fernandomierhicks/omni-robot/simulation/v11 sil/studies/results/motor_char/REPORT.md

# Motor study results (generated by drive_char_report.py; see the study README for the method)

## C. Speed, cruise, straights

### Top speed (m/s, cause) per body direction

| robot | 4 drives | 0 deg | 22.5 deg | 45 deg | 67.5 deg | 90 deg | 112.5 deg | 135 deg | 157.5 deg | 180 deg |
| --- | --- | --- | --- | --- | --- | --- | --- | --- | --- | --- |
| AK40-10 10 kg carpet | $544 | 4.24 rpm | 3.45 rpm | 3.23 rpm | 3.37 rpm | 4.09 rpm | 3.34 rpm | 3.23 rpm | 3.44 rpm | 4.25 rpm |
| AK40-10 10 kg carpet 20% | $544 | 3.69 rpm | 3.06 rpm | 2.84 rpm | 2.97 rpm | 3.56 rpm | 2.93 rpm | 2.82 rpm | 2.99 rpm | 3.65 rpm |
| AK40-10 10 kg floor | $544 | 4.27 rpm | 3.43 rpm | 3.20 rpm | 3.33 rpm | 3.96 rpm | 3.31 rpm | 3.21 rpm | 3.44 rpm | 4.28 rpm |
| AK40-10 10 kg floor 20% | $544 | 3.73 rpm | 3.03 rpm | 2.83 rpm | 2.95 rpm | 3.50 rpm | 2.96 rpm | 2.87 rpm | 3.07 rpm | 3.70 rpm |
| AK40-10 10 kg floor loop=0.25 | $544 | 4.26 rpm | 3.44 rpm | 3.24 rpm | 3.37 rpm | 4.02 rpm | 3.37 rpm | 3.25 rpm | 3.43 rpm | 4.32 rpm |
| AK40-10 15 kg carpet | $544 | 4.00 rpm | 3.44 rpm | 3.14 rpm | 3.32 rpm | 4.00 rpm | 3.30 rpm | 3.15 rpm | 3.42 rpm | 4.03 rpm |
| AK40-10 15 kg carpet 20% | $544 | 3.55 rpm | 3.00 rpm | 2.78 rpm | 2.91 rpm | 3.58 rpm | 2.90 rpm | 2.80 rpm | 3.01 rpm | 3.56 rpm |
| AK40-10 15 kg floor | $544 | 4.13 rpm | 3.41 rpm | 3.20 rpm | 3.32 rpm | 3.84 rpm | 3.33 rpm | 3.20 rpm | 3.48 rpm | 4.27 rpm |
| AK40-10 15 kg floor 20% | $544 | 3.65 rpm | 3.00 rpm | 2.77 rpm | 2.92 rpm | 3.54 rpm | 2.94 rpm | 2.86 rpm | 3.08 rpm | 3.75 rpm |
| AK40-10 20 kg carpet | $544 | 3.86 rpm | 3.36 rpm | 3.05 rpm | 3.23 rpm | 3.89 rpm | 3.20 rpm | 3.05 rpm | 3.33 rpm | 4.02 rpm |
| AK40-10 20 kg carpet 20% | $544 | 3.39 rpm | 2.91 rpm | 2.69 rpm | 2.81 rpm | 3.38 rpm | 2.79 rpm | 2.71 rpm | 2.92 rpm | 3.50 rpm |
| AK40-10 20 kg floor | $544 | 4.13 rpm | 3.38 rpm | 3.11 rpm | 3.26 rpm | 4.01 rpm | 3.26 rpm | 3.19 rpm | 3.45 rpm | 4.19 rpm |
| AK40-10 20 kg floor 20% | $544 | 3.62 rpm | 2.97 rpm | 2.74 rpm | 2.90 rpm | 3.59 rpm | 2.93 rpm | 2.81 rpm | 3.05 rpm | 3.80 rpm |
| AK40-10 20 kg floor loop=0.25 | $544 | 4.15 rpm | 3.38 rpm | 3.13 rpm | 3.28 rpm | 3.93 rpm | 3.32 rpm | 3.18 rpm | 3.47 rpm | 4.22 rpm |
| AK40-10 20hi kg carpet | $544 | 3.99 rpm | 3.34 rpm | 3.06 rpm | 3.21 rpm | 3.90 rpm | 3.21 rpm | 3.07 rpm | 3.37 rpm | 4.02 rpm |
| AK40-10 20hi kg carpet 20% | $544 | 3.41 rpm | 2.91 rpm | 2.70 rpm | 2.82 rpm | 3.44 rpm | 2.81 rpm | 2.71 rpm | 2.89 rpm | 3.49 rpm |
| AK40-10 20hi kg floor | $544 | 4.09 rpm | 3.37 rpm | 3.13 rpm | 3.26 rpm | 3.84 rpm | 3.30 rpm | 3.19 rpm | 3.45 rpm | 4.22 rpm |
| AK40-10 20hi kg floor 20% | $544 | 3.61 rpm | 3.00 rpm | 2.72 rpm | 2.87 rpm | 3.51 rpm | 2.92 rpm | 2.83 rpm | 3.03 rpm | 3.82 rpm |
| AK40-10-ds 10 kg carpet | $544 | 4.02 rpm | - | 3.05 rpm | - | 3.77 rpm | - | 3.06 rpm | - | 3.98 rpm |
| AK40-10-ds 10 kg carpet 20% | $544 | 3.47 rpm | - | 2.70 rpm | - | 3.46 rpm | - | 2.74 rpm | - | 3.50 rpm |
| AK40-10-ds 10 kg floor | $544 | 4.01 rpm | - | 3.07 rpm | - | 3.88 rpm | - | 3.11 rpm | - | 4.07 rpm |
| AK40-10-ds 10 kg floor 20% | $544 | 3.53 rpm | - | 2.73 rpm | - | 3.35 rpm | - | 2.74 rpm | - | 3.56 rpm |
| AK40-10-ds 20 kg carpet | $544 | 3.81 rpm | - | 2.97 rpm | - | 3.69 rpm | - | 2.97 rpm | - | 3.86 rpm |
| AK40-10-ds 20 kg carpet 20% | $544 | 3.31 rpm | - | 2.49 rpm | - | 3.30 rpm | - | 2.61 rpm | - | 3.40 rpm |
| AK40-10-ds 20 kg floor | $544 | 3.94 rpm | - | 2.99 rpm | - | 3.63 rpm | - | 3.04 rpm | - | 4.10 rpm |
| AK40-10-ds 20 kg floor 20% | $544 | 3.47 rpm | - | 2.66 rpm | - | 3.31 rpm | - | 2.70 rpm | - | 3.67 rpm |
| DM-2325-ds 10 kg carpet | $344 | 5.14 rpm | - | 3.87 rpm | - | 4.45 rpm | - | 3.86 rpm | - | 5.14 rpm |
| DM-2325-ds 10 kg carpet 20% | $344 | 4.47 rpm | - | 3.39 rpm | - | 4.10 rpm | - | 3.38 rpm | - | 4.44 rpm |
| DM-2325-ds 10 kg floor | $344 | 5.15 rpm | - | 3.85 rpm | - | 4.63 rpm | - | 3.84 rpm | - | 5.15 rpm |
| DM-2325-ds 10 kg floor 20% | $344 | 4.51 rpm | - | 3.41 rpm | - | 4.26 rpm | - | 3.40 rpm | - | 4.55 rpm |
| DM-2325-ds 20 kg carpet | $344 | 4.51 rpm | - | 3.59 rpm | - | 4.65 rpm | - | 3.58 rpm | - | 4.60 rpm |
| DM-2325-ds 20 kg carpet 20% | $344 | 3.92 rpm | - | 3.07 rpm | - | 3.99 rpm | - | 3.11 rpm | - | 4.01 rpm |
| DM-2325-ds 20 kg floor | $344 | 4.76 rpm | - | 3.68 rpm | - | 4.42 rpm | - | 3.73 rpm | - | 4.85 rpm |
| DM-2325-ds 20 kg floor 20% | $344 | 4.19 rpm | - | 3.24 rpm | - | 4.01 rpm | - | 3.31 rpm | - | 4.30 rpm |
| DM-2325-low-ds 10 kg carpet | $344 | 4.76 rpm | - | 3.63 rpm | - | 4.80 rpm | - | 3.61 rpm | - | 4.78 rpm |
| DM-2325-low-ds 10 kg carpet 20% | $344 | 4.12 rpm | - | 3.13 rpm | - | 4.08 rpm | - | 3.14 rpm | - | 4.11 rpm |
| DM-2325-low-ds 10 kg floor | $344 | 4.87 rpm | - | 3.65 rpm | - | 4.74 rpm | - | 3.66 rpm | - | 4.89 rpm |
| DM-2325-low-ds 10 kg floor 20% | $344 | 4.24 rpm | - | 3.24 rpm | - | 3.98 rpm | - | 3.27 rpm | - | 4.28 rpm |
| DM-2325-low-ds 20 kg carpet | $344 | 4.00 rpm | - | 3.21 rpm | - | 4.06 rpm | - | 3.21 rpm | - | 4.13 rpm |
| DM-2325-low-ds 20 kg carpet 20% | $344 | 3.36 rpm | - | 2.75 rpm | - | 3.37 rpm | - | 2.74 rpm | - | 3.52 rpm |
| DM-2325-low-ds 20 kg floor | $344 | 4.35 rpm | - | 3.40 rpm | - | 4.10 rpm | - | 3.49 rpm | - | 4.46 rpm |
| DM-2325-low-ds 20 kg floor 20% | $344 | 3.78 rpm | - | 2.92 rpm | - | 3.63 rpm | - | 3.07 rpm | - | 3.96 rpm |
| DM-J3507-ds 10 kg carpet | $368 | 3.84 rpm | - | 3.01 rpm | - | 3.89 rpm | - | 3.00 rpm | - | 3.85 rpm |
| DM-J3507-ds 10 kg carpet 20% | $368 | 3.25 rpm | - | 2.67 rpm | - | 3.33 rpm | - | 2.70 rpm | - | 3.35 rpm |
| DM-J3507-ds 10 kg floor | $368 | 3.90 rpm | - | 3.11 rpm | - | 3.94 rpm | - | 3.11 rpm | - | 3.96 rpm |
| DM-J3507-ds 10 kg floor 20% | $368 | 3.51 rpm | - | 2.71 rpm | - | 3.43 rpm | - | 2.74 rpm | - | 3.57 rpm |
| DM-J3507-ds 20 kg carpet | $368 | 3.36 rpm | - | 2.64 rpm | - | 3.34 rpm | - | 2.66 rpm | - | 3.48 rpm |
| DM-J3507-ds 20 kg carpet 20% | $368 | 2.90 rpm | - | 2.26 rpm | - | 2.88 rpm | - | 2.38 rpm | - | 3.10 rpm |
| DM-J3507-ds 20 kg floor | $368 | 3.72 rpm | - | 2.82 rpm | - | 3.60 rpm | - | 2.92 rpm | - | 3.93 rpm |
| DM-J3507-ds 20 kg floor 20% | $368 | 3.33 rpm | - | 2.54 rpm | - | 3.23 rpm | - | 2.59 rpm | - | 3.48 rpm |
| EduLite05-ds 10 kg carpet | $320 | 2.01 rpm | - | 1.52 rpm | - | 1.97 rpm | - | 1.53 rpm | - | 2.10 rpm |
| EduLite05-ds 10 kg carpet 20% | $320 | 1.79 rpm | - | 1.34 rpm | - | 1.77 rpm | - | 1.36 rpm | - | 1.88 rpm |
| EduLite05-ds 10 kg floor | $320 | 2.11 rpm | - | 1.54 rpm | - | 2.07 rpm | - | 1.57 rpm | - | 2.15 rpm |
| EduLite05-ds 10 kg floor 20% | $320 | 1.89 rpm | - | 1.38 rpm | - | 1.86 rpm | - | 1.38 rpm | - | 1.92 rpm |
| EduLite05-ds 20 kg carpet | $320 | 1.99 rpm | - | 1.46 rpm | - | 1.97 rpm | - | 1.48 rpm | - | 2.08 rpm |
| EduLite05-ds 20 kg carpet 20% | $320 | 1.76 rpm | - | 1.24 rpm | - | 1.75 rpm | - | 1.26 rpm | - | 1.82 rpm |
| EduLite05-ds 20 kg floor | $320 | 2.11 rpm | - | 1.52 rpm | - | 2.11 rpm | - | 1.54 rpm | - | 2.15 rpm |
| EduLite05-ds 20 kg floor 20% | $320 | 1.87 rpm | - | 1.35 rpm | - | 1.88 rpm | - | 1.36 rpm | - | 1.90 rpm |
| GIM3510-8-ds 10 kg carpet | $583 | 4.86 rpm | - | 3.75 rpm | - | 4.64 rpm | - | 3.75 rpm | - | 4.93 rpm |
| GIM3510-8-ds 10 kg carpet 20% | $583 | 4.29 rpm | - | 3.29 rpm | - | 4.04 rpm | - | 3.29 rpm | - | 4.31 rpm |
| GIM3510-8-ds 10 kg floor | $583 | 4.96 rpm | - | 3.69 rpm | - | 4.63 rpm | - | 3.67 rpm | - | 4.95 rpm |
| GIM3510-8-ds 10 kg floor 20% | $583 | 4.32 rpm | - | 3.27 rpm | - | 4.38 rpm | - | 3.25 rpm | - | 4.27 rpm |
| GIM3510-8-ds 20 kg carpet | $583 | 4.47 rpm | - | 3.57 rpm | - | 4.57 rpm | - | 3.56 rpm | - | 4.49 rpm |
| GIM3510-8-ds 20 kg carpet 20% | $583 | 3.90 rpm | - | 3.12 rpm | - | 3.98 rpm | - | 3.12 rpm | - | 4.04 rpm |
| GIM3510-8-ds 20 kg floor | $583 | 4.63 rpm | - | 3.63 rpm | - | 4.64 rpm | - | 3.63 rpm | - | 4.81 rpm |
| GIM3510-8-ds 20 kg floor 20% | $583 | 4.16 rpm | - | 3.18 rpm | - | 4.03 rpm | - | 3.22 rpm | - | 4.28 rpm |
| GIM4305-10-ds 10 kg carpet | $511 | 3.19 rpm | - | 2.54 rpm | - | 3.23 rpm | - | 2.55 rpm | - | 3.26 rpm |
| GIM4305-10-ds 10 kg carpet 20% | $511 | 2.80 rpm | - | 2.20 rpm | - | 2.85 rpm | - | 2.24 rpm | - | 2.87 rpm |
| GIM4305-10-ds 10 kg floor | $511 | 3.30 rpm | - | 2.54 rpm | - | 3.28 rpm | - | 2.57 rpm | - | 3.41 rpm |
| GIM4305-10-ds 10 kg floor 20% | $511 | 2.94 rpm | - | 2.19 rpm | - | 2.97 rpm | - | 2.30 rpm | - | 3.01 rpm |
| GIM4305-10-ds 20 kg carpet | $511 | 3.00 rpm | - | 2.26 rpm | - | 2.99 rpm | - | 2.38 rpm | - | 3.13 rpm |
| GIM4305-10-ds 20 kg carpet 20% | $511 | 2.63 rpm | - | 2.01 rpm | - | 2.61 rpm | - | 2.06 rpm | - | 2.79 rpm |
| GIM4305-10-ds 20 kg floor | $511 | 3.30 rpm | - | 2.49 rpm | - | 3.25 rpm | - | 2.51 rpm | - | 3.40 rpm |
| GIM4305-10-ds 20 kg floor 20% | $511 | 2.96 rpm | - | 2.13 rpm | - | 2.90 rpm | - | 2.23 rpm | - | 3.01 rpm |
| M2006-ds 10 kg carpet | $376 | 4.42 rpm | - | 3.38 rpm | - | 4.00 rpm | - | 3.37 rpm | - | 4.41 rpm |
| M2006-ds 10 kg carpet 20% | $376 | 3.80 rpm | - | 2.97 rpm | - | 3.73 rpm | - | 2.96 rpm | - | 3.79 rpm |
| M2006-ds 10 kg floor | $376 | 4.50 rpm | - | 3.41 rpm | - | 4.41 rpm | - | 3.43 rpm | - | 4.49 rpm |
| M2006-ds 10 kg floor 20% | $376 | 3.93 rpm | - | 3.00 rpm | - | 3.91 rpm | - | 3.01 rpm | - | 3.88 rpm |
| M2006-ds 20 kg carpet | $376 | 3.98 rpm | - | 3.04 rpm | - | 4.03 rpm | - | 3.09 rpm | - | 4.01 rpm |
| M2006-ds 20 kg carpet 20% | $376 | 3.41 rpm | - | 2.62 rpm | - | 3.38 rpm | - | 2.70 rpm | - | 3.47 rpm |
| M2006-ds 20 kg floor | $376 | 4.19 rpm | - | 3.22 rpm | - | 4.15 rpm | - | 3.30 rpm | - | 4.30 rpm |
| M2006-ds 20 kg floor 20% | $376 | 3.71 rpm | - | 2.81 rpm | - | 3.58 rpm | - | 2.89 rpm | - | 3.88 rpm |

### Steady cruise: drive power (4 drives, W)

| robot | dir | 0.5 m/s | 1.0 m/s | 1.5 m/s | 2.0 m/s | 2.5 m/s | 3.0 m/s |
| --- | --- | --- | --- | --- | --- | --- | --- |
| AK40-10 10 kg carpet | 0 | 15 W | 30 W | 52 W | 78 W | 89 W | no (rpm) |
| AK40-10 10 kg carpet | 45 | 12 W | 25 W | 35 W | 45 W | 56 W | 55 W |
| AK40-10 10 kg carpet 20% | 0 | 15 W | 30 W | 53 W | 72 W | 82 W | no (rpm) |
| AK40-10 10 kg carpet 20% | 45 | 12 W | 25 W | 35 W | 45 W | 51 W | 52 W |
| AK40-10 10 kg floor | 0 | 12 W | 21 W | 36 W | 55 W | 71 W | 79 W |
| AK40-10 10 kg floor | 45 | 7 W | 15 W | 25 W | 33 W | 42 W | 48 W |
| AK40-10 10 kg floor 20% | 0 | 12 W | 21 W | 36 W | 55 W | 63 W | 72 W |
| AK40-10 10 kg floor 20% | 45 | 7 W | 15 W | 25 W | 31 W | 42 W | 43 W |
| AK40-10 10 kg floor loop=0.25 | 0 | 9 W | 17 W | 27 W | 40 W | 58 W | 73 W |
| AK40-10 10 kg floor loop=0.25 | 45 | 5 W | 12 W | 19 W | 28 W | 35 W | 46 W |
| AK40-10 15 kg carpet | 0 | 22 W | 46 W | 76 W | 114 W | 128 W | no (grip) |
| AK40-10 15 kg carpet | 45 | 17 W | 36 W | 51 W | 62 W | 78 W | 76 W |
| AK40-10 15 kg carpet 20% | 0 | 22 W | 46 W | 78 W | 106 W | 116 W | no (grip) |
| AK40-10 15 kg carpet 20% | 45 | 17 W | 36 W | 50 W | 60 W | 64 W | no (rpm) |
| AK40-10 15 kg floor | 0 | 20 W | 33 W | 54 W | 79 W | 102 W | 115 W |
| AK40-10 15 kg floor | 45 | 9 W | 24 W | 36 W | 52 W | 57 W | 62 W |
| AK40-10 15 kg floor 20% | 0 | 20 W | 33 W | 54 W | 77 W | 93 W | 104 W |
| AK40-10 15 kg floor 20% | 45 | 9 W | 24 W | 36 W | 47 W | 54 W | no (rpm) |
| AK40-10 20 kg carpet | 0 | 30 W | 67 W | 114 W | 162 W | 172 W | 178 W |
| AK40-10 20 kg carpet | 45 | 24 W | 51 W | 73 W | 87 W | 93 W | 92 W |
| AK40-10 20 kg carpet 20% | 0 | 30 W | 67 W | 110 W | 147 W | 150 W | 157 W |
| AK40-10 20 kg carpet 20% | 45 | 24 W | 51 W | 71 W | 78 W | 81 W | no (rpm) |
| AK40-10 20 kg floor | 0 | 28 W | 44 W | 71 W | 102 W | 122 W | 139 W |
| AK40-10 20 kg floor | 45 | 12 W | 31 W | 49 W | 67 W | 73 W | 77 W |
| AK40-10 20 kg floor 20% | 0 | 28 W | 44 W | 71 W | 97 W | 113 W | 122 W |
| AK40-10 20 kg floor 20% | 45 | 12 W | 31 W | 50 W | 56 W | 58 W | no (rpm) |
| AK40-10 20 kg floor loop=0.25 | 0 | 17 W | 31 W | 49 W | 67 W | 86 W | 112 W |
| AK40-10 20 kg floor loop=0.25 | 45 | 9 W | 19 W | 31 W | 45 W | 63 W | 72 W |
| AK40-10 20hi kg carpet | 0 | 32 W | 70 W | 119 W | 161 W | 175 W | no (grip) |
| AK40-10 20hi kg carpet | 45 | 23 W | 53 W | 74 W | 92 W | 92 W | 92 W |
| AK40-10 20hi kg carpet 20% | 0 | 32 W | 70 W | 116 W | 147 W | 150 W | 162 W |
| AK40-10 20hi kg carpet 20% | 45 | 23 W | 53 W | 72 W | 82 W | 79 W | no (rpm) |
| AK40-10 20hi kg floor | 0 | 29 W | 47 W | 75 W | 104 W | 123 W | 140 W |
| AK40-10 20hi kg floor | 45 | 11 W | 32 W | 51 W | 66 W | 78 W | 78 W |
| AK40-10 20hi kg floor 20% | 0 | 29 W | 47 W | 74 W | 98 W | 115 W | 125 W |
| AK40-10 20hi kg floor 20% | 45 | 11 W | 32 W | 50 W | 57 W | 57 W | no (rpm) |
| AK40-10-ds 10 kg carpet | 0 | 14 W | 28 W | 50 W | 69 W | 83 W | 93 W |
| AK40-10-ds 10 kg carpet | 45 | 11 W | 24 W | 34 W | 43 W | 52 W | 47 W |
| AK40-10-ds 10 kg carpet 20% | 0 | 14 W | 28 W | 50 W | 68 W | 80 W | no (grip) |
| AK40-10-ds 10 kg carpet 20% | 45 | 11 W | 24 W | 34 W | 43 W | 44 W | no (rpm) |
| AK40-10-ds 10 kg floor | 0 | 11 W | 20 W | 32 W | 46 W | 61 W | 76 W |
| AK40-10-ds 10 kg floor | 45 | 6 W | 14 W | 24 W | 33 W | 40 W | 41 W |
| AK40-10-ds 10 kg floor 20% | 0 | 11 W | 20 W | 32 W | 46 W | 63 W | 68 W |
| AK40-10-ds 10 kg floor 20% | 45 | 6 W | 14 W | 24 W | 31 W | 38 W | no (rpm) |
| AK40-10-ds 20 kg carpet | 0 | 31 W | 67 W | 110 W | 155 W | 168 W | 178 W |
| AK40-10-ds 20 kg carpet | 45 | 25 W | 52 W | 72 W | 87 W | 90 W | 87 W |
| AK40-10-ds 20 kg carpet 20% | 0 | 31 W | 67 W | 110 W | 152 W | 146 W | 158 W |
| AK40-10-ds 20 kg carpet 20% | 45 | 25 W | 52 W | 72 W | 81 W | 76 W | no (rpm) |
| AK40-10-ds 20 kg floor | 0 | 29 W | 45 W | 70 W | 94 W | 120 W | 138 W |
| AK40-10-ds 20 kg floor | 45 | 13 W | 32 W | 50 W | 69 W | 70 W | 71 W |
| AK40-10-ds 20 kg floor 20% | 0 | 29 W | 45 W | 69 W | 90 W | 109 W | 117 W |
| AK40-10-ds 20 kg floor 20% | 45 | 13 W | 32 W | 50 W | 60 W | 57 W | no (rpm) |
| DM-2325-ds 10 kg carpet | 0 | 19 W | 37 W | 63 W | 89 W | 109 W | no (grip) |
| DM-2325-ds 10 kg carpet | 45 | 15 W | 32 W | 43 W | 54 W | 65 W | 72 W |
| DM-2325-ds 10 kg carpet 20% | 0 | 19 W | 37 W | 63 W | 98 W | 103 W | 113 W |
| DM-2325-ds 10 kg carpet 20% | 45 | 15 W | 33 W | 43 W | 54 W | 63 W | 67 W |
| DM-2325-ds 10 kg floor | 0 | 18 W | 27 W | 43 W | 63 W | 86 W | 97 W |
| DM-2325-ds 10 kg floor | 45 | 9 W | 20 W | 30 W | 43 W | 58 W | 62 W |
| DM-2325-ds 10 kg floor 20% | 0 | 18 W | 27 W | 43 W | 66 W | 80 W | 90 W |
| DM-2325-ds 10 kg floor 20% | 45 | 9 W | 20 W | 30 W | 43 W | 56 W | 53 W |
| DM-2325-ds 20 kg carpet | 0 | 45 W | 98 W | 151 W | 220 W | 222 W | 221 W |
| DM-2325-ds 20 kg carpet | 45 | 35 W | 76 W | 101 W | 120 W | 125 W | 116 W |
| DM-2325-ds 20 kg carpet 20% | 0 | 45 W | 98 W | 150 W | 201 W | 200 W | no (supply) |
| DM-2325-ds 20 kg carpet 20% | 45 | 35 W | 76 W | 100 W | 112 W | 103 W | 100 W |
| DM-2325-ds 20 kg floor | 0 | 51 W | 75 W | 109 W | 147 W | 173 W | 198 W |
| DM-2325-ds 20 kg floor | 45 | 20 W | 53 W | 77 W | 100 W | 112 W | 108 W |
| DM-2325-ds 20 kg floor 20% | 0 | 51 W | 75 W | 108 W | 141 W | 164 W | 160 W |
| DM-2325-ds 20 kg floor 20% | 45 | 20 W | 52 W | 76 W | 88 W | 95 W | 94 W |
| DM-2325-low-ds 10 kg carpet | 0 | 25 W | 50 W | 76 W | no (torque) | 112 W | no (grip) |
| DM-2325-low-ds 10 kg carpet | 45 | 19 W | 40 W | 56 W | 66 W | 73 W | 77 W |
| DM-2325-low-ds 10 kg carpet 20% | 0 | 25 W | 50 W | 76 W | no (torque) | 110 W | 119 W |
| DM-2325-low-ds 10 kg carpet 20% | 45 | 19 W | 40 W | 56 W | 63 W | 68 W | 59 W |
| DM-2325-low-ds 10 kg floor | 0 | 26 W | 37 W | 55 W | 77 W | 95 W | 105 W |
| DM-2325-low-ds 10 kg floor | 45 | 12 W | 28 W | 39 W | 50 W | 60 W | 64 W |
| DM-2325-low-ds 10 kg floor 20% | 0 | 26 W | 37 W | 55 W | 77 W | 94 W | 99 W |
| DM-2325-low-ds 10 kg floor 20% | 45 | 12 W | 28 W | 39 W | 49 W | 65 W | 57 W |
| DM-2325-low-ds 20 kg carpet | 0 | 45 W | 122 W | 148 W | 178 W | 204 W | 227 W |
| DM-2325-low-ds 20 kg carpet | 45 | 30 W | 84 W | 98 W | 117 W | 121 W | 112 W |
| DM-2325-low-ds 20 kg carpet 20% | 0 | 45 W | 122 W | 148 W | 178 W | 206 W | no (grip) |
| DM-2325-low-ds 20 kg carpet 20% | 45 | 30 W | 84 W | 98 W | 103 W | 99 W | no (rpm) |
| DM-2325-low-ds 20 kg floor | 0 | 68 W | 99 W | 122 W | 134 W | 156 W | 179 W |
| DM-2325-low-ds 20 kg floor | 45 | 12 W | 66 W | 96 W | 111 W | 108 W | 111 W |
| DM-2325-low-ds 20 kg floor 20% | 0 | 68 W | 99 W | 122 W | 134 W | 150 W | 156 W |
| DM-2325-low-ds 20 kg floor 20% | 45 | 12 W | 66 W | 96 W | 96 W | 91 W | 89 W |
| DM-J3507-ds 10 kg carpet | 0 | 21 W | 42 W | 71 W | 91 W | no (rpm) | no (grip) |
| DM-J3507-ds 10 kg carpet | 45 | 18 W | 33 W | 50 W | 57 W | 55 W | 50 W |
| DM-J3507-ds 10 kg carpet 20% | 0 | 21 W | 42 W | 70 W | 88 W | no (grip) | no (grip) |
| DM-J3507-ds 10 kg carpet 20% | 45 | 18 W | 33 W | 46 W | 50 W | 43 W | no (rpm) |
| DM-J3507-ds 10 kg floor | 0 | 20 W | 32 W | 55 W | 67 W | 79 W | 86 W |
| DM-J3507-ds 10 kg floor | 45 | 9 W | 24 W | 34 W | 44 W | 49 W | 44 W |
| DM-J3507-ds 10 kg floor 20% | 0 | 20 W | 32 W | 54 W | 67 W | 75 W | no (rpm) |
| DM-J3507-ds 10 kg floor 20% | 45 | 9 W | 24 W | 33 W | 42 W | 41 W | no (rpm) |
| DM-J3507-ds 20 kg carpet | 0 | 52 W | 121 W | 172 W | 171 W | 184 W | 196 W |
| DM-J3507-ds 20 kg carpet | 45 | 42 W | 81 W | 97 W | 90 W | 92 W | no (rpm) |
| DM-J3507-ds 20 kg carpet 20% | 0 | 52 W | 119 W | 154 W | 163 W | 169 W | no (grip) |
| DM-J3507-ds 20 kg carpet 20% | 45 | 42 W | 76 W | 81 W | 78 W | no (rpm) | no (rpm) |
| DM-J3507-ds 20 kg floor | 0 | 54 W | 74 W | 109 W | 126 W | 124 W | 127 W |
| DM-J3507-ds 20 kg floor | 45 | 19 W | 51 W | 75 W | 81 W | 71 W | 73 W |
| DM-J3507-ds 20 kg floor 20% | 0 | 54 W | 73 W | 103 W | 113 W | 115 W | 114 W |
| DM-J3507-ds 20 kg floor 20% | 45 | 19 W | 48 W | 65 W | 66 W | 62 W | no (rpm) |
| EduLite05-ds 10 kg carpet | 0 | 11 W | 23 W | 41 W | 48 W | no (rpm) | no (rpm) |
| EduLite05-ds 10 kg carpet | 45 | 9 W | 19 W | 24 W | no (rpm) | no (rpm) | no (rpm) |
| EduLite05-ds 10 kg carpet 20% | 0 | 11 W | 23 W | 39 W | no (rpm) | no (rpm) | no (rpm) |
| EduLite05-ds 10 kg carpet 20% | 45 | 9 W | 19 W | no (rpm) | no (rpm) | no (rpm) | no (rpm) |
| EduLite05-ds 10 kg floor | 0 | 8 W | 16 W | 27 W | 35 W | no (rpm) | no (rpm) |
| EduLite05-ds 10 kg floor | 45 | 5 W | 12 W | 17 W | no (rpm) | no (rpm) | no (rpm) |
| EduLite05-ds 10 kg floor 20% | 0 | 8 W | 16 W | 26 W | 31 W | no (rpm) | no (rpm) |
| EduLite05-ds 10 kg floor 20% | 45 | 5 W | 12 W | no (rpm) | no (rpm) | no (rpm) | no (rpm) |
| EduLite05-ds 20 kg carpet | 0 | 22 W | 49 W | 80 W | 87 W | no (grip) | no (grip) |
| EduLite05-ds 20 kg carpet | 45 | 19 W | 39 W | 44 W | no (rpm) | no (rpm) | no (rpm) |
| EduLite05-ds 20 kg carpet 20% | 0 | 22 W | 49 W | 70 W | no (rpm) | no (rpm) | no (rpm) |
| EduLite05-ds 20 kg carpet 20% | 45 | 19 W | 37 W | no (rpm) | no (rpm) | no (rpm) | no (rpm) |
| EduLite05-ds 20 kg floor | 0 | 19 W | 31 W | 49 W | 53 W | no (rpm) | no (rpm) |
| EduLite05-ds 20 kg floor | 45 | 9 W | 22 W | 26 W | no (rpm) | no (rpm) | no (rpm) |
| EduLite05-ds 20 kg floor 20% | 0 | 19 W | 31 W | 45 W | 44 W | no (rpm) | no (rpm) |
| EduLite05-ds 20 kg floor 20% | 45 | 9 W | 22 W | no (rpm) | no (rpm) | no (rpm) | no (rpm) |
| GIM3510-8-ds 10 kg carpet | 0 | 15 W | 29 W | 56 W | 71 W | 86 W | no (torque) |
| GIM3510-8-ds 10 kg carpet | 45 | 12 W | 26 W | 35 W | 45 W | 50 W | 65 W |
| GIM3510-8-ds 10 kg carpet 20% | 0 | 15 W | 29 W | 56 W | 71 W | 86 W | 97 W |
| GIM3510-8-ds 10 kg carpet 20% | 45 | 12 W | 26 W | 35 W | 45 W | 49 W | 57 W |
| GIM3510-8-ds 10 kg floor | 0 | 12 W | 21 W | 37 W | 50 W | 65 W | 79 W |
| GIM3510-8-ds 10 kg floor | 45 | 6 W | 15 W | 24 W | 36 W | 44 W | 52 W |
| GIM3510-8-ds 10 kg floor 20% | 0 | 12 W | 21 W | 37 W | 50 W | 65 W | 77 W |
| GIM3510-8-ds 10 kg floor 20% | 45 | 6 W | 15 W | 24 W | 36 W | 42 W | 44 W |
| GIM3510-8-ds 20 kg carpet | 0 | 33 W | 73 W | 117 W | 145 W | 170 W | 182 W |
| GIM3510-8-ds 20 kg carpet | 45 | 27 W | 55 W | 76 W | 92 W | 115 W | 113 W |
| GIM3510-8-ds 20 kg carpet 20% | 0 | 33 W | 73 W | 117 W | 145 W | 170 W | no (supply) |
| GIM3510-8-ds 20 kg carpet 20% | 45 | 27 W | 55 W | 76 W | 92 W | 99 W | 90 W |
| GIM3510-8-ds 20 kg floor | 0 | 31 W | 45 W | 71 W | 93 W | 114 W | 141 W |
| GIM3510-8-ds 20 kg floor | 45 | 14 W | 32 W | 53 W | 72 W | 90 W | 100 W |
| GIM3510-8-ds 20 kg floor 20% | 0 | 31 W | 45 W | 71 W | 93 W | 114 W | 139 W |
| GIM3510-8-ds 20 kg floor 20% | 45 | 14 W | 32 W | 53 W | 72 W | 76 W | 75 W |
| GIM4305-10-ds 10 kg carpet | 0 | 16 W | 32 W | 54 W | 73 W | 81 W | no (grip) |
| GIM4305-10-ds 10 kg carpet | 45 | 13 W | 25 W | 38 W | 45 W | 40 W | no (rpm) |
| GIM4305-10-ds 10 kg carpet 20% | 0 | 16 W | 32 W | 57 W | 70 W | 72 W | no (grip) |
| GIM4305-10-ds 10 kg carpet 20% | 45 | 13 W | 25 W | 38 W | 36 W | no (rpm) | no (rpm) |
| GIM4305-10-ds 10 kg floor | 0 | 14 W | 23 W | 36 W | 57 W | 63 W | 71 W |
| GIM4305-10-ds 10 kg floor | 45 | 7 W | 17 W | 26 W | 32 W | 34 W | no (rpm) |
| GIM4305-10-ds 10 kg floor 20% | 0 | 14 W | 23 W | 37 W | 49 W | 59 W | no (rpm) |
| GIM4305-10-ds 10 kg floor 20% | 45 | 7 W | 17 W | 25 W | 31 W | no (rpm) | no (rpm) |
| GIM4305-10-ds 20 kg carpet | 0 | 36 W | 82 W | 124 W | 141 W | 147 W | 150 W |
| GIM4305-10-ds 20 kg carpet | 45 | 29 W | 60 W | 79 W | 73 W | no (rpm) | no (rpm) |
| GIM4305-10-ds 20 kg carpet 20% | 0 | 36 W | 82 W | 122 W | 128 W | 135 W | no (grip) |
| GIM4305-10-ds 20 kg carpet 20% | 45 | 29 W | 59 W | 64 W | 64 W | no (rpm) | no (rpm) |
| GIM4305-10-ds 20 kg floor | 0 | 36 W | 54 W | 82 W | 100 W | 106 W | 102 W |
| GIM4305-10-ds 20 kg floor | 45 | 15 W | 37 W | 58 W | 60 W | 53 W | no (rpm) |
| GIM4305-10-ds 20 kg floor 20% | 0 | 36 W | 54 W | 79 W | 91 W | 91 W | 92 W |
| GIM4305-10-ds 20 kg floor 20% | 45 | 15 W | 37 W | 51 W | 48 W | no (rpm) | no (rpm) |
| M2006-ds 10 kg carpet | 0 | 22 W | 43 W | 62 W | 80 W | 96 W | no (grip) |
| M2006-ds 10 kg carpet | 45 | 17 W | 32 W | 42 W | 57 W | 67 W | 70 W |
| M2006-ds 10 kg carpet 20% | 0 | 22 W | 43 W | 62 W | 80 W | 96 W | no (grip) |
| M2006-ds 10 kg carpet 20% | 45 | 17 W | 32 W | 42 W | 57 W | 66 W | 62 W |
| M2006-ds 10 kg floor | 0 | 21 W | 33 W | 47 W | 64 W | 76 W | 92 W |
| M2006-ds 10 kg floor | 45 | 10 W | 24 W | 34 W | 42 W | 56 W | 61 W |
| M2006-ds 10 kg floor 20% | 0 | 21 W | 33 W | 47 W | 64 W | 76 W | 92 W |
| M2006-ds 10 kg floor 20% | 45 | 10 W | 24 W | 34 W | 42 W | 59 W | 55 W |
| M2006-ds 20 kg carpet | 0 | 37 W | 83 W | 113 W | 143 W | 171 W | 187 W |
| M2006-ds 20 kg carpet | 45 | 27 W | 58 W | 70 W | 92 W | 110 W | 109 W |
| M2006-ds 20 kg carpet 20% | 0 | 37 W | 83 W | 113 W | 143 W | 171 W | 198 W |
| M2006-ds 20 kg carpet 20% | 45 | 27 W | 58 W | 70 W | 92 W | 95 W | no (torque) |
| M2006-ds 20 kg floor | 0 | 40 W | 68 W | 84 W | 101 W | 119 W | 138 W |
| M2006-ds 20 kg floor | 45 | 12 W | 52 W | 67 W | 76 W | 88 W | 98 W |
| M2006-ds 20 kg floor 20% | 0 | 40 W | 68 W | 84 W | 101 W | 119 W | 138 W |
| M2006-ds 20 kg floor 20% | 45 | 12 W | 52 W | 67 W | 76 W | 79 W | 79 W |

### Rest-to-rest straights: fastest settle time (s) per speed cap (best acceleration)

| robot | L m | 1 | 1.5 | 2 | 2.5 | 3 | 3.5 | none |
| --- | --- | --- | --- | --- | --- | --- | --- | --- |
| AK40-10 10 kg carpet | 2 | 2.82 (a 3) | 2.27 (a 5) | 2.12 (a 4) | 2.03 (a 4) | 2.03 (a 4) | 2.07 (a 5) | - |
| AK40-10 10 kg carpet | 5 | 5.92 (a 4) | 4.38 (a 5) | 3.72 (a 5) | 3.42 (a 4) | 3.18 (a 4) | 2.98 (a 5) | - |
| AK40-10 10 kg carpet | 10 | 11.11 (a 3) | 7.86 (a 5) | 6.38 (a 5) | 5.58 (a 5) | 4.98 (a 5) | 4.60 (a 5) | - |
| AK40-10 10 kg carpet | 15.2 | 16.49 (a 3) | 11.51 (a 5) | 9.18 (a 3) | 7.81 (a 5) | 6.87 (a 4) | 6.22 (a 5) | - |
| AK40-10 10 kg floor | 2 | 2.72 (a 3) | 2.25 (a 5) | 2.05 (a 5) | 2.00 (a 5) | 2.05 (a 4) | 2.08 (a 5) | - |
| AK40-10 10 kg floor | 5 | 5.94 (a 4) | 4.31 (a 5) | 3.61 (a 5) | 3.35 (a 5) | 3.13 (a 4) | 3.02 (a 5) | - |
| AK40-10 10 kg floor | 10 | 11.10 (a 3) | 7.80 (a 5) | 6.28 (a 5) | 5.41 (a 5) | 4.96 (a 5) | 4.56 (a 5) | - |
| AK40-10 10 kg floor | 15.2 | 16.45 (a 3) | 11.43 (a 5) | 9.04 (a 5) | 7.76 (a 4) | 6.85 (a 5) | 6.20 (a 4) | - |
| AK40-10 10 kg floor loop=0.25 | 2 | 2.71 (a 3) | 2.26 (a 5) | 2.07 (a 3) | 2.01 (a 5) | 2.03 (a 5) | 2.06 (a 5) | - |
| AK40-10 10 kg floor loop=0.25 | 5 | 5.84 (a 3) | 4.32 (a 5) | 3.65 (a 5) | 3.33 (a 5) | 3.10 (a 5) | 3.02 (a 5) | - |
| AK40-10 10 kg floor loop=0.25 | 10 | 11.02 (a 3) | 7.85 (a 5) | 6.27 (a 3) | 5.47 (a 5) | 4.97 (a 3) | 4.58 (a 5) | - |
| AK40-10 10 kg floor loop=0.25 | 15.2 | 16.40 (a 3) | 11.40 (a 4) | 9.04 (a 3) | 7.70 (a 5) | 6.81 (a 5) | 6.25 (a 5) | - |
| AK40-10 15 kg carpet | 2 | 2.80 (a 3) | 2.25 (a 5) | 2.10 (a 5) | 2.03 (a 5) | 2.08 (a 4) | 2.05 (a 4) | - |
| AK40-10 15 kg carpet | 5 | 5.95 (a 2) | 4.37 (a 5) | 3.73 (a 4) | 3.37 (a 4) | 3.21 (a 5) | 3.08 (a 5) | - |
| AK40-10 15 kg carpet | 10 | 11.09 (a 3) | 7.85 (a 5) | 6.40 (a 5) | 5.51 (a 5) | 5.04 (a 5) | 4.60 (a 5) | - |
| AK40-10 15 kg carpet | 15.2 | 16.55 (a 3) | 11.48 (a 5) | 9.13 (a 4) | 7.77 (a 5) | 6.92 (a 5) | 6.30 (a 5) | - |
| AK40-10 15 kg floor | 2 | 2.73 (a 4) | 2.24 (a 5) | 2.04 (a 5) | 1.94 (a 5) | 2.03 (a 5) | 2.03 (a 5) | - |
| AK40-10 15 kg floor | 5 | 5.93 (a 3) | 4.34 (a 5) | 3.62 (a 5) | 3.25 (a 5) | 3.12 (a 4) | 3.03 (a 5) | - |
| AK40-10 15 kg floor | 10 | 11.06 (a 4) | 7.80 (a 5) | 6.24 (a 5) | 5.39 (a 5) | 4.87 (a 5) | 4.57 (a 5) | - |
| AK40-10 15 kg floor | 15.2 | 16.43 (a 3) | 11.41 (a 5) | 8.99 (a 5) | 7.62 (a 5) | 6.72 (a 4) | 6.20 (a 5) | - |
| AK40-10 20 kg carpet | 2 | 2.66 (a 3) | 2.26 (a 4) | 2.12 (a 5) | 2.07 (a 5) | 2.08 (a 4) | 2.04 (a 5) | - |
| AK40-10 20 kg carpet | 5 | 5.80 (a 3) | 4.34 (a 5) | 3.66 (a 5) | 3.35 (a 5) | 3.17 (a 4) | 3.06 (a 5) | - |
| AK40-10 20 kg carpet | 10 | 11.12 (a 3) | 7.84 (a 5) | 6.36 (a 5) | 5.45 (a 5) | 4.98 (a 4) | 4.70 (a 5) | - |
| AK40-10 20 kg carpet | 15.2 | 16.39 (a 3) | 11.48 (a 5) | 9.15 (a 4) | 7.73 (a 5) | 6.90 (a 5) | 6.36 (a 5) | - |
| AK40-10 20 kg floor | 2 | 2.73 (a 3) | 2.20 (a 5) | 2.04 (a 5) | 2.02 (a 5) | 2.03 (a 4) | 1.99 (a 4) | - |
| AK40-10 20 kg floor | 5 | 5.85 (a 4) | 4.33 (a 5) | 3.63 (a 5) | 3.22 (a 5) | 3.05 (a 5) | 2.97 (a 5) | - |
| AK40-10 20 kg floor | 10 | 11.09 (a 2) | 7.81 (a 5) | 6.23 (a 5) | 5.37 (a 5) | 4.81 (a 5) | 4.49 (a 5) | - |
| AK40-10 20 kg floor | 15.2 | 16.43 (a 3) | 11.36 (a 5) | 8.91 (a 5) | 7.53 (a 5) | 6.64 (a 5) | 6.11 (a 4) | - |
| AK40-10 20 kg floor loop=0.25 | 2 | 2.71 (a 5) | 2.21 (a 5) | 1.95 (a 4) | 1.85 (a 4) | 1.81 (a 5) | 2.09 (a 3) | - |
| AK40-10 20 kg floor loop=0.25 | 5 | 5.84 (a 5) | 4.31 (a 5) | 3.52 (a 4) | 3.14 (a 5) | 2.90 (a 5) | 2.75 (a 5) | - |
| AK40-10 20 kg floor loop=0.25 | 10 | 11.01 (a 5) | 7.75 (a 4) | 6.14 (a 4) | 5.23 (a 5) | 4.65 (a 5) | 4.31 (a 5) | - |
| AK40-10 20 kg floor loop=0.25 | 15.2 | 16.38 (a 5) | 11.37 (a 5) | 8.87 (a 4) | 7.41 (a 4) | 6.48 (a 5) | 5.89 (a 5) | - |
| AK40-10 20hi kg carpet | 2 | 2.77 (a 4) | 2.27 (a 4) | 2.09 (a 5) | 2.10 (a 5) | 2.08 (a 4) | 2.01 (a 5) | - |
| AK40-10 20hi kg carpet | 5 | 5.82 (a 3) | 4.36 (a 5) | 3.67 (a 5) | 3.34 (a 5) | 3.15 (a 4) | 3.11 (a 5) | - |
| AK40-10 20hi kg carpet | 10 | 11.08 (a 3) | 7.86 (a 5) | 6.34 (a 5) | 5.50 (a 5) | 4.96 (a 4) | 4.73 (a 4) | - |
| AK40-10 20hi kg carpet | 15.2 | 16.49 (a 3) | 11.47 (a 5) | 9.08 (a 5) | 7.78 (a 4) | 6.90 (a 4) | 6.32 (a 4) | - |
| AK40-10 20hi kg floor | 2 | 2.71 (a 3) | 2.18 (a 5) | 2.01 (a 5) | 1.97 (a 5) | 1.98 (a 4) | 2.01 (a 4) | - |
| AK40-10 20hi kg floor | 5 | 5.89 (a 4) | 4.27 (a 5) | 3.59 (a 5) | 3.22 (a 5) | 3.04 (a 5) | 3.00 (a 5) | - |
| AK40-10 20hi kg floor | 10 | 11.09 (a 3) | 7.76 (a 5) | 6.21 (a 5) | 5.33 (a 5) | 4.78 (a 5) | 4.53 (a 5) | - |
| AK40-10 20hi kg floor | 15.2 | 16.44 (a 3) | 11.35 (a 5) | 8.91 (a 5) | 7.52 (a 5) | 6.60 (a 5) | 6.13 (a 5) | - |
| AK40-10-ds 10 kg carpet | 2 | - | - | - | - | - | - | - |
| AK40-10-ds 10 kg carpet | 5 | - | - | 3.72 (a 5) | - | 3.17 (a 5) | - | - |
| AK40-10-ds 10 kg carpet | 10 | - | - | - | - | - | - | - |
| AK40-10-ds 10 kg carpet | 15.2 | - | - | 9.17 (a 5) | - | 6.92 (a 5) | - | - |
| AK40-10-ds 10 kg floor | 2 | - | - | - | - | - | - | - |
| AK40-10-ds 10 kg floor | 5 | - | - | 3.65 (a 5) | - | 3.17 (a 5) | - | - |
| AK40-10-ds 10 kg floor | 10 | - | - | - | - | - | - | - |
| AK40-10-ds 10 kg floor | 15.2 | - | - | 8.99 (a 5) | - | 6.90 (a 5) | - | - |
| AK40-10-ds 20 kg carpet | 2 | - | - | - | - | - | - | - |
| AK40-10-ds 20 kg carpet | 5 | - | - | 3.69 (a 5) | - | 3.20 (a 5) | - | - |
| AK40-10-ds 20 kg carpet | 10 | - | - | - | - | - | - | - |
| AK40-10-ds 20 kg carpet | 15.2 | - | - | 9.13 (a 5) | - | 6.88 (a 5) | - | - |
| AK40-10-ds 20 kg floor | 2 | - | - | - | - | - | - | - |
| AK40-10-ds 20 kg floor | 5 | - | - | 3.58 (a 5) | - | 3.08 (a 5) | - | - |
| AK40-10-ds 20 kg floor | 10 | - | - | - | - | - | - | - |
| AK40-10-ds 20 kg floor | 15.2 | - | - | 8.89 (a 5) | - | 6.68 (a 5) | - | - |
| DM-2325-ds 10 kg carpet | 2 | - | - | - | - | - | - | - |
| DM-2325-ds 10 kg carpet | 5 | - | - | 3.72 (a 5) | - | 3.17 (a 5) | - | - |
| DM-2325-ds 10 kg carpet | 10 | - | - | - | - | - | - | - |
| DM-2325-ds 10 kg carpet | 15.2 | - | - | 9.13 (a 5) | - | 6.88 (a 5) | - | - |
| DM-2325-ds 10 kg floor | 2 | - | - | - | - | - | - | - |
| DM-2325-ds 10 kg floor | 5 | - | - | 3.65 (a 5) | - | 3.16 (a 5) | - | - |
| DM-2325-ds 10 kg floor | 10 | - | - | - | - | - | - | - |
| DM-2325-ds 10 kg floor | 15.2 | - | - | 9.02 (a 5) | - | 6.87 (a 5) | - | - |
| DM-2325-ds 20 kg carpet | 2 | - | - | - | - | - | - | - |
| DM-2325-ds 20 kg carpet | 5 | - | - | 3.66 (a 5) | - | 3.17 (a 5) | - | - |
| DM-2325-ds 20 kg carpet | 10 | - | - | - | - | - | - | - |
| DM-2325-ds 20 kg carpet | 15.2 | - | - | 9.06 (a 5) | - | 6.88 (a 5) | - | - |
| DM-2325-ds 20 kg floor | 2 | - | - | - | - | - | - | - |
| DM-2325-ds 20 kg floor | 5 | - | - | 3.60 (a 5) | - | 3.09 (a 5) | - | - |
| DM-2325-ds 20 kg floor | 10 | - | - | - | - | - | - | - |
| DM-2325-ds 20 kg floor | 15.2 | - | - | 8.97 (a 5) | - | 6.71 (a 5) | - | - |
| DM-2325-low-ds 10 kg carpet | 2 | - | - | - | - | - | - | - |
| DM-2325-low-ds 10 kg carpet | 5 | - | - | 3.72 (a 5) | - | 3.21 (a 5) | - | - |
| DM-2325-low-ds 10 kg carpet | 10 | - | - | - | - | - | - | - |
| DM-2325-low-ds 10 kg carpet | 15.2 | - | - | 9.20 (a 5) | - | 6.84 (a 5) | - | - |
| DM-2325-low-ds 10 kg floor | 2 | - | - | - | - | - | - | - |
| DM-2325-low-ds 10 kg floor | 5 | - | - | 3.67 (a 5) | - | 3.16 (a 5) | - | - |
| DM-2325-low-ds 10 kg floor | 10 | - | - | - | - | - | - | - |
| DM-2325-low-ds 10 kg floor | 15.2 | - | - | 8.99 (a 5) | - | 6.80 (a 5) | - | - |
| DM-2325-low-ds 20 kg carpet | 2 | - | - | - | - | - | - | - |
| DM-2325-low-ds 20 kg carpet | 5 | - | - | 3.60 (a 5) | - | 3.40 (a 3) | - | - |
| DM-2325-low-ds 20 kg carpet | 10 | - | - | - | - | - | - | - |
| DM-2325-low-ds 20 kg carpet | 15.2 | - | - | 8.91 (a 5) | - | 6.90 (a 5) | - | - |
| DM-2325-low-ds 20 kg floor | 2 | - | - | - | - | - | - | - |
| DM-2325-low-ds 20 kg floor | 5 | - | - | 3.78 (a 5) | - | 3.32 (a 3) | - | - |
| DM-2325-low-ds 20 kg floor | 10 | - | - | - | - | - | - | - |
| DM-2325-low-ds 20 kg floor | 15.2 | - | - | 9.03 (a 3) | - | 6.90 (a 3) | - | - |
| DM-J3507-ds 10 kg carpet | 2 | - | - | - | - | - | - | - |
| DM-J3507-ds 10 kg carpet | 5 | - | - | 3.71 (a 5) | - | 3.25 (a 5) | - | - |
| DM-J3507-ds 10 kg carpet | 10 | - | - | - | - | - | - | - |
| DM-J3507-ds 10 kg carpet | 15.2 | - | - | 9.20 (a 5) | - | 7.03 (a 5) | - | - |
| DM-J3507-ds 10 kg floor | 2 | - | - | - | - | - | - | - |
| DM-J3507-ds 10 kg floor | 5 | - | - | 3.64 (a 5) | - | 3.10 (a 5) | - | - |
| DM-J3507-ds 10 kg floor | 10 | - | - | - | - | - | - | - |
| DM-J3507-ds 10 kg floor | 15.2 | - | - | 9.01 (a 5) | - | 6.89 (a 5) | - | - |
| DM-J3507-ds 20 kg carpet | 2 | - | - | - | - | - | - | - |
| DM-J3507-ds 20 kg carpet | 5 | - | - | 3.74 (a 5) | - | 3.25 (a 5) | - | - |
| DM-J3507-ds 20 kg carpet | 10 | - | - | - | - | - | - | - |
| DM-J3507-ds 20 kg carpet | 15.2 | - | - | 9.12 (a 5) | - | 7.05 (a 5) | - | - |
| DM-J3507-ds 20 kg floor | 2 | - | - | - | - | - | - | - |
| DM-J3507-ds 20 kg floor | 5 | - | - | 3.44 (a 5) | - | 2.84 (a 5) | - | - |
| DM-J3507-ds 20 kg floor | 10 | - | - | - | - | - | - | - |
| DM-J3507-ds 20 kg floor | 15.2 | - | - | 8.75 (a 5) | - | 6.41 (a 5) | - | - |
| EduLite05-ds 10 kg carpet | 2 | - | - | - | - | - | - | - |
| EduLite05-ds 10 kg carpet | 5 | - | - | 3.75 (a 5) | - | 3.66 (a 5) | - | - |
| EduLite05-ds 10 kg carpet | 10 | - | - | - | - | - | - | - |
| EduLite05-ds 10 kg carpet | 15.2 | - | - | 9.23 (a 5) | - | 8.82 (a 5) | - | - |
| EduLite05-ds 10 kg floor | 2 | - | - | - | - | - | - | - |
| EduLite05-ds 10 kg floor | 5 | - | - | 3.66 (a 5) | - | 3.51 (a 5) | - | - |
| EduLite05-ds 10 kg floor | 10 | - | - | - | - | - | - | - |
| EduLite05-ds 10 kg floor | 15.2 | - | - | 9.06 (a 5) | - | 8.42 (a 5) | - | - |
| EduLite05-ds 20 kg carpet | 2 | - | - | - | - | - | - | - |
| EduLite05-ds 20 kg carpet | 5 | - | - | 3.73 (a 5) | - | 3.64 (a 5) | - | - |
| EduLite05-ds 20 kg carpet | 10 | - | - | - | - | - | - | - |
| EduLite05-ds 20 kg carpet | 15.2 | - | - | 9.23 (a 5) | - | 8.78 (a 5) | - | - |
| EduLite05-ds 20 kg floor | 2 | - | - | - | - | - | - | - |
| EduLite05-ds 20 kg floor | 5 | - | - | 3.62 (a 5) | - | 3.48 (a 5) | - | - |
| EduLite05-ds 20 kg floor | 10 | - | - | - | - | - | - | - |
| EduLite05-ds 20 kg floor | 15.2 | - | - | 8.99 (a 5) | - | 8.35 (a 5) | - | - |
| GIM3510-8-ds 10 kg carpet | 2 | - | - | - | - | - | - | - |
| GIM3510-8-ds 10 kg carpet | 5 | - | - | 3.75 (a 3) | - | 3.19 (a 5) | - | - |
| GIM3510-8-ds 10 kg carpet | 10 | - | - | - | - | - | - | - |
| GIM3510-8-ds 10 kg carpet | 15.2 | - | - | 9.20 (a 5) | - | 6.96 (a 5) | - | - |
| GIM3510-8-ds 10 kg floor | 2 | - | - | - | - | - | - | - |
| GIM3510-8-ds 10 kg floor | 5 | - | - | 3.63 (a 5) | - | 3.09 (a 5) | - | - |
| GIM3510-8-ds 10 kg floor | 10 | - | - | - | - | - | - | - |
| GIM3510-8-ds 10 kg floor | 15.2 | - | - | 8.96 (a 5) | - | 6.76 (a 5) | - | - |
| GIM3510-8-ds 20 kg carpet | 2 | - | - | - | - | - | - | - |
| GIM3510-8-ds 20 kg carpet | 5 | - | - | 3.81 (a 3) | - | 3.15 (a 5) | - | - |
| GIM3510-8-ds 20 kg carpet | 10 | - | - | - | - | - | - | - |
| GIM3510-8-ds 20 kg carpet | 15.2 | - | - | 9.16 (a 5) | - | 6.89 (a 5) | - | - |
| GIM3510-8-ds 20 kg floor | 2 | - | - | - | - | - | - | - |
| GIM3510-8-ds 20 kg floor | 5 | - | - | 3.44 (a 5) | - | 2.95 (a 5) | - | - |
| GIM3510-8-ds 20 kg floor | 10 | - | - | - | - | - | - | - |
| GIM3510-8-ds 20 kg floor | 15.2 | - | - | 8.96 (a 5) | - | 6.43 (a 5) | - | - |
| GIM4305-10-ds 10 kg carpet | 2 | - | - | - | - | - | - | - |
| GIM4305-10-ds 10 kg carpet | 5 | - | - | 3.76 (a 5) | - | 3.18 (a 5) | - | - |
| GIM4305-10-ds 10 kg carpet | 10 | - | - | - | - | - | - | - |
| GIM4305-10-ds 10 kg carpet | 15.2 | - | - | 9.13 (a 5) | - | 7.09 (a 5) | - | - |
| GIM4305-10-ds 10 kg floor | 2 | - | - | - | - | - | - | - |
| GIM4305-10-ds 10 kg floor | 5 | - | - | 3.65 (a 5) | - | 3.16 (a 5) | - | - |
| GIM4305-10-ds 10 kg floor | 10 | - | - | - | - | - | - | - |
| GIM4305-10-ds 10 kg floor | 15.2 | - | - | 8.99 (a 5) | - | 6.86 (a 5) | - | - |
| GIM4305-10-ds 20 kg carpet | 2 | - | - | - | - | - | - | - |
| GIM4305-10-ds 20 kg carpet | 5 | - | - | 3.74 (a 5) | - | 3.26 (a 5) | - | - |
| GIM4305-10-ds 20 kg carpet | 10 | - | - | - | - | - | - | - |
| GIM4305-10-ds 20 kg carpet | 15.2 | - | - | 9.09 (a 5) | - | 7.02 (a 5) | - | - |
| GIM4305-10-ds 20 kg floor | 2 | - | - | - | - | - | - | - |
| GIM4305-10-ds 20 kg floor | 5 | - | - | 3.61 (a 5) | - | 2.97 (a 5) | - | - |
| GIM4305-10-ds 20 kg floor | 10 | - | - | - | - | - | - | - |
| GIM4305-10-ds 20 kg floor | 15.2 | - | - | 8.83 (a 5) | - | 6.58 (a 5) | - | - |
| M2006-ds 10 kg carpet | 2 | - | - | - | - | - | - | - |
| M2006-ds 10 kg carpet | 5 | - | - | 3.68 (a 5) | - | 3.27 (a 5) | - | - |
| M2006-ds 10 kg carpet | 10 | - | - | - | - | - | - | - |
| M2006-ds 10 kg carpet | 15.2 | - | - | 9.13 (a 5) | - | 7.02 (a 5) | - | - |
| M2006-ds 10 kg floor | 2 | - | - | - | - | - | - | - |
| M2006-ds 10 kg floor | 5 | - | - | 3.71 (a 5) | - | 3.18 (a 5) | - | - |
| M2006-ds 10 kg floor | 10 | - | - | - | - | - | - | - |
| M2006-ds 10 kg floor | 15.2 | - | - | 9.10 (a 3) | - | 6.74 (a 5) | - | - |
| M2006-ds 20 kg carpet | 2 | - | - | - | - | - | - | - |
| M2006-ds 20 kg carpet | 5 | - | - | 3.58 (a 5) | - | 3.17 (a 5) | - | - |
| M2006-ds 20 kg carpet | 10 | - | - | - | - | - | - | - |
| M2006-ds 20 kg carpet | 15.2 | - | - | 9.01 (a 5) | - | 7.06 (a 5) | - | - |
| M2006-ds 20 kg floor | 2 | - | - | - | - | - | - | - |
| M2006-ds 20 kg floor | 5 | - | - | 3.80 (a 3) | - | 3.29 (a 3) | - | - |
| M2006-ds 20 kg floor | 10 | - | - | - | - | - | - | - |
| M2006-ds 20 kg floor | 15.2 | - | - | 9.10 (a 3) | - | 6.91 (a 3) | - | - |

## A. Acceleration and braking

### start (0.0, 1.5) m/s: clean acceleration (m/s^2, cause at the first failure)

| robot | 0 | 22.5 | 45 | 67.5 | 90 | 112.5 | 135 | 157.5 | 180 |
| --- | --- | --- | --- | --- | --- | --- | --- | --- | --- |
| AK40-10 10 kg carpet | 4.5 wheel-hop | 2.8 wheel-hop | 3.6 grip | 4.2 grip | 3.6 grip | 3.7 grip | 3.5 grip | 2.5 wheel-hop | 5.0 torque |
| AK40-10 10 kg carpet 20% | 4.5 wheel-hop | 2.8 wheel-hop | 3.6 grip | 4.2 grip | 3.6 grip | 3.7 grip | 3.5 grip | 2.5 wheel-hop | 5.0 wheel-hop |
| AK40-10 10 kg floor | 2.6 wheel-hop | 2.1 wheel-hop | 2.8 grip | 4.4 grip | 4.1 grip | 4.2 grip | 2.8 grip | 1.9 wheel-hop | 5.5 torque |
| AK40-10 10 kg floor 20% | 2.6 wheel-hop | 2.1 wheel-hop | 2.9 grip | 4.2 grip | 3.6 grip | 4.2 grip | 3.2 grip | 2.5 wheel-hop | 5.5 wheel-hop |
| AK40-10 10 kg floor loop=0.25 | 5.9 wheel-hop | 3.1 wheel-hop | 3.0 grip | 3.3 grip | 2.9 grip | 3.0 grip | 2.9 grip | 3.3 wheel-hop | 5.6 wheel-hop |
| AK40-10 15 kg carpet | 4.3 torque | 2.9 torque | 3.5 grip | 3.7 grip | 4.1 grip | 4.1 grip | 3.6 grip | 2.6 torque | 4.4 torque |
| AK40-10 15 kg carpet 20% | 4.3 torque | 2.9 wheel-hop | 3.5 grip | 3.6 grip | 4.4 supply | 3.7 grip | 3.6 grip | 2.6 wheel-hop | 4.4 torque |
| AK40-10 15 kg floor | 4.1 torque | 2.8 torque | 3.0 grip | 4.2 grip | 3.5 grip | 4.0 grip | 3.0 grip | 3.3 torque | 4.7 torque |
| AK40-10 15 kg floor 20% | 4.1 torque | 2.8 wheel-hop | 3.0 grip | 4.1 grip | 3.6 supply | 4.1 grip | 3.0 grip | 2.8 wheel-hop | 4.7 torque |
| AK40-10 20 kg carpet | 4.2 torque | 2.7 torque | 3.6 grip | 3.5 grip | 4.5 grip | 3.5 grip | 3.4 grip | 2.7 torque | 4.2 torque |
| AK40-10 20 kg carpet 20% | 4.2 torque | 2.6 torque | 3.5 grip | 3.5 grip | 4.5 supply | 3.7 grip | 3.4 grip | 2.7 torque | 4.3 torque |
| AK40-10 20 kg floor | 4.5 grip | 3.3 torque | 3.2 grip | 3.7 grip | 3.4 grip | 3.5 grip | 3.2 grip | 3.2 torque | 4.5 grip |
| AK40-10 20 kg floor 20% | 4.5 grip | 3.2 torque | 3.2 grip | 3.7 grip | 3.4 supply | 3.6 grip | 3.2 grip | 2.8 torque | 4.5 grip |
| AK40-10 20 kg floor loop=0.25 | 4.9 grip | 3.8 torque | 2.9 grip | 2.2 grip | 2.1 grip | 2.6 grip | 3.0 grip | 4.1 grip | 4.8 grip |
| AK40-10 20hi kg carpet | 4.1 torque | 2.5 torque | 3.3 grip | 3.4 grip | 3.2 grip | 2.9 grip | 3.2 grip | 2.6 torque | 4.0 torque |
| AK40-10 20hi kg carpet 20% | 4.1 torque | 2.5 torque | 3.2 grip | 3.3 grip | 2.8 supply | 2.8 grip | 2.9 grip | 2.5 torque | 4.0 torque |
| AK40-10 20hi kg floor | 4.2 torque | 2.5 torque | 2.7 grip | 2.8 grip | 2.7 grip | 2.9 grip | 2.9 grip | 2.5 torque | 4.3 torque |
| AK40-10 20hi kg floor 20% | 4.2 torque | 2.5 wheel-hop | 2.7 grip | 2.6 grip | 2.7 supply | 2.9 supply | 2.9 grip | 2.5 torque | 4.3 torque |
| AK40-10-ds 10 kg carpet | 4.3 wheel-hop | - | 3.6 grip | - | 4.7 grip | - | 3.6 grip | - | 4.9 torque |
| AK40-10-ds 10 kg carpet 20% | 4.3 wheel-hop | - | 3.6 grip | - | 4.7 grip | - | 3.6 grip | - | 4.9 torque |
| AK40-10-ds 10 kg floor | 2.6 wheel-hop | - | 3.7 grip | - | 4.1 grip | - | 2.7 grip | - | 5.8 grip |
| AK40-10-ds 10 kg floor 20% | 2.6 wheel-hop | - | 3.7 grip | - | 4.1 grip | - | 2.7 grip | - | 5.8 grip |
| AK40-10-ds 20 kg carpet | 4.2 torque | - | 3.6 grip | - | 4.4 grip | - | 3.4 grip | - | 4.2 torque |
| AK40-10-ds 20 kg carpet 20% | 4.2 torque | - | 3.6 grip | - | 4.4 supply | - | 3.4 grip | - | 4.2 torque |
| AK40-10-ds 20 kg floor | 4.5 grip | - | 3.1 grip | - | 3.4 grip | - | 3.2 grip | - | 4.5 torque |
| AK40-10-ds 20 kg floor 20% | 4.5 grip | - | 3.2 grip | - | 3.4 supply | - | 3.2 grip | - | 4.5 torque |
| DM-2325-ds 10 kg carpet | 4.9 wheel-hop | - | 3.7 grip | - | 4.1 grip | - | 3.5 grip | - | 5.5 wheel-hop |
| DM-2325-ds 10 kg carpet 20% | 4.8 supply | - | 3.6 grip | - | 4.1 supply | - | 3.4 grip | - | 5.5 supply |
| DM-2325-ds 10 kg floor | 4.0 wheel-hop | - | 2.7 grip | - | 4.1 grip | - | 2.7 grip | - | 5.8 wheel-hop |
| DM-2325-ds 10 kg floor 20% | 4.0 wheel-hop | - | 3.6 grip | - | 3.8 supply | - | 2.8 grip | - | 5.8 supply |
| DM-2325-ds 20 kg carpet | 4.4 torque | - | 3.7 grip | - | 4.7 grip | - | 3.4 grip | - | 4.3 torque |
| DM-2325-ds 20 kg carpet 20% | 4.3 supply | - | 3.6 grip | - | 4.0 supply | - | 3.4 grip | - | 4.3 supply |
| DM-2325-ds 20 kg floor | 4.8 torque | - | 3.4 grip | - | 3.6 grip | - | 3.3 grip | - | 4.9 torque |
| DM-2325-ds 20 kg floor 20% | 4.7 supply | - | 3.3 grip | - | 3.5 supply | - | 3.3 grip | - | 4.7 supply |
| DM-2325-low-ds 10 kg carpet | 4.0 torque | - | 3.3 grip | - | 4.0 grip | - | 3.3 grip | - | 3.9 torque |
| DM-2325-low-ds 10 kg carpet 20% | 4.0 torque | - | 3.3 grip | - | 4.0 grip | - | 3.3 grip | - | 3.9 torque |
| DM-2325-low-ds 10 kg floor | 4.3 torque | - | 3.4 grip | - | 4.3 grip | - | 3.1 grip | - | 4.3 torque |
| DM-2325-low-ds 10 kg floor 20% | 4.3 torque | - | 3.4 grip | - | 4.3 grip | - | 3.1 grip | - | 4.3 torque |
| DM-2325-low-ds 20 kg carpet | 2.8 grip | - | 1.6 torque | - | 2.2 grip | - | 1.6 torque | - | 2.7 grip |
| DM-2325-low-ds 20 kg carpet 20% | 2.8 grip | - | 1.6 torque | - | 2.2 grip | - | 1.6 torque | - | 2.7 grip |
| DM-2325-low-ds 20 kg floor | 3.3 grip | - | 2.1 torque | - | 2.5 grip | - | 2.1 torque | - | 3.0 grip |
| DM-2325-low-ds 20 kg floor 20% | 3.3 grip | - | 2.1 torque | - | 2.5 grip | - | 2.1 torque | - | 3.0 grip |
| DM-J3507-ds 10 kg carpet | 3.9 torque | - | 3.4 grip | - | 4.1 grip | - | 3.6 grip | - | 4.7 torque |
| DM-J3507-ds 10 kg carpet 20% | 3.8 rpm | - | 3.4 grip | - | 4.1 grip | - | 3.6 grip | - | 4.2 rpm |
| DM-J3507-ds 10 kg floor | 3.7 torque | - | 3.5 grip | - | 4.1 grip | - | 2.7 grip | - | 4.3 torque |
| DM-J3507-ds 10 kg floor 20% | 3.7 rpm | - | 3.3 grip | - | 4.1 grip | - | 2.6 grip | - | 4.4 rpm |
| DM-J3507-ds 20 kg carpet | 3.7 grip | - | 2.9 grip | - | 3.3 grip | - | 2.8 grip | - | 3.5 grip |
| DM-J3507-ds 20 kg carpet 20% | 1.9 rpm | - | 2.4 rpm | - | 3.0 grip | - | 2.3 rpm | - | 3.3 rpm |
| DM-J3507-ds 20 kg floor | 4.1 grip | - | 2.8 grip | - | 2.9 grip | - | 2.9 grip | - | 3.8 grip |
| DM-J3507-ds 20 kg floor 20% | 3.8 rpm | - | 2.6 grip | - | 3.3 grip | - | 2.7 grip | - | 3.7 rpm |
| EduLite05-ds 10 kg carpet | 4.2 wheel-hop | - | 3.4 grip | - | 5.2 grip | - | 3.4 grip | - | 5.0 wheel-hop |
| EduLite05-ds 10 kg carpet 20% | 3.9 rpm | - | 0.2 rpm | - | 3.8 grip | - | 0.2 rpm | - | 4.4 rpm |
| EduLite05-ds 10 kg floor | 2.6 wheel-hop | - | 3.0 grip | - | 3.6 grip | - | 2.9 grip | - | 4.3 wheel-hop |
| EduLite05-ds 10 kg floor 20% | 2.6 wheel-hop | - | 0.2 rpm | - | 3.5 grip | - | 0.2 rpm | - | 4.3 wheel-hop |
| EduLite05-ds 20 kg carpet | 4.2 rpm | - | 3.2 grip | - | 4.2 grip | - | 3.0 grip | - | 4.2 rpm |
| EduLite05-ds 20 kg carpet 20% | 4.1 rpm | - | 0.2 rpm | - | 4.0 grip | - | 0.2 rpm | - | 4.1 rpm |
| EduLite05-ds 20 kg floor | 4.4 rpm | - | 2.9 grip | - | 3.5 grip | - | 3.0 grip | - | 4.5 rpm |
| EduLite05-ds 20 kg floor 20% | 4.3 rpm | - | 0.2 rpm | - | 3.8 grip | - | 0.2 rpm | - | 4.4 rpm |
| GIM3510-8-ds 10 kg carpet | 4.1 torque | - | 3.5 grip | - | 4.0 grip | - | 3.8 grip | - | 4.7 torque |
| GIM3510-8-ds 10 kg carpet 20% | 4.1 torque | - | 3.5 grip | - | 4.0 grip | - | 3.8 grip | - | 4.7 torque |
| GIM3510-8-ds 10 kg floor | 3.7 wheel-hop | - | 3.4 grip | - | 4.2 grip | - | 2.8 grip | - | 4.3 wheel-hop |
| GIM3510-8-ds 10 kg floor 20% | 3.7 wheel-hop | - | 3.4 grip | - | 4.2 grip | - | 2.8 grip | - | 4.3 wheel-hop |
| GIM3510-8-ds 20 kg carpet | 4.0 grip | - | 3.3 grip | - | 3.3 grip | - | 3.2 grip | - | 3.9 grip |
| GIM3510-8-ds 20 kg carpet 20% | 4.0 grip | - | 3.3 grip | - | 3.3 grip | - | 3.2 grip | - | 3.9 grip |
| GIM3510-8-ds 20 kg floor | 4.1 torque | - | 3.0 grip | - | 3.3 grip | - | 3.1 grip | - | 4.1 grip |
| GIM3510-8-ds 20 kg floor 20% | 4.1 torque | - | 3.0 grip | - | 3.3 grip | - | 3.1 grip | - | 4.1 grip |
| GIM4305-10-ds 10 kg carpet | 4.1 torque | - | 3.5 grip | - | 4.2 grip | - | 3.6 grip | - | 4.7 torque |
| GIM4305-10-ds 10 kg carpet 20% | 4.0 rpm | - | 3.5 grip | - | 4.2 grip | - | 3.6 grip | - | 4.7 torque |
| GIM4305-10-ds 10 kg floor | 3.7 wheel-hop | - | 3.5 grip | - | 3.7 grip | - | 2.6 wheel-hop | - | 5.7 torque |
| GIM4305-10-ds 10 kg floor 20% | 2.6 wheel-hop | - | 3.5 grip | - | 3.6 grip | - | 2.9 grip | - | 5.4 torque |
| GIM4305-10-ds 20 kg carpet | 4.0 grip | - | 3.3 grip | - | 4.0 grip | - | 3.2 grip | - | 3.9 grip |
| GIM4305-10-ds 20 kg carpet 20% | 3.8 torque | - | 3.0 grip | - | 3.7 grip | - | 2.9 grip | - | 3.8 grip |
| GIM4305-10-ds 20 kg floor | 4.1 grip | - | 3.0 grip | - | 3.3 grip | - | 3.1 grip | - | 4.1 grip |
| GIM4305-10-ds 20 kg floor 20% | 4.1 grip | - | 2.9 grip | - | 3.3 grip | - | 2.9 grip | - | 4.2 grip |
| M2006-ds 10 kg carpet | 3.8 torque | - | 3.2 grip | - | 3.2 grip | - | 3.0 grip | - | 3.7 torque |
| M2006-ds 10 kg carpet 20% | 3.8 torque | - | 3.2 grip | - | 3.2 grip | - | 3.0 grip | - | 3.7 torque |
| M2006-ds 10 kg floor | 4.1 torque | - | 2.8 grip | - | 3.6 grip | - | 3.3 grip | - | 4.0 torque |
| M2006-ds 10 kg floor 20% | 4.1 torque | - | 2.8 grip | - | 3.6 grip | - | 3.3 grip | - | 4.0 torque |
| M2006-ds 20 kg carpet | 2.1 torque | - | 1.3 torque | - | 2.0 grip | - | 1.2 torque | - | 2.3 torque |
| M2006-ds 20 kg carpet 20% | 2.1 torque | - | 1.3 torque | - | 2.0 grip | - | 1.2 torque | - | 2.3 torque |
| M2006-ds 20 kg floor | 2.7 torque | - | 1.8 torque | - | 2.3 grip | - | 1.8 torque | - | 2.8 torque |
| M2006-ds 20 kg floor 20% | 2.7 torque | - | 1.8 torque | - | 2.3 grip | - | 1.8 torque | - | 2.8 torque |

### brake (1.5, 0.0) m/s: clean acceleration (m/s^2, cause at the first failure)

| robot | 0 | 22.5 | 45 | 67.5 | 90 | 112.5 | 135 | 157.5 | 180 |
| --- | --- | --- | --- | --- | --- | --- | --- | --- | --- |
| AK40-10 10 kg carpet | 7.4 wheel-hop | 5.4 wheel-hop | 4.3 grip | 4.6 grip | 4.5 grip | 4.4 grip | 4.1 grip | 5.4 wheel-hop | 7.1 wheel-hop |
| AK40-10 10 kg carpet 20% | 7.4 wheel-hop | 5.1 wheel-hop | 4.3 grip | 4.4 grip | 4.5 grip | 4.4 grip | 4.3 grip | 5.4 wheel-hop | 7.1 wheel-hop |
| AK40-10 10 kg floor | 7.4 wheel-hop | 4.5 wheel-hop | 4.3 grip | 4.5 grip | 4.7 grip | 4.5 grip | 4.5 grip | 5.1 wheel-hop | 7.2 wheel-hop |
| AK40-10 10 kg floor 20% | 7.4 wheel-hop | 4.8 wheel-hop | 4.3 grip | 4.7 grip | 4.7 grip | 4.5 grip | 4.7 grip | 5.0 wheel-hop | 7.2 wheel-hop |
| AK40-10 10 kg floor loop=0.25 | 7.3 wheel-hop | 4.9 wheel-hop | 3.3 grip | 3.6 grip | 4.0 grip | 3.6 grip | 3.8 grip | 5.0 wheel-hop | 7.1 wheel-hop |
| AK40-10 15 kg carpet | 6.9 torque | 5.1 wheel-hop | 4.3 grip | 4.8 grip | 4.8 grip | 4.4 grip | 4.1 wheel-hop | 5.2 wheel-hop | 7.2 torque |
| AK40-10 15 kg carpet 20% | 6.7 torque | 5.2 wheel-hop | 4.2 grip | 4.8 grip | 4.8 grip | 4.4 grip | 4.1 wheel-hop | 5.2 wheel-hop | 7.2 torque |
| AK40-10 15 kg floor | 6.7 torque | 4.8 wheel-hop | 4.2 grip | 4.7 grip | 4.5 grip | 4.5 grip | 4.1 grip | 4.8 wheel-hop | 7.4 torque |
| AK40-10 15 kg floor 20% | 6.6 torque | 4.9 wheel-hop | 4.3 grip | 4.9 grip | 4.6 grip | 4.5 grip | 4.2 grip | 4.9 wheel-hop | 7.4 torque |
| AK40-10 20 kg carpet | 6.1 torque | 5.3 torque | 4.5 grip | 4.6 grip | 4.5 grip | 4.4 grip | 4.4 grip | 5.4 torque | 6.5 torque |
| AK40-10 20 kg carpet 20% | 6.2 torque | 5.2 torque | 4.5 grip | 4.4 grip | 4.5 grip | 4.4 grip | 4.4 grip | 5.5 torque | 6.5 torque |
| AK40-10 20 kg floor | 5.9 torque | 5.1 torque | 4.4 grip | 4.4 grip | 4.3 grip | 4.2 grip | 4.1 grip | 4.8 torque | 6.3 torque |
| AK40-10 20 kg floor 20% | 6.0 torque | 5.0 torque | 4.3 grip | 4.4 grip | 4.2 grip | 4.2 grip | 4.1 grip | 4.8 torque | 6.3 torque |
| AK40-10 20 kg floor loop=0.25 | 6.2 torque | 4.0 wheel-hop | 3.3 wheel-hop | 2.9 grip | 2.9 grip | 2.9 grip | 2.7 wheel-hop | 4.5 wheel-hop | 5.7 torque |
| AK40-10 20hi kg carpet | 4.8 torque | 4.7 torque | 4.1 grip | 3.7 grip | 3.8 grip | 3.5 grip | 3.8 grip | 4.8 torque | 5.7 torque |
| AK40-10 20hi kg carpet 20% | 4.8 torque | 4.8 grip | 4.1 grip | 3.7 grip | 3.8 grip | 3.3 grip | 3.8 grip | 4.8 torque | 5.7 torque |
| AK40-10 20hi kg floor | 5.5 torque | 4.9 grip | 3.7 grip | 3.6 grip | 3.7 grip | 3.5 grip | 3.8 grip | 4.7 torque | 5.6 torque |
| AK40-10 20hi kg floor 20% | 5.5 torque | 4.8 grip | 3.7 grip | 3.5 grip | 3.7 grip | 3.5 grip | 3.8 grip | 4.7 torque | 5.5 torque |
| AK40-10-ds 10 kg carpet | 7.3 wheel-hop | - | 4.4 grip | - | 4.5 grip | - | 4.1 grip | - | 6.9 wheel-hop |
| AK40-10-ds 10 kg carpet 20% | 7.3 wheel-hop | - | 4.4 grip | - | 4.5 grip | - | 4.1 grip | - | 6.9 wheel-hop |
| AK40-10-ds 10 kg floor | 7.4 torque | - | 4.3 grip | - | 4.8 grip | - | 4.8 grip | - | 7.1 torque |
| AK40-10-ds 10 kg floor 20% | 7.4 torque | - | 4.3 grip | - | 4.8 grip | - | 4.6 grip | - | 7.1 torque |
| AK40-10-ds 20 kg carpet | 6.1 torque | - | 4.8 grip | - | 4.4 grip | - | 4.5 grip | - | 6.3 torque |
| AK40-10-ds 20 kg carpet 20% | 6.1 torque | - | 4.5 grip | - | 4.4 grip | - | 4.5 grip | - | 6.3 torque |
| AK40-10-ds 20 kg floor | 5.8 torque | - | 4.3 grip | - | 4.2 grip | - | 4.1 grip | - | 6.2 torque |
| AK40-10-ds 20 kg floor 20% | 5.8 torque | - | 4.3 grip | - | 4.2 grip | - | 4.1 grip | - | 6.2 torque |
| DM-2325-ds 10 kg carpet | 7.4 wheel-hop | - | 4.7 grip | - | 4.6 grip | - | 4.1 grip | - | 7.0 wheel-hop |
| DM-2325-ds 10 kg carpet 20% | 7.4 wheel-hop | - | 4.7 grip | - | 4.6 supply | - | 4.1 grip | - | 7.0 wheel-hop |
| DM-2325-ds 10 kg floor | 7.5 wheel-hop | - | 4.3 grip | - | 5.0 grip | - | 4.6 grip | - | 7.2 wheel-hop |
| DM-2325-ds 10 kg floor 20% | 7.5 wheel-hop | - | 4.3 grip | - | 4.7 grip | - | 4.7 grip | - | 7.2 wheel-hop |
| DM-2325-ds 20 kg carpet | 6.6 torque | - | 4.7 grip | - | 4.5 grip | - | 4.3 grip | - | 7.0 torque |
| DM-2325-ds 20 kg carpet 20% | 6.6 torque | - | 4.9 grip | - | 4.5 supply | - | 4.3 grip | - | 6.9 torque |
| DM-2325-ds 20 kg floor | 6.3 torque | - | 4.2 grip | - | 4.5 grip | - | 4.2 grip | - | 7.0 torque |
| DM-2325-ds 20 kg floor 20% | 6.4 torque | - | 4.2 grip | - | 4.5 supply | - | 4.2 grip | - | 7.0 torque |
| DM-2325-low-ds 10 kg carpet | 6.3 torque | - | 4.3 grip | - | 4.5 grip | - | 4.3 grip | - | 6.4 torque |
| DM-2325-low-ds 10 kg carpet 20% | 6.3 torque | - | 4.3 grip | - | 4.5 grip | - | 4.3 grip | - | 6.4 torque |
| DM-2325-low-ds 10 kg floor | 5.8 torque | - | 4.3 grip | - | 4.4 grip | - | 4.4 grip | - | 6.1 torque |
| DM-2325-low-ds 10 kg floor 20% | 5.8 torque | - | 4.3 grip | - | 4.4 grip | - | 4.4 grip | - | 6.1 torque |
| DM-2325-low-ds 20 kg carpet | 4.7 torque | - | 3.7 torque | - | 3.7 grip | - | 3.7 grip | - | 4.9 grip |
| DM-2325-low-ds 20 kg carpet 20% | 4.7 torque | - | 3.7 torque | - | 3.7 grip | - | 3.7 grip | - | 4.9 grip |
| DM-2325-low-ds 20 kg floor | 4.3 torque | - | 3.4 grip | - | 3.4 grip | - | 3.4 torque | - | 4.6 grip |
| DM-2325-low-ds 20 kg floor 20% | 4.3 torque | - | 3.4 grip | - | 3.4 grip | - | 3.4 torque | - | 4.6 grip |
| DM-J3507-ds 10 kg carpet | 7.0 torque | - | 4.2 grip | - | 4.5 grip | - | 4.3 grip | - | 6.9 torque |
| DM-J3507-ds 10 kg carpet 20% | 7.2 torque | - | 4.3 grip | - | 4.8 grip | - | 4.3 grip | - | 7.1 torque |
| DM-J3507-ds 10 kg floor | 7.0 torque | - | 4.7 grip | - | 4.9 grip | - | 4.5 grip | - | 7.3 torque |
| DM-J3507-ds 10 kg floor 20% | 5.2 torque | - | 4.8 grip | - | 4.7 grip | - | 4.5 grip | - | 7.3 torque |
| DM-J3507-ds 20 kg carpet | 5.2 torque | - | 4.4 grip | - | 4.1 grip | - | 4.1 grip | - | 5.5 torque |
| DM-J3507-ds 20 kg carpet 20% | 5.1 torque | - | 4.3 grip | - | 4.3 grip | - | 4.2 grip | - | 5.6 torque |
| DM-J3507-ds 20 kg floor | 5.1 torque | - | 4.3 grip | - | 4.1 grip | - | 4.2 grip | - | 5.1 grip |
| DM-J3507-ds 20 kg floor 20% | 5.1 torque | - | 4.0 grip | - | 4.2 grip | - | 4.3 grip | - | 5.1 torque |
| EduLite05-ds 10 kg carpet | 7.2 wheel-hop | - | 4.1 grip | - | 4.5 grip | - | 4.1 grip | - | 7.1 wheel-hop |
| EduLite05-ds 10 kg carpet 20% | 7.7 wheel-hop | - | 4.8 grip | - | 4.5 grip | - | 4.4 grip | - | 7.0 wheel-hop |
| EduLite05-ds 10 kg floor | 7.0 wheel-hop | - | 4.2 grip | - | 5.0 grip | - | 4.1 grip | - | 7.1 wheel-hop |
| EduLite05-ds 10 kg floor 20% | 7.3 wheel-hop | - | 4.3 grip | - | 4.8 grip | - | 4.5 grip | - | 7.0 wheel-hop |
| EduLite05-ds 20 kg carpet | 6.6 torque | - | 4.6 grip | - | 4.6 grip | - | 4.5 grip | - | 6.7 grip |
| EduLite05-ds 20 kg carpet 20% | 6.4 torque | - | 4.6 grip | - | 4.5 grip | - | 4.4 grip | - | 6.7 grip |
| EduLite05-ds 20 kg floor | 7.0 torque | - | 4.5 grip | - | 4.5 grip | - | 4.3 grip | - | 7.3 torque |
| EduLite05-ds 20 kg floor 20% | 6.8 torque | - | 4.4 grip | - | 4.5 grip | - | 4.4 grip | - | 6.9 grip |
| GIM3510-8-ds 10 kg carpet | 6.9 torque | - | 4.1 grip | - | 4.4 grip | - | 4.4 grip | - | 6.9 torque |
| GIM3510-8-ds 10 kg carpet 20% | 6.9 torque | - | 4.1 grip | - | 4.4 grip | - | 4.4 grip | - | 6.9 torque |
| GIM3510-8-ds 10 kg floor | 7.1 torque | - | 4.5 grip | - | 4.8 grip | - | 4.1 grip | - | 7.2 torque |
| GIM3510-8-ds 10 kg floor 20% | 7.1 torque | - | 4.5 grip | - | 4.8 grip | - | 4.1 grip | - | 7.2 torque |
| GIM3510-8-ds 20 kg carpet | 5.6 torque | - | 4.4 grip | - | 4.4 grip | - | 4.5 grip | - | 5.9 torque |
| GIM3510-8-ds 20 kg carpet 20% | 5.6 torque | - | 4.4 grip | - | 4.4 grip | - | 4.5 grip | - | 5.9 torque |
| GIM3510-8-ds 20 kg floor | 5.1 torque | - | 4.2 grip | - | 4.2 grip | - | 4.1 grip | - | 5.4 torque |
| GIM3510-8-ds 20 kg floor 20% | 5.1 torque | - | 4.2 grip | - | 4.2 grip | - | 4.1 grip | - | 5.4 torque |
| GIM4305-10-ds 10 kg carpet | 7.0 torque | - | 4.3 grip | - | 4.6 grip | - | 4.4 grip | - | 6.9 torque |
| GIM4305-10-ds 10 kg carpet 20% | 7.0 torque | - | 4.4 grip | - | 4.9 grip | - | 4.3 grip | - | 7.0 torque |
| GIM4305-10-ds 10 kg floor | 7.0 torque | - | 4.5 grip | - | 4.8 grip | - | 4.3 grip | - | 7.2 torque |
| GIM4305-10-ds 10 kg floor 20% | 5.4 torque | - | 4.7 grip | - | 4.8 grip | - | 4.8 grip | - | 7.3 torque |
| GIM4305-10-ds 20 kg carpet | 5.6 torque | - | 4.7 grip | - | 4.3 grip | - | 4.4 grip | - | 5.9 torque |
| GIM4305-10-ds 20 kg carpet 20% | 5.7 torque | - | 4.3 grip | - | 4.4 grip | - | 4.2 grip | - | 5.9 torque |
| GIM4305-10-ds 20 kg floor | 5.1 torque | - | 4.4 grip | - | 4.3 grip | - | 4.1 grip | - | 5.6 torque |
| GIM4305-10-ds 20 kg floor 20% | 5.2 torque | - | 4.4 grip | - | 4.2 grip | - | 3.8 grip | - | 5.6 torque |
| M2006-ds 10 kg carpet | 6.1 torque | - | 4.5 grip | - | 4.7 grip | - | 4.4 grip | - | 6.2 torque |
| M2006-ds 10 kg carpet 20% | 6.1 torque | - | 4.5 grip | - | 4.7 grip | - | 4.4 grip | - | 6.2 torque |
| M2006-ds 10 kg floor | 5.5 torque | - | 4.3 grip | - | 4.4 grip | - | 4.4 grip | - | 5.9 torque |
| M2006-ds 10 kg floor 20% | 5.5 torque | - | 4.3 grip | - | 4.4 grip | - | 4.4 grip | - | 5.9 torque |
| M2006-ds 20 kg carpet | 4.6 torque | - | 3.5 torque | - | 4.0 grip | - | 3.6 grip | - | 4.9 grip |
| M2006-ds 20 kg carpet 20% | 4.6 torque | - | 3.5 torque | - | 4.0 grip | - | 3.6 grip | - | 4.9 grip |
| M2006-ds 20 kg floor | 4.3 grip | - | 3.3 grip | - | 3.4 grip | - | 3.3 grip | - | 4.5 grip |
| M2006-ds 20 kg floor 20% | 4.3 grip | - | 3.3 grip | - | 3.4 grip | - | 3.3 grip | - | 4.5 grip |

### at speed (1.5, 2.5) m/s: clean acceleration (m/s^2, cause at the first failure)

| robot | 0 | 22.5 | 45 | 67.5 | 90 | 112.5 | 135 | 157.5 | 180 |
| --- | --- | --- | --- | --- | --- | --- | --- | --- | --- |
| AK40-10 10 kg carpet | 0.2 rpm | 1.6 rpm | 3.2 rpm | 2.7 rpm | 0.2 rpm | 2.3 rpm | 2.3 rpm | 2.0 rpm | 0.7 rpm |
| AK40-10 10 kg carpet 20% | 0.2 rpm | 1.8 rpm | 3.0 rpm | 2.6 rpm | 0.2 rpm | 2.6 rpm | 2.8 rpm | 1.5 rpm | 0.5 rpm |
| AK40-10 10 kg floor | 0.2 rpm | 1.7 rpm | 2.3 rpm | 1.5 rpm | 0.9 wheel-hop | 2.0 wheel-hop | 2.2 rpm | 1.1 rpm | 0.8 wheel-hop |
| AK40-10 10 kg floor 20% | 0.4 rpm | 1.2 rpm | 2.5 rpm | 2.0 rpm | 0.2 rpm | 1.1 rpm | 2.3 rpm | 1.2 rpm | 0.9 rpm |
| AK40-10 10 kg floor loop=0.25 | 0.2 wheel-hop | 1.2 wheel-hop | 2.0 wheel-hop | 1.3 wheel-hop | 0.8 wheel-hop | 2.3 wheel-hop | 1.8 wheel-hop | 1.0 wheel-hop | 0.9 wheel-hop |
| AK40-10 15 kg carpet | 0.2 rpm | 1.6 rpm | 2.8 rpm | 2.7 rpm | 0.2 grip | 2.7 rpm | 3.2 rpm | 1.5 rpm | 0.7 rpm |
| AK40-10 15 kg carpet 20% | 0.2 rpm | 0.9 rpm | 2.2 rpm | 2.7 rpm | 1.9 grip | 2.4 rpm | 2.4 rpm | 1.2 rpm | 0.7 rpm |
| AK40-10 15 kg floor | 0.7 rpm | 1.3 rpm | 1.9 rpm | 2.2 rpm | 1.4 rpm | 1.2 rpm | 1.4 rpm | 1.3 rpm | 1.3 rpm |
| AK40-10 15 kg floor 20% | 0.7 rpm | 0.7 rpm | 1.9 rpm | 2.1 rpm | 1.1 rpm | 0.5 rpm | 1.1 rpm | 0.9 rpm | 1.5 rpm |
| AK40-10 20 kg carpet | 0.2 rpm | 1.1 rpm | 2.3 rpm | 2.8 rpm | 0.8 rpm | 2.5 rpm | 2.2 rpm | 1.1 rpm | 0.7 rpm |
| AK40-10 20 kg carpet 20% | 0.2 rpm | 1.6 rpm | 1.6 rpm | 2.2 rpm | 2.0 grip | 2.0 rpm | 1.5 rpm | 0.8 rpm | 0.5 rpm |
| AK40-10 20 kg floor | 1.6 rpm | 0.9 rpm | 2.0 rpm | 2.3 rpm | 2.0 rpm | 1.6 rpm | 0.8 rpm | 1.1 rpm | 2.6 rpm |
| AK40-10 20 kg floor 20% | 1.2 rpm | 0.7 rpm | 0.5 rpm | 1.3 rpm | 0.6 rpm | 1.3 rpm | 0.5 rpm | 1.1 rpm | 1.4 rpm |
| AK40-10 20 kg floor loop=0.25 | 2.7 grip | 1.9 rpm | 2.0 rpm | 2.1 rpm | 2.1 grip | 2.3 rpm | 1.8 rpm | 1.9 rpm | 3.2 grip |
| AK40-10 20hi kg carpet | 0.2 rpm | 1.3 rpm | 2.1 rpm | 2.8 rpm | 0.7 rpm | 2.0 rpm | 2.4 rpm | 1.1 rpm | 1.3 rpm |
| AK40-10 20hi kg carpet 20% | 0.2 rpm | 1.1 rpm | 1.5 rpm | 2.1 rpm | 0.2 grip | 1.1 rpm | 1.6 rpm | 0.8 rpm | 0.5 rpm |
| AK40-10 20hi kg floor | 2.4 rpm | 1.2 rpm | 1.9 rpm | 2.0 rpm | 1.6 rpm | 1.7 rpm | 1.0 rpm | 1.1 rpm | 2.3 rpm |
| AK40-10 20hi kg floor 20% | 1.8 rpm | 0.6 rpm | 0.5 rpm | 1.4 rpm | 1.2 rpm | 1.4 rpm | 0.6 rpm | 1.1 rpm | 2.4 rpm |
| AK40-10-ds 10 kg carpet | 0.2 torque | - | 2.6 wheel-hop | - | 0.2 torque | - | 1.9 rpm | - | 0.2 torque |
| AK40-10-ds 10 kg carpet 20% | 0.2 rpm | - | 2.4 rpm | - | 0.5 rpm | - | 2.4 rpm | - | 0.4 rpm |
| AK40-10-ds 10 kg floor | 0.2 torque | - | 2.6 wheel-hop | - | 1.5 grip | - | 2.0 wheel-hop | - | 0.9 wheel-hop |
| AK40-10-ds 10 kg floor 20% | 0.4 rpm | - | 2.6 rpm | - | 0.3 rpm | - | 2.1 rpm | - | 0.9 wheel-hop |
| AK40-10-ds 20 kg carpet | 0.2 torque | - | 2.5 rpm | - | 1.3 grip | - | 2.5 rpm | - | 0.7 torque |
| AK40-10-ds 20 kg carpet 20% | 0.2 grip | - | 1.5 rpm | - | 1.2 grip | - | 1.4 rpm | - | 0.7 rpm |
| AK40-10-ds 20 kg floor | 1.3 torque | - | 2.0 rpm | - | 0.6 torque | - | 1.3 rpm | - | 2.6 torque |
| AK40-10-ds 20 kg floor 20% | 1.5 rpm | - | 0.5 rpm | - | 0.6 rpm | - | 0.7 rpm | - | 1.4 rpm |
| DM-2325-ds 10 kg carpet | 0.2 rpm | - | 2.9 wheel-hop | - | 0.3 rpm | - | 3.0 wheel-hop | - | 0.9 rpm |
| DM-2325-ds 10 kg carpet 20% | 0.7 rpm | - | 2.8 rpm | - | 0.2 rpm | - | 2.9 rpm | - | 0.3 rpm |
| DM-2325-ds 10 kg floor | 1.2 wheel-hop | - | 2.0 wheel-hop | - | 0.4 wheel-hop | - | 1.5 wheel-hop | - | 1.0 wheel-hop |
| DM-2325-ds 10 kg floor 20% | 1.1 rpm | - | 2.3 rpm | - | 0.5 rpm | - | 1.1 rpm | - | 1.1 wheel-hop |
| DM-2325-ds 20 kg carpet | 0.2 rpm | - | 2.8 rpm | - | 0.8 rpm | - | 2.7 rpm | - | 1.1 rpm |
| DM-2325-ds 20 kg carpet 20% | 0.2 supply | - | 2.1 rpm | - | 0.5 rpm | - | 2.0 rpm | - | 0.5 rpm |
| DM-2325-ds 20 kg floor | 2.1 rpm | - | 2.1 rpm | - | 1.1 rpm | - | 1.6 rpm | - | 2.7 rpm |
| DM-2325-ds 20 kg floor 20% | 1.8 rpm | - | 2.0 rpm | - | 1.5 supply | - | 0.8 rpm | - | 1.4 rpm |
| DM-2325-low-ds 10 kg carpet | 0.2 torque | - | 3.4 torque | - | 0.2 torque | - | 3.4 rpm | - | 0.2 torque |
| DM-2325-low-ds 10 kg carpet 20% | 0.2 torque | - | 2.8 rpm | - | 0.2 torque | - | 2.9 rpm | - | 0.7 torque |
| DM-2325-low-ds 10 kg floor | 1.6 torque | - | 2.4 torque | - | 0.6 torque | - | 2.0 torque | - | 0.9 torque |
| DM-2325-low-ds 10 kg floor 20% | 1.6 torque | - | 2.2 rpm | - | 1.8 torque | - | 2.0 rpm | - | 0.9 torque |
| DM-2325-low-ds 20 kg carpet | 0.2 torque | - | 1.5 torque | - | 0.9 torque | - | 1.6 torque | - | 1.5 torque |
| DM-2325-low-ds 20 kg carpet 20% | 0.2 torque | - | 0.8 rpm | - | 0.7 torque | - | 0.8 rpm | - | 1.5 torque |
| DM-2325-low-ds 20 kg floor | 1.9 torque | - | 1.6 torque | - | 1.4 torque | - | 1.1 torque | - | 2.1 torque |
| DM-2325-low-ds 20 kg floor 20% | 1.9 grip | - | 0.2 rpm | - | 1.2 torque | - | 0.6 rpm | - | 2.1 torque |
| DM-J3507-ds 10 kg carpet | 0.2 rpm | - | 2.6 rpm | - | 0.2 rpm | - | 2.8 rpm | - | 0.5 rpm |
| DM-J3507-ds 10 kg carpet 20% | 0.2 rpm | - | 2.0 rpm | - | 0.2 rpm | - | 1.9 rpm | - | 0.2 rpm |
| DM-J3507-ds 10 kg floor | 0.7 rpm | - | 1.9 rpm | - | 1.1 rpm | - | 1.9 rpm | - | 1.0 rpm |
| DM-J3507-ds 10 kg floor 20% | 0.2 rpm | - | 0.2 rpm | - | 1.8 grip | - | 0.2 rpm | - | 0.7 rpm |
| DM-J3507-ds 20 kg carpet | 0.2 rpm | - | 0.6 rpm | - | 0.2 rpm | - | 0.9 rpm | - | 1.0 rpm |
| DM-J3507-ds 20 kg carpet 20% | 0.2 rpm | - | 0.2 rpm | - | 0.2 rpm | - | 0.2 rpm | - | 1.1 rpm |
| DM-J3507-ds 20 kg floor | 1.1 rpm | - | 0.3 rpm | - | 1.1 rpm | - | 0.6 rpm | - | 1.3 rpm |
| DM-J3507-ds 20 kg floor 20% | 0.8 rpm | - | 0.2 rpm | - | 1.0 rpm | - | 0.4 rpm | - | 0.8 rpm |
| EduLite05-ds 10 kg carpet | 0.2 rpm | - | 0.2 rpm | - | 0.2 grip | - | 0.2 rpm | - | 0.2 rpm |
| EduLite05-ds 10 kg carpet 20% | 0.2 rpm | - | 0.2 rpm | - | 0.2 rpm | - | 0.2 rpm | - | 0.2 rpm |
| EduLite05-ds 10 kg floor | 0.2 rpm | - | 0.2 rpm | - | 0.2 rpm | - | 0.2 rpm | - | 0.2 rpm |
| EduLite05-ds 10 kg floor 20% | 0.2 rpm | - | 0.2 rpm | - | 0.2 rpm | - | 0.2 rpm | - | 0.2 rpm |
| EduLite05-ds 20 kg carpet | 0.2 grip | - | 0.2 rpm | - | 0.2 rpm | - | 0.2 rpm | - | 0.2 rpm |
| EduLite05-ds 20 kg carpet 20% | 0.2 grip | - | 0.2 rpm | - | 0.2 rpm | - | 0.2 rpm | - | 0.2 rpm |
| EduLite05-ds 20 kg floor | 0.2 rpm | - | 0.2 rpm | - | 0.2 rpm | - | 0.2 rpm | - | 0.2 rpm |
| EduLite05-ds 20 kg floor 20% | 0.2 rpm | - | 0.2 rpm | - | 0.2 rpm | - | 0.2 rpm | - | 0.2 rpm |
| GIM3510-8-ds 10 kg carpet | 0.2 torque | - | 3.3 wheel-hop | - | 0.2 torque | - | 2.4 wheel-hop | - | 0.3 torque |
| GIM3510-8-ds 10 kg carpet 20% | 0.2 torque | - | 3.3 wheel-hop | - | 0.2 torque | - | 2.4 wheel-hop | - | 0.3 torque |
| GIM3510-8-ds 10 kg floor | 0.2 torque | - | 2.6 wheel-hop | - | 2.0 grip | - | 1.9 wheel-hop | - | 1.2 torque |
| GIM3510-8-ds 10 kg floor 20% | 0.2 torque | - | 2.3 wheel-hop | - | 2.0 grip | - | 1.9 wheel-hop | - | 1.2 torque |
| GIM3510-8-ds 20 kg carpet | 0.2 torque | - | 2.7 torque | - | 2.1 grip | - | 2.7 torque | - | 1.1 torque |
| GIM3510-8-ds 20 kg carpet 20% | 0.2 torque | - | 2.4 rpm | - | 2.1 supply | - | 2.6 rpm | - | 1.1 torque |
| GIM3510-8-ds 20 kg floor | 1.6 torque | - | 2.2 torque | - | 2.0 grip | - | 1.5 torque | - | 2.1 torque |
| GIM3510-8-ds 20 kg floor 20% | 1.6 torque | - | 2.0 rpm | - | 2.0 supply | - | 1.4 rpm | - | 2.1 torque |
| GIM4305-10-ds 10 kg carpet | 0.2 rpm | - | 1.9 rpm | - | 0.2 rpm | - | 2.2 rpm | - | 0.7 rpm |
| GIM4305-10-ds 10 kg carpet 20% | 0.2 rpm | - | 0.2 rpm | - | 0.2 rpm | - | 0.2 rpm | - | 0.2 rpm |
| GIM4305-10-ds 10 kg floor | 0.5 rpm | - | 1.0 rpm | - | 0.2 rpm | - | 1.5 rpm | - | 0.7 rpm |
| GIM4305-10-ds 10 kg floor 20% | 0.7 rpm | - | 0.2 rpm | - | 0.2 rpm | - | 0.2 rpm | - | 0.9 rpm |
| GIM4305-10-ds 20 kg carpet | 0.2 rpm | - | 0.2 rpm | - | 2.0 grip | - | 0.2 rpm | - | 0.4 rpm |
| GIM4305-10-ds 20 kg carpet 20% | 0.2 rpm | - | 0.2 rpm | - | 0.2 grip | - | 0.2 rpm | - | 1.1 rpm |
| GIM4305-10-ds 20 kg floor | 0.7 rpm | - | 0.2 rpm | - | 1.3 rpm | - | 0.4 rpm | - | 1.3 rpm |
| GIM4305-10-ds 20 kg floor 20% | 0.7 rpm | - | 0.2 rpm | - | 1.2 grip | - | 0.2 rpm | - | 1.1 rpm |
| M2006-ds 10 kg carpet | 0.2 torque | - | 3.2 torque | - | 0.2 torque | - | 2.8 torque | - | 0.2 torque |
| M2006-ds 10 kg carpet 20% | 0.2 torque | - | 3.0 rpm | - | 0.2 torque | - | 2.8 rpm | - | 0.2 torque |
| M2006-ds 10 kg floor | 0.2 torque | - | 2.4 torque | - | 2.1 grip | - | 2.2 torque | - | 0.7 torque |
| M2006-ds 10 kg floor 20% | 0.2 torque | - | 2.3 rpm | - | 2.1 grip | - | 2.2 rpm | - | 0.7 torque |
| M2006-ds 20 kg carpet | 0.2 torque | - | 1.0 torque | - | 0.2 torque | - | 1.1 torque | - | 1.5 torque |
| M2006-ds 20 kg carpet 20% | 0.2 torque | - | 0.9 torque | - | 0.2 torque | - | 1.1 torque | - | 1.5 torque |
| M2006-ds 20 kg floor | 1.8 torque | - | 1.1 torque | - | 1.6 grip | - | 1.1 torque | - | 2.1 torque |
| M2006-ds 20 kg floor 20% | 1.8 torque | - | 0.6 torque | - | 1.6 grip | - | 1.1 torque | - | 2.1 torque |

### brake fast (2.5, 0.5) m/s: clean acceleration (m/s^2, cause at the first failure)

| robot | 0 | 22.5 | 45 | 67.5 | 90 | 112.5 | 135 | 157.5 | 180 |
| --- | --- | --- | --- | --- | --- | --- | --- | --- | --- |
| AK40-10 10 kg carpet | 7.2 torque | 4.5 wheel-hop | 4.8 grip | 4.4 grip | 4.8 grip | 4.9 grip | 4.5 grip | 4.1 wheel-hop | 7.2 torque |
| AK40-10 10 kg carpet 20% | 7.6 torque | 4.7 wheel-hop | 4.5 grip | 4.1 grip | 4.5 grip | 4.5 grip | 4.5 grip | 5.1 wheel-hop | 7.2 torque |
| AK40-10 10 kg floor | 6.9 torque | 5.0 wheel-hop | 4.0 grip | 4.2 grip | 4.5 grip | 4.4 grip | 4.2 grip | 5.2 wheel-hop | 6.4 torque |
| AK40-10 10 kg floor 20% | 6.7 torque | 4.8 wheel-hop | 4.2 grip | 4.3 grip | 4.5 grip | 4.7 grip | 4.1 grip | 4.1 wheel-hop | 6.3 torque |
| AK40-10 10 kg floor loop=0.25 | 6.7 wheel-hop | 4.8 wheel-hop | 3.8 grip | 3.7 grip | 3.9 grip | 3.9 grip | 3.7 grip | 4.8 wheel-hop | 6.3 wheel-hop |
| AK40-10 15 kg carpet | 6.7 torque | 4.8 torque | 4.7 grip | 4.8 grip | 4.6 grip | 4.4 grip | 4.8 grip | 4.8 torque | 6.7 torque |
| AK40-10 15 kg carpet 20% | 6.6 torque | 4.9 torque | 4.7 grip | 4.7 grip | 4.2 grip | 4.8 grip | 4.4 grip | 4.5 wheel-hop | 6.3 torque |
| AK40-10 15 kg floor | 6.5 torque | 4.7 torque | 4.0 grip | 4.6 grip | 4.6 grip | 4.5 grip | 4.0 grip | 4.8 torque | 6.3 torque |
| AK40-10 15 kg floor 20% | 6.5 torque | 5.0 torque | 4.3 grip | 4.3 grip | 5.0 grip | 4.4 grip | 4.3 grip | 5.2 torque | 6.3 torque |
| AK40-10 20 kg carpet | 6.3 torque | 5.0 torque | 4.6 grip | 4.2 grip | 4.5 grip | 4.1 grip | 4.6 grip | 5.0 torque | 6.0 torque |
| AK40-10 20 kg carpet 20% | 6.2 torque | 5.1 torque | 4.8 grip | 4.4 grip | 4.7 grip | 4.5 grip | 4.6 grip | 4.5 torque | 6.0 torque |
| AK40-10 20 kg floor | 6.1 torque | 4.9 torque | 4.2 grip | 4.4 grip | 4.5 grip | 4.4 grip | 4.5 grip | 4.8 torque | 6.1 torque |
| AK40-10 20 kg floor 20% | 6.0 torque | 4.9 torque | 4.1 grip | 4.2 grip | 4.3 grip | 4.6 grip | 4.4 grip | 5.0 torque | 6.2 torque |
| AK40-10 20 kg floor loop=0.25 | 5.9 torque | 4.2 torque | 3.4 grip | 3.2 grip | 3.3 grip | 3.2 grip | 3.4 grip | 4.3 torque | 5.6 torque |
| AK40-10 20hi kg carpet | 6.3 torque | 4.7 torque | 3.8 grip | 3.8 grip | 3.6 grip | 3.6 grip | 4.0 grip | 4.2 torque | 6.3 torque |
| AK40-10 20hi kg carpet 20% | 6.2 torque | 4.4 grip | 4.3 grip | 3.7 grip | 3.6 grip | 3.8 grip | 4.2 grip | 4.2 torque | 6.2 torque |
| AK40-10 20hi kg floor | 5.4 torque | 4.0 grip | 3.5 grip | 3.5 grip | 3.9 grip | 3.6 grip | 3.6 grip | 4.0 torque | 5.8 torque |
| AK40-10 20hi kg floor 20% | 5.3 torque | 4.1 torque | 3.8 grip | 3.7 grip | 3.8 grip | 3.7 grip | 3.9 grip | 4.7 grip | 5.7 torque |
| AK40-10-ds 10 kg carpet | 7.2 torque | - | 4.5 grip | - | 4.5 grip | - | 4.6 grip | - | 7.2 torque |
| AK40-10-ds 10 kg carpet 20% | 7.2 torque | - | 4.6 grip | - | 4.3 grip | - | 4.5 grip | - | 7.1 torque |
| AK40-10-ds 10 kg floor | 6.7 torque | - | 3.9 grip | - | 4.6 grip | - | 4.2 grip | - | 6.6 torque |
| AK40-10-ds 10 kg floor 20% | 6.9 torque | - | 3.8 grip | - | 4.5 grip | - | 4.1 grip | - | 6.4 torque |
| AK40-10-ds 20 kg carpet | 6.3 torque | - | 4.5 grip | - | 4.4 grip | - | 4.5 grip | - | 6.3 torque |
| AK40-10-ds 20 kg carpet 20% | 6.1 torque | - | 4.8 grip | - | 4.3 grip | - | 4.5 grip | - | 5.9 torque |
| AK40-10-ds 20 kg floor | 5.7 torque | - | 4.2 grip | - | 4.3 grip | - | 4.3 grip | - | 5.9 torque |
| AK40-10-ds 20 kg floor 20% | 5.9 torque | - | 4.0 grip | - | 4.5 grip | - | 4.5 grip | - | 6.0 torque |
| DM-2325-ds 10 kg carpet | 7.2 wheel-hop | - | 4.8 grip | - | 4.5 grip | - | 4.2 grip | - | 7.3 wheel-hop |
| DM-2325-ds 10 kg carpet 20% | 7.0 wheel-hop | - | 4.8 grip | - | 4.8 grip | - | 4.5 grip | - | 7.2 wheel-hop |
| DM-2325-ds 10 kg floor | 7.1 wheel-hop | - | 4.1 grip | - | 4.8 grip | - | 4.4 grip | - | 6.9 wheel-hop |
| DM-2325-ds 10 kg floor 20% | 7.0 wheel-hop | - | 4.3 grip | - | 4.4 grip | - | 4.3 grip | - | 6.7 wheel-hop |
| DM-2325-ds 20 kg carpet | 6.5 torque | - | 4.8 grip | - | 4.7 grip | - | 4.7 grip | - | 6.3 torque |
| DM-2325-ds 20 kg carpet 20% | 6.8 torque | - | 4.5 grip | - | 4.4 supply | - | 4.7 grip | - | 6.6 torque |
| DM-2325-ds 20 kg floor | 6.4 torque | - | 4.2 grip | - | 4.6 grip | - | 4.4 grip | - | 6.4 torque |
| DM-2325-ds 20 kg floor 20% | 6.4 torque | - | 4.4 grip | - | 4.8 supply | - | 4.4 grip | - | 6.4 torque |
| DM-2325-low-ds 10 kg carpet | 6.3 torque | - | 4.7 grip | - | 4.1 grip | - | 4.6 grip | - | 6.0 torque |
| DM-2325-low-ds 10 kg carpet 20% | 6.3 torque | - | 4.5 grip | - | 4.5 grip | - | 4.5 torque | - | 6.2 torque |
| DM-2325-low-ds 10 kg floor | 5.9 torque | - | 4.1 grip | - | 4.5 grip | - | 4.1 grip | - | 6.2 torque |
| DM-2325-low-ds 10 kg floor 20% | 5.9 torque | - | 4.1 grip | - | 4.6 grip | - | 4.0 grip | - | 6.2 torque |
| DM-2325-low-ds 20 kg carpet | 4.9 torque | - | 3.9 grip | - | 3.6 grip | - | 3.8 torque | - | 5.0 torque |
| DM-2325-low-ds 20 kg carpet 20% | 4.8 torque | - | 3.9 grip | - | 3.6 grip | - | 3.8 grip | - | 4.9 torque |
| DM-2325-low-ds 20 kg floor | 4.4 grip | - | 3.5 grip | - | 3.5 grip | - | 3.6 grip | - | 4.7 torque |
| DM-2325-low-ds 20 kg floor 20% | 4.4 torque | - | 3.6 torque | - | 3.5 grip | - | 3.7 torque | - | 4.7 torque |
| DM-J3507-ds 10 kg carpet | 6.7 torque | - | 4.3 grip | - | 4.8 grip | - | 4.5 grip | - | 6.4 torque |
| DM-J3507-ds 10 kg carpet 20% | 6.9 torque | - | 4.7 grip | - | 4.6 grip | - | 4.5 grip | - | 6.5 torque |
| DM-J3507-ds 10 kg floor | 6.6 torque | - | 4.4 grip | - | 4.6 grip | - | 4.0 grip | - | 6.5 torque |
| DM-J3507-ds 10 kg floor 20% | 6.4 torque | - | 3.8 grip | - | 4.8 grip | - | 4.1 grip | - | 6.1 torque |
| DM-J3507-ds 20 kg carpet | 5.4 torque | - | 4.3 grip | - | 4.5 grip | - | 4.5 grip | - | 5.6 grip |
| DM-J3507-ds 20 kg carpet 20% | 5.6 torque | - | 4.5 grip | - | 4.2 grip | - | 4.3 grip | - | 5.4 torque |
| DM-J3507-ds 20 kg floor | 5.0 torque | - | 4.1 grip | - | 4.0 grip | - | 4.2 grip | - | 5.2 grip |
| DM-J3507-ds 20 kg floor 20% | 5.0 torque | - | 4.1 grip | - | 4.2 grip | - | 4.1 grip | - | 5.3 grip |
| EduLite05-ds 10 kg carpet | 0.2 rpm | - | 0.2 rpm | - | 0.2 rpm | - | 0.2 rpm | - | 0.2 rpm |
| EduLite05-ds 10 kg carpet 20% | 0.2 grip | - | 0.2 rpm | - | 0.2 rpm | - | 0.2 rpm | - | 0.2 rpm |
| EduLite05-ds 10 kg floor | 0.2 rpm | - | 0.2 rpm | - | 0.2 rpm | - | 0.2 rpm | - | 6.4 rpm |
| EduLite05-ds 10 kg floor 20% | 0.2 rpm | - | 0.2 rpm | - | 0.2 rpm | - | 0.2 rpm | - | 0.2 rpm |
| EduLite05-ds 20 kg carpet | 0.2 rpm | - | 0.2 rpm | - | 0.2 rpm | - | 0.2 rpm | - | 0.2 rpm |
| EduLite05-ds 20 kg carpet 20% | 0.2 rpm | - | 0.2 rpm | - | 0.2 rpm | - | 0.2 rpm | - | 0.2 rpm |
| EduLite05-ds 20 kg floor | 0.2 rpm | - | 0.2 rpm | - | 0.2 rpm | - | 0.2 rpm | - | 5.8 rpm |
| EduLite05-ds 20 kg floor 20% | 0.2 rpm | - | 0.2 rpm | - | 0.2 rpm | - | 0.2 rpm | - | 0.2 rpm |
| GIM3510-8-ds 10 kg carpet | 6.9 torque | - | 4.7 grip | - | 4.6 grip | - | 4.3 grip | - | 6.5 torque |
| GIM3510-8-ds 10 kg carpet 20% | 6.9 torque | - | 4.7 grip | - | 4.6 grip | - | 4.3 grip | - | 6.5 torque |
| GIM3510-8-ds 10 kg floor | 6.5 torque | - | 4.0 grip | - | 4.3 grip | - | 4.0 grip | - | 6.2 torque |
| GIM3510-8-ds 10 kg floor 20% | 6.5 torque | - | 4.1 grip | - | 4.3 grip | - | 4.0 grip | - | 6.2 torque |
| GIM3510-8-ds 20 kg carpet | 5.7 torque | - | 4.5 grip | - | 4.3 grip | - | 4.4 grip | - | 5.9 torque |
| GIM3510-8-ds 20 kg carpet 20% | 5.7 torque | - | 4.8 grip | - | 4.3 grip | - | 4.5 grip | - | 5.9 torque |
| GIM3510-8-ds 20 kg floor | 5.1 torque | - | 4.1 grip | - | 4.3 grip | - | 4.0 grip | - | 5.1 torque |
| GIM3510-8-ds 20 kg floor 20% | 5.1 torque | - | 4.0 grip | - | 4.3 grip | - | 4.0 grip | - | 5.1 torque |
| GIM4305-10-ds 10 kg carpet | 7.0 torque | - | 4.8 grip | - | 4.3 grip | - | 4.7 grip | - | 6.7 torque |
| GIM4305-10-ds 10 kg carpet 20% | 7.3 torque | - | 4.6 grip | - | 4.1 grip | - | 4.4 grip | - | 6.4 torque |
| GIM4305-10-ds 10 kg floor | 7.0 torque | - | 4.0 grip | - | 5.0 grip | - | 4.1 grip | - | 6.4 torque |
| GIM4305-10-ds 10 kg floor 20% | 6.5 torque | - | 3.6 grip | - | 4.5 grip | - | 3.9 grip | - | 6.1 torque |
| GIM4305-10-ds 20 kg carpet | 5.7 torque | - | 4.6 grip | - | 4.4 grip | - | 4.6 grip | - | 5.6 torque |
| GIM4305-10-ds 20 kg carpet 20% | 5.9 torque | - | 0.2 rpm | - | 4.4 grip | - | 0.2 rpm | - | 5.6 torque |
| GIM4305-10-ds 20 kg floor | 5.2 torque | - | 4.2 grip | - | 4.3 grip | - | 4.8 grip | - | 5.7 torque |
| GIM4305-10-ds 20 kg floor 20% | 5.2 torque | - | 3.6 grip | - | 4.7 grip | - | 3.8 grip | - | 5.4 torque |
| M2006-ds 10 kg carpet | 6.2 torque | - | 4.7 grip | - | 4.2 grip | - | 4.5 grip | - | 6.0 torque |
| M2006-ds 10 kg carpet 20% | 6.2 torque | - | 4.5 grip | - | 4.2 grip | - | 4.6 grip | - | 6.0 torque |
| M2006-ds 10 kg floor | 5.7 torque | - | 4.2 grip | - | 4.4 grip | - | 4.3 grip | - | 5.9 torque |
| M2006-ds 10 kg floor 20% | 5.7 torque | - | 4.1 grip | - | 4.4 grip | - | 4.1 grip | - | 5.9 torque |
| M2006-ds 20 kg carpet | 4.6 torque | - | 3.7 torque | - | 3.7 grip | - | 3.7 grip | - | 4.7 grip |
| M2006-ds 20 kg carpet 20% | 4.6 torque | - | 3.7 torque | - | 3.7 grip | - | 3.8 grip | - | 4.7 grip |
| M2006-ds 20 kg floor | 4.2 torque | - | 3.4 grip | - | 3.7 grip | - | 3.5 torque | - | 4.5 grip |
| M2006-ds 20 kg floor 20% | 4.2 torque | - | 3.5 torque | - | 3.7 grip | - | 3.5 torque | - | 4.5 grip |

### reverse

| robot | args | t_rev | t_ideal | ok | cause | tilt_max | lift_ms |
| --- | --- | --- | --- | --- | --- | --- | --- |
| AK40-10 10 kg carpet | 0.0 1.0 3.0 | 0.68 | 0.67 | True | ok | 0.96 | 1.00 |
| AK40-10 10 kg carpet | 0.0 1.0 5.0 | 0.42 | 0.40 | True | ok | 0.87 | 2.50 |
| AK40-10 10 kg carpet | 0.0 2.0 3.0 | 1.41 | 1.33 | True | ok | 1.07 | 7.50 |
| AK40-10 10 kg carpet | 0.0 2.0 5.0 | 0.88 | 0.80 | True | torque | 1.15 | 12.00 |
| AK40-10 10 kg carpet | 0.0 3.0 3.0 | 2.19 | 2.00 | False | rpm | 1.37 | 5.00 |
| AK40-10 10 kg carpet | 0.0 3.0 5.0 | 1.79 | 1.20 | False | rpm | 1.95 | 8.50 |
| AK40-10 10 kg carpet | 45.0 1.0 3.0 | 0.68 | 0.67 | True | ok | 3.26 | 11.50 |
| AK40-10 10 kg carpet | 45.0 1.0 5.0 | 0.57 | 0.40 | False | grip | 5.31 | 5.50 |
| AK40-10 10 kg carpet | 45.0 2.0 3.0 | 1.37 | 1.33 | True | ok | 3.15 | 15.00 |
| AK40-10 10 kg carpet | 45.0 2.0 5.0 | 1.10 | 0.80 | False | grip | 5.67 | 16.50 |
| AK40-10 10 kg carpet | 45.0 3.0 3.0 | 2.06 | 2.00 | True | rpm | 4.01 | 14.50 |
| AK40-10 10 kg carpet | 45.0 3.0 5.0 | 1.60 | 1.20 | False | grip | 5.26 | 12.00 |
| AK40-10 10 kg carpet | 90.0 1.0 3.0 | 0.68 | 0.67 | True | grip | 5.44 | 15.50 |
| AK40-10 10 kg carpet | 90.0 1.0 5.0 | 0.51 | 0.40 | False | grip | 5.61 | 11.50 |
| AK40-10 10 kg carpet | 90.0 2.0 3.0 | 1.39 | 1.33 | False | wheel-hop | 5.36 | 13.50 |
| AK40-10 10 kg carpet | 90.0 2.0 5.0 | 0.94 | 0.80 | False | grip | 5.64 | 13.50 |
| AK40-10 10 kg carpet | 90.0 3.0 3.0 | 2.12 | 2.00 | False | grip | 5.50 | 13.50 |
| AK40-10 10 kg carpet | 90.0 3.0 5.0 | 1.47 | 1.20 | False | grip | 6.36 | 20.00 |
| AK40-10 10 kg carpet 20% | 0.0 1.0 3.0 | 0.68 | 0.67 | True | ok | 0.96 | 1.00 |
| AK40-10 10 kg carpet 20% | 0.0 1.0 5.0 | 0.42 | 0.40 | True | ok | 0.87 | 2.50 |
| AK40-10 10 kg carpet 20% | 0.0 2.0 3.0 | 1.39 | 1.33 | True | ok | 1.21 | 4.50 |
| AK40-10 10 kg carpet 20% | 0.0 2.0 5.0 | 0.90 | 0.80 | True | rpm | 1.27 | 6.50 |
| AK40-10 10 kg carpet 20% | 0.0 3.0 3.0 | 2.32 | 2.00 | False | rpm | 1.49 | 6.50 |
| AK40-10 10 kg carpet 20% | 0.0 3.0 5.0 | 1.64 | 1.20 | False | rpm | 1.81 | 7.50 |
| AK40-10 10 kg carpet 20% | 45.0 1.0 3.0 | 0.69 | 0.67 | True | ok | 3.23 | 7.50 |
| AK40-10 10 kg carpet 20% | 45.0 1.0 5.0 | 0.57 | 0.40 | False | grip | 5.24 | 6.50 |
| AK40-10 10 kg carpet 20% | 45.0 2.0 3.0 | 1.38 | 1.33 | True | rpm | 3.33 | 13.50 |
| AK40-10 10 kg carpet 20% | 45.0 2.0 5.0 | 1.12 | 0.80 | False | grip | 5.62 | 12.50 |
| AK40-10 10 kg carpet 20% | 45.0 3.0 3.0 | 2.69 | 2.00 | False | rpm | 3.26 | 13.50 |
| AK40-10 10 kg carpet 20% | 45.0 3.0 5.0 | 2.39 | 1.20 | False | rpm | 5.35 | 8.50 |
| AK40-10 10 kg carpet 20% | 90.0 1.0 3.0 | 0.68 | 0.67 | True | grip | 5.44 | 15.50 |
| AK40-10 10 kg carpet 20% | 90.0 1.0 5.0 | 0.51 | 0.40 | False | grip | 5.61 | 11.50 |
| AK40-10 10 kg carpet 20% | 90.0 2.0 3.0 | 1.46 | 1.33 | False | grip | 5.29 | 17.00 |
| AK40-10 10 kg carpet 20% | 90.0 2.0 5.0 | 1.07 | 0.80 | False | grip | 6.03 | 11.50 |
| AK40-10 10 kg carpet 20% | 90.0 3.0 3.0 | 2.14 | 2.00 | False | grip | 5.92 | 15.50 |
| AK40-10 10 kg carpet 20% | 90.0 3.0 5.0 | 1.53 | 1.20 | False | supply | 5.58 | 15.00 |
| AK40-10 10 kg floor | 0.0 1.0 3.0 | 0.68 | 0.67 | True | ok | 0.70 | 1.50 |
| AK40-10 10 kg floor | 0.0 1.0 5.0 | 0.43 | 0.40 | True | ok | 0.64 | 3.50 |
| AK40-10 10 kg floor | 0.0 2.0 3.0 | 1.40 | 1.33 | True | ok | 1.02 | 3.50 |
| AK40-10 10 kg floor | 0.0 2.0 5.0 | 0.88 | 0.80 | True | ok | 0.84 | 6.00 |
| AK40-10 10 kg floor | 0.0 3.0 3.0 | 2.22 | 2.00 | False | rpm | 1.17 | 8.00 |
| AK40-10 10 kg floor | 0.0 3.0 5.0 | 1.45 | 1.20 | False | rpm | 1.24 | 8.00 |
| AK40-10 10 kg floor | 45.0 1.0 3.0 | 0.70 | 0.67 | True | ok | 3.35 | 7.50 |
| AK40-10 10 kg floor | 45.0 1.0 5.0 | 0.57 | 0.40 | False | grip | 5.23 | 4.50 |
| AK40-10 10 kg floor | 45.0 2.0 3.0 | 1.44 | 1.33 | False | wheel-hop | 3.35 | 11.50 |
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
| AK40-10 20 kg floor loop=0.25 | 0.0 2.0 3.0 | 1.36 | 1.33 | True | ok | 1.41 | 1.00 |
| AK40-10 20 kg floor loop=0.25 | 0.0 2.0 5.0 | 0.91 | 0.80 | False | grip | 1.17 | 3.50 |
| AK40-10 20 kg floor loop=0.25 | 0.0 3.0 3.0 | 2.13 | 2.00 | True | rpm | 1.34 | 3.00 |
| AK40-10 20 kg floor loop=0.25 | 0.0 3.0 5.0 | 1.45 | 1.20 | False | grip | 1.37 | 4.00 |
| AK40-10 20 kg floor loop=0.25 | 45.0 1.0 3.0 | 0.68 | 0.67 | True | ok | 3.86 | 0.50 |
| AK40-10 20 kg floor loop=0.25 | 45.0 1.0 5.0 | 0.58 | 0.40 | False | grip | 4.53 | 2.00 |
| AK40-10 20 kg floor loop=0.25 | 45.0 2.0 3.0 | 1.41 | 1.33 | True | ok | 3.62 | 2.00 |
| AK40-10 20 kg floor loop=0.25 | 45.0 2.0 5.0 | 1.12 | 0.80 | False | grip | 4.51 | 3.00 |
| AK40-10 20 kg floor loop=0.25 | 45.0 3.0 3.0 | 2.32 | 2.00 | False | rpm | 3.41 | 1.50 |
| AK40-10 20 kg floor loop=0.25 | 45.0 3.0 5.0 | 1.90 | 1.20 | False | grip | 4.44 | 5.00 |
| AK40-10 20 kg floor loop=0.25 | 90.0 1.0 3.0 | 0.68 | 0.67 | True | ok | 5.20 | 3.00 |
| AK40-10 20 kg floor loop=0.25 | 90.0 1.0 5.0 | 0.53 | 0.40 | False | grip | 5.49 | 15.00 |
| AK40-10 20 kg floor loop=0.25 | 90.0 2.0 3.0 | 1.37 | 1.33 | False | wheel-hop | 5.21 | 6.50 |
| AK40-10 20 kg floor loop=0.25 | 90.0 2.0 5.0 | 0.96 | 0.80 | False | grip | 5.57 | 7.00 |
| AK40-10 20 kg floor loop=0.25 | 90.0 3.0 3.0 | 2.12 | 2.00 | False | grip | 5.20 | 6.00 |
| AK40-10 20 kg floor loop=0.25 | 90.0 3.0 5.0 | 1.50 | 1.20 | False | grip | 5.55 | 15.00 |
| AK40-10 20hi kg carpet | 0.0 1.0 3.0 | 0.65 | 0.67 | True | ok | 0.96 | 0.50 |
| AK40-10 20hi kg carpet | 0.0 1.0 5.0 | 0.48 | 0.40 | False | torque | 1.00 | 12.50 |
| AK40-10 20hi kg carpet | 0.0 2.0 3.0 | 1.37 | 1.33 | True | torque | 1.24 | 2.00 |
| AK40-10 20hi kg carpet | 0.0 2.0 5.0 | 0.97 | 0.80 | False | grip | 1.11 | 38.00 |
| AK40-10 20hi kg carpet | 0.0 3.0 3.0 | 2.23 | 2.00 | False | grip | 1.38 | 4.50 |
| AK40-10 20hi kg carpet | 0.0 3.0 5.0 | 1.64 | 1.20 | False | grip | 1.28 | 24.00 |
| AK40-10 20hi kg carpet | 45.0 1.0 3.0 | 0.68 | 0.67 | True | ok | 4.12 | 26.00 |
| AK40-10 20hi kg carpet | 45.0 1.0 5.0 | 0.58 | 0.40 | False | grip | 5.31 | 9.50 |
| AK40-10 20hi kg carpet | 45.0 2.0 3.0 | 1.38 | 1.33 | True | rpm | 3.83 | 15.00 |
| AK40-10 20hi kg carpet | 45.0 2.0 5.0 | 1.16 | 0.80 | False | grip | 5.69 | 16.50 |
| AK40-10 20hi kg carpet | 45.0 3.0 3.0 | 2.43 | 2.00 | False | rpm | 3.71 | 16.00 |
| AK40-10 20hi kg carpet | 45.0 3.0 5.0 | 1.92 | 1.20 | False | grip | 5.47 | 16.50 |
| AK40-10 20hi kg carpet | 90.0 1.0 3.0 | 0.66 | 0.67 | True | torque | 5.60 | 16.00 |
| AK40-10 20hi kg carpet | 90.0 1.0 5.0 | 0.53 | 0.40 | False | grip | 5.65 | 13.00 |
| AK40-10 20hi kg carpet | 90.0 2.0 3.0 | 1.41 | 1.33 | False | grip | 5.59 | 14.00 |
| AK40-10 20hi kg carpet | 90.0 2.0 5.0 | 1.02 | 0.80 | False | grip | 6.34 | 17.00 |
| AK40-10 20hi kg carpet | 90.0 3.0 3.0 | 2.16 | 2.00 | False | grip | 5.32 | 14.00 |
| AK40-10 20hi kg carpet | 90.0 3.0 5.0 | 1.64 | 1.20 | False | grip | 6.82 | 15.00 |
| AK40-10 20hi kg carpet 20% | 0.0 1.0 3.0 | 0.65 | 0.67 | True | ok | 0.96 | 0.50 |
| AK40-10 20hi kg carpet 20% | 0.0 1.0 5.0 | 0.48 | 0.40 | False | torque | 1.00 | 12.50 |
| AK40-10 20hi kg carpet 20% | 0.0 2.0 3.0 | 1.40 | 1.33 | True | rpm | 1.28 | 3.50 |
| AK40-10 20hi kg carpet 20% | 0.0 2.0 5.0 | 0.99 | 0.80 | False | grip | 1.19 | 53.50 |
| AK40-10 20hi kg carpet 20% | 0.0 3.0 3.0 | 2.27 | 2.00 | False | grip | 1.34 | 2.00 |
| AK40-10 20hi kg carpet 20% | 0.0 3.0 5.0 | 1.65 | 1.20 | False | supply | 1.37 | 64.50 |
| AK40-10 20hi kg carpet 20% | 45.0 1.0 3.0 | 0.68 | 0.67 | True | ok | 4.16 | 29.00 |
| AK40-10 20hi kg carpet 20% | 45.0 1.0 5.0 | 0.58 | 0.40 | False | grip | 5.29 | 11.00 |
| AK40-10 20hi kg carpet 20% | 45.0 2.0 3.0 | 1.42 | 1.33 | True | rpm | 4.26 | 19.00 |
| AK40-10 20hi kg carpet 20% | 45.0 2.0 5.0 | 1.16 | 0.80 | False | grip | 5.47 | 16.50 |
| AK40-10 20hi kg carpet 20% | 45.0 3.0 3.0 | - | 2.00 | False | rpm | 3.92 | 17.50 |
| AK40-10 20hi kg carpet 20% | 45.0 3.0 5.0 | - | 1.20 | False | supply | 5.78 | 19.50 |
| AK40-10 20hi kg carpet 20% | 90.0 1.0 3.0 | 0.66 | 0.67 | True | torque | 5.60 | 16.00 |
| AK40-10 20hi kg carpet 20% | 90.0 1.0 5.0 | 0.53 | 0.40 | False | grip | 5.65 | 13.00 |
| AK40-10 20hi kg carpet 20% | 90.0 2.0 3.0 | 1.37 | 1.33 | False | grip | 5.93 | 18.50 |
| AK40-10 20hi kg carpet 20% | 90.0 2.0 5.0 | 1.07 | 0.80 | False | supply | 5.71 | 12.00 |
| AK40-10 20hi kg carpet 20% | 90.0 3.0 3.0 | 2.29 | 2.00 | False | supply | 5.65 | 17.50 |
| AK40-10 20hi kg carpet 20% | 90.0 3.0 5.0 | 1.72 | 1.20 | False | supply | 6.48 | 16.50 |
| AK40-10 20hi kg floor | 0.0 1.0 3.0 | 0.68 | 0.67 | True | ok | 0.74 | 0.00 |
| AK40-10 20hi kg floor | 0.0 1.0 5.0 | 0.47 | 0.40 | False | torque | 0.80 | 4.50 |
| AK40-10 20hi kg floor | 0.0 2.0 3.0 | 1.34 | 1.33 | True | torque | 0.84 | 2.00 |
| AK40-10 20hi kg floor | 0.0 2.0 5.0 | 0.91 | 0.80 | False | grip | 0.95 | 24.00 |
| AK40-10 20hi kg floor | 0.0 3.0 3.0 | 2.12 | 2.00 | True | rpm | 1.02 | 3.50 |
| AK40-10 20hi kg floor | 0.0 3.0 5.0 | 1.47 | 1.20 | False | grip | 1.03 | 58.50 |
| AK40-10 20hi kg floor | 45.0 1.0 3.0 | 0.68 | 0.67 | True | ok | 4.34 | 12.50 |
| AK40-10 20hi kg floor | 45.0 1.0 5.0 | 0.61 | 0.40 | False | grip | 5.28 | 15.50 |
| AK40-10 20hi kg floor | 45.0 2.0 3.0 | 1.43 | 1.33 | True | torque | 4.45 | 16.50 |
| AK40-10 20hi kg floor | 45.0 2.0 5.0 | 1.12 | 0.80 | False | grip | 5.48 | 10.00 |
| AK40-10 20hi kg floor | 45.0 3.0 3.0 | 2.30 | 2.00 | False | rpm | 3.96 | 16.50 |
| AK40-10 20hi kg floor | 45.0 3.0 5.0 | 1.87 | 1.20 | False | grip | 5.44 | 7.00 |
| AK40-10 20hi kg floor | 90.0 1.0 3.0 | 0.66 | 0.67 | True | torque | 5.56 | 13.50 |
| AK40-10 20hi kg floor | 90.0 1.0 5.0 | 0.54 | 0.40 | False | grip | 5.68 | 17.00 |
| AK40-10 20hi kg floor | 90.0 2.0 3.0 | 1.36 | 1.33 | False | torque | 5.51 | 9.00 |
| AK40-10 20hi kg floor | 90.0 2.0 5.0 | 1.04 | 0.80 | False | grip | 5.64 | 9.50 |
| AK40-10 20hi kg floor | 90.0 3.0 3.0 | 2.14 | 2.00 | False | grip | 5.87 | 10.00 |
| AK40-10 20hi kg floor | 90.0 3.0 5.0 | 1.61 | 1.20 | False | grip | 5.78 | 7.00 |
| AK40-10 20hi kg floor 20% | 0.0 1.0 3.0 | 0.68 | 0.67 | True | ok | 0.74 | 0.00 |
| AK40-10 20hi kg floor 20% | 0.0 1.0 5.0 | 0.47 | 0.40 | False | torque | 0.80 | 4.50 |
| AK40-10 20hi kg floor 20% | 0.0 2.0 3.0 | 1.35 | 1.33 | True | rpm | 0.88 | 2.00 |
| AK40-10 20hi kg floor 20% | 0.0 2.0 5.0 | 0.93 | 0.80 | False | torque | 0.97 | 18.00 |
| AK40-10 20hi kg floor 20% | 0.0 3.0 3.0 | 2.15 | 2.00 | False | rpm | 0.98 | 2.00 |
| AK40-10 20hi kg floor 20% | 0.0 3.0 5.0 | 1.52 | 1.20 | False | grip | 1.13 | 11.50 |
| AK40-10 20hi kg floor 20% | 45.0 1.0 3.0 | 0.67 | 0.67 | True | ok | 4.33 | 19.00 |
| AK40-10 20hi kg floor 20% | 45.0 1.0 5.0 | 0.61 | 0.40 | False | grip | 5.25 | 10.00 |
| AK40-10 20hi kg floor 20% | 45.0 2.0 3.0 | 1.44 | 1.33 | True | rpm | 4.39 | 14.50 |
| AK40-10 20hi kg floor 20% | 45.0 2.0 5.0 | 1.15 | 0.80 | False | grip | 5.27 | 12.00 |
| AK40-10 20hi kg floor 20% | 45.0 3.0 3.0 | - | 2.00 | False | rpm | 3.70 | 9.00 |
| AK40-10 20hi kg floor 20% | 45.0 3.0 5.0 | - | 1.20 | False | grip | 5.25 | 7.50 |
| AK40-10 20hi kg floor 20% | 90.0 1.0 3.0 | 0.66 | 0.67 | True | torque | 5.56 | 13.50 |
| AK40-10 20hi kg floor 20% | 90.0 1.0 5.0 | 0.54 | 0.40 | False | supply | 5.68 | 17.00 |
| AK40-10 20hi kg floor 20% | 90.0 2.0 3.0 | 1.37 | 1.33 | False | torque | 5.51 | 9.50 |
| AK40-10 20hi kg floor 20% | 90.0 2.0 5.0 | 1.05 | 0.80 | False | supply | 5.79 | 11.50 |
| AK40-10 20hi kg floor 20% | 90.0 3.0 3.0 | 2.26 | 2.00 | False | grip | 5.41 | 10.00 |
| AK40-10 20hi kg floor 20% | 90.0 3.0 5.0 | 1.73 | 1.20 | False | supply | 5.77 | 11.00 |
| AK40-10-ds 10 kg carpet | 0.0 1.0 3.0 | 0.68 | 0.67 | True | ok | 1.01 | 1.00 |
| AK40-10-ds 10 kg carpet | 0.0 1.0 5.0 | 0.43 | 0.40 | True | ok | 0.92 | 2.00 |
| AK40-10-ds 10 kg carpet | 0.0 2.0 3.0 | 1.38 | 1.33 | True | ok | 1.01 | 5.50 |
| AK40-10-ds 10 kg carpet | 0.0 2.0 5.0 | 0.89 | 0.80 | True | torque | 1.16 | 6.50 |
| AK40-10-ds 10 kg carpet | 0.0 3.0 3.0 | 2.20 | 2.00 | True | rpm | 1.34 | 9.00 |
| AK40-10-ds 10 kg carpet | 0.0 3.0 5.0 | 1.48 | 1.20 | False | torque | 1.51 | 13.50 |
| AK40-10-ds 10 kg carpet | 45.0 1.0 3.0 | 0.68 | 0.67 | True | ok | 3.26 | 13.50 |
| AK40-10-ds 10 kg carpet | 45.0 1.0 5.0 | 0.56 | 0.40 | False | grip | 5.23 | 5.50 |
| AK40-10-ds 10 kg carpet | 45.0 2.0 3.0 | 1.37 | 1.33 | True | ok | 3.24 | 14.50 |
| AK40-10-ds 10 kg carpet | 45.0 2.0 5.0 | 1.09 | 0.80 | False | grip | 5.43 | 15.00 |
| AK40-10-ds 10 kg carpet | 45.0 3.0 3.0 | 2.07 | 2.00 | True | rpm | 3.71 | 13.50 |
| AK40-10-ds 10 kg carpet | 45.0 3.0 5.0 | 1.64 | 1.20 | False | rpm | 5.34 | 12.50 |
| AK40-10-ds 10 kg carpet | 90.0 1.0 3.0 | 0.67 | 0.67 | True | grip | 5.44 | 10.00 |
| AK40-10-ds 10 kg carpet | 90.0 1.0 5.0 | 0.47 | 0.40 | False | grip | 5.54 | 14.00 |
| AK40-10-ds 10 kg carpet | 90.0 2.0 3.0 | 1.45 | 1.33 | False | wheel-hop | 5.45 | 16.50 |
| AK40-10-ds 10 kg carpet | 90.0 2.0 5.0 | 0.95 | 0.80 | False | grip | 5.80 | 15.50 |
| AK40-10-ds 10 kg carpet | 90.0 3.0 3.0 | 2.15 | 2.00 | False | grip | 5.40 | 13.50 |
| AK40-10-ds 10 kg carpet | 90.0 3.0 5.0 | 1.46 | 1.20 | False | grip | 7.01 | 15.50 |
| AK40-10-ds 10 kg carpet 20% | 0.0 1.0 3.0 | 0.68 | 0.67 | True | ok | 1.01 | 1.00 |
| AK40-10-ds 10 kg carpet 20% | 0.0 1.0 5.0 | 0.43 | 0.40 | True | ok | 0.92 | 2.00 |
| AK40-10-ds 10 kg carpet 20% | 0.0 2.0 3.0 | 1.43 | 1.33 | True | ok | 1.39 | 4.50 |
| AK40-10-ds 10 kg carpet 20% | 0.0 2.0 5.0 | 0.90 | 0.80 | True | torque | 1.45 | 5.50 |
| AK40-10-ds 10 kg carpet 20% | 0.0 3.0 3.0 | 2.85 | 2.00 | False | rpm | 1.25 | 7.00 |
| AK40-10-ds 10 kg carpet 20% | 0.0 3.0 5.0 | 1.60 | 1.20 | False | rpm | 1.49 | 6.00 |
| AK40-10-ds 10 kg carpet 20% | 45.0 1.0 3.0 | 0.68 | 0.67 | True | ok | 3.26 | 13.50 |
| AK40-10-ds 10 kg carpet 20% | 45.0 1.0 5.0 | 0.56 | 0.40 | False | grip | 5.23 | 5.50 |
| AK40-10-ds 10 kg carpet 20% | 45.0 2.0 3.0 | 1.38 | 1.33 | True | ok | 3.15 | 13.00 |
| AK40-10-ds 10 kg carpet 20% | 45.0 2.0 5.0 | 1.10 | 0.80 | False | rpm | 5.43 | 16.00 |
| AK40-10-ds 10 kg carpet 20% | 45.0 3.0 3.0 | - | 2.00 | False | rpm | 3.46 | 13.50 |
| AK40-10-ds 10 kg carpet 20% | 45.0 3.0 5.0 | - | 1.20 | False | rpm | 5.35 | 9.50 |
| AK40-10-ds 10 kg carpet 20% | 90.0 1.0 3.0 | 0.67 | 0.67 | True | grip | 5.44 | 10.00 |
| AK40-10-ds 10 kg carpet 20% | 90.0 1.0 5.0 | 0.47 | 0.40 | False | grip | 5.54 | 14.00 |
| AK40-10-ds 10 kg carpet 20% | 90.0 2.0 3.0 | 1.40 | 1.33 | False | wheel-hop | 5.25 | 16.00 |
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
| DM-2325-low-ds 20 kg floor 20% | 0.0 1.0 3.0 | 0.71 | 0.67 | True | torque | 1.65 | 0.50 |
| DM-2325-low-ds 20 kg floor 20% | 0.0 1.0 5.0 | 0.61 | 0.40 | False | grip | 1.60 | 1.50 |
| DM-2325-low-ds 20 kg floor 20% | 0.0 2.0 3.0 | 1.44 | 1.33 | True | torque | 1.43 | 1.00 |
| DM-2325-low-ds 20 kg floor 20% | 0.0 2.0 5.0 | 1.24 | 0.80 | False | grip | 1.41 | 2.00 |
| DM-2325-low-ds 20 kg floor 20% | 0.0 3.0 3.0 | 2.24 | 2.00 | False | grip | 1.30 | 2.00 |
| DM-2325-low-ds 20 kg floor 20% | 0.0 3.0 5.0 | 2.02 | 1.20 | False | grip | 1.58 | 2.00 |
| DM-2325-low-ds 20 kg floor 20% | 45.0 1.0 3.0 | 0.83 | 0.67 | False | torque | 4.18 | 1.00 |
| DM-2325-low-ds 20 kg floor 20% | 45.0 1.0 5.0 | 0.82 | 0.40 | False | grip | 4.13 | 2.00 |
| DM-2325-low-ds 20 kg floor 20% | 45.0 2.0 3.0 | 1.71 | 1.33 | False | torque | 3.23 | 2.50 |
| DM-2325-low-ds 20 kg floor 20% | 45.0 2.0 5.0 | 1.64 | 0.80 | False | torque | 3.70 | 2.00 |
| DM-2325-low-ds 20 kg floor 20% | 45.0 3.0 3.0 | 3.49 | 2.00 | False | rpm | 3.07 | 2.50 |
| DM-2325-low-ds 20 kg floor 20% | 45.0 3.0 5.0 | - | 1.20 | False | rpm | 3.60 | 2.50 |
| DM-2325-low-ds 20 kg floor 20% | 90.0 1.0 3.0 | 0.73 | 0.67 | True | torque | 4.76 | 2.50 |
| DM-2325-low-ds 20 kg floor 20% | 90.0 1.0 5.0 | 0.70 | 0.40 | False | grip | 4.98 | 4.00 |
| DM-2325-low-ds 20 kg floor 20% | 90.0 2.0 3.0 | 1.51 | 1.33 | False | torque | 4.77 | 4.00 |
| DM-2325-low-ds 20 kg floor 20% | 90.0 2.0 5.0 | 1.38 | 0.80 | False | grip | 5.08 | 5.50 |
| DM-2325-low-ds 20 kg floor 20% | 90.0 3.0 3.0 | 2.42 | 2.00 | False | grip | 4.65 | 5.00 |
| DM-2325-low-ds 20 kg floor 20% | 90.0 3.0 5.0 | 2.09 | 1.20 | False | grip | 5.15 | 4.50 |
| DM-J3507-ds 10 kg carpet | 0.0 1.0 3.0 | 0.68 | 0.67 | True | ok | 1.04 | 0.50 |
| DM-J3507-ds 10 kg carpet | 0.0 1.0 5.0 | 0.42 | 0.40 | True | torque | 0.88 | 3.00 |
| DM-J3507-ds 10 kg carpet | 0.0 2.0 3.0 | 1.40 | 1.33 | True | rpm | 1.27 | 5.50 |
| DM-J3507-ds 10 kg carpet | 0.0 2.0 5.0 | 1.01 | 0.80 | False | torque | 1.52 | 25.00 |
| DM-J3507-ds 10 kg carpet | 0.0 3.0 3.0 | 2.42 | 2.00 | False | rpm | 1.69 | 4.00 |
| DM-J3507-ds 10 kg carpet | 0.0 3.0 5.0 | - | 1.20 | False | grip | 1.68 | 12.00 |
| DM-J3507-ds 10 kg carpet | 45.0 1.0 3.0 | 0.71 | 0.67 | True | ok | 2.95 | 3.00 |
| DM-J3507-ds 10 kg carpet | 45.0 1.0 5.0 | 0.57 | 0.40 | False | grip | 5.14 | 4.50 |
| DM-J3507-ds 10 kg carpet | 45.0 2.0 3.0 | 1.39 | 1.33 | True | rpm | 3.33 | 9.50 |
| DM-J3507-ds 10 kg carpet | 45.0 2.0 5.0 | 1.11 | 0.80 | False | grip | 5.49 | 13.50 |
| DM-J3507-ds 10 kg carpet | 45.0 3.0 3.0 | 2.37 | 2.00 | False | rpm | 3.51 | 14.00 |
| DM-J3507-ds 10 kg carpet | 45.0 3.0 5.0 | 1.92 | 1.20 | False | grip | 5.19 | 5.00 |
| DM-J3507-ds 10 kg carpet | 90.0 1.0 3.0 | 0.68 | 0.67 | True | grip | 5.34 | 16.00 |
| DM-J3507-ds 10 kg carpet | 90.0 1.0 5.0 | 0.48 | 0.40 | False | grip | 5.58 | 19.00 |
| DM-J3507-ds 10 kg carpet | 90.0 2.0 3.0 | 1.38 | 1.33 | False | rpm | 5.26 | 24.00 |
| DM-J3507-ds 10 kg carpet | 90.0 2.0 5.0 | 1.01 | 0.80 | False | grip | 5.81 | 17.50 |
| DM-J3507-ds 10 kg carpet | 90.0 3.0 3.0 | 2.32 | 2.00 | False | grip | 5.23 | 15.50 |
| DM-J3507-ds 10 kg carpet | 90.0 3.0 5.0 | 1.57 | 1.20 | False | grip | 6.30 | 17.50 |
| DM-J3507-ds 10 kg carpet 20% | 0.0 1.0 3.0 | 0.68 | 0.67 | True | ok | 0.98 | 1.50 |
| DM-J3507-ds 10 kg carpet 20% | 0.0 1.0 5.0 | 0.43 | 0.40 | True | torque | 0.89 | 2.00 |
| DM-J3507-ds 10 kg carpet 20% | 0.0 2.0 3.0 | 1.45 | 1.33 | True | rpm | 1.48 | 4.00 |
| DM-J3507-ds 10 kg carpet 20% | 0.0 2.0 5.0 | 1.02 | 0.80 | False | rpm | 1.49 | 16.00 |
| DM-J3507-ds 10 kg carpet 20% | 0.0 3.0 3.0 | - | 2.00 | False | grip | 1.75 | 4.00 |
| DM-J3507-ds 10 kg carpet 20% | 0.0 3.0 5.0 | - | 1.20 | False | grip | 1.58 | 6.00 |
| DM-J3507-ds 10 kg carpet 20% | 45.0 1.0 3.0 | 0.71 | 0.67 | True | ok | 3.10 | 13.50 |
| DM-J3507-ds 10 kg carpet 20% | 45.0 1.0 5.0 | 0.57 | 0.40 | False | grip | 5.12 | 4.00 |
| DM-J3507-ds 10 kg carpet 20% | 45.0 2.0 3.0 | 1.41 | 1.33 | True | rpm | 3.24 | 14.50 |
| DM-J3507-ds 10 kg carpet 20% | 45.0 2.0 5.0 | 1.16 | 0.80 | False | grip | 5.18 | 13.00 |
| DM-J3507-ds 10 kg carpet 20% | 45.0 3.0 3.0 | - | 2.00 | False | rpm | 4.10 | 15.50 |
| DM-J3507-ds 10 kg carpet 20% | 45.0 3.0 5.0 | - | 1.20 | False | rpm | 5.27 | 15.00 |
| DM-J3507-ds 10 kg carpet 20% | 90.0 1.0 3.0 | 0.68 | 0.67 | True | ok | 5.30 | 14.50 |
| DM-J3507-ds 10 kg carpet 20% | 90.0 1.0 5.0 | 0.51 | 0.40 | False | grip | 5.70 | 16.00 |
| DM-J3507-ds 10 kg carpet 20% | 90.0 2.0 3.0 | 1.50 | 1.33 | False | grip | 5.39 | 20.00 |
| DM-J3507-ds 10 kg carpet 20% | 90.0 2.0 5.0 | 0.96 | 0.80 | False | grip | 5.95 | 17.50 |
| DM-J3507-ds 10 kg carpet 20% | 90.0 3.0 3.0 | - | 2.00 | False | grip | 5.27 | 17.00 |
| DM-J3507-ds 10 kg carpet 20% | 90.0 3.0 5.0 | 1.73 | 1.20 | False | grip | 6.11 | 13.00 |
| DM-J3507-ds 10 kg floor | 0.0 1.0 3.0 | 0.68 | 0.67 | True | ok | 0.78 | 1.50 |
| DM-J3507-ds 10 kg floor | 0.0 1.0 5.0 | 0.44 | 0.40 | True | torque | 0.68 | 2.00 |
| DM-J3507-ds 10 kg floor | 0.0 2.0 3.0 | 1.40 | 1.33 | True | rpm | 1.04 | 5.50 |
| DM-J3507-ds 10 kg floor | 0.0 2.0 5.0 | 0.91 | 0.80 | False | torque | 1.08 | 23.00 |
| DM-J3507-ds 10 kg floor | 0.0 3.0 3.0 | 2.35 | 2.00 | False | rpm | 1.26 | 4.50 |
| DM-J3507-ds 10 kg floor | 0.0 3.0 5.0 | 1.57 | 1.20 | False | grip | 1.31 | 14.50 |
| DM-J3507-ds 10 kg floor | 45.0 1.0 3.0 | 0.70 | 0.67 | True | ok | 3.30 | 5.00 |
| DM-J3507-ds 10 kg floor | 45.0 1.0 5.0 | 0.56 | 0.40 | False | grip | 5.06 | 3.00 |
| DM-J3507-ds 10 kg floor | 45.0 2.0 3.0 | 1.46 | 1.33 | True | rpm | 3.21 | 9.00 |
| DM-J3507-ds 10 kg floor | 45.0 2.0 5.0 | 1.09 | 0.80 | False | grip | 5.22 | 10.00 |
| DM-J3507-ds 10 kg floor | 45.0 3.0 3.0 | 2.29 | 2.00 | False | rpm | 2.77 | 10.00 |
| DM-J3507-ds 10 kg floor | 45.0 3.0 5.0 | 1.83 | 1.20 | False | grip | 4.99 | 7.50 |
| DM-J3507-ds 10 kg floor | 90.0 1.0 3.0 | 0.67 | 0.67 | True | ok | 5.27 | 8.50 |
| DM-J3507-ds 10 kg floor | 90.0 1.0 5.0 | 0.49 | 0.40 | False | grip | 5.54 | 15.50 |
| DM-J3507-ds 10 kg floor | 90.0 2.0 3.0 | 1.37 | 1.33 | True | ok | 5.40 | 8.50 |
| DM-J3507-ds 10 kg floor | 90.0 2.0 5.0 | 0.93 | 0.80 | False | grip | 5.56 | 9.50 |
| DM-J3507-ds 10 kg floor | 90.0 3.0 3.0 | 2.26 | 2.00 | False | grip | 5.28 | 10.50 |
| DM-J3507-ds 10 kg floor | 90.0 3.0 5.0 | 1.56 | 1.20 | False | grip | 5.88 | 13.00 |
| DM-J3507-ds 10 kg floor 20% | 0.0 1.0 3.0 | 0.68 | 0.67 | True | ok | 0.81 | 1.00 |
| DM-J3507-ds 10 kg floor 20% | 0.0 1.0 5.0 | 0.43 | 0.40 | True | torque | 0.69 | 2.50 |
| DM-J3507-ds 10 kg floor 20% | 0.0 2.0 3.0 | 1.40 | 1.33 | True | rpm | 1.11 | 3.50 |
| DM-J3507-ds 10 kg floor 20% | 0.0 2.0 5.0 | 0.92 | 0.80 | False | rpm | 1.21 | 37.50 |
| DM-J3507-ds 10 kg floor 20% | 0.0 3.0 3.0 | 2.46 | 2.00 | False | rpm | 1.20 | 3.50 |
| DM-J3507-ds 10 kg floor 20% | 0.0 3.0 5.0 | 1.90 | 1.20 | False | grip | 1.41 | 5.00 |
| DM-J3507-ds 10 kg floor 20% | 45.0 1.0 3.0 | 0.70 | 0.67 | True | ok | 3.34 | 10.00 |
| DM-J3507-ds 10 kg floor 20% | 45.0 1.0 5.0 | 0.56 | 0.40 | False | grip | 4.96 | 3.00 |
| DM-J3507-ds 10 kg floor 20% | 45.0 2.0 3.0 | 1.47 | 1.33 | True | rpm | 3.30 | 11.00 |
| DM-J3507-ds 10 kg floor 20% | 45.0 2.0 5.0 | 1.14 | 0.80 | False | grip | 5.25 | 10.50 |
| DM-J3507-ds 10 kg floor 20% | 45.0 3.0 3.0 | - | 2.00 | False | rpm | 3.12 | 9.00 |
| DM-J3507-ds 10 kg floor 20% | 45.0 3.0 5.0 | - | 1.20 | False | rpm | 5.02 | 8.00 |
| DM-J3507-ds 10 kg floor 20% | 90.0 1.0 3.0 | 0.67 | 0.67 | True | ok | 5.35 | 8.00 |
| DM-J3507-ds 10 kg floor 20% | 90.0 1.0 5.0 | 0.45 | 0.40 | False | supply | 5.56 | 12.00 |
| DM-J3507-ds 10 kg floor 20% | 90.0 2.0 3.0 | 1.39 | 1.33 | True | rpm | 5.23 | 9.00 |
| DM-J3507-ds 10 kg floor 20% | 90.0 2.0 5.0 | 0.96 | 0.80 | False | grip | 5.67 | 12.00 |
| DM-J3507-ds 10 kg floor 20% | 90.0 3.0 3.0 | 2.27 | 2.00 | False | grip | 5.17 | 9.00 |
| DM-J3507-ds 10 kg floor 20% | 90.0 3.0 5.0 | 1.56 | 1.20 | False | supply | 5.83 | 17.00 |
| DM-J3507-ds 20 kg carpet | 0.0 1.0 3.0 | 0.66 | 0.67 | True | torque | 1.77 | 0.00 |
| DM-J3507-ds 20 kg carpet | 0.0 1.0 5.0 | 0.54 | 0.40 | False | grip | 1.70 | 1.00 |
| DM-J3507-ds 20 kg carpet | 0.0 2.0 3.0 | 1.47 | 1.33 | True | rpm | 1.65 | 1.50 |
| DM-J3507-ds 20 kg carpet | 0.0 2.0 5.0 | 1.12 | 0.80 | False | grip | 1.68 | 2.00 |
| DM-J3507-ds 20 kg carpet | 0.0 3.0 3.0 | 2.49 | 2.00 | False | grip | 1.66 | 1.50 |
| DM-J3507-ds 20 kg carpet | 0.0 3.0 5.0 | 2.02 | 1.20 | False | grip | 1.76 | 2.50 |
| DM-J3507-ds 20 kg carpet | 45.0 1.0 3.0 | 0.68 | 0.67 | True | torque | 3.85 | 1.00 |
| DM-J3507-ds 20 kg carpet | 45.0 1.0 5.0 | 0.59 | 0.40 | False | grip | 5.36 | 4.00 |
| DM-J3507-ds 20 kg carpet | 45.0 2.0 3.0 | 1.57 | 1.33 | False | rpm | 3.80 | 3.50 |
| DM-J3507-ds 20 kg carpet | 45.0 2.0 5.0 | 1.38 | 0.80 | False | grip | 5.28 | 2.00 |
| DM-J3507-ds 20 kg carpet | 45.0 3.0 3.0 | - | 2.00 | False | rpm | 3.31 | 2.00 |
| DM-J3507-ds 20 kg carpet | 45.0 3.0 5.0 | - | 1.20 | False | rpm | 5.10 | 3.00 |
| DM-J3507-ds 20 kg carpet | 90.0 1.0 3.0 | 0.68 | 0.67 | True | torque | 5.03 | 11.00 |
| DM-J3507-ds 20 kg carpet | 90.0 1.0 5.0 | 0.57 | 0.40 | False | grip | 5.43 | 10.50 |
| DM-J3507-ds 20 kg carpet | 90.0 2.0 3.0 | 1.48 | 1.33 | False | rpm | 5.15 | 9.50 |
| DM-J3507-ds 20 kg carpet | 90.0 2.0 5.0 | 1.14 | 0.80 | False | grip | 5.63 | 17.50 |
| DM-J3507-ds 20 kg carpet | 90.0 3.0 3.0 | 2.55 | 2.00 | False | grip | 4.92 | 9.00 |
| DM-J3507-ds 20 kg carpet | 90.0 3.0 5.0 | 2.12 | 1.20 | False | grip | 5.72 | 13.00 |
| DM-J3507-ds 20 kg carpet 20% | 0.0 1.0 3.0 | 0.70 | 0.67 | True | torque | 1.76 | 0.50 |
| DM-J3507-ds 20 kg carpet 20% | 0.0 1.0 5.0 | 0.56 | 0.40 | False | grip | 1.76 | 1.00 |
| DM-J3507-ds 20 kg carpet 20% | 0.0 2.0 3.0 | 1.45 | 1.33 | True | rpm | 1.73 | 1.50 |
| DM-J3507-ds 20 kg carpet 20% | 0.0 2.0 5.0 | 1.16 | 0.80 | False | grip | 1.66 | 2.00 |
| DM-J3507-ds 20 kg carpet 20% | 0.0 3.0 3.0 | 2.91 | 2.00 | False | grip | 1.49 | 1.50 |
| DM-J3507-ds 20 kg carpet 20% | 0.0 3.0 5.0 | 2.61 | 1.20 | False | grip | 1.63 | 2.50 |
| DM-J3507-ds 20 kg carpet 20% | 45.0 1.0 3.0 | 0.73 | 0.67 | True | rpm | 3.88 | 2.00 |
| DM-J3507-ds 20 kg carpet 20% | 45.0 1.0 5.0 | 0.63 | 0.40 | False | grip | 5.23 | 10.50 |
| DM-J3507-ds 20 kg carpet 20% | 45.0 2.0 3.0 | 1.85 | 1.33 | False | rpm | 3.26 | 1.00 |
| DM-J3507-ds 20 kg carpet 20% | 45.0 2.0 5.0 | 1.65 | 0.80 | False | grip | 4.82 | 1.50 |
| DM-J3507-ds 20 kg carpet 20% | 45.0 3.0 3.0 | - | 2.00 | False | rpm | 3.48 | 1.00 |
| DM-J3507-ds 20 kg carpet 20% | 45.0 3.0 5.0 | - | 1.20 | False | rpm | 4.80 | 2.50 |
| DM-J3507-ds 20 kg carpet 20% | 90.0 1.0 3.0 | 0.69 | 0.67 | True | torque | 5.02 | 6.00 |
| DM-J3507-ds 20 kg carpet 20% | 90.0 1.0 5.0 | 0.59 | 0.40 | False | grip | 5.55 | 14.50 |
| DM-J3507-ds 20 kg carpet 20% | 90.0 2.0 3.0 | 1.58 | 1.33 | False | rpm | 5.03 | 9.00 |
| DM-J3507-ds 20 kg carpet 20% | 90.0 2.0 5.0 | 1.25 | 0.80 | False | grip | 5.81 | 20.50 |
| DM-J3507-ds 20 kg carpet 20% | 90.0 3.0 3.0 | - | 2.00 | False | grip | 4.79 | 9.50 |
| DM-J3507-ds 20 kg carpet 20% | 90.0 3.0 5.0 | - | 1.20 | False | supply | 5.62 | 10.50 |
| DM-J3507-ds 20 kg floor | 0.0 1.0 3.0 | 0.69 | 0.67 | True | torque | 1.33 | 0.00 |
| DM-J3507-ds 20 kg floor | 0.0 1.0 5.0 | 0.52 | 0.40 | False | grip | 1.82 | 1.00 |
| DM-J3507-ds 20 kg floor | 0.0 2.0 3.0 | 1.40 | 1.33 | True | torque | 1.34 | 2.00 |
| DM-J3507-ds 20 kg floor | 0.0 2.0 5.0 | 1.07 | 0.80 | False | grip | 1.61 | 2.50 |
| DM-J3507-ds 20 kg floor | 0.0 3.0 3.0 | 2.21 | 2.00 | False | grip | 1.37 | 2.00 |
| DM-J3507-ds 20 kg floor | 0.0 3.0 5.0 | 1.77 | 1.20 | False | grip | 1.60 | 2.00 |
| DM-J3507-ds 20 kg floor | 45.0 1.0 3.0 | 0.69 | 0.67 | True | torque | 3.88 | 1.00 |
| DM-J3507-ds 20 kg floor | 45.0 1.0 5.0 | 0.58 | 0.40 | False | grip | 5.08 | 1.00 |
| DM-J3507-ds 20 kg floor | 45.0 2.0 3.0 | 1.54 | 1.33 | False | rpm | 3.70 | 2.00 |
| DM-J3507-ds 20 kg floor | 45.0 2.0 5.0 | 1.30 | 0.80 | False | grip | 4.50 | 2.50 |
| DM-J3507-ds 20 kg floor | 45.0 3.0 3.0 | 3.54 | 2.00 | False | rpm | 3.38 | 5.50 |
| DM-J3507-ds 20 kg floor | 45.0 3.0 5.0 | - | 1.20 | False | grip | 4.49 | 6.00 |
| DM-J3507-ds 20 kg floor | 90.0 1.0 3.0 | 0.65 | 0.67 | True | torque | 5.17 | 8.00 |
| DM-J3507-ds 20 kg floor | 90.0 1.0 5.0 | 0.56 | 0.40 | False | grip | 5.42 | 21.00 |
| DM-J3507-ds 20 kg floor | 90.0 2.0 3.0 | 1.41 | 1.33 | False | rpm | 5.20 | 6.00 |
| DM-J3507-ds 20 kg floor | 90.0 2.0 5.0 | 1.11 | 0.80 | False | grip | 5.55 | 11.50 |
| DM-J3507-ds 20 kg floor | 90.0 3.0 3.0 | 2.35 | 2.00 | False | grip | 4.95 | 6.00 |
| DM-J3507-ds 20 kg floor | 90.0 3.0 5.0 | 1.97 | 1.20 | False | grip | 5.44 | 12.50 |
| DM-J3507-ds 20 kg floor 20% | 0.0 1.0 3.0 | 0.69 | 0.67 | True | torque | 1.32 | 0.00 |
| DM-J3507-ds 20 kg floor 20% | 0.0 1.0 5.0 | 0.52 | 0.40 | False | grip | 1.81 | 1.50 |
| DM-J3507-ds 20 kg floor 20% | 0.0 2.0 3.0 | 1.41 | 1.33 | True | rpm | 1.35 | 1.00 |
| DM-J3507-ds 20 kg floor 20% | 0.0 2.0 5.0 | 1.10 | 0.80 | False | grip | 1.56 | 1.50 |
| DM-J3507-ds 20 kg floor 20% | 0.0 3.0 3.0 | 2.37 | 2.00 | False | grip | 1.42 | 1.00 |
| DM-J3507-ds 20 kg floor 20% | 0.0 3.0 5.0 | 1.97 | 1.20 | False | grip | 1.77 | 2.00 |
| DM-J3507-ds 20 kg floor 20% | 45.0 1.0 3.0 | 0.69 | 0.67 | True | torque | 4.05 | 1.50 |
| DM-J3507-ds 20 kg floor 20% | 45.0 1.0 5.0 | 0.60 | 0.40 | False | grip | 5.12 | 1.50 |
| DM-J3507-ds 20 kg floor 20% | 45.0 2.0 3.0 | 1.67 | 1.33 | False | rpm | 3.52 | 2.00 |
| DM-J3507-ds 20 kg floor 20% | 45.0 2.0 5.0 | 1.50 | 0.80 | False | grip | 4.65 | 2.50 |
| DM-J3507-ds 20 kg floor 20% | 45.0 3.0 3.0 | - | 2.00 | False | rpm | 3.50 | 3.00 |
| DM-J3507-ds 20 kg floor 20% | 45.0 3.0 5.0 | - | 1.20 | False | grip | 4.56 | 2.50 |
| DM-J3507-ds 20 kg floor 20% | 90.0 1.0 3.0 | 0.68 | 0.67 | True | torque | 5.17 | 7.50 |
| DM-J3507-ds 20 kg floor 20% | 90.0 1.0 5.0 | 0.58 | 0.40 | False | supply | 5.26 | 7.00 |
| DM-J3507-ds 20 kg floor 20% | 90.0 2.0 3.0 | 1.45 | 1.33 | False | grip | 5.18 | 7.50 |
| DM-J3507-ds 20 kg floor 20% | 90.0 2.0 5.0 | 1.22 | 0.80 | False | grip | 5.53 | 14.50 |
| DM-J3507-ds 20 kg floor 20% | 90.0 3.0 3.0 | 2.64 | 2.00 | False | grip | 4.93 | 5.50 |
| DM-J3507-ds 20 kg floor 20% | 90.0 3.0 5.0 | 2.21 | 1.20 | False | grip | 5.54 | 15.00 |
| EduLite05-ds 10 kg carpet | 0.0 1.0 3.0 | 0.68 | 0.67 | True | ok | 1.01 | 1.00 |
| EduLite05-ds 10 kg carpet | 0.0 1.0 5.0 | 0.43 | 0.40 | True | ok | 0.92 | 3.00 |
| EduLite05-ds 10 kg carpet | 0.0 2.0 3.0 | 1.51 | 1.33 | True | rpm | 1.54 | 4.00 |
| EduLite05-ds 10 kg carpet | 0.0 2.0 5.0 | 1.03 | 0.80 | True | rpm | 1.44 | 10.00 |
| EduLite05-ds 10 kg carpet | 0.0 3.0 3.0 | - | 2.00 | False | rpm | 1.49 | 4.00 |
| EduLite05-ds 10 kg carpet | 0.0 3.0 5.0 | - | 1.20 | False | rpm | 1.59 | 17.50 |
| EduLite05-ds 10 kg carpet | 45.0 1.0 3.0 | 0.70 | 0.67 | True | ok | 3.28 | 21.00 |
| EduLite05-ds 10 kg carpet | 45.0 1.0 5.0 | 0.56 | 0.40 | False | grip | 5.38 | 7.00 |
| EduLite05-ds 10 kg carpet | 45.0 2.0 3.0 | - | 1.33 | False | rpm | 3.74 | 18.00 |
| EduLite05-ds 10 kg carpet | 45.0 2.0 5.0 | - | 0.80 | False | grip | 5.11 | 11.00 |
| EduLite05-ds 10 kg carpet | 45.0 3.0 3.0 | - | 2.00 | False | rpm | 3.46 | 10.50 |
| EduLite05-ds 10 kg carpet | 45.0 3.0 5.0 | - | 1.20 | False | grip | 6.03 | 13.00 |
| EduLite05-ds 10 kg carpet | 90.0 1.0 3.0 | 0.67 | 0.67 | True | grip | 5.23 | 13.50 |
| EduLite05-ds 10 kg carpet | 90.0 1.0 5.0 | 0.47 | 0.40 | False | grip | 5.63 | 8.50 |
| EduLite05-ds 10 kg carpet | 90.0 2.0 3.0 | 1.47 | 1.33 | False | rpm | 5.26 | 14.00 |
| EduLite05-ds 10 kg carpet | 90.0 2.0 5.0 | 1.07 | 0.80 | False | grip | 6.53 | 22.00 |
| EduLite05-ds 10 kg carpet | 90.0 3.0 3.0 | - | 2.00 | False | rpm | 5.32 | 13.50 |
| EduLite05-ds 10 kg carpet | 90.0 3.0 5.0 | - | 1.20 | False | grip | 6.08 | 14.00 |
| EduLite05-ds 10 kg carpet 20% | 0.0 1.0 3.0 | 0.68 | 0.67 | True | ok | 1.01 | 1.00 |
| EduLite05-ds 10 kg carpet 20% | 0.0 1.0 5.0 | 0.43 | 0.40 | True | ok | 1.00 | 3.50 |
| EduLite05-ds 10 kg carpet 20% | 0.0 2.0 3.0 | 1.97 | 1.33 | True | rpm | 1.62 | 3.00 |
| EduLite05-ds 10 kg carpet 20% | 0.0 2.0 5.0 | 1.67 | 0.80 | False | rpm | 1.61 | 21.00 |
| EduLite05-ds 10 kg carpet 20% | 0.0 3.0 3.0 | - | 2.00 | False | rpm | 1.44 | 1.50 |
| EduLite05-ds 10 kg carpet 20% | 0.0 3.0 5.0 | - | 1.20 | False | rpm | 1.57 | 15.50 |
| EduLite05-ds 10 kg carpet 20% | 45.0 1.0 3.0 | 0.71 | 0.67 | True | ok | 3.30 | 13.00 |
| EduLite05-ds 10 kg carpet 20% | 45.0 1.0 5.0 | 0.56 | 0.40 | False | grip | 5.23 | 8.00 |
| EduLite05-ds 10 kg carpet 20% | 45.0 2.0 3.0 | - | 1.33 | False | rpm | 3.57 | 13.50 |
| EduLite05-ds 10 kg carpet 20% | 45.0 2.0 5.0 | - | 0.80 | False | grip | 5.38 | 12.50 |
| EduLite05-ds 10 kg carpet 20% | 45.0 3.0 3.0 | - | 2.00 | False | rpm | 3.45 | 11.50 |
| EduLite05-ds 10 kg carpet 20% | 45.0 3.0 5.0 | - | 1.20 | False | grip | 5.13 | 7.50 |
| EduLite05-ds 10 kg carpet 20% | 90.0 1.0 3.0 | 0.67 | 0.67 | True | grip | 5.47 | 15.00 |
| EduLite05-ds 10 kg carpet 20% | 90.0 1.0 5.0 | 0.46 | 0.40 | False | grip | 5.69 | 12.50 |
| EduLite05-ds 10 kg carpet 20% | 90.0 2.0 3.0 | - | 1.33 | False | rpm | 5.14 | 15.00 |
| EduLite05-ds 10 kg carpet 20% | 90.0 2.0 5.0 | 2.75 | 0.80 | False | grip | 6.04 | 15.50 |
| EduLite05-ds 10 kg carpet 20% | 90.0 3.0 3.0 | - | 2.00 | False | rpm | 5.37 | 11.00 |
| EduLite05-ds 10 kg carpet 20% | 90.0 3.0 5.0 | - | 1.20 | False | grip | 5.83 | 14.00 |
| EduLite05-ds 10 kg floor | 0.0 1.0 3.0 | 0.68 | 0.67 | True | ok | 0.73 | 0.50 |
| EduLite05-ds 10 kg floor | 0.0 1.0 5.0 | 0.43 | 0.40 | True | ok | 0.64 | 3.00 |
| EduLite05-ds 10 kg floor | 0.0 2.0 3.0 | 1.42 | 1.33 | True | rpm | 1.26 | 4.00 |
| EduLite05-ds 10 kg floor | 0.0 2.0 5.0 | 0.95 | 0.80 | False | rpm | 1.37 | 14.50 |
| EduLite05-ds 10 kg floor | 0.0 3.0 3.0 | - | 2.00 | False | rpm | 1.23 | 3.50 |
| EduLite05-ds 10 kg floor | 0.0 3.0 5.0 | - | 1.20 | False | rpm | 1.26 | 10.00 |
| EduLite05-ds 10 kg floor | 45.0 1.0 3.0 | 0.70 | 0.67 | True | ok | 3.48 | 7.50 |
| EduLite05-ds 10 kg floor | 45.0 1.0 5.0 | 0.57 | 0.40 | False | grip | 5.24 | 5.50 |
| EduLite05-ds 10 kg floor | 45.0 2.0 3.0 | - | 1.33 | False | rpm | 3.54 | 7.00 |
| EduLite05-ds 10 kg floor | 45.0 2.0 5.0 | - | 0.80 | False | grip | 5.49 | 11.50 |
| EduLite05-ds 10 kg floor | 45.0 3.0 3.0 | - | 2.00 | False | rpm | 3.47 | 7.50 |
| EduLite05-ds 10 kg floor | 45.0 3.0 5.0 | - | 1.20 | False | grip | 5.44 | 7.00 |
| EduLite05-ds 10 kg floor | 90.0 1.0 3.0 | 0.67 | 0.67 | True | grip | 5.26 | 9.00 |
| EduLite05-ds 10 kg floor | 90.0 1.0 5.0 | 0.48 | 0.40 | False | grip | 5.67 | 8.50 |
| EduLite05-ds 10 kg floor | 90.0 2.0 3.0 | 1.45 | 1.33 | True | rpm | 5.27 | 9.50 |
| EduLite05-ds 10 kg floor | 90.0 2.0 5.0 | 1.00 | 0.80 | False | grip | 5.76 | 11.50 |
| EduLite05-ds 10 kg floor | 90.0 3.0 3.0 | - | 2.00 | False | rpm | 5.26 | 9.50 |
| EduLite05-ds 10 kg floor | 90.0 3.0 5.0 | - | 1.20 | False | grip | 5.56 | 13.00 |
| EduLite05-ds 10 kg floor 20% | 0.0 1.0 3.0 | 0.68 | 0.67 | True | ok | 0.73 | 0.50 |
| EduLite05-ds 10 kg floor 20% | 0.0 1.0 5.0 | 0.42 | 0.40 | True | ok | 0.63 | 2.50 |
| EduLite05-ds 10 kg floor 20% | 0.0 2.0 3.0 | 1.56 | 1.33 | True | rpm | 1.20 | 3.00 |
| EduLite05-ds 10 kg floor 20% | 0.0 2.0 5.0 | 1.10 | 0.80 | False | rpm | 1.41 | 9.00 |
| EduLite05-ds 10 kg floor 20% | 0.0 3.0 3.0 | - | 2.00 | False | rpm | 1.26 | 3.00 |
| EduLite05-ds 10 kg floor 20% | 0.0 3.0 5.0 | - | 1.20 | False | rpm | 1.35 | 12.00 |
| EduLite05-ds 10 kg floor 20% | 45.0 1.0 3.0 | 0.70 | 0.67 | True | ok | 3.43 | 6.50 |
| EduLite05-ds 10 kg floor 20% | 45.0 1.0 5.0 | 0.55 | 0.40 | False | grip | 5.24 | 5.00 |
| EduLite05-ds 10 kg floor 20% | 45.0 2.0 3.0 | - | 1.33 | False | rpm | 3.64 | 7.00 |
| EduLite05-ds 10 kg floor 20% | 45.0 2.0 5.0 | - | 0.80 | False | grip | 5.06 | 9.00 |
| EduLite05-ds 10 kg floor 20% | 45.0 3.0 3.0 | - | 2.00 | False | rpm | 3.68 | 10.00 |
| EduLite05-ds 10 kg floor 20% | 45.0 3.0 5.0 | - | 1.20 | False | grip | 5.46 | 8.50 |
| EduLite05-ds 10 kg floor 20% | 90.0 1.0 3.0 | 0.67 | 0.67 | True | grip | 5.19 | 10.00 |
| EduLite05-ds 10 kg floor 20% | 90.0 1.0 5.0 | 0.46 | 0.40 | False | grip | 5.50 | 11.50 |
| EduLite05-ds 10 kg floor 20% | 90.0 2.0 3.0 | 1.58 | 1.33 | False | rpm | 5.69 | 10.50 |
| EduLite05-ds 10 kg floor 20% | 90.0 2.0 5.0 | 1.09 | 0.80 | False | grip | 6.47 | 11.50 |
| EduLite05-ds 10 kg floor 20% | 90.0 3.0 3.0 | - | 2.00 | False | rpm | 5.24 | 9.50 |
| EduLite05-ds 10 kg floor 20% | 90.0 3.0 5.0 | - | 1.20 | False | grip | 5.87 | 10.00 |
| EduLite05-ds 20 kg carpet | 0.0 1.0 3.0 | 0.68 | 0.67 | True | ok | 1.31 | 0.00 |
| EduLite05-ds 20 kg carpet | 0.0 1.0 5.0 | 0.43 | 0.40 | True | ok | 0.88 | 1.50 |
| EduLite05-ds 20 kg carpet | 0.0 2.0 3.0 | 1.53 | 1.33 | False | rpm | 1.57 | 1.50 |
| EduLite05-ds 20 kg carpet | 0.0 2.0 5.0 | 1.03 | 0.80 | False | grip | 1.65 | 2.50 |
| EduLite05-ds 20 kg carpet | 0.0 3.0 3.0 | - | 2.00 | False | rpm | 1.62 | 1.50 |
| EduLite05-ds 20 kg carpet | 0.0 3.0 5.0 | - | 1.20 | False | grip | 1.76 | 2.50 |
| EduLite05-ds 20 kg carpet | 45.0 1.0 3.0 | 0.69 | 0.67 | True | ok | 3.46 | 0.50 |
| EduLite05-ds 20 kg carpet | 45.0 1.0 5.0 | 0.55 | 0.40 | False | grip | 5.23 | 4.50 |
| EduLite05-ds 20 kg carpet | 45.0 2.0 3.0 | - | 1.33 | False | rpm | 3.42 | 4.50 |
| EduLite05-ds 20 kg carpet | 45.0 2.0 5.0 | - | 0.80 | False | grip | 4.80 | 3.00 |
| EduLite05-ds 20 kg carpet | 45.0 3.0 3.0 | - | 2.00 | False | rpm | 3.39 | 2.50 |
| EduLite05-ds 20 kg carpet | 45.0 3.0 5.0 | - | 1.20 | False | grip | 4.93 | 6.50 |
| EduLite05-ds 20 kg carpet | 90.0 1.0 3.0 | 0.67 | 0.67 | True | ok | 5.10 | 7.00 |
| EduLite05-ds 20 kg carpet | 90.0 1.0 5.0 | 0.47 | 0.40 | False | grip | 5.44 | 8.00 |
| EduLite05-ds 20 kg carpet | 90.0 2.0 3.0 | 1.48 | 1.33 | False | rpm | 5.21 | 10.00 |
| EduLite05-ds 20 kg carpet | 90.0 2.0 5.0 | 1.10 | 0.80 | False | grip | 5.67 | 11.50 |
| EduLite05-ds 20 kg carpet | 90.0 3.0 3.0 | - | 2.00 | False | grip | 5.20 | 11.50 |
| EduLite05-ds 20 kg carpet | 90.0 3.0 5.0 | - | 1.20 | False | grip | 5.74 | 14.00 |
| EduLite05-ds 20 kg carpet 20% | 0.0 1.0 3.0 | 0.69 | 0.67 | True | ok | 1.29 | 0.00 |
| EduLite05-ds 20 kg carpet 20% | 0.0 1.0 5.0 | 0.44 | 0.40 | True | rpm | 1.29 | 1.50 |
| EduLite05-ds 20 kg carpet 20% | 0.0 2.0 3.0 | - | 1.33 | False | rpm | 1.62 | 1.00 |
| EduLite05-ds 20 kg carpet 20% | 0.0 2.0 5.0 | - | 0.80 | False | rpm | 1.74 | 16.00 |
| EduLite05-ds 20 kg carpet 20% | 0.0 3.0 3.0 | - | 2.00 | False | rpm | 1.67 | 1.00 |
| EduLite05-ds 20 kg carpet 20% | 0.0 3.0 5.0 | - | 1.20 | False | rpm | 1.61 | 2.00 |
| EduLite05-ds 20 kg carpet 20% | 45.0 1.0 3.0 | 0.70 | 0.67 | True | rpm | 3.72 | 3.00 |
| EduLite05-ds 20 kg carpet 20% | 45.0 1.0 5.0 | 0.56 | 0.40 | False | grip | 5.56 | 8.00 |
| EduLite05-ds 20 kg carpet 20% | 45.0 2.0 3.0 | - | 1.33 | False | rpm | 3.72 | 3.00 |
| EduLite05-ds 20 kg carpet 20% | 45.0 2.0 5.0 | - | 0.80 | False | grip | 5.37 | 5.50 |
| EduLite05-ds 20 kg carpet 20% | 45.0 3.0 3.0 | - | 2.00 | False | rpm | 3.83 | 3.50 |
| EduLite05-ds 20 kg carpet 20% | 45.0 3.0 5.0 | - | 1.20 | False | grip | 5.00 | 6.50 |
| EduLite05-ds 20 kg carpet 20% | 90.0 1.0 3.0 | 0.67 | 0.67 | True | ok | 5.16 | 7.00 |
| EduLite05-ds 20 kg carpet 20% | 90.0 1.0 5.0 | 0.49 | 0.40 | False | grip | 5.54 | 13.00 |
| EduLite05-ds 20 kg carpet 20% | 90.0 2.0 3.0 | - | 1.33 | False | rpm | 5.05 | 13.00 |
| EduLite05-ds 20 kg carpet 20% | 90.0 2.0 5.0 | - | 0.80 | False | grip | 5.57 | 10.50 |
| EduLite05-ds 20 kg carpet 20% | 90.0 3.0 3.0 | - | 2.00 | False | grip | 5.15 | 8.50 |
| EduLite05-ds 20 kg carpet 20% | 90.0 3.0 5.0 | - | 1.20 | False | grip | 6.67 | 11.50 |
| EduLite05-ds 20 kg floor | 0.0 1.0 3.0 | 0.67 | 0.67 | True | ok | 1.09 | 0.50 |
| EduLite05-ds 20 kg floor | 0.0 1.0 5.0 | 0.42 | 0.40 | True | torque | 0.79 | 2.00 |
| EduLite05-ds 20 kg floor | 0.0 2.0 3.0 | 1.41 | 1.33 | True | rpm | 1.30 | 1.50 |
| EduLite05-ds 20 kg floor | 0.0 2.0 5.0 | 0.97 | 0.80 | False | rpm | 1.57 | 12.00 |
| EduLite05-ds 20 kg floor | 0.0 3.0 3.0 | - | 2.00 | False | rpm | 1.43 | 2.00 |
| EduLite05-ds 20 kg floor | 0.0 3.0 5.0 | - | 1.20 | False | grip | 1.45 | 13.00 |
| EduLite05-ds 20 kg floor | 45.0 1.0 3.0 | 0.68 | 0.67 | True | ok | 3.46 | 1.50 |
| EduLite05-ds 20 kg floor | 45.0 1.0 5.0 | 0.55 | 0.40 | False | grip | 4.88 | 2.00 |
| EduLite05-ds 20 kg floor | 45.0 2.0 3.0 | - | 1.33 | False | rpm | 3.42 | 4.00 |
| EduLite05-ds 20 kg floor | 45.0 2.0 5.0 | - | 0.80 | False | grip | 4.61 | 2.50 |
| EduLite05-ds 20 kg floor | 45.0 3.0 3.0 | - | 2.00 | False | rpm | 3.48 | 4.00 |
| EduLite05-ds 20 kg floor | 45.0 3.0 5.0 | - | 1.20 | False | grip | 4.63 | 2.50 |
| EduLite05-ds 20 kg floor | 90.0 1.0 3.0 | 0.67 | 0.67 | True | ok | 5.22 | 7.00 |
| EduLite05-ds 20 kg floor | 90.0 1.0 5.0 | 0.48 | 0.40 | False | grip | 5.39 | 11.50 |
| EduLite05-ds 20 kg floor | 90.0 2.0 3.0 | 1.45 | 1.33 | False | rpm | 5.20 | 6.50 |
| EduLite05-ds 20 kg floor | 90.0 2.0 5.0 | 1.01 | 0.80 | False | grip | 5.61 | 10.00 |
| EduLite05-ds 20 kg floor | 90.0 3.0 3.0 | - | 2.00 | False | rpm | 5.26 | 5.50 |
| EduLite05-ds 20 kg floor | 90.0 3.0 5.0 | - | 1.20 | False | grip | 5.50 | 10.00 |
| EduLite05-ds 20 kg floor 20% | 0.0 1.0 3.0 | 0.67 | 0.67 | True | ok | 1.03 | 0.00 |
| EduLite05-ds 20 kg floor 20% | 0.0 1.0 5.0 | 0.43 | 0.40 | True | rpm | 1.02 | 4.00 |
| EduLite05-ds 20 kg floor 20% | 0.0 2.0 3.0 | 1.75 | 1.33 | True | rpm | 1.44 | 1.00 |
| EduLite05-ds 20 kg floor 20% | 0.0 2.0 5.0 | 1.32 | 0.80 | False | grip | 1.55 | 19.50 |
| EduLite05-ds 20 kg floor 20% | 0.0 3.0 3.0 | - | 2.00 | False | rpm | 1.44 | 1.00 |
| EduLite05-ds 20 kg floor 20% | 0.0 3.0 5.0 | - | 1.20 | False | grip | 1.40 | 5.50 |
| EduLite05-ds 20 kg floor 20% | 45.0 1.0 3.0 | 0.69 | 0.67 | True | ok | 3.36 | 2.00 |
| EduLite05-ds 20 kg floor 20% | 45.0 1.0 5.0 | 0.56 | 0.40 | False | grip | 5.01 | 5.50 |
| EduLite05-ds 20 kg floor 20% | 45.0 2.0 3.0 | - | 1.33 | False | rpm | 3.59 | 4.00 |
| EduLite05-ds 20 kg floor 20% | 45.0 2.0 5.0 | - | 0.80 | False | grip | 5.05 | 3.00 |
| EduLite05-ds 20 kg floor 20% | 45.0 3.0 3.0 | - | 2.00 | False | rpm | 3.63 | 3.00 |
| EduLite05-ds 20 kg floor 20% | 45.0 3.0 5.0 | - | 1.20 | False | grip | 4.89 | 2.50 |
| EduLite05-ds 20 kg floor 20% | 90.0 1.0 3.0 | 0.67 | 0.67 | True | ok | 5.21 | 5.50 |
| EduLite05-ds 20 kg floor 20% | 90.0 1.0 5.0 | 0.47 | 0.40 | False | grip | 5.48 | 7.50 |
| EduLite05-ds 20 kg floor 20% | 90.0 2.0 3.0 | 2.19 | 1.33 | False | rpm | 5.29 | 5.00 |
| EduLite05-ds 20 kg floor 20% | 90.0 2.0 5.0 | 1.56 | 0.80 | False | grip | 5.71 | 14.00 |
| EduLite05-ds 20 kg floor 20% | 90.0 3.0 3.0 | - | 2.00 | False | rpm | 5.34 | 5.50 |
| EduLite05-ds 20 kg floor 20% | 90.0 3.0 5.0 | - | 1.20 | False | grip | 5.54 | 9.00 |
| GIM3510-8-ds 10 kg carpet | 0.0 1.0 3.0 | 0.68 | 0.67 | True | ok | 1.02 | 1.00 |
| GIM3510-8-ds 10 kg carpet | 0.0 1.0 5.0 | 0.44 | 0.40 | True | ok | 0.80 | 4.00 |
| GIM3510-8-ds 10 kg carpet | 0.0 2.0 3.0 | 1.46 | 1.33 | True | torque | 1.58 | 10.50 |
| GIM3510-8-ds 10 kg carpet | 0.0 2.0 5.0 | 0.90 | 0.80 | True | torque | 1.41 | 10.00 |
| GIM3510-8-ds 10 kg carpet | 0.0 3.0 3.0 | 2.24 | 2.00 | False | torque | 1.27 | 6.00 |
| GIM3510-8-ds 10 kg carpet | 0.0 3.0 5.0 | 1.54 | 1.20 | False | grip | 2.09 | 16.00 |
| GIM3510-8-ds 10 kg carpet | 45.0 1.0 3.0 | 0.70 | 0.67 | True | ok | 3.33 | 14.00 |
| GIM3510-8-ds 10 kg carpet | 45.0 1.0 5.0 | 0.56 | 0.40 | False | grip | 5.26 | 4.00 |
| GIM3510-8-ds 10 kg carpet | 45.0 2.0 3.0 | 1.38 | 1.33 | True | torque | 3.40 | 13.50 |
| GIM3510-8-ds 10 kg carpet | 45.0 2.0 5.0 | 1.09 | 0.80 | False | grip | 5.61 | 11.50 |
| GIM3510-8-ds 10 kg carpet | 45.0 3.0 3.0 | 2.02 | 2.00 | True | torque | 3.57 | 11.00 |
| GIM3510-8-ds 10 kg carpet | 45.0 3.0 5.0 | 1.63 | 1.20 | False | grip | 5.29 | 10.50 |
| GIM3510-8-ds 10 kg carpet | 90.0 1.0 3.0 | 0.68 | 0.67 | True | grip | 5.48 | 15.50 |
| GIM3510-8-ds 10 kg carpet | 90.0 1.0 5.0 | 0.48 | 0.40 | False | grip | 5.56 | 18.00 |
| GIM3510-8-ds 10 kg carpet | 90.0 2.0 3.0 | 1.39 | 1.33 | False | torque | 5.39 | 14.00 |
| GIM3510-8-ds 10 kg carpet | 90.0 2.0 5.0 | 0.99 | 0.80 | False | grip | 5.76 | 19.50 |
| GIM3510-8-ds 10 kg carpet | 90.0 3.0 3.0 | 2.23 | 2.00 | False | grip | 5.89 | 18.50 |
| GIM3510-8-ds 10 kg carpet | 90.0 3.0 5.0 | 1.51 | 1.20 | False | grip | 5.99 | 16.00 |
| GIM3510-8-ds 10 kg carpet 20% | 0.0 1.0 3.0 | 0.68 | 0.67 | True | ok | 1.02 | 1.00 |
| GIM3510-8-ds 10 kg carpet 20% | 0.0 1.0 5.0 | 0.44 | 0.40 | True | ok | 0.80 | 4.00 |
| GIM3510-8-ds 10 kg carpet 20% | 0.0 2.0 3.0 | 1.46 | 1.33 | True | torque | 1.58 | 10.50 |
| GIM3510-8-ds 10 kg carpet 20% | 0.0 2.0 5.0 | 0.90 | 0.80 | True | torque | 1.41 | 10.00 |
| GIM3510-8-ds 10 kg carpet 20% | 0.0 3.0 3.0 | 2.45 | 2.00 | False | torque | 1.66 | 7.50 |
| GIM3510-8-ds 10 kg carpet 20% | 0.0 3.0 5.0 | 1.48 | 1.20 | False | torque | 1.51 | 16.50 |
| GIM3510-8-ds 10 kg carpet 20% | 45.0 1.0 3.0 | 0.70 | 0.67 | True | ok | 3.33 | 14.00 |
| GIM3510-8-ds 10 kg carpet 20% | 45.0 1.0 5.0 | 0.56 | 0.40 | False | grip | 5.26 | 4.00 |
| GIM3510-8-ds 10 kg carpet 20% | 45.0 2.0 3.0 | 1.38 | 1.33 | True | torque | 3.38 | 13.50 |
| GIM3510-8-ds 10 kg carpet 20% | 45.0 2.0 5.0 | 1.09 | 0.80 | False | grip | 5.57 | 11.00 |
| GIM3510-8-ds 10 kg carpet 20% | 45.0 3.0 3.0 | 2.05 | 2.00 | True | rpm | 3.97 | 13.50 |
| GIM3510-8-ds 10 kg carpet 20% | 45.0 3.0 5.0 | 1.64 | 1.20 | False | grip | 5.45 | 16.00 |
| GIM3510-8-ds 10 kg carpet 20% | 90.0 1.0 3.0 | 0.68 | 0.67 | True | grip | 5.48 | 15.50 |
| GIM3510-8-ds 10 kg carpet 20% | 90.0 1.0 5.0 | 0.48 | 0.40 | False | grip | 5.56 | 18.00 |
| GIM3510-8-ds 10 kg carpet 20% | 90.0 2.0 3.0 | 1.39 | 1.33 | False | torque | 5.39 | 14.00 |
| GIM3510-8-ds 10 kg carpet 20% | 90.0 2.0 5.0 | 0.99 | 0.80 | False | supply | 5.76 | 19.50 |
| GIM3510-8-ds 10 kg carpet 20% | 90.0 3.0 3.0 | 2.15 | 2.00 | False | grip | 5.53 | 16.00 |
| GIM3510-8-ds 10 kg carpet 20% | 90.0 3.0 5.0 | 1.50 | 1.20 | False | supply | 6.82 | 15.00 |
| GIM3510-8-ds 10 kg floor | 0.0 1.0 3.0 | 0.68 | 0.67 | True | ok | 0.69 | 1.50 |
| GIM3510-8-ds 10 kg floor | 0.0 1.0 5.0 | 0.44 | 0.40 | True | ok | 0.66 | 3.50 |
| GIM3510-8-ds 10 kg floor | 0.0 2.0 3.0 | 1.40 | 1.33 | True | ok | 1.10 | 3.50 |
| GIM3510-8-ds 10 kg floor | 0.0 2.0 5.0 | 0.89 | 0.80 | True | torque | 1.00 | 7.00 |
| GIM3510-8-ds 10 kg floor | 0.0 3.0 3.0 | 2.12 | 2.00 | True | torque | 1.08 | 4.50 |
| GIM3510-8-ds 10 kg floor | 0.0 3.0 5.0 | 1.41 | 1.20 | False | grip | 1.40 | 26.00 |
| GIM3510-8-ds 10 kg floor | 45.0 1.0 3.0 | 0.70 | 0.67 | True | ok | 3.48 | 8.00 |
| GIM3510-8-ds 10 kg floor | 45.0 1.0 5.0 | 0.58 | 0.40 | False | grip | 5.21 | 4.00 |
| GIM3510-8-ds 10 kg floor | 45.0 2.0 3.0 | 1.46 | 1.33 | False | torque | 3.54 | 9.50 |
| GIM3510-8-ds 10 kg floor | 45.0 2.0 5.0 | 1.11 | 0.80 | False | grip | 5.41 | 8.50 |
| GIM3510-8-ds 10 kg floor | 45.0 3.0 3.0 | 2.12 | 2.00 | False | torque | 3.39 | 9.00 |
| GIM3510-8-ds 10 kg floor | 45.0 3.0 5.0 | 1.61 | 1.20 | False | grip | 5.52 | 10.00 |
| GIM3510-8-ds 10 kg floor | 90.0 1.0 3.0 | 0.67 | 0.67 | True | ok | 5.19 | 11.00 |
| GIM3510-8-ds 10 kg floor | 90.0 1.0 5.0 | 0.48 | 0.40 | False | grip | 5.44 | 11.00 |
| GIM3510-8-ds 10 kg floor | 90.0 2.0 3.0 | 1.41 | 1.33 | True | torque | 5.25 | 9.50 |
| GIM3510-8-ds 10 kg floor | 90.0 2.0 5.0 | 0.92 | 0.80 | False | grip | 5.79 | 9.00 |
| GIM3510-8-ds 10 kg floor | 90.0 3.0 3.0 | 2.19 | 2.00 | False | grip | 5.41 | 9.00 |
| GIM3510-8-ds 10 kg floor | 90.0 3.0 5.0 | 1.48 | 1.20 | False | grip | 5.90 | 15.00 |
| GIM3510-8-ds 10 kg floor 20% | 0.0 1.0 3.0 | 0.68 | 0.67 | True | ok | 0.69 | 1.50 |
| GIM3510-8-ds 10 kg floor 20% | 0.0 1.0 5.0 | 0.44 | 0.40 | True | ok | 0.66 | 3.50 |
| GIM3510-8-ds 10 kg floor 20% | 0.0 2.0 3.0 | 1.40 | 1.33 | True | ok | 1.10 | 3.50 |
| GIM3510-8-ds 10 kg floor 20% | 0.0 2.0 5.0 | 0.89 | 0.80 | True | torque | 1.00 | 7.00 |
| GIM3510-8-ds 10 kg floor 20% | 0.0 3.0 3.0 | 2.13 | 2.00 | False | torque | 1.29 | 7.00 |
| GIM3510-8-ds 10 kg floor 20% | 0.0 3.0 5.0 | 1.62 | 1.20 | False | supply | 1.31 | 19.00 |
| GIM3510-8-ds 10 kg floor 20% | 45.0 1.0 3.0 | 0.70 | 0.67 | True | ok | 3.48 | 8.00 |
| GIM3510-8-ds 10 kg floor 20% | 45.0 1.0 5.0 | 0.58 | 0.40 | False | grip | 5.21 | 4.00 |
| GIM3510-8-ds 10 kg floor 20% | 45.0 2.0 3.0 | 1.46 | 1.33 | False | torque | 3.51 | 11.50 |
| GIM3510-8-ds 10 kg floor 20% | 45.0 2.0 5.0 | 1.12 | 0.80 | False | grip | 5.47 | 9.00 |
| GIM3510-8-ds 10 kg floor 20% | 45.0 3.0 3.0 | 2.12 | 2.00 | False | rpm | 3.28 | 11.50 |
| GIM3510-8-ds 10 kg floor 20% | 45.0 3.0 5.0 | 1.62 | 1.20 | False | rpm | 5.35 | 8.50 |
| GIM3510-8-ds 10 kg floor 20% | 90.0 1.0 3.0 | 0.67 | 0.67 | True | ok | 5.19 | 11.00 |
| GIM3510-8-ds 10 kg floor 20% | 90.0 1.0 5.0 | 0.48 | 0.40 | False | grip | 5.44 | 11.00 |
| GIM3510-8-ds 10 kg floor 20% | 90.0 2.0 3.0 | 1.41 | 1.33 | True | torque | 5.25 | 9.50 |
| GIM3510-8-ds 10 kg floor 20% | 90.0 2.0 5.0 | 0.92 | 0.80 | False | supply | 5.79 | 9.00 |
| GIM3510-8-ds 10 kg floor 20% | 90.0 3.0 3.0 | 2.20 | 2.00 | False | grip | 5.21 | 12.50 |
| GIM3510-8-ds 10 kg floor 20% | 90.0 3.0 5.0 | 1.50 | 1.20 | False | supply | 5.97 | 10.50 |
| GIM3510-8-ds 20 kg carpet | 0.0 1.0 3.0 | 0.66 | 0.67 | True | torque | 1.44 | 0.00 |
| GIM3510-8-ds 20 kg carpet | 0.0 1.0 5.0 | 0.50 | 0.40 | False | grip | 1.59 | 2.50 |
| GIM3510-8-ds 20 kg carpet | 0.0 2.0 3.0 | 1.43 | 1.33 | True | torque | 1.57 | 2.00 |
| GIM3510-8-ds 20 kg carpet | 0.0 2.0 5.0 | 1.04 | 0.80 | False | grip | 1.61 | 2.50 |
| GIM3510-8-ds 20 kg carpet | 0.0 3.0 3.0 | 2.38 | 2.00 | False | grip | 1.66 | 2.50 |
| GIM3510-8-ds 20 kg carpet | 0.0 3.0 5.0 | 1.62 | 1.20 | False | grip | 1.72 | 2.50 |
| GIM3510-8-ds 20 kg carpet | 45.0 1.0 3.0 | 0.69 | 0.67 | True | torque | 3.84 | 0.50 |
| GIM3510-8-ds 20 kg carpet | 45.0 1.0 5.0 | 0.59 | 0.40 | False | grip | 5.31 | 2.50 |
| GIM3510-8-ds 20 kg carpet | 45.0 2.0 3.0 | 1.39 | 1.33 | True | torque | 3.52 | 3.00 |
| GIM3510-8-ds 20 kg carpet | 45.0 2.0 5.0 | 1.12 | 0.80 | False | grip | 5.04 | 2.00 |
| GIM3510-8-ds 20 kg carpet | 45.0 3.0 3.0 | 2.11 | 2.00 | True | torque | 3.69 | 3.00 |
| GIM3510-8-ds 20 kg carpet | 45.0 3.0 5.0 | 1.75 | 1.20 | False | torque | 5.04 | 3.50 |
| GIM3510-8-ds 20 kg carpet | 90.0 1.0 3.0 | 0.65 | 0.67 | True | torque | 5.26 | 6.50 |
| GIM3510-8-ds 20 kg carpet | 90.0 1.0 5.0 | 0.55 | 0.40 | False | grip | 5.41 | 18.50 |
| GIM3510-8-ds 20 kg carpet | 90.0 2.0 3.0 | 1.43 | 1.33 | True | torque | 5.18 | 14.00 |
| GIM3510-8-ds 20 kg carpet | 90.0 2.0 5.0 | 1.04 | 0.80 | False | grip | 5.70 | 20.50 |
| GIM3510-8-ds 20 kg carpet | 90.0 3.0 3.0 | 2.14 | 2.00 | False | grip | 5.23 | 8.50 |
| GIM3510-8-ds 20 kg carpet | 90.0 3.0 5.0 | 1.62 | 1.20 | False | grip | 5.61 | 17.50 |
| GIM3510-8-ds 20 kg carpet 20% | 0.0 1.0 3.0 | 0.66 | 0.67 | True | torque | 1.44 | 0.00 |
| GIM3510-8-ds 20 kg carpet 20% | 0.0 1.0 5.0 | 0.50 | 0.40 | False | grip | 1.59 | 2.50 |
| GIM3510-8-ds 20 kg carpet 20% | 0.0 2.0 3.0 | 1.43 | 1.33 | True | torque | 1.57 | 2.00 |
| GIM3510-8-ds 20 kg carpet 20% | 0.0 2.0 5.0 | 1.04 | 0.80 | False | grip | 1.61 | 2.50 |
| GIM3510-8-ds 20 kg carpet 20% | 0.0 3.0 3.0 | 2.26 | 2.00 | False | supply | 1.73 | 3.00 |
| GIM3510-8-ds 20 kg carpet 20% | 0.0 3.0 5.0 | 1.66 | 1.20 | False | supply | 1.67 | 5.00 |
| GIM3510-8-ds 20 kg carpet 20% | 45.0 1.0 3.0 | 0.69 | 0.67 | True | torque | 3.84 | 0.50 |
| GIM3510-8-ds 20 kg carpet 20% | 45.0 1.0 5.0 | 0.59 | 0.40 | False | grip | 5.31 | 2.50 |
| GIM3510-8-ds 20 kg carpet 20% | 45.0 2.0 3.0 | 1.39 | 1.33 | True | torque | 3.52 | 4.50 |
| GIM3510-8-ds 20 kg carpet 20% | 45.0 2.0 5.0 | 1.13 | 0.80 | False | grip | 5.05 | 2.00 |
| GIM3510-8-ds 20 kg carpet 20% | 45.0 3.0 3.0 | 2.27 | 2.00 | False | rpm | 3.57 | 3.00 |
| GIM3510-8-ds 20 kg carpet 20% | 45.0 3.0 5.0 | 1.86 | 1.20 | False | grip | 5.20 | 3.00 |
| GIM3510-8-ds 20 kg carpet 20% | 90.0 1.0 3.0 | 0.65 | 0.67 | True | torque | 5.26 | 6.50 |
| GIM3510-8-ds 20 kg carpet 20% | 90.0 1.0 5.0 | 0.55 | 0.40 | False | grip | 5.41 | 18.50 |
| GIM3510-8-ds 20 kg carpet 20% | 90.0 2.0 3.0 | 1.43 | 1.33 | True | supply | 5.18 | 14.00 |
| GIM3510-8-ds 20 kg carpet 20% | 90.0 2.0 5.0 | 1.04 | 0.80 | False | supply | 5.70 | 20.50 |
| GIM3510-8-ds 20 kg carpet 20% | 90.0 3.0 3.0 | 2.16 | 2.00 | False | supply | 5.24 | 13.00 |
| GIM3510-8-ds 20 kg carpet 20% | 90.0 3.0 5.0 | 1.58 | 1.20 | False | supply | 5.82 | 17.50 |
| GIM3510-8-ds 20 kg floor | 0.0 1.0 3.0 | 0.68 | 0.67 | True | torque | 1.15 | 0.00 |
| GIM3510-8-ds 20 kg floor | 0.0 1.0 5.0 | 0.49 | 0.40 | False | grip | 1.54 | 2.00 |
| GIM3510-8-ds 20 kg floor | 0.0 2.0 3.0 | 1.37 | 1.33 | True | torque | 1.31 | 1.50 |
| GIM3510-8-ds 20 kg floor | 0.0 2.0 5.0 | 1.01 | 0.80 | False | grip | 1.42 | 2.50 |
| GIM3510-8-ds 20 kg floor | 0.0 3.0 3.0 | 2.17 | 2.00 | False | torque | 1.33 | 3.50 |
| GIM3510-8-ds 20 kg floor | 0.0 3.0 5.0 | 1.58 | 1.20 | False | grip | 1.50 | 2.50 |
| GIM3510-8-ds 20 kg floor | 45.0 1.0 3.0 | 0.69 | 0.67 | True | torque | 3.56 | 0.00 |
| GIM3510-8-ds 20 kg floor | 45.0 1.0 5.0 | 0.56 | 0.40 | False | grip | 4.91 | 1.00 |
| GIM3510-8-ds 20 kg floor | 45.0 2.0 3.0 | 1.45 | 1.33 | True | torque | 3.53 | 2.00 |
| GIM3510-8-ds 20 kg floor | 45.0 2.0 5.0 | 1.13 | 0.80 | False | grip | 4.94 | 2.50 |
| GIM3510-8-ds 20 kg floor | 45.0 3.0 3.0 | 2.17 | 2.00 | False | grip | 3.70 | 3.00 |
| GIM3510-8-ds 20 kg floor | 45.0 3.0 5.0 | 1.64 | 1.20 | False | grip | 4.27 | 3.00 |
| GIM3510-8-ds 20 kg floor | 90.0 1.0 3.0 | 0.67 | 0.67 | True | ok | 5.17 | 9.50 |
| GIM3510-8-ds 20 kg floor | 90.0 1.0 5.0 | 0.54 | 0.40 | False | grip | 5.22 | 10.50 |
| GIM3510-8-ds 20 kg floor | 90.0 2.0 3.0 | 1.36 | 1.33 | True | torque | 5.17 | 7.00 |
| GIM3510-8-ds 20 kg floor | 90.0 2.0 5.0 | 1.02 | 0.80 | False | grip | 5.55 | 14.50 |
| GIM3510-8-ds 20 kg floor | 90.0 3.0 3.0 | 2.16 | 2.00 | False | grip | 5.14 | 9.50 |
| GIM3510-8-ds 20 kg floor | 90.0 3.0 5.0 | 1.59 | 1.20 | False | grip | 5.49 | 7.50 |
| GIM3510-8-ds 20 kg floor 20% | 0.0 1.0 3.0 | 0.68 | 0.67 | True | torque | 1.15 | 0.00 |
| GIM3510-8-ds 20 kg floor 20% | 0.0 1.0 5.0 | 0.49 | 0.40 | False | grip | 1.54 | 2.00 |
| GIM3510-8-ds 20 kg floor 20% | 0.0 2.0 3.0 | 1.37 | 1.33 | True | torque | 1.31 | 1.50 |
| GIM3510-8-ds 20 kg floor 20% | 0.0 2.0 5.0 | 1.01 | 0.80 | False | grip | 1.42 | 2.50 |
| GIM3510-8-ds 20 kg floor 20% | 0.0 3.0 3.0 | 2.19 | 2.00 | False | supply | 1.32 | 3.50 |
| GIM3510-8-ds 20 kg floor 20% | 0.0 3.0 5.0 | 1.56 | 1.20 | False | supply | 1.50 | 2.00 |
| GIM3510-8-ds 20 kg floor 20% | 45.0 1.0 3.0 | 0.69 | 0.67 | True | torque | 3.56 | 0.00 |
| GIM3510-8-ds 20 kg floor 20% | 45.0 1.0 5.0 | 0.56 | 0.40 | False | grip | 4.91 | 1.00 |
| GIM3510-8-ds 20 kg floor 20% | 45.0 2.0 3.0 | 1.44 | 1.33 | True | torque | 3.54 | 2.00 |
| GIM3510-8-ds 20 kg floor 20% | 45.0 2.0 5.0 | 1.13 | 0.80 | False | grip | 4.83 | 2.50 |
| GIM3510-8-ds 20 kg floor 20% | 45.0 3.0 3.0 | 2.26 | 2.00 | False | rpm | 3.51 | 3.50 |
| GIM3510-8-ds 20 kg floor 20% | 45.0 3.0 5.0 | 1.79 | 1.20 | False | rpm | 4.31 | 3.50 |
| GIM3510-8-ds 20 kg floor 20% | 90.0 1.0 3.0 | 0.67 | 0.67 | True | ok | 5.17 | 9.50 |
| GIM3510-8-ds 20 kg floor 20% | 90.0 1.0 5.0 | 0.54 | 0.40 | False | grip | 5.22 | 10.50 |
| GIM3510-8-ds 20 kg floor 20% | 90.0 2.0 3.0 | 1.36 | 1.33 | True | torque | 5.17 | 7.00 |
| GIM3510-8-ds 20 kg floor 20% | 90.0 2.0 5.0 | 1.02 | 0.80 | False | supply | 5.55 | 14.50 |
| GIM3510-8-ds 20 kg floor 20% | 90.0 3.0 3.0 | 2.16 | 2.00 | False | supply | 5.17 | 7.50 |
| GIM3510-8-ds 20 kg floor 20% | 90.0 3.0 5.0 | 1.58 | 1.20 | False | supply | 5.69 | 14.00 |
| GIM4305-10-ds 10 kg carpet | 0.0 1.0 3.0 | 0.68 | 0.67 | True | ok | 1.05 | 0.50 |
| GIM4305-10-ds 10 kg carpet | 0.0 1.0 5.0 | 0.42 | 0.40 | True | ok | 0.93 | 2.00 |
| GIM4305-10-ds 10 kg carpet | 0.0 2.0 3.0 | 1.41 | 1.33 | True | rpm | 1.14 | 3.50 |
| GIM4305-10-ds 10 kg carpet | 0.0 2.0 5.0 | 0.91 | 0.80 | False | torque | 1.43 | 18.00 |
| GIM4305-10-ds 10 kg carpet | 0.0 3.0 3.0 | - | 2.00 | False | rpm | 1.68 | 3.50 |
| GIM4305-10-ds 10 kg carpet | 0.0 3.0 5.0 | 2.87 | 1.20 | False | grip | 1.66 | 5.50 |
| GIM4305-10-ds 10 kg carpet | 45.0 1.0 3.0 | 0.71 | 0.67 | True | ok | 2.98 | 3.50 |
| GIM4305-10-ds 10 kg carpet | 45.0 1.0 5.0 | 0.57 | 0.40 | False | grip | 5.13 | 3.50 |
| GIM4305-10-ds 10 kg carpet | 45.0 2.0 3.0 | 1.38 | 1.33 | True | rpm | 3.16 | 10.50 |
| GIM4305-10-ds 10 kg carpet | 45.0 2.0 5.0 | 1.13 | 0.80 | False | grip | 5.44 | 10.50 |
| GIM4305-10-ds 10 kg carpet | 45.0 3.0 3.0 | - | 2.00 | False | rpm | 3.49 | 13.50 |
| GIM4305-10-ds 10 kg carpet | 45.0 3.0 5.0 | - | 1.20 | False | rpm | 5.22 | 11.50 |
| GIM4305-10-ds 10 kg carpet | 90.0 1.0 3.0 | 0.67 | 0.67 | True | grip | 5.26 | 15.50 |
| GIM4305-10-ds 10 kg carpet | 90.0 1.0 5.0 | 0.47 | 0.40 | False | grip | 5.51 | 9.50 |
| GIM4305-10-ds 10 kg carpet | 90.0 2.0 3.0 | 1.46 | 1.33 | True | rpm | 5.20 | 18.50 |
| GIM4305-10-ds 10 kg carpet | 90.0 2.0 5.0 | 0.98 | 0.80 | False | grip | 6.01 | 12.50 |
| GIM4305-10-ds 10 kg carpet | 90.0 3.0 3.0 | 2.24 | 2.00 | False | grip | 5.29 | 15.50 |
| GIM4305-10-ds 10 kg carpet | 90.0 3.0 5.0 | 1.58 | 1.20 | False | grip | 6.48 | 20.00 |
| GIM4305-10-ds 10 kg carpet 20% | 0.0 1.0 3.0 | 0.68 | 0.67 | True | ok | 1.05 | 0.50 |
| GIM4305-10-ds 10 kg carpet 20% | 0.0 1.0 5.0 | 0.42 | 0.40 | True | ok | 0.93 | 2.00 |
| GIM4305-10-ds 10 kg carpet 20% | 0.0 2.0 3.0 | 1.41 | 1.33 | True | rpm | 1.59 | 3.00 |
| GIM4305-10-ds 10 kg carpet 20% | 0.0 2.0 5.0 | 0.91 | 0.80 | False | rpm | 1.33 | 18.00 |
| GIM4305-10-ds 10 kg carpet 20% | 0.0 3.0 3.0 | - | 2.00 | False | grip | 1.78 | 4.00 |
| GIM4305-10-ds 10 kg carpet 20% | 0.0 3.0 5.0 | - | 1.20 | False | grip | 1.73 | 7.00 |
| GIM4305-10-ds 10 kg carpet 20% | 45.0 1.0 3.0 | 0.71 | 0.67 | True | ok | 2.98 | 7.50 |
| GIM4305-10-ds 10 kg carpet 20% | 45.0 1.0 5.0 | 0.56 | 0.40 | False | grip | 5.21 | 4.50 |
| GIM4305-10-ds 10 kg carpet 20% | 45.0 2.0 3.0 | 1.42 | 1.33 | True | rpm | 3.06 | 13.00 |
| GIM4305-10-ds 10 kg carpet 20% | 45.0 2.0 5.0 | 1.17 | 0.80 | False | grip | 5.47 | 9.50 |
| GIM4305-10-ds 10 kg carpet 20% | 45.0 3.0 3.0 | - | 2.00 | False | rpm | 3.25 | 11.50 |
| GIM4305-10-ds 10 kg carpet 20% | 45.0 3.0 5.0 | - | 1.20 | False | rpm | 4.82 | 11.00 |
| GIM4305-10-ds 10 kg carpet 20% | 90.0 1.0 3.0 | 0.67 | 0.67 | True | grip | 5.26 | 15.50 |
| GIM4305-10-ds 10 kg carpet 20% | 90.0 1.0 5.0 | 0.48 | 0.40 | False | grip | 5.51 | 9.50 |
| GIM4305-10-ds 10 kg carpet 20% | 90.0 2.0 3.0 | 1.41 | 1.33 | False | rpm | 5.16 | 13.00 |
| GIM4305-10-ds 10 kg carpet 20% | 90.0 2.0 5.0 | 1.03 | 0.80 | False | grip | 6.10 | 14.00 |
| GIM4305-10-ds 10 kg carpet 20% | 90.0 3.0 3.0 | - | 2.00 | False | grip | 5.32 | 19.00 |
| GIM4305-10-ds 10 kg carpet 20% | 90.0 3.0 5.0 | - | 1.20 | False | grip | 5.96 | 19.00 |
| GIM4305-10-ds 10 kg floor | 0.0 1.0 3.0 | 0.68 | 0.67 | True | ok | 0.76 | 1.00 |
| GIM4305-10-ds 10 kg floor | 0.0 1.0 5.0 | 0.42 | 0.40 | True | ok | 0.67 | 3.50 |
| GIM4305-10-ds 10 kg floor | 0.0 2.0 3.0 | 1.40 | 1.33 | True | ok | 1.03 | 3.00 |
| GIM4305-10-ds 10 kg floor | 0.0 2.0 5.0 | 0.89 | 0.80 | True | torque | 1.05 | 11.50 |
| GIM4305-10-ds 10 kg floor | 0.0 3.0 3.0 | 2.53 | 2.00 | True | rpm | 1.20 | 3.50 |
| GIM4305-10-ds 10 kg floor | 0.0 3.0 5.0 | 1.77 | 1.20 | False | rpm | 1.37 | 8.00 |
| GIM4305-10-ds 10 kg floor | 45.0 1.0 3.0 | 0.70 | 0.67 | True | ok | 3.26 | 8.00 |
| GIM4305-10-ds 10 kg floor | 45.0 1.0 5.0 | 0.58 | 0.40 | False | grip | 5.20 | 6.00 |
| GIM4305-10-ds 10 kg floor | 45.0 2.0 3.0 | 1.45 | 1.33 | True | rpm | 3.31 | 9.00 |
| GIM4305-10-ds 10 kg floor | 45.0 2.0 5.0 | 1.11 | 0.80 | False | grip | 5.01 | 7.50 |
| GIM4305-10-ds 10 kg floor | 45.0 3.0 3.0 | - | 2.00 | False | rpm | 2.93 | 12.00 |
| GIM4305-10-ds 10 kg floor | 45.0 3.0 5.0 | - | 1.20 | False | grip | 5.28 | 9.00 |
| GIM4305-10-ds 10 kg floor | 90.0 1.0 3.0 | 0.67 | 0.67 | True | ok | 5.29 | 10.00 |
| GIM4305-10-ds 10 kg floor | 90.0 1.0 5.0 | 0.46 | 0.40 | False | grip | 5.41 | 13.50 |
| GIM4305-10-ds 10 kg floor | 90.0 2.0 3.0 | 1.41 | 1.33 | True | ok | 5.46 | 8.50 |
| GIM4305-10-ds 10 kg floor | 90.0 2.0 5.0 | 0.95 | 0.80 | False | grip | 5.66 | 12.50 |
| GIM4305-10-ds 10 kg floor | 90.0 3.0 3.0 | 2.22 | 2.00 | False | grip | 5.27 | 7.00 |
| GIM4305-10-ds 10 kg floor | 90.0 3.0 5.0 | 1.54 | 1.20 | False | grip | 5.96 | 14.50 |
| GIM4305-10-ds 10 kg floor 20% | 0.0 1.0 3.0 | 0.68 | 0.67 | True | ok | 0.76 | 1.00 |
| GIM4305-10-ds 10 kg floor 20% | 0.0 1.0 5.0 | 0.42 | 0.40 | True | ok | 0.67 | 3.50 |
| GIM4305-10-ds 10 kg floor 20% | 0.0 2.0 3.0 | 1.39 | 1.33 | True | rpm | 1.03 | 4.50 |
| GIM4305-10-ds 10 kg floor 20% | 0.0 2.0 5.0 | 0.90 | 0.80 | True | rpm | 0.88 | 11.50 |
| GIM4305-10-ds 10 kg floor 20% | 0.0 3.0 3.0 | 3.04 | 2.00 | False | rpm | 1.34 | 3.50 |
| GIM4305-10-ds 10 kg floor 20% | 0.0 3.0 5.0 | 2.15 | 1.20 | False | grip | 1.43 | 7.00 |
| GIM4305-10-ds 10 kg floor 20% | 45.0 1.0 3.0 | 0.70 | 0.67 | True | ok | 3.28 | 8.00 |
| GIM4305-10-ds 10 kg floor 20% | 45.0 1.0 5.0 | 0.56 | 0.40 | False | grip | 5.20 | 4.00 |
| GIM4305-10-ds 10 kg floor 20% | 45.0 2.0 3.0 | 1.48 | 1.33 | False | rpm | 3.52 | 9.50 |
| GIM4305-10-ds 10 kg floor 20% | 45.0 2.0 5.0 | 1.14 | 0.80 | False | grip | 5.04 | 6.00 |
| GIM4305-10-ds 10 kg floor 20% | 45.0 3.0 3.0 | - | 2.00 | False | rpm | 2.80 | 8.00 |
| GIM4305-10-ds 10 kg floor 20% | 45.0 3.0 5.0 | - | 1.20 | False | grip | 5.28 | 10.00 |
| GIM4305-10-ds 10 kg floor 20% | 90.0 1.0 3.0 | 0.67 | 0.67 | True | ok | 5.29 | 10.00 |
| GIM4305-10-ds 10 kg floor 20% | 90.0 1.0 5.0 | 0.46 | 0.40 | False | grip | 5.41 | 13.50 |
| GIM4305-10-ds 10 kg floor 20% | 90.0 2.0 3.0 | 1.41 | 1.33 | True | rpm | 5.36 | 10.50 |
| GIM4305-10-ds 10 kg floor 20% | 90.0 2.0 5.0 | 0.96 | 0.80 | False | grip | 5.70 | 12.00 |
| GIM4305-10-ds 10 kg floor 20% | 90.0 3.0 3.0 | 2.34 | 2.00 | False | rpm | 5.29 | 12.00 |
| GIM4305-10-ds 10 kg floor 20% | 90.0 3.0 5.0 | 2.21 | 1.20 | False | grip | 5.60 | 9.50 |
| GIM4305-10-ds 20 kg carpet | 0.0 1.0 3.0 | 0.66 | 0.67 | True | torque | 1.40 | 0.50 |
| GIM4305-10-ds 20 kg carpet | 0.0 1.0 5.0 | 0.50 | 0.40 | False | grip | 1.61 | 1.00 |
| GIM4305-10-ds 20 kg carpet | 0.0 2.0 3.0 | 1.38 | 1.33 | True | torque | 1.61 | 1.00 |
| GIM4305-10-ds 20 kg carpet | 0.0 2.0 5.0 | 1.08 | 0.80 | False | grip | 1.72 | 2.00 |
| GIM4305-10-ds 20 kg carpet | 0.0 3.0 3.0 | 2.49 | 2.00 | False | grip | 1.57 | 2.00 |
| GIM4305-10-ds 20 kg carpet | 0.0 3.0 5.0 | 1.89 | 1.20 | False | grip | 1.68 | 2.00 |
| GIM4305-10-ds 20 kg carpet | 45.0 1.0 3.0 | 0.69 | 0.67 | True | torque | 3.60 | 1.00 |
| GIM4305-10-ds 20 kg carpet | 45.0 1.0 5.0 | 0.58 | 0.40 | False | grip | 5.19 | 2.00 |
| GIM4305-10-ds 20 kg carpet | 45.0 2.0 3.0 | 1.51 | 1.33 | True | rpm | 3.24 | 3.50 |
| GIM4305-10-ds 20 kg carpet | 45.0 2.0 5.0 | 1.27 | 0.80 | False | grip | 4.85 | 2.00 |
| GIM4305-10-ds 20 kg carpet | 45.0 3.0 3.0 | - | 2.00 | False | rpm | 3.34 | 3.00 |
| GIM4305-10-ds 20 kg carpet | 45.0 3.0 5.0 | - | 1.20 | False | rpm | 4.89 | 3.00 |
| GIM4305-10-ds 20 kg carpet | 90.0 1.0 3.0 | 0.65 | 0.67 | True | torque | 5.25 | 7.00 |
| GIM4305-10-ds 20 kg carpet | 90.0 1.0 5.0 | 0.53 | 0.40 | False | grip | 5.37 | 15.00 |
| GIM4305-10-ds 20 kg carpet | 90.0 2.0 3.0 | 1.36 | 1.33 | False | rpm | 5.32 | 8.00 |
| GIM4305-10-ds 20 kg carpet | 90.0 2.0 5.0 | 1.10 | 0.80 | False | grip | 5.63 | 13.50 |
| GIM4305-10-ds 20 kg carpet | 90.0 3.0 3.0 | 2.74 | 2.00 | False | grip | 5.17 | 12.50 |
| GIM4305-10-ds 20 kg carpet | 90.0 3.0 5.0 | 2.18 | 1.20 | False | grip | 5.64 | 16.00 |
| GIM4305-10-ds 20 kg carpet 20% | 0.0 1.0 3.0 | 0.66 | 0.67 | True | torque | 1.49 | 0.00 |
| GIM4305-10-ds 20 kg carpet 20% | 0.0 1.0 5.0 | 0.50 | 0.40 | False | grip | 1.60 | 1.50 |
| GIM4305-10-ds 20 kg carpet 20% | 0.0 2.0 3.0 | 1.50 | 1.33 | False | rpm | 1.60 | 1.00 |
| GIM4305-10-ds 20 kg carpet 20% | 0.0 2.0 5.0 | 1.08 | 0.80 | False | grip | 1.68 | 2.00 |
| GIM4305-10-ds 20 kg carpet 20% | 0.0 3.0 3.0 | - | 2.00 | False | grip | 1.51 | 1.00 |
| GIM4305-10-ds 20 kg carpet 20% | 0.0 3.0 5.0 | - | 1.20 | False | grip | 1.65 | 1.50 |
| GIM4305-10-ds 20 kg carpet 20% | 45.0 1.0 3.0 | 0.70 | 0.67 | True | torque | 3.71 | 1.50 |
| GIM4305-10-ds 20 kg carpet 20% | 45.0 1.0 5.0 | 0.59 | 0.40 | False | grip | 5.27 | 1.50 |
| GIM4305-10-ds 20 kg carpet 20% | 45.0 2.0 3.0 | 1.82 | 1.33 | False | rpm | 3.43 | 3.50 |
| GIM4305-10-ds 20 kg carpet 20% | 45.0 2.0 5.0 | 1.57 | 0.80 | False | grip | 4.93 | 2.50 |
| GIM4305-10-ds 20 kg carpet 20% | 45.0 3.0 3.0 | - | 2.00 | False | rpm | 3.40 | 3.00 |
| GIM4305-10-ds 20 kg carpet 20% | 45.0 3.0 5.0 | - | 1.20 | False | grip | 4.98 | 2.50 |
| GIM4305-10-ds 20 kg carpet 20% | 90.0 1.0 3.0 | 0.67 | 0.67 | True | torque | 5.21 | 6.00 |
| GIM4305-10-ds 20 kg carpet 20% | 90.0 1.0 5.0 | 0.52 | 0.40 | False | grip | 5.40 | 15.50 |
| GIM4305-10-ds 20 kg carpet 20% | 90.0 2.0 3.0 | 1.45 | 1.33 | False | rpm | 5.46 | 15.50 |
| GIM4305-10-ds 20 kg carpet 20% | 90.0 2.0 5.0 | 1.13 | 0.80 | False | grip | 5.61 | 9.50 |
| GIM4305-10-ds 20 kg carpet 20% | 90.0 3.0 3.0 | - | 2.00 | False | grip | 5.21 | 9.50 |
| GIM4305-10-ds 20 kg carpet 20% | 90.0 3.0 5.0 | - | 1.20 | False | grip | 5.65 | 17.00 |
| GIM4305-10-ds 20 kg floor | 0.0 1.0 3.0 | 0.68 | 0.67 | True | torque | 1.09 | 0.50 |
| GIM4305-10-ds 20 kg floor | 0.0 1.0 5.0 | 0.48 | 0.40 | False | grip | 1.41 | 1.50 |
| GIM4305-10-ds 20 kg floor | 0.0 2.0 3.0 | 1.39 | 1.33 | True | torque | 1.29 | 2.00 |
| GIM4305-10-ds 20 kg floor | 0.0 2.0 5.0 | 1.00 | 0.80 | False | grip | 1.53 | 2.50 |
| GIM4305-10-ds 20 kg floor | 0.0 3.0 3.0 | 2.26 | 2.00 | False | grip | 1.33 | 2.00 |
| GIM4305-10-ds 20 kg floor | 0.0 3.0 5.0 | 1.68 | 1.20 | False | grip | 1.58 | 4.50 |
| GIM4305-10-ds 20 kg floor | 45.0 1.0 3.0 | 0.69 | 0.67 | True | torque | 3.53 | 2.00 |
| GIM4305-10-ds 20 kg floor | 45.0 1.0 5.0 | 0.56 | 0.40 | False | grip | 4.83 | 1.00 |
| GIM4305-10-ds 20 kg floor | 45.0 2.0 3.0 | 1.52 | 1.33 | False | rpm | 3.49 | 1.50 |
| GIM4305-10-ds 20 kg floor | 45.0 2.0 5.0 | 1.21 | 0.80 | False | grip | 4.63 | 2.50 |
| GIM4305-10-ds 20 kg floor | 45.0 3.0 3.0 | - | 2.00 | False | rpm | 3.28 | 5.50 |
| GIM4305-10-ds 20 kg floor | 45.0 3.0 5.0 | - | 1.20 | False | grip | 4.50 | 4.00 |
| GIM4305-10-ds 20 kg floor | 90.0 1.0 3.0 | 0.66 | 0.67 | True | ok | 5.16 | 9.00 |
| GIM4305-10-ds 20 kg floor | 90.0 1.0 5.0 | 0.52 | 0.40 | False | grip | 5.42 | 10.50 |
| GIM4305-10-ds 20 kg floor | 90.0 2.0 3.0 | 1.39 | 1.33 | True | torque | 5.20 | 7.50 |
| GIM4305-10-ds 20 kg floor | 90.0 2.0 5.0 | 1.03 | 0.80 | False | grip | 5.56 | 10.00 |
| GIM4305-10-ds 20 kg floor | 90.0 3.0 3.0 | 2.34 | 2.00 | False | grip | 5.27 | 6.00 |
| GIM4305-10-ds 20 kg floor | 90.0 3.0 5.0 | 1.90 | 1.20 | False | grip | 5.78 | 11.00 |
| GIM4305-10-ds 20 kg floor 20% | 0.0 1.0 3.0 | 0.68 | 0.67 | True | torque | 1.09 | 0.50 |
| GIM4305-10-ds 20 kg floor 20% | 0.0 1.0 5.0 | 0.49 | 0.40 | False | grip | 1.46 | 1.50 |
| GIM4305-10-ds 20 kg floor 20% | 0.0 2.0 3.0 | 1.38 | 1.33 | True | rpm | 1.28 | 1.50 |
| GIM4305-10-ds 20 kg floor 20% | 0.0 2.0 5.0 | 1.02 | 0.80 | False | grip | 1.73 | 2.00 |
| GIM4305-10-ds 20 kg floor 20% | 0.0 3.0 3.0 | 2.56 | 2.00 | False | rpm | 1.34 | 1.50 |
| GIM4305-10-ds 20 kg floor 20% | 0.0 3.0 5.0 | 1.99 | 1.20 | False | grip | 1.60 | 3.00 |
| GIM4305-10-ds 20 kg floor 20% | 45.0 1.0 3.0 | 0.69 | 0.67 | True | torque | 3.49 | 0.50 |
| GIM4305-10-ds 20 kg floor 20% | 45.0 1.0 5.0 | 0.56 | 0.40 | False | grip | 4.84 | 1.50 |
| GIM4305-10-ds 20 kg floor 20% | 45.0 2.0 3.0 | 1.66 | 1.33 | False | rpm | 3.58 | 1.50 |
| GIM4305-10-ds 20 kg floor 20% | 45.0 2.0 5.0 | 1.40 | 0.80 | False | grip | 4.71 | 2.50 |
| GIM4305-10-ds 20 kg floor 20% | 45.0 3.0 3.0 | - | 2.00 | False | rpm | 3.23 | 1.50 |
| GIM4305-10-ds 20 kg floor 20% | 45.0 3.0 5.0 | - | 1.20 | False | grip | 4.70 | 2.50 |
| GIM4305-10-ds 20 kg floor 20% | 90.0 1.0 3.0 | 0.66 | 0.67 | True | ok | 5.17 | 11.00 |
| GIM4305-10-ds 20 kg floor 20% | 90.0 1.0 5.0 | 0.53 | 0.40 | False | grip | 5.48 | 10.00 |
| GIM4305-10-ds 20 kg floor 20% | 90.0 2.0 3.0 | 1.40 | 1.33 | True | rpm | 5.29 | 9.50 |
| GIM4305-10-ds 20 kg floor 20% | 90.0 2.0 5.0 | 1.07 | 0.80 | False | grip | 5.51 | 5.50 |
| GIM4305-10-ds 20 kg floor 20% | 90.0 3.0 3.0 | 2.83 | 2.00 | False | grip | 5.16 | 11.00 |
| GIM4305-10-ds 20 kg floor 20% | 90.0 3.0 5.0 | 2.80 | 1.20 | False | grip | 5.92 | 9.00 |
| M2006-ds 10 kg carpet | 0.0 1.0 3.0 | 0.71 | 0.67 | True | torque | 1.59 | 1.00 |
| M2006-ds 10 kg carpet | 0.0 1.0 5.0 | 0.52 | 0.40 | False | torque | 1.74 | 2.00 |
| M2006-ds 10 kg carpet | 0.0 2.0 3.0 | 1.46 | 1.33 | True | torque | 1.48 | 3.00 |
| M2006-ds 10 kg carpet | 0.0 2.0 5.0 | 1.06 | 0.80 | False | torque | 1.75 | 4.00 |
| M2006-ds 10 kg carpet | 0.0 3.0 3.0 | 2.38 | 2.00 | False | grip | 1.64 | 4.00 |
| M2006-ds 10 kg carpet | 0.0 3.0 5.0 | 1.72 | 1.20 | False | grip | 1.65 | 4.50 |
| M2006-ds 10 kg carpet | 45.0 1.0 3.0 | 0.70 | 0.67 | True | torque | 3.11 | 6.50 |
| M2006-ds 10 kg carpet | 45.0 1.0 5.0 | 0.61 | 0.40 | False | grip | 5.23 | 3.50 |
| M2006-ds 10 kg carpet | 45.0 2.0 3.0 | 1.40 | 1.33 | True | torque | 3.39 | 4.50 |
| M2006-ds 10 kg carpet | 45.0 2.0 5.0 | 1.15 | 0.80 | False | grip | 5.13 | 5.50 |
| M2006-ds 10 kg carpet | 45.0 3.0 3.0 | 2.10 | 2.00 | True | torque | 4.16 | 7.00 |
| M2006-ds 10 kg carpet | 45.0 3.0 5.0 | 1.70 | 1.20 | False | torque | 5.10 | 4.50 |
| M2006-ds 10 kg carpet | 90.0 1.0 3.0 | 0.69 | 0.67 | True | torque | 5.22 | 16.50 |
| M2006-ds 10 kg carpet | 90.0 1.0 5.0 | 0.55 | 0.40 | False | grip | 5.46 | 22.50 |
| M2006-ds 10 kg carpet | 90.0 2.0 3.0 | 1.46 | 1.33 | False | torque | 5.42 | 21.00 |
| M2006-ds 10 kg carpet | 90.0 2.0 5.0 | 1.07 | 0.80 | False | grip | 5.55 | 13.00 |
| M2006-ds 10 kg carpet | 90.0 3.0 3.0 | 2.20 | 2.00 | False | grip | 5.32 | 14.00 |
| M2006-ds 10 kg carpet | 90.0 3.0 5.0 | 1.65 | 1.20 | False | grip | 5.58 | 20.00 |
| M2006-ds 10 kg carpet 20% | 0.0 1.0 3.0 | 0.71 | 0.67 | True | torque | 1.59 | 1.00 |
| M2006-ds 10 kg carpet 20% | 0.0 1.0 5.0 | 0.52 | 0.40 | False | torque | 1.74 | 2.00 |
| M2006-ds 10 kg carpet 20% | 0.0 2.0 3.0 | 1.46 | 1.33 | True | torque | 1.48 | 3.00 |
| M2006-ds 10 kg carpet 20% | 0.0 2.0 5.0 | 1.06 | 0.80 | False | torque | 1.75 | 4.00 |
| M2006-ds 10 kg carpet 20% | 0.0 3.0 3.0 | 2.74 | 2.00 | False | grip | 1.67 | 4.00 |
| M2006-ds 10 kg carpet 20% | 0.0 3.0 5.0 | 1.68 | 1.20 | False | grip | 1.65 | 7.50 |
| M2006-ds 10 kg carpet 20% | 45.0 1.0 3.0 | 0.70 | 0.67 | True | torque | 3.11 | 6.50 |
| M2006-ds 10 kg carpet 20% | 45.0 1.0 5.0 | 0.61 | 0.40 | False | grip | 5.23 | 3.50 |
| M2006-ds 10 kg carpet 20% | 45.0 2.0 3.0 | 1.40 | 1.33 | True | torque | 3.39 | 4.50 |
| M2006-ds 10 kg carpet 20% | 45.0 2.0 5.0 | 1.15 | 0.80 | False | grip | 5.13 | 5.50 |
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
| M2006-ds 20 kg floor | 0.0 2.0 5.0 | 1.40 | 0.80 | False | grip | 1.82 | 2.00 |
| M2006-ds 20 kg floor | 0.0 3.0 3.0 | 2.29 | 2.00 | False | grip | 1.32 | 2.00 |
| M2006-ds 20 kg floor | 0.0 3.0 5.0 | 2.09 | 1.20 | False | grip | 1.38 | 2.00 |
| M2006-ds 20 kg floor | 45.0 1.0 3.0 | 0.94 | 0.67 | False | torque | 3.83 | 0.50 |
| M2006-ds 20 kg floor | 45.0 1.0 5.0 | 0.92 | 0.40 | False | torque | 3.91 | 0.50 |
| M2006-ds 20 kg floor | 45.0 2.0 3.0 | 1.88 | 1.33 | False | torque | 3.11 | 2.00 |
| M2006-ds 20 kg floor | 45.0 2.0 5.0 | 1.86 | 0.80 | False | torque | 3.54 | 3.50 |
| M2006-ds 20 kg floor | 45.0 3.0 3.0 | 2.96 | 2.00 | False | torque | 2.97 | 3.00 |
| M2006-ds 20 kg floor | 45.0 3.0 5.0 | 2.80 | 1.20 | False | torque | 3.88 | 3.50 |
| M2006-ds 20 kg floor | 90.0 1.0 3.0 | 0.77 | 0.67 | True | torque | 4.56 | 4.50 |
| M2006-ds 20 kg floor | 90.0 1.0 5.0 | 0.75 | 0.40 | False | grip | 4.84 | 4.00 |
| M2006-ds 20 kg floor | 90.0 2.0 3.0 | 1.57 | 1.33 | False | torque | 4.57 | 4.00 |
| M2006-ds 20 kg floor | 90.0 2.0 5.0 | 1.48 | 0.80 | False | grip | 4.90 | 4.50 |
| M2006-ds 20 kg floor | 90.0 3.0 3.0 | 2.52 | 2.00 | False | grip | 4.44 | 5.00 |
| M2006-ds 20 kg floor | 90.0 3.0 5.0 | 2.25 | 1.20 | False | grip | 5.08 | 4.00 |
| M2006-ds 20 kg floor 20% | 0.0 1.0 3.0 | 0.73 | 0.67 | True | torque | 1.31 | 0.50 |
| M2006-ds 20 kg floor 20% | 0.0 1.0 5.0 | 0.66 | 0.40 | False | torque | 1.35 | 1.50 |
| M2006-ds 20 kg floor 20% | 0.0 2.0 3.0 | 1.47 | 1.33 | False | torque | 1.19 | 1.00 |
| M2006-ds 20 kg floor 20% | 0.0 2.0 5.0 | 1.40 | 0.80 | False | grip | 1.82 | 2.00 |
| M2006-ds 20 kg floor 20% | 0.0 3.0 3.0 | 2.27 | 2.00 | False | grip | 1.32 | 1.50 |
| M2006-ds 20 kg floor 20% | 0.0 3.0 5.0 | 2.05 | 1.20 | False | grip | 1.23 | 2.00 |
| M2006-ds 20 kg floor 20% | 45.0 1.0 3.0 | 0.94 | 0.67 | False | torque | 3.83 | 0.50 |
| M2006-ds 20 kg floor 20% | 45.0 1.0 5.0 | 0.92 | 0.40 | False | torque | 3.91 | 0.50 |
| M2006-ds 20 kg floor 20% | 45.0 2.0 3.0 | 1.88 | 1.33 | False | torque | 3.11 | 2.00 |
| M2006-ds 20 kg floor 20% | 45.0 2.0 5.0 | 1.86 | 0.80 | False | torque | 3.54 | 3.50 |
| M2006-ds 20 kg floor 20% | 45.0 3.0 3.0 | 3.88 | 2.00 | False | torque | 2.93 | 2.00 |
| M2006-ds 20 kg floor 20% | 45.0 3.0 5.0 | - | 1.20 | False | torque | 3.98 | 4.50 |
| M2006-ds 20 kg floor 20% | 90.0 1.0 3.0 | 0.77 | 0.67 | True | torque | 4.56 | 4.50 |
| M2006-ds 20 kg floor 20% | 90.0 1.0 5.0 | 0.75 | 0.40 | False | grip | 4.84 | 4.00 |
| M2006-ds 20 kg floor 20% | 90.0 2.0 3.0 | 1.57 | 1.33 | False | torque | 4.57 | 4.00 |
| M2006-ds 20 kg floor 20% | 90.0 2.0 5.0 | 1.48 | 0.80 | False | grip | 4.90 | 4.50 |
| M2006-ds 20 kg floor 20% | 90.0 3.0 3.0 | 2.41 | 2.00 | False | grip | 4.38 | 5.00 |
| M2006-ds 20 kg floor 20% | 90.0 3.0 5.0 | 2.22 | 1.20 | False | grip | 4.89 | 6.00 |

### turn

| robot | args | t_turn | t_ideal | ok | cause | track_max | lift_ms |
| --- | --- | --- | --- | --- | --- | --- | --- |
| AK40-10 10 kg carpet | 1.0 45.0 3.0 | 0.32 | 0.26 | True | grip | 0.24 | 8.00 |
| AK40-10 10 kg carpet | 1.0 45.0 5.0 | 0.25 | 0.15 | False | grip | 0.40 | 13.50 |
| AK40-10 10 kg carpet | 1.0 90.0 3.0 | 0.48 | 0.47 | True | ok | 0.17 | 11.50 |
| AK40-10 10 kg carpet | 1.0 90.0 5.0 | 0.39 | 0.28 | False | grip | 0.46 | 14.50 |
| AK40-10 10 kg carpet | 1.0 135.0 3.0 | 0.66 | 0.62 | True | ok | 0.14 | 2.00 |
| AK40-10 10 kg carpet | 1.0 135.0 5.0 | 0.51 | 0.37 | False | wheel-hop | 0.52 | 3.50 |
| AK40-10 10 kg carpet | 2.0 45.0 3.0 | 0.52 | 0.51 | False | wheel-hop | 0.44 | 13.50 |
| AK40-10 10 kg carpet | 2.0 45.0 5.0 | 0.40 | 0.31 | False | grip | 0.68 | 10.00 |
| AK40-10 10 kg carpet | 2.0 90.0 3.0 | 1.07 | 0.94 | False | wheel-hop | 0.42 | 14.00 |
| AK40-10 10 kg carpet | 2.0 90.0 5.0 | 0.82 | 0.57 | False | grip | 0.81 | 11.50 |
| AK40-10 10 kg carpet | 2.0 135.0 3.0 | 1.27 | 1.23 | True | ok | 0.29 | 9.00 |
| AK40-10 10 kg carpet | 2.0 135.0 5.0 | 1.02 | 0.74 | False | torque | 0.95 | 6.50 |
| AK40-10 10 kg carpet | 3.0 45.0 3.0 | 0.82 | 0.77 | False | grip | 0.66 | 11.50 |
| AK40-10 10 kg carpet | 3.0 45.0 5.0 | 0.64 | 0.46 | False | grip | 0.88 | 12.00 |
| AK40-10 10 kg carpet | 3.0 90.0 3.0 | 1.62 | 1.41 | False | grip | 0.66 | 13.50 |
| AK40-10 10 kg carpet | 3.0 90.0 5.0 | 1.29 | 0.85 | False | grip | 1.30 | 10.00 |
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
| AK40-10 20hi kg carpet 20% | 1.0 45.0 3.0 | 0.37 | 0.26 | False | grip | 0.30 | 18.50 |
| AK40-10 20hi kg carpet 20% | 1.0 45.0 5.0 | 0.28 | 0.15 | False | grip | 0.37 | 18.00 |
| AK40-10 20hi kg carpet 20% | 1.0 90.0 3.0 | 0.47 | 0.47 | True | ok | 0.21 | 20.00 |
| AK40-10 20hi kg carpet 20% | 1.0 90.0 5.0 | 0.49 | 0.28 | False | grip | 0.55 | 7.00 |
| AK40-10 20hi kg carpet 20% | 1.0 135.0 3.0 | 0.65 | 0.62 | True | torque | 0.14 | 9.50 |
| AK40-10 20hi kg carpet 20% | 1.0 135.0 5.0 | 0.52 | 0.37 | False | torque | 0.51 | 3.50 |
| AK40-10 20hi kg carpet 20% | 2.0 45.0 3.0 | 0.66 | 0.51 | False | rpm | 0.52 | 13.00 |
| AK40-10 20hi kg carpet 20% | 2.0 45.0 5.0 | 0.60 | 0.31 | False | grip | 0.84 | 14.00 |
| AK40-10 20hi kg carpet 20% | 2.0 90.0 3.0 | 1.03 | 0.94 | False | rpm | 0.40 | 19.50 |
| AK40-10 20hi kg carpet 20% | 2.0 90.0 5.0 | 0.79 | 0.57 | False | grip | 0.88 | 14.50 |
| AK40-10 20hi kg carpet 20% | 2.0 135.0 3.0 | 1.30 | 1.23 | True | rpm | 0.30 | 18.00 |
| AK40-10 20hi kg carpet 20% | 2.0 135.0 5.0 | 1.12 | 0.74 | False | grip | 0.94 | 7.50 |
| AK40-10 20hi kg carpet 20% | 3.0 45.0 3.0 | - | 0.77 | False | rpm | 0.81 | 12.00 |
| AK40-10 20hi kg carpet 20% | 3.0 45.0 5.0 | - | 0.46 | False | grip | 1.01 | 11.50 |
| AK40-10 20hi kg carpet 20% | 3.0 90.0 3.0 | 1.71 | 1.41 | False | grip | 0.67 | 12.00 |
| AK40-10 20hi kg carpet 20% | 3.0 90.0 5.0 | 1.43 | 0.85 | False | grip | 1.33 | 13.50 |
| AK40-10 20hi kg carpet 20% | 3.0 135.0 3.0 | - | 1.85 | False | rpm | 0.71 | 14.00 |
| AK40-10 20hi kg carpet 20% | 3.0 135.0 5.0 | - | 1.11 | False | grip | 1.19 | 14.00 |
| AK40-10 20hi kg floor | 1.0 45.0 3.0 | 0.33 | 0.26 | True | grip | 0.27 | 7.50 |
| AK40-10 20hi kg floor | 1.0 45.0 5.0 | 0.26 | 0.15 | False | grip | 0.36 | 8.00 |
| AK40-10 20hi kg floor | 1.0 90.0 3.0 | 0.47 | 0.47 | True | ok | 0.18 | 8.00 |
| AK40-10 20hi kg floor | 1.0 90.0 5.0 | 0.50 | 0.28 | False | grip | 0.53 | 10.00 |
| AK40-10 20hi kg floor | 1.0 135.0 3.0 | 0.65 | 0.62 | True | torque | 0.14 | 7.50 |
| AK40-10 20hi kg floor | 1.0 135.0 5.0 | 0.51 | 0.37 | False | torque | 0.48 | 4.00 |
| AK40-10 20hi kg floor | 2.0 45.0 3.0 | 0.63 | 0.51 | False | rpm | 0.46 | 8.00 |
| AK40-10 20hi kg floor | 2.0 45.0 5.0 | 0.45 | 0.31 | False | grip | 0.88 | 7.50 |
| AK40-10 20hi kg floor | 2.0 90.0 3.0 | 1.01 | 0.94 | False | torque | 0.37 | 10.00 |
| AK40-10 20hi kg floor | 2.0 90.0 5.0 | 0.85 | 0.57 | False | grip | 0.97 | 8.50 |
| AK40-10 20hi kg floor | 2.0 135.0 3.0 | 1.31 | 1.23 | True | torque | 0.30 | 6.50 |
| AK40-10 20hi kg floor | 2.0 135.0 5.0 | 1.05 | 0.74 | False | grip | 0.91 | 4.00 |
| AK40-10 20hi kg floor | 3.0 45.0 3.0 | 1.07 | 0.77 | False | rpm | 0.64 | 5.50 |
| AK40-10 20hi kg floor | 3.0 45.0 5.0 | 0.84 | 0.46 | False | grip | 1.03 | 6.00 |
| AK40-10 20hi kg floor | 3.0 90.0 3.0 | 1.60 | 1.41 | False | grip | 0.63 | 6.50 |
| AK40-10 20hi kg floor | 3.0 90.0 5.0 | 1.33 | 0.85 | False | grip | 1.29 | 7.00 |
| AK40-10 20hi kg floor | 3.0 135.0 3.0 | 2.14 | 1.85 | False | rpm | 0.54 | 7.50 |
| AK40-10 20hi kg floor | 3.0 135.0 5.0 | 1.55 | 1.11 | False | grip | 1.09 | 6.50 |
| AK40-10 20hi kg floor 20% | 1.0 45.0 3.0 | 0.33 | 0.26 | True | grip | 0.27 | 7.50 |
| AK40-10 20hi kg floor 20% | 1.0 45.0 5.0 | 0.26 | 0.15 | False | grip | 0.36 | 8.00 |
| AK40-10 20hi kg floor 20% | 1.0 90.0 3.0 | 0.47 | 0.47 | True | ok | 0.18 | 8.00 |
| AK40-10 20hi kg floor 20% | 1.0 90.0 5.0 | 0.50 | 0.28 | False | grip | 0.53 | 10.00 |
| AK40-10 20hi kg floor 20% | 1.0 135.0 3.0 | 0.65 | 0.62 | True | torque | 0.14 | 7.50 |
| AK40-10 20hi kg floor 20% | 1.0 135.0 5.0 | 0.51 | 0.37 | False | torque | 0.48 | 4.00 |
| AK40-10 20hi kg floor 20% | 2.0 45.0 3.0 | 0.66 | 0.51 | False | rpm | 0.45 | 6.00 |
| AK40-10 20hi kg floor 20% | 2.0 45.0 5.0 | 0.51 | 0.31 | False | grip | 0.79 | 8.50 |
| AK40-10 20hi kg floor 20% | 2.0 90.0 3.0 | 1.01 | 0.94 | True | rpm | 0.33 | 6.00 |
| AK40-10 20hi kg floor 20% | 2.0 90.0 5.0 | 0.85 | 0.57 | False | grip | 0.94 | 8.00 |
| AK40-10 20hi kg floor 20% | 2.0 135.0 3.0 | 1.33 | 1.23 | True | rpm | 0.34 | 6.00 |
| AK40-10 20hi kg floor 20% | 2.0 135.0 5.0 | 0.99 | 0.74 | False | grip | 0.80 | 5.50 |
| AK40-10 20hi kg floor 20% | 3.0 45.0 3.0 | - | 0.77 | False | rpm | 0.78 | 5.50 |
| AK40-10 20hi kg floor 20% | 3.0 45.0 5.0 | - | 0.46 | False | grip | 1.05 | 9.00 |
| AK40-10 20hi kg floor 20% | 3.0 90.0 3.0 | 1.62 | 1.41 | False | grip | 0.65 | 6.00 |
| AK40-10 20hi kg floor 20% | 3.0 90.0 5.0 | 1.44 | 0.85 | False | grip | 1.25 | 6.00 |
| AK40-10 20hi kg floor 20% | 3.0 135.0 3.0 | 3.31 | 1.85 | False | rpm | 0.69 | 5.50 |
| AK40-10 20hi kg floor 20% | 3.0 135.0 5.0 | 2.57 | 1.11 | False | grip | 1.20 | 5.50 |
| AK40-10-ds 10 kg carpet | 1.0 45.0 3.0 | 0.31 | 0.26 | True | grip | 0.27 | 14.50 |
| AK40-10-ds 10 kg carpet | 1.0 45.0 5.0 | 0.23 | 0.15 | False | grip | 0.42 | 14.50 |
| AK40-10-ds 10 kg carpet | 1.0 90.0 3.0 | 0.48 | 0.47 | True | ok | 0.18 | 11.00 |
| AK40-10-ds 10 kg carpet | 1.0 90.0 5.0 | 0.41 | 0.28 | False | grip | 0.45 | 14.00 |
| AK40-10-ds 10 kg carpet | 1.0 135.0 3.0 | 0.65 | 0.62 | True | ok | 0.15 | 2.00 |
| AK40-10-ds 10 kg carpet | 1.0 135.0 5.0 | 0.52 | 0.37 | False | wheel-hop | 0.53 | 3.00 |
| AK40-10-ds 10 kg carpet | 2.0 45.0 3.0 | 0.54 | 0.51 | False | wheel-hop | 0.55 | 10.50 |
| AK40-10-ds 10 kg carpet | 2.0 45.0 5.0 | 0.42 | 0.31 | False | grip | 0.63 | 11.00 |
| AK40-10-ds 10 kg carpet | 2.0 90.0 3.0 | 1.17 | 0.94 | False | torque | 0.43 | 16.00 |
| AK40-10-ds 10 kg carpet | 2.0 90.0 5.0 | 0.79 | 0.57 | False | grip | 0.75 | 12.00 |
| AK40-10-ds 10 kg carpet | 2.0 135.0 3.0 | 1.27 | 1.23 | True | torque | 0.30 | 9.50 |
| AK40-10-ds 10 kg carpet | 2.0 135.0 5.0 | 1.02 | 0.74 | False | grip | 0.96 | 6.50 |
| AK40-10-ds 10 kg carpet | 3.0 45.0 3.0 | 0.84 | 0.77 | False | rpm | 0.57 | 11.00 |
| AK40-10-ds 10 kg carpet | 3.0 45.0 5.0 | 0.73 | 0.46 | False | grip | 0.99 | 10.50 |
| AK40-10-ds 10 kg carpet | 3.0 90.0 3.0 | 1.63 | 1.41 | False | grip | 0.71 | 10.50 |
| AK40-10-ds 10 kg carpet | 3.0 90.0 5.0 | 1.27 | 0.85 | False | grip | 1.30 | 11.50 |
| AK40-10-ds 10 kg carpet | 3.0 135.0 3.0 | 1.91 | 1.85 | False | grip | 0.42 | 10.00 |
| AK40-10-ds 10 kg carpet | 3.0 135.0 5.0 | 1.54 | 1.11 | False | rpm | 1.32 | 10.50 |
| AK40-10-ds 10 kg carpet 20% | 1.0 45.0 3.0 | 0.31 | 0.26 | True | grip | 0.27 | 14.50 |
| AK40-10-ds 10 kg carpet 20% | 1.0 45.0 5.0 | 0.23 | 0.15 | False | grip | 0.42 | 14.50 |
| AK40-10-ds 10 kg carpet 20% | 1.0 90.0 3.0 | 0.48 | 0.47 | True | ok | 0.18 | 11.00 |
| AK40-10-ds 10 kg carpet 20% | 1.0 90.0 5.0 | 0.41 | 0.28 | False | grip | 0.45 | 14.00 |
| AK40-10-ds 10 kg carpet 20% | 1.0 135.0 3.0 | 0.65 | 0.62 | True | ok | 0.15 | 2.00 |
| AK40-10-ds 10 kg carpet 20% | 1.0 135.0 5.0 | 0.52 | 0.37 | False | wheel-hop | 0.53 | 3.00 |
| AK40-10-ds 10 kg carpet 20% | 2.0 45.0 3.0 | 0.52 | 0.51 | False | wheel-hop | 0.46 | 7.50 |
| AK40-10-ds 10 kg carpet 20% | 2.0 45.0 5.0 | 0.43 | 0.31 | False | grip | 0.69 | 15.50 |
| AK40-10-ds 10 kg carpet 20% | 2.0 90.0 3.0 | 1.12 | 0.94 | False | wheel-hop | 0.43 | 14.00 |
| AK40-10-ds 10 kg carpet 20% | 2.0 90.0 5.0 | 0.89 | 0.57 | False | grip | 0.85 | 13.00 |
| AK40-10-ds 10 kg carpet 20% | 2.0 135.0 3.0 | 1.28 | 1.23 | True | ok | 0.32 | 11.00 |
| AK40-10-ds 10 kg carpet 20% | 2.0 135.0 5.0 | 1.06 | 0.74 | False | torque | 1.00 | 10.00 |
| AK40-10-ds 10 kg carpet 20% | 3.0 45.0 3.0 | - | 0.77 | False | grip | 0.60 | 12.50 |
| AK40-10-ds 10 kg carpet 20% | 3.0 45.0 5.0 | - | 0.46 | False | grip | 0.91 | 14.50 |
| AK40-10-ds 10 kg carpet 20% | 3.0 90.0 3.0 | 1.63 | 1.41 | False | grip | 0.67 | 13.00 |
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
| DM-2325-low-ds 20 kg floor | 3.0 90.0 5.0 | 1.83 | 0.85 | False | grip | 1.84 | 6.00 |
| DM-2325-low-ds 20 kg floor | 3.0 135.0 3.0 | 2.47 | 1.85 | False | torque | 0.91 | 2.00 |
| DM-2325-low-ds 20 kg floor | 3.0 135.0 5.0 | 2.29 | 1.11 | False | grip | 1.92 | 2.50 |
| DM-2325-low-ds 20 kg floor 20% | 1.0 45.0 3.0 | 0.36 | 0.26 | True | torque | 0.25 | 3.00 |
| DM-2325-low-ds 20 kg floor 20% | 1.0 45.0 5.0 | 0.32 | 0.15 | False | grip | 0.39 | 2.50 |
| DM-2325-low-ds 20 kg floor 20% | 1.0 90.0 3.0 | 0.60 | 0.47 | False | torque | 0.33 | 2.00 |
| DM-2325-low-ds 20 kg floor 20% | 1.0 90.0 5.0 | 0.61 | 0.28 | False | grip | 0.74 | 3.00 |
| DM-2325-low-ds 20 kg floor 20% | 1.0 135.0 3.0 | 0.73 | 0.62 | True | torque | 0.29 | 1.00 |
| DM-2325-low-ds 20 kg floor 20% | 1.0 135.0 5.0 | 0.70 | 0.37 | False | torque | 0.71 | 1.00 |
| DM-2325-low-ds 20 kg floor 20% | 2.0 45.0 3.0 | 0.68 | 0.51 | False | torque | 0.39 | 4.50 |
| DM-2325-low-ds 20 kg floor 20% | 2.0 45.0 5.0 | 0.63 | 0.31 | False | torque | 0.76 | 4.00 |
| DM-2325-low-ds 20 kg floor 20% | 2.0 90.0 3.0 | 1.19 | 0.94 | False | torque | 0.61 | 4.00 |
| DM-2325-low-ds 20 kg floor 20% | 2.0 90.0 5.0 | 1.16 | 0.57 | False | torque | 1.24 | 3.50 |
| DM-2325-low-ds 20 kg floor 20% | 2.0 135.0 3.0 | 1.47 | 1.23 | False | torque | 0.54 | 1.50 |
| DM-2325-low-ds 20 kg floor 20% | 2.0 135.0 5.0 | 1.43 | 0.74 | False | torque | 1.37 | 3.00 |
| DM-2325-low-ds 20 kg floor 20% | 3.0 45.0 3.0 | 1.36 | 0.77 | False | rpm | 0.62 | 3.50 |
| DM-2325-low-ds 20 kg floor 20% | 3.0 45.0 5.0 | 1.30 | 0.46 | False | rpm | 1.09 | 4.00 |
| DM-2325-low-ds 20 kg floor 20% | 3.0 90.0 3.0 | 2.05 | 1.41 | False | grip | 0.99 | 3.50 |
| DM-2325-low-ds 20 kg floor 20% | 3.0 90.0 5.0 | 1.90 | 0.85 | False | grip | 1.86 | 5.00 |
| DM-2325-low-ds 20 kg floor 20% | 3.0 135.0 3.0 | 3.20 | 1.85 | False | rpm | 0.99 | 1.50 |
| DM-2325-low-ds 20 kg floor 20% | 3.0 135.0 5.0 | 3.04 | 1.11 | False | grip | 2.01 | 2.50 |
| DM-J3507-ds 10 kg carpet | 1.0 45.0 3.0 | 0.34 | 0.26 | True | grip | 0.26 | 11.00 |
| DM-J3507-ds 10 kg carpet | 1.0 45.0 5.0 | 0.26 | 0.15 | False | grip | 0.40 | 19.00 |
| DM-J3507-ds 10 kg carpet | 1.0 90.0 3.0 | 0.48 | 0.47 | True | ok | 0.19 | 19.00 |
| DM-J3507-ds 10 kg carpet | 1.0 90.0 5.0 | 0.42 | 0.28 | False | grip | 0.45 | 21.00 |
| DM-J3507-ds 10 kg carpet | 1.0 135.0 3.0 | 0.65 | 0.62 | True | ok | 0.14 | 2.00 |
| DM-J3507-ds 10 kg carpet | 1.0 135.0 5.0 | 0.53 | 0.37 | False | torque | 0.52 | 2.50 |
| DM-J3507-ds 10 kg carpet | 2.0 45.0 3.0 | 0.56 | 0.51 | False | rpm | 0.46 | 12.00 |
| DM-J3507-ds 10 kg carpet | 2.0 45.0 5.0 | 0.44 | 0.31 | False | grip | 0.75 | 10.50 |
| DM-J3507-ds 10 kg carpet | 2.0 90.0 3.0 | 1.18 | 0.94 | False | rpm | 0.45 | 15.50 |
| DM-J3507-ds 10 kg carpet | 2.0 90.0 5.0 | 0.89 | 0.57 | False | grip | 0.90 | 12.50 |
| DM-J3507-ds 10 kg carpet | 2.0 135.0 3.0 | 1.29 | 1.23 | True | rpm | 0.30 | 12.00 |
| DM-J3507-ds 10 kg carpet | 2.0 135.0 5.0 | 1.04 | 0.74 | False | rpm | 0.99 | 5.50 |
| DM-J3507-ds 10 kg carpet | 3.0 45.0 3.0 | 1.11 | 0.77 | False | grip | 0.67 | 11.00 |
| DM-J3507-ds 10 kg carpet | 3.0 45.0 5.0 | 0.92 | 0.46 | False | grip | 0.99 | 9.00 |
| DM-J3507-ds 10 kg carpet | 3.0 90.0 3.0 | 1.68 | 1.41 | False | grip | 0.74 | 10.00 |
| DM-J3507-ds 10 kg carpet | 3.0 90.0 5.0 | 1.37 | 0.85 | False | grip | 1.33 | 9.50 |
| DM-J3507-ds 10 kg carpet | 3.0 135.0 3.0 | 2.12 | 1.85 | False | rpm | 0.45 | 8.00 |
| DM-J3507-ds 10 kg carpet | 3.0 135.0 5.0 | 1.80 | 1.11 | False | rpm | 1.40 | 7.00 |
| DM-J3507-ds 10 kg carpet 20% | 1.0 45.0 3.0 | 0.33 | 0.26 | True | grip | 0.26 | 10.00 |
| DM-J3507-ds 10 kg carpet 20% | 1.0 45.0 5.0 | 0.26 | 0.15 | False | grip | 0.41 | 18.00 |
| DM-J3507-ds 10 kg carpet 20% | 1.0 90.0 3.0 | 0.48 | 0.47 | True | ok | 0.18 | 13.50 |
| DM-J3507-ds 10 kg carpet 20% | 1.0 90.0 5.0 | 0.42 | 0.28 | False | grip | 0.45 | 16.00 |
| DM-J3507-ds 10 kg carpet 20% | 1.0 135.0 3.0 | 0.66 | 0.62 | True | ok | 0.14 | 2.00 |
| DM-J3507-ds 10 kg carpet 20% | 1.0 135.0 5.0 | 0.53 | 0.37 | False | wheel-hop | 0.53 | 2.50 |
| DM-J3507-ds 10 kg carpet 20% | 2.0 45.0 3.0 | 0.61 | 0.51 | False | grip | 0.52 | 9.00 |
| DM-J3507-ds 10 kg carpet 20% | 2.0 45.0 5.0 | 0.46 | 0.31 | False | grip | 0.68 | 11.00 |
| DM-J3507-ds 10 kg carpet 20% | 2.0 90.0 3.0 | 1.11 | 0.94 | False | rpm | 0.46 | 14.00 |
| DM-J3507-ds 10 kg carpet 20% | 2.0 90.0 5.0 | 0.93 | 0.57 | False | grip | 0.87 | 9.50 |
| DM-J3507-ds 10 kg carpet 20% | 2.0 135.0 3.0 | 1.29 | 1.23 | True | rpm | 0.27 | 12.50 |
| DM-J3507-ds 10 kg carpet 20% | 2.0 135.0 5.0 | 1.09 | 0.74 | False | rpm | 0.93 | 5.50 |
| DM-J3507-ds 10 kg carpet 20% | 3.0 45.0 3.0 | - | 0.77 | False | rpm | 0.75 | 9.50 |
| DM-J3507-ds 10 kg carpet 20% | 3.0 45.0 5.0 | - | 0.46 | False | grip | 1.06 | 8.00 |
| DM-J3507-ds 10 kg carpet 20% | 3.0 90.0 3.0 | 1.96 | 1.41 | False | grip | 0.75 | 10.00 |
| DM-J3507-ds 10 kg carpet 20% | 3.0 90.0 5.0 | 2.62 | 0.85 | False | grip | 1.26 | 11.50 |
| DM-J3507-ds 10 kg carpet 20% | 3.0 135.0 3.0 | - | 1.85 | False | rpm | 0.68 | 13.00 |
| DM-J3507-ds 10 kg carpet 20% | 3.0 135.0 5.0 | - | 1.11 | False | rpm | 1.28 | 10.50 |
| DM-J3507-ds 10 kg floor | 1.0 45.0 3.0 | 0.31 | 0.26 | True | grip | 0.23 | 7.00 |
| DM-J3507-ds 10 kg floor | 1.0 45.0 5.0 | 0.26 | 0.15 | False | grip | 0.43 | 8.50 |
| DM-J3507-ds 10 kg floor | 1.0 90.0 3.0 | 0.51 | 0.47 | True | ok | 0.19 | 8.00 |
| DM-J3507-ds 10 kg floor | 1.0 90.0 5.0 | 0.48 | 0.28 | False | grip | 0.45 | 11.00 |
| DM-J3507-ds 10 kg floor | 1.0 135.0 3.0 | 0.64 | 0.62 | True | ok | 0.15 | 4.50 |
| DM-J3507-ds 10 kg floor | 1.0 135.0 5.0 | 0.52 | 0.37 | False | torque | 0.53 | 3.00 |
| DM-J3507-ds 10 kg floor | 2.0 45.0 3.0 | 0.63 | 0.51 | False | rpm | 0.42 | 7.50 |
| DM-J3507-ds 10 kg floor | 2.0 45.0 5.0 | 0.45 | 0.31 | False | grip | 0.60 | 7.00 |
| DM-J3507-ds 10 kg floor | 2.0 90.0 3.0 | 1.10 | 0.94 | False | rpm | 0.39 | 6.50 |
| DM-J3507-ds 10 kg floor | 2.0 90.0 5.0 | 0.84 | 0.57 | False | grip | 0.86 | 6.50 |
| DM-J3507-ds 10 kg floor | 2.0 135.0 3.0 | 1.34 | 1.23 | True | rpm | 0.34 | 5.00 |
| DM-J3507-ds 10 kg floor | 2.0 135.0 5.0 | 1.04 | 0.74 | False | rpm | 0.88 | 5.00 |
| DM-J3507-ds 10 kg floor | 3.0 45.0 3.0 | 1.04 | 0.77 | False | rpm | 0.64 | 6.00 |
| DM-J3507-ds 10 kg floor | 3.0 45.0 5.0 | 0.88 | 0.46 | False | grip | 0.88 | 6.00 |
| DM-J3507-ds 10 kg floor | 3.0 90.0 3.0 | 1.66 | 1.41 | False | grip | 0.66 | 6.50 |
| DM-J3507-ds 10 kg floor | 3.0 90.0 5.0 | 1.26 | 0.85 | False | grip | 1.16 | 8.50 |
| DM-J3507-ds 10 kg floor | 3.0 135.0 3.0 | 2.13 | 1.85 | False | rpm | 0.54 | 5.00 |
| DM-J3507-ds 10 kg floor | 3.0 135.0 5.0 | 1.65 | 1.11 | False | rpm | 1.20 | 5.00 |
| DM-J3507-ds 10 kg floor 20% | 1.0 45.0 3.0 | 0.31 | 0.26 | True | grip | 0.23 | 6.50 |
| DM-J3507-ds 10 kg floor 20% | 1.0 45.0 5.0 | 0.26 | 0.15 | False | grip | 0.41 | 7.00 |
| DM-J3507-ds 10 kg floor 20% | 1.0 90.0 3.0 | 0.52 | 0.47 | True | ok | 0.20 | 7.00 |
| DM-J3507-ds 10 kg floor 20% | 1.0 90.0 5.0 | 0.41 | 0.28 | False | grip | 0.46 | 11.00 |
| DM-J3507-ds 10 kg floor 20% | 1.0 135.0 3.0 | 0.65 | 0.62 | True | ok | 0.14 | 4.00 |
| DM-J3507-ds 10 kg floor 20% | 1.0 135.0 5.0 | 0.52 | 0.37 | False | wheel-hop | 0.52 | 2.50 |
| DM-J3507-ds 10 kg floor 20% | 2.0 45.0 3.0 | 0.63 | 0.51 | False | rpm | 0.42 | 7.50 |
| DM-J3507-ds 10 kg floor 20% | 2.0 45.0 5.0 | 0.46 | 0.31 | False | grip | 0.64 | 6.50 |
| DM-J3507-ds 10 kg floor 20% | 2.0 90.0 3.0 | 1.11 | 0.94 | False | rpm | 0.44 | 8.00 |
| DM-J3507-ds 10 kg floor 20% | 2.0 90.0 5.0 | 0.85 | 0.57 | False | grip | 0.86 | 8.00 |
| DM-J3507-ds 10 kg floor 20% | 2.0 135.0 3.0 | 1.34 | 1.23 | True | rpm | 0.32 | 6.00 |
| DM-J3507-ds 10 kg floor 20% | 2.0 135.0 5.0 | 1.05 | 0.74 | False | rpm | 0.89 | 3.50 |
| DM-J3507-ds 10 kg floor 20% | 3.0 45.0 3.0 | - | 0.77 | False | rpm | 0.68 | 6.00 |
| DM-J3507-ds 10 kg floor 20% | 3.0 45.0 5.0 | - | 0.46 | False | rpm | 0.93 | 6.00 |
| DM-J3507-ds 10 kg floor 20% | 3.0 90.0 3.0 | 1.72 | 1.41 | False | grip | 0.70 | 7.00 |
| DM-J3507-ds 10 kg floor 20% | 3.0 90.0 5.0 | 1.45 | 0.85 | False | grip | 1.19 | 6.50 |
| DM-J3507-ds 10 kg floor 20% | 3.0 135.0 3.0 | - | 1.85 | False | rpm | 0.68 | 9.50 |
| DM-J3507-ds 10 kg floor 20% | 3.0 135.0 5.0 | - | 1.11 | False | grip | 1.29 | 7.50 |
| DM-J3507-ds 20 kg carpet | 1.0 45.0 3.0 | 0.37 | 0.26 | True | torque | 0.29 | 5.50 |
| DM-J3507-ds 20 kg carpet | 1.0 45.0 5.0 | 0.33 | 0.15 | False | grip | 0.40 | 10.00 |
| DM-J3507-ds 20 kg carpet | 1.0 90.0 3.0 | 0.49 | 0.47 | True | torque | 0.19 | 5.50 |
| DM-J3507-ds 20 kg carpet | 1.0 90.0 5.0 | 0.47 | 0.28 | False | grip | 0.58 | 8.50 |
| DM-J3507-ds 20 kg carpet | 1.0 135.0 3.0 | 0.65 | 0.62 | True | torque | 0.15 | 1.50 |
| DM-J3507-ds 20 kg carpet | 1.0 135.0 5.0 | 0.55 | 0.37 | False | torque | 0.55 | 1.00 |
| DM-J3507-ds 20 kg carpet | 2.0 45.0 3.0 | 0.73 | 0.51 | False | rpm | 0.44 | 9.50 |
| DM-J3507-ds 20 kg carpet | 2.0 45.0 5.0 | 0.65 | 0.31 | False | grip | 0.75 | 10.00 |
| DM-J3507-ds 20 kg carpet | 2.0 90.0 3.0 | 1.14 | 0.94 | False | rpm | 0.44 | 12.00 |
| DM-J3507-ds 20 kg carpet | 2.0 90.0 5.0 | 0.91 | 0.57 | False | grip | 0.88 | 9.50 |
| DM-J3507-ds 20 kg carpet | 2.0 135.0 3.0 | 1.46 | 1.23 | False | rpm | 0.45 | 5.00 |
| DM-J3507-ds 20 kg carpet | 2.0 135.0 5.0 | 1.28 | 0.74 | False | grip | 1.07 | 3.00 |
| DM-J3507-ds 20 kg carpet | 3.0 45.0 3.0 | - | 0.77 | False | rpm | 0.82 | 8.00 |
| DM-J3507-ds 20 kg carpet | 3.0 45.0 5.0 | - | 0.46 | False | grip | 1.08 | 10.50 |
| DM-J3507-ds 20 kg carpet | 3.0 90.0 3.0 | 2.26 | 1.41 | False | grip | 0.85 | 10.00 |
| DM-J3507-ds 20 kg carpet | 3.0 90.0 5.0 | 1.95 | 0.85 | False | grip | 1.38 | 6.50 |
| DM-J3507-ds 20 kg carpet | 3.0 135.0 3.0 | - | 1.85 | False | rpm | 0.98 | 5.50 |
| DM-J3507-ds 20 kg carpet | 3.0 135.0 5.0 | - | 1.11 | False | grip | 1.70 | 6.50 |
| DM-J3507-ds 20 kg carpet 20% | 1.0 45.0 3.0 | 0.44 | 0.26 | True | rpm | 0.28 | 8.50 |
| DM-J3507-ds 20 kg carpet 20% | 1.0 45.0 5.0 | 0.36 | 0.15 | False | grip | 0.41 | 19.50 |
| DM-J3507-ds 20 kg carpet 20% | 1.0 90.0 3.0 | 0.49 | 0.47 | True | torque | 0.19 | 5.50 |
| DM-J3507-ds 20 kg carpet 20% | 1.0 90.0 5.0 | 0.47 | 0.28 | False | grip | 0.58 | 10.50 |
| DM-J3507-ds 20 kg carpet 20% | 1.0 135.0 3.0 | 0.66 | 0.62 | True | torque | 0.16 | 0.50 |
| DM-J3507-ds 20 kg carpet 20% | 1.0 135.0 5.0 | 0.57 | 0.37 | False | rpm | 0.55 | 1.00 |
| DM-J3507-ds 20 kg carpet 20% | 2.0 45.0 3.0 | 0.91 | 0.51 | False | rpm | 0.51 | 12.00 |
| DM-J3507-ds 20 kg carpet 20% | 2.0 45.0 5.0 | 0.72 | 0.31 | False | grip | 0.68 | 8.50 |
| DM-J3507-ds 20 kg carpet 20% | 2.0 90.0 3.0 | 1.13 | 0.94 | False | rpm | 0.47 | 14.00 |
| DM-J3507-ds 20 kg carpet 20% | 2.0 90.0 5.0 | 1.01 | 0.57 | False | grip | 0.86 | 9.00 |
| DM-J3507-ds 20 kg carpet 20% | 2.0 135.0 3.0 | 1.69 | 1.23 | False | rpm | 0.57 | 4.50 |
| DM-J3507-ds 20 kg carpet 20% | 2.0 135.0 5.0 | 1.58 | 0.74 | False | grip | 1.19 | 3.00 |
| DM-J3507-ds 20 kg carpet 20% | 3.0 45.0 3.0 | - | 0.77 | False | rpm | 0.92 | 9.00 |
| DM-J3507-ds 20 kg carpet 20% | 3.0 45.0 5.0 | - | 0.46 | False | grip | 1.01 | 5.00 |
| DM-J3507-ds 20 kg carpet 20% | 3.0 90.0 3.0 | 3.03 | 1.41 | False | grip | 0.99 | 7.00 |
| DM-J3507-ds 20 kg carpet 20% | 3.0 90.0 5.0 | - | 0.85 | False | grip | 1.47 | 7.50 |
| DM-J3507-ds 20 kg carpet 20% | 3.0 135.0 3.0 | - | 1.85 | False | rpm | 1.17 | 9.00 |
| DM-J3507-ds 20 kg carpet 20% | 3.0 135.0 5.0 | - | 1.11 | False | grip | 1.78 | 7.00 |
| DM-J3507-ds 20 kg floor | 1.0 45.0 3.0 | 0.33 | 0.26 | True | torque | 0.25 | 7.00 |
| DM-J3507-ds 20 kg floor | 1.0 45.0 5.0 | 0.27 | 0.15 | False | grip | 0.46 | 6.50 |
| DM-J3507-ds 20 kg floor | 1.0 90.0 3.0 | 0.48 | 0.47 | True | torque | 0.21 | 3.00 |
| DM-J3507-ds 20 kg floor | 1.0 90.0 5.0 | 0.45 | 0.28 | False | grip | 0.55 | 6.50 |
| DM-J3507-ds 20 kg floor | 1.0 135.0 3.0 | 0.65 | 0.62 | True | torque | 0.14 | 0.00 |
| DM-J3507-ds 20 kg floor | 1.0 135.0 5.0 | 0.52 | 0.37 | False | grip | 0.53 | 1.00 |
| DM-J3507-ds 20 kg floor | 2.0 45.0 3.0 | 0.65 | 0.51 | False | rpm | 0.37 | 4.00 |
| DM-J3507-ds 20 kg floor | 2.0 45.0 5.0 | 0.57 | 0.31 | False | grip | 0.66 | 5.50 |
| DM-J3507-ds 20 kg floor | 2.0 90.0 3.0 | 1.04 | 0.94 | False | rpm | 0.40 | 8.00 |
| DM-J3507-ds 20 kg floor | 2.0 90.0 5.0 | 0.88 | 0.57 | False | grip | 0.93 | 4.00 |
| DM-J3507-ds 20 kg floor | 2.0 135.0 3.0 | 1.40 | 1.23 | False | rpm | 0.37 | 1.50 |
| DM-J3507-ds 20 kg floor | 2.0 135.0 5.0 | 1.12 | 0.74 | False | grip | 0.93 | 2.50 |
| DM-J3507-ds 20 kg floor | 3.0 45.0 3.0 | 1.84 | 0.77 | False | rpm | 0.61 | 4.50 |
| DM-J3507-ds 20 kg floor | 3.0 45.0 5.0 | 1.19 | 0.46 | False | grip | 0.97 | 5.00 |
| DM-J3507-ds 20 kg floor | 3.0 90.0 3.0 | 1.86 | 1.41 | False | grip | 0.80 | 5.00 |
| DM-J3507-ds 20 kg floor | 3.0 90.0 5.0 | 1.64 | 0.85 | False | grip | 1.36 | 5.50 |
| DM-J3507-ds 20 kg floor | 3.0 135.0 3.0 | 3.16 | 1.85 | False | rpm | 0.86 | 2.00 |
| DM-J3507-ds 20 kg floor | 3.0 135.0 5.0 | 2.83 | 1.11 | False | grip | 1.41 | 2.50 |
| DM-J3507-ds 20 kg floor 20% | 1.0 45.0 3.0 | 0.36 | 0.26 | True | rpm | 0.25 | 4.50 |
| DM-J3507-ds 20 kg floor 20% | 1.0 45.0 5.0 | 0.27 | 0.15 | False | grip | 0.44 | 6.00 |
| DM-J3507-ds 20 kg floor 20% | 1.0 90.0 3.0 | 0.52 | 0.47 | True | torque | 0.20 | 5.50 |
| DM-J3507-ds 20 kg floor 20% | 1.0 90.0 5.0 | 0.44 | 0.28 | False | grip | 0.53 | 6.00 |
| DM-J3507-ds 20 kg floor 20% | 1.0 135.0 3.0 | 0.65 | 0.62 | True | torque | 0.14 | 2.00 |
| DM-J3507-ds 20 kg floor 20% | 1.0 135.0 5.0 | 0.53 | 0.37 | False | grip | 0.53 | 1.00 |
| DM-J3507-ds 20 kg floor 20% | 2.0 45.0 3.0 | 0.74 | 0.51 | False | rpm | 0.40 | 4.00 |
| DM-J3507-ds 20 kg floor 20% | 2.0 45.0 5.0 | 0.64 | 0.31 | False | grip | 0.63 | 4.50 |
| DM-J3507-ds 20 kg floor 20% | 2.0 90.0 3.0 | 1.09 | 0.94 | False | rpm | 0.43 | 4.50 |
| DM-J3507-ds 20 kg floor 20% | 2.0 90.0 5.0 | 0.93 | 0.57 | False | grip | 0.90 | 6.50 |
| DM-J3507-ds 20 kg floor 20% | 2.0 135.0 3.0 | 1.52 | 1.23 | False | rpm | 0.44 | 1.50 |
| DM-J3507-ds 20 kg floor 20% | 2.0 135.0 5.0 | 1.25 | 0.74 | False | grip | 0.97 | 2.00 |
| DM-J3507-ds 20 kg floor 20% | 3.0 45.0 3.0 | - | 0.77 | False | rpm | 0.71 | 5.00 |
| DM-J3507-ds 20 kg floor 20% | 3.0 45.0 5.0 | - | 0.46 | False | grip | 0.93 | 4.50 |
| DM-J3507-ds 20 kg floor 20% | 3.0 90.0 3.0 | 2.25 | 1.41 | False | grip | 0.89 | 7.00 |
| DM-J3507-ds 20 kg floor 20% | 3.0 90.0 5.0 | 2.02 | 0.85 | False | grip | 1.50 | 5.50 |
| DM-J3507-ds 20 kg floor 20% | 3.0 135.0 3.0 | - | 1.85 | False | rpm | 0.99 | 4.50 |
| DM-J3507-ds 20 kg floor 20% | 3.0 135.0 5.0 | - | 1.11 | False | grip | 1.43 | 3.50 |
| EduLite05-ds 10 kg carpet | 1.0 45.0 3.0 | 0.32 | 0.26 | True | grip | 0.25 | 10.50 |
| EduLite05-ds 10 kg carpet | 1.0 45.0 5.0 | 0.26 | 0.15 | False | grip | 0.40 | 15.50 |
| EduLite05-ds 10 kg carpet | 1.0 90.0 3.0 | 0.48 | 0.47 | True | ok | 0.17 | 17.00 |
| EduLite05-ds 10 kg carpet | 1.0 90.0 5.0 | 0.39 | 0.28 | False | grip | 0.46 | 9.00 |
| EduLite05-ds 10 kg carpet | 1.0 135.0 3.0 | 0.65 | 0.62 | True | ok | 0.14 | 2.00 |
| EduLite05-ds 10 kg carpet | 1.0 135.0 5.0 | 0.51 | 0.37 | False | wheel-hop | 0.52 | 3.50 |
| EduLite05-ds 10 kg carpet | 2.0 45.0 3.0 | - | 0.51 | False | rpm | 0.43 | 13.50 |
| EduLite05-ds 10 kg carpet | 2.0 45.0 5.0 | - | 0.31 | False | grip | 0.56 | 10.50 |
| EduLite05-ds 10 kg carpet | 2.0 90.0 3.0 | 1.07 | 0.94 | False | rpm | 0.41 | 15.00 |
| EduLite05-ds 10 kg carpet | 2.0 90.0 5.0 | 0.86 | 0.57 | False | grip | 0.81 | 13.00 |
| EduLite05-ds 10 kg carpet | 2.0 135.0 3.0 | - | 1.23 | False | rpm | 0.24 | 8.50 |
| EduLite05-ds 10 kg carpet | 2.0 135.0 5.0 | - | 0.74 | False | rpm | 0.81 | 7.50 |
| EduLite05-ds 10 kg carpet | 3.0 45.0 3.0 | - | 0.77 | False | rpm | 0.47 | 12.50 |
| EduLite05-ds 10 kg carpet | 3.0 45.0 5.0 | - | 0.46 | False | rpm | 0.47 | 15.00 |
| EduLite05-ds 10 kg carpet | 3.0 90.0 3.0 | - | 1.41 | False | grip | 0.40 | 11.00 |
| EduLite05-ds 10 kg carpet | 3.0 90.0 5.0 | - | 0.85 | False | grip | 0.57 | 12.50 |
| EduLite05-ds 10 kg carpet | 3.0 135.0 3.0 | - | 1.85 | False | rpm | 0.32 | 13.00 |
| EduLite05-ds 10 kg carpet | 3.0 135.0 5.0 | - | 1.11 | False | rpm | 0.78 | 10.50 |
| EduLite05-ds 10 kg carpet 20% | 1.0 45.0 3.0 | 0.43 | 0.26 | True | grip | 0.27 | 16.00 |
| EduLite05-ds 10 kg carpet 20% | 1.0 45.0 5.0 | 0.26 | 0.15 | False | grip | 0.40 | 16.50 |
| EduLite05-ds 10 kg carpet 20% | 1.0 90.0 3.0 | 0.48 | 0.47 | True | ok | 0.17 | 17.00 |
| EduLite05-ds 10 kg carpet 20% | 1.0 90.0 5.0 | 0.41 | 0.28 | False | grip | 0.49 | 10.50 |
| EduLite05-ds 10 kg carpet 20% | 1.0 135.0 3.0 | 0.66 | 0.62 | True | ok | 0.14 | 2.50 |
| EduLite05-ds 10 kg carpet 20% | 1.0 135.0 5.0 | 0.53 | 0.37 | False | wheel-hop | 0.52 | 4.00 |
| EduLite05-ds 10 kg carpet 20% | 2.0 45.0 3.0 | - | 0.51 | False | rpm | 0.38 | 13.00 |
| EduLite05-ds 10 kg carpet 20% | 2.0 45.0 5.0 | - | 0.31 | False | grip | 0.45 | 9.00 |
| EduLite05-ds 10 kg carpet 20% | 2.0 90.0 3.0 | 2.74 | 0.94 | False | rpm | 0.37 | 11.50 |
| EduLite05-ds 10 kg carpet 20% | 2.0 90.0 5.0 | - | 0.57 | False | grip | 0.71 | 15.50 |
| EduLite05-ds 10 kg carpet 20% | 2.0 135.0 3.0 | - | 1.23 | False | rpm | 0.26 | 8.50 |
| EduLite05-ds 10 kg carpet 20% | 2.0 135.0 5.0 | - | 0.74 | False | grip | 0.62 | 10.00 |
| EduLite05-ds 10 kg carpet 20% | 3.0 45.0 3.0 | - | 0.77 | False | rpm | 0.41 | 11.50 |
| EduLite05-ds 10 kg carpet 20% | 3.0 45.0 5.0 | - | 0.46 | False | rpm | 0.47 | 13.50 |
| EduLite05-ds 10 kg carpet 20% | 3.0 90.0 3.0 | - | 1.41 | False | rpm | 0.43 | 13.00 |
| EduLite05-ds 10 kg carpet 20% | 3.0 90.0 5.0 | - | 0.85 | False | grip | 0.56 | 13.50 |
| EduLite05-ds 10 kg carpet 20% | 3.0 135.0 3.0 | - | 1.85 | False | rpm | 0.34 | 10.50 |
| EduLite05-ds 10 kg carpet 20% | 3.0 135.0 5.0 | - | 1.11 | False | rpm | 0.69 | 13.50 |
| EduLite05-ds 10 kg floor | 1.0 45.0 3.0 | 0.31 | 0.26 | True | grip | 0.23 | 5.50 |
| EduLite05-ds 10 kg floor | 1.0 45.0 5.0 | 0.25 | 0.15 | False | grip | 0.39 | 6.00 |
| EduLite05-ds 10 kg floor | 1.0 90.0 3.0 | 0.52 | 0.47 | True | ok | 0.19 | 7.50 |
| EduLite05-ds 10 kg floor | 1.0 90.0 5.0 | 0.48 | 0.28 | False | grip | 0.42 | 8.50 |
| EduLite05-ds 10 kg floor | 1.0 135.0 3.0 | 0.65 | 0.62 | True | ok | 0.15 | 5.00 |
| EduLite05-ds 10 kg floor | 1.0 135.0 5.0 | 0.54 | 0.37 | False | wheel-hop | 0.52 | 2.50 |
| EduLite05-ds 10 kg floor | 2.0 45.0 3.0 | - | 0.51 | False | rpm | 0.41 | 6.50 |
| EduLite05-ds 10 kg floor | 2.0 45.0 5.0 | - | 0.31 | False | rpm | 0.61 | 7.00 |
| EduLite05-ds 10 kg floor | 2.0 90.0 3.0 | 1.10 | 0.94 | False | rpm | 0.41 | 7.50 |
| EduLite05-ds 10 kg floor | 2.0 90.0 5.0 | 0.94 | 0.57 | False | grip | 0.72 | 7.00 |
| EduLite05-ds 10 kg floor | 2.0 135.0 3.0 | - | 1.23 | False | rpm | 0.28 | 5.00 |
| EduLite05-ds 10 kg floor | 2.0 135.0 5.0 | - | 0.74 | False | rpm | 0.76 | 5.00 |
| EduLite05-ds 10 kg floor | 3.0 45.0 3.0 | - | 0.77 | False | rpm | 0.36 | 8.50 |
| EduLite05-ds 10 kg floor | 3.0 45.0 5.0 | - | 0.46 | False | rpm | 0.56 | 7.00 |
| EduLite05-ds 10 kg floor | 3.0 90.0 3.0 | - | 1.41 | False | rpm | 0.38 | 10.00 |
| EduLite05-ds 10 kg floor | 3.0 90.0 5.0 | - | 0.85 | False | grip | 0.71 | 10.50 |
| EduLite05-ds 10 kg floor | 3.0 135.0 3.0 | - | 1.85 | False | rpm | 0.26 | 6.50 |
| EduLite05-ds 10 kg floor | 3.0 135.0 5.0 | - | 1.11 | False | grip | 0.66 | 9.50 |
| EduLite05-ds 10 kg floor 20% | 1.0 45.0 3.0 | 0.30 | 0.26 | True | grip | 0.23 | 8.50 |
| EduLite05-ds 10 kg floor 20% | 1.0 45.0 5.0 | 0.26 | 0.15 | False | grip | 0.42 | 7.00 |
| EduLite05-ds 10 kg floor 20% | 1.0 90.0 3.0 | 0.52 | 0.47 | True | ok | 0.19 | 7.50 |
| EduLite05-ds 10 kg floor 20% | 1.0 90.0 5.0 | 0.48 | 0.28 | False | grip | 0.43 | 8.00 |
| EduLite05-ds 10 kg floor 20% | 1.0 135.0 3.0 | 0.65 | 0.62 | True | ok | 0.15 | 5.00 |
| EduLite05-ds 10 kg floor 20% | 1.0 135.0 5.0 | 0.54 | 0.37 | False | wheel-hop | 0.51 | 2.50 |
| EduLite05-ds 10 kg floor 20% | 2.0 45.0 3.0 | - | 0.51 | False | rpm | 0.33 | 8.50 |
| EduLite05-ds 10 kg floor 20% | 2.0 45.0 5.0 | - | 0.31 | False | rpm | 0.53 | 9.00 |
| EduLite05-ds 10 kg floor 20% | 2.0 90.0 3.0 | 1.37 | 0.94 | False | rpm | 0.35 | 7.00 |
| EduLite05-ds 10 kg floor 20% | 2.0 90.0 5.0 | 1.25 | 0.57 | False | grip | 0.68 | 8.00 |
| EduLite05-ds 10 kg floor 20% | 2.0 135.0 3.0 | - | 1.23 | False | rpm | 0.21 | 6.50 |
| EduLite05-ds 10 kg floor 20% | 2.0 135.0 5.0 | - | 0.74 | False | rpm | 0.71 | 5.50 |
| EduLite05-ds 10 kg floor 20% | 3.0 45.0 3.0 | - | 0.77 | False | rpm | 0.31 | 6.00 |
| EduLite05-ds 10 kg floor 20% | 3.0 45.0 5.0 | - | 0.46 | False | rpm | 0.46 | 8.50 |
| EduLite05-ds 10 kg floor 20% | 3.0 90.0 3.0 | - | 1.41 | False | rpm | 0.35 | 6.00 |
| EduLite05-ds 10 kg floor 20% | 3.0 90.0 5.0 | - | 0.85 | False | grip | 0.66 | 8.50 |
| EduLite05-ds 10 kg floor 20% | 3.0 135.0 3.0 | - | 1.85 | False | rpm | 0.26 | 7.00 |
| EduLite05-ds 10 kg floor 20% | 3.0 135.0 5.0 | - | 1.11 | False | rpm | 0.68 | 5.50 |
| EduLite05-ds 20 kg carpet | 1.0 45.0 3.0 | 0.33 | 0.26 | True | grip | 0.29 | 11.00 |
| EduLite05-ds 20 kg carpet | 1.0 45.0 5.0 | 0.28 | 0.15 | False | grip | 0.45 | 6.50 |
| EduLite05-ds 20 kg carpet | 1.0 90.0 3.0 | 0.51 | 0.47 | True | ok | 0.20 | 7.00 |
| EduLite05-ds 20 kg carpet | 1.0 90.0 5.0 | 0.41 | 0.28 | False | grip | 0.44 | 4.50 |
| EduLite05-ds 20 kg carpet | 1.0 135.0 3.0 | 0.64 | 0.62 | True | ok | 0.14 | 0.50 |
| EduLite05-ds 20 kg carpet | 1.0 135.0 5.0 | 0.52 | 0.37 | False | grip | 0.49 | 1.50 |
| EduLite05-ds 20 kg carpet | 2.0 45.0 3.0 | - | 0.51 | False | rpm | 0.41 | 8.50 |
| EduLite05-ds 20 kg carpet | 2.0 45.0 5.0 | - | 0.31 | False | grip | 0.58 | 8.00 |
| EduLite05-ds 20 kg carpet | 2.0 90.0 3.0 | 1.16 | 0.94 | False | rpm | 0.46 | 9.00 |
| EduLite05-ds 20 kg carpet | 2.0 90.0 5.0 | 1.05 | 0.57 | False | grip | 0.80 | 13.50 |
| EduLite05-ds 20 kg carpet | 2.0 135.0 3.0 | - | 1.23 | False | rpm | 0.32 | 7.00 |
| EduLite05-ds 20 kg carpet | 2.0 135.0 5.0 | - | 0.74 | False | grip | 0.75 | 4.00 |
| EduLite05-ds 20 kg carpet | 3.0 45.0 3.0 | - | 0.77 | False | rpm | 0.47 | 11.00 |
| EduLite05-ds 20 kg carpet | 3.0 45.0 5.0 | - | 0.46 | False | rpm | 0.55 | 13.00 |
| EduLite05-ds 20 kg carpet | 3.0 90.0 3.0 | - | 1.41 | False | rpm | 0.41 | 7.00 |
| EduLite05-ds 20 kg carpet | 3.0 90.0 5.0 | - | 0.85 | False | grip | 0.73 | 5.00 |
| EduLite05-ds 20 kg carpet | 3.0 135.0 3.0 | - | 1.85 | False | rpm | 0.37 | 8.00 |
| EduLite05-ds 20 kg carpet | 3.0 135.0 5.0 | - | 1.11 | False | grip | 0.77 | 8.00 |
| EduLite05-ds 20 kg carpet 20% | 1.0 45.0 3.0 | 0.42 | 0.26 | True | rpm | 0.29 | 7.50 |
| EduLite05-ds 20 kg carpet 20% | 1.0 45.0 5.0 | 0.33 | 0.15 | False | grip | 0.44 | 10.50 |
| EduLite05-ds 20 kg carpet 20% | 1.0 90.0 3.0 | 0.51 | 0.47 | True | ok | 0.20 | 7.00 |
| EduLite05-ds 20 kg carpet 20% | 1.0 90.0 5.0 | 0.41 | 0.28 | False | grip | 0.43 | 6.00 |
| EduLite05-ds 20 kg carpet 20% | 1.0 135.0 3.0 | 0.65 | 0.62 | True | rpm | 0.14 | 0.50 |
| EduLite05-ds 20 kg carpet 20% | 1.0 135.0 5.0 | 0.53 | 0.37 | False | rpm | 0.51 | 1.50 |
| EduLite05-ds 20 kg carpet 20% | 2.0 45.0 3.0 | - | 0.51 | False | rpm | 0.36 | 7.50 |
| EduLite05-ds 20 kg carpet 20% | 2.0 45.0 5.0 | - | 0.31 | False | grip | 0.55 | 12.50 |
| EduLite05-ds 20 kg carpet 20% | 2.0 90.0 3.0 | - | 0.94 | False | rpm | 0.40 | 10.00 |
| EduLite05-ds 20 kg carpet 20% | 2.0 90.0 5.0 | - | 0.57 | False | grip | 0.76 | 12.50 |
| EduLite05-ds 20 kg carpet 20% | 2.0 135.0 3.0 | - | 1.23 | False | rpm | 0.29 | 5.50 |
| EduLite05-ds 20 kg carpet 20% | 2.0 135.0 5.0 | - | 0.74 | False | grip | 0.68 | 7.50 |
| EduLite05-ds 20 kg carpet 20% | 3.0 45.0 3.0 | - | 0.77 | False | rpm | 0.35 | 7.00 |
| EduLite05-ds 20 kg carpet 20% | 3.0 45.0 5.0 | - | 0.46 | False | rpm | 0.42 | 9.50 |
| EduLite05-ds 20 kg carpet 20% | 3.0 90.0 3.0 | - | 1.41 | False | rpm | 0.36 | 9.50 |
| EduLite05-ds 20 kg carpet 20% | 3.0 90.0 5.0 | - | 0.85 | False | grip | 0.59 | 12.00 |
| EduLite05-ds 20 kg carpet 20% | 3.0 135.0 3.0 | - | 1.85 | False | rpm | 0.35 | 10.00 |
| EduLite05-ds 20 kg carpet 20% | 3.0 135.0 5.0 | - | 1.11 | False | rpm | 0.73 | 6.00 |
| EduLite05-ds 20 kg floor | 1.0 45.0 3.0 | 0.33 | 0.26 | True | ok | 0.23 | 6.00 |
| EduLite05-ds 20 kg floor | 1.0 45.0 5.0 | 0.26 | 0.15 | False | grip | 0.38 | 6.00 |
| EduLite05-ds 20 kg floor | 1.0 90.0 3.0 | 0.50 | 0.47 | True | ok | 0.18 | 7.00 |
| EduLite05-ds 20 kg floor | 1.0 90.0 5.0 | 0.40 | 0.28 | False | grip | 0.44 | 7.00 |
| EduLite05-ds 20 kg floor | 1.0 135.0 3.0 | 0.63 | 0.62 | True | ok | 0.13 | 1.00 |
| EduLite05-ds 20 kg floor | 1.0 135.0 5.0 | 0.50 | 0.37 | False | grip | 0.46 | 1.50 |
| EduLite05-ds 20 kg floor | 2.0 45.0 3.0 | - | 0.51 | False | rpm | 0.36 | 5.00 |
| EduLite05-ds 20 kg floor | 2.0 45.0 5.0 | - | 0.31 | False | rpm | 0.52 | 6.00 |
| EduLite05-ds 20 kg floor | 2.0 90.0 3.0 | 1.15 | 0.94 | False | rpm | 0.41 | 5.50 |
| EduLite05-ds 20 kg floor | 2.0 90.0 5.0 | 0.97 | 0.57 | False | grip | 0.74 | 7.00 |
| EduLite05-ds 20 kg floor | 2.0 135.0 3.0 | - | 1.23 | False | rpm | 0.27 | 1.50 |
| EduLite05-ds 20 kg floor | 2.0 135.0 5.0 | - | 0.74 | False | rpm | 0.73 | 2.00 |
| EduLite05-ds 20 kg floor | 3.0 45.0 3.0 | - | 0.77 | False | rpm | 0.42 | 4.50 |
| EduLite05-ds 20 kg floor | 3.0 45.0 5.0 | - | 0.46 | False | rpm | 0.49 | 6.50 |
| EduLite05-ds 20 kg floor | 3.0 90.0 3.0 | - | 1.41 | False | rpm | 0.33 | 5.50 |
| EduLite05-ds 20 kg floor | 3.0 90.0 5.0 | - | 0.85 | False | grip | 0.68 | 8.00 |
| EduLite05-ds 20 kg floor | 3.0 135.0 3.0 | - | 1.85 | False | rpm | 0.31 | 5.00 |
| EduLite05-ds 20 kg floor | 3.0 135.0 5.0 | - | 1.11 | False | grip | 0.78 | 6.00 |
| EduLite05-ds 20 kg floor 20% | 1.0 45.0 3.0 | 0.35 | 0.26 | True | rpm | 0.23 | 6.00 |
| EduLite05-ds 20 kg floor 20% | 1.0 45.0 5.0 | 0.26 | 0.15 | False | grip | 0.42 | 6.00 |
| EduLite05-ds 20 kg floor 20% | 1.0 90.0 3.0 | 0.49 | 0.47 | True | ok | 0.18 | 6.00 |
| EduLite05-ds 20 kg floor 20% | 1.0 90.0 5.0 | 0.38 | 0.28 | False | grip | 0.43 | 3.00 |
| EduLite05-ds 20 kg floor 20% | 1.0 135.0 3.0 | 0.65 | 0.62 | True | ok | 0.14 | 1.50 |
| EduLite05-ds 20 kg floor 20% | 1.0 135.0 5.0 | 0.51 | 0.37 | False | rpm | 0.50 | 1.50 |
| EduLite05-ds 20 kg floor 20% | 2.0 45.0 3.0 | - | 0.51 | False | rpm | 0.34 | 8.00 |
| EduLite05-ds 20 kg floor 20% | 2.0 45.0 5.0 | - | 0.31 | False | rpm | 0.49 | 6.50 |
| EduLite05-ds 20 kg floor 20% | 2.0 90.0 3.0 | 1.75 | 0.94 | False | rpm | 0.38 | 5.50 |
| EduLite05-ds 20 kg floor 20% | 2.0 90.0 5.0 | 1.51 | 0.57 | False | grip | 0.69 | 4.00 |
| EduLite05-ds 20 kg floor 20% | 2.0 135.0 3.0 | - | 1.23 | False | rpm | 0.26 | 5.50 |
| EduLite05-ds 20 kg floor 20% | 2.0 135.0 5.0 | - | 0.74 | False | rpm | 0.65 | 3.00 |
| EduLite05-ds 20 kg floor 20% | 3.0 45.0 3.0 | - | 0.77 | False | rpm | 0.28 | 4.50 |
| EduLite05-ds 20 kg floor 20% | 3.0 45.0 5.0 | - | 0.46 | False | rpm | 0.42 | 5.50 |
| EduLite05-ds 20 kg floor 20% | 3.0 90.0 3.0 | - | 1.41 | False | rpm | 0.31 | 5.50 |
| EduLite05-ds 20 kg floor 20% | 3.0 90.0 5.0 | - | 0.85 | False | grip | 0.55 | 4.00 |
| EduLite05-ds 20 kg floor 20% | 3.0 135.0 3.0 | - | 1.85 | False | rpm | 0.28 | 3.50 |
| EduLite05-ds 20 kg floor 20% | 3.0 135.0 5.0 | - | 1.11 | False | grip | 0.68 | 6.00 |
| GIM3510-8-ds 10 kg carpet | 1.0 45.0 3.0 | 0.30 | 0.26 | True | grip | 0.27 | 10.50 |
| GIM3510-8-ds 10 kg carpet | 1.0 45.0 5.0 | 0.25 | 0.15 | False | grip | 0.39 | 10.50 |
| GIM3510-8-ds 10 kg carpet | 1.0 90.0 3.0 | 0.48 | 0.47 | True | ok | 0.18 | 17.50 |
| GIM3510-8-ds 10 kg carpet | 1.0 90.0 5.0 | 0.42 | 0.28 | False | grip | 0.52 | 11.50 |
| GIM3510-8-ds 10 kg carpet | 1.0 135.0 3.0 | 0.65 | 0.62 | True | ok | 0.14 | 2.50 |
| GIM3510-8-ds 10 kg carpet | 1.0 135.0 5.0 | 0.52 | 0.37 | False | torque | 0.51 | 3.00 |
| GIM3510-8-ds 10 kg carpet | 2.0 45.0 3.0 | 0.52 | 0.51 | False | grip | 0.50 | 11.00 |
| GIM3510-8-ds 10 kg carpet | 2.0 45.0 5.0 | 0.43 | 0.31 | False | grip | 0.72 | 11.50 |
| GIM3510-8-ds 10 kg carpet | 2.0 90.0 3.0 | 1.20 | 0.94 | False | torque | 0.42 | 15.00 |
| GIM3510-8-ds 10 kg carpet | 2.0 90.0 5.0 | 0.83 | 0.57 | False | grip | 0.79 | 9.00 |
| GIM3510-8-ds 10 kg carpet | 2.0 135.0 3.0 | 1.27 | 1.23 | True | torque | 0.32 | 13.00 |
| GIM3510-8-ds 10 kg carpet | 2.0 135.0 5.0 | 1.03 | 0.74 | False | torque | 0.98 | 11.00 |
| GIM3510-8-ds 10 kg carpet | 3.0 45.0 3.0 | 0.75 | 0.77 | False | grip | 0.59 | 10.00 |
| GIM3510-8-ds 10 kg carpet | 3.0 45.0 5.0 | 0.62 | 0.46 | False | grip | 0.88 | 9.50 |
| GIM3510-8-ds 10 kg carpet | 3.0 90.0 3.0 | 1.63 | 1.41 | False | grip | 0.72 | 10.50 |
| GIM3510-8-ds 10 kg carpet | 3.0 90.0 5.0 | 1.30 | 0.85 | False | grip | 1.47 | 10.50 |
| GIM3510-8-ds 10 kg carpet | 3.0 135.0 3.0 | 1.89 | 1.85 | True | torque | 0.35 | 8.50 |
| GIM3510-8-ds 10 kg carpet | 3.0 135.0 5.0 | 1.51 | 1.11 | False | torque | 1.36 | 11.50 |
| GIM3510-8-ds 10 kg carpet 20% | 1.0 45.0 3.0 | 0.30 | 0.26 | True | grip | 0.27 | 10.50 |
| GIM3510-8-ds 10 kg carpet 20% | 1.0 45.0 5.0 | 0.25 | 0.15 | False | grip | 0.39 | 10.50 |
| GIM3510-8-ds 10 kg carpet 20% | 1.0 90.0 3.0 | 0.48 | 0.47 | True | ok | 0.18 | 17.50 |
| GIM3510-8-ds 10 kg carpet 20% | 1.0 90.0 5.0 | 0.42 | 0.28 | False | grip | 0.52 | 11.50 |
| GIM3510-8-ds 10 kg carpet 20% | 1.0 135.0 3.0 | 0.65 | 0.62 | True | ok | 0.14 | 2.50 |
| GIM3510-8-ds 10 kg carpet 20% | 1.0 135.0 5.0 | 0.52 | 0.37 | False | torque | 0.51 | 3.00 |
| GIM3510-8-ds 10 kg carpet 20% | 2.0 45.0 3.0 | 0.52 | 0.51 | False | grip | 0.50 | 11.00 |
| GIM3510-8-ds 10 kg carpet 20% | 2.0 45.0 5.0 | 0.43 | 0.31 | False | grip | 0.72 | 11.50 |
| GIM3510-8-ds 10 kg carpet 20% | 2.0 90.0 3.0 | 1.20 | 0.94 | False | torque | 0.42 | 15.00 |
| GIM3510-8-ds 10 kg carpet 20% | 2.0 90.0 5.0 | 0.83 | 0.57 | False | grip | 0.79 | 9.00 |
| GIM3510-8-ds 10 kg carpet 20% | 2.0 135.0 3.0 | 1.27 | 1.23 | True | torque | 0.32 | 13.00 |
| GIM3510-8-ds 10 kg carpet 20% | 2.0 135.0 5.0 | 1.03 | 0.74 | False | torque | 0.98 | 7.50 |
| GIM3510-8-ds 10 kg carpet 20% | 3.0 45.0 3.0 | 0.78 | 0.77 | False | rpm | 0.62 | 16.50 |
| GIM3510-8-ds 10 kg carpet 20% | 3.0 45.0 5.0 | 0.67 | 0.46 | False | grip | 0.94 | 10.50 |
| GIM3510-8-ds 10 kg carpet 20% | 3.0 90.0 3.0 | 1.64 | 1.41 | False | torque | 0.70 | 15.00 |
| GIM3510-8-ds 10 kg carpet 20% | 3.0 90.0 5.0 | 1.30 | 0.85 | False | grip | 1.33 | 12.50 |
| GIM3510-8-ds 10 kg carpet 20% | 3.0 135.0 3.0 | 1.90 | 1.85 | True | rpm | 0.36 | 8.50 |
| GIM3510-8-ds 10 kg carpet 20% | 3.0 135.0 5.0 | 1.58 | 1.11 | False | rpm | 1.52 | 7.00 |
| GIM3510-8-ds 10 kg floor | 1.0 45.0 3.0 | 0.31 | 0.26 | True | grip | 0.24 | 6.00 |
| GIM3510-8-ds 10 kg floor | 1.0 45.0 5.0 | 0.26 | 0.15 | False | grip | 0.45 | 7.50 |
| GIM3510-8-ds 10 kg floor | 1.0 90.0 3.0 | 0.52 | 0.47 | True | ok | 0.20 | 7.50 |
| GIM3510-8-ds 10 kg floor | 1.0 90.0 5.0 | 0.48 | 0.28 | False | grip | 0.48 | 14.00 |
| GIM3510-8-ds 10 kg floor | 1.0 135.0 3.0 | 0.65 | 0.62 | True | ok | 0.15 | 3.00 |
| GIM3510-8-ds 10 kg floor | 1.0 135.0 5.0 | 0.55 | 0.37 | False | torque | 0.52 | 2.50 |
| GIM3510-8-ds 10 kg floor | 2.0 45.0 3.0 | 0.54 | 0.51 | False | wheel-hop | 0.45 | 7.50 |
| GIM3510-8-ds 10 kg floor | 2.0 45.0 5.0 | 0.42 | 0.31 | False | grip | 0.66 | 6.50 |
| GIM3510-8-ds 10 kg floor | 2.0 90.0 3.0 | 1.06 | 0.94 | False | torque | 0.39 | 9.50 |
| GIM3510-8-ds 10 kg floor | 2.0 90.0 5.0 | 0.82 | 0.57 | False | grip | 0.81 | 6.50 |
| GIM3510-8-ds 10 kg floor | 2.0 135.0 3.0 | 1.29 | 1.23 | True | torque | 0.29 | 5.50 |
| GIM3510-8-ds 10 kg floor | 2.0 135.0 5.0 | 1.05 | 0.74 | False | torque | 0.90 | 5.50 |
| GIM3510-8-ds 10 kg floor | 3.0 45.0 3.0 | 0.80 | 0.77 | False | wheel-hop | 0.63 | 6.00 |
| GIM3510-8-ds 10 kg floor | 3.0 45.0 5.0 | 0.66 | 0.46 | False | grip | 0.95 | 7.50 |
| GIM3510-8-ds 10 kg floor | 3.0 90.0 3.0 | 1.65 | 1.41 | False | torque | 0.61 | 8.00 |
| GIM3510-8-ds 10 kg floor | 3.0 90.0 5.0 | 1.24 | 0.85 | False | grip | 1.17 | 6.00 |
| GIM3510-8-ds 10 kg floor | 3.0 135.0 3.0 | 1.93 | 1.85 | True | torque | 0.39 | 5.50 |
| GIM3510-8-ds 10 kg floor | 3.0 135.0 5.0 | 1.49 | 1.11 | False | grip | 1.25 | 7.00 |
| GIM3510-8-ds 10 kg floor 20% | 1.0 45.0 3.0 | 0.31 | 0.26 | True | grip | 0.24 | 6.00 |
| GIM3510-8-ds 10 kg floor 20% | 1.0 45.0 5.0 | 0.26 | 0.15 | False | grip | 0.45 | 7.50 |
| GIM3510-8-ds 10 kg floor 20% | 1.0 90.0 3.0 | 0.52 | 0.47 | True | ok | 0.20 | 7.50 |
| GIM3510-8-ds 10 kg floor 20% | 1.0 90.0 5.0 | 0.48 | 0.28 | False | grip | 0.48 | 14.00 |
| GIM3510-8-ds 10 kg floor 20% | 1.0 135.0 3.0 | 0.65 | 0.62 | True | ok | 0.15 | 3.00 |
| GIM3510-8-ds 10 kg floor 20% | 1.0 135.0 5.0 | 0.55 | 0.37 | False | torque | 0.52 | 2.50 |
| GIM3510-8-ds 10 kg floor 20% | 2.0 45.0 3.0 | 0.54 | 0.51 | False | wheel-hop | 0.45 | 7.50 |
| GIM3510-8-ds 10 kg floor 20% | 2.0 45.0 5.0 | 0.42 | 0.31 | False | grip | 0.66 | 6.50 |
| GIM3510-8-ds 10 kg floor 20% | 2.0 90.0 3.0 | 1.06 | 0.94 | False | torque | 0.39 | 9.50 |
| GIM3510-8-ds 10 kg floor 20% | 2.0 90.0 5.0 | 0.82 | 0.57 | False | grip | 0.81 | 6.50 |
| GIM3510-8-ds 10 kg floor 20% | 2.0 135.0 3.0 | 1.29 | 1.23 | True | torque | 0.29 | 5.50 |
| GIM3510-8-ds 10 kg floor 20% | 2.0 135.0 5.0 | 1.06 | 0.74 | False | torque | 0.90 | 5.50 |
| GIM3510-8-ds 10 kg floor 20% | 3.0 45.0 3.0 | 0.85 | 0.77 | False | rpm | 0.63 | 6.00 |
| GIM3510-8-ds 10 kg floor 20% | 3.0 45.0 5.0 | 0.67 | 0.46 | False | grip | 0.98 | 5.00 |
| GIM3510-8-ds 10 kg floor 20% | 3.0 90.0 3.0 | 1.64 | 1.41 | False | grip | 0.69 | 8.50 |
| GIM3510-8-ds 10 kg floor 20% | 3.0 90.0 5.0 | 1.23 | 0.85 | False | grip | 1.32 | 6.00 |
| GIM3510-8-ds 10 kg floor 20% | 3.0 135.0 3.0 | 1.93 | 1.85 | True | rpm | 0.37 | 6.50 |
| GIM3510-8-ds 10 kg floor 20% | 3.0 135.0 5.0 | 1.53 | 1.11 | False | rpm | 1.30 | 7.50 |
| GIM3510-8-ds 20 kg carpet | 1.0 45.0 3.0 | 0.36 | 0.26 | True | torque | 0.28 | 6.00 |
| GIM3510-8-ds 20 kg carpet | 1.0 45.0 5.0 | 0.34 | 0.15 | False | grip | 0.40 | 8.00 |
| GIM3510-8-ds 20 kg carpet | 1.0 90.0 3.0 | 0.51 | 0.47 | True | torque | 0.18 | 3.50 |
| GIM3510-8-ds 20 kg carpet | 1.0 90.0 5.0 | 0.45 | 0.28 | False | grip | 0.52 | 3.00 |
| GIM3510-8-ds 20 kg carpet | 1.0 135.0 3.0 | 0.65 | 0.62 | True | torque | 0.15 | 0.50 |
| GIM3510-8-ds 20 kg carpet | 1.0 135.0 5.0 | 0.55 | 0.37 | False | torque | 0.53 | 1.00 |
| GIM3510-8-ds 20 kg carpet | 2.0 45.0 3.0 | 0.62 | 0.51 | False | grip | 0.44 | 13.00 |
| GIM3510-8-ds 20 kg carpet | 2.0 45.0 5.0 | 0.47 | 0.31 | False | grip | 0.69 | 8.50 |
| GIM3510-8-ds 20 kg carpet | 2.0 90.0 3.0 | 1.06 | 0.94 | False | torque | 0.40 | 13.50 |
| GIM3510-8-ds 20 kg carpet | 2.0 90.0 5.0 | 0.87 | 0.57 | False | grip | 0.85 | 7.50 |
| GIM3510-8-ds 20 kg carpet | 2.0 135.0 3.0 | 1.28 | 1.23 | True | torque | 0.26 | 7.00 |
| GIM3510-8-ds 20 kg carpet | 2.0 135.0 5.0 | 1.07 | 0.74 | False | torque | 1.03 | 3.00 |
| GIM3510-8-ds 20 kg carpet | 3.0 45.0 3.0 | 0.89 | 0.77 | False | grip | 0.58 | 8.00 |
| GIM3510-8-ds 20 kg carpet | 3.0 45.0 5.0 | 0.65 | 0.46 | False | grip | 0.89 | 6.00 |
| GIM3510-8-ds 20 kg carpet | 3.0 90.0 3.0 | 1.64 | 1.41 | False | grip | 0.73 | 10.00 |
| GIM3510-8-ds 20 kg carpet | 3.0 90.0 5.0 | 1.33 | 0.85 | False | grip | 1.28 | 6.50 |
| GIM3510-8-ds 20 kg carpet | 3.0 135.0 3.0 | 1.92 | 1.85 | True | torque | 0.36 | 10.00 |
| GIM3510-8-ds 20 kg carpet | 3.0 135.0 5.0 | 1.59 | 1.11 | False | grip | 1.50 | 5.50 |
| GIM3510-8-ds 20 kg carpet 20% | 1.0 45.0 3.0 | 0.36 | 0.26 | True | torque | 0.28 | 6.00 |
| GIM3510-8-ds 20 kg carpet 20% | 1.0 45.0 5.0 | 0.34 | 0.15 | False | grip | 0.40 | 8.00 |
| GIM3510-8-ds 20 kg carpet 20% | 1.0 90.0 3.0 | 0.51 | 0.47 | True | torque | 0.18 | 3.50 |
| GIM3510-8-ds 20 kg carpet 20% | 1.0 90.0 5.0 | 0.45 | 0.28 | False | grip | 0.52 | 3.00 |
| GIM3510-8-ds 20 kg carpet 20% | 1.0 135.0 3.0 | 0.65 | 0.62 | True | torque | 0.15 | 0.50 |
| GIM3510-8-ds 20 kg carpet 20% | 1.0 135.0 5.0 | 0.55 | 0.37 | False | torque | 0.53 | 1.00 |
| GIM3510-8-ds 20 kg carpet 20% | 2.0 45.0 3.0 | 0.62 | 0.51 | False | grip | 0.44 | 13.00 |
| GIM3510-8-ds 20 kg carpet 20% | 2.0 45.0 5.0 | 0.47 | 0.31 | False | grip | 0.69 | 8.50 |
| GIM3510-8-ds 20 kg carpet 20% | 2.0 90.0 3.0 | 1.06 | 0.94 | False | torque | 0.40 | 13.50 |
| GIM3510-8-ds 20 kg carpet 20% | 2.0 90.0 5.0 | 0.87 | 0.57 | False | grip | 0.85 | 7.50 |
| GIM3510-8-ds 20 kg carpet 20% | 2.0 135.0 3.0 | 1.28 | 1.23 | True | torque | 0.26 | 7.00 |
| GIM3510-8-ds 20 kg carpet 20% | 2.0 135.0 5.0 | 1.10 | 0.74 | False | torque | 1.03 | 2.50 |
| GIM3510-8-ds 20 kg carpet 20% | 3.0 45.0 3.0 | 1.02 | 0.77 | False | grip | 0.64 | 9.50 |
| GIM3510-8-ds 20 kg carpet 20% | 3.0 45.0 5.0 | 0.83 | 0.46 | False | grip | 0.93 | 8.50 |
| GIM3510-8-ds 20 kg carpet 20% | 3.0 90.0 3.0 | 1.76 | 1.41 | False | supply | 0.72 | 9.00 |
| GIM3510-8-ds 20 kg carpet 20% | 3.0 90.0 5.0 | 1.35 | 0.85 | False | supply | 1.29 | 7.50 |
| GIM3510-8-ds 20 kg carpet 20% | 3.0 135.0 3.0 | 2.10 | 1.85 | False | rpm | 0.47 | 8.00 |
| GIM3510-8-ds 20 kg carpet 20% | 3.0 135.0 5.0 | 1.71 | 1.11 | False | supply | 1.38 | 5.50 |
| GIM3510-8-ds 20 kg floor | 1.0 45.0 3.0 | 0.33 | 0.26 | True | grip | 0.23 | 7.50 |
| GIM3510-8-ds 20 kg floor | 1.0 45.0 5.0 | 0.26 | 0.15 | False | grip | 0.39 | 9.50 |
| GIM3510-8-ds 20 kg floor | 1.0 90.0 3.0 | 0.50 | 0.47 | True | torque | 0.19 | 7.50 |
| GIM3510-8-ds 20 kg floor | 1.0 90.0 5.0 | 0.44 | 0.28 | False | grip | 0.51 | 2.50 |
| GIM3510-8-ds 20 kg floor | 1.0 135.0 3.0 | 0.65 | 0.62 | True | torque | 0.13 | 0.50 |
| GIM3510-8-ds 20 kg floor | 1.0 135.0 5.0 | 0.51 | 0.37 | False | torque | 0.49 | 2.00 |
| GIM3510-8-ds 20 kg floor | 2.0 45.0 3.0 | 0.54 | 0.51 | False | torque | 0.37 | 8.00 |
| GIM3510-8-ds 20 kg floor | 2.0 45.0 5.0 | 0.43 | 0.31 | False | grip | 0.70 | 6.00 |
| GIM3510-8-ds 20 kg floor | 2.0 90.0 3.0 | 1.04 | 0.94 | False | torque | 0.41 | 4.50 |
| GIM3510-8-ds 20 kg floor | 2.0 90.0 5.0 | 0.83 | 0.57 | False | grip | 0.86 | 6.50 |
| GIM3510-8-ds 20 kg floor | 2.0 135.0 3.0 | 1.31 | 1.23 | True | torque | 0.32 | 2.00 |
| GIM3510-8-ds 20 kg floor | 2.0 135.0 5.0 | 1.02 | 0.74 | False | grip | 0.92 | 2.50 |
| GIM3510-8-ds 20 kg floor | 3.0 45.0 3.0 | 0.88 | 0.77 | False | rpm | 0.54 | 7.50 |
| GIM3510-8-ds 20 kg floor | 3.0 45.0 5.0 | 0.63 | 0.46 | False | grip | 0.88 | 6.50 |
| GIM3510-8-ds 20 kg floor | 3.0 90.0 3.0 | 1.64 | 1.41 | False | grip | 0.69 | 7.50 |
| GIM3510-8-ds 20 kg floor | 3.0 90.0 5.0 | 1.29 | 0.85 | False | grip | 1.27 | 5.00 |
| GIM3510-8-ds 20 kg floor | 3.0 135.0 3.0 | 1.95 | 1.85 | False | torque | 0.43 | 3.00 |
| GIM3510-8-ds 20 kg floor | 3.0 135.0 5.0 | 1.55 | 1.11 | False | grip | 1.38 | 2.50 |
| GIM3510-8-ds 20 kg floor 20% | 1.0 45.0 3.0 | 0.33 | 0.26 | True | grip | 0.23 | 7.50 |
| GIM3510-8-ds 20 kg floor 20% | 1.0 45.0 5.0 | 0.26 | 0.15 | False | grip | 0.39 | 9.50 |
| GIM3510-8-ds 20 kg floor 20% | 1.0 90.0 3.0 | 0.50 | 0.47 | True | torque | 0.19 | 7.50 |
| GIM3510-8-ds 20 kg floor 20% | 1.0 90.0 5.0 | 0.44 | 0.28 | False | grip | 0.51 | 2.50 |
| GIM3510-8-ds 20 kg floor 20% | 1.0 135.0 3.0 | 0.65 | 0.62 | True | torque | 0.13 | 0.50 |
| GIM3510-8-ds 20 kg floor 20% | 1.0 135.0 5.0 | 0.51 | 0.37 | False | torque | 0.49 | 2.00 |
| GIM3510-8-ds 20 kg floor 20% | 2.0 45.0 3.0 | 0.54 | 0.51 | False | torque | 0.37 | 8.00 |
| GIM3510-8-ds 20 kg floor 20% | 2.0 45.0 5.0 | 0.43 | 0.31 | False | grip | 0.70 | 6.00 |
| GIM3510-8-ds 20 kg floor 20% | 2.0 90.0 3.0 | 1.04 | 0.94 | False | torque | 0.41 | 4.50 |
| GIM3510-8-ds 20 kg floor 20% | 2.0 90.0 5.0 | 0.83 | 0.57 | False | grip | 0.86 | 6.50 |
| GIM3510-8-ds 20 kg floor 20% | 2.0 135.0 3.0 | 1.32 | 1.23 | True | torque | 0.32 | 2.00 |
| GIM3510-8-ds 20 kg floor 20% | 2.0 135.0 5.0 | 1.05 | 0.74 | False | grip | 0.92 | 2.00 |
| GIM3510-8-ds 20 kg floor 20% | 3.0 45.0 3.0 | 0.97 | 0.77 | False | rpm | 0.52 | 5.00 |
| GIM3510-8-ds 20 kg floor 20% | 3.0 45.0 5.0 | 0.71 | 0.46 | False | grip | 0.95 | 6.00 |
| GIM3510-8-ds 20 kg floor 20% | 3.0 90.0 3.0 | 1.67 | 1.41 | False | supply | 0.66 | 5.00 |
| GIM3510-8-ds 20 kg floor 20% | 3.0 90.0 5.0 | 1.30 | 0.85 | False | supply | 1.21 | 4.50 |
| GIM3510-8-ds 20 kg floor 20% | 3.0 135.0 3.0 | 2.09 | 1.85 | False | rpm | 0.51 | 4.50 |
| GIM3510-8-ds 20 kg floor 20% | 3.0 135.0 5.0 | 1.69 | 1.11 | False | grip | 1.39 | 3.50 |
| GIM4305-10-ds 10 kg carpet | 1.0 45.0 3.0 | 0.30 | 0.26 | True | grip | 0.27 | 16.00 |
| GIM4305-10-ds 10 kg carpet | 1.0 45.0 5.0 | 0.25 | 0.15 | False | grip | 0.41 | 16.50 |
| GIM4305-10-ds 10 kg carpet | 1.0 90.0 3.0 | 0.49 | 0.47 | True | ok | 0.18 | 9.50 |
| GIM4305-10-ds 10 kg carpet | 1.0 90.0 5.0 | 0.41 | 0.28 | False | grip | 0.44 | 14.50 |
| GIM4305-10-ds 10 kg carpet | 1.0 135.0 3.0 | 0.65 | 0.62 | True | ok | 0.14 | 3.50 |
| GIM4305-10-ds 10 kg carpet | 1.0 135.0 5.0 | 0.52 | 0.37 | False | torque | 0.52 | 3.50 |
| GIM4305-10-ds 10 kg carpet | 2.0 45.0 3.0 | 0.58 | 0.51 | False | rpm | 0.48 | 14.50 |
| GIM4305-10-ds 10 kg carpet | 2.0 45.0 5.0 | 0.44 | 0.31 | False | grip | 0.75 | 12.50 |
| GIM4305-10-ds 10 kg carpet | 2.0 90.0 3.0 | 1.12 | 0.94 | False | rpm | 0.40 | 12.50 |
| GIM4305-10-ds 10 kg carpet | 2.0 90.0 5.0 | 0.89 | 0.57 | False | grip | 0.85 | 13.50 |
| GIM4305-10-ds 10 kg carpet | 2.0 135.0 3.0 | 1.30 | 1.23 | True | rpm | 0.34 | 8.50 |
| GIM4305-10-ds 10 kg carpet | 2.0 135.0 5.0 | 1.02 | 0.74 | False | grip | 0.93 | 8.00 |
| GIM4305-10-ds 10 kg carpet | 3.0 45.0 3.0 | - | 0.77 | False | rpm | 0.69 | 7.50 |
| GIM4305-10-ds 10 kg carpet | 3.0 45.0 5.0 | - | 0.46 | False | rpm | 0.83 | 6.50 |
| GIM4305-10-ds 10 kg carpet | 3.0 90.0 3.0 | 1.91 | 1.41 | False | rpm | 0.75 | 7.50 |
| GIM4305-10-ds 10 kg carpet | 3.0 90.0 5.0 | 1.52 | 0.85 | False | grip | 1.25 | 8.50 |
| GIM4305-10-ds 10 kg carpet | 3.0 135.0 3.0 | - | 1.85 | False | rpm | 0.45 | 12.00 |
| GIM4305-10-ds 10 kg carpet | 3.0 135.0 5.0 | - | 1.11 | False | rpm | 1.28 | 11.50 |
| GIM4305-10-ds 10 kg carpet 20% | 1.0 45.0 3.0 | 0.30 | 0.26 | True | grip | 0.26 | 16.00 |
| GIM4305-10-ds 10 kg carpet 20% | 1.0 45.0 5.0 | 0.26 | 0.15 | False | grip | 0.41 | 16.50 |
| GIM4305-10-ds 10 kg carpet 20% | 1.0 90.0 3.0 | 0.49 | 0.47 | True | ok | 0.18 | 9.50 |
| GIM4305-10-ds 10 kg carpet 20% | 1.0 90.0 5.0 | 0.41 | 0.28 | False | grip | 0.44 | 15.00 |
| GIM4305-10-ds 10 kg carpet 20% | 1.0 135.0 3.0 | 0.65 | 0.62 | True | ok | 0.14 | 3.50 |
| GIM4305-10-ds 10 kg carpet 20% | 1.0 135.0 5.0 | 0.52 | 0.37 | False | wheel-hop | 0.51 | 3.50 |
| GIM4305-10-ds 10 kg carpet 20% | 2.0 45.0 3.0 | 0.64 | 0.51 | False | rpm | 0.46 | 14.50 |
| GIM4305-10-ds 10 kg carpet 20% | 2.0 45.0 5.0 | 0.56 | 0.31 | False | grip | 0.73 | 10.00 |
| GIM4305-10-ds 10 kg carpet 20% | 2.0 90.0 3.0 | 1.18 | 0.94 | False | rpm | 0.45 | 12.50 |
| GIM4305-10-ds 10 kg carpet 20% | 2.0 90.0 5.0 | 0.92 | 0.57 | False | grip | 0.90 | 14.50 |
| GIM4305-10-ds 10 kg carpet 20% | 2.0 135.0 3.0 | 1.31 | 1.23 | True | rpm | 0.29 | 9.50 |
| GIM4305-10-ds 10 kg carpet 20% | 2.0 135.0 5.0 | 1.08 | 0.74 | False | rpm | 0.93 | 6.00 |
| GIM4305-10-ds 10 kg carpet 20% | 3.0 45.0 3.0 | - | 0.77 | False | rpm | 0.69 | 12.00 |
| GIM4305-10-ds 10 kg carpet 20% | 3.0 45.0 5.0 | - | 0.46 | False | rpm | 0.79 | 11.00 |
| GIM4305-10-ds 10 kg carpet 20% | 3.0 90.0 3.0 | - | 1.41 | False | grip | 0.73 | 13.00 |
| GIM4305-10-ds 10 kg carpet 20% | 3.0 90.0 5.0 | 2.86 | 0.85 | False | grip | 1.24 | 12.50 |
| GIM4305-10-ds 10 kg carpet 20% | 3.0 135.0 3.0 | - | 1.85 | False | rpm | 0.46 | 12.50 |
| GIM4305-10-ds 10 kg carpet 20% | 3.0 135.0 5.0 | - | 1.11 | False | rpm | 1.20 | 8.00 |
| GIM4305-10-ds 10 kg floor | 1.0 45.0 3.0 | 0.30 | 0.26 | True | grip | 0.23 | 7.00 |
| GIM4305-10-ds 10 kg floor | 1.0 45.0 5.0 | 0.25 | 0.15 | False | grip | 0.41 | 7.00 |
| GIM4305-10-ds 10 kg floor | 1.0 90.0 3.0 | 0.52 | 0.47 | True | ok | 0.20 | 7.50 |
| GIM4305-10-ds 10 kg floor | 1.0 90.0 5.0 | 0.48 | 0.28 | False | grip | 0.45 | 10.50 |
| GIM4305-10-ds 10 kg floor | 1.0 135.0 3.0 | 0.64 | 0.62 | True | ok | 0.14 | 4.50 |
| GIM4305-10-ds 10 kg floor | 1.0 135.0 5.0 | 0.51 | 0.37 | False | torque | 0.51 | 2.50 |
| GIM4305-10-ds 10 kg floor | 2.0 45.0 3.0 | 0.64 | 0.51 | False | rpm | 0.42 | 8.50 |
| GIM4305-10-ds 10 kg floor | 2.0 45.0 5.0 | 0.43 | 0.31 | False | grip | 0.63 | 6.00 |
| GIM4305-10-ds 10 kg floor | 2.0 90.0 3.0 | 1.08 | 0.94 | False | wheel-hop | 0.38 | 6.50 |
| GIM4305-10-ds 10 kg floor | 2.0 90.0 5.0 | 0.82 | 0.57 | False | grip | 0.85 | 8.50 |
| GIM4305-10-ds 10 kg floor | 2.0 135.0 3.0 | 1.32 | 1.23 | True | rpm | 0.28 | 9.50 |
| GIM4305-10-ds 10 kg floor | 2.0 135.0 5.0 | 1.03 | 0.74 | False | rpm | 0.88 | 5.00 |
| GIM4305-10-ds 10 kg floor | 3.0 45.0 3.0 | - | 0.77 | False | rpm | 0.63 | 6.50 |
| GIM4305-10-ds 10 kg floor | 3.0 45.0 5.0 | - | 0.46 | False | rpm | 0.86 | 6.00 |
| GIM4305-10-ds 10 kg floor | 3.0 90.0 3.0 | 1.80 | 1.41 | False | rpm | 0.70 | 5.50 |
| GIM4305-10-ds 10 kg floor | 3.0 90.0 5.0 | 1.36 | 0.85 | False | grip | 1.17 | 5.50 |
| GIM4305-10-ds 10 kg floor | 3.0 135.0 3.0 | - | 1.85 | False | rpm | 0.48 | 9.50 |
| GIM4305-10-ds 10 kg floor | 3.0 135.0 5.0 | - | 1.11 | False | rpm | 1.17 | 5.50 |
| GIM4305-10-ds 10 kg floor 20% | 1.0 45.0 3.0 | 0.32 | 0.26 | True | grip | 0.23 | 6.50 |
| GIM4305-10-ds 10 kg floor 20% | 1.0 45.0 5.0 | 0.26 | 0.15 | False | grip | 0.41 | 7.00 |
| GIM4305-10-ds 10 kg floor 20% | 1.0 90.0 3.0 | 0.52 | 0.47 | True | ok | 0.20 | 7.50 |
| GIM4305-10-ds 10 kg floor 20% | 1.0 90.0 5.0 | 0.48 | 0.28 | False | grip | 0.45 | 10.50 |
| GIM4305-10-ds 10 kg floor 20% | 1.0 135.0 3.0 | 0.64 | 0.62 | True | ok | 0.14 | 4.50 |
| GIM4305-10-ds 10 kg floor 20% | 1.0 135.0 5.0 | 0.54 | 0.37 | False | wheel-hop | 0.51 | 4.00 |
| GIM4305-10-ds 10 kg floor 20% | 2.0 45.0 3.0 | 0.65 | 0.51 | False | rpm | 0.47 | 8.00 |
| GIM4305-10-ds 10 kg floor 20% | 2.0 45.0 5.0 | 0.52 | 0.31 | False | grip | 0.65 | 4.50 |
| GIM4305-10-ds 10 kg floor 20% | 2.0 90.0 3.0 | 1.11 | 0.94 | False | rpm | 0.39 | 6.00 |
| GIM4305-10-ds 10 kg floor 20% | 2.0 90.0 5.0 | 0.79 | 0.57 | False | grip | 0.80 | 7.00 |
| GIM4305-10-ds 10 kg floor 20% | 2.0 135.0 3.0 | 1.34 | 1.23 | True | rpm | 0.33 | 5.00 |
| GIM4305-10-ds 10 kg floor 20% | 2.0 135.0 5.0 | 1.06 | 0.74 | False | rpm | 0.88 | 7.00 |
| GIM4305-10-ds 10 kg floor 20% | 3.0 45.0 3.0 | - | 0.77 | False | rpm | 0.56 | 5.00 |
| GIM4305-10-ds 10 kg floor 20% | 3.0 45.0 5.0 | - | 0.46 | False | rpm | 0.75 | 5.50 |
| GIM4305-10-ds 10 kg floor 20% | 3.0 90.0 3.0 | 2.14 | 1.41 | False | grip | 0.66 | 5.50 |
| GIM4305-10-ds 10 kg floor 20% | 3.0 90.0 5.0 | 1.56 | 0.85 | False | grip | 0.98 | 7.50 |
| GIM4305-10-ds 10 kg floor 20% | 3.0 135.0 3.0 | - | 1.85 | False | rpm | 0.48 | 6.50 |
| GIM4305-10-ds 10 kg floor 20% | 3.0 135.0 5.0 | - | 1.11 | False | rpm | 1.01 | 5.00 |
| GIM4305-10-ds 20 kg carpet | 1.0 45.0 3.0 | 0.36 | 0.26 | True | torque | 0.27 | 6.00 |
| GIM4305-10-ds 20 kg carpet | 1.0 45.0 5.0 | 0.26 | 0.15 | False | grip | 0.41 | 7.00 |
| GIM4305-10-ds 20 kg carpet | 1.0 90.0 3.0 | 0.51 | 0.47 | True | torque | 0.18 | 4.50 |
| GIM4305-10-ds 20 kg carpet | 1.0 90.0 5.0 | 0.43 | 0.28 | False | grip | 0.51 | 4.50 |
| GIM4305-10-ds 20 kg carpet | 1.0 135.0 3.0 | 0.65 | 0.62 | True | torque | 0.15 | 0.50 |
| GIM4305-10-ds 20 kg carpet | 1.0 135.0 5.0 | 0.55 | 0.37 | False | torque | 0.52 | 1.00 |
| GIM4305-10-ds 20 kg carpet | 2.0 45.0 3.0 | 0.70 | 0.51 | False | rpm | 0.43 | 9.50 |
| GIM4305-10-ds 20 kg carpet | 2.0 45.0 5.0 | 0.62 | 0.31 | False | grip | 0.71 | 10.00 |
| GIM4305-10-ds 20 kg carpet | 2.0 90.0 3.0 | 1.04 | 0.94 | False | rpm | 0.44 | 8.50 |
| GIM4305-10-ds 20 kg carpet | 2.0 90.0 5.0 | 0.86 | 0.57 | False | grip | 0.81 | 14.00 |
| GIM4305-10-ds 20 kg carpet | 2.0 135.0 3.0 | 1.41 | 1.23 | False | rpm | 0.36 | 7.50 |
| GIM4305-10-ds 20 kg carpet | 2.0 135.0 5.0 | 1.21 | 0.74 | False | rpm | 1.01 | 2.50 |
| GIM4305-10-ds 20 kg carpet | 3.0 45.0 3.0 | - | 0.77 | False | rpm | 0.74 | 10.00 |
| GIM4305-10-ds 20 kg carpet | 3.0 45.0 5.0 | - | 0.46 | False | grip | 0.93 | 9.50 |
| GIM4305-10-ds 20 kg carpet | 3.0 90.0 3.0 | 2.20 | 1.41 | False | grip | 0.76 | 6.50 |
| GIM4305-10-ds 20 kg carpet | 3.0 90.0 5.0 | 2.03 | 0.85 | False | grip | 1.24 | 9.50 |
| GIM4305-10-ds 20 kg carpet | 3.0 135.0 3.0 | - | 1.85 | False | rpm | 0.75 | 9.50 |
| GIM4305-10-ds 20 kg carpet | 3.0 135.0 5.0 | - | 1.11 | False | grip | 1.36 | 5.50 |
| GIM4305-10-ds 20 kg carpet 20% | 1.0 45.0 3.0 | 0.43 | 0.26 | True | rpm | 0.28 | 9.50 |
| GIM4305-10-ds 20 kg carpet 20% | 1.0 45.0 5.0 | 0.34 | 0.15 | False | grip | 0.41 | 7.50 |
| GIM4305-10-ds 20 kg carpet 20% | 1.0 90.0 3.0 | 0.50 | 0.47 | True | torque | 0.19 | 5.50 |
| GIM4305-10-ds 20 kg carpet 20% | 1.0 90.0 5.0 | 0.44 | 0.28 | False | grip | 0.51 | 4.00 |
| GIM4305-10-ds 20 kg carpet 20% | 1.0 135.0 3.0 | 0.65 | 0.62 | True | torque | 0.15 | 1.50 |
| GIM4305-10-ds 20 kg carpet 20% | 1.0 135.0 5.0 | 0.55 | 0.37 | False | torque | 0.52 | 1.00 |
| GIM4305-10-ds 20 kg carpet 20% | 2.0 45.0 3.0 | 0.91 | 0.51 | False | rpm | 0.49 | 10.00 |
| GIM4305-10-ds 20 kg carpet 20% | 2.0 45.0 5.0 | 0.80 | 0.31 | False | grip | 0.68 | 6.00 |
| GIM4305-10-ds 20 kg carpet 20% | 2.0 90.0 3.0 | 1.12 | 0.94 | False | rpm | 0.44 | 10.00 |
| GIM4305-10-ds 20 kg carpet 20% | 2.0 90.0 5.0 | 0.91 | 0.57 | False | grip | 0.83 | 8.00 |
| GIM4305-10-ds 20 kg carpet 20% | 2.0 135.0 3.0 | 1.69 | 1.23 | False | rpm | 0.48 | 4.00 |
| GIM4305-10-ds 20 kg carpet 20% | 2.0 135.0 5.0 | 1.46 | 0.74 | False | rpm | 1.04 | 3.50 |
| GIM4305-10-ds 20 kg carpet 20% | 3.0 45.0 3.0 | - | 0.77 | False | rpm | 0.72 | 8.50 |
| GIM4305-10-ds 20 kg carpet 20% | 3.0 45.0 5.0 | - | 0.46 | False | grip | 0.87 | 7.50 |
| GIM4305-10-ds 20 kg carpet 20% | 3.0 90.0 3.0 | - | 1.41 | False | grip | 0.89 | 10.50 |
| GIM4305-10-ds 20 kg carpet 20% | 3.0 90.0 5.0 | - | 0.85 | False | grip | 1.25 | 8.50 |
| GIM4305-10-ds 20 kg carpet 20% | 3.0 135.0 3.0 | - | 1.85 | False | rpm | 0.75 | 5.00 |
| GIM4305-10-ds 20 kg carpet 20% | 3.0 135.0 5.0 | - | 1.11 | False | grip | 1.23 | 9.00 |
| GIM4305-10-ds 20 kg floor | 1.0 45.0 3.0 | 0.35 | 0.26 | True | grip | 0.23 | 6.50 |
| GIM4305-10-ds 20 kg floor | 1.0 45.0 5.0 | 0.25 | 0.15 | False | grip | 0.37 | 4.50 |
| GIM4305-10-ds 20 kg floor | 1.0 90.0 3.0 | 0.50 | 0.47 | True | torque | 0.19 | 4.00 |
| GIM4305-10-ds 20 kg floor | 1.0 90.0 5.0 | 0.42 | 0.28 | False | grip | 0.52 | 2.00 |
| GIM4305-10-ds 20 kg floor | 1.0 135.0 3.0 | 0.64 | 0.62 | True | torque | 0.14 | 0.50 |
| GIM4305-10-ds 20 kg floor | 1.0 135.0 5.0 | 0.50 | 0.37 | False | torque | 0.48 | 2.00 |
| GIM4305-10-ds 20 kg floor | 2.0 45.0 3.0 | 0.67 | 0.51 | False | rpm | 0.36 | 5.50 |
| GIM4305-10-ds 20 kg floor | 2.0 45.0 5.0 | 0.54 | 0.31 | False | grip | 0.66 | 4.50 |
| GIM4305-10-ds 20 kg floor | 2.0 90.0 3.0 | 1.07 | 0.94 | False | torque | 0.38 | 6.50 |
| GIM4305-10-ds 20 kg floor | 2.0 90.0 5.0 | 0.83 | 0.57 | False | grip | 0.84 | 5.50 |
| GIM4305-10-ds 20 kg floor | 2.0 135.0 3.0 | 1.38 | 1.23 | True | rpm | 0.35 | 1.50 |
| GIM4305-10-ds 20 kg floor | 2.0 135.0 5.0 | 1.13 | 0.74 | False | grip | 0.92 | 1.50 |
| GIM4305-10-ds 20 kg floor | 3.0 45.0 3.0 | - | 0.77 | False | rpm | 0.61 | 4.50 |
| GIM4305-10-ds 20 kg floor | 3.0 45.0 5.0 | - | 0.46 | False | grip | 0.84 | 6.50 |
| GIM4305-10-ds 20 kg floor | 3.0 90.0 3.0 | 1.93 | 1.41 | False | grip | 0.74 | 6.00 |
| GIM4305-10-ds 20 kg floor | 3.0 90.0 5.0 | 1.59 | 0.85 | False | grip | 1.26 | 4.50 |
| GIM4305-10-ds 20 kg floor | 3.0 135.0 3.0 | - | 1.85 | False | rpm | 0.67 | 4.00 |
| GIM4305-10-ds 20 kg floor | 3.0 135.0 5.0 | - | 1.11 | False | grip | 1.28 | 3.00 |
| GIM4305-10-ds 20 kg floor 20% | 1.0 45.0 3.0 | 0.35 | 0.26 | True | grip | 0.23 | 6.00 |
| GIM4305-10-ds 20 kg floor 20% | 1.0 45.0 5.0 | 0.26 | 0.15 | False | grip | 0.39 | 7.50 |
| GIM4305-10-ds 20 kg floor 20% | 1.0 90.0 3.0 | 0.50 | 0.47 | True | torque | 0.19 | 4.00 |
| GIM4305-10-ds 20 kg floor 20% | 1.0 90.0 5.0 | 0.42 | 0.28 | False | grip | 0.52 | 4.50 |
| GIM4305-10-ds 20 kg floor 20% | 1.0 135.0 3.0 | 0.65 | 0.62 | True | torque | 0.14 | 0.50 |
| GIM4305-10-ds 20 kg floor 20% | 1.0 135.0 5.0 | 0.51 | 0.37 | False | torque | 0.47 | 1.50 |
| GIM4305-10-ds 20 kg floor 20% | 2.0 45.0 3.0 | 0.74 | 0.51 | False | rpm | 0.40 | 5.50 |
| GIM4305-10-ds 20 kg floor 20% | 2.0 45.0 5.0 | 0.65 | 0.31 | False | grip | 0.68 | 5.50 |
| GIM4305-10-ds 20 kg floor 20% | 2.0 90.0 3.0 | 1.05 | 0.94 | False | rpm | 0.41 | 6.00 |
| GIM4305-10-ds 20 kg floor 20% | 2.0 90.0 5.0 | 0.83 | 0.57 | False | grip | 0.86 | 5.00 |
| GIM4305-10-ds 20 kg floor 20% | 2.0 135.0 3.0 | 1.51 | 1.23 | False | rpm | 0.39 | 4.00 |
| GIM4305-10-ds 20 kg floor 20% | 2.0 135.0 5.0 | 1.32 | 0.74 | False | grip | 0.97 | 1.50 |
| GIM4305-10-ds 20 kg floor 20% | 3.0 45.0 3.0 | - | 0.77 | False | rpm | 0.56 | 7.00 |
| GIM4305-10-ds 20 kg floor 20% | 3.0 45.0 5.0 | - | 0.46 | False | grip | 0.74 | 4.50 |
| GIM4305-10-ds 20 kg floor 20% | 3.0 90.0 3.0 | 2.84 | 1.41 | False | grip | 0.77 | 4.50 |
| GIM4305-10-ds 20 kg floor 20% | 3.0 90.0 5.0 | 2.61 | 0.85 | False | grip | 1.12 | 5.00 |
| GIM4305-10-ds 20 kg floor 20% | 3.0 135.0 3.0 | - | 1.85 | False | rpm | 0.63 | 3.50 |
| GIM4305-10-ds 20 kg floor 20% | 3.0 135.0 5.0 | - | 1.11 | False | grip | 1.16 | 2.50 |
| M2006-ds 10 kg carpet | 1.0 45.0 3.0 | 0.43 | 0.26 | True | torque | 0.27 | 9.00 |
| M2006-ds 10 kg carpet | 1.0 45.0 5.0 | 0.33 | 0.15 | False | grip | 0.42 | 10.50 |
| M2006-ds 10 kg carpet | 1.0 90.0 3.0 | 0.52 | 0.47 | True | torque | 0.19 | 10.00 |
| M2006-ds 10 kg carpet | 1.0 90.0 5.0 | 0.46 | 0.28 | False | grip | 0.54 | 5.50 |
| M2006-ds 10 kg carpet | 1.0 135.0 3.0 | 0.66 | 0.62 | True | torque | 0.19 | 3.00 |
| M2006-ds 10 kg carpet | 1.0 135.0 5.0 | 0.55 | 0.37 | False | torque | 0.55 | 1.50 |
| M2006-ds 10 kg carpet | 2.0 45.0 3.0 | 0.61 | 0.51 | False | torque | 0.43 | 12.50 |
| M2006-ds 10 kg carpet | 2.0 45.0 5.0 | 0.45 | 0.31 | False | grip | 0.67 | 9.50 |
| M2006-ds 10 kg carpet | 2.0 90.0 3.0 | 1.10 | 0.94 | False | torque | 0.49 | 7.50 |
| M2006-ds 10 kg carpet | 2.0 90.0 5.0 | 0.92 | 0.57 | False | grip | 0.83 | 9.50 |
| M2006-ds 10 kg carpet | 2.0 135.0 3.0 | 1.31 | 1.23 | True | torque | 0.29 | 8.00 |
| M2006-ds 10 kg carpet | 2.0 135.0 5.0 | 1.08 | 0.74 | False | torque | 1.05 | 4.00 |
| M2006-ds 10 kg carpet | 3.0 45.0 3.0 | 0.87 | 0.77 | False | torque | 0.56 | 11.00 |
| M2006-ds 10 kg carpet | 3.0 45.0 5.0 | 0.66 | 0.46 | False | grip | 0.89 | 8.00 |
| M2006-ds 10 kg carpet | 3.0 90.0 3.0 | 1.62 | 1.41 | False | torque | 0.69 | 10.50 |
| M2006-ds 10 kg carpet | 3.0 90.0 5.0 | 1.34 | 0.85 | False | grip | 1.22 | 10.50 |
| M2006-ds 10 kg carpet | 3.0 135.0 3.0 | 1.92 | 1.85 | True | torque | 0.39 | 8.50 |
| M2006-ds 10 kg carpet | 3.0 135.0 5.0 | 1.61 | 1.11 | False | torque | 1.62 | 6.50 |
| M2006-ds 10 kg carpet 20% | 1.0 45.0 3.0 | 0.43 | 0.26 | True | torque | 0.27 | 9.00 |
| M2006-ds 10 kg carpet 20% | 1.0 45.0 5.0 | 0.33 | 0.15 | False | grip | 0.42 | 10.50 |
| M2006-ds 10 kg carpet 20% | 1.0 90.0 3.0 | 0.52 | 0.47 | True | torque | 0.19 | 10.00 |
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
| M2006-ds 20 kg floor 20% | 2.0 135.0 5.0 | 1.59 | 0.74 | False | grip | 1.47 | 1.50 |
| M2006-ds 20 kg floor 20% | 3.0 45.0 3.0 | 1.44 | 0.77 | False | rpm | 0.62 | 4.00 |
| M2006-ds 20 kg floor 20% | 3.0 45.0 5.0 | 1.36 | 0.46 | False | rpm | 1.12 | 5.00 |
| M2006-ds 20 kg floor 20% | 3.0 90.0 3.0 | 2.18 | 1.41 | False | grip | 1.22 | 5.50 |
| M2006-ds 20 kg floor 20% | 3.0 90.0 5.0 | 2.12 | 0.85 | False | grip | 1.91 | 5.00 |
| M2006-ds 20 kg floor 20% | 3.0 135.0 3.0 | 3.40 | 1.85 | False | torque | 1.18 | 2.00 |
| M2006-ds 20 kg floor 20% | 3.0 135.0 5.0 | - | 1.11 | False | torque | 2.07 | 1.50 |
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
