fernandomierhicks/omni-robot/rpi.md

# The Raspberry Pi camera head ("omni-cam"): network, access, software

Everything a session needs to reach the Pi and work on it. The board is a **Raspberry Pi 4 Model B (4 GB, Rev 1.5) with an Arducam 12MP Camera Module 3 (IMX708)**. It rehearses design.md 4.9's proposed camera head, a Pi 5 with two Pi Global Shutter cameras that doesn't exist yet. A Pi 5 would be set up the same way (same OS, user, key, `pi.sh`); only the hostname would change. It runs on Wi-Fi by default; for bulk copies and honest network numbers it goes on a wired switch with the PC (section "Wired Ethernet"). Results and setup history: [characterization/pi_camera/README.md](characterization/pi_camera/README.md).

## Network

```
                    AT&T router 192.168.1.254 (DHCP, DNS suffix attlocal.net)
                    Wi-Fi "Minnexico_5ghz", 192.168.1.0/24
                         |                                   |
   FernandoDesktop (Windows 11) 192.168.1.131      omni-cam (Pi 4) 192.168.1.90, wlan0
   + WSL2 Ubuntu-24.04, mirrored networking:       Ethernet unplugged (eth0 DHCP if plugged)
     the same 192.168.1.131
```

| | PC | Pi |
| --- | --- | --- |
| Name | `FernandoDesktop` (`FernandoDesktop.local` resolves on the Pi) | `omni-cam` (`omni-cam.local`, mDNS via avahi; resolves from Windows and WSL) |
| Address | 192.168.1.131, DHCP | 192.168.1.90, DHCP (no reservation: use the name, not the number) |
| MAC | | wlan0 `d8:3a:dd:e1:19:ea`, eth0 `d8:3a:dd:e1:19:e7` (for a router DHCP reservation, if wanted) |

**WSL networking is mirrored** (since Oct 30, `C:\Users\ferna\.wslconfig`: `[wsl2] networkingMode=mirrored`). WSL shares Windows' addresses, so the Pi reaches WSL at 192.168.1.131, and Windows ↔ WSL over `localhost` still works (Launcher, console, 3D view, face: checked for servers on 127.0.0.1 and 0.0.0.0). Undo: delete `.wslconfig`, then run `wsl --shutdown`.

**WSL's firewall** (Hyper-V firewall: inbound blocked by default) has one rule, `WSL-ROS2-DDS-LAN`: UDP 7400–32999 (ROS domains 0–101) from 192.168.1.0/24 allowed in. Check it with `Get-NetFirewallHyperVRule -Name WSL-ROS2-DDS-LAN`; remove it with `Remove-NetFirewallHyperVRule -Name WSL-ROS2-DDS-LAN` (admin). TCP from the LAN into WSL stays blocked, so the console on :8080 is not reachable from other devices.

## Wired Ethernet (Oct 31: PC and Pi on one switch)

Why: the throw recordings are 0.4-2.2 GB per location (`characterization/throw_track`, four streams ~440 MB a throw), and this room's Wi-Fi couldn't move them. On Oct 31 `scp` of location 3 (2.1 GB) stalled at 1.7 GB for 25 minutes and a 145 MB file timed out at 240 s (under 1 MB/s). Over the cable the same 145 MB `frames.npy` took 13 s (~11 MB/s) and a 2 GB location minutes.

**Setup used (Oct 31):** the PC and the Pi each plugged by an RJ45 cable into the **same Ethernet switch**. The Pi's `eth0` takes its address by DHCP (netplan from cloud-init), so a switch or router on the PC's network is all it needs: **192.168.0.101/24**, gateway 192.168.0.1 (a different network from the Wi-Fi's 192.168.1.0/24). `eth0` came up on boot with the cable attached; **hot-plugging a cable into a running Pi was not tested** (it was shut down, moved, and powered on with the cable in).

- **Both interfaces stay up.** `wlan0` (192.168.1.90) and `eth0` are both addressed; the default route prefers `eth0` (metric 100 against 600), so the Pi's own traffic goes over the wire, and the Wi-Fi address still answers SSH, handy for changing settings if the cable side misbehaves.
- **Link speed measured: 100 Mb/s**, not the gigabit a Pi 4 can do (`cat /sys/class/net/eth0/speed` = 100). Probably the cable or the switch port; not investigated. 100 Mb/s is ~11 MB/s, still far faster than the Wi-Fi was.
- **SSH to the wired address:** plain `ssh fernando@192.168.0.101` fails (`Host key verification failed`: the number isn't in `known_hosts`, and scripts use `BatchMode`). Reuse the Pi's known key with an alias: `ssh -o HostKeyAlias=omni-cam.local fernando@192.168.0.101` (same for `scp`). To make it a name, add to `C:\Users\ferna\.ssh\config`:

  ```
  Host omni-cam-eth
      HostName 192.168.0.101
      HostKeyAlias omni-cam.local
      User fernando
      IdentityFile ~/.ssh/id_ed25519
      ServerAliveInterval 30
  ```

  then `ssh omni-cam-eth`, or `OMNI_PI=omni-cam-eth bash characterization/throw_track/tt.sh rsfetch SESSION` (`tt.sh` takes the host from `OMNI_PI`). This entry is **not created yet**. The address is a DHCP lease (no reservation): check it with `ssh omni-cam 'ip -br a show eth0'` if it stops answering.
- **Not checked:** which of the two addresses `omni-cam.local` resolves to when both are up (mDNS may return either): use the wired address or the alias when speed matters. ROS between the PC and the Pi (section "ROS 2 between the PC (WSL) and the Pi") was **not** tried over the wire; the firewall rules and `ROS_STATIC_PEERS` below are written for the 192.168.1.x network, and WSL's mirrored networking would have to see the wired adapter's 192.168.0.x address.
- **Direct cable PC to Pi, no switch: not tried.** No DHCP server on that link, so `eth0` would have no address (link-local or a fixed address on both ends would have to be set up; `netplan` on the Pi, the adapter's IPv4 on the PC).
- **Copy a session and check it:** `scp -r -o BatchMode=yes -o HostKeyAlias=omni-cam.local fernando@192.168.0.101:omni_ws/throw_track/data/SESSION /c/Users/ferna/throw_data/`, then compare `find . -type f -printf '%s %p\n'` on both sides (names and sizes). Add `-o ServerAliveInterval=10 -o ServerAliveCountMax=3` and `timeout N` per file so a stalled link fails instead of hanging; a hung `scp -r` left two `/usr/bin/scp` processes running on the PC and had to be killed.
- **Shut down before moving it:** `ssh omni-cam 'sync; sudo shutdown -h now'` (check first that nothing is writing: `ps -eo pid,args | grep -E "[r]ecord_rs|[s]cp|[r]sync"`).

## SSH

- From Windows: `ssh omni-cam` (in Git Bash, or call `C:\Windows\System32\OpenSSH\ssh.exe` by full path; the PowerShell tool's PATH lacks it). Key login only: SSH password login is off.
- `C:\Users\ferna\.ssh\config`: `Host omni-cam`, `HostName omni-cam.local`, `User fernando`, `IdentityFile ~/.ssh/id_ed25519`, `ServerAliveInterval 30`. The key `id_ed25519` (ed25519, no passphrase, comment `fernando@pc-omni`) was made for this. Windows OpenSSH refuses a config or key that other local accounts can read: keep `icacls ... /inheritance:r /grant:r ferna:F SYSTEM:F Administrators:F` on them.
- User `fernando`: passwordless sudo (`NOPASSWD:ALL`, from cloud-init). Password (local console with a keyboard and monitor, and sudo if NOPASSWD is ever removed): `5VpNnhLC30cG`. SSH doesn't accept it (key login only). `sudo passwd fernando` over SSH sets a new one; update it here.
- Scripts use `ssh -o BatchMode=yes` (fail instead of prompting). VS Code: the Remote - SSH extension, host `omni-cam`.
- WSL has no key for the Pi: SSH from Windows. ROS between them needs none.
- If `ssh` times out while `ping omni-cam.local` answers, the Pi is hung (it was once, out of memory); only a power cycle by Fernando fixes it. A hard power-off is fine.
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
