fernandomierhicks/omni-robot/cad/other/Realsense to bucket/Screenshot 2026-10-30 152526.png

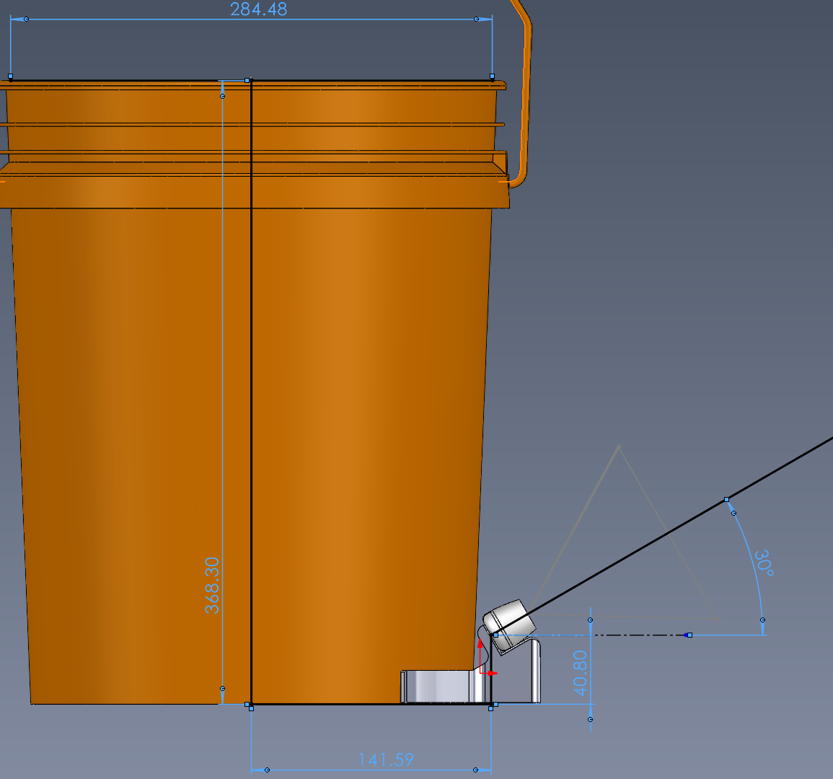
cad/other/Realsense to bucket/Screenshot 2026-10-30 152526.png
