fernandomierhicks/omni-robot/cad/out/renders/catch_module.png

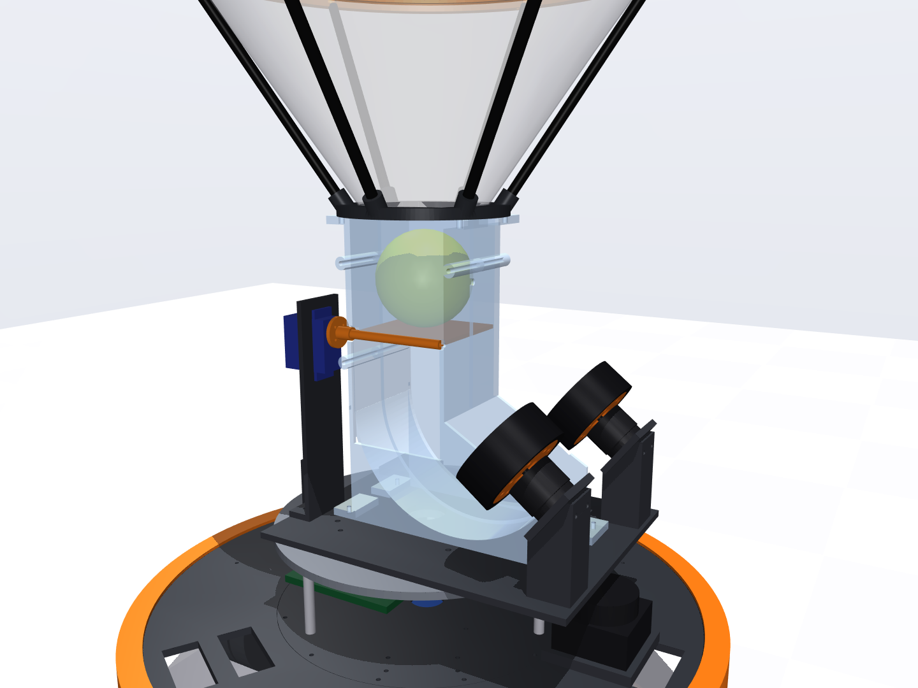
cad/out/renders/catch_module.png
