fernandomierhicks/omni-robot/cad/out/renders/launcher_side.png

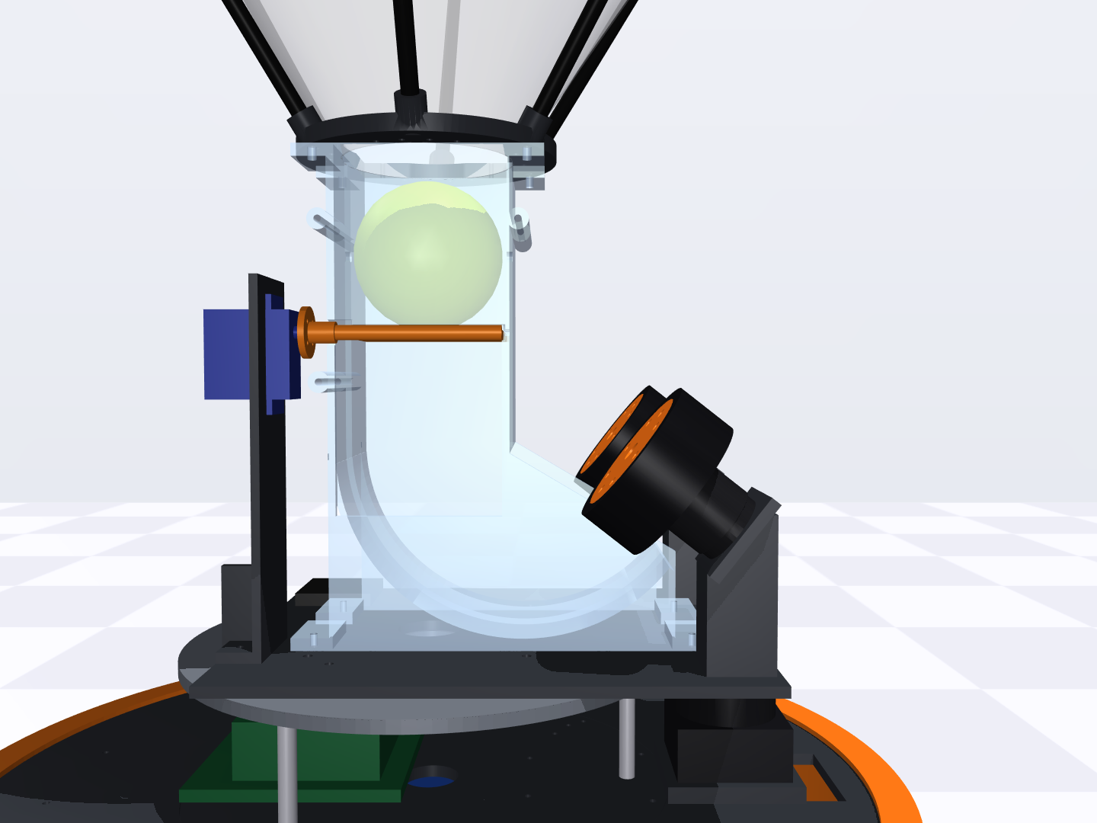
cad/out/renders/launcher_side.png
