fernandomierhicks/omni-robot/cad/v13/validation/chassis/fin_profiles.png

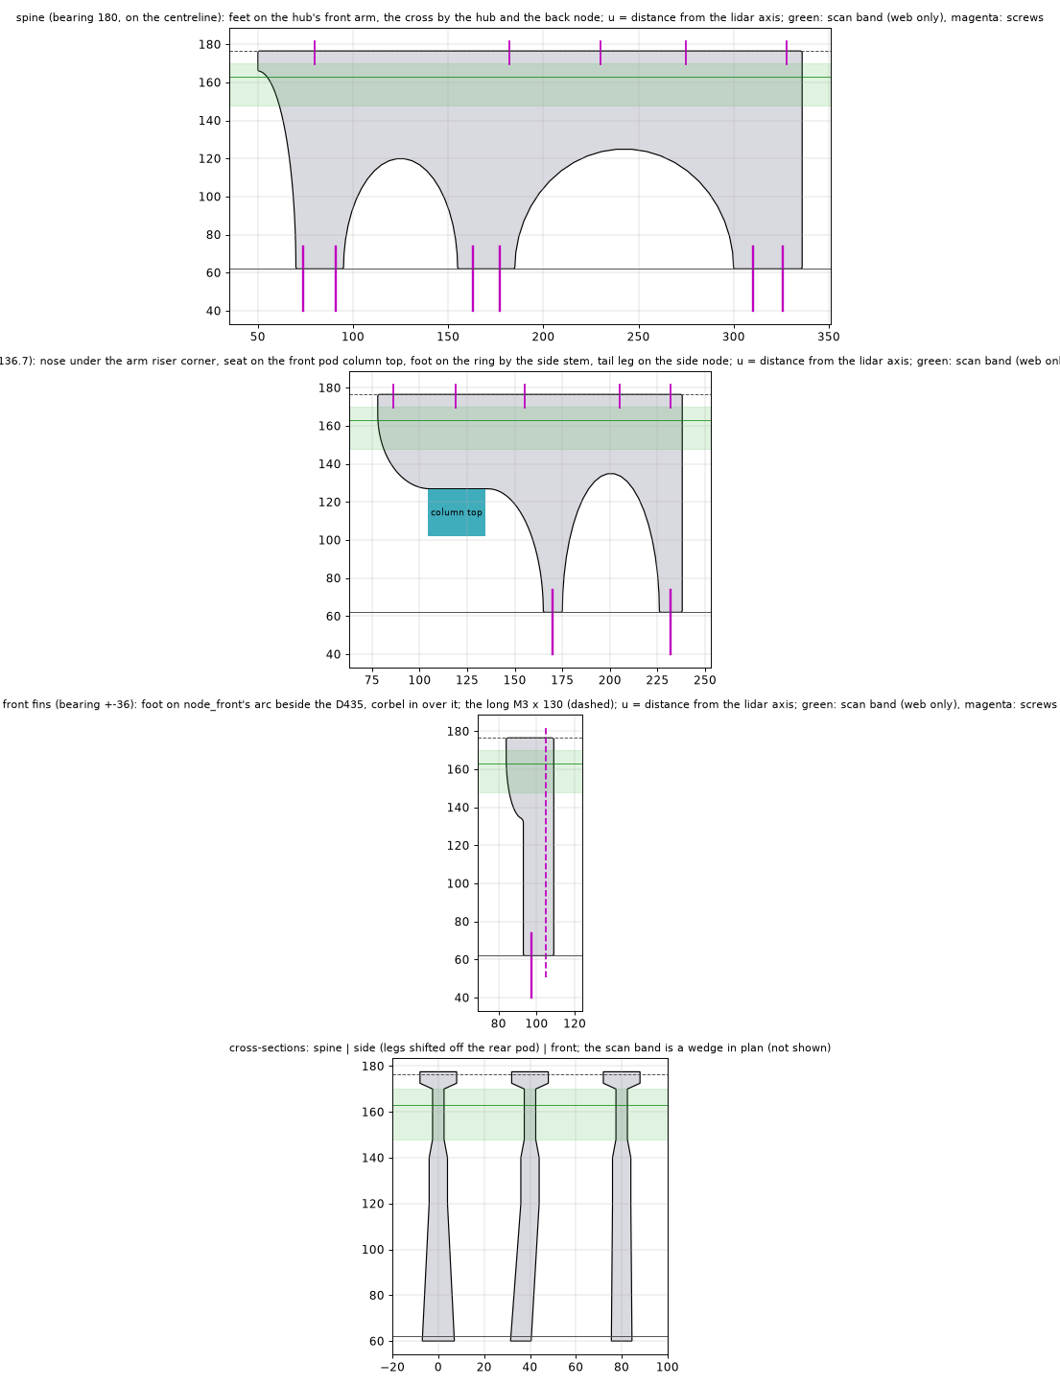
cad/v13/validation/chassis/fin_profiles.png
