fernandomierhicks/omni-robot/cad/v13/validation/chassis/iso_chassis.png

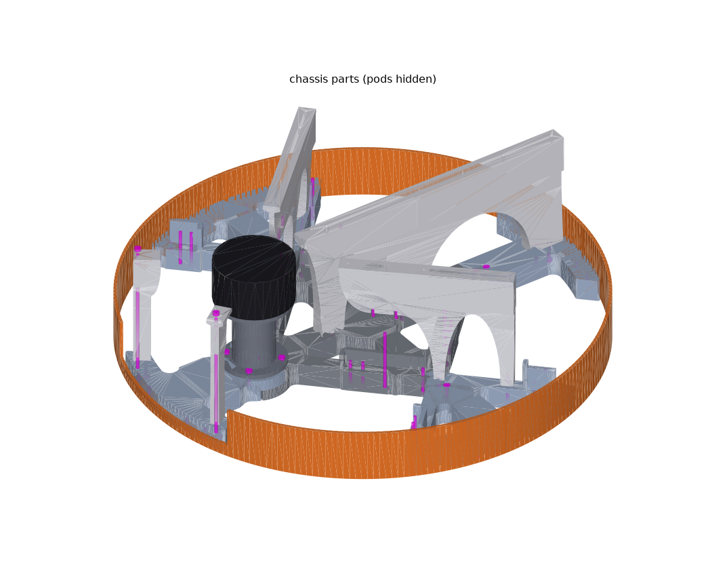
cad/v13/validation/chassis/iso_chassis.png
