fernandomierhicks/omni-robot/cad/v13/validation/chassis/iso_chassis_below.png

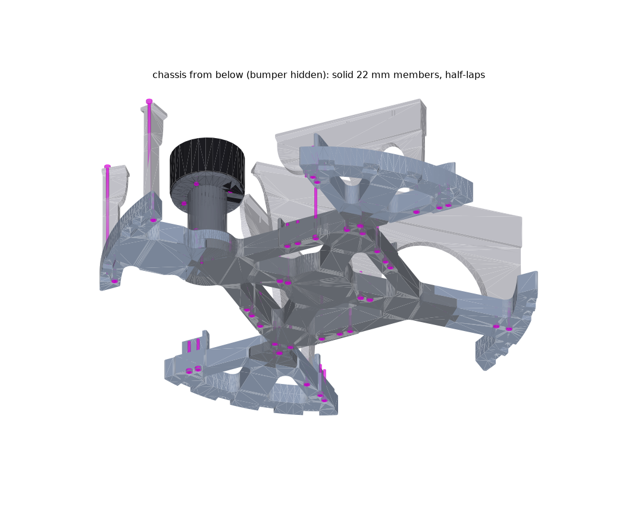
cad/v13/validation/chassis/iso_chassis_below.png
