fernandomierhicks/omni-robot/cad/v13/validation/chassis/iso_front_fins_fov.png

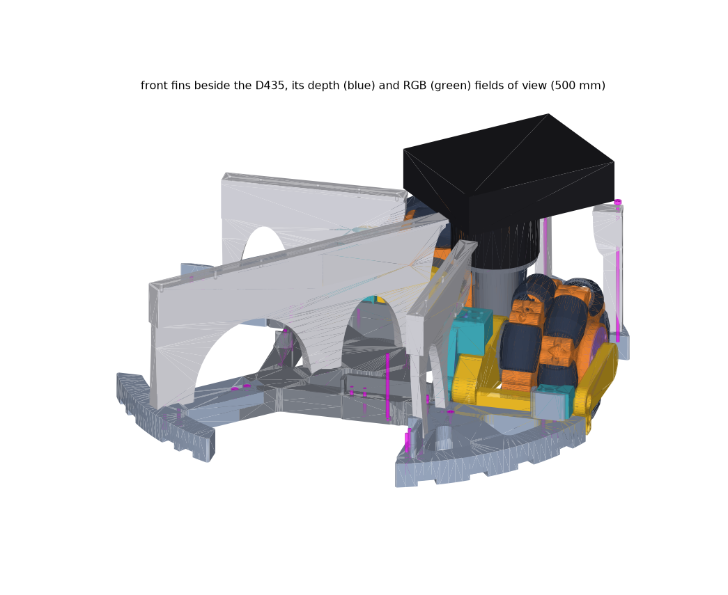
cad/v13/validation/chassis/iso_front_fins_fov.png
