fernandomierhicks/omni-robot/cad/v13/validation/chassis/iso_pod_pocket_FL.png

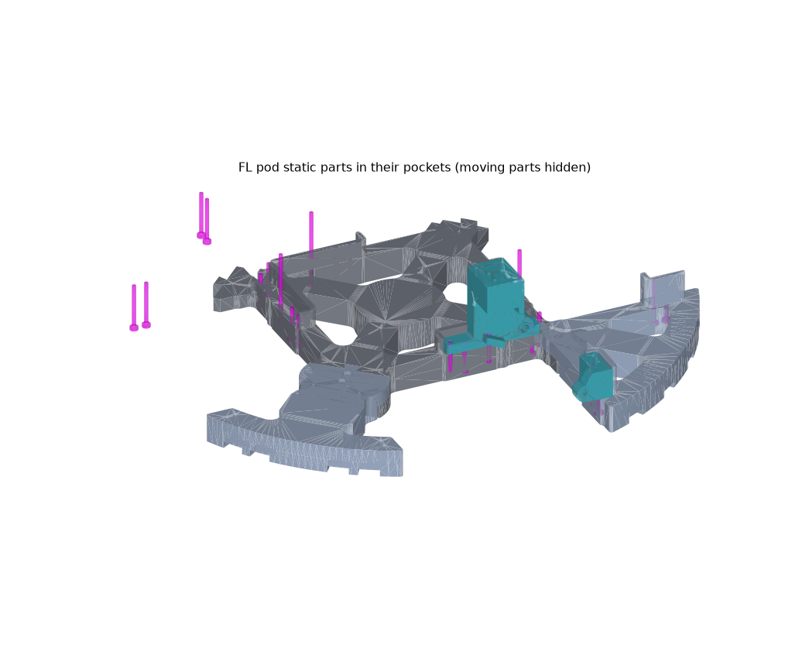
cad/v13/validation/chassis/iso_pod_pocket_FL.png
