fernandomierhicks/omni-robot/cad/v13/validation/chassis/iso_supports.png

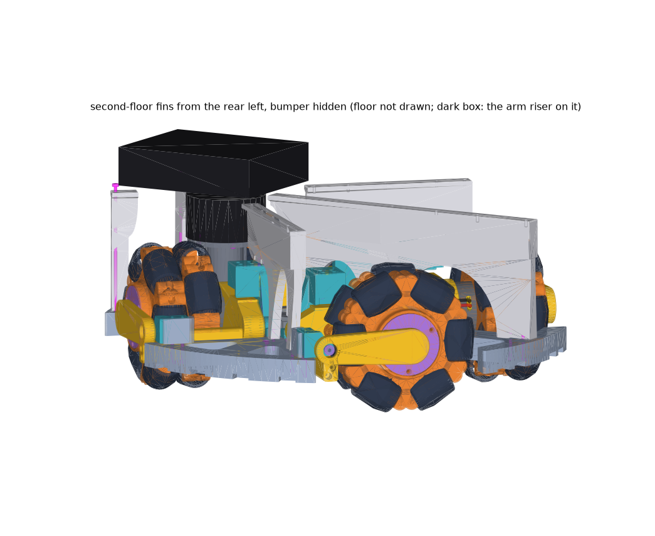
cad/v13/validation/chassis/iso_supports.png
