fernandomierhicks/omni-robot/cad/v13/validation/chassis/iso_with_pods.png

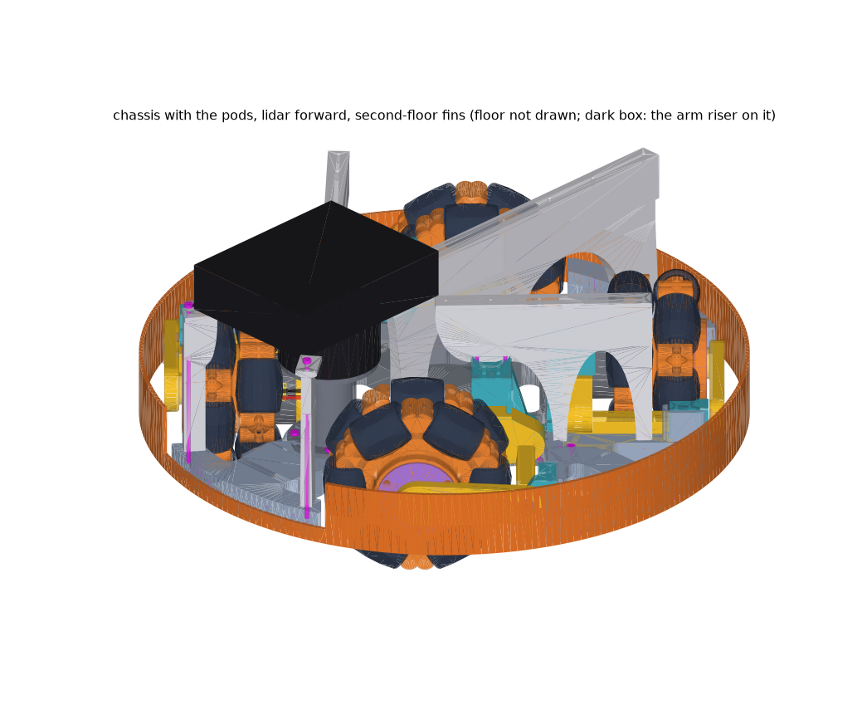
cad/v13/validation/chassis/iso_with_pods.png
