fernandomierhicks/omni-robot/cad/v13/validation/chassis/plan.png

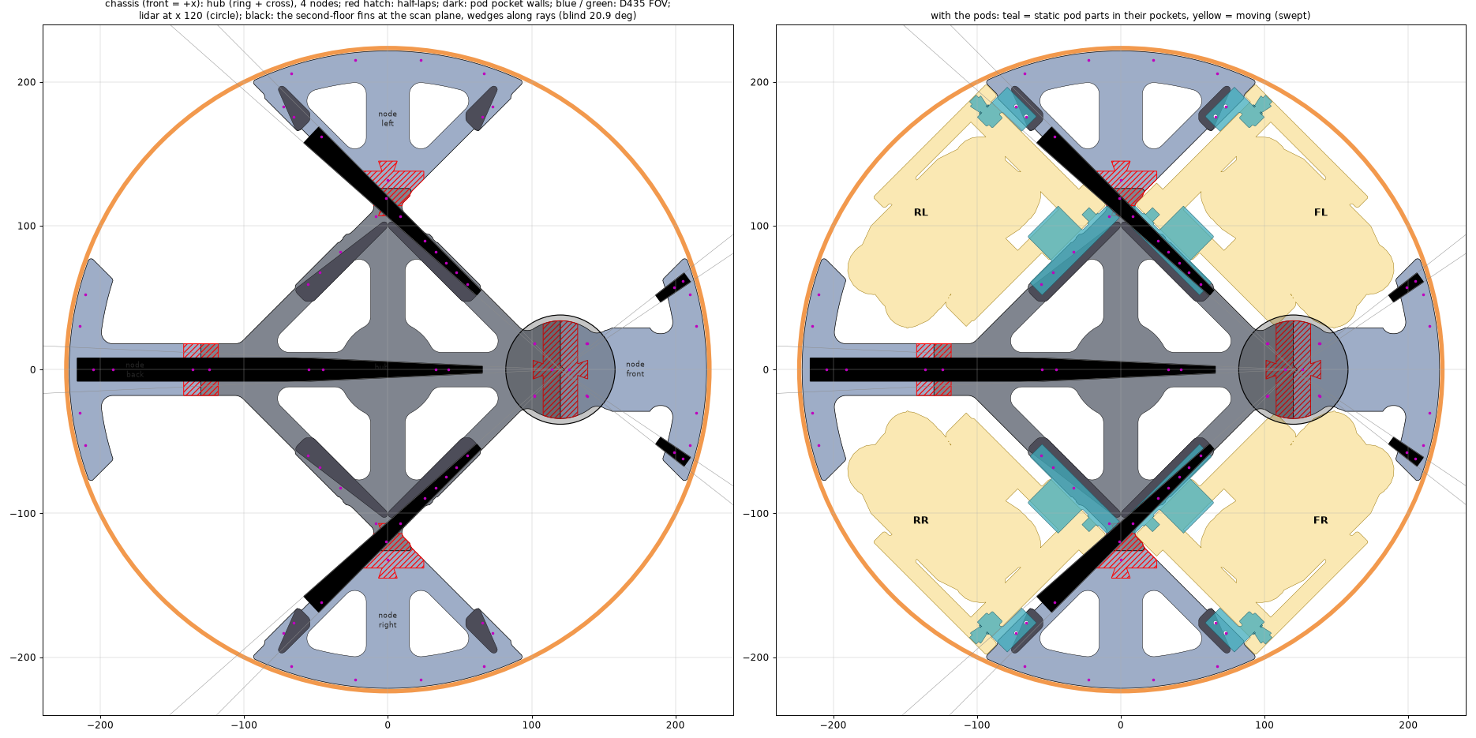
cad/v13/validation/chassis/plan.png
