fernandomierhicks/omni-robot/characterization/throw_track/results/audit_20261031/bucket9_overview.png

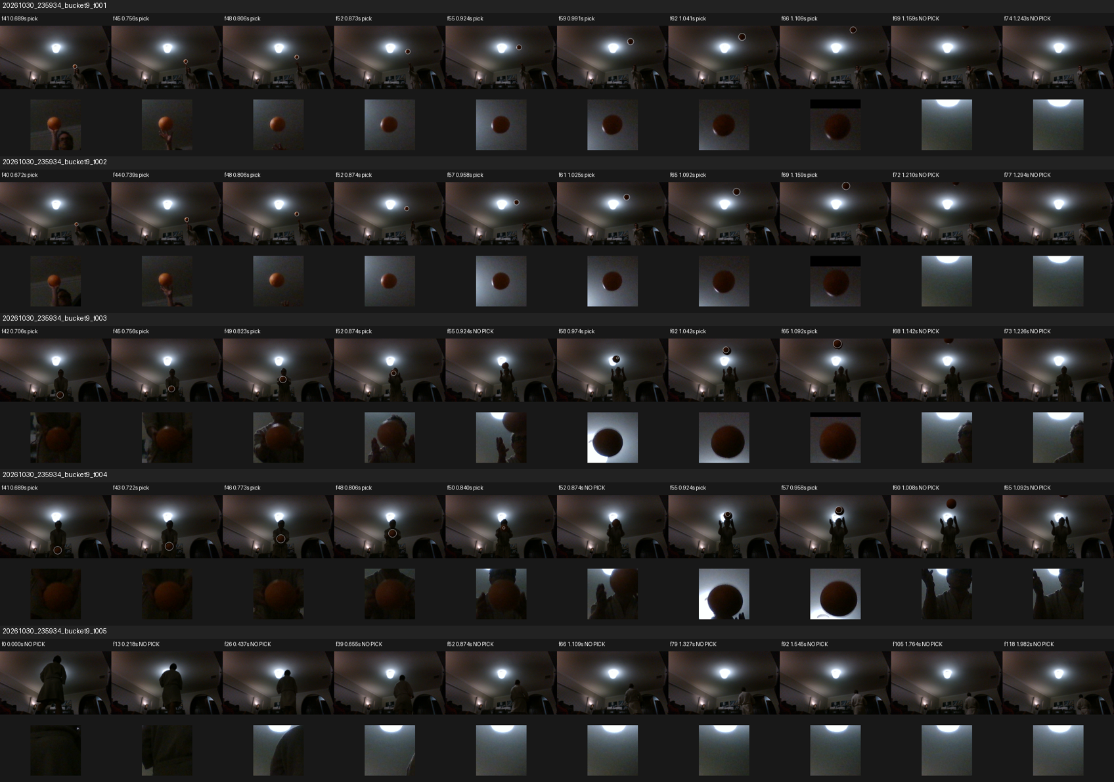
characterization/throw_track/results/audit_20261031/bucket9_overview.png
