fernandomierhicks/omni-robot/characterization/throw_track/results/audit_20261031/loc3_overview.png

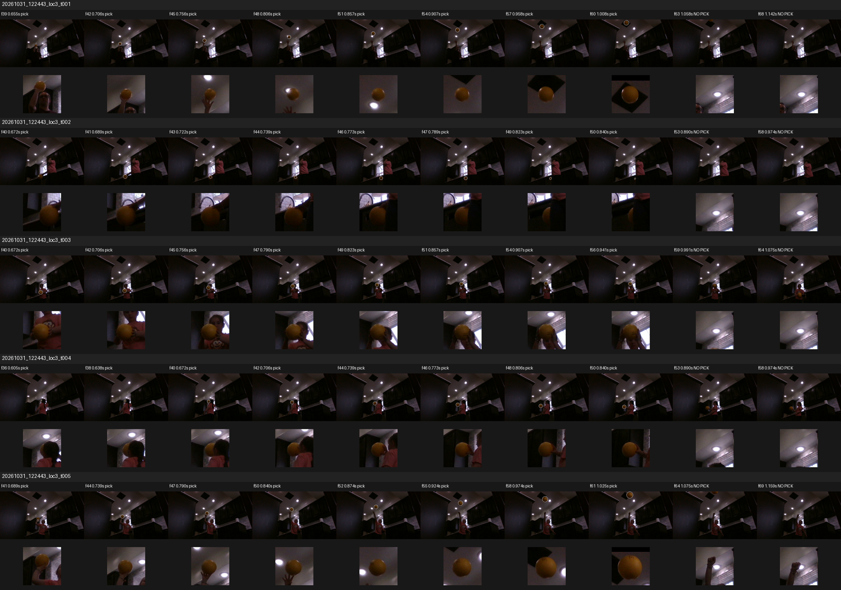
characterization/throw_track/results/audit_20261031/loc3_overview.png
