fernandomierhicks/omni-robot/simulation/v5 unlimited/assets/floor_wood.png

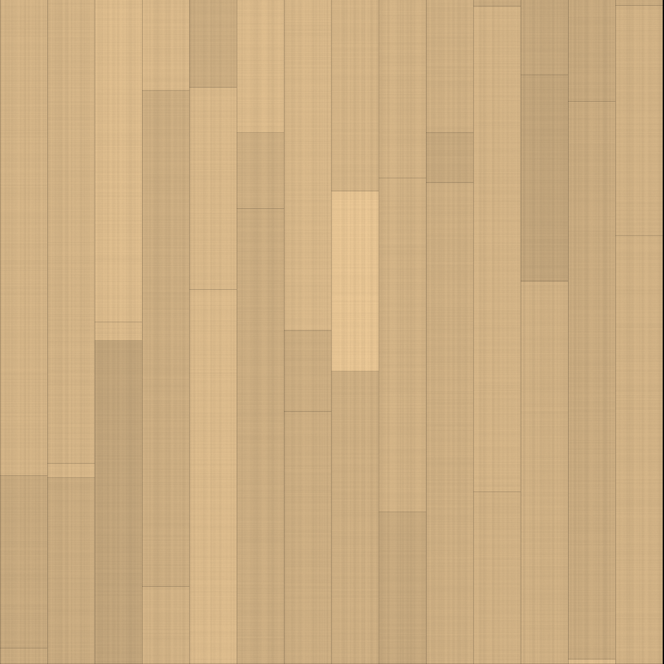
simulation/v5 unlimited/assets/floor_wood.png
