fernandomierhicks/omni-robot/simulation/v10 ros bridge/renders/v10_rviz_wslg.png

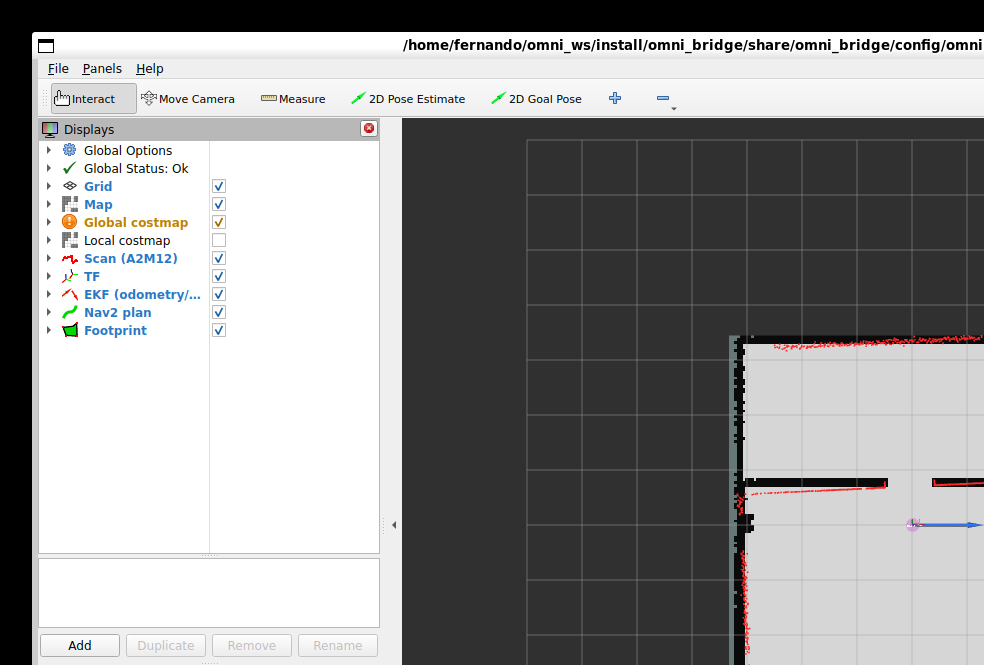
simulation/v10 ros bridge/renders/v10_rviz_wslg.png
