fernandomierhicks/omni-robot/simulation/v11 sil/assets/netting.png

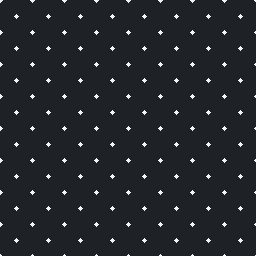
simulation/v11 sil/assets/netting.png
