fernandomierhicks/omni-robot/simulation/v11 sil/renders/layout_fov_arm.png

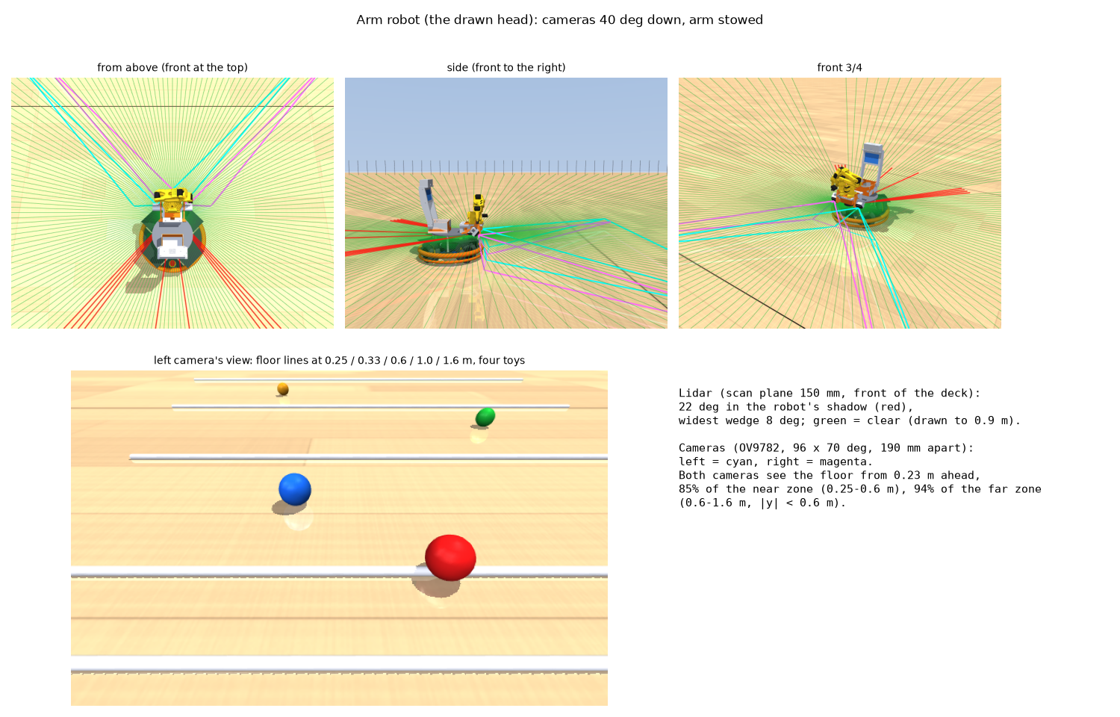
simulation/v11 sil/renders/layout_fov_arm.png
