fernandomierhicks/omni-robot/simulation/v11 sil/renders/layout_fov_catch.png

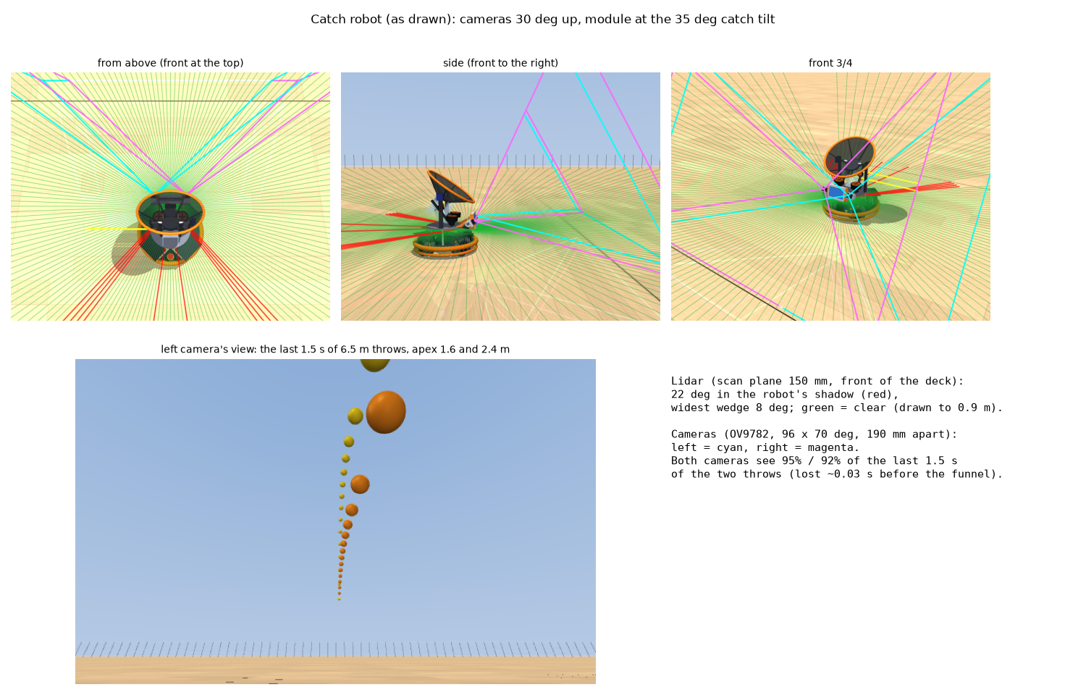
simulation/v11 sil/renders/layout_fov_catch.png
