fernandomierhicks/omni-robot/simulation/v11 sil/renders/layout_lidar.png

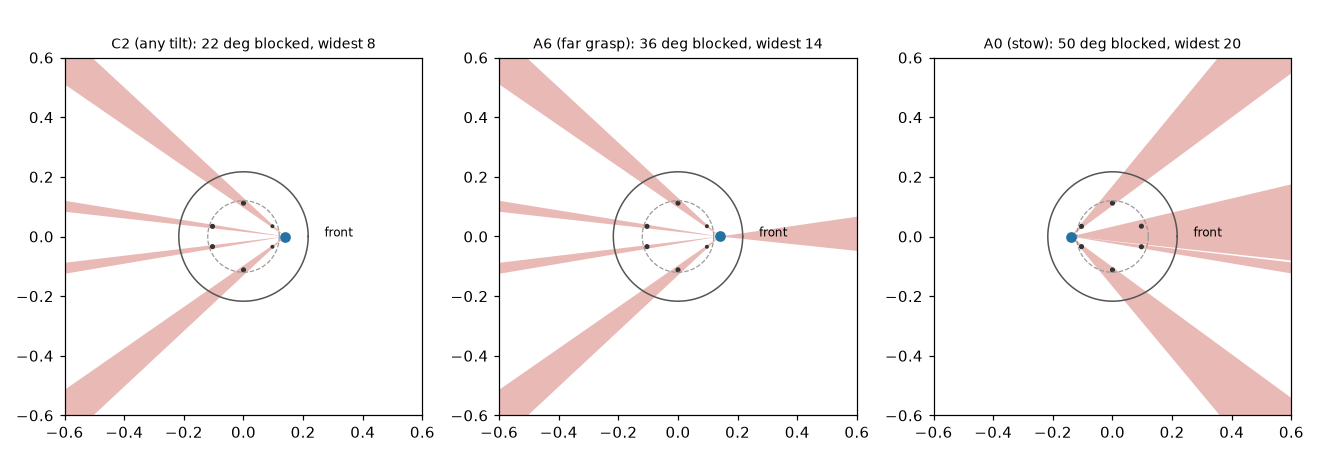
simulation/v11 sil/renders/layout_lidar.png
