fernandomierhicks/omni-robot/simulation/v11 sil/renders/layout_proposal_arm.png

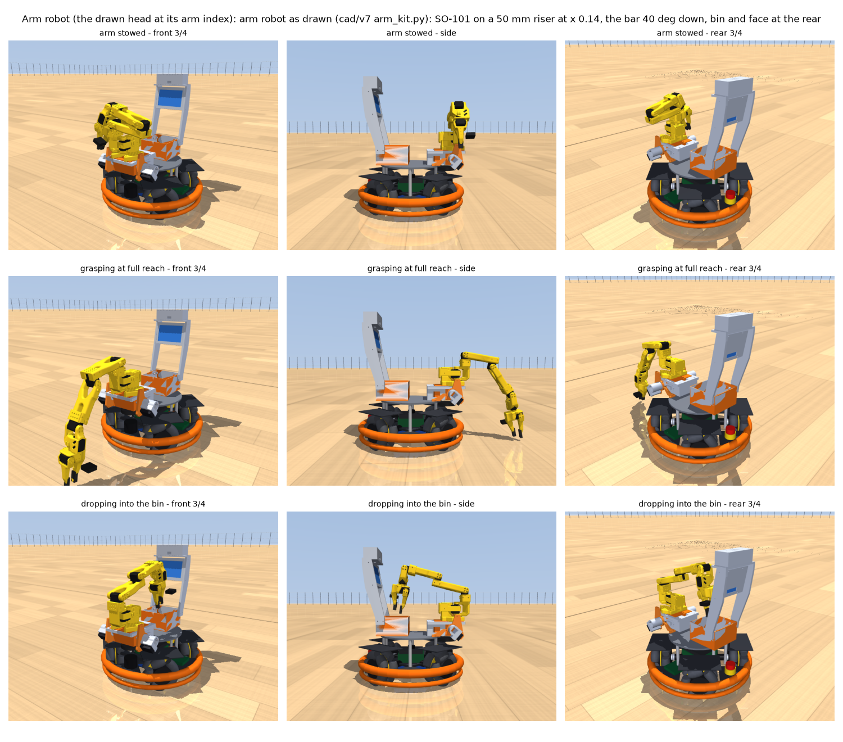
simulation/v11 sil/renders/layout_proposal_arm.png
