fernandomierhicks/omni-robot/simulation/v11 sil/renders/layout_proposal_catch.png

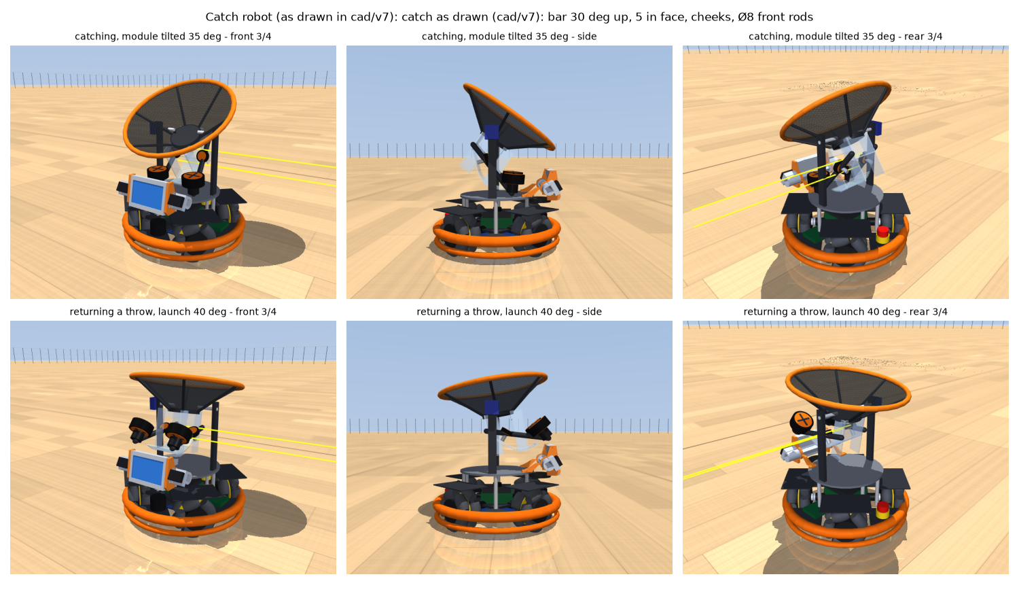
simulation/v11 sil/renders/layout_proposal_catch.png
