fernandomierhicks/omni-robot/simulation/v11 sil/renders/layout_trade.png

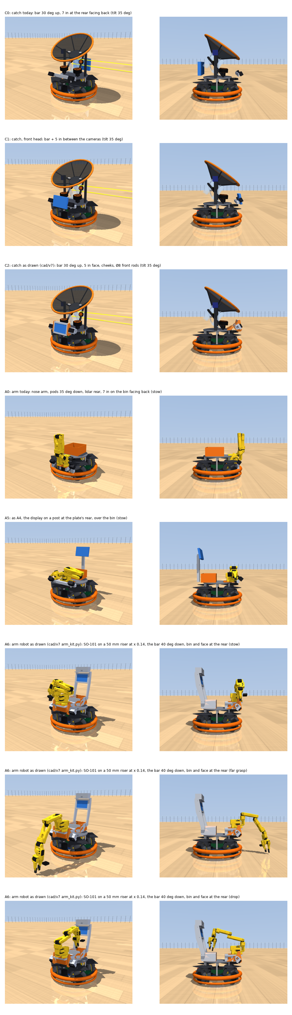
simulation/v11 sil/renders/layout_trade.png
