fernandomierhicks/omni-robot/simulation/v11 sil/renders/v11_arm_poses.png

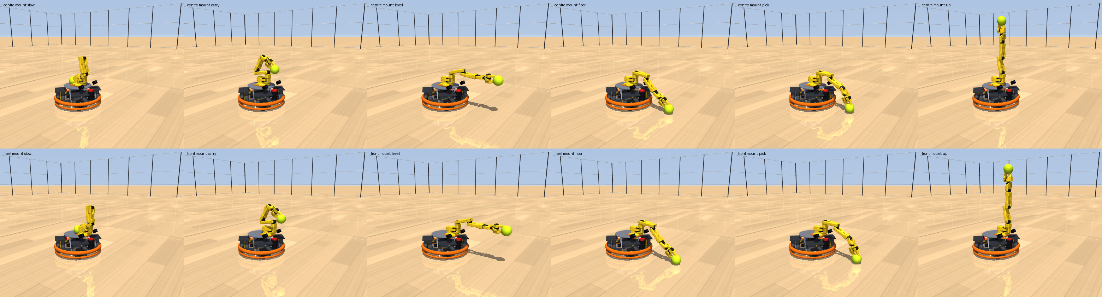
simulation/v11 sil/renders/v11_arm_poses.png
