fernandomierhicks/omni-robot/simulation/v11 sil/renders/v11_house_ball_555ms.png

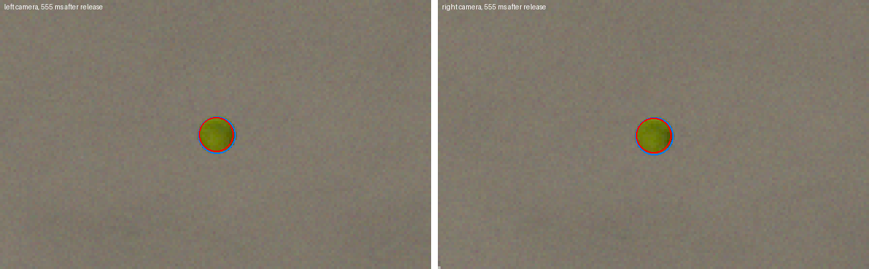
simulation/v11 sil/renders/v11_house_ball_555ms.png
