fernandomierhicks/omni-robot/simulation/v11 sil/renders/v11_house_camL_257ms.png

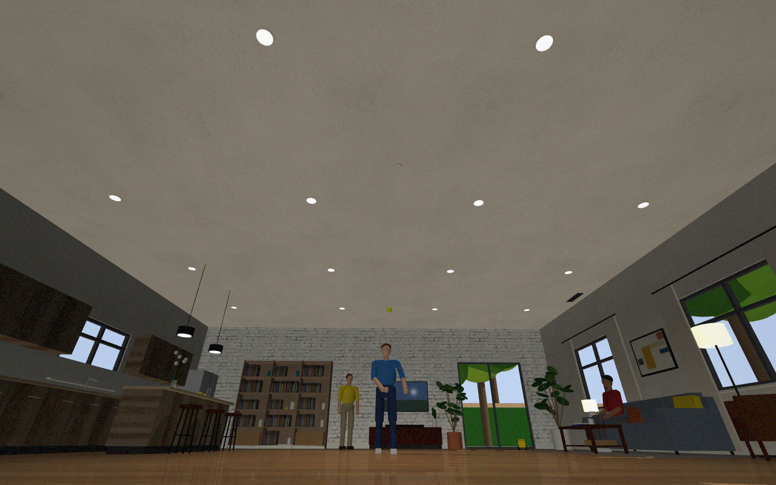
simulation/v11 sil/renders/v11_house_camL_257ms.png
