fernandomierhicks/omni-robot/simulation/v11 sil/renders/v11_house_camR_555ms.png

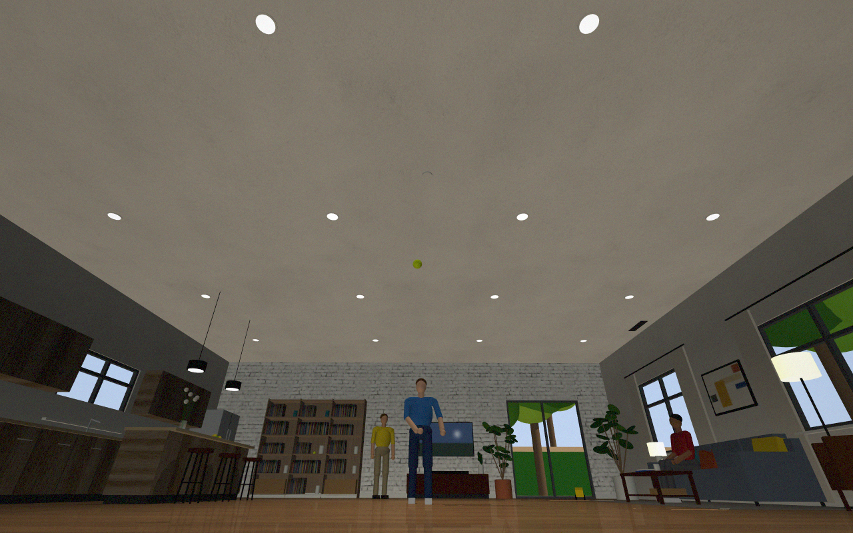
simulation/v11 sil/renders/v11_house_camR_555ms.png
