fernandomierhicks/omni-robot/tmp/pdfs/amazon_compute/getorli-0.jpg

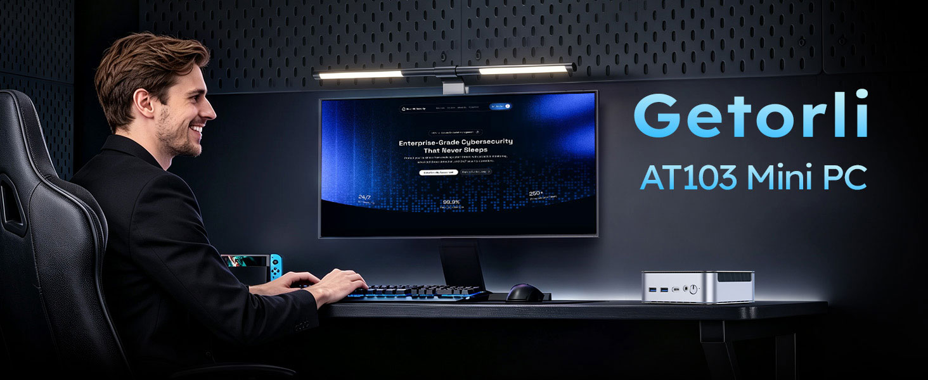
tmp/pdfs/amazon_compute/getorli-0.jpg
