fernandomierhicks/omni-robot/tmp/pdfs/amazon_compute/getorli-1.jpg

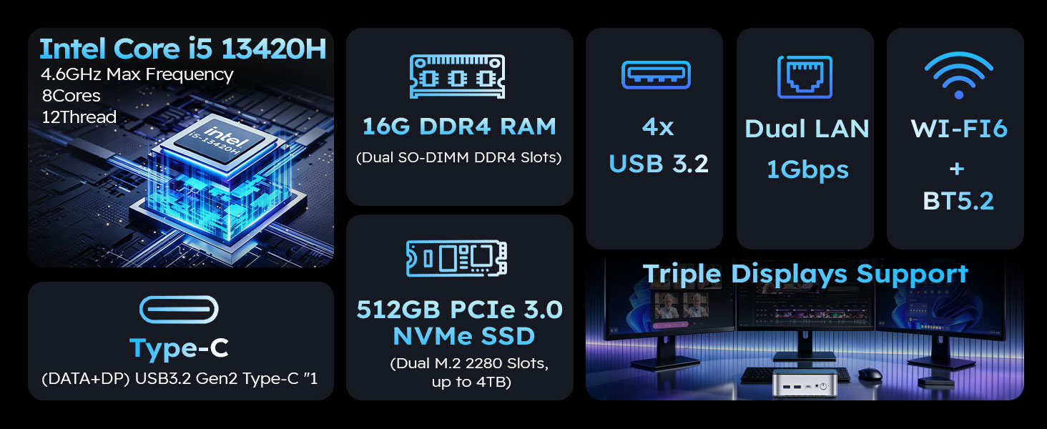
tmp/pdfs/amazon_compute/getorli-1.jpg
