fernandomierhicks/omni-robot/tmp/pdfs/amazon_compute/getorli-2.jpg

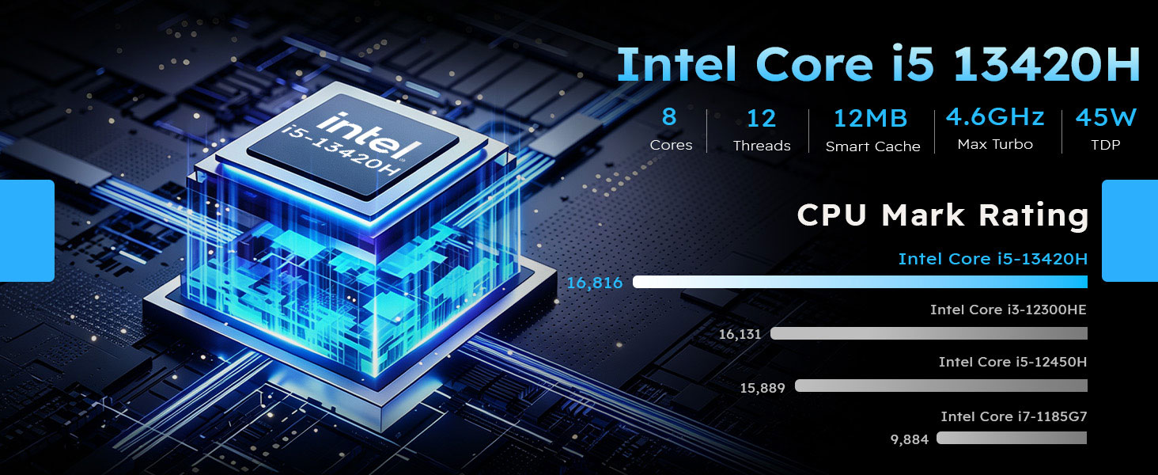
tmp/pdfs/amazon_compute/getorli-2.jpg
