fernandomierhicks/omni-robot/tmp/pdfs/amazon_compute/getorli-3.jpg

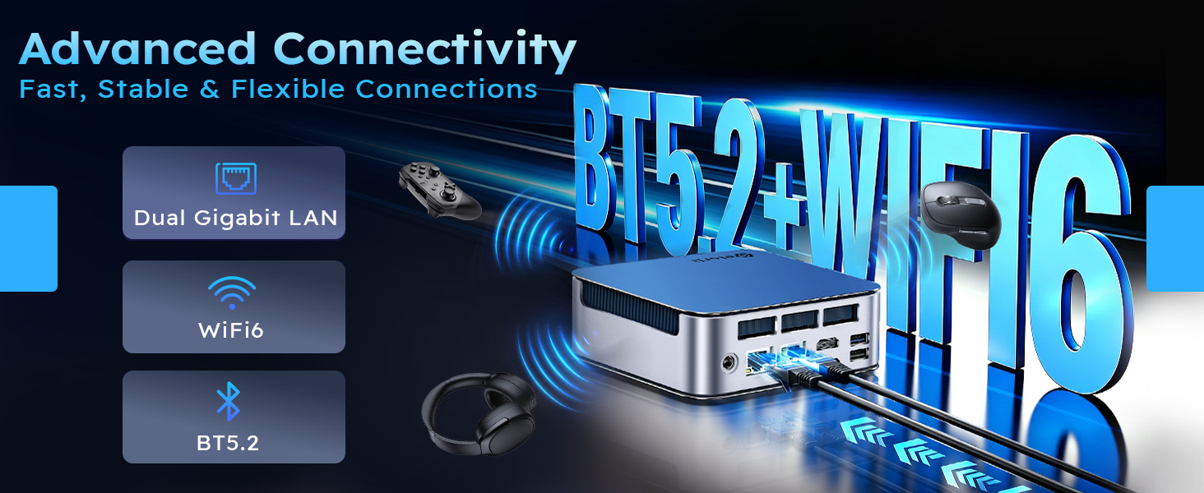
tmp/pdfs/amazon_compute/getorli-3.jpg
