fernandomierhicks/omni-robot/tmp/pdfs/amazon_compute/getorli-4.jpg

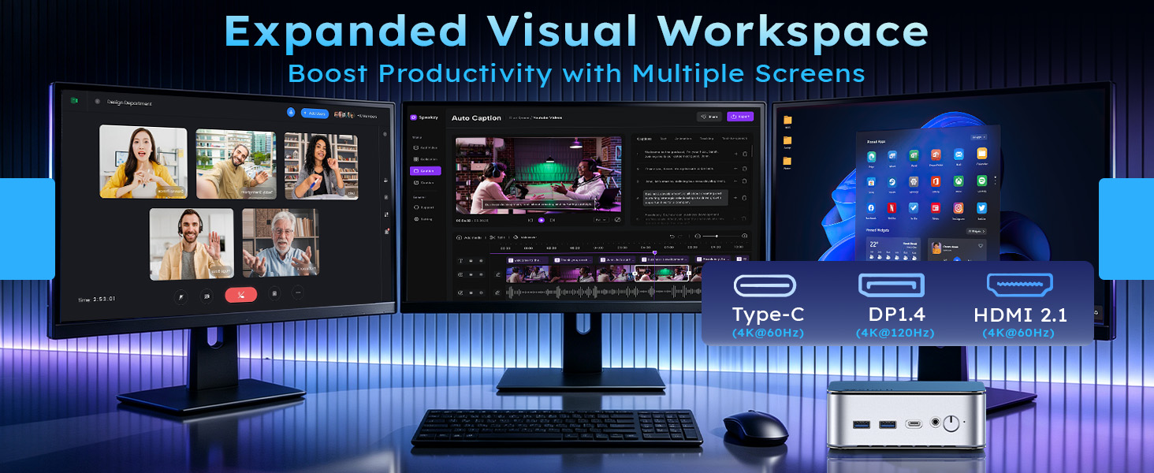
tmp/pdfs/amazon_compute/getorli-4.jpg
