fernandomierhicks/omni-robot/tmp/pdfs/amazon_compute/page-01.png

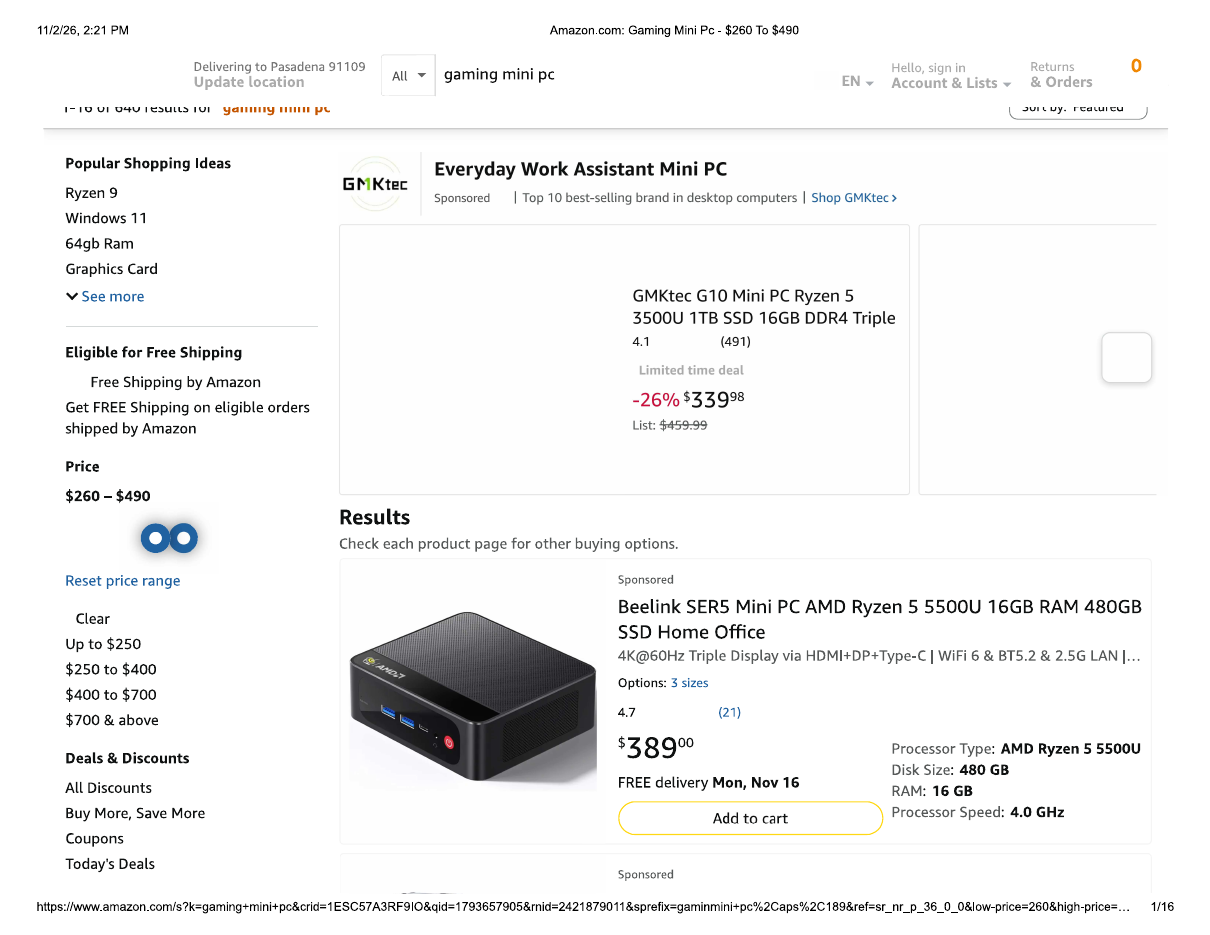
tmp/pdfs/amazon_compute/page-01.png
