fernandomierhicks/omni-robot/tmp/pdfs/amazon_compute/page-02.png

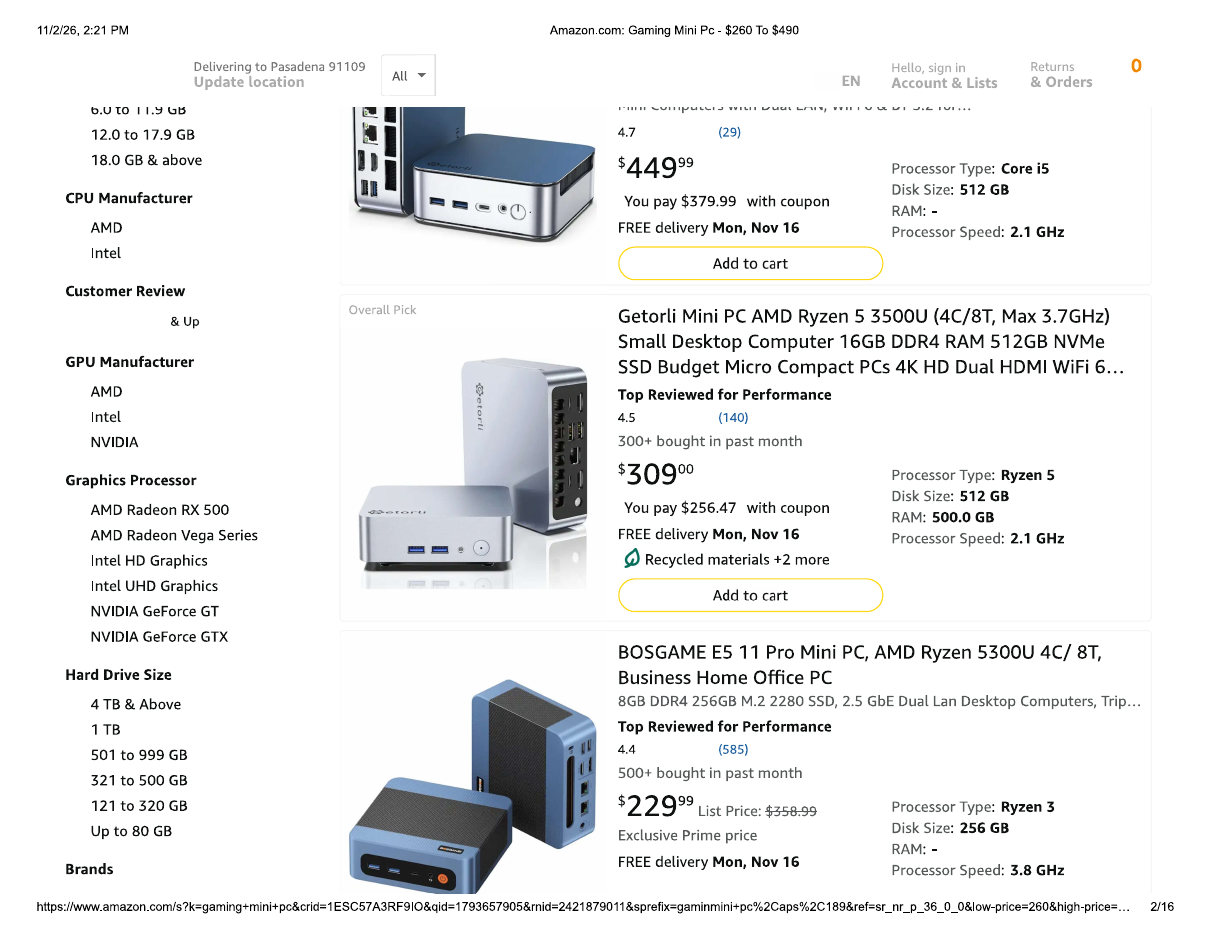
tmp/pdfs/amazon_compute/page-02.png
