fernandomierhicks/omni-robot/tmp/pdfs/amazon_compute/page-03.png

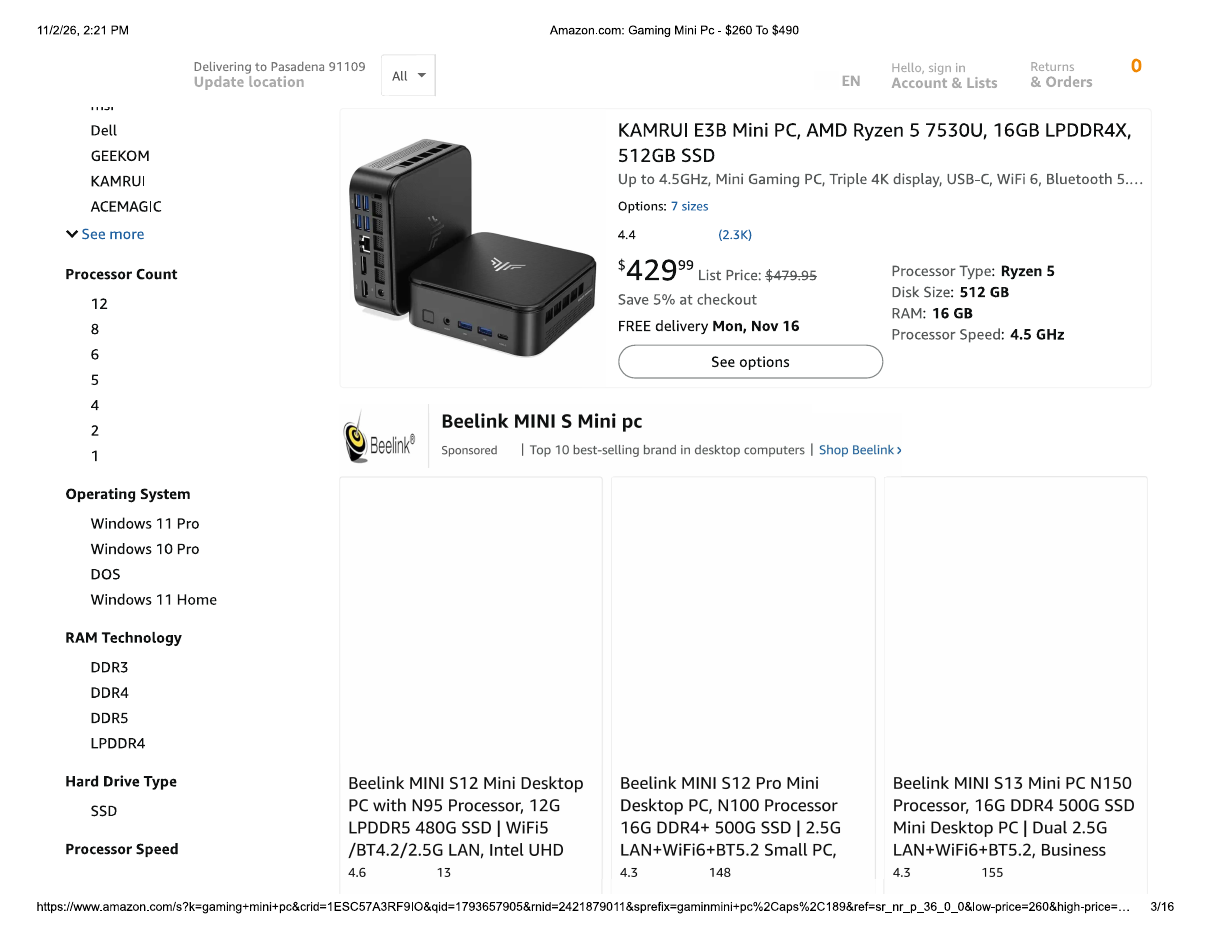
tmp/pdfs/amazon_compute/page-03.png
