fernandomierhicks/omni-robot/tmp/pdfs/amazon_compute/page-04.png

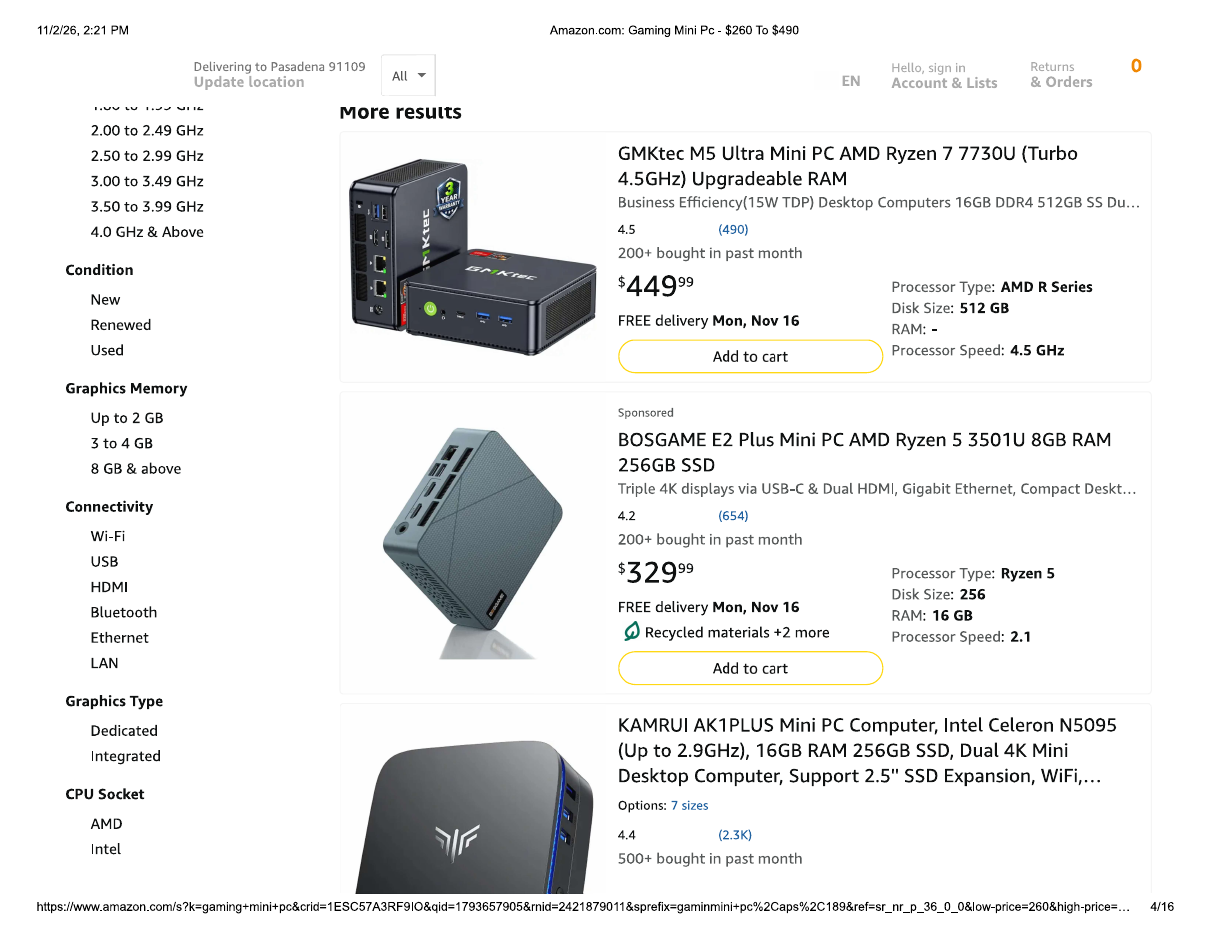
tmp/pdfs/amazon_compute/page-04.png
