fernandomierhicks/omni-robot/tmp/pdfs/amazon_compute/page-05.png

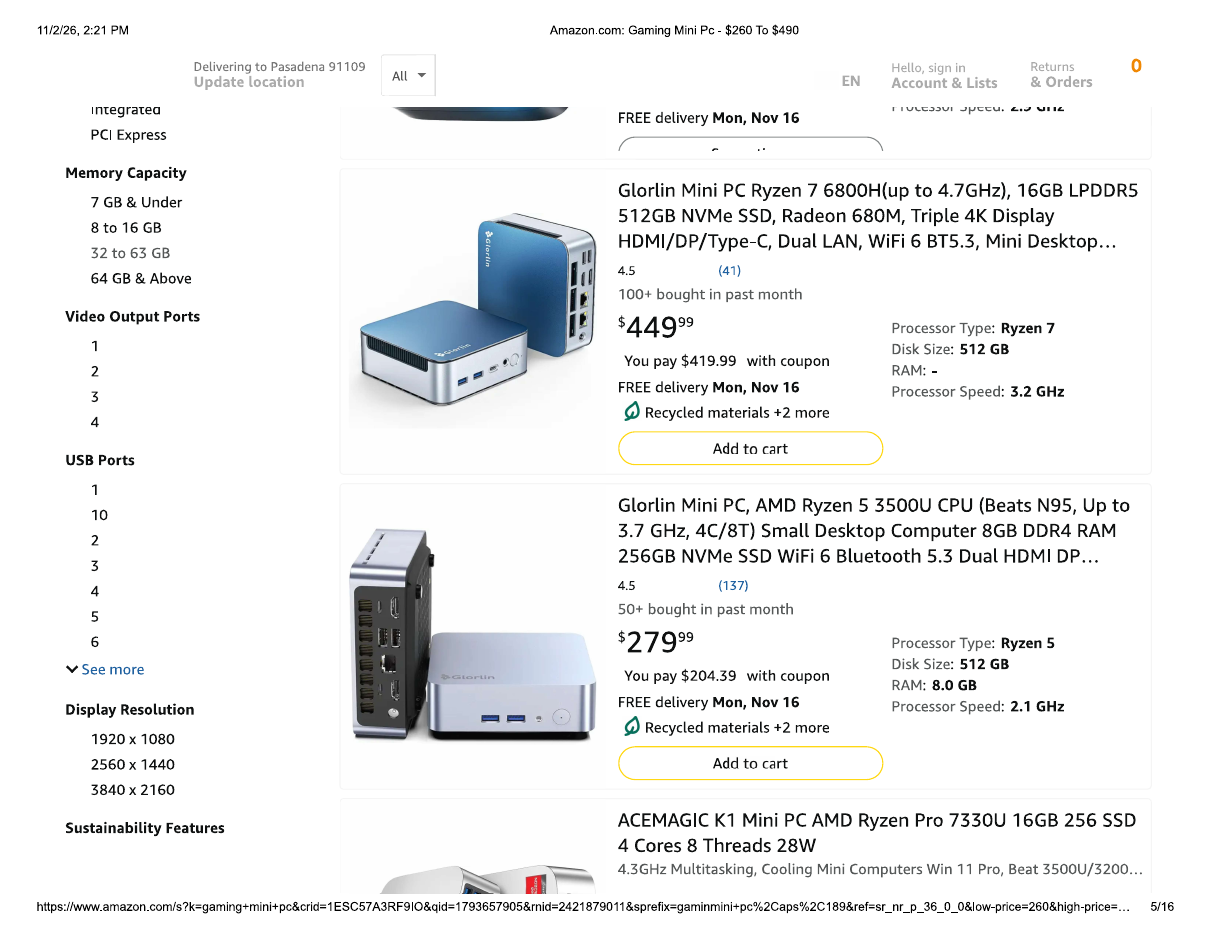
tmp/pdfs/amazon_compute/page-05.png
