fernandomierhicks/omni-robot/tmp/pdfs/amazon_compute/page-06.png

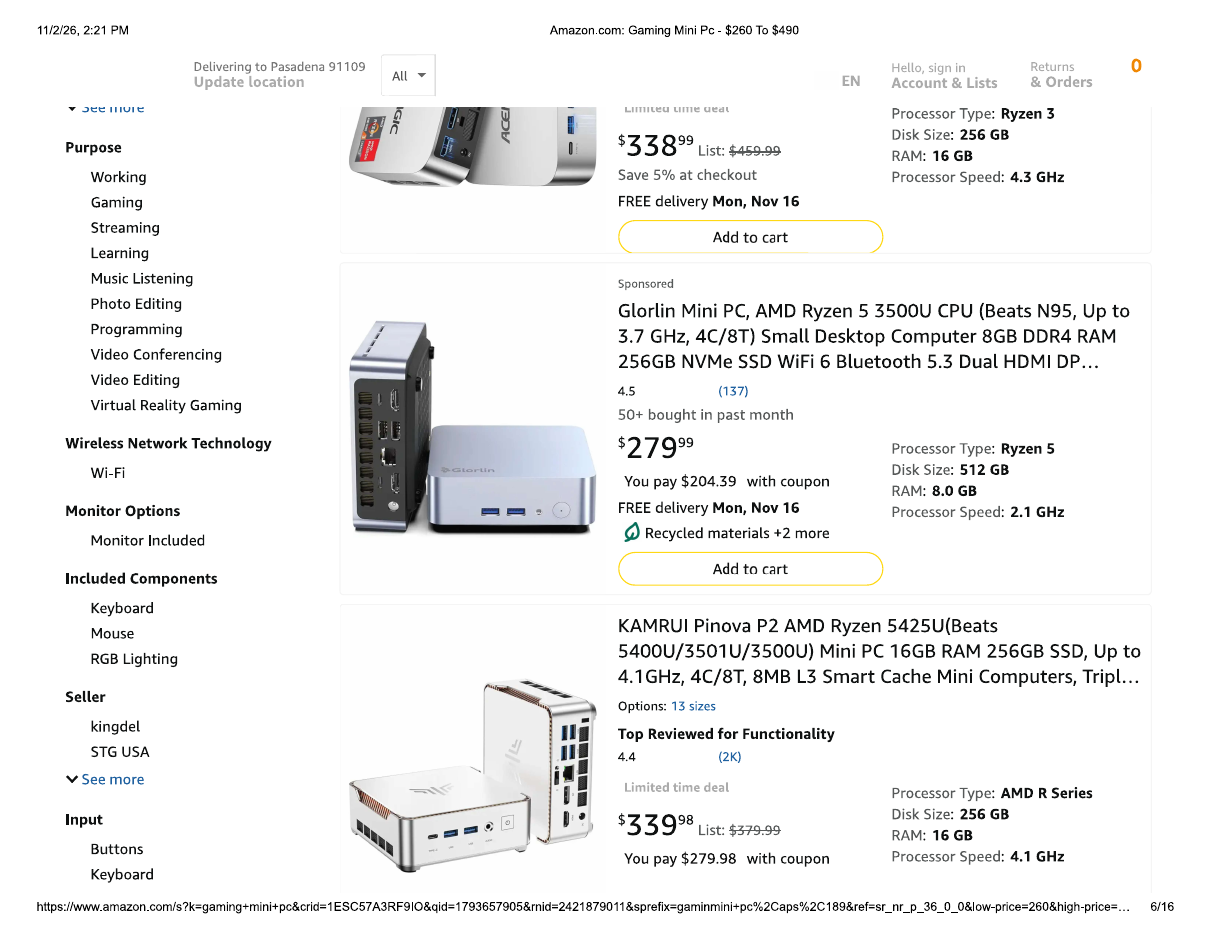
tmp/pdfs/amazon_compute/page-06.png
