fernandomierhicks/omni-robot/tmp/pdfs/amazon_compute/page-07.png

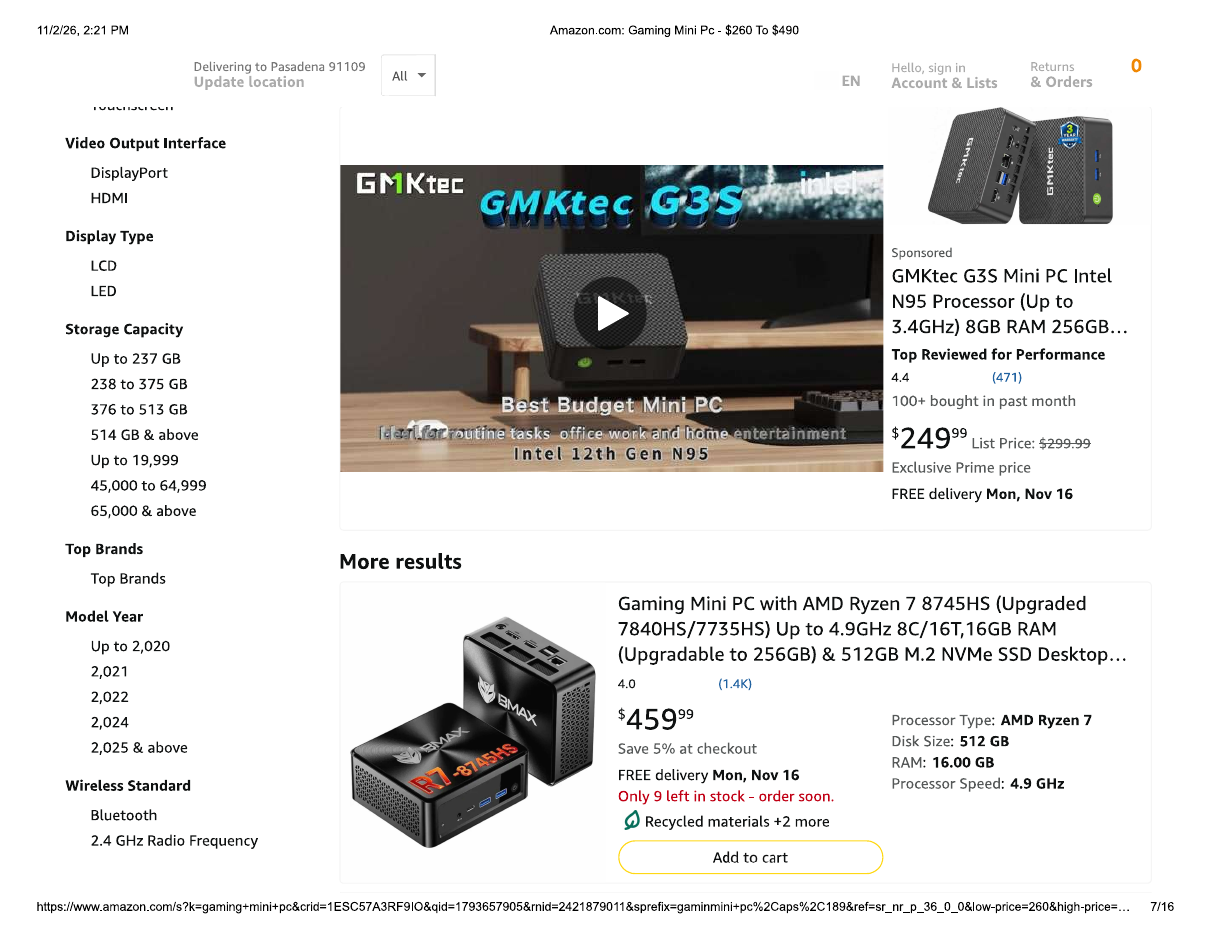
tmp/pdfs/amazon_compute/page-07.png
