fernandomierhicks/omni-robot/tmp/pdfs/amazon_compute/page-08.png

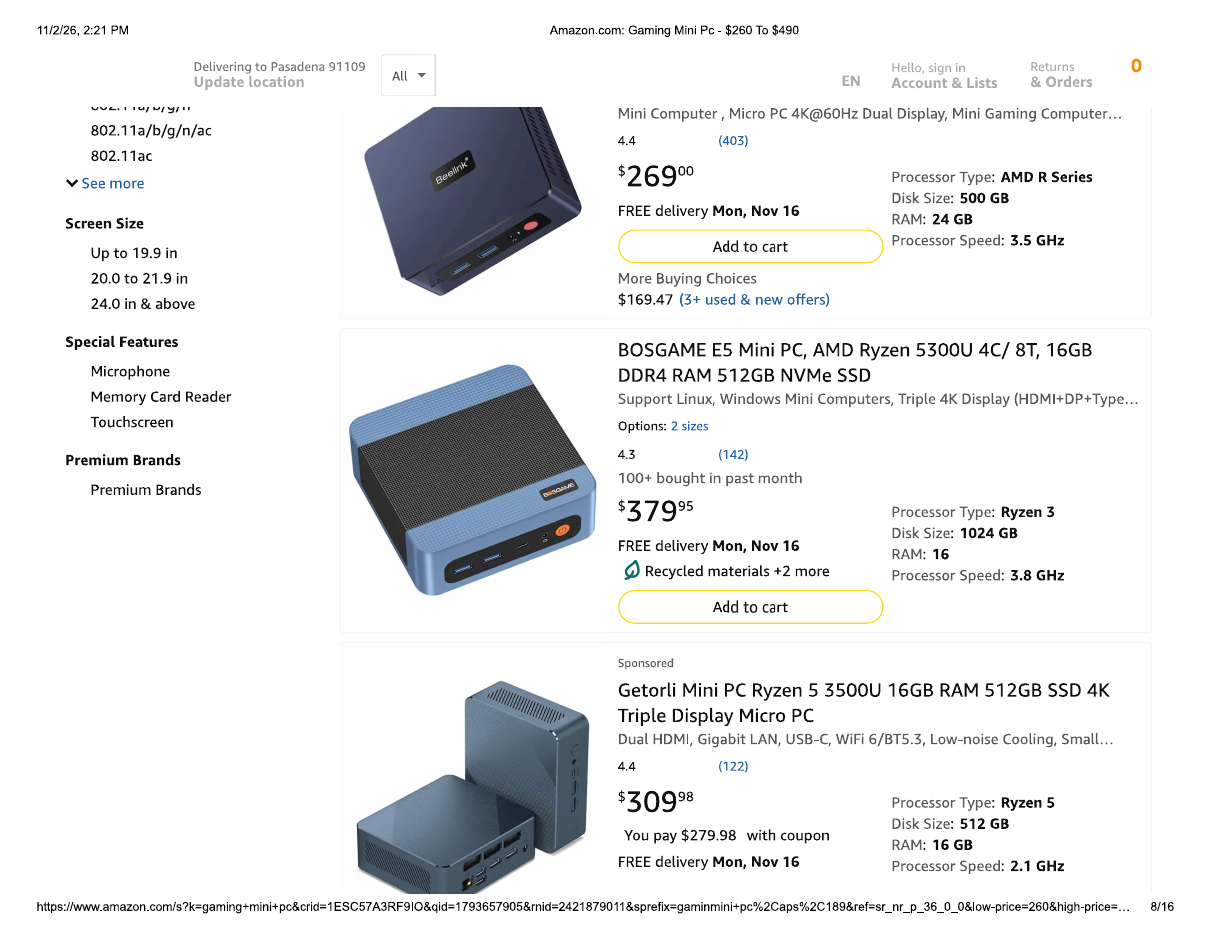
tmp/pdfs/amazon_compute/page-08.png
