fernandomierhicks/omni-robot/tmp/pdfs/amazon_compute/page-09.png

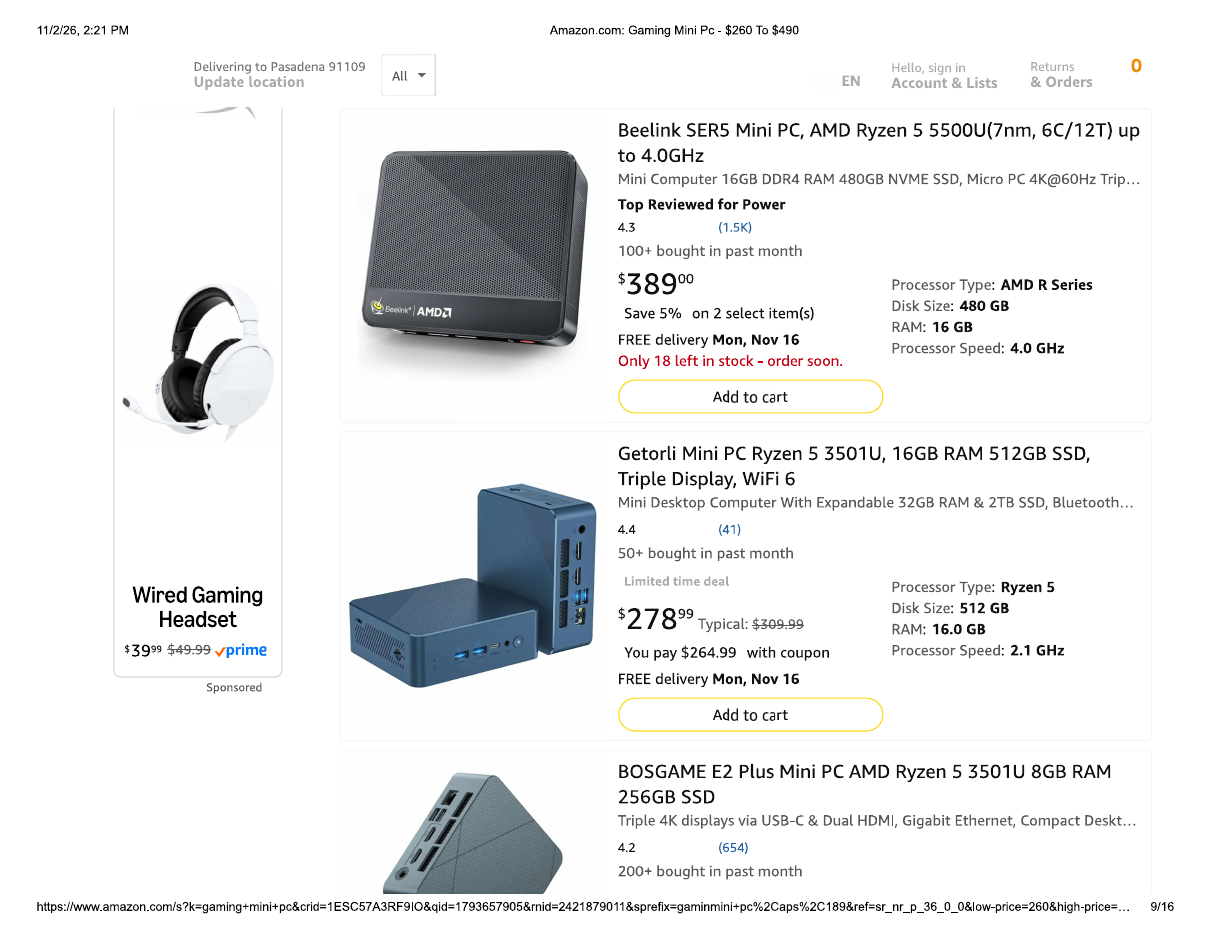
tmp/pdfs/amazon_compute/page-09.png
