fernandomierhicks/omni-robot/tmp/pdfs/amazon_compute/page-10.png

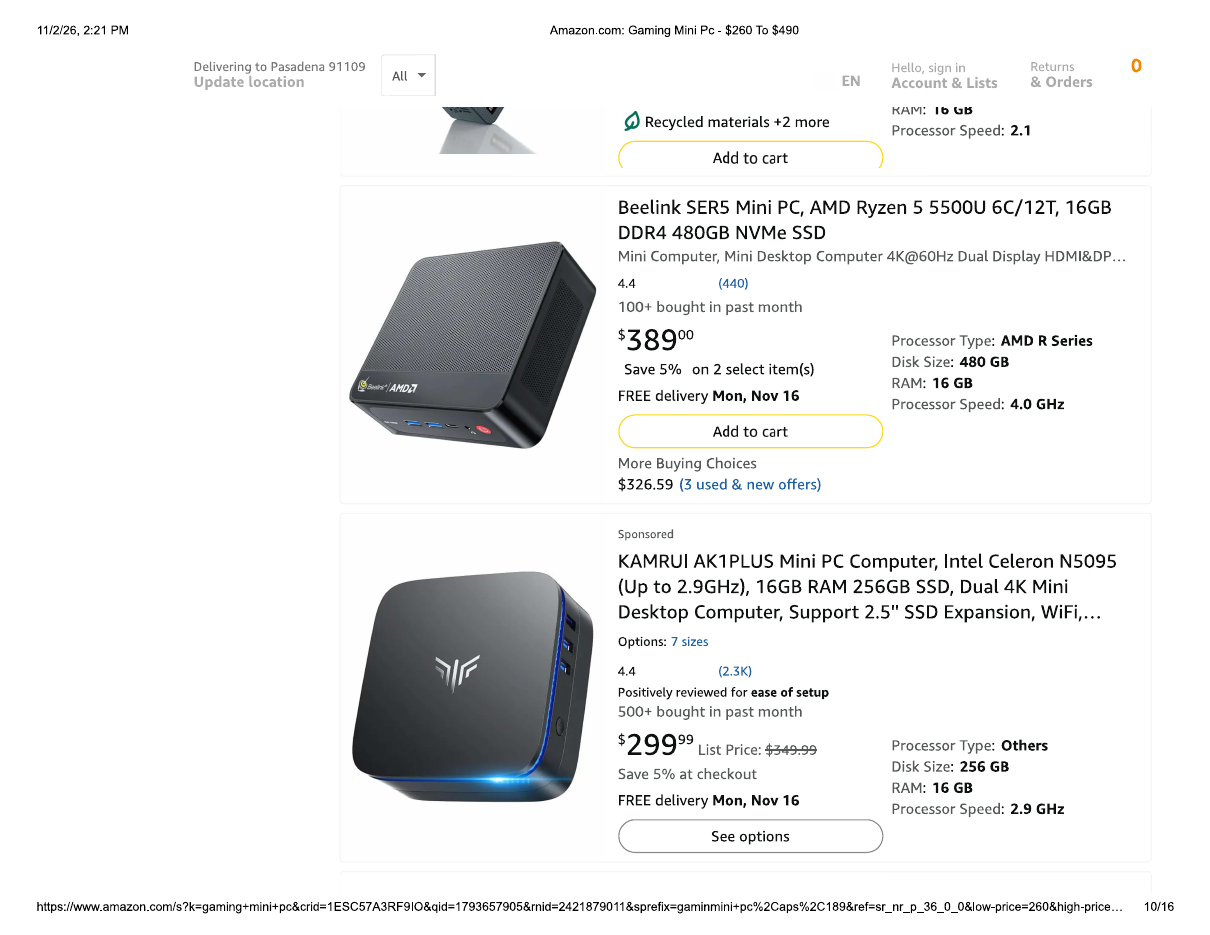
tmp/pdfs/amazon_compute/page-10.png
