fernandomierhicks/omni-robot/tmp/pdfs/amazon_compute/page-11.png

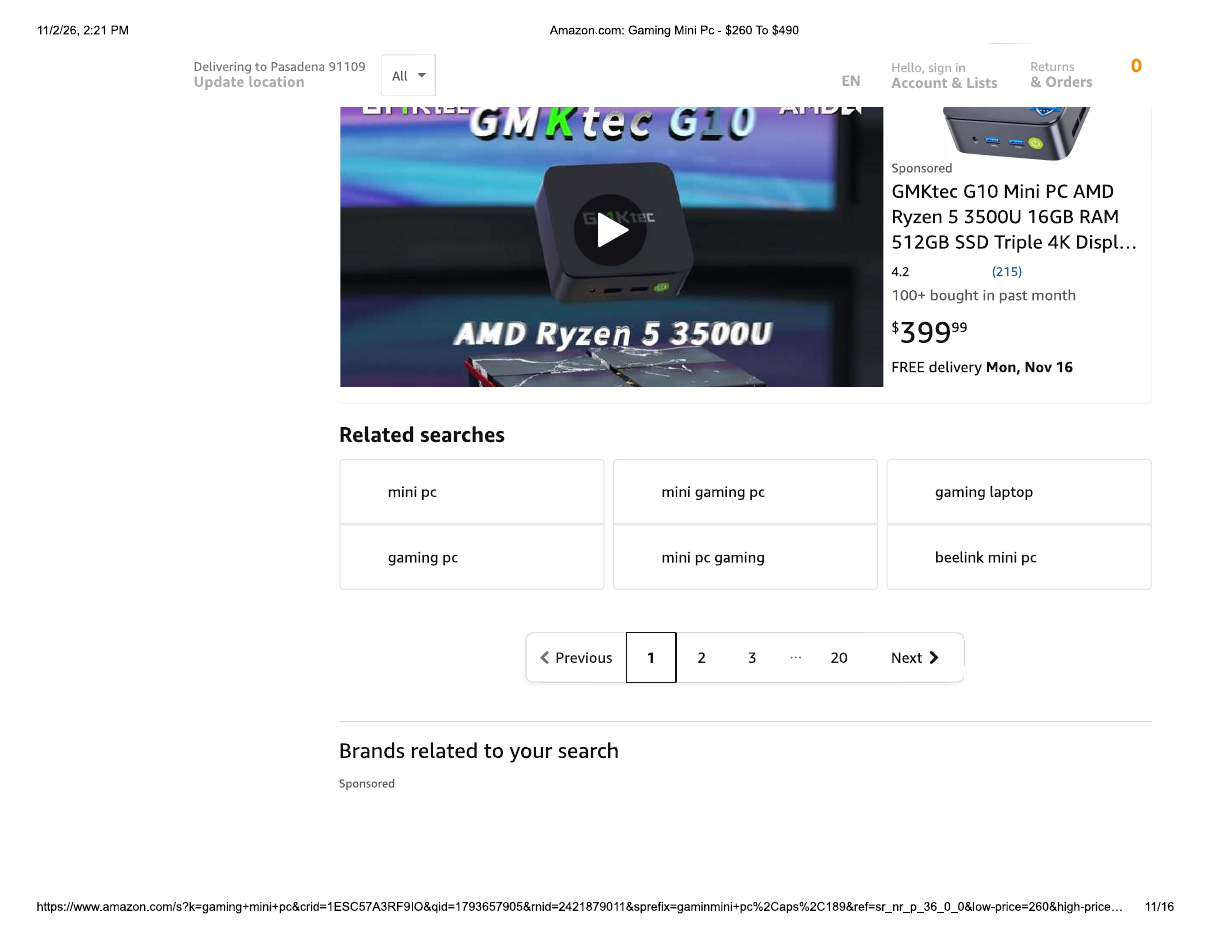
tmp/pdfs/amazon_compute/page-11.png
