fernandomierhicks/omni-robot/tmp/pdfs/amazon_compute/page-12.png

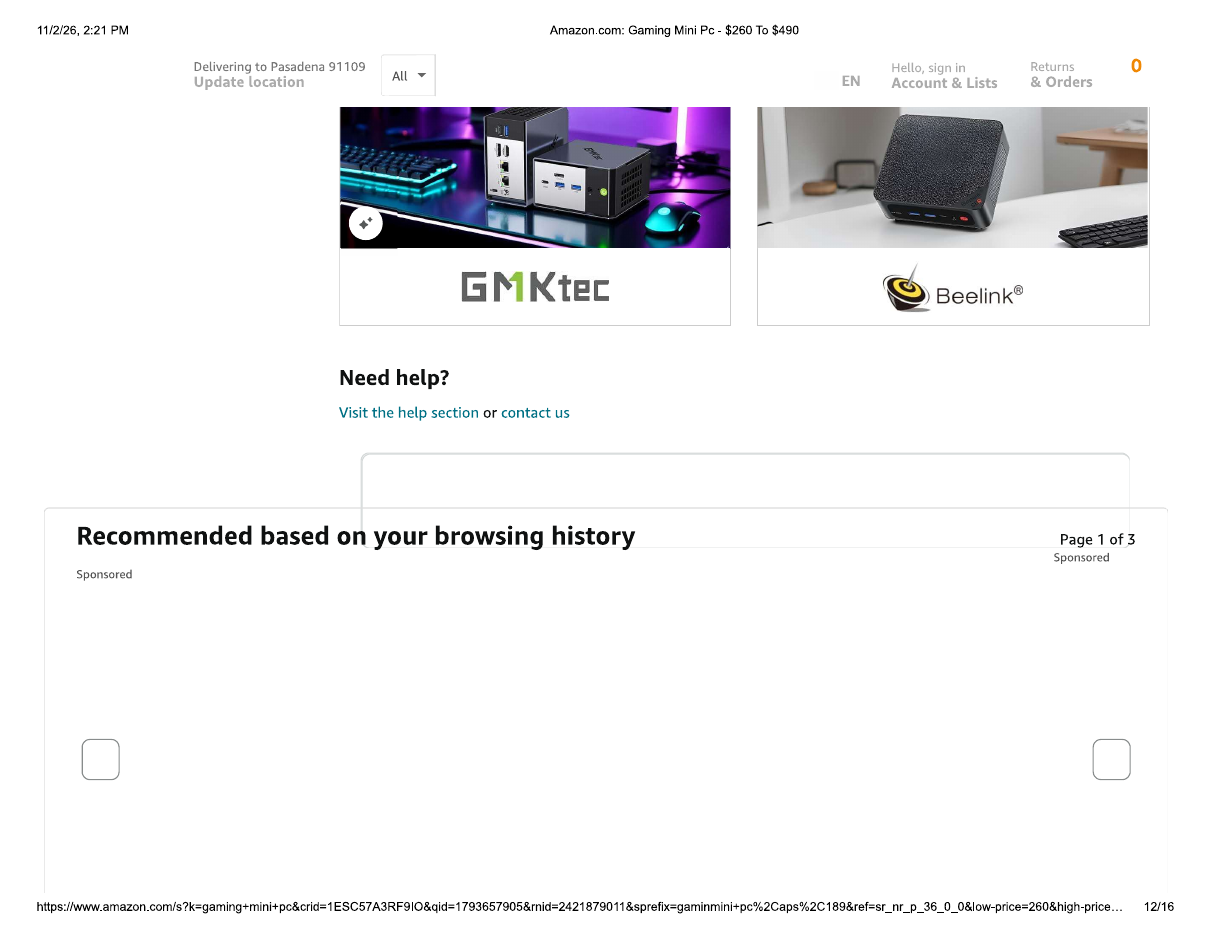
tmp/pdfs/amazon_compute/page-12.png
