fernandomierhicks/omni-robot/tmp/pdfs/amazon_compute/page-13.png

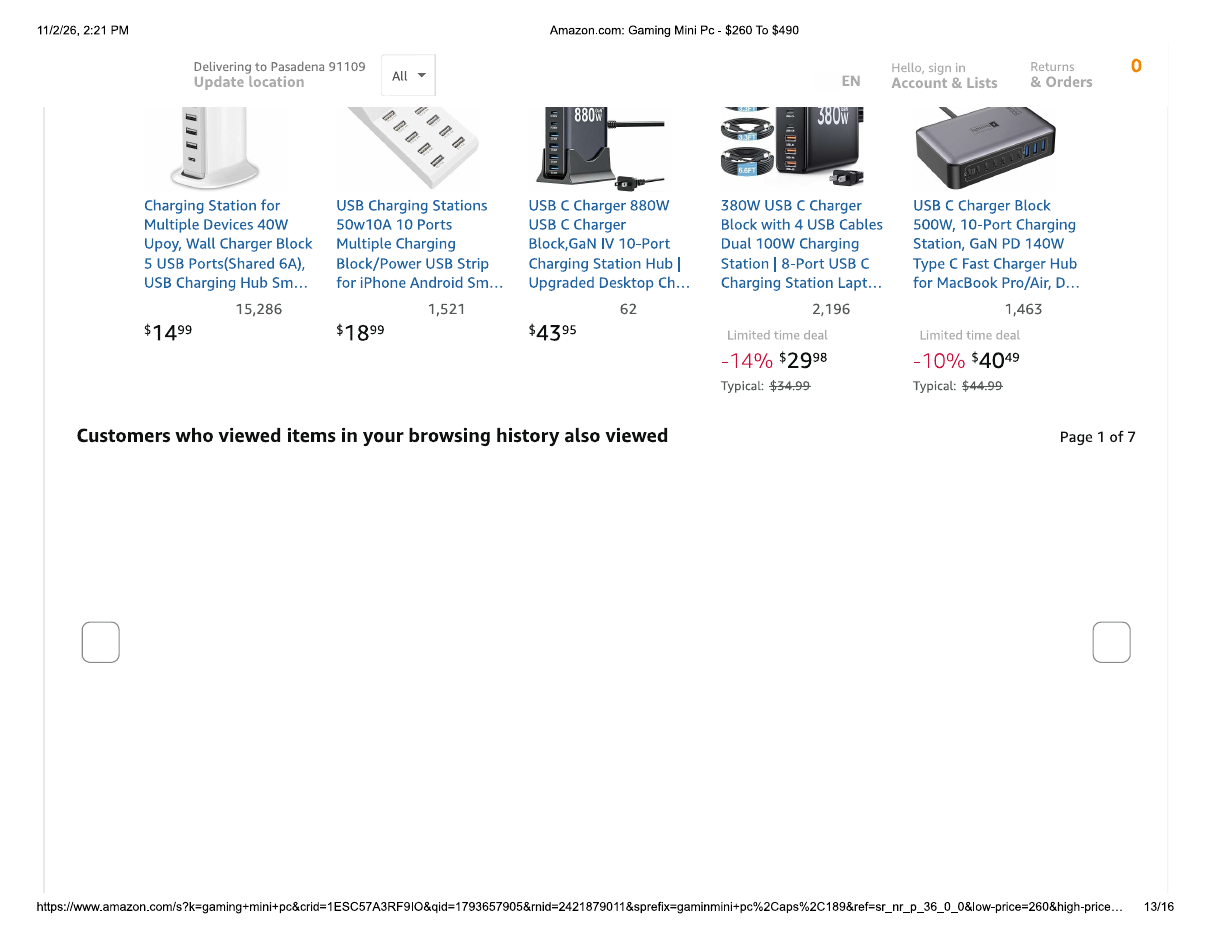
tmp/pdfs/amazon_compute/page-13.png
