fernandomierhicks/omni-robot/tmp/pdfs/amazon_compute/page-14.png

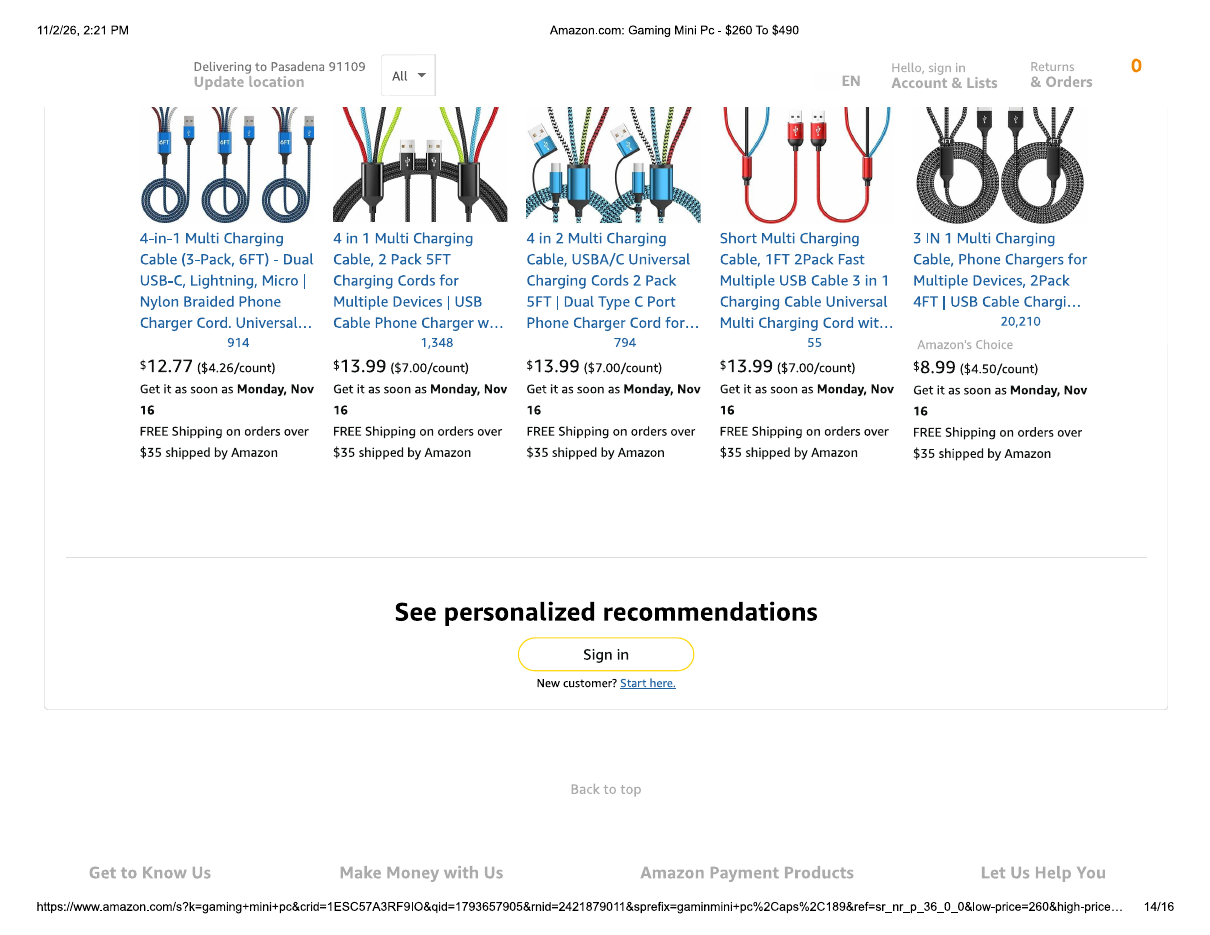
tmp/pdfs/amazon_compute/page-14.png
