fernandomierhicks/omni-robot/tmp/pdfs/amazon_compute/page-15.png

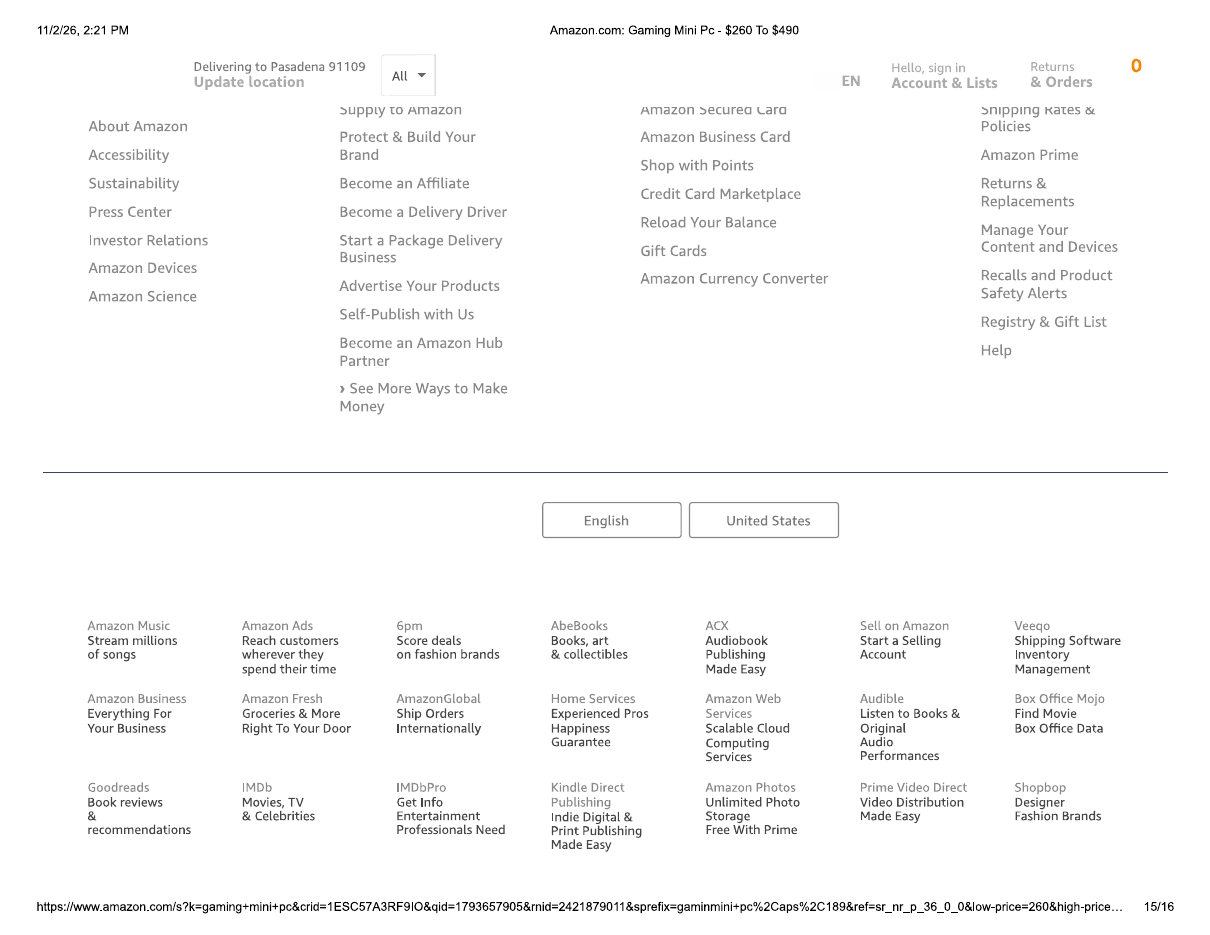
tmp/pdfs/amazon_compute/page-15.png
