fernandomierhicks/omni-robot/tmp/pdfs/amazon_compute/page-16.png

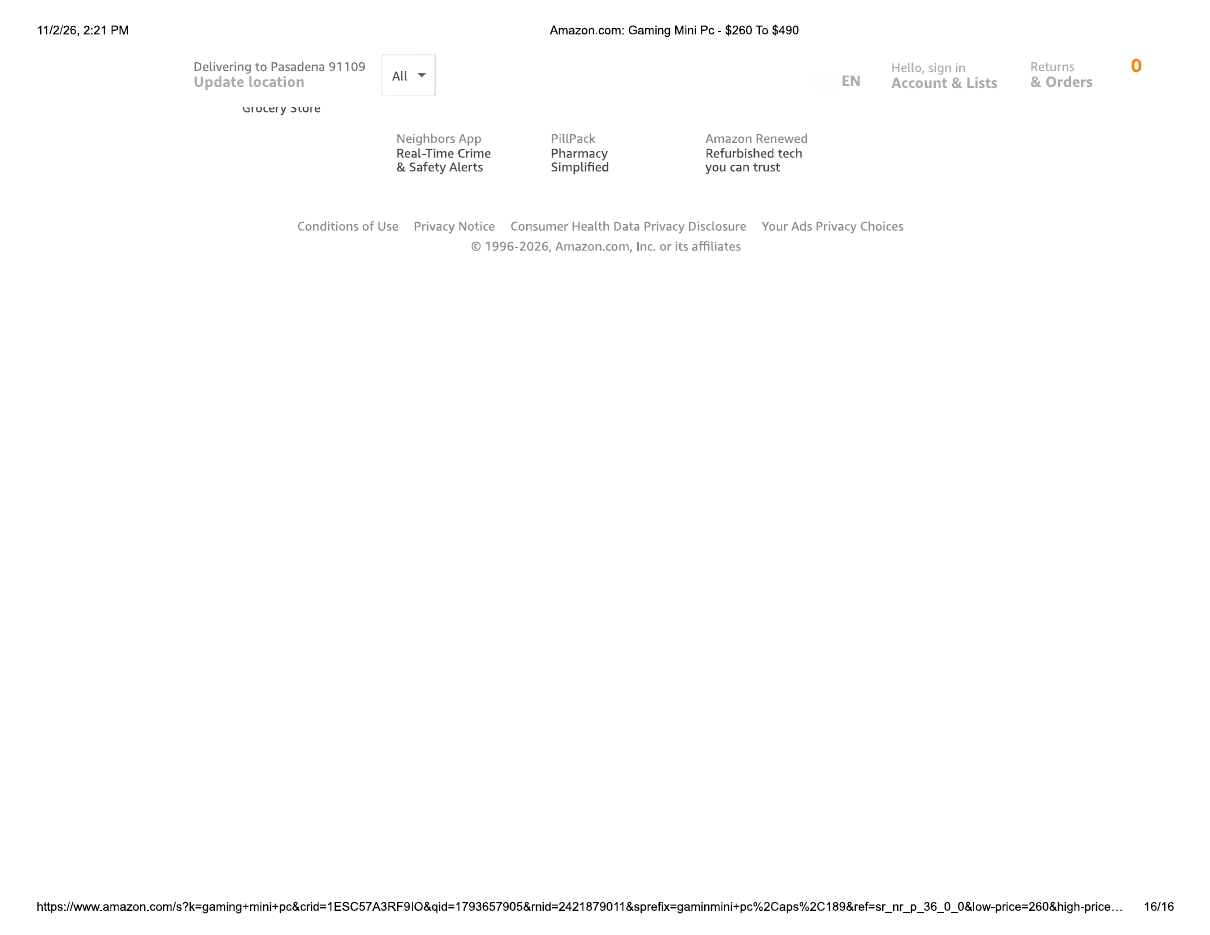
tmp/pdfs/amazon_compute/page-16.png
