fernandomierhicks/omni-robot/cad/v10 human editable/BOM.md

# Wheel-pod parts list

One pod with the free-turning printed motor, bench frame and telescoping shock mockups. Dimensions and fits are nominal.

| Part | Quantity | Material / source |
| --- | ---: | --- |
| [bearing_627](parts/human/V10H_bearing_627.SLDPRT) | 2 | Owned steel bearing |
| [bearing_6804](parts/human/V10H_bearing_6804.SLDPRT) | 2 | Owned steel bearing |
| [bearing_687](parts/human/V10H_bearing_687.SLDPRT) | 1 | Owned steel bearing |
| [bench_plate](parts/human/V10H_bench_plate.SLDPRT) | 1 | PLA / PETG, printed |
| [bolt_M2p5_10_PAN](parts/human/V10H_bolt_M2p5_10_PAN.SLDPRT) | 7 | Stock fastener, magenta in CAD |
| [bolt_M3_10_PAN](parts/human/V10H_bolt_M3_10_PAN.SLDPRT) | 6 | Stock fastener, magenta in CAD |
| [bolt_M3_12_PAN](parts/human/V10H_bolt_M3_12_PAN.SLDPRT) | 8 | Stock fastener, magenta in CAD |
| [bolt_M3_14_PAN](parts/human/V10H_bolt_M3_14_PAN.SLDPRT) | 1 | Stock fastener, magenta in CAD |
| [bolt_M3_16_PAN](parts/human/V10H_bolt_M3_16_PAN.SLDPRT) | 3 | Stock fastener, magenta in CAD |
| [bolt_M3_18_PAN](parts/human/V10H_bolt_M3_18_PAN.SLDPRT) | 16 | Stock fastener, magenta in CAD |
| [bolt_M3_20_PAN](parts/human/V10H_bolt_M3_20_PAN.SLDPRT) | 1 | Stock fastener, magenta in CAD |
| [bolt_M3_25_PAN](parts/human/V10H_bolt_M3_25_PAN.SLDPRT) | 4 | Stock fastener, magenta in CAD |
| [bolt_M3_50_PAN](parts/human/V10H_bolt_M3_50_PAN.SLDPRT) | 12 | Stock fastener, magenta in CAD |
| [bolt_M3_8_PAN](parts/human/V10H_bolt_M3_8_PAN.SLDPRT) | 1 | Stock fastener, magenta in CAD |
| [dummy_motor_rotor](parts/human/V10H_dummy_motor_rotor.SLDPRT) | 1 | PLA / PETG, printed |
| [dummy_motor_stator](parts/human/V10H_dummy_motor_stator.SLDPRT) | 1 | PLA / PETG, printed |
| [fork_bar](parts/human/V10H_fork_bar.SLDPRT) | 1 | Printed PETG; 6061 bar also fits |
| [inner_fork_6804](parts/human/V10H_inner_fork_6804.SLDPRT) | 1 | PETG (touches the motor cup) |
| [motor_cup](parts/human/V10H_motor_cup.SLDPRT) | 1 | PETG (holds the warm AK40) |
| [nut_M3_hex](parts/human/V10H_nut_M3_hex.SLDPRT) | 12 | Stock fastener, magenta in CAD |
| [nut_M3_nyloc](parts/human/V10H_nut_M3_nyloc.SLDPRT) | 1 | Stock fastener, magenta in CAD |
| [outer_fork_6804](parts/human/V10H_outer_fork_6804.SLDPRT) | 1 | PLA / PETG, printed |
| [pivot_outer_spacer](parts/human/V10H_pivot_outer_spacer.SLDPRT) | 1 | PLA / PETG, printed |
| [pivot_shaft](parts/human/V10H_pivot_shaft.SLDPRT) | 1 | 7 mm steel shaft, 98 mm long; Ø3.4 cross hole |
| [pivot_shim](parts/human/V10H_pivot_shim.SLDPRT) | 1 | PLA / PETG, printed |
| [pod_mount](parts/human/V10H_pod_mount.SLDPRT) | 1 | PLA / PETG, printed |
| [roller_core](parts/human/V10H_roller_core.SLDPRT) | 12 | PLA |
| [roller_tread](parts/human/V10H_roller_tread.SLDPRT) | 12 | Medium TPU |
| [shock_case](parts/human/V10H_shock_case.SLDPRT) | 2 | PLA / PETG, printed |
| [shock_rod](parts/human/V10H_shock_rod.SLDPRT) | 2 | PLA / PETG, printed |
| [washer_M3](parts/human/V10H_washer_M3.SLDPRT) | 1 | Stock fastener, magenta in CAD |
| [washer_M3_large](parts/human/V10H_washer_M3_large.SLDPRT) | 1 | Stock fastener (M3 large washer, DIN 9021, Ø9 × 0.8), magenta in CAD |
| [wheel_cartridge](parts/human/V10H_wheel_cartridge.SLDPRT) | 1 | PLA |
| [wheel_guard](parts/human/V10H_wheel_guard.SLDPRT) | 1 | PETG / PLA |
| [wheel_hub_A](parts/human/V10H_wheel_hub_A.SLDPRT) | 1 | PETG (on the AK40's output flange) |
| [wheel_hub_B](parts/human/V10H_wheel_hub_B.SLDPRT) | 1 | PLA |
| [wheel_hub_C](parts/human/V10H_wheel_hub_C.SLDPRT) | 1 | PLA |

The printed two-part dummy motor (stator + rotor, one 687 bearing, one M3 × 8 screw and one large M3 washer) uses M2.5 × 10 at both motor interfaces. A real AK40 uses the shorter vendor-interface screws (×6 output, ×8 rear). The wheel hub joints use M3 × 18. No heat-set inserts. See [DUMMY_MOTOR.md](DUMMY_MOTOR.md) for the motor assembly order.

Since the Nov 2 level pivot the shaft pin is an M3 × 16 seated on the inner ear's ledge (was M3 × 25 from the ear top). Parts touching the motor (motor cup, inner fork, hub A) are PETG: the AK40 runs warm inside the hub.

The opposite-hand pod (FL, RR) uses the same list with the mirrored printed parts (`assemblies/mirror/`).

## Robot-level parts changed by the level pivot (per robot)

| Part | Quantity | Material / source |
| --- | ---: | --- |
| REC_deck_left_outer_pivot / REC_deck_left_inner_pivot | 1 + 1 | Printed deck, as v9's deck_left (now two pieces) |
| REC_deck_right_outer_pivot / REC_deck_right_inner_pivot | 1 + 1 | Printed deck, as v9's deck_right (now two pieces) |
| REC_deck_bridge | 2 | PETG, proposed, strength untested |
| REC_bumper_corner_pivot | 4 | TPU (v9's corner bumper, side screws moved to 17°) |
| M3 × 14 pan (deck bridge feet) | 8 | Stock fastener |

The shock mockups slide freely and have no spring or damping. Their assembly mates limit eye-to-eye length to 40–50 mm. Fit real shocks for sprung testing.
