fernandomierhicks/omni-robot/components/computer/compute_purchase_trade_2026-11-02.md

# Arm-first compute purchase trade — November 2, 2026

Current recommendation, superseding the earlier broad-market shortlist below: buy from Amazon only. From Fernando's saved Nov 2 Amazon PDF, BMAX B8A Pro 8745HS / 16 GB / 512 GB at $436.99 after 5% discount is the performance stretch; Getorli AT103 i5-13420H / 16 GB / 512 GB at $379.99 after coupon is the budget option; GMKtec M5 Ultra 7730U / 16 GB / 512 GB at $449.99 is the alternative with the clearest documented robot interfaces. All three have replaceable RAM and four USB-A plus USB-C. These are captured offers, not current checkout guarantees. Getorli DC input and microphone support require confirmation; BMAX Amazon power/display metadata conflict with the manufacturer. Full details in the final Amazon PDF audit below. No computer is adopted, purchased or physically qualified. Earlier direct-store, used and M8 recommendations remain historical research. Teensy and owned D435 retained; OAK is not baseline and wrist camera is TBD.

This is purchasing research and arithmetic, not a new simulator result. No simulations, robot processes, live camera benches or benchmarks were run. Read design.md in full, the existing compute study, arm/firmware/camera configuration and the Pi reports. Hardware specifications and prices below were researched November 2, 2026. US dollars, pre-tax and shipping. Used prices are buying targets unless a particular listing is identified; a published listing is not a stock reservation. Proposed hardware remains unadopted.

Assumptions: the $400 cap buys a complete mini PC with RAM/SSD; robot power conversion is separate. Heavy learned vision, free conversation, model training and batch processing may use the existing desktop over Wi-Fi. Basic commands, navigation, ordinary picking and safety remain usable locally. The D435 is already owned, so its incremental purchase cost is $0. Lidar, arm, wrist camera, display, audio, battery and general robot wiring are outside this compute/controller/future-camera budget. If Teensy is already owned, subtract $31.50 from cash still to spend; it remains in all system totals.

The purchase is driven by CPU latency and useful headroom. The current implementation does not turn Jetson TOPS into faster Nav2, Python executors or arm kinematics automatically. The RealSense D4 performs the camera's stereo depth calculation; the host still processes depth, point clouds, images and ROS messages. [RealSense D435](https://www.realsenseai.com/products/stereo-depth-camera-d435/), [Nav2 Jazzy MPPI](https://docs.nav2.org/jazzy/configuration_and_development/configuration_guide/controller_plugins/mppi_controller/configuring_mppic/).

| Robot task | Main resource and timing | Implication |
| --- | --- | --- |
| Drive commands, CAN, odometry, IMU timestamps, watchdog and interlocks | MCU deadlines/I/O, 1 kHz base/payload core | Keep Teensy on every architecture; motor FOC stays inside the integrated drives. Linux/GPU purchases do not replace this layer. |
| EKF, lidar preparation, transforms, localization | CPU scheduling and per-core speed; modest RAM | Local main computer. Camera traffic and voice must not starve these callbacks. |
| Nav2 MPPI and obstacle costmaps | CPU vector math, cache/memory traffic and deadline consistency | Current YAML requests 20 Hz, 2,000 trajectories × 56 steps: 2.24 million trajectory time points/s before critic work. This is an algorithmic workload count, not a measured instruction rate. |
| D435 acquisition and floor/depth processing | USB 3, CPU image/cloud work, memory copies | Depth calculation is inside D435. Current depth request is 480×270×30, colour disabled, unaligned, cloud decimated. Do not budget as though full-resolution RGB-D neural perception is already running. |
| SO-101 motion, exact IK, checked waypoints, servo bus | CPU callbacks and serial latency; little arithmetic | No MoveIt in the baseline. Existing idle publishing/executor overhead matters more than the five-joint solve. |
| Floor/wrist segmentation and grasp correction | CPU, image resolution and memory bandwidth | Current geometric/colour processing can run without CUDA. Object recognition can be added separately. |
| Face, console, Vosk commands, Kokoro/Piper speech | Small steady CPU plus TTS bursts and model RAM | Current voice code has CPU backends. Cache routine phrases and bound inference threads. Keep an inexpensive offline command path. |
| Learned segmentation, manipulation policy, Whisper, VLM/LLM | GPU/accelerator, model RAM and memory bandwidth | A real reason to reconsider Jetson when local latency or offline operation becomes a requirement. Desktop inference is suitable for optional, slower decisions. |
| Future ball acquisition, colour blob detection, stereo triangulation and trajectory fitting | Sensor exposure/sync/calibration, CPU image scanning, transport age | Sparse ball stereo is much cheaper than dense stereo reconstruction. A GPU is optional for the existing algorithm. Keep the catch loop onboard and wired. |
| Recording raw frames / large rosbags | SSD write rate, capacity, copies | Not the same workload as operating the robot. Avoid permanent full-rate recording and keep real captures outside Dropbox. |

The existing Pi 4 report is unusually useful evidence. `arm_report_C2.json` records MANUAL/TIDY/PATROL at 3.49/3.61/3.60 cores, with at least 2,682 MB available RAM and zero swap. PATROL's Nav2 container used about 103% of one core, arm_node 77%, EKF 35%, mission 33%, MCU link 26% and scan preparation 20%. The later arm-tier-only G1 report, after the bus-wait fix, used about 2.10 cores and retained 2,885 MB available. These are different configurations, not additive costs. They indicate CPU/scheduling pressure rather than a memory-capacity failure.

Those runs used a PC simulation at approximately 0.7× real time and omitted real D435 capture, active voice and tags. They do not establish the physical robot's utilization at wall-clock speed. A Pi 5 is a credible candidate for a tuned, slower profile; its performance is not established by the Pi 4 failure. Conversely, neither extra RAM nor a second Pi guarantees that a saturated navigation callback meets its deadline. Sources: [C2 report](../../characterization/pi_camera/results/arm_report_C2.json), [G1 report](../../characterization/pi_camera/results/pi_arm_G1_arm_tier_nav_off_with_bus_wait_fix_192546.json), [design §4.10](../../design.md#410-pi-in-the-loop-real-ball-benches-paused).

Use 16 GB on a mini PC; buy 32 GB when the premium is small or when developing/building on the robot. Eight GB is a plausible operating capacity for this non-neural stack; 16 GB provides room for camera buffers, models, browser/debugging and builds. Four GB is adequate as a candidate camera-head budget with bounded queues, not a reason to buy an expensive 16 GB Pi. Large RAM cannot accelerate CPU-bound navigation.

Public CPU measurements below are deliberately coarse. All numeric examples are Geekbench 6 records; do not mix the newer Geekbench 7 chart with them. They measure CPU workloads, not this robot, and vary with power, cooling, OS and benchmark version. The Ryzen 5650GE sample used an ASRock motherboard, not this exact Lenovo, so its figure is an orientation rather than a chassis guarantee.

| CPU/platform | Physical cores / threads | Example GB6 single / multi | What it buys here |
| --- | --- | --- | --- |
| Pi 5, stock 2.4 GHz | 4 / 4 | About 790 / 1,690; optimized software can differ | Strong upgrade from Pi 4, but least aggregate reserve in this table. |
| Orin Nano Super, 1.73 GHz | 6 / 6 | About 780 / 3,360 | More aggregate CPU than Pi; similar per-thread class. Main advantage is CUDA/TensorRT. |
| Orin NX 16 GB, MAXN SUPER | 8 / 8 | About 880 / 4,540 | More GPU/RAM and some CPU reserve; not a desktop-class per-thread upgrade. |
| Ryzen 5 PRO 5650GE | 6 / 12 | About 1,920 / 8,080 | Approximately 2.4× the Pi/Nano example's single-thread score; substantial general CPU reserve. |
| Core i5-12500T, OptiPlex 7000 | 6 / 12 | About 2,540 / 9,860 | Strongest illustrated per-thread CPU; attractive if found under budget. |

Benchmark sources: [Pi 5](https://browser.geekbench.com/v6/cpu/11625826), [Nano Super](https://browser.geekbench.com/v6/cpu/17499890), [NX SUPER](https://browser.geekbench.com/v6/cpu/18783148), [5650GE](https://browser.geekbench.com/v6/cpu/12876070), [OptiPlex 12500T](https://browser.geekbench.com/v6/cpu/11189908). This supports choosing an x86 CPU class; it does not support a claim of 4× more robot speed or a precise predicted CPU percentage. SMT's 12 threads are not 12 independent physical cores.

| Main-computer candidate | Buying budget, complete | Benefits | Costs / constraints |
| --- | --- | --- | --- |
| Lenovo ThinkCentre M75q Gen 2, Ryzen 5 PRO 5650GE, 16 GB, 256–512 GB | Target $250–330; worked budget $300 | Common business Tiny; replaceable SODIMMs/NVMe, many USB ports, strong CPU, conventional Ubuntu x86 setup | Larger/heavier than hobby mini PCs; no CUDA/CSI; used Wi-Fi/antenna and PSU inclusion vary. Confirm exact CPU, not merely M75q. |
| HP EliteDesk 805 G8 Mini, 5650GE | Same target if a listing appears | Similar CPU class and serviceable business packaging | Current reviewed listings do not establish a consistently better US deal. Buy on exact configuration and condition. |
| Dell OptiPlex 7000 Micro, i5-12500T; Lenovo M70q Gen 3 equivalent CPU class | Target $300–400; illustrative budget $375 | Better per-thread CPU; Intel media/OpenVINO options; serviceable RAM/SSD | Under-$400 availability not assured. Reviewed Dell $399.99 page was out of stock; other refurb shops were above budget. OEM DC adapter identification must work on battery. |
| Beelink SER5 Pro/MAX, Ryzen 7 5800H | Used target ≤$300–325 | Popular hobby mini PC, eight CPU cores, typically smaller than 1 L corporate systems | Model names cover different CPUs; check exact unit, power settings, fan and RAM slots. Buying target, not a verified active price. No CUDA. |
| GMKtec M5 Ultra, Ryzen 7 7730U, 16 GB/256 GB | Fernando's quoted $420; exact seller listing not supplied | 128.8×127×47.8 mm / 528 g maker claims; 8 cores/16 threads; replaceable SODIMMs | Three fast USB ports, no general GPIO; 19 V DC; see compact follow-up below. |
| GMKtec M8, Ryzen 5 PRO 6650H, 16 GB/512 GB | Maker listing $389.99 | Small (~107×111×63 mm, 590 g), six cores/12 threads, USB4, two 2.5 GbE ports, new-unit warranty | Soldered, non-upgradable 16 GB RAM; current listing specifies 20 V/5 A adapter. It has a smaller footprint than the M5 but a taller case. |
| N100/N150 mini PC | Lower price, model dependent | Compact, low idle/load power, ordinary x86 software | Four small cores leave less deadline reserve for real cameras, mapping and speech. A possible lean-build choice, not the preferred future-proof purchase under $400. |

Sources: [Lenovo specifications](https://psref.lenovo.com/syspool/Sys/PDF/ThinkCentre/ThinkCentre_M75q_Gen_2/ThinkCentre_M75q_Gen_2_Spec.PDF), [HP specifications](https://h20195.www2.hp.com/v2/getpdf.aspx/4AA8-0219ENUC.pdf), [Dell processor specifications](https://www.dell.com/support/manuals/en-us/optiplex-7000-micro/optiplex_7000_mff_setup_specs/Processor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), [GMKtec M8 listing](https://www.gmktec.com/products/gmktec-m8-amd-ryzen-5-pro-6650h-mini-pc), [Beelink's SER5 description](https://www.youtube.com/watch?v=xjNVrnecjO8). The [Newegg 5650GE/16 GB/256 GB page](https://www.newegg.com/p/N82E16883370636) displayed $309.99/backorder when opened; indexed offers differed. The [Dell $399.99 page](https://posrgoutlet.com/computers-tablets/dell-optiplex-7000-micro-pc-i5-12500t-2-00ghz-16gb-ram-256gb-nvme-windows-11-pro/) displayed out of stock. Treat targets as used-market search criteria, not guaranteed live offers. A 5750GE eight-core Lenovo is attractive at a small premium, but six good cores already meet the purchasing objective.

Jetson becomes attractive when a named onboard GPU workload earns its power/cost: multiple neural cameras, dense learned stereo, a manipulation policy that must react without Wi-Fi, or local speech/VLM latency. The Nano Super has 8 GB shared CPU/GPU memory and up to 67 sparse INT8 TOPS; the NX 16 GB has more memory and up to 157 TOPS including its accelerators. TOPS figures depend on precision/sparsity and cannot be compared directly with CPU scores or desktop GPU throughput. The Nano lacks a hardware video encoder; previews/recording are not free GPU work. The NX has a hardware encoder. [NVIDIA Orin specifications](https://www.nvidia.com/en-us/autonomous-machines/embedded-systems/jetson-orin/).

The old $249 Nano launch price is not the researched purchasing budget: [SparkFun currently lists $399](https://www.sparkfun.com/nvidia-jetson-orin-nano-developer-kit.html). Add storage and battery regulation. A complete [Waveshare NX 16 GB dual-Ethernet kit](https://www.waveshare.com/jetson-orin-nx-eth-dev-kit.htm?sku=33180) is listed at $1,409.99 with SSD/carrier/cooling; a module-only quote is not comparable with a complete PC. Current [JetPack 7 supports Orin and Ubuntu 24.04](https://developer.nvidia.com/embedded/jetpack), so a blanket Ubuntu 22.04/Jazzy incompatibility objection is outdated. Camera vendor drivers must still match the exact JetPack/kernel/carrier; CSI connector fit does not establish driver/ISP/trigger compatibility. The announced Nano 2 has no qualified purchasable price/performance here and should be revisited when needed.

For catching, reserve a stiff common bar with about 0.30–0.40 m optical-centre baseline, subject to CAD, collision and field-of-view checks. This is a proposal, not changed camera geometry. The current D435's roughly 50 mm stereo spacing is useful for the near field and is not an equivalent long-range colour stereo pair. A third centre RGB camera also does not make monochrome depth eyes into two colour eyes.

An illustrative pinhole calculation shows the value of baseline. At 1280 px width, 80° horizontal FOV and 7 m, focal length is about 763 px. Assuming independent **disparity error of 0.25 px**, depth-error propagation is `sigma_Z = Z² sigma_d / (f B)`:

| Baseline B | Disparity at 7 m | Approximate depth sigma |
| --- | --- | --- |
| 0.05 m | 5.4 px | 32 cm |
| 0.10 m | 10.9 px | 16 cm |
| 0.30 m | 32.7 px | 5.4 cm |
| 0.40 m | 43.6 px | 4.0 cm |

These are calculations, not measurements or D435 specifications. They omit calibration bias, lens distortion, exposure blur, correspondence errors and occlusion. At these optics a 74 mm ball is only about 8 px across at 7 m; making the baseline wider does not enlarge it. Relative yaw error of 0.1° is about 1.3 px at this focal length and can overwhelm the assumed subpixel noise. A rigid bar, stable manual focus, repeatable calibration and short exposures matter at least as much as compute. Excessively wide spacing hurts near-field overlap and packaging; retain the D435 for picking.

| Future colour GS camera route | Published capability | Main trade |
| --- | --- | --- |
| Pi 5 4 GB + Arducam B0492R AR0234 synchronized pair | $259.99 camera/HAT kit; about 93–94 fps at 1280×720 per eye, 38 fps at 1920×1080/1200 per eye; external trigger documented | Variable baseline, matched colour eyes, existing Pi code architecture. Native published support is Raspberry Pi OS/Pivariety, not our proven Ubuntu install. Stock lenses are 90° H/75° V, f/2.8; maker says not user-interchangeable. Confirm cable reach, desired lenses and version before purchase. |
| Pi 5 + two official colour IMX296 GS cameras | $50 each, lens extra; 1456×1088 at 60 fps; common external XTR trigger | Official documentation and selectable CS optics; lowest example camera cost. A 120 fps full-resolution stereo pair is not documented. Useful for deliberate 60 Hz experiments, not the automatic catcher recommendation. |
| Mini PC + RVC2 OAK-FFC 4P + two OV9782-FF modules | $209 + 2×$94.99; colour GS, 1280×800, modules advertised up to 120 fps; standard modules 80° H/55° V | Host-independent USB, on-head ISP and optional neural compute, no extra Linux computer. Custom mounting/calibration and DepthAI integration remain; verify synchronized pair throughput, timestamps, USB output format and exposure latency. Narrower vertical view than the Arducam kit/current catch assumption. |
| Orin + B0492N AR0234 synchronized kit | Jetson-specific kit listed $259.99 | One Linux host and direct CSI, but same sensor/mode/optics scrutiny; require exact JetPack support and verify the Jetson variant's modes/trigger. Do not transfer Pi variant results. |

Sources: [Arducam B0492R listing](https://www.arducam.com/blog/product/arducam-2-3mp2-ar0234-color-global-shutter-synchronized-stereo-camera-bundle-kit-for-raspberry-pi/), [Arducam mode table](https://docs.arducam.com/Raspberry-Pi-Camera/Multi-Camera-CamArray/Multi-Camera-CamArray/), [Arducam trigger instructions](https://docs.arducam.com/Raspberry-Pi-Camera/Multi-Camera-CamArray/external-trigger/), [Pi GS modes](https://www.raspberrypi.com/documentation/usage/camera/software.md), [Pi GS trigger](https://www.raspberrypi.com/documentation/accessories/global-shutter-camera.html), [Pi GS price](https://www.adafruit.com/product/5702), [OAK board](https://shop.luxonis.com/products/oak-ffc-4p), [OV9782 module](https://shop.luxonis.com/products/oak-ffc-ov9782-ff), [FFC wiring/mounting](https://docs.luxonis.com/hardware/platform/deploy/ffc), [OAK calibration](https://docs.luxonis.com/hardware/platform/depth/manual-calibration), [Jetson Arducam variant](https://www.arducam.com/arducam-2-3mp2-ar0234-color-global-shutter-synchronized-stereo-camera-bundle-kit-for-nvidia-jetson-agx-orin-orin-nano-orin-nx.html).

The Arducam combined width is two eyes side by side: 2560×720 is not 2560 pixels per eye. Sensor headline fps is not complete-kit fps. OV9281 kits are monochrome and miss the stated colour preference. The 5 MP Arducam OG05B10 listing's 30 fps full-resolution mode is not a catch upgrade simply because it has more pixels. With OAK, select the **RVC2 4P with V1 OV9782 modules** for this 120 fps candidate: current RVC4 OV9782 documentation lists 60 fps full resolution. A newer platform can have a slower driver mode. [Luxonis sensor/driver table](https://docs.luxonis.com/hardware/sensors/OV9782).

At 10 m/s, a ball moves approximately 17 cm between frames at 60 fps, 11 cm at 94 fps and 8 cm at 120 fps; those are sampling gaps, not exposure blur. At 2 ms exposure it moves 2 cm during the exposure. A global shutter removes line-by-line skew but not this blur or the need for enough light. The previous Pi 4 one-camera 120 fps measurement used a rolling-shutter Module 3, 768×432 ISP output and no ball; it does not qualify either new pair. Preserve the design's exposure/latency targets and judge actual 74 mm-ball detection when catching is authorized to resume.

Do camera detection on the Pi head and send stamped detections/track covariance over short Ethernet, with clock mapping and MCU trigger sequence maintained. Two 1280×800×120 streams are 246 MB/s even at one byte/pixel, or 737 MB/s as RGB888, excluding protocol overhead. Gigabit Ethernet cannot carry those raw pairs. USB 3 at 5 Gbit/s also cannot carry the RGB888 pair at that rate. Use appropriate on-device scaling/ROI and output format, bounded latest-frame queues, or faster verified transport. Do not infer low latency from advertised 120 fps. A 10 Gb/s camera board helps only if host ports/cables and the pipeline support it.

OAK's ISP/VPU can reduce host image work; the existing C++ blob detector can run on the mini PC on appropriately sized streams. Porting the whole detector to OAK is optional development, not an assumed existing feature. Dense colour stereo depth at 120 fps is also not promised by a 120 fps sensor. For the ball, detect each image then triangulate sparse observations.

The detailed purchasing arithmetic follows. Every allowance is an **estimate**, not a selected power/carrier design. The shared mini-PC/controller allowance is Teensy $31.50 + CAN/interface/prototype carrier $35 + robot DC regulator $45 + mounting/link cables $15 + powered USB hub $30 = $156.50. The $30 hub is an optional expansion reserve: Fernando clarified four baseline USB devices, analog audio, wrist camera TBD and OAK not baseline. Subtract $30 for a current mini-PC baseline without the hub. This includes an MCU interface allowance; it is not a production carrier-PCB quote. Servo and lidar USB adapters are assumed included with their respective robot kits; add their cost if missing. [Teensy price/specification](https://www.sparkfun.com/teensy-4-1.html).

| Add later | Itemization | Added budget |
| --- | --- | --- |
| Pi 5 / Arducam colour GS head | Pi 5 4 GB $130; cooler $10 est; SD $15 est; 6S→5 V supply $25 est; B0492R kit $259.99; rigid bar/trigger wiring $40 est; cables/Ethernet $15 est | $494.99 |
| Pi 5 / official IMX296 pair | Same Pi/cooling/SD/power/cabling; cameras $100; CS lenses $60 est; bar/trigger $40 est | $395.00 |
| OAK colour GS USB head | RVC2 4P $209; 2×OV9782 $189.98; FFC accessory kit $34.99; USB $15 est; bar $25 est; trigger interface $15 est; additional power allowance $15 est | $503.97 |
| Direct CSI head on Orin | Jetson AR0234 kit $259.99; bar/trigger/cables $55 est | $314.99 |

The [Pi 5 4 GB listing](https://www.adafruit.com/product/5812) was $130, and [8 GB](https://www.adafruit.com/product/5813) $200. Other resellers can differ; the budget deliberately does not use old $60/$80 launch prices. Accessory allowances must be checked against actual lens/cable/baseline choices. OAK M12 modules or changed optics can increase cost.

| Complete staged system | Compute/controller with optional $30 hub reserve | Future camera addition | Cumulative including hub reserve |
| --- | --- | --- | --- |
| Used M75q at $300 + Teensy → Pi/Arducam | $456.50 | $494.99 | $951.49 |
| Used M75q at $300 + Teensy → OAK/OV9782 | $456.50 | $503.97 | $960.47 |
| Used M75q at $300 + Teensy → Pi/IMX296, conditional 60 fps | $456.50 | $395.00 | $851.50 |
| GMKtec M8 + Teensy → OAK/OV9782 | $546.49 | $503.97 | $1,050.46 |
| GMKtec M5 Ultra at quoted $420 + Teensy → Pi/Arducam | $576.50 | $494.99 | $1,071.49 |
| GMKtec M5 Ultra at quoted $420 + Teensy → OAK/OV9782 | $576.50 | $503.97 | $1,080.47 |
| Dell 12500T at target $375 + Teensy → OAK/OV9782 | $531.50 | $503.97 | $1,035.47 |
| Pi 5 8 GB + Teensy → Arducam on same Pi | $361.50 | $314.99 | $676.49 |
| Orin Nano Super + NVMe + Teensy → direct Jetson AR0234 | $605.50 | $314.99 | $920.49 |
| NX 16 GB complete $1,409.99 kit + Teensy → direct Jetson AR0234 | $1,566.49 | $314.99 | $1,881.48 |

Pi-only now uses $200 board + $10 cooling + $15 SD + $25 power + $31.50 Teensy + $35 interfaces + $15 cables + $30 powered hub. It has less RAM and slower storage than the x86 system; add roughly $40–70 est for NVMe/HAT if wanted. Pi-only costs less, but full arm/navigation/voice plus real-camera qualification remains open. Pi 5 4 GB would reduce this by $70 with less development/memory reserve. Splitting robot/camera work between 8 GB and 4 GB Pis budgets about $550 before cameras and roughly $865 with the Arducam/bar/trigger addition; that gives weaker individual CPU threads, two OS installations and less attractive value than the used x86 route. Splitting cannot pool RAM or speed one deadline-critical callback.

If the Lenovo costs $330 rather than $300, add $30 to its row. The table already includes a $30 powered-hub allowance; substitute the actual hub price rather than adding it twice. A missing Wi-Fi kit, servo/lidar adapter or different power interface remains additional. The existing D435 is counted as owned equipment, not silently re-purchased; these are not whole-robot BOMs.

Power and packaging can change the winner. These are **planning estimates at the compute DC input**, excluding D435, lidar, face/audio, motor/arm loads and regulator loss; they are not measured robot results:

| Active computer/head | Planning load |
| --- | --- |
| Pi 5 main computer | About 7–12 W, allow higher peripheral/transient demand |
| Pi 5 stereo head with two sensors | About 10–16 W |
| Used 1 L Ryzen/Intel main computer | About 15–35 W mixed robot work, materially higher build/AI bursts possible |
| GMKtec M8 | About 15–35 W mixed work; maker advertises 40 W performance release and a 100 W supply |
| Orin Nano board under CPU/GPU work | About 12–30 W; module modes 7–25 W are not total board/peripheral consumption |
| NX board under CPU/GPU work | About 20–50 W; module limit up to 40 W is not total board input |
| OAK-FFC head | About 3–6 W; actual pipeline/sensor draw to measure |

The [OAK board documentation](https://docs.luxonis.com/hardware/products/OAK-FFC%204P) gives roughly 2.5–3 W base/camera streaming plus workload-dependent accelerator blocks; other ranges are engineering allowances. Do not compare a laptop/desktop CPU's TDP with measured whole-board power. The M75q is about 1 L and roughly 1.2–1.3 kg depending on configuration; the M8 is about 590 g per maker. Check the actual electronics bay and update physical mass/CG later instead of assuming either fits the current model.

The selected pack is 115.44 Wh nominal; 80% is about 92.35 Wh before conversion losses. Illustratively, with 40 W of all other robot loads, 10 W compute gives 111 minutes, 25 W gives 85 minutes, and 35 W gives 74 minutes. These are `92.35 Wh / total W` calculations, **not runtime predictions**, and do not reuse the drive agent's unfinished studies. An extra 15 W is consequential; measure actual mixed duty and cap unnecessary CPU boost without starving control deadlines.

The battery spans approximately 21–25.2 V in the provisional operating policy. Regulate to the exact computer's specified DC input; direct connection is inappropriate for a 19.5/20 V PC or a carrier with a lower maximum. Select a converter that maintains regulation near pack depletion, tolerates transients and supports startup/USB peaks. Dell/Lenovo adapter identification must be preserved where required to avoid throttling. Pi needs a genuine sustained 5.1 V supply with appropriate wiring/current, and USB power configuration must match the supply. Size regulators for peaks, not average watts. The $45/$25 allowances are placeholders until that electrical design is selected.

Use Ubuntu 24.04 x86 natively on the main PC. The concrete Lenovo port allocation below keeps Teensy and lidar direct, D435/wrist/catch cameras on direct fast ports, and arm/audio/touch on the powered hub. Check actual USB controllers, cables, Wi-Fi chipset, antennas, unprotected BIOS access and recovery after power loss on a used unit. Add a second Ethernet adapter only if an actual network plan requires one; a single NIC can cable to the Pi while Wi-Fi serves the desktop.

Desktop offload should accept images/crops plus time/pose metadata and return optional semantic decisions with deadlines. Appropriate examples are deciding an object's class before approach, free-form conversation, training and batch map analysis. Keep collision checking, localization, navigation, final grasp corrections, motor/safety and the future fast catch loop local. The existing 4–5 ms median Wi-Fi ROS round-trip benchmark was idle-network evidence, not a bound during roaming/congestion. Delayed results must expire rather than becoming late motion commands.

Proposed buying sequence:

1. Choose the compact M5 Ultra / M8 class after the size constraint: M5 offers RAM expansion and lower height; M8 has a smaller footprint, another fast USB-A and USB4 but fixed RAM. M5's quoted $420/16 GB/256 GB remains a candidate, not an adopted purchase. Include Teensy, hub/interface/power and the owned D435; add no catch camera now. Fernando excluded the earlier business Tiny recommendation by size.
2. Qualify the physical arm/navigation stack with actual D435, lidar, face, speech and console. Acceptance should include completed navigate-then-tidy tasks, busiest-thread/aggregate CPU, callback/data-age tails, free RAM, thermal throttling and DC watts; no simulations were started for this trade. Aim for meaningful reserve (e.g. sustained total CPU under roughly 60–70%, no critical thread continually saturated), but accept on task/deadline evidence rather than that heuristic alone.
3. When catching resumes, first specify field of view, 0.30–0.40 m bar feasibility, short-exposure indoor signal, frame rate and exposure-to-detection age. Budget about $500 for either Pi/Arducam or RVC2 OAK/OV9782. Prefer the OAK candidate if 120 fps and host independence matter; prefer Pi if its wider stock view and direct control of custom capture/detection are more useful. Validate the entire synchronized pair, not sensor advertising. If 120 fps is a hard requirement, the documented Pi/Arducam 94 fps mode and full-resolution IMX296 60 fps mode do not meet it.
4. Add onboard CUDA only after a named local neural workload fails its deadline on the mini PC and desktop offload is unsuitable. A future Jetson can be a vision coprocessor, retaining the x86 machine, or replace it after measured power/latency tradeoffs. Buying a Nano now does not guarantee future learned-manipulation models fit its shared 8 GB.

The reusable investment is the main computer, Teensy protocol and timestamped perception interface. Camera optics, drivers and sensing requirements remain replaceable. This keeps today's arm robot affordable without asserting that future catching has already been solved.

**Interface audit, November 2, 2026.** This follow-up counts connectors, physical signals and clock domains. It changes the hub allowance and identifies software/wiring gaps; it does not implement hardware bring-up or alter firmware pins. Exact owned arm adapter, lidar adapter, display and audio SKUs remain to confirm.

| Peripheral | Main-computer connection | Beyond the USB connector | Host port count |
| --- | --- | --- | --- |
| Teensy 4.1 | Native USB device/CDC to Linux serial | USB data cable to Teensy's micro-B connector; no FTDI, no PC UART and no UART header pins consumed. `Serial.begin(2000000)` is not the physical USB speed. | 1 USB 2-compatible |
| SO-101 follower, six STS3215 servos | USB → servo-bus adapter → shared one-wire half-duplex TTL bus, 1 Mbaud | Use the arm's bus board, e.g. Waveshare Bus Servo Adapter (A), not an unmodified full-duplex FTDI cable. One board serves all six IDs. External regulated servo power, matched to the actual servos, is separate from USB. | 1 USB 2-compatible |
| RPLIDAR A2M12 | USB → Slamtec adapter → 3.3 V UART, 256000 baud | Use the correct A2M12 adapter/cable and motor-power/control arrangement. A bare generic FTDI adapter may omit motor control, proper power and the connector. USB serial-chip brand is not the interface requirement. | 1 USB 2-compatible |
| D435 | USB 3 data/power | Short suitable USB 3 cable to its USB-C connector; confirm SuperSpeed negotiation. | 1 USB 3 |
| Wrist camera | TBD, optional future allocation | No physical interface selected; the software model does not establish a purchased USB camera. | 0 baseline; +1 if USB selected |
| Microphone/audio | Mini-PC CTIA analog combo jack, provisional | Compatible analog microphone + CTIA headset breakout; headphone output → powered speaker/amplifier. Mono headset mic input is not a microphone array/AEC solution. Hardware/profile/range TBD. | 0 USB; +1 if USB array selected later |
| Face display | HDMI video (or DP→HDMI) + separate regulated power | Do not use a host USB socket merely as display/backlight power. Optional USB touchscreen is an additional data device. | 0 USB for video/power; +1 if touch |
| Pi camera head later | Ethernet data + separate 5 V power | One main-PC NIC and one Pi NIC; desktop uses internal Wi-Fi. Cameras use CSI on Pi. | 0 extra main-PC USB |
| OAK head later | USB 3 data + power plan | Two camera FFCs on head, not two extra host USB sockets; sync/trigger wire is separate from USB. | +1 USB 3 |
| Drive/IMU/RC/catch switches | Via Teensy | CAN, SPI, UART and GPIO terminate on MCU/carrier. No separate PC USB-CAN or IMU USB adapter needed. | 0 extra |

The corrected arm baseline has **four USB endpoints: Teensy, SO-101 bus adapter, A2M12 adapter and D435**. OAK is optional (+1); physical wrist camera is TBD (+1 if USB); USB audio is optional (+1); touch or a directly attached leader adds one each. With analog audio, M5/M8 need no hub for the four-device baseline. A browser/gamepad on the operator's computer consumes no robot USB port. Internal Wi-Fi/Bluetooth and HDMI do not consume external USB sockets; a USB Wi-Fi substitute would.

Sources: [PJRC native USB](https://www.pjrc.com/teensy/td_serial.html), [SO-101 connection](https://huggingface.co/docs/lerobot/en/so101), [Waveshare adapter FAQ](https://docs.waveshare.com/Bus_Servo_Adapter_A/FAQ) (CH343, 1 Mbaud, external servo supply; board revision matters), [A2M12 datasheet](https://wiki.slamtec.com/download/attachments/83066883/LD310_SLAMTEC_rplidar_datasheet_A2M12_v1.0_en.pdf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), [Slamtec adapter selection](https://wiki.slamtec.com/pages/viewpage.action?pageId=90013780).

| Candidate | External USB host sockets used for planning | Other useful connectors | Interface verdict |
| --- | --- | --- | --- |
| M75q Gen 2 | 5 A + 1 C: four SuperSpeed, two USB 2 | HDMI, DP, 1 GbE; no exposed general GPIO; optional serial is configuration-dependent | Four-device baseline fits without hub; hub is optional expansion. |
| HP 805 G8 **Desktop Mini** | 6 A + 1 C, all listed as SuperSpeed | 2 DP, 1 GbE; optional Flex I/O varies | Four baseline endpoints fit; hub is optional expansion. Do not substitute the SFF datasheet. |
| Dell 7000 Micro, **35 W / 12500T** | 5 A + 1 C, all SuperSpeed | 2 DP, 1 GbE; optional HDMI/serial varies | Four baseline endpoints fit without hub; use DP→HDMI for an HDMI face. The 65 W chassis has a different rear port count. |
| GMKtec M5 Ultra | 2 A USB 3 + 2 A USB 2 + 1 C USB 3, five total | HDMI/DP, 2×2.5 GbE, no general GPIO | Four baseline devices fit natively; C remains spare. Hub only for expansion. |
| GMKtec M8 | Maker specifies 3 A USB 3 + 1 A USB 2 + 1 USB4 C | HDMI/DP, 2×2.5 GbE, no general GPIO | Four baseline devices fit natively; move light devices to a hub if expanding. |
| Pi 5 main computer | 2 A USB 3 + 2 A USB 2 | 2 micro-HDMI, 1 GbE, 2 CSI/DSI, 40-pin GPIO | Pi 5 lacks the mini PC analog jack; USB audio adds a fifth device and may require hub. CSI head adds no USB. |
| NVIDIA Nano reference carrier | Budget 4 A USB 3 | DP, 1 GbE, 2 CSI, 40-pin header | Hub and DP→HDMI needed. Current user guide also describes USB-C host mode; reserve C for service until exact carrier/software is verified, rather than relying on it for port margin. |
| Waveshare NX kit / IO-BASE-B | Budget 4 A USB 3; C for flashing; two internal USB 2 FFCs not counted as ready external sockets | DP, dual Ethernet, CSI, 40-pin header | Fits with hub; use internal USB only with the correct breakout/cable. GPIO pinmux is carrier-specific. |

Sources: [Lenovo](https://psref.lenovo.com/syspool/Sys/PDF/ThinkCentre/ThinkCentre_M75q_Gen_2/ThinkCentre_M75q_Gen_2_Spec.PDF), [HP Desktop Mini](https://h20195.www2.hp.com/v2/getpdf.aspx/4AA8-0219ENUC.pdf), [Dell Micro](https://www.dell.com/community/assets/community/687062f5-603c-4f5f-ab9d-31aa7cacb376/Optiplex7000TowersSpecsheet-d7774c6b-dd65-4925-93b0-7cc97f8af407-1287192128.pdf), [M8](https://www.gmktec.com/products/gmktec-m8-amd-ryzen-5-pro-6650h-mini-pc), [Pi](https://www.raspberrypi.com/documentation/computers/raspberry-pi.html), [Nano carrier](https://docs.nvidia.com/jetson/orin-nano-devkit/user-guide/latest/hardware_layout.html), [Waveshare carrier](https://www.waveshare.com/product/ai/boards-kits/jetson-orin/jetson-orin-io-base-b.htm). Beelink SER5 is a family-level used search suggestion, **not an interface-qualified SKU**: Pro/MAX/CPU/revision variations require the actual unit's manual/photos. Generic N100/N150 products likewise have no blanket port approval.

Optional expanded M75q allocation, including hypothetical USB wrist/audio and future OAK; not the four-device baseline:

| Physical host connector | Allocation |
| --- | --- |
| Rear USB 2 A #1 | Teensy native USB |
| Rear USB 2 A #2 | A2M12 USB adapter |
| Rear USB 3 A #1 | D435 |
| Rear USB 3 A #2 | Wrist camera |
| Front USB 3 A, 10 Gb/s | OAK head later; spare today |
| Front USB C, 5 Gb/s | Powered four-port hub upstream, with suitable data cable/adapter |
| Hub downstream 1 / 2 / 3 / 4 | Arm bus / USB audio / optional touch / service spare |
| HDMI | Face video; display power comes from regulated rail |
| GbE / internal Wi-Fi | Pi head if used / desktop and operator network |

Use a self-powered hub accepting a robot-supplied regulated rail, with sufficient downstream current and no upstream back-power. It is for light serial/audio/touch traffic; D435 and the catch head stay direct. A hub expands connectors, not upstream bandwidth or independent USB controllers. Verify the selected PC's USB topology and negotiated rates with `lsusb -t` during physical bring-up; no such hardware check was run here. Use stable `/dev/serial/by-id` names or udev aliases (`/dev/omni_mcu`, `/dev/omni_arm`, `/dev/omni_lidar`) instead of assuming ttyUSB0/ttyACM0 ordering. Identical adapters without unique serial IDs may need physical-path rules.

**The MCU budget is separate from the PC USB budget.** The checked header currently allocates 34 of 42 edge pins, including parked catch signals and payload reservations:

| Function | Teensy pins | External electronics |
| --- | --- | --- |
| Four drive motors, CAN1 | TX22, RX23 | CAN transceiver, wiring and end termination; AK40 driver still unfinished and current pin labels still say DM-2325. |
| Payload CAN3, FD-capable | TX31, RX30 | Separate CAN-FD-capable transceiver if FD is used. |
| BNO085 SPI and controls | 11 MOSI, 12 MISO, 13 SCK, 10 CS, 9 INT, 6 reset, 5 wake, 27 boot, 29 mode | IMU board with matching supply/logic. |
| RC/ELRS, Serial2 | RX7, TX8 | Compatible CRSF receiver; hardware support remains unfinished. |
| Catch feed, Serial3 | TX14, RX15 | RoboClaw interface; reserved in arm build. |
| Catch tilt, Serial4 half duplex | 17 | Proper TTL-bus interface; **this is not the SO-101's USB bus**. |
| Catch DShot / beam electronics | 2, 3 / emitter36, receivers32,33 | ESC interface / emitter driver and receivers. |
| E-stop / bumpers | 35 / 37,38 | Protected sense inputs. |
| Battery/current/rail sensing | 41,39,40 | Dividers/current sensor; analog input range respected. |
| Buzzer / LED | 4,28 | Driver/resistor as required. |
| Common camera trigger / clock pulse / left exposure strobe | 24 output / 25 output / 26 input | Camera-specific level translation, clock observer input, strobe connection. |

Eight edge pins remain: **0,1,16,18,19,20,21,34**. Serial1 can use 0/1, Serial5 20/21, and I2C0 18/19; CAN2 also uses 0/1 and therefore conflicts with Serial1. Alternative pin functions are not extra simultaneous ports. A proposed pin-budget reservation is **34 for BUS_EN**, and optionally **16 for a second exposure strobe** if the chosen cameras expose it, leaving six free. Neither reservation is implemented in `board_teensy41.h`. BUS_EN is an existing design gap: the safety enable hardware/output is not completed merely because a spare pin exists. No arm/lidar UART is consumed on Teensy in this architecture. The board's separate USB-host header and optional Ethernet are not required or counted as free PC-facing links.

**Synchronization has three different jobs.** First, synchronize the two camera exposures electrically: Teensy pin24 fans out through the correct voltage translation to both camera trigger inputs. CSI, USB, ROS message pairing and Ethernet clock sync do not substitute for that common trigger. Pin26 can observe an exposed sensor strobe; without access to a real exposure indication, trigger-to-exposure delay is a camera calibration item. The OAK FSIN route and signal direction depend on board revision/socket group; use the [FFC hardware documentation](https://docs.luxonis.com/hardware/platform/deploy/ffc), not a generic header pin guess. Only one circuit drives a trigger net.

Second, map MCU time to the main computer. Both Python and C++ MCU links implement `host_time = a × mcu_time + b` using USB command/state echoes; GPIO pulse timestamps can improve the fit. On a mini PC with no exposed GPIO, **USB echo is the available existing fallback**. It preserves event timestamps and estimates drift, but asymmetry remains unknown. Fit residual is not proof of absolute accuracy; the older <50 µs pulse target is not established by echo mode. A USB-FTDI GPIO/DCD dongle does not automatically restore that precision: the [Linux PPS documentation](https://www.kernel.org/doc/html/v6.14/driver-api/pps.html) explicitly discusses USB-induced latency/jitter.

For the arm, qualify echo mode with real D435/lidar/odometry and keep the MCU in charge of deadlines. For future precision catching, select a measured timing path: Pi/Orin edge capture plus verified intercomputer clock mapping, or a true PC UART DCD/LinuxPPS path if the exact PC has a supported native serial option and proper electrical conversion. The latter needs a PPS reader integration, not an FTDI cable. Current Orin HTE-capable input pin/pinmux remains VERIFY. A proposal should not claim precision timing closure from the presence of a 40-pin connector.

Third, align PC/Pi Linux clocks for ROS data. Start with chrony over the short wired link and measure offset under load; Wi-Fi is for desktop offload. If tighter alignment is required, hardware-timestamped PTP/NTP must be supported by both exact NICs/drivers: verify `ethtool -T`, do not infer it from 1/2.5 GbE speed. Hardware camera trigger-sequence/MCU timestamps should be retained through the pipeline so network arrival time does not become exposure time. A Pi observer could receive pin25 on a free GPIO and forward edge observations after explicit clock conversion; the observer/conversion is not implemented. GPIO18/header12 is only a possible reservation, subject to the exact CamArray HAT pin use. Sources: [chrony](https://chrony-project.org/examples.html), [kernel timestamping](https://docs.kernel.org/networking/timestamping.html).

The D435 has its own sensor clock, mapped by librealsense/ROS to host time; verify timestamp domains/global-time behaviour for the installed driver. No external D435 sync wire is allocated here. A 30 Hz depth trigger would need its own compatible interface and must not simply be attached to the catch pair's 120 Hz trigger. A2M12 exposes a scan stream without a usable absolute acquisition-clock/PPS interface in this design; reconstruct sample times from scan timing, calibrate delivery delay and de-skew with IMU/odometry. Arm status is stamped on host read; this is not a servo hardware capture timestamp. Wrist UVC timing similarly requires driver/latency characterization if used during motion.

Actual implementation gaps found by inspection:

- `omni_camera/libcamera_capture.cpp` currently maps SensorTimestamp from its assumed monotonic clock to ROS time. It does **not** consume trigger TIME events or use `FrameStamper`; verify the installed libcamera timestamp domain and exposure semantics before precision use.
- `camera_head.launch.py` launches **one** capture instance. Two independent CSI cameras need two captures; Arducam's concatenated stereo frame needs an explicit split/paired-image path. Neither is established by the mono bench result.
- `FrameStamper` exists as a core but is not integrated into that hardware capture path. OAK needs its DepthAI capture/time/trigger bridge too.
- Firmware's current camera pulse is a **20 µs active-high** pulse. Official IMX296 XTR controls exposure by **active-low pulse width**; it is not directly compatible with this output. Each selected camera needs the appropriate trigger polarity/width and voltage interface, without blocking the 1 kHz control loop for millisecond exposures. [Pi GS external trigger](https://www.raspberrypi.com/documentation/accessories/global-shutter-camera.html).
- Hardware transports exist in the MCU/arm nodes, but the current common bring-up still creates simulation TCP endpoints; A2M12 and the real D435/USB/udev setup need an explicit physical launch. Existing software support is not a completed physical deployment.

The powered hub adds **$30 est** to the earlier table, bringing the worked Lenovo system to **$456.50 now**, **$951.49 with Pi/Arducam**, or **$960.47 with OAK**. This does not include a separately purchased servo/lidar adapter if the kits omit them. Precise catcher timing is still an engineering gate with no selected extra timestamping-device price; the $500 head allowance is not a promise that this integration is complete. No simulations, live bus probes, camera benches, firmware flashes or network changes were performed for this audit.

**Compact M5 Ultra follow-up, Nov 2.** Fernando's quote is Ryzen 7 7730U / 16 GB / 256 GB at $420; the seller listing was not provided. [GMKtec's US page](https://www.gmktec.com/products/gmktec-nucbox-m5-ultra-amd-ryzen-7-7730u-mini-pc) and public variant data were checked: $339.99 is barebones; 16 GB/512 GB is $449.99 (US variant 49134622769306); 32 GB/512 GB is $559.99 and 32 GB/1 TB $599.99. These are pre-tax/shipping prices, not checkout quotes. Do not compare the complete seller offer with the barebones headline.

M5 dimensions are 128.8×127×47.8 mm, claimed 528 g. [Lenovo](https://psref.lenovo.com/syspool/Sys/PDF/ThinkCentre/ThinkCentre_M75q_Gen_2/ThinkCentre_M75q_Gen_2_Spec.PDF) is 179×183×37 mm including feet / about 1.25 kg: M5 has about half the footprint, but is taller. M5's bounding volume is 0.782 L versus [M8](https://www.gmktec.com/products/gmktec-m8-amd-ryzen-5-pro-6650h-mini-pc) 0.748 L; M8 is 107×111×63 mm / 590 g, so these are different shapes at similar volumes. Allow extra connector/bend/airflow clearance.

The [7730U](https://www.amd.com/en/products/processors/laptop/ryzen/7000-series/amd-ryzen-7-7730u.html) is Zen 3, 8 cores/16 threads, not Zen 4 despite the 7000-series name. A published [M5 Ultra GB6 run](https://browser.geekbench.com/v6/cpu/18312649) scores 1,806 single / 7,312 multi, Windows Balanced, 16 GB dual-channel. This is a credible CPU class for Nav2/ROS/arm/voice, not a pass of our robot's deadlines. Eight lower-power cores do not guarantee higher sustained performance than six higher-power cores. GPU capability is adequate for display/media; current algorithms primarily use CPU, and CUDA is absent.

M5 has two DDR4 SODIMMs (up to 64 GB maker claim), unlike M8's fixed 16 GB. Sixteen GB is a reasonable start; 256 GB holds Ubuntu/ROS/models with bounded logs, but raw captures/large bags need more space. Maker power modes are 10/15/35 W budgets, not measured whole-system battery draw. Qualify around the balanced setting and measure task timing/thermal/DC power before raising it. Supply is specified as 19 V/3.42 A; use regulated 19 V from 6S with startup/peripheral margin. USB-C PD input is advertised, but barrel power preserves C for the catch camera; verify the actual purchased revision.

| M5 connector | Allocation |
| --- | --- |
| Front USB-A 10 Gb/s #1 / #2 | D435 / SO-101 USB adapter |
| Front USB-C 10 Gb/s | Spare baseline port; future OAK only if selected |
| Rear USB 2 #1 | Teensy native USB |
| Rear USB 2 #2 | A2M12 USB adapter directly |
| Analog CTIA jack | Microphone input + headphone output via headset breakout, speaker amplifier separately powered |
| Optional hub later | Only for added wrist camera, USB audio, touch/service expansion as required |
| HDMI | Face video; display power separate |
| Two Ethernet / internal Wi-Fi | Pi head and service/network spare / desktop and operator |
| DC barrel | Regulated 19 V |

The [GMKtec UK specification](https://www.gmktec.uk/products/gmktec-nucbox-m5-ultra-amd-ryzen%E2%84%A2-7-7730u-mini-pc) agrees on two fast A, two USB 2 and one fast C. Light serial/audio throughput fits a USB 2 hub; moving lidar onto it adds a timing path to characterize. No Teensy UART is needed for lidar or arm. Hub supply, USB topology and reconnection need physical qualification. USB echo and the future precision timestamp path retain the limitations above.

At $420 the corrected mini-PC baseline compute/controller allowance is $546.50 without a hub; optional expansion reserve remains $576.50. The four-device baseline plus a Pi/Arducam head is $1,041.49, or $1,050.47 with OAK if selected, before any other accessories. Older cost-table rows retain a clearly labeled $30 optional-hub reserve, not a required purchase. M5 is a reasonable compact option for RAM expansion/lower height; M8 remains an alternative for smaller footprint, faster I/O and its lower listed complete price. No simulation or physical benchmark was run.

**Baseline correction, Nov 2 (Fernando).** OAK is optional; wrist camera is TBD. Both microphone and speaker are required, with mini-PC analog audio provisionally using the CTIA headset jack. A proper headset breakout separates microphone input and headphone output; a powered amplifier drives a bare loudspeaker. No USB audio is necessary for this analog route. The analog jack is not a multi-microphone array or automatic acoustic echo cancellation. Exact mic/amplifier, Linux input/output profile and usable listening distance remain to select/verify. Teensy connects directly through native USB CDC with the existing USB_SERIAL firmware configuration, not FTDI and not a PC UART. The corrected current M5/M8 USB count is four, so the earlier statement that all compact computers require a hub was too broad. No hardware or simulation runs were made.

## Amazon compact-PC follow-up — November 2

The expanded search keeps **M8 near $390** and **M5 Ultra near $420** as the actionable price shortlist. The additional E3B and A5 candidates below are conditional value alternatives; their live Amazon prices/delivery could not be confirmed. A listing existing is not evidence that it can ship promptly to Fernando. Direct Amazon pages exposed product/configuration text but hid main offer/delivery data; direct HTTP also returned an unavailable page, and the in-app browser was disabled. No checkout or purchase was performed. Recent tracked prices and dated deals are labeled separately from live checkout quotes and suggested buy ceilings.

| Candidate and Amazon listing | Complete configuration observed | Price evidence / proposed buying ceiling | Fit for this robot |
| --- | --- | --- | --- |
| [GMKtec M8](https://www.amazon.com/dp/B0HFS8Y8XX) | 6650H, 16 GB fixed LPDDR5, 512 GB | BasketPrice recorded $389.98 Oct 31, deal/Prime qualification applies; maker lists $389.99 | Best evidenced option inside $400. Four A + USB4 C, dual 2.5GbE, CTIA audio. Fixed RAM is the principal expansion limit. |
| [GMKtec M5 Ultra](https://www.amazon.com/dp/B0FW43RV3D) | 7730U, 16 GB DDR4, 256 GB | $419.99 Prime price recorded Nov 2; matches Fernando's $420 quote | Best flexibility near the cap: replaceable RAM, four A + C, dual 2.5GbE, CTIA audio. Small SSD and $20 budget overrun. |
| [KAMRUI E3B](https://www.amazon.com/dp/B0FLDMQHC1) | Current listing says 7430U, 32 GB DDR4, 512 GB | Live price unconfirmed. Proposed ceiling $330–350 complete, not a seller quote | Six A + one C gives two spare A after the baseline. Two RAM slots. Six Zen 3 cores give less aggregate reserve than an eight-core 7730U at comparable power. Single GbE is sufficient for a wired Pi head. |
| [GEEKOM A5](https://www.amazon.com/dp/B0D4QHSSTS) | 7430U, 16 GB replaceable DDR4, 1 TB | Live price unconfirmed; Aug 20 Amazon deal was $448.99, which is not today's quote. Prefer at $350 or less, especially a 512 GB variant | Maker 117.1×112.0×49.3 mm / 652 g, four A + two C, 2.5GbE and replaceable RAM. Useful ports/size, but six-core CPU does not justify a premium over M8/M5 here. |
| [GMKtec M6 Ultra](https://www.amazon.com/dp/B0H3KV5CLB) | 7640HS, 16 GB replaceable DDR5, 1 TB | Oct 27 Amazon deal $499.99; outside budget. Maker's $269.99 headline is barebones | Zen 4 per-thread performance and DDR5 are attractive for CPU-heavy navigation/vision. Four A + C and dual 2.5GbE fit. A future sale/open-box near $400 would make this worth revisiting. |

Price provenance: [M8 tracker](https://www.basketprice.com/p/gmktec-m8-mini-pc-amd-ryzen-pro-6650h-6c-12t-4-50ghz-dual), [M5 tracker](https://www.basketprice.com/p/gmktec-m5-ultra-gaming-mini-pc-ryzen-7-7730u-32gb-ram-512gb), [dated M6 deal](https://www.techradar.com/pro/the-gmktec-m6-ultra-is-our-favorite-mini-pc-overall-now-amazon-has-it-on-a-limited-time-deal-for-usd500), [dated A5 deal](https://www.techradar.com/pro/the-geekom-a5-delivers-a-thoughtful-design-that-handles-office-work-better-than-most-budget-mini-pcs-weve-tested-and-its-now-usd449-at-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). The M5 tracker headline says 32 GB/512 GB while its selected size and the actual Amazon product title say **16 GB/256 GB**; this is not a $420 quote for 32 GB. Prices exclude tax/shipping and may depend on Prime/coupons.

**SKU and mechanical qualification matter.** Older E3B B0FLDMQHC1 references described 5825U/16 GB; the checked Amazon title now says 7430U/32 GB. GEEKOM B0DRPD97GF, formerly linked as an A5 7430U, now says A5Pro 7530U; use the A5 link above. A SER5 Pro 5825U link B0D6RG3YQW opened a SER9 Pro 255 page; do not use it as a current 5825U quote. M8's current manufacturer table claims 107×111×63 mm, while older published reviews describe roughly 127×127×48 mm. The case revision/dimensions therefore remain VERIFY before CAD mounting; the smaller-footprint assertion is provisional. None of these observations establishes that the seller will ship the pictured revision.

**CPU evidence, not robot validation.** A public [M8 GB6.4 Windows run](https://browser.geekbench.com/v6/cpu/14211363) scores 1,982 single / 7,938 multi; the earlier [M5 GB6.7.1 Windows Balanced run](https://browser.geekbench.com/v6/cpu/18312649) is 1,806 / 7,312. These examples support treating them as comparable CPU candidates; they do not prove an 8–10% robot improvement because the benchmark minor version, power and thermals differ. Do not infer that six cores must be slower than eight. A [M6 Ultra GB6.7.1 Windows Balanced result](https://browser.geekbench.com/v6/cpu/18472498) scores 2,646 / 11,231; an [E3B 7430U GB6.7.1 Linux result](https://browser.geekbench.com/v6/cpu/18238516) scores 1,846 / 5,743. The latter has incomplete generic system identification and a different OS, so it is only supporting orientation. The M6 result supports a meaningful CPU step up from M5, without establishing task speed or battery cost. [AMD 7430U](https://www.amd.com/en/products/processors/laptop/ryzen/7000-series/amd-ryzen-5-7430u.html) is six-core Zen 3; [7640HS](https://www.amd.com/en/products/processors/laptop/ryzen/7000-series/amd-ryzen-5-7640hs.html) is six-core Zen 4. The latter's newer core is relevant to callback/navigation reserve, while actual sustained performance/DC watts remain unmeasured. GPU capability is secondary for our existing CPU paths; none supplies CUDA. Extra SSD capacity principally helps recording, not control-loop speed.

**Interfaces and power.** All five have enough physical ports for native Teensy USB CDC, one SO-101 USB bus adapter, the A2M12 USB adapter and direct USB 3 D435. HDMI drives the face; separate regulated power feeds it. Pi camera-head data uses Ethernet; a single NIC is enough. No host UART, FTDI adapter for Teensy, or main-PC GPIO is required for this baseline. No mandatory hub. E3B has two spare A plus C; A5 has two spare C; M5/M8/M6 have one spare C. Connector count does not establish independent USB controllers or available peripheral power.

[GMKtec M8](https://www.gmktec.com/products/gmktec-m8-amd-ryzen-5-pro-6650h-mini-pc) specifies 20 V/5 A DC. [M6](https://www.gmktec.com/products/amd-ryzen-5-7640hs-mini-pc-nucbox-m6-ultra) specifies 19 V/6.32 A and CTIA audio; use its conservative four-A/one-C port count, despite a deal article claiming two USB4 ports. [A5](https://www.geekompc.com/products/geekom-a5-mini-pc/) specifies 19 V/3.42 A and a headphone jack; microphone-input support is not established by that wording. The [E3B manufacturer family page](https://kamrui.com/products/kamrui-pionva-business-e3b) specifies 19 V/3.42 A, 5.5/2.1 mm, but mixes 16/32 GB information; confirm the purchased 7430U unit's label and mic-in capability. Use the correct regulated rail and barrel dimensions, never raw 6S. Adapter ratings are supply capacity, not measured operating draw. Preserve converter startup/headroom at the pack's low voltage; M8's 20 V output close to the 21 V low-battery threshold needs appropriate regulation/dropout margin.

M5/M8/M6 explicitly specify CTIA mic/headphone audio. A5/E3B microphone support remains conditional; reserve **$15 est for a USB audio adapter** if analog mic input cannot be confirmed. The spare C on A5 needs a suitable C audio device or C-to-A connection; E3B can use spare A. This fallback still fits without a hub. A compatible microphone and separately powered speaker/amplifier are needed in either case; a codec/jack is not a built-in microphone or loudspeaker. All retain the same unfinished precision timing path described earlier: native USB echo for the arm, and measured trigger/frame/clock integration for catching later.

**Battery filter.** The [current Beelink EQR6](https://us.bee-link.com/products/beelink-eqr6) is $459 direct, pre-order 24 GB onboard LPDDR5/500 GB, with a built-in 85 W AC PSU. Exclude this revision from the battery shortlist: powering it via an inverter adds cost/volume/losses and an internal DC modification has not been qualified. This finding does not apply automatically to externally powered Beelink SER models. Beelink SER5 MAX 7735U/24 GB/500 GB [has an Amazon listing](https://www.amazon.com/dp/B0DRFDB78L), but the Aug 28 price-history quote was $499–529, not a verified sub-$400 offer. BOSGAME P4 Ultra 7730U is $459.99 direct / 16 GB / 1 TB and offers no clear CPU advantage over M5. MINISFORUM UM760 Slim 7640HS/16 GB/1 TB was tracked at $619 Oct 31; good CPU class, poor fit to this cap. Do not reuse old $250–350 deal prices as current availability.

**Costs carried forward.** The unchanged $126.50 common allowance is Teensy $31.50 + carrier/interfaces $35 est + main DC conversion $45 est + cables $15 est. At the tracked prices, M8 is **$516.48** now / **$1,011.47** with the $494.99 Pi/Arducam head later; M5 is **$546.49** / **$1,041.48**. At its proposed $350 maximum, E3B would be $476.50, or $491.50 with the contingent USB audio adapter. These are compute/controller budgets, not whole-robot prices; already-owned D435 adds $0, hub is optional +$30, audio transducers and any separately purchased arm/lidar adapter remain outside this allowance as earlier. M6 at $499.99 would be $626.49 before any revised converter cost, which is why it is a sale watch rather than the current recommendation. No simulations, physical benchmarks, firmware flashes or robot operations were performed.

## Broader coverage audit — November 2

Expanded beyond the earlier five to PELADN WO4/WO7, AOOSTAR GEM10/MACO, ACEMAGIC AM18/K1 Intel/K1 AMD/M1/AM06, TRIGKEY S6/S6 Pro, BMAX B8, MINISFORUM UM680/UM780/UN1250/UN1265 and Intel/ASUS NUC 12 Pro / ASUS PN52. Older sale pages are discovery leads, not active offers. No newly researched Amazon offer below $400 was confirmed to beat M8/M5 on a complete configuration, stock, physical fit and electrical qualification together. This is a limitation of the evidence, not a claim that no better coupon exists. Live Amazon delivery/offer data remained unavailable.

| Additional candidate | Price and configuration evidence | Assessment |
| --- | --- | --- |
| [ACEMAGIC AM18 7640HS](https://acemagic.com/products/acemagic-am18-mini-pc) | Maker $409, available US variant, 16 GB/512 GB; Amazon US offer not confirmed | Best new concrete performance lead. Two replaceable DDR5 slots but one 16 GB module fitted. 133.5×132×55 mm; four A + one USB4 data C, separate power C. Its input is described as both 100 W and 19 V/6.32 A (120 W): connector/protocol/regulation VERIFY before robot selection. |
| [PELADN WO4 7640HS](https://www.amazon.com/dp/B0H68XHWWJ) | Checked Amazon title: 16 GB/1 TB; current price unconfirmed | Worth selecting over M5 if a complete offer is near $400 and the revision matches the manufacturer specs. Same CPU class as M6/AM18; CPU headroom, replaceable DDR5, spare C and ordinary DC barrel are useful. |
| [PELADN WO7 7735U](https://www.amazon.com/dp/B0FMNHYQ9G) | Checked Amazon title: 32 GB/1 TB; current price unconfirmed. A different WO7 ASIN's last recorded quote was $499.99 Feb 5, not a current offer | Best new small-case/RAM lead. Maker claims 113×113×36 mm, 550 g, replaceable DDR5. Suggested complete price ceiling $400, a buying criterion rather than a quote. Its C ports are USB 3.2, not USB4. |
| [AOOSTAR MACO 6850H](https://www.amazon.com/dp/B0G698213Z) | Maker $459 available US 24 GB/1 TB; $369 no-SSD variant unavailable. Amazon Sep 8 tracked quote $469, not a live price | More CPU/memory and I/O, but fixed 24 GB, larger case and price over cap. Older GEM10 Amazon link now opens MACO; do not price it as a $350 complete GEM10. |
| [ACEMAGIC K1 i5-12600H](https://acemagic.com/products/acemagic-k1-12600h-mini-pc) | Amazon coupon deal published Oct 22: about $422 for 16 GB/512 GB; live coupon unconfirmed. Maker's $489 32 GB/1 TB variant unavailable, 16 GB/512 GB currently $739 in its feed | Useful Intel alternative with six A ports and replaceable RAM. A dated Amazon deal is more attractive than current maker configuration prices; actual sustained CPU speed needs a physical check. Do not treat Intel's 12 hybrid cores as 12 performance cores. |
| [Intel NUC 12 Pro WSHi5/WSKi5](https://www.amazon.com/dp/B0BJD5ZJFZ) | New 16 GB/512 GB Amazon tracker quote $699.99 is stale/over cap. Inspected used 16 GB/512 GB eBay example sold for $399.99 Sep 4 | Strong used-market search target, preferably $300–350 complete; this is not an available $350 offer. Compact professional platform, replaceable RAM, four A + two Thunderbolt C, headset audio, Intel wired/Wi-Fi parts and detailed technical manual. |

Primary electrical references: [WO4 manufacturer](https://peladn.com/products/wo4-7640hs-mini-pc), [WO7 manufacturer](https://peladn.com/products/wo7-7735u-mini-pc), [MACO manufacturer](https://aoostar.com/products/aoostar-maco-6850h), [K1 Intel manufacturer](https://acemagic.com/products/acemagic-k1-12600h-mini-pc), [NUC technical specification](https://dlcdnets.asus.com/pub/ASUS/NUC/NUC_12_Extreme_Compute_Element/NUC12WS_TPS_ver1.6.pdf?model=NUC12WSH). Price references: [Oct 22 K1 coupon deal](https://www.dealnews.com/Ace-Magic-K1-Mini-PC-Intel-i5-12600-H-Desktop-PC-for-422-free-shipping/22305135.html), [MACO Sep tracker](https://pricehistory.app/p/aoostar-maco-amd-r7-6850h-mini-pc-Zm7ZujQ2), [WO7 old quote](https://pricehistory.app/p/peladn-gaming-mini-pc-7735u-beats-5825u-S2SFYA2h), [sold NUC example](https://www.ebay.com/itm/327324465885).

### Connector and power closure for the new candidates

| Model | Host data connectors; Ethernet | Audio; power | Baseline USB allocation |
| --- | --- | --- | --- |
| AM18 | 2 fast A + 2 USB 2 A + USB4 C; dual 2.5GbE | 2-in-1 analog jack; separate C power input, protocol/rating conflict above | D435/arm on fast A, Teensy/lidar on USB 2; data C remains spare. The power C is not another spare USB data socket. |
| WO4 | 2 fast A + 2 USB 2 A + USB4 C + USB 3.2 C; maker specifies one 2.5GbE + one GbE | Explicit headphone/mic combo; 19 V/6.32 A, 5.5/2.5 mm barrel | Same four-A allocation, two spare C. Amazon bullets mention one RJ45 despite the dual-LAN title; purchased revision's LAN count needs confirmation. One NIC still suffices for a Pi head. |
| WO7 | 2 fast A + 2 USB 2 A + 2 USB 3.2 C; one GbE | Explicit headphone/mic combo; 19 V/3.42 A, 5.5/2.5 mm barrel | Same four-A allocation, two spare C. Manufacturer has one NVMe slot; do not apply WO4's two-drive specification. |
| MACO | 4 A + 2 USB4 C; dual Intel I226-V 2.5GbE | Generic 3.5 mm jack, mic input VERIFY or +$15 USB audio contingency; 19 V/6.32 A | Four A cover baseline and two C stay spare. Treat rear A conservatively as USB 2 until actual speed is checked. |
| K1 Intel | 6 A + USB 3.2 C; one GbE | Generic phone/audio jack: mic VERIFY or +$15 USB audio contingency; 19 V/6.3 A, 5.5/2.1 mm barrel | Four A cover baseline, two A + C remain spare. |
| NUC 12 Pro | 3 fast A + 1 USB 2 A + 2 TB4 C on the selected WSH/WSK kit; one 2.5GbE | Stereo headset jack; documented 12–20 V DC input, use a regulated rail | D435, arm and lidar on fast A; Teensy USB 2; two C spare. Verify exact SKU: select NUC L10 systems omit TB4. Internal USB headers are not extra exterior sockets or UART/GPIO. |

Thus a hub is still optional for these configurations. Teensy uses native USB CDC without FTDI; arm and lidar each retain their dedicated USB adapters. No robot UART moves onto the main computer. HDMI supplies face video; audio transducers, display and servo power are separate. None establishes native camera trigger GPIO or closes the precision clock path. Intel NIC model names alone do not validate PTP; keep the earlier ethtool/measurement qualification.

WO4 maker dimensions are 128×128×52 mm / 550 g. NUC WSH tall and WSK slim are about 117×112×54/37 mm; confirm exact chassis from its manual/listing. [MACO's published review](https://www.techradar.com/pro/aoostar-maco-6850h-mini-pc-review) gives 150×132×57 mm, so it approaches the size concern again and is not a drop-in M5 mount. These remain purchasing dimensions, not CAD fit checks. K1 Intel is 128×128.2×41.3 mm.

### Performance and cost implications

Use the earlier M6 7640HS sample as a CPU-class reference for AM18/WO4, not a benchmark of those machines. Their single-module RAM, cooling and power settings can change the result. [WO7 GB6.3 Windows Balanced](https://browser.geekbench.com/v6/cpu/15557026) scores 2,126 single / 9,371 multi (32 GB DDR5); [NUC12WSHi5 GB6.2.2 Windows](https://browser.geekbench.com/v6/cpu/3736159) scores 2,061 / 9,559. These are CPU orientation from individual submissions, not matched robot tests; no benchmarks were run here. CPU per-thread reserve is still the primary navigation/control-system resource, with parallel reserve for depth processing, voice and arm callbacks. GPU marketing, display count and OCuLink do not accelerate the currently implemented CPU algorithms. Adding a second matched AM18 memory module would improve bandwidth but its current cost must be added; it is not free with the $409 offer.

With the unchanged common $126.50 allowance, AM18 is **$535.50 provisional**, MACO maker offer **$585.50**, K1 Intel at the dated ~$422 coupon **~$548.50**, and a hypothetical $350 used NUC **$476.50**. A WO4/WO7 priced at a $400 ceiling would total **$526.50**. Unknown/expired offers are not purchasable BOMs. AM18 still needs a priced and verified C power solution; its $45 converter placeholder may change. Add $494.99 estimated for the later Pi/Arducam stereo head, or the earlier OAK estimate only if selected. No hub is automatically added; exact microphone/speaker hardware is outside these compute budgets as before.

### Other leads checked and why they were not promoted

- **ACEMAGIC K1 AMD**: maker feed lists 7430U/16 GB/512 GB $359 available and 7730U/16 GB/512 GB $409 available. Six A + C and 19 V input fit; however, the [manufacturer](https://acemagic.com/products/acemagic-k1-mini-pc) explicitly says **soldered LPDDR4X**, including the 7730U version. It is not the Intel K1's replaceable-RAM design. Retain as a port-rich budget alternative, not a clear future-flexibility win over M5. Microphone input remains to verify.
- **ACEMAGIC M1/AM06**: maker M1 7735H/24 GB/1 TB $509 available; 6800H and AM06 7730U $449 variants unavailable. No current complete sub-$400 win established. Do not mix M1 Intel and AMD generations.
- **MINISFORUM UM680/UM780/UN series**: public current variant feeds show UM680 16 GB/1 TB $335.90 and UM780 XTX 32 GB/1 TB $569, both unavailable, as is the inspected $190 barebones UN1265 refurb. A site navigation banner saying UM780 32 GB/1 TB $399 contradicts the product variants and is not a purchasable $399 offer. Refurb pages also disagree with collection-card stock; selected product variant wins.
- **AOOSTAR GEM10**: absent from the inspected current direct catalogue; older Amazon link changed to MACO. Its old $350 deal is not an active alternative confirmed here.
- **TRIGKEY S6/S6 Pro and BMAX B8 Plus**: older 6600H/7735HS/12600H offerings found, but exact Amazon pages failed and no current complete price/stock/electrical revision was established. Keep search targets if a real offer appears; do not fill the comparison with old deal prices.
- **ASUS PN52 / new NUC**: compact professional products, but no complete current offer near $400 established; used NUC 12 is the more useful value search. N100/N150 and old 3500U/5500U/5700U models do not offer an evident performance improvement at this budget, and no need to move back to Lenovo/Dell/HP 1 L business boxes.

Conclusion: the broadened search adds real alternatives and one near-budget direct-store CPU upgrade, but does not establish a superior ready-to-ship Amazon purchase below $400. Keep M8/M5 as the evidenced price options; price-check the PELADN pair and a complete used NUC, and qualify AM18 power before promoting it. No simulations, live robot sessions, firmware flashes or hardware benches were run.

## Amazon PDF audit — final shortlist, November 2, 2026

Source: Fernando's `amazon.pdf`, saved Nov 2 at 14:21, 16 pages of the first Amazon results page. Prices below are pre-tax captured offers; coupons may be account-specific or expire. The search result title on page 2 is partly clipped by the printed fixed header. The i5-13420H identification matches the remaining title, case photograph and dual-LAN/Wi-Fi/BT description to Amazon B0H9YCL9FY, whose seller images explicitly identify AT103. Treat the price-to-ASIN mapping as a strong match rather than an embedded PDF product link: the PDF has no link annotations. Amazon delivery in this snapshot is generally Nov 16, not immediate shipment.

This audit replaces the report's earlier actionable shortlist. No simulation, hardware session or benchmark was run. Manufacturer pages verify specifications; every purchase link below is Amazon.

| Rank / role | Exact Amazon configuration | Saved offer | Why selected / limitations |
| --- | --- | --- | --- |
| 1, performance stretch: [BMAX B8A Pro](https://www.amazon.com/dp/B0FY5M9NCZ) | Ryzen 7 8745HS, 8C/16T Zen 4, Radeon 780M; 16 GB DDR5; 512 GB NVMe | Page 7: $459.99, 5% checkout discount = $436.99 | Best CPU and graphics headroom of these three, replaceable RAM, compact. $36.99 above PC budget. Maker and Amazon disagree about power/display specifications; sustained thermal performance unmeasured. |
| 2, within budget: [Getorli AT103](https://www.amazon.com/dp/B0H9YCL9FY) | Core i5-13420H, 4P+4E / 12 threads; Intel UHD; 16 GB DDR4; 512 GB PCIe 3 NVMe | Page 2: $449.99, coupon price $379.99 | Strong per-thread CPU, replaceable RAM and four fast A sockets. Least complete primary-source documentation: exact DC rating, microphone input and dimensions unconfirmed. Appropriate conditional budget choice; not yet a complete battery wiring specification. |
| 3, documented interfaces: [GMKtec M5 Ultra](https://www.amazon.com/dp/B0CQ7N6LXB) | Ryzen 7 7730U, 8C/16T Zen 3; Vega graphics; 16 GB DDR4; 512 GB NVMe | Page 4: $449.99 | Replaceable RAM, documented CTIA mic/audio and DC connector, dual 2.5GbE. Slower CPU/GPU class and costs $13 more than discounted BMAX. This PDF configuration has 512 GB; earlier $420/256 GB quote is separate. |

### Exact interfaces and expansion

| Item | BMAX B8A Pro | Getorli AT103 i5-13420H | GMKtec M5 Ultra |
| --- | --- | --- | --- |
| USB-A | 2 USB 3.0 (5 Gb/s), 2 USB 2.0 | 4 USB 3.2 in seller diagram; A generation/speed not specified there | 2 USB 3.2 Gen 2 (10 Gb/s), 2 USB 2.0 |
| USB-C | 1 full-function; data/video; speed and PD input not established | 1 USB 3.2 Gen 2, data + DP, per seller diagram; no verified power-input claim | 1 USB 3.2 Gen 2, 10 Gb/s, DP; maker also advertises PD input |
| Network | 1 x 2.5GbE, Wi-Fi 6, BT 5.2 | 2 x 1GbE, Wi-Fi 6, BT 5.2 | 2 x 2.5GbE RTL8125; Wi-Fi 6E RZ616; BT 5.2 |
| Display | 1 HDMI + 1 DP + C | 1 HDMI + 1 DP + C | 1 HDMI 2.0 + 1 DP 1.4 + C |
| Audio | 3.5 mm headset jack; CTIA/mic wiring VERIFY | 3.5 mm jack visible; mic support VERIFY | 3.5 mm CTIA headset input/output |
| RAM | 2 DDR5 SO-DIMMs per Amazon; maker lists 16 GB. Do not treat advertised 256 GB as BIOS-tested capacity | 2 DDR4 SO-DIMMs, seller specifies up to 64 GB | 2 DDR4-3200 SO-DIMMs, up to 64 GB |
| Storage | Two M.2 2280 NVMe positions, Gen 4 x4 main / Gen 3 x4 expansion per maker; one occupied | Two M.2 2280 slots per seller diagram; 512 GB installed | Two M.2 2280 slots, PCIe 3 x4; one occupied |
| Power | Maker: 19 V / 3.42 A, about 65 W adapter rating; Amazon generic metadata: 120 W. Resolve supplied unit label before selecting regulator | Barrel DC visible; exact voltage/current and barrel dimensions unconfirmed from primary listing | 19 V / 3.42 A, 5.5/2.5 mm barrel; use this to preserve C for data |
| Size / mass | Maker: 126 x 112 x 52 mm, ~430 g | Primary listing dimensions/mass not verified; do not import specs from Core 3 or Glorlin variants | Maker: 128.8 x 127 x 47.8 mm, ~528 g |
| GPIO / native robot UART / CSI | None exposed | None exposed | None exposed |

Sources: [BMAX manufacturer specification](https://www.bmaxit.com/MaxMini-B8A-Pro-pd577407348.html), [Getorli exact Amazon seller specifications and images](https://www.amazon.com/dp/B0H9YCL9FY), [GMKtec manufacturer specification](https://www.gmktec.com/products/gmktec-nucbox-m5-ultra-amd-ryzen-7-7730u-mini-pc). BMAX Amazon bullets incorrectly mention dual HDMI alongside DP; maker table and chassis specify one HDMI and one DP. No finalist has verified USB4/eGPU capability. USB-C full-function wording does not establish it. USB port count does not imply independent root controllers or dedicated bandwidth.

### Resource and performance trade

The existing robot workload is principally CPU-limited: Nav2/MPPI, localization, ROS scheduling, point-cloud/filtering and ordinary arm vision use CPU. The D435 produces depth internally. Sixteen GB provides camera/model/debugging buffer capacity; RAM expansion matters for future local models and builds, not for accelerating a saturated CPU. TTS and command recognition add CPU peaks. GPU benefit requires a selected implementation/backend; none provides CUDA. Radeon 780M is the strongest graphics option here, but gaming performance does not predict ROS speed. Noncritical neural/batch tasks can stay on the desktop over Wi-Fi.

Illustrative primary public Geekbench 6 records (not these three units tested together): [8745HS, unidentified chassis, Linux 6.4](https://browser.geekbench.com/v6/cpu/13080666): 2522 / 12357 single/multi; [i5-13420H, Lenovo laptop, Ubuntu 6.3](https://browser.geekbench.com/v6/cpu/9284673): 2071 / 7558; [actual M5 Ultra, Windows Balanced 6.7.1](https://browser.geekbench.com/v6/cpu/18312649): 1806 / 7312. Different OS, version, cooling and power limits prevent turning these into robot speedups. They support the BMAX CPU class as the stronger reserve choice; they do not establish FPS, robot CPU percentages or battery runtime. Getorli H-series versus M5 U-series is not a measured whole-system efficiency comparison.

All three have this baseline port allocation: D435 on direct fast A; Teensy on A using native USB CDC and a micro-B data cable (no FTDI); SO-101 on A through its half-duplex TTL servo-bus adapter; A2M12 on A through its USB/UART and motor-power adapter. C remains spare for USB audio, wrist camera or service access. Serial adapters and servos need appropriate separate power; do not feed servo/motor power from PC USB. If arm/lidar kits do not include adapters, add their actual prices before ordering. HDMI face video and separate regulated display power consume no additional data socket. A powered USB hub is optional expansion, particularly if audio and a wrist camera both use USB. Keep D435 direct.

Analog speaker/mic use requires actual microphone, compatible splitter, powered speaker/amp and software echo handling; a jack is not a built-in microphone/speaker. M5 CTIA support is documented; other two need confirmation or a USB audio dongle (allow $15). No speech-quality guarantee follows from jack presence.

Teensy supplies robot CAN/GPIO/UART and hardware timing. Existing USB echo maps MCU timestamps to PC time for the arm; this has no measured <50 us guarantee. Later GS stereo requires a common hardware trigger, voltage-compatible interface, exposure/frame association and measured cross-computer clock alignment. Connect a future Pi camera head over Ethernet and send detections; a second NIC is convenient but not essential. NIC speed and count do not prove hardware PTP timestamping. Wi-Fi offload is suitable for noncritical tasks.

### Staged compute/controller cost

Common allowance, explicitly estimated: Teensy 4.1 $31.50 + carrier/CAN/trigger interfaces $35 + main DC converter $45 + data/power cables $15 = $126.50. The DC converter allowance is provisional until the selected unit's input label and load are known. No mandatory hub. Excludes owned D435, arm/lidar themselves, missing kit adapters, display, actual microphone/speaker hardware, battery, tax and shipping.

| Proposal | PC | Compute/controller now | Later Pi 5 / colour GS head allowance | Combined staged total |
| --- | ---: | ---: | ---: | ---: |
| BMAX, 5% applies | $436.99 | $563.49 | $494.99 est | $1,058.48 |
| Getorli, coupon applies | $379.99 | $506.49 | $494.99 est | $1,001.48 |
| M5 Ultra, PDF 512 GB | $449.99 | $576.49 | $494.99 est | $1,071.48 |

Future head allowance reuses the earlier Pi 5 4 GB / Arducam B0492R colour AR0234 wide-baseline package and supporting power/cooling/bar/trigger/cables. It is an estimate, not an all-Amazon verified cart. Requote every accessory and head component on Amazon at purchase. A 30–40 cm baseline and ~94 fps 720p per eye remain proposed specifications requiring qualification. Do not buy the future head now merely to future-proof a PC.

Other PDF entries screened: Glorlin GT103 6800H at $419.99 coupon is the closest fourth choice (16 GB LPDDR5, no verified RAM upgrade, strong Radeon 680M); KAMRUI E3B 7530U ~$408.49 after 5% costs nearly BMAX money for less CPU reserve; Beelink SER5 5500U $389 is an older six-core Zen 2 offer, not SER5 MAX/5800H; KAMRUI P2 5425U $279.98 coupon is a budget-saving four-core alternative. Ryzen 3500U/3501U, N5095 and N-series entries offer less CPU reserve. No verified used-popularity/installed-base statistics exist for the new BMAX/Getorli SKUs; GMKtec has clearer product documentation, not a quantified reliability advantage.

Recommendation: BMAX if a $37 PC-budget stretch is acceptable and seller confirms the supplied DC label; Getorli for the $400 cap, conditional on DC/mic qualification; M5 if documented connectors and its expansion/networking outweigh the price/performance penalty. Keep Teensy/D435, defer catcher cameras, and measure physical performance after purchase. No purchase was made.
