fernandomierhicks/omni-robot/database/motor_tests.csv

id | motor_id | motor_name | esc | load | device | v_min_V | v_max_V | rpm_max | rpm_per_V_at_max | current_max_A | power_elec_max_W | power_mech_max_W | torque_max_Nm | thrust_max_N | eff_max | n_points | url | prov_default | source_ids | date_checked | notes
tyto-3nj9 | tyto-gemfan-m2306l-2200kv-brushless-outrunner-motor-ccw | Gemfan M2306L 2200kv Brushless Outrunner Motor CCW | afro-race-spec-mini-esc-with-bec-20a | propeller self-tightening-propeller-6032-red-cw |  | 7.78049 | 7.98741 | 11413 | 1466.87 | 8.11322 | 63.1248 |  |  | 2.73426 |  | 14 | https://database.tytorobotics.com/tests/3nj9/tmotor-f22035-2850kv-with-prop | third_party | S132 | 2026-10-20 | Test title: TMotor F22035-2850KV with PROP. Title names a different motor than the link: check.
tyto-kzey | tyto-gemfan-m2306l-2200kv-brushless-outrunner-motor-ccw | Gemfan M2306L 2200kv Brushless Outrunner Motor CCW | afro-race-spec-mini-esc-with-bec-20a | propeller self-tightening-propeller-6032-red-cw |  | 7.67719 | 8.03554 | 13367 | 1741.13 | 13.3071 | 102.161 |  |  | 3.74803 |  | 17 | https://database.tytorobotics.com/tests/kzey/tmotor-f22035-2850kv-with-prop | third_party | S132 | 2026-10-20 | Test title: TMotor F22035-2850KV with PROP. Title names a different motor than the link: check.
tyto-xxkz | tyto-gemfan-m2306l-2200kv-brushless-outrunner-motor-ccw | Gemfan M2306L 2200kv Brushless Outrunner Motor CCW | afro-race-spec-mini-esc-with-bec-20a | propeller self-tightening-propeller-6032-red-cw |  | 7.75436 | 7.97012 | 11629 | 1499.67 | 8.44281 | 65.4686 |  |  | 2.7998 |  | 14 | https://database.tytorobotics.com/tests/xxkz/tmotor-f22035-2850kv-with-prop | third_party | S132 | 2026-10-20 | Test title: TMotor F22035-2850KV with PROP. Title names a different motor than the link: check.
tyto-64je | tyto-gemfan-m2306l-2200kv-brushless-outrunner-motor-ccw | Gemfan M2306L 2200kv Brushless Outrunner Motor CCW | afro-race-spec-mini-esc-with-bec-20a | propeller self-tightening-propeller-6032-red-cw |  | 7.72985 | 7.95187 | 11900 | 1539.49 | 8.70694 | 67.3033 |  |  | 3.01734 |  | 14 | https://database.tytorobotics.com/tests/64je/tmotor-f22035-2850kv-with-prop | third_party | S132 | 2026-10-20 | Test title: TMotor F22035-2850KV with PROP. Title names a different motor than the link: check.
tyto-ymr | tyto-gemfan-m2306l-2200kv-brushless-outrunner-motor-ccw | Gemfan M2306L 2200kv Brushless Outrunner Motor CCW | emax-blheli-80a-ubec-5a-5v | propeller 6030-carbon-nylon |  | 14.6962 | 14.7031 | 19497 | 1326.67 | 7.48476 | 109.998 | 69.4339 | 0.0340075 | 3.5441 | 0.631231 | 11 | https://database.tytorobotics.com/tests/ymr/gemfan-m2306l-2200kv-with-6030-nylon | third_party | S132 | 2026-10-20 | Test title: Gemfan M2306L 2200kv With 6030 Nylon.
tyto-k7z | tyto-gemfan-m2306l-2200kv-brushless-outrunner-motor-ccw | Gemfan M2306L 2200kv Brushless Outrunner Motor CCW | emax-blheli-80a-ubec-5a-5v | propeller carbon-fiber-5030 |  | 14.688 | 14.7031 | 27497 | 1871.82 | 13.0919 | 192.319 | 137.265 | 0.0476702 | 4.63248 | 0.713737 | 11 | https://database.tytorobotics.com/tests/k7z/gemfan-m2306l-2200kv-with-5030-carbon | third_party | S132 | 2026-10-20 | Test title: Gemfan M2306L 2200kv with 5030 Carbon.
tyto-3yj | tyto-gemfan-m2306l-2200kv-brushless-outrunner-motor-ccw | Gemfan M2306L 2200kv Brushless Outrunner Motor CCW | emax-blheli-80a-ubec-5a-5v | propeller gemfan-6030-thick-hub |  | 14.6817 | 14.7028 | 24815 | 1690.2 | 22.0293 | 323.427 | 223.418 | 0.0859756 | 8.05079 | 0.690783 | 11 | https://database.tytorobotics.com/tests/3yj/gemfan-m2306l-2200kv-with-gemfan-6030-thick-hub | third_party | S132 | 2026-10-20 | Test title: Gemfan M2306L 2200kv with Gemfan 6030 Thick hub.
tyto-xme | tyto-gemfan-m2306l-2200kv-brushless-outrunner-motor-ccw | Gemfan M2306L 2200kv Brushless Outrunner Motor CCW | emax-blheli-80a-ubec-5a-5v | propeller dalprop-6040 |  | 14.676 | 14.7032 | 23268 | 1585.45 | 27.206 | 399.274 | 254.677 | 0.104521 | 8.65668 | 0.644739 | 11 | https://database.tytorobotics.com/tests/xme/gemfan-m2306l-2200kv-with-dalprop-6040 | third_party | S132 | 2026-10-20 | Test title: Gemfan M2306L 2200kv with DalProp 6040.
tyto-zx99 | tyto-qav-rt2206-2000kv-quad-racing-motor-cw | QAV RT2206-2000KV Quad Racing Motor CW | flier-f-22s-350a-a | propeller gemfan-6030-thick-hub |  | 11.908 | 12.2562 | 11433 | 960.114 | 4.52755 | 53.9139 |  |  | 2.80585 |  | 15 | https://database.tytorobotics.com/tests/zx99/tmotor-f22035-1500kv-with-master-as-6x2 | third_party | S132 | 2026-10-20 | Test title: TMotor F22035-1500KV with Master AS 6x2. Title names a different motor than the link: check.
tyto-m9n | tyto-qav-rt2206-2000kv-quad-racing-motor-cw | QAV RT2206-2000KV Quad Racing Motor CW | emax-blheli-80a-ubec-5a-5v | propeller 6030-carbon-nylon |  | 14.695 | 14.7029 | 19008 | 1293.5 | 8.06864 | 118.569 | 77.7696 | 0.0390701 | 4.05381 | 0.655902 | 11 | https://database.tytorobotics.com/tests/m9n/qav-2206-2000kv-with-6030-nylon | third_party | S132 | 2026-10-20 | Test title: QAV 2206 2000Kv With 6030 Nylon.
tyto-446 | tyto-qav-rt2206-2000kv-quad-racing-motor-cw | QAV RT2206-2000KV Quad Racing Motor CW | emax-blheli-80a-ubec-5a-5v | propeller carbon-fiber-5030 |  | 14.6972 | 14.705 | 23687 | 1611.67 | 8.65754 | 127.241 | 91.8077 | 0.0370118 | 3.46964 | 0.721524 | 11 | https://database.tytorobotics.com/tests/446/qav-2206-2000kv-with-5030-carbon | third_party | S132 | 2026-10-20 | Test title: QAV 2206 2000Kv with 5030 Carbon.
tyto-nmk | tyto-qav-rt2206-2000kv-quad-racing-motor-cw | QAV RT2206-2000KV Quad Racing Motor CW | emax-blheli-80a-ubec-5a-5v | propeller gemfan-6030-thick-hub |  | 14.6908 | 14.7038 | 21516 | 1464.59 | 13.7562 | 202.09 | 136.585 | 0.0606196 | 5.47796 | 0.716015 | 11 | https://database.tytorobotics.com/tests/nmk/qav-2206-2000kv-with-gemfan-6030-thick-hub | third_party | S132 | 2026-10-20 | Test title: QAV 2206 2000Kv With Gemfan 6030 Thick hub.
tyto-gk9 | tyto-qav-rt2206-2000kv-quad-racing-motor-cw | QAV RT2206-2000KV Quad Racing Motor CW | emax-blheli-80a-ubec-5a-5v | propeller dalprop-6040 |  | 14.6874 | 14.7047 | 19865 | 1352.5 | 17.4067 | 255.663 | 168.998 | 0.0812388 | 6.0658 | 0.661018 | 11 | https://database.tytorobotics.com/tests/gk9/qav-2206-2000kv-with-dalprop-6040 | third_party | S132 | 2026-10-20 | Test title: QAV 2206 2000Kv with Dalprop 6040.
tyto-r7z | tyto-qav-rt2206-2000kv-quad-racing-motor-cw | QAV RT2206-2000KV Quad Racing Motor CW | emax-blheli-80a-ubec-5a-5v | propeller dalprop-6040 |  | 14.6858 | 14.7027 | 19969 | 1359.75 | 17.363 | 254.99 | 164.011 | 0.0784309 | 6.30187 | 0.64961 | 11 | https://database.tytorobotics.com/tests/r7z/qav-2206-2000kv-with-dalprop-6040-v2 | third_party | S132 | 2026-10-20 | Test title: QAV 2206 2000Kv with Dalprop 6040 v2.
tyto-yrr | tyto-qav-rt2206-2000kv-quad-racing-motor-cw | QAV RT2206-2000KV Quad Racing Motor CW | emax-blheli-80a-ubec-5a-5v | propeller 6045-plastic |  | 14.6866 | 14.7019 | 14230 | 968.91 | 15.5066 | 227.739 | 109.016 | 0.0731571 | 5.05113 | 0.522665 | 11 | https://database.tytorobotics.com/tests/yrr/qav-2206-2000kv-with-6045-plastic | third_party | S132 | 2026-10-20 | Test title: QAV 2206 2000Kv With 6045 Plastic.
tyto-zjq | tyto-racerstar-br2306s-2400kv | Racerstar BR2306S 2400kv | emax-blheli-30a-bec-2a-5v | propeller 6030-carbon-nylon |  | 11.1678 | 11.3064 | 17306 | 1549.63 | 7.95941 | 88.8891 | 62.2853 | 0.0343685 | 4.0243 | 0.700709 | 21 | https://database.tytorobotics.com/tests/zjq/racerstar-2306-2400kv-vith-gemfan-6030r | third_party | S132 | 2026-10-20 | Test title: Racerstar 2306 2400kv vith Gemfan 6030R.
tyto-wwj | tyto-racerstar-br2306s-2400kv | Racerstar BR2306S 2400kv | emax-blheli-80a-ubec-5a-5v | propeller carbon-fiber-5030 |  | 14.7251 | 14.741 | 28298 | 1921.47 | 15.8754 | 233.801 | 130.501 | 0.0444228 | 5.03799 | 0.587753 | 11 | https://database.tytorobotics.com/tests/wwj/racerstar-br2306s-2400kv-carbon-5030 | third_party | S132 | 2026-10-20 | Test title: Racerstar BR2306S 2400kv Carbon 5030.
tyto-7qe | tyto-racerstar-br2306s-2400kv | Racerstar BR2306S 2400kv | emax-blheli-80a-ubec-5a-5v | propeller gemfan-6030-thick-hub |  | 14.712 | 14.7396 | 26396 | 1794.18 | 27.6548 | 406.858 | 276.225 | 0.0999301 | 9.23239 | 0.678923 | 11 | https://database.tytorobotics.com/tests/7qe/racerstar-br2306s-2400kv-gemfan-6030-thick-hub | third_party | S132 | 2026-10-20 | Test title: Racerstar BR2306S 2400kv Gemfan 6030 Thick Hub.
tyto-zxq | tyto-racerstar-br2306s-2400kv | Racerstar BR2306S 2400kv | emax-blheli-80a-ubec-5a-5v | propeller dalprop-6040 |  | 14.7065 | 14.7389 | 24613 | 1673.62 | 33.1569 | 487.621 | 295.554 | 0.114669 | 9.7824 | 0.606115 | 11 | https://database.tytorobotics.com/tests/zxq/racerstar-br2306s-2400kv-with-dalprop-6040 | third_party | S132 | 2026-10-20 | Test title: Racerstar BR2306S 2400kv with Dalprop 6040.
tyto-9gm | tyto-racerstar-br2306s-2400kv | Racerstar BR2306S 2400kv | emax-blheli-80a-ubec-5a-5v | propeller 6045-plastic |  | 14.6994 | 14.7386 | 19176 | 1304.54 | 38.0827 | 559.793 | 267.404 | 0.133163 | 9.46415 | 0.477684 | 11 | https://database.tytorobotics.com/tests/9gm/racerstar-br2306s-2400kv-with-plastic-6045 | third_party | S132 | 2026-10-20 | Test title: Racerstar BR2306S 2400kv with plastic 6045.
tyto-zgq9 | tyto-racerstar-br2306s-2400kv | Racerstar BR2306S 2400kv | afro-race-spec-mini-esc-with-bec-20a | propeller gemfan-5040-r |  | 7.93931 | 8.41714 | 13222.2 | 1622.67 | 2.79091 | 22.7415 | 13.376 | 0.00966041 | 1.14037 | 0.6268 | 8 | https://database.tytorobotics.com/tests/zgq9/upload-template-dual-motor-1 | third_party | S132 | 2026-10-20 | Test title: Upload template dual motor 1. Title names a different motor than the link: check.
tyto-zdq | tyto-dys-samguk-shu-2306-2500kv | DYS Samguk Shu 2306 2500kv | flycolor-xcross-blheli32-50a-esc | propeller hq-prop-5031-ethix |  | 14.4569 | 16.7937 | 26106 | 1805.79 | 29.6682 | 428.909 | 295.721 | 0.108172 | 9.98814 | 0.892185 | 21 | https://database.tytorobotics.com/tests/zdq/dys-samguk-shu-hq-5031-ethix | third_party | S132 | 2026-10-20 | Test title: DYS Samguk Shu HQ 5031 Ethix.
tyto-99m | tyto-dys-samguk-shu-2306-2500kv | DYS Samguk Shu 2306 2500kv | flycolor-xcross-blheli32-50a-esc | propeller hq-prop-5151 |  | 13.8367 | 16.7849 | 19479 | 1407.78 | 38.6296 | 534.505 | 275.904 | 0.135258 | 10.0104 | 0.6326 | 21 | https://database.tytorobotics.com/tests/99m/dys-samguk-shu-hq-5151 | third_party | S132 | 2026-10-20 | Test title: DYS Samguk Shu HQ 5151.
tyto-rgd | tyto-dys-samguk-shu-2306-2500kv | DYS Samguk Shu 2306 2500kv | flycolor-xcross-blheli32-50a-esc | propeller hq-prop-5146 |  | 13.9938 | 16.7951 | 21957 | 1569.05 | 35.3911 | 495.258 | 282.481 | 0.122853 | 10.5134 | 0.65374 | 20 | https://database.tytorobotics.com/tests/rgd/dys-samguk-shu-hq-5146 | third_party | S132 | 2026-10-20 | Test title: DYS Samguk Shu HQ 5146.
tyto-yq4 | tyto-dys-samguk-shu-2306-2500kv | DYS Samguk Shu 2306 2500kv | flycolor-xcross-blheli32-50a-esc | propeller hq-prop-5141 |  | 13.8102 | 16.7822 | 22174 | 1605.63 | 34.1224 | 471.236 | 286.145 | 0.123229 | 10.3954 | 0.84212 | 21 | https://database.tytorobotics.com/tests/yq4/dys-samguk-shu-hq-5141 | third_party | S132 | 2026-10-20 | Test title: DYS Samguk Shu HQ 5141.
tyto-ker | tyto-dys-samguk-shu-2306-2500kv | DYS Samguk Shu 2306 2500kv | flycolor-xcross-blheli32-50a-esc | propeller hq-prop-5131 |  | 14.0833 | 16.8081 | 24433 | 1734.89 | 31.017 | 436.823 | 270.221 | 0.105612 | 10.3722 | 0.618606 | 21 | https://database.tytorobotics.com/tests/ker/dys-samguk-shu-hq-5131 | third_party | S132 | 2026-10-20 | Test title: DYS Samguk Shu HQ 5131.
tyto-3jq | tyto-dys-samguk-shu-2306-2500kv | DYS Samguk Shu 2306 2500kv | flycolor-xcross-blheli32-50a-esc | propeller hq-prop-5050 |  | 14.1659 | 16.7779 | 23468 | 1656.66 | 33.2989 | 471.708 | 282.91 | 0.115118 | 10.5614 | 0.64227 | 21 | https://database.tytorobotics.com/tests/3jq/dys-samguk-shu-hq-5050 | third_party | S132 | 2026-10-20 | Test title: DYS Samguk Shu HQ 5050.
tyto-xk9 | tyto-dys-samguk-shu-2306-2500kv | DYS Samguk Shu 2306 2500kv | flycolor-xcross-blheli32-50a-esc | propeller hq-prop-5048 |  | 14.4262 | 16.7901 | 24784 | 1717.98 | 32.4749 | 468.489 | 312.959 | 0.120583 | 10.795 |  | 21 | https://database.tytorobotics.com/tests/xk9/dys-samguk-shu-hq-5048 | third_party | S132 | 2026-10-20 | Test title: DYS Samguk Shu HQ 5048.
tyto-6zd | tyto-dys-samguk-shu-2306-2500kv | DYS Samguk Shu 2306 2500kv | flycolor-xcross-blheli32-50a-esc | propeller hq-prop-5045 |  | 14.3472 | 16.7896 | 24994 | 1742.08 | 31.2651 | 448.566 | 289.748 | 0.110702 | 10.597 | 0.80892 | 21 | https://database.tytorobotics.com/tests/6zd/dys-samguk-shu-hq-5045 | third_party | S132 | 2026-10-20 | Test title: DYS Samguk Shu HQ 5045.
tyto-kxz | tyto-emax-rsii-2207-2300kv | EMAX RSII 2207 2300Kv | emax-blheli-80a-ubec-5a-5v | propeller 6030-carbon-nylon |  | 14.731 | 14.7414 | 18941 | 1285.79 | 9.27043 | 136.562 | 84.5887 | 0.0426462 | 4.10444 | 0.619414 | 11 | https://database.tytorobotics.com/tests/kxz/emax-rsii-2207-2300kv-with-6030-nylon | third_party | S132 | 2026-10-20 | Test title: EMAX RSII 2207 2300Kv with 6030 Nylon.
tyto-xge | tyto-emax-rsii-2207-2300kv | EMAX RSII 2207 2300Kv | emax-blheli-80a-ubec-5a-5v | propeller gemfan-6030-thick-hub |  | 14.7159 | 14.7436 | 27305 | 1855.48 | 29.4929 | 434.013 | 292.126 | 0.102164 | 9.91049 | 0.673082 | 11 | https://database.tytorobotics.com/tests/xge/emax-rsii-2207-2300kv-with-gemfan-6030-thick-hub | third_party | S132 | 2026-10-20 | Test title: EMAX RSII 2207 2300Kv with Gemfan 6030 Thick Hub.
tyto-67w | tyto-emax-rsii-2207-2300kv | EMAX RSII 2207 2300Kv | emax-blheli-80a-ubec-5a-5v | propeller carbon-fiber-5030 |  | 14.7271 | 14.7421 | 28400 | 1928.16 | 15.9468 | 234.85 | 170.236 | 0.0574326 | 4.98841 | 0.724869 | 11 | https://database.tytorobotics.com/tests/67w/emax-rsii-2207-2300kv-with-carbon-5030 | third_party | S132 | 2026-10-20 | Test title: EMAX RSII 2207 2300Kv with Carbon 5030.
tyto-wzj | tyto-emax-rsii-2207-2300kv | EMAX RSII 2207 2300Kv | emax-blheli-80a-ubec-5a-5v | propeller 6045-plastic |  | 14.7063 | 14.7417 | 19465 | 1323.58 | 35.5543 | 522.873 | 305.685 | 0.149966 | 9.66086 | 0.584627 | 11 | https://database.tytorobotics.com/tests/wzj/emax-rsii-2207-2300kv-with-plastic-6045 | third_party | S132 | 2026-10-20 | Test title: EMAX RSII 2207 2300Kv with plastic 6045.
tyto-qr9 | tyto-emax-rsii-2207-2300kv | EMAX RSII 2207 2300Kv | emax-blheli-80a-ubec-5a-5v | propeller dalprop-6040 |  | 14.7086 | 14.7445 | 25561 | 1737.83 | 35.5408 | 522.755 | 342.261 | 0.127865 | 10.8793 | 0.654726 | 11 | https://database.tytorobotics.com/tests/qr9/emax-rsii-2207-2300kv-with-dalprop-6040 | third_party | S132 | 2026-10-20 | Test title: EMAX RSII 2207 2300Kv with Dalprop 6040.
tyto-d9g | tyto-emax-rsii-2207-2300kv | EMAX RSII 2207 2300Kv | emax-blheli-80a-ubec-5a-5v | propeller gemfan-hurricane-51499 |  | 14.7037 | 14.7415 | 24720 | 1681.21 | 38.8217 | 570.824 | 345.255 | 0.133371 | 9.39529 | 0.604836 | 11 | https://database.tytorobotics.com/tests/d9g/emax-rsii-2207-2300kv-with-hurricane-51499 | third_party | S132 | 2026-10-20 | Test title: EMAX RSII 2207 2300Kv with Hurricane 51499.
tyto-jqw | tyto-emax-rsii-2207-2300kv | EMAX RSII 2207 2300Kv | emax-blheli-80a-ubec-5a-5v | propeller gemfan-5050-3-blades-bn |  | 14.7031 | 14.7418 | 24283 | 1651.55 | 39.3385 | 578.399 | 366.278 | 0.144039 | 8.99029 | 0.633263 | 11 | https://database.tytorobotics.com/tests/jqw/emax-rsii-2207-2300kv-with-gemfan-5050-bn | third_party | S132 | 2026-10-20 | Test title: EMAX RSII 2207 2300Kv with Gemfan 5050 BN.
tyto-erd | tyto-emax-rsii-2207-2300kv | EMAX RSII 2207 2300Kv | emax-blheli-80a-ubec-5a-5v | propeller kingkong-6040 |  | 14.706 | 14.7433 | 24877 | 1691.63 | 37.8468 | 556.573 | 367.303 | 0.140993 | 11.0233 | 0.659937 | 11 | https://database.tytorobotics.com/tests/erd/emax-rsii-2207-2300kv-with-kingkong-6040 | third_party | S132 | 2026-10-20 | Test title: EMAX RSII 2207 2300Kv with Kingkong 6040.
tyto-3nj | tyto-lumenier-zip-2207-1750kv-popo | Lumenier ZIP 2207 1750kv POPO | emax-blheli-80a-ubec-5a-5v | propeller gemfan-hurricane-51499 |  | 14.7212 | 14.7407 | 20374 | 1383.99 | 19.2313 | 283.108 | 174.01 | 0.0815585 | 6.11255 | 0.614642 | 11 | https://database.tytorobotics.com/tests/3nj/lumenier-zip-2207-1750kv-popo-gemfan-hurricane | third_party | S132 | 2026-10-20 | Test title: Lumenier ZIP 2207 1750kv POPO Gemfan Hurricane.
tyto-pdg | tyto-emax-2306-2750kv | EMAX 2306-2750KV | turnigy-plush-30amp-speed-controller | propeller gemfan-5050-3-blades-bn |  | 11.6797 | 11.6985 | 16807 | 1439 | 19.205 | 224.308 | 137.787 | 0.0782868 | 6.14225 | 0.615894 | 11 | https://database.tytorobotics.com/tests/pdg/test-for-motor-emax-rs2306-with-turnigy-plush-30-a | third_party | S132 | 2026-10-20 | Test title: Test for Motor EMAX RS2306 with Turnigy Plush 30 A.
tyto-5jw | tyto-emax-2306-2750kv | EMAX 2306-2750KV | hobbyking-30a-esc-3a-ubec | propeller gemfan-5050-3-blades-bn |  | 11.6296 | 11.6453 | 14946 | 1285.17 | 15.2103 | 176.89 | 98.0638 | 0.0626549 | 4.83092 | 0.554378 | 11 | https://database.tytorobotics.com/tests/5jw/emax-2306-with-hobbyking-30a-ubec | third_party | S132 | 2026-10-20 | Test title: EMAX 2306 with HobbyKing 30A UBEC.
tyto-94m | tyto-emax-2306-2750kv | EMAX 2306-2750KV | emax-blheli-30a-bec-2a-5v | propeller 6030-carbon-nylon |  | 11.1017 | 11.3061 | 18926 | 1704.79 | 11.6759 | 129.622 | 87.7164 | 0.0442582 | 4.96393 | 0.676712 | 21 | https://database.tytorobotics.com/tests/94m/emax-2306-2750kv-with-gemfan-6030r | third_party | S132 | 2026-10-20 | Test title: EMAX 2306 2750KV with Gemfan 6030R.
tyto-9nr | tyto-hypetrain-blaster-2207-2450kv | Hypetrain Blaster 2207 2450Kv | emax-blheli-30a-bec-2a-5v | propeller gemfan-5040-r |  | 11.0912 | 11.2992 | 20733 | 1869.31 | 11.7017 | 129.786 | 97.0371 | 0.0446938 | 4.72197 | 0.747669 | 21 | https://database.tytorobotics.com/tests/9nr/hypetrain-blaster-2207-2450kv-gemfan-5040 | third_party | S132 | 2026-10-20 | Test title: Hypetrain Blaster 2207 2450Kv Gemfan 5040.
tyto-q9m | tyto-hypetrain-blaster-2207-2450kv | Hypetrain Blaster 2207 2450Kv | emax-blheli-30a-bec-2a-5v | propeller 6045-plastic |  | 10.9012 | 11.3069 | 12984 | 1191.06 | 15.3214 | 167.022 | 101.077 | 0.0743387 | 5.75608 | 0.60517 | 21 | https://database.tytorobotics.com/tests/q9m/hypetrain-blaster-2207-2450kv-plastic-6045 | third_party | S132 | 2026-10-20 | Test title: Hypetrain Blaster 2207 2450Kv Plastic 6045.
tyto-4g6 | tyto-hypetrain-blaster-2207-2450kv | Hypetrain Blaster 2207 2450Kv | emax-blheli-80a-ubec-5a-5v | propeller gemfan-6030-thick-hub |  | 14.7056 | 14.7413 | 27940 | 1899.7 | 33.864 | 497.991 | 309.844 | 0.10626 | 10.5694 | 0.632026 | 11 | https://database.tytorobotics.com/tests/4g6/hypertrain-blaster-2207-2450kv-gemfan-6030 | third_party | S132 | 2026-10-20 | Test title: Hypertrain Blaster 2207 2450Kv Gemfan 6030. Title names a different motor than the link: check.
tyto-n7k | tyto-hypetrain-blaster-2207-2450kv | Hypetrain Blaster 2207 2450Kv | emax-blheli-80a-ubec-5a-5v | propeller carbon-fiber-5030 |  | 14.7246 | 14.7408 | 28444 | 1930.62 | 16.658 | 245.423 | 144.456 | 0.0485894 | 5.09444 | 0.600222 | 11 | https://database.tytorobotics.com/tests/n7k/hypertrain-blaster-2207-2450kv-carbon-5030 | third_party | S132 | 2026-10-20 | Test title: Hypertrain Blaster 2207 2450Kv Carbon 5030. Title names a different motor than the link: check.
tyto-g69 | tyto-hypetrain-blaster-2207-2450kv | Hypetrain Blaster 2207 2450Kv | emax-blheli-80a-ubec-5a-5v | propeller dalprop-6040 |  | 14.6886 | 14.7373 | 27290 | 1857.91 | 42.9974 | 631.57 | 406.111 | 0.142106 | 12.1919 | 0.643018 | 11 | https://database.tytorobotics.com/tests/g69/hypertrain-blaster-2207-2450kv-dalprop-6040 | third_party | S132 | 2026-10-20 | Test title: Hypertrain Blaster 2207 2450Kv Dalprop 6040. Title names a different motor than the link: check.
tyto-zx6 | tyto-hypetrain-blaster-2207-2450kv | Hypetrain Blaster 2207 2450Kv | emax-blheli-80a-ubec-5a-5v | propeller 6045-plastic |  | 14.6946 | 14.7383 | 20539 | 1397.73 | 41.4589 | 609.22 | 333.466 | 0.15504 | 10.7795 | 0.547365 | 11 | https://database.tytorobotics.com/tests/zx6/hypertrain-blaster-2207-2450kv-with-plastic-6045 | third_party | S132 | 2026-10-20 | Test title: Hypertrain Blaster 2207 2450Kv with Plastic 6045. Title names a different motor than the link: check.
tyto-9gx | tyto-hypetrain-blaster-2207-2450kv | Hypetrain Blaster 2207 2450Kv | emax-blheli-80a-ubec-5a-5v | propeller gemfan-hurricane-51499 |  | 14.7052 | 14.7398 | 24033 | 1634.32 | 36.1221 | 531.181 | 338.045 | 0.134319 | 8.94909 | 0.636403 | 11 | https://database.tytorobotics.com/tests/9gx/hypertrain-blaster-2207-2450kv-gemfan-hurricane | third_party | S132 | 2026-10-20 | Test title: Hypertrain Blaster 2207 2450Kv Gemfan Hurricane. Title names a different motor than the link: check.
tyto-rmz | tyto-hypetrain-blaster-2207-2450kv | Hypetrain Blaster 2207 2450Kv | emax-blheli-80a-ubec-5a-5v | propeller kingkong-6040 |  | 14.6887 | 14.7382 | 26657 | 1814.8 | 47.4905 | 697.573 | 427.814 | 0.153255 | 12.8778 | 0.613289 | 11 | https://database.tytorobotics.com/tests/rmz/hypertrain-blaster-2207-2450kv-kingkong-6040 | third_party | S132 | 2026-10-20 | Test title: Hypertrain Blaster 2207 2450Kv Kingkong 6040. Title names a different motor than the link: check.
tyto-z66 | tyto-turnigy-d2836-aerodrive-1100kv | Turnigy D2836 Aerodrive 1100kv | emax-blheli-80a-ubec-5a-5v | propeller hy-1047-plastic-blade-for-slowflyer |  | 11.5667 | 11.588 | 9348 | 808.183 | 23.1841 | 268.164 | 178.835 | 0.182686 | 11.0906 | 0.683812 | 11 | https://database.tytorobotics.com/tests/z66/turnigy-aerodrive-d2836-1100kv-with-hy-1047 | third_party | S132 | 2026-10-20 | Test title: Turnigy Aerodrive D2836 1100Kv with HY-1047.
tyto-nxjg | tyto-mfo-propdrive-3530-1400kv | MFO PropDrive 3530 1400Kv | emax-blheli-80a-ubec-5a-5v | propeller xoar-pjp-t-l-40x10 |  | 7.87825 | 8.38506 | 15763.3 | 2000.86 | 5.58007 | 43.9611 | 25.2448 | 0.0152931 | 1.74188 | 0.64976 | 11 | https://database.tytorobotics.com/tests/nxjg/upload-template-single-motor | third_party | S132 | 2026-10-20 | Test title: Upload template single motor. Title names a different motor than the link: check.
tyto-y3qn | tyto-t-motor-f40-pro-ii-motor-popo-2400kv | T-Motor F40 PRO II Motor POPO - 2400kv | cyclone-35a | propeller master-airscrew-mr-10x45 |  | 7.70731 | 8.083 | 13802 | 1790.77 | 14.0533 | 108.313 |  |  | 4.07055 |  | 17 | https://database.tytorobotics.com/tests/y3qn/tmotor-f22035-2850kv-with-prop | third_party | S132 | 2026-10-20 | Test title: TMotor F22035-2850KV with PROP.
tyto-64w | tyto-t-motor-f40-pro-ii-motor-popo-2400kv | T-Motor F40 PRO II Motor POPO - 2400kv | emax-blheli-80a-ubec-5a-5v | propeller gemfan-hurricane-51499 |  | 14.6946 | 14.7407 | 25334 | 1724.03 | 43.477 | 638.878 | 356.476 | 0.134369 | 9.91238 | 0.557973 | 11 | https://database.tytorobotics.com/tests/64w/t-motor-f40-pro-ii-2400kv-popo-gemfan-hurricane | third_party | S132 | 2026-10-20 | Test title: T-Motor F40 PRO II 2400kv POPO Gemfan Hurricane.
tyto-5ed | tyto-turnigy-2836-brushless-outrunner-1000kv | Turnigy 2836 Brushless Outrunner 1000kv | hobbyking-30a-esc-3a-ubec | propeller carbon-fiber-8x6 |  | 11.6484 | 11.6728 | 13696 | 1175.79 | 22.7445 | 264.937 | 239.479 | 0.166973 | 10.9709 | 0.90391 | 11 | https://database.tytorobotics.com/tests/5ed/turnigy-2836-1000kv-with-hobbyking-30a-esc-3a-ubec | third_party | S132 | 2026-10-20 | Test title: Turnigy 2836 1000kv with HobbyKing 30A ESC 3A UBEC.
tyto-pmn | tyto-turnigy-2836-brushless-outrunner-1000kv | Turnigy 2836 Brushless Outrunner 1000kv | emax-blheli-80a-ubec-5a-5v | propeller carbon-fiber-8x6 |  | 11.6496 | 11.6725 | 13612 | 1168.4 | 21.1584 | 246.498 | 230.232 | 0.161516 | 10.7901 | 0.934078 | 11 | https://database.tytorobotics.com/tests/pmn/turnigy-2836-brushless-1000kv-with-blheli-80a | third_party | S132 | 2026-10-20 | Test title: Turnigy 2836 Brushless 1000kv with BLHeli 80A.
tyto-p46 | tyto-turnigy-2836-brushless-outrunner-1000kv | Turnigy 2836 Brushless Outrunner 1000kv | emax-blheli-80a-ubec-5a-5v | propeller hy-1147-plastic-blade-for-slowflyer |  | 11.6265 | 11.6702 | 9607 | 826.197 | 41.8822 | 486.945 | 323.267 | 0.321325 | 17.5254 | 0.729241 | 11 | https://database.tytorobotics.com/tests/p46/turnigy-2836-1000kv-emax-blheli-80a-hy-1147 | third_party | S132 | 2026-10-20 | Test title: Turnigy 2836 1000kv EMAX BLHeli 80A HY-1147.
tyto-5nk | tyto-turnigy-2836-brushless-outrunner-1000kv | Turnigy 2836 Brushless Outrunner 1000kv | emax-blheli-80a-ubec-5a-5v | propeller hy-1047-plastic-blade-for-slowflyer |  | 11.634 | 11.6708 | 10992 | 944.818 | 36.2491 | 421.721 | 327.245 | 0.284294 | 16.1145 | 0.798165 | 11 | https://database.tytorobotics.com/tests/5nk/turnigy-2836-1000kv-emax-blheli-80a-hy-1047 | third_party | S132 | 2026-10-20 | Test title: Turnigy 2836 1000kv EMAX BLHeli 80A HY-1047.
tyto-ed67 | tyto-turnigy-2836-brushless-outrunner-1000kv | Turnigy 2836 Brushless Outrunner 1000kv | flycolor-xcross-blheli32-50a-esc | propeller diatone-5030-r |  | 7.87825 | 8.38506 | 15763.3 | 2000.86 | 5.58007 | 43.9611 | 25.2448 | 0.0152931 | 1.74188 | 0.64976 | 11 | https://database.tytorobotics.com/tests/ed67/upload-template-single-motor | third_party | S132 | 2026-10-20 | Test title: Upload template single motor. Title names a different motor than the link: check.
tyto-enn | tyto-multistar-elite-2306-2150kv-ccw | MultiStar Elite 2306 2150KV CCW | t-motor-f35a | propeller carbon-fiber-5030 |  | 10.6401 | 10.7184 | 13490 | 1267.84 | 2.49777 | 26.5766 |  |  | 1.58365 |  | 15 | https://database.tytorobotics.com/tests/enn/elite-2306-2150kv-5030-tri-blade-prop-series-1520 | third_party | S132 | 2026-10-20 | Test title: Elite 2306 2150Kv 5030 tri-blade prop series 1520. Title names a different motor than the link: check.
tyto-qzy | tyto-multistar-elite-2306-2150kv-ccw | MultiStar Elite 2306 2150KV CCW | emax-blheli-80a-ubec-5a-5v | propeller 6030-carbon-nylon |  | 14.6598 | 14.8066 | 19174 | 1307.93 | 8.2746 | 121.304 | 82.9045 | 0.0412892 | 5.09264 | 0.683445 | 21 | https://database.tytorobotics.com/tests/qzy/multistar-elite-2306-2150kv-gemfan-6030r | third_party | S132 | 2026-10-20 | Test title: MultiStar Elite 2306 2150KV Gemfan 6030R.
tyto-p9x | tyto-multistar-elite-2306-2150kv-ccw | MultiStar Elite 2306 2150KV CCW | afro-race-spec-mini-esc-with-bec-20a | propeller self-tightening-propeller-6032-red-cw |  | 10.8271 | 11.8454 | 15457 | 1422.34 | 16.8372 | 182.975 | 103.926 | 0.0642631 | 4.68035 | 0.5721 | 21 | https://database.tytorobotics.com/tests/p9x/testing-motor-of-the-quacdopter-4 | third_party | S132 | 2026-10-20 | Test title: Testing Motor of the Quacdopter 4. Title names a different motor than the link: check.
tyto-prz | tyto-multistar-elite-2306-2150kv-ccw | MultiStar Elite 2306 2150KV CCW | afro-race-spec-mini-esc-with-bec-20a | propeller gemfan-6030-r |  | 11.0408 | 11.5675 | 19256 | 1739.9 | 9.49311 | 105.06 | 77.2472 | 0.0383079 | 3.66327 | 0.767691 | 21 | https://database.tytorobotics.com/tests/prz/testing-motor-and-propeller-of-the-quadcopter | third_party | S132 | 2026-10-20 | Test title: Testing Motor and Propeller of the Quadcopter. Title names a different motor than the link: check.
tyto-pyr | tyto-multistar-elite-2306-2150kv-ccw | MultiStar Elite 2306 2150KV CCW | afro-race-spec-mini-esc-with-bec-20a | propeller gemfan-5040-r |  | 10.9557 | 11.4753 | 19128 | 1742.21 | 9.43455 | 103.584 | 68.3162 | 0.0341056 | 3.04505 | 0.659886 | 21 | https://database.tytorobotics.com/tests/pyr/testing-motor-of-the-quadcopter-1 | third_party | S132 | 2026-10-20 | Test title: Testing Motor of the Quadcopter 1. Title names a different motor than the link: check.
tyto-5kz | tyto-multistar-elite-2306-2150kv-ccw | MultiStar Elite 2306 2150KV CCW | afro-race-spec-mini-esc-with-bec-20a | propeller hq-prop-6045-r |  | 10.6007 | 11.4045 | 15634 | 1472.27 | 15.8855 | 168.687 | 97.1061 | 0.0593127 | 4.80536 | 0.577958 | 21 | https://database.tytorobotics.com/tests/5kz/testing-motor-of-the-quadcopter-2 | third_party | S132 | 2026-10-20 | Test title: Testing Motor of the Quadcopter 2. Title names a different motor than the link: check.
tyto-p3j | tyto-multistar-elite-2306-2150kv-ccw | MultiStar Elite 2306 2150KV CCW | afro-race-spec-mini-esc-with-bec-20a | propeller diatone-5030-r |  | 10.9185 | 11.3188 | 19704 | 1801.27 | 7.63851 | 83.5574 | 61.3919 | 0.0297952 | 2.73992 | 0.738154 | 21 | https://database.tytorobotics.com/tests/p3j/testing-motor-of-the-quadcopter-3 | third_party | S132 | 2026-10-20 | Test title: Testing Motor of the Quadcopter 3. Title names a different motor than the link: check.
tyto-qm9 | tyto-multistar-elite-2306-2150kv-ccw | MultiStar Elite 2306 2150KV CCW | emax-blheli-80a-ubec-5a-5v | propeller 6030-carbon-nylon |  | 14.6982 | 14.7066 | 18688 | 1271.37 | 6.95626 | 102.251 | 60.8082 | 0.0310721 | 3.28399 | 0.594697 | 11 | https://database.tytorobotics.com/tests/qm9/multistar-elite-2306-2150kv-with-6030-nylon | third_party | S132 | 2026-10-20 | Test title: Multistar Elite 2306 2150Kv with 6030 Nylon.
tyto-74e | tyto-rcx-rs1407-4100kv | RCX RS1407 - 4100kv | flycolor-xcross-blheli32-50a-esc | propeller gemfan-3052-flash |  | 15.113 | 16.8123 | 36076 | 2386.98 | 23.4701 | 354.718 | 181.668 | 0.0480873 | 4.86827 | 0.578555 | 21 | https://database.tytorobotics.com/tests/74e/rcx-rs1407-4200kv-gemfan-3052-flash | third_party | S132 | 2026-10-20 | Test title: RCX RS1407 4200kv Gemfan 3052 - Flash.
tyto-zwq | tyto-rcx-rs1407-4100kv | RCX RS1407 - 4100kv | flycolor-xcross-blheli32-50a-esc | propeller gemfan-3052-flash |  | 11.3086 | 12.601 | 31373 | 2772.91 | 17.1502 | 194.04 | 116.153 | 0.0353547 | 3.58178 | 0.716809 | 21 | https://database.tytorobotics.com/tests/zwq/rcx-rs1407-4200kv-gemfan-3052-flash-3s-pack | third_party | S132 | 2026-10-20 | Test title: RCX RS1407 4200kv Gemfan 3052 - Flash - 3s Pack.
tyto-dx4 | tyto-rcx-rs1407-4100kv | RCX RS1407 - 4100kv | flycolor-xcross-blheli32-50a-esc | propeller gemfan-3028-windancer |  | 15.1667 | 16.4885 | 46971 | 3090.01 | 16.7193 | 254.149 | 181.503 | 0.0368999 | 5.13026 | 0.72087 | 19 | https://database.tytorobotics.com/tests/dx4/rcx-rs1407-4200kv-gemfan-3028-windancer | third_party | S132 | 2026-10-20 | Test title: RCX RS1407 4200kv Gemfan 3028 - WinDancer.
tyto-jyq | tyto-rcx-rs1407-4100kv | RCX RS1407 - 4100kv | flycolor-xcross-blheli32-50a-esc | propeller gemfan-3028-windancer |  | 11.7263 | 12.6509 | 39041 | 3321.02 | 11.8962 | 139.849 | 90.5361 | 0.0221448 | 3.54184 | 0.660254 | 18 | https://database.tytorobotics.com/tests/jyq/rcx-rs1407-4200kv-gemfan-3028-windancer-3s | third_party | S132 | 2026-10-20 | Test title: RCX RS1407 4200kv Gemfan 3028 - WinDancer - 3S.
tyto-e6m | tyto-rcx-rs1407-4100kv | RCX RS1407 - 4100kv | flycolor-xcross-blheli32-50a-esc | propeller hq-prop-3040 |  | 11.3352 | 12.5917 | 30941 | 2729.64 | 17.6944 | 200.569 | 125.152 | 0.0386256 | 3.50415 | 0.62699 | 17 | https://database.tytorobotics.com/tests/e6m/rcx-rs1407-4200kv-hq-3040-3s | third_party | S132 | 2026-10-20 | Test title: RCX RS1407 4200kv HQ 3040 - 3S.
tyto-dk4 | tyto-dys-samguk-wei-2207-2600kv | DYS Samguk Wei 2207 2600kv | flycolor-xcross-blheli32-50a-esc | propeller hq-prop-5151 |  | 13.1236 | 16.1301 | 19417 | 1479.55 | 33.209 | 435.822 | 286.26 | 0.140783 | 10.0452 |  | 21 | https://database.tytorobotics.com/tests/dk4/dys-samguk-wei-hq-5151 | third_party | S132 | 2026-10-20 | Test title: DYS Samguk Wei HQ 5151.
tyto-9ym | tyto-dys-samguk-wei-2207-2600kv | DYS Samguk Wei 2207 2600kv | flycolor-xcross-blheli32-50a-esc | propeller azure-power-5150 |  | 14.3426 | 16.7782 | 22803 | 1587.17 | 31.2251 | 448.612 | 304.493 | 0.127514 | 10.745 | 0.738988 | 21 | https://database.tytorobotics.com/tests/9ym/dys-samguk-wei-azure-power-5150 | third_party | S132 | 2026-10-20 | Test title: DYS Samguk Wei Azure Power 5150.
tyto-e3m | tyto-dys-samguk-wei-2207-2600kv | DYS Samguk Wei 2207 2600kv | flycolor-xcross-blheli32-50a-esc | propeller hq-prop-5141 |  | 14.2652 | 16.7551 | 22590 | 1576.34 | 31.623 | 453.179 | 286.19 | 0.120979 | 10.8781 | 0.631967 | 21 | https://database.tytorobotics.com/tests/e3m/dys-samguk-wei-hq-5141 | third_party | S132 | 2026-10-20 | Test title: DYS Samguk Wei HQ 5141.
tyto-mjw | tyto-dys-samguk-wei-2207-2600kv | DYS Samguk Wei 2207 2600kv | flycolor-xcross-blheli32-50a-esc | propeller hq-prop-5131 |  | 14.4311 | 16.7511 | 24429 | 1687.17 | 27.9242 | 404.321 | 292.371 | 0.114288 | 10.4782 | 0.856858 | 21 | https://database.tytorobotics.com/tests/mjw/dys-samguk-wei-hq-5131 | third_party | S132 | 2026-10-20 | Test title: DYS Samguk Wei HQ 5131.
tyto-4nn | tyto-dys-samguk-wei-2207-2600kv | DYS Samguk Wei 2207 2600kv | flycolor-xcross-blheli32-50a-esc | propeller hq-prop-5050 |  | 14.5318 | 16.7502 | 23741 | 1629 | 30.3057 | 441.675 | 313.05 | 0.125917 | 10.8733 | 0.885407 | 21 | https://database.tytorobotics.com/tests/4nn/dys-samguk-wei-hq-5050 | third_party | S132 | 2026-10-20 | Test title: DYS Samguk Wei HQ 5050.
tyto-nj4 | tyto-dys-samguk-wei-2207-2600kv | DYS Samguk Wei 2207 2600kv | flycolor-xcross-blheli32-50a-esc | propeller hq-prop-5048 |  | 14.5288 | 16.7682 | 24499 | 1682.12 | 28.3863 | 413.429 | 304.964 | 0.11887 | 10.6766 |  | 21 | https://database.tytorobotics.com/tests/nj4/dys-samguk-wei-hq-5048 | third_party | S132 | 2026-10-20 | Test title: DYS Samguk Wei HQ 5048.
tyto-rjd | tyto-dys-samguk-wei-2207-2600kv | DYS Samguk Wei 2207 2600kv | flycolor-xcross-blheli32-50a-esc | propeller gemfan-hurricane-51499 |  | 14.3148 | 16.8014 | 22623 | 1577.45 | 31.7701 | 455.632 | 317.694 | 0.1341 | 11.1062 | 0.937805 | 21 | https://database.tytorobotics.com/tests/rjd/dys-samguk-wei-genfan-hurricane-51499 | third_party | S132 | 2026-10-20 | Test title: DYS Samguk Wei Genfan Hurricane 51499.
tyto-gwz | tyto-dys-samguk-wei-2207-2600kv | DYS Samguk Wei 2207 2600kv | flycolor-xcross-blheli32-50a-esc | propeller hq-prop-5045 |  | 14.3689 | 16.7982 | 24641 | 1708.08 | 27.3193 | 394.11 | 295.425 | 0.114488 | 10.3668 | 0.968039 | 21 | https://database.tytorobotics.com/tests/gwz/dys-samguk-wei-hq-5045 | third_party | S132 | 2026-10-20 | Test title: DYS Samguk Wei HQ 5045.
tyto-x79 | tyto-dys-samguk-wu-2206-2400kv | DYS Samguk Wu 2206 2400kv | emax-blheli-30a-bec-2a-5v | propeller gemfan-5040-r |  | 11.0343 | 11.3087 | 18132 | 1639.8 | 8.32996 | 92.1082 | 63.9568 | 0.0336831 | 3.81841 | 0.694365 | 21 | https://database.tytorobotics.com/tests/x79/dys-samguk-wu-2206-2400kv-gemfan-5040 | third_party | S132 | 2026-10-20 | Test title: DYS Samguk Wu 2206 2400kv Gemfan 5040.
tyto-yj4 | tyto-dys-samguk-wu-2206-2400kv | DYS Samguk Wu 2206 2400kv | emax-blheli-30a-bec-2a-5v | propeller 6030-carbon-nylon |  | 11.156 | 11.3069 | 17705 | 1587.04 | 8.63606 | 96.3436 | 67.7225 | 0.0365265 | 4.2914 | 0.702926 | 21 | https://database.tytorobotics.com/tests/yj4/dys-samguk-wu-2207-2400kv-with-gemfan-6030r | third_party | S132 | 2026-10-20 | Test title: DYS Samguk WU 2207 2400kv with Gemfan 6030R.
tyto-z64r | tyto-iflight-xing-nano-x1103-8000kv | iFlight Xing Nano X1103 8000kv | spedix-es30-hv-30a-2to6s-blhelis | propeller hp-prop-durable-t1o9x3x3 |  | 7.43066 | 7.60436 | 32093 | 4318.2 | 5.37176 | 39.9157 | 20.5086 | 0.00610521 | 0.436069 | 0.550068 | 16 | https://database.tytorobotics.com/tests/z64r/xing-nano-1103-8000kv-7o5v-with-hq-t1o9x3x3 | third_party | S132 | 2026-10-20 | Test title: Xing Nano 1103 8000kv 7o5V with HQ T1o9X3X3. Title names a different motor than the link: check.
tyto-r6nx | tyto-iflight-xing-nano-x1103-8000kv | iFlight Xing Nano X1103 8000kv | spedix-es30-hv-30a-2to6s-blhelis | propeller gemfan-hulkie-1940x3 |  | 7.46277 | 7.6044 | 38810 | 5199.24 | 4.227 | 31.5526 | 20.6873 | 0.00509017 | 0.436715 | 0.669721 | 14 | https://database.tytorobotics.com/tests/r6nx/xingnano1103-8000kv75v-wi-gemfanhulkie-1940x3 | third_party | S132 | 2026-10-20 | Test title: XingNano1103 8000kv75V wi GemfanHulkie 1940x3. Title names a different motor than the link: check.
tyto-9w67 | tyto-iflight-xing-nano-x1103-8000kv | iFlight Xing Nano X1103 8000kv | spedix-es30-hv-30a-2to6s-blhelis | propeller gemfan-hulkie-1940x3 |  | 7.46396 | 7.60395 | 38720 | 5187.59 | 4.24302 | 31.6817 | 19.7762 | 0.00487767 | 0.440562 | 0.631329 | 16 | https://database.tytorobotics.com/tests/9w67/xingnano1103-8000kv75v-wi-gemfanhulkie-1940x3 | third_party | S132 | 2026-10-20 | Test title: XingNano1103 8000kv75V wi GemfanHulkie 1940x3. Title names a different motor than the link: check.
tyto-yx9g | tyto-iflight-xing-nano-x1103-8000kv | iFlight Xing Nano X1103 8000kv | spedix-es30-hv-30a-2to6s-blhelis | propeller gemfan-2023x3 |  | 7.4404 | 7.60417 | 34181 | 4593.97 | 5.03582 | 37.4685 | 21.0112 | 0.00586999 | 0.474113 | 0.568678 | 14 | https://database.tytorobotics.com/tests/yx9g/xingnano1103-8000kv7d5v-wi-gemfan-2023x3 | third_party | S132 | 2026-10-20 | Test title: XingNano1103 8000kv7d5V wi Gemfan 2023x3. Title names a different motor than the link: check.
tyto-k6r6 | tyto-iflight-xing-nano-x1103-8000kv | iFlight Xing Nano X1103 8000kv | spedix-es30-hv-30a-2to6s-blhelis | propeller emax-avan-blur-2inch-3blade |  | 7.43468 | 7.60387 | 32761 | 4406.51 | 5.26894 | 39.1729 | 20.9979 | 0.00612785 | 0.475552 | 0.592375 | 14 | https://database.tytorobotics.com/tests/k6r6/xingnano1103-8000kv7d5v-wi-emaxavanblur2inx3 | third_party | S132 | 2026-10-20 | Test title: XingNano1103 8000kv7d5V wi EmaxAvanBlur2inx3. Title names a different motor than the link: check.
tyto-34x6 | tyto-iflight-xing-nano-x1103-8000kv | iFlight Xing Nano X1103 8000kv | spedix-es30-hv-30a-2to6s-blhelis | propeller gemfan-hulkie-2040x3 |  | 7.44969 | 7.6041 | 35347 | 4743.97 | 4.77601 | 35.5798 | 21.7099 | 0.00588744 | 0.495564 | 0.634893 | 14 | https://database.tytorobotics.com/tests/34x6/xingnano1103-8000kv7d5v-wi-gemfanhulkie-2040x3 | third_party | S132 | 2026-10-20 | Test title: XingNano1103 8000kv7d5V wi GemfanHulkie 2040x3. Title names a different motor than the link: check.
tyto-x3zm | tyto-iflight-xing-nano-x1103-8000kv | iFlight Xing Nano X1103 8000kv | spedix-es30-hv-30a-2to6s-blhelis | propeller emax-avan-micro-2x2o4x4 |  | 7.43206 | 7.6037 | 31945 | 4298.22 | 5.40025 | 40.1354 | 20.8891 | 0.00625221 | 0.45274 | 0.533818 | 14 | https://database.tytorobotics.com/tests/x3zm/xingnano1103-8000kv7o5v-wi-emaxavan-2x2o4x4 | third_party | S132 | 2026-10-20 | Test title: XingNano1103 8000kv7o5V wi EmaxAvan 2x2o4x4. Title names a different motor than the link: check.
tyto-69q7 | tyto-iflight-xing-nano-x1103-8000kv | iFlight Xing Nano X1103 8000kv | spedix-es30-hv-30a-2to6s-blhelis | propeller emax-avan-micro-2x2o4x4 |  | 7.44651 | 7.60438 | 32680 | 4387.77 | 5.44013 | 40.518 | 21.2673 | 0.00621444 | 0.476715 | 0.536819 | 14 | https://database.tytorobotics.com/tests/69q7/xingnano1103-8000kv7o5v-wi-emaxavan-2x2o4x4-n2 | third_party | S132 | 2026-10-20 | Test title: XingNano1103 8000kv7o5V wi EmaxAvan 2x2o4x4 n2. Title names a different motor than the link: check.
tyto-4x94 | tyto-flywoo-nin-1404-v2-2750kv | Flywoo NIN 1404 V2 2750kv | flyduino-kiss-esc32a | propeller gemfan-hurricane-4024x2 |  | 15.8978 | 16.0051 | 23932 | 1505.37 | 5.22767 | 83.1085 | 49.3084 | 0.0196749 | 1.52453 | 0.65257 | 17 | https://database.tytorobotics.com/tests/4x94/flywoonin-1404-ii-2750kv16v-wi-gemfan-4024x2-kiss | third_party | S132 | 2026-10-20 | Test title: FlywooNIN 1404 II 2750kv16V wi Gemfan 4024x2 KISS.
tyto-n9n7 | tyto-flywoo-nin-1404-v2-2750kv | Flywoo NIN 1404 V2 2750kv | spedix-es30-hv-30a-2to6s-blhelis | propeller gemfan-hurricane-4024x2 |  | 15.9184 | 16.0414 | 25418 | 1596.77 | 7.05694 | 112.572 | 56.2742 | 0.0211417 | 1.76086 | 0.576004 | 16 | https://database.tytorobotics.com/tests/n9n7/flywoonin-1404-ii-2750kv16v-wi-gemfan-4024x2-blhs | third_party | S132 | 2026-10-20 | Test title: FlywooNIN 1404 II 2750kv16V wi Gemfan 4024x2 BLhs.
tyto-mzgz | tyto-kde-direct-kde4012xf-400 | KDE Direct KDE4012XF-400 | kde-direct-kdexf-uas35 | propeller kde-direct-kde-cf155-dp |  | 23.9548 | 25.0995 | 7000 | 292.217 | 23.2449 | 556.825 | 443.181 | 0.604582 | 29.828 | 0.803015 | 21 | https://database.tytorobotics.com/tests/mzgz/kde-4012xf-400-with-kde-cf155-dp | third_party | S132 | 2026-10-20 | Test title: KDE 4012XF-400 with KDE-CF155-DP.
tyto-47k4 | tyto-kde-direct-kde4012xf-400 | KDE Direct KDE4012XF-400 | kde-direct-kdexf-uas35 | propeller t-motor-fa162x53 |  | 23.9408 | 25.0798 | 7065 | 295.103 | 22.5489 | 539.838 | 433.161 | 0.585476 | 31.1764 | 0.805275 | 21 | https://database.tytorobotics.com/tests/47k4/kde-4012xf-400-with-t-motor-fa162x53 | third_party | S132 | 2026-10-20 | Test title: KDE 4012XF-400 with T-Motor FA162x53.
tyto-nrq7 | tyto-kde-direct-kde4012xf-400 | KDE Direct KDE4012XF-400 | kde-direct-kdexf-uas35 | propeller t-motor-p17x58 |  | 23.5048 | 24.8059 | 6471 | 275.305 | 27.4498 | 645.202 | 491.015 | 0.724594 | 35.0392 | 0.778191 | 21 | https://database.tytorobotics.com/tests/nrq7/kde-4012xf-400-with-t-motor-p17x58 | third_party | S132 | 2026-10-20 | Test title: KDE 4012XF-400 with T-Motor P17x58.
tyto-gyrq | tyto-kde-direct-kde4012xf-400 | KDE Direct KDE4012XF-400 | kde-direct-kdexf-uas35 | propeller t-motor-p18x61 |  | 23.6004 | 25.119 | 6075 | 257.411 | 32.9652 | 777.993 | 555.851 | 0.873742 | 39.5189 | 0.748344 | 21 | https://database.tytorobotics.com/tests/gyrq/kde-4012xf-400-with-t-motor-p18x61 | third_party | S132 | 2026-10-20 | Test title: KDE 4012XF-400 with T-Motor P18x61.
tyto-d3ee | tyto-kde-direct-kde4012xf-400 | KDE Direct KDE4012XF-400 | kde-direct-kdexf-uas35 |  |  | 23.3379 | 24.9011 | 6198 | 265.576 | 29.4721 | 687.817 | 500.914 | 0.771761 | 33.6881 | 0.762702 | 21 | https://database.tytorobotics.com/tests/d3ee/kde-4012xf-400-with-circ-16 | third_party | S132 | 2026-10-20 | Test title: KDE 4012XF-400 with CIRC 16".
tyto-7kr7 | tyto-kde-direct-kde4012xf-400 | KDE Direct KDE4012XF-400 | kde-direct-kdexf-uas35 | propeller t-motor-p20x6 |  | 23.7222 | 25.1083 | 5125 | 216.042 | 31.0385 | 736.303 | 482.884 | 0.899746 | 38.646 | 0.717821 | 21 | https://database.tytorobotics.com/tests/7kr7/kde-4012xf-400-with-t-motor-p20x6 | third_party | S132 | 2026-10-20 | Test title: KDE 4012XF-400 with T-Motor P20x6.
tyto-zmke | tyto-kde-direct-kde4012xf-400 | KDE Direct KDE4012XF-400 | kde-direct-kdexf-uas35 | propeller t-motor-ns20x62 |  | 23.6878 | 25.0918 | 5076 | 214.288 | 31.3918 | 743.603 | 482.268 | 0.907273 | 38.4016 | 0.714175 | 21 | https://database.tytorobotics.com/tests/zmke/kde-4012xf-400-with-t-motor-ns20x62 | third_party | S132 | 2026-10-20 | Test title: KDE 4012XF-400 with T-Motor NS20x62.
tyto-9xqz | tyto-kde-direct-kde4012xf-400 | KDE Direct KDE4012XF-400 | kde-direct-kdexf-uas35 | propeller t-motor-g18x59 |  | 23.1353 | 25.0111 | 6039 | 261.03 | 31.7687 | 734.978 | 531.941 | 0.841143 | 38.7212 | 0.763139 | 21 | https://database.tytorobotics.com/tests/9xqz/kde-4012xf-400-with-t-motor-g18x59 | third_party | S132 | 2026-10-20 | Test title: KDE 4012XF-400 with T-Motor G18x59.
tyto-ez6w | tyto-t-motor-f40-pro-ii-1750kv | T-Motor F40 Pro II 1750kv | diatone-mamba-f50-pro | propeller hq-prop-r38 |  | 23.0003 | 25.0546 | 27290 | 1186.51 | 26.2993 | 604.893 | 370.476 | 0.129637 | 8.76556 | 0.658499 | 9 | https://database.tytorobotics.com/tests/ez6w/tmotor-f40-pro2-1750kv-with-hq-r38-prop | third_party | S132 | 2026-10-20 | Test title: Tmotor f40 pro2 1750kv with HQ R38 prop.
tyto-y6gj | tyto-kde-direct-kde4014xf-380 | KDE Direct KDE4014XF-380 | kde-direct-kdexf-uas35 | propeller kde-direct-kde-cf155-dp |  | 23.8151 | 25.0767 | 6916 | 290.405 | 22.1209 | 526.811 | 432.59 | 0.597301 | 29.3897 | 0.826235 | 21 | https://database.tytorobotics.com/tests/y6gj/kde-4014xf-380-with-kde-cf155-dp | third_party | S132 | 2026-10-20 | Test title: KDE 4014XF-380 with KDE CF155-DP.
tyto-d7ze | tyto-kde-direct-kde4014xf-380 | KDE Direct KDE4014XF-380 | kde-direct-kdexf-uas35 | propeller t-motor-ns20x62 |  | 23.4563 | 25.1105 | 5481 | 233.669 | 37.2803 | 874.456 | 608.301 | 1.05982 | 45.1145 | 0.732617 | 21 | https://database.tytorobotics.com/tests/d7ze/kde-4014xf-380-with-t-motor-ns20x62 | third_party | S132 | 2026-10-20 | Test title: KDE 4014XF-380 with T-Motor NS20x62.
tyto-kjm3 | tyto-kde-direct-kde4014xf-380 | KDE Direct KDE4014XF-380 | kde-direct-kdexf-uas35 | propeller t-motor-p16x54 |  | 23.8531 | 25.0957 | 6882 | 288.516 | 22.8804 | 545.77 | 449.163 | 0.623248 | 31.363 | 0.825284 | 21 | https://database.tytorobotics.com/tests/kjm3/kde-4014xf-380-with-t-motor-p16x54 | third_party | S132 | 2026-10-20 | Test title: KDE 4014XF-380 with T-Motor P16x54.
tyto-ezxx | tyto-kde-direct-kde4014xf-380 | KDE Direct KDE4014XF-380 | kde-direct-kdexf-uas35 | propeller t-motor-ns22x66 |  | 23.4288 | 25.0683 | 4469 | 190.748 | 37.0132 | 867.176 | 538.644 | 1.15097 | 44.5835 | 0.69601 | 21 | https://database.tytorobotics.com/tests/ezxx/kde-4014xf-380-with-t-motor-p22x66 | third_party | S132 | 2026-10-20 | Test title: KDE 4014XF-380 with T-Motor P22x66.
tyto-6ydk | tyto-kde-direct-kde4014xf-380 | KDE Direct KDE4014XF-380 | kde-direct-kdexf-uas35 | propeller t-motor-p18x61 |  | 23.5883 | 25.1386 | 6126 | 259.705 | 32.0381 | 755.723 | 577.357 | 0.899992 | 40.4567 | 0.779744 | 21 | https://database.tytorobotics.com/tests/6ydk/kde-4014xf-380-with-t-motor-p18x61 | third_party | S132 | 2026-10-20 | Test title: KDE 4014XF-380 with T-Motor P18x61.
tyto-ry34 | tyto-kde-direct-kde4014xf-380 | KDE Direct KDE4014XF-380 | kde-direct-kdexf-uas35 | propeller t-motor-p15x5 |  | 23.852 | 25.0102 | 7163 | 300.311 | 19.1802 | 457.486 | 382.577 | 0.510029 | 27.4016 | 0.836259 | 21 | https://database.tytorobotics.com/tests/ry34/kde-4014xf-380-with-t-motor-p15x5 | third_party | S132 | 2026-10-20 | Test title: KDE 4014XF-380 with T-Motor P15x5.
tyto-363m | tyto-kde-direct-kde4014xf-380 | KDE Direct KDE4014XF-380 | kde-direct-kdexf-uas35 | propeller t-motor-fa162x53 |  | 23.9737 | 25.0966 | 7005 | 292.195 | 21.5641 | 516.972 | 429.272 | 0.585189 | 30.8211 | 0.830359 | 21 | https://database.tytorobotics.com/tests/363m/kde-4014xf-380-with-t-motor-fa162x53 | third_party | S132 | 2026-10-20 | Test title: KDE 4014XF-380 with T-Motor FA162x53.
tyto-w39g | tyto-kde-direct-kde4014xf-380 | KDE Direct KDE4014XF-380 | kde-direct-kdexf-uas35 | propeller t-motor-g18x59 |  | 23.6236 | 25.1153 | 6188 | 261.942 | 31.5238 | 744.705 | 575.328 | 0.887844 | 40.6672 | 0.785935 | 21 | https://database.tytorobotics.com/tests/w39g/kde-4014xf-380-with-t-motor-g18x59 | third_party | S132 | 2026-10-20 | Test title: KDE 4014XF-380 with T-Motor G18x59.
tyto-7kj7 | tyto-kde-direct-kde4014xf-300 | KDE Direct KDE4014XF-300 | kde-direct-kdexf-uas35 | propeller t-motor-p20x6 |  | 23.7137 | 25.0736 | 5072 | 213.885 | 26.2208 | 621.792 | 470.081 | 0.885044 | 38.075 | 0.77048 | 21 | https://database.tytorobotics.com/tests/7kj7/kde-4014xf-300-with-t-motor-p20x6 | third_party | S132 | 2026-10-20 | Test title: KDE 4014XF-300 with T-Motor P20x6.
tyto-mzez | tyto-kde-direct-kde4014xf-300 | KDE Direct KDE4014XF-300 | kde-direct-kdexf-uas35 | propeller t-motor-p15x5 |  | 24.4725 | 25.1925 | 6386 | 260.946 | 12.9098 | 315.936 | 264.986 | 0.396246 | 21.3029 | 0.838732 | 21 | https://database.tytorobotics.com/tests/mzez/kde-4014xf-300-with-t-motor-p15x5 | third_party | S132 | 2026-10-20 | Test title: KDE 4014XF-300 with T-Motor P15x5.
tyto-zm6e | tyto-kde-direct-kde4014xf-300 | KDE Direct KDE4014XF-300 | kde-direct-kdexf-uas35 | propeller t-motor-ns22x66 |  | 23.5822 | 25.0815 | 4328 | 183.528 | 31.3458 | 739.201 | 486.959 | 1.07443 | 41.6375 | 0.721686 | 21 | https://database.tytorobotics.com/tests/zm6e/kde-4014xf-300-with-t-motor-ns22x66 | third_party | S132 | 2026-10-20 | Test title: KDE 4014XF-300 with T-Motor NS22x66.
tyto-47x4 | tyto-kde-direct-kde4014xf-300 | KDE Direct KDE4014XF-300 | kde-direct-kdexf-uas35 | propeller t-motor-p16x54 |  | 24.3235 | 25.1249 | 6113 | 251.321 | 15.24 | 370.691 | 306.87 | 0.47937 | 24.3871 | 0.829032 | 21 | https://database.tytorobotics.com/tests/47x4/kde-4014xf-300-with-t-motor-p16x54 | third_party | S132 | 2026-10-20 | Test title: KDE 4014XF-300 with T-Motor P16x54.
tyto-ry64 | tyto-kde-direct-kde4014xf-300 | KDE Direct KDE4014XF-300 | kde-direct-kdexf-uas55 | propeller t-motor-ns24x72 |  | 23.444 | 25.0287 | 3687 | 157.269 | 29.3431 | 687.919 | 419.177 | 1.08567 | 40.0289 | 0.67497 | 21 | https://database.tytorobotics.com/tests/ry64/kde-4014xf-300-with-t-motor-p24x72 | third_party | S132 | 2026-10-20 | Test title: KDE 4014XF-300 with T-Motor P24x72.
tyto-nr97 | tyto-kde-direct-kde4014xf-300 | KDE Direct KDE4014XF-300 | kde-direct-kdexf-uas35 | propeller t-motor-p17x58 |  | 24.201 | 25.1162 | 5814 | 240.238 | 17.9387 | 434.134 | 353.917 | 0.581296 | 27.892 | 0.818598 | 21 | https://database.tytorobotics.com/tests/nr97/kde-4014xf-300-with-t-motor-p17x58 | third_party | S132 | 2026-10-20 | Test title: KDE 4014XF-300 with T-Motor P17x58.
tyto-gy4q | tyto-kde-direct-kde4014xf-300 | KDE Direct KDE4014XF-300 | kde-direct-kdexf-uas35 | propeller t-motor-p18x61 |  | 24.0183 | 25.0865 | 5478 | 228.076 | 21.5255 | 517.008 | 407.947 | 0.711136 | 32.0785 | 0.795965 | 21 | https://database.tytorobotics.com/tests/gy4q/kde-4014xf-300-with-t-motor-p18x61 | third_party | S132 | 2026-10-20 | Test title: KDE 4014XF-300 with T-Motor P18x61.
tyto-7j33 | tyto-t-motor-mn501s-kv240 | T-Motor MN501S KV240 |  | propeller t-motor-mf2211 |  | 28.9305 | 30.5402 | 4814 | 166.399 | 24.9833 | 722.78 | 639.711 | 1.26896 | 46.9903 | 0.948278 | 17 | https://database.tytorobotics.com/tests/7j33/mn501-kv-240-22-11 | third_party | S132 | 2026-10-20 | Test title: mn501 kv 240 22-11. Title names a different motor than the link: check.
tyto-g49q | tyto-t-motor-mn501s-kv240 | T-Motor MN501S KV240 |  |  |  | 26.852 | 28.7361 | 4849 | 180.583 | 27.39 | 735.476 | 646.17 | 1.27252 | 47.0908 | 0.960002 | 17 | https://database.tytorobotics.com/tests/g49q/mn501-kv-240-22-11-v31 | third_party | S132 | 2026-10-20 | Test title: mn501 kv 240 22-11 V31. Title names a different motor than the link: check.
tyto-mzzz | tyto-t-motor-mn501s-kv240 | T-Motor MN501S KV240 | kde-direct-kdexf-uas55 | propeller t-motor-p16x54 |  | 24.4939 | 25.0862 | 5606 | 228.874 | 11.1119 | 272.172 | 237.61 | 0.404747 | 20.1765 | 0.873014 | 21 | https://database.tytorobotics.com/tests/mzzz/t-motor-mn501s-240-with-t-motor-p16x54 | third_party | S132 | 2026-10-20 | Test title: T-Motor MN501S-240 with T-Motor P16x54.
tyto-4774 | tyto-t-motor-mn501s-kv240 | T-Motor MN501S KV240 | kde-direct-kdexf-uas55 | propeller t-motor-p18x61 |  | 24.1904 | 25.111 | 5217 | 215.664 | 16.8843 | 408.439 | 351.878 | 0.644084 | 28.8785 | 0.861519 | 21 | https://database.tytorobotics.com/tests/4774/t-motor-mn501s-240-with-t-motor-p18x61 | third_party | S132 | 2026-10-20 | Test title: T-Motor MN501S-240 with T-Motor P18x61.
tyto-zmme | tyto-t-motor-mn501s-kv240 | T-Motor MN501S KV240 | kde-direct-kdexf-uas55 | propeller t-motor-ns26x85 |  | 23.6245 | 25.0466 | 3142 | 132.997 | 30.5549 | 721.846 | 446.665 | 1.35752 | 44.5112 | 0.725881 | 21 | https://database.tytorobotics.com/tests/zmme/t-motor-mn501s-240-with-t-motor-ns26x85 | third_party | S132 | 2026-10-20 | Test title: T-Motor MN501S-240 with T-Motor NS26x85.
tyto-ezzx | tyto-t-motor-mn501s-kv240 | T-Motor MN501S KV240 | kde-direct-kdexf-uas55 | propeller t-motor-p17x58 |  | 24.3175 | 25.1133 | 5428 | 223.214 | 13.5089 | 328.503 | 285.588 | 0.502425 | 24.0401 | 0.869359 | 21 | https://database.tytorobotics.com/tests/ezzx/t-motor-mn501s-240-with-t-motor-p17x58 | third_party | S132 | 2026-10-20 | Test title: T-Motor MN501S-240 with T-Motor P17x58.
tyto-nrr7 | tyto-t-motor-mn501s-kv240 | T-Motor MN501S KV240 | kde-direct-kdexf-uas55 | propeller t-motor-p20x6 |  | 23.9509 | 25.093 | 4925 | 205.629 | 21.5613 | 516.412 | 431.999 | 0.837621 | 36.0151 | 0.836893 | 21 | https://database.tytorobotics.com/tests/nrr7/t-motor-mn501s-240-with-t-motor-p20x6 | third_party | S132 | 2026-10-20 | Test title: T-Motor MN501S-240 with T-Motor P20x6.
tyto-gyyq | tyto-t-motor-mn501s-kv240 | T-Motor MN501S KV240 | kde-direct-kdexf-uas55 | propeller t-motor-ns22x66 |  | 23.6101 | 25.0421 | 4471 | 189.368 | 29.6841 | 700.844 | 538.519 | 1.15018 | 44.4357 | 0.793657 | 21 | https://database.tytorobotics.com/tests/gyyq/t-motor-mn501s-240-with-t-motor-ns22x66 | third_party | S132 | 2026-10-20 | Test title: T-Motor MN501S-240 with T-Motor NS22x66.
tyto-mzxq | tyto-sr2306 | SR2306 |  | propeller hq-prop-7045x2 |  | 11.4368 | 11.5656 | 8542 | 746.886 | 2.79149 | 31.9258 | 29.4307 | 0.0329012 | 2.19795 | 0.921847 | 11 | https://database.tytorobotics.com/tests/mzxq/2306-870kv-7x45x2-3s | third_party | S132 | 2026-10-20 | Test title: 2306 870Kv - 7x45x2 - 3S. Title names a different motor than the link: check.
tyto-47yq | tyto-sr2306 | SR2306 |  |  |  | 11.3271 | 11.5128 | 9245 | 816.185 | 4.51293 | 51.1184 | 37.3109 | 0.0385389 | 2.62171 | 0.729891 | 6 | https://database.tytorobotics.com/tests/47yq/2306-1700kv-7x45x2-3s | third_party | S132 | 2026-10-20 | Test title: 2306 1700Kv - 7x45x2 - 3S. Title names a different motor than the link: check.
tyto-gyzw | tyto-racerstar-air-a-2508-1200kv | Racerstar Air-A 2508 1200kv | diatone-mamba-f50-pro | propeller gemfan-7037-3 |  | 21.522 | 23.2093 | 18244 | 847.692 | 22.9031 | 492.92 | 369.559 | 0.193435 | 12.7469 | 0.756443 | 8 | https://database.tytorobotics.com/tests/gyzw/tmotor-2508-1200kv-with-gemfan-7037-prop | third_party | S132 | 2026-10-20 | Test title: tmotor 2508 1200kv with gemfan 7037 prop. Title names a different motor than the link: check.
tyto-k4r | tyto-hglrc-hf1407-3600kv-flame | HGLRC HF1407 3600kv - Flame | flycolor-xcross-blheli32-50a-esc | propeller gemfan-3052-flash |  | 15.4876 | 16.8025 | 35026 | 2254.13 | 18.2744 | 283.959 | 163.368 | 0.0445396 | 4.44796 | 0.593028 | 21 | https://database.tytorobotics.com/tests/k4r/hglrc-hf1407-3600kv-gemfan-3052-flash | third_party | S132 | 2026-10-20 | Test title: HGLRC HF1407 3600kv Gemfan 3052 - Flash.
tyto-xq9 | tyto-hglrc-hf1407-3600kv-flame | HGLRC HF1407 3600kv - Flame | flycolor-xcross-blheli32-50a-esc | propeller gemfan-3028-windancer |  | 11.9187 | 12.6308 | 35970 | 3010.89 | 8.96065 | 107.05 | 93.1247 | 0.0247227 | 2.96222 |  | 21 | https://database.tytorobotics.com/tests/xq9/hglrc-hf1407-3600kv-gemfan-windancer-3028-3s | third_party | S132 | 2026-10-20 | Test title: HGLRC HF1407 3600kv Gemfan Windancer 3028 - 3S.
tyto-red | tyto-hglrc-hf1407-3600kv-flame | HGLRC HF1407 3600kv - Flame | flycolor-xcross-blheli32-50a-esc | propeller gemfan-3052-flash |  | 11.655 | 12.5975 | 29906 | 2561.92 | 13.2167 | 154.282 | 97.6873 | 0.0311926 | 3.2028 | 0.633175 | 21 | https://database.tytorobotics.com/tests/red/hglrc-hf1407-3600kv-gemfan-3052-flash-3s-pack | third_party | S132 | 2026-10-20 | Test title: HGLRC HF1407 3600kv Gemfan 3052 - Flash - 3s Pack.
tyto-3wq | tyto-hglrc-hf1407-3600kv-flame | HGLRC HF1407 3600kv - Flame | flycolor-xcross-blheli32-50a-esc | propeller hq-prop-3040 |  | 11.5727 | 12.5729 | 29882 | 2577.68 | 13.7008 | 158.827 | 108.416 | 0.0346462 | 3.19003 | 0.994992 | 21 | https://database.tytorobotics.com/tests/3wq/hglrc-hf1407-3600kv-hq-3040-3s | third_party | S132 | 2026-10-20 | Test title: HGLRC HF1407 3600kv HQ 3040 - 3S.
tyto-6gd | tyto-hglrc-hf1407-3600kv-flame | HGLRC HF1407 3600kv - Flame | flycolor-xcross-blheli32-50a-esc | propeller gemfan-3028-windancer |  | 15.4305 | 16.4803 | 43594 | 2820.05 | 12.8052 | 197.95 | 135.831 | 0.0297538 | 4.38391 | 0.691806 | 21 | https://database.tytorobotics.com/tests/6gd/hglrc-hf1407-3600kv-gemfan-windancer-3028 | third_party | S132 | 2026-10-20 | Test title: HGLRC HF1407 3600kv Gemfan Windancer 3028.
tyto-wjk | tyto-hglrc-hf1407-3600kv-flame | HGLRC HF1407 3600kv - Flame | flycolor-xcross-blheli32-50a-esc | propeller hq-prop-3040 |  | 15.4091 | 16.7996 | 34713 | 2252.77 | 19.4147 | 299.163 | 198.843 | 0.0547004 | 4.39362 |  | 21 | https://database.tytorobotics.com/tests/wjk/hglrc-hf1407-3600kv-hq-3040 | third_party | S132 | 2026-10-20 | Test title: HGLRC HF1407 3600kv HQ 3040.
tyto-qem | tyto-hglrc-hf1407-3600kv-flame | HGLRC HF1407 3600kv - Flame | flycolor-xcross-blheli32-50a-esc | propeller hq-prop-3040 |  | 14.6661 | 15.9781 | 33730 | 2297.9 | 18.0419 | 264.829 | 157.824 | 0.0446817 | 4.04639 | 0.595948 | 17 | https://database.tytorobotics.com/tests/qem/hglrc-hf1407-3600kv-hq-3040-no-cool | third_party | S132 | 2026-10-20 | Test title: HGLRC HF1407 3600kv HQ 3040 - No cool.
tyto-7qx4 | tyto-t-motor-antigravity-mn5008-kv170 | T-Motor Antigravity MN5008 KV170 | afro-race-spec-mini-esc-with-bec-20a | propeller dalprop-5050-cyclone |  | 16.5105 | 17.1146 | 14657 | 887.74 | 7.23267 | 119.415 |  |  | 4.69955 |  | 16 | https://database.tytorobotics.com/tests/7qx4/tmotor-f22035-1500kv-with-master-as-6x2 | third_party | S132 | 2026-10-20 | Test title: TMotor F22035-1500KV with Master AS 6x2.
tyto-9xkq | tyto-t-motor-antigravity-mn5008-kv170 | T-Motor Antigravity MN5008 KV170 | t-motor-flame-70a-6s | propeller t-motor-p16x54 |  | 24.7374 | 24.9698 | 3908 | 157.979 | 3.79027 | 93.7614 | 77.9922 | 0.190576 | 9.55225 | 0.831815 | 21 | https://database.tytorobotics.com/tests/9xkq/t-motor-antigravity-5008-170-with-t-motor-p16x54 | third_party | S132 | 2026-10-20 | Test title: T-Motor Antigravity 5008-170 with T-Motor P16x54.
tyto-ryz6 | tyto-t-motor-antigravity-mn5008-kv170 | T-Motor Antigravity MN5008 KV170 | t-motor-flame-70a-6s | propeller t-motor-p17x58 |  | 24.8337 | 25.12 | 3826 | 154.065 | 4.84419 | 120.299 | 101.8 | 0.254082 | 12.1655 | 0.846225 | 21 | https://database.tytorobotics.com/tests/ryz6/t-motor-antigravity-5008-170-with-t-motor-p17x58 | third_party | S132 | 2026-10-20 | Test title: T-Motor Antigravity 5008-170 with T-Motor P17x58.
tyto-y6m6 | tyto-t-motor-antigravity-mn5008-kv170 | T-Motor Antigravity MN5008 KV170 | t-motor-flame-70a-6s | propeller t-motor-p18x61 |  | 24.7739 | 25.114 | 3723 | 150.279 | 6.07397 | 150.476 | 127.357 | 0.326665 | 14.7537 | 0.846364 | 21 | https://database.tytorobotics.com/tests/y6m6/t-motor-antigravity-5008-170-with-t-motor-p18x61 | third_party | S132 | 2026-10-20 | Test title: T-Motor Antigravity 5008-170 with T-Motor P18x61.
tyto-kj77 | tyto-t-motor-antigravity-mn5008-kv170 | T-Motor Antigravity MN5008 KV170 | t-motor-flame-70a-6s | propeller t-motor-p18x61 |  | 24.6983 | 25.1211 | 3558 | 144.059 | 7.64753 | 188.881 | 158.149 | 0.424455 | 18.27 | 0.841133 | 21 | https://database.tytorobotics.com/tests/kj77/t-motor-antigravity-5008-170-with-t-motor-p18x61 | third_party | S132 | 2026-10-20 | Test title: T-Motor Antigravity 5008-170 with T-Motor P18x61.
tyto-36yz | tyto-t-motor-antigravity-mn5008-kv170 | T-Motor Antigravity MN5008 KV170 | t-motor-flame-70a-6s | propeller t-motor-ns22x66 |  | 24.5285 | 25.1158 | 3287 | 134.007 | 10.5336 | 258.373 | 206.171 | 0.598963 | 23.1814 | 0.801637 | 21 | https://database.tytorobotics.com/tests/36yz/t-motor-antigravity-5008-170-with-t-motor-p22x66 | third_party | S132 | 2026-10-20 | Test title: T-Motor Antigravity 5008-170 with T-Motor P22x66.
tyto-xjmx | tyto-t-motor-antigravity-mn5008-kv170 | T-Motor Antigravity MN5008 KV170 | t-motor-flame-70a-6s | propeller t-motor-ns24x72 |  | 24.4514 | 25.1371 | 3033 | 124.042 | 12.7728 | 312.312 | 234.209 | 0.737399 | 26.8603 | 0.766664 | 21 | https://database.tytorobotics.com/tests/xjmx/t-motor-antigravity-5008-170-with-t-motor-ns24x72 | third_party | S132 | 2026-10-20 | Test title: T-Motor Antigravity 5008-170 with T-Motor NS24x72.
tyto-6yxj | tyto-t-motor-antigravity-mn5008-kv170 | T-Motor Antigravity MN5008 KV170 | t-motor-flame-70a-6s | propeller t-motor-ns26x85 |  | 24.1112 | 25.0039 | 2617 | 108.539 | 16.6466 | 401.368 | 257.865 | 0.940936 | 30.8062 | 0.714402 | 21 | https://database.tytorobotics.com/tests/6yxj/t-motor-antigravity-5008-170-with-t-motor-ns26x85 | third_party | S132 | 2026-10-20 | Test title: T-Motor Antigravity 5008-170 with T-Motor NS26x85.
tyto-dgq | tyto-t-motor-u15-v1 | T-Motor U15 V1 | t-motor-flame-180a-hv | propeller xoar-pjp-t-l-40x10 |  | 42.5259 | 50.4639 | 2896 | 68.0997 | 79.8567 | 3395.97 | 2689.17 | 8.86728 | 200.614 | 0.793712 | 11 | https://database.tytorobotics.com/tests/dgq/t-motor-u15-kv80-with-xoar-40x10 | third_party | S132 | 2026-10-20 | Test title: T-motor U15 Kv80 with Xoar 40x10.
tyto-w3j7 | tyto-t-motor-4014-11-kv330 | T-Motor 4014-11 KV330 | t-motor-alpha-40a-6s | propeller apc-16x55mrp |  | 24.62 | 25.0894 | 6185 | 251.03 | 20.6438 | 508.251 | 390.28 | 0.603937 | 29.4333 | 0.773766 | 19 | https://database.tytorobotics.com/tests/w3j7/t-motor-4014-330-kv-w-apc16x55 | third_party | S132 | 2026-10-20 | Test title: T-motor 4014 330 kv w APC16x55.
tyto-y6jn | tyto-t-motor-4014-11-kv330 | T-Motor 4014-11 KV330 |  |  |  | 23.6517 | 24.2707 | 7412 | 313.084 | 9.23832 | 218.709 | 180.138 | 0.232082 | 14.2084 | 0.82376 | 19 | https://database.tytorobotics.com/tests/y6jn/t-motor-4014-330-kv-w-apc12x45 | third_party | S132 | 2026-10-20 | Test title: T-motor 4014 330 kv w APC12x45.
tyto-kjdy | tyto-t-motor-4014-11-kv330 | T-Motor 4014-11 KV330 |  | propeller apc-16x55mrp |  | 24.2122 | 24.727 | 6144 | 253.466 | 20.2984 | 491.469 | 372.178 | 0.583107 | 28.3633 | 0.757276 | 19 | https://database.tytorobotics.com/tests/kjdy/t-motor-4014-330-kv-w-apc-16x55 | third_party | S132 | 2026-10-20 | Test title: T-motor 4014 330 kv w APC 16x55.
tyto-36e9 | tyto-t-motor-4014-11-kv330 | T-Motor 4014-11 KV330 |  | propeller t-motor-p16x54 |  | 24.1756 | 24.6536 | 6357 | 262.734 | 17.458 | 422.057 | 331.395 | 0.499383 | 25.1396 | 0.785191 | 19 | https://database.tytorobotics.com/tests/36e9/t-motor-4014-330-kv-w-t-motor-16x54 | third_party | S132 | 2026-10-20 | Test title: T-motor 4014 330 kv w T-motor 16x54.
tyto-ez7w | tyto-t-motor-4014-11-kv330 | T-Motor 4014-11 KV330 | t-motor-alpha-40a-6s | propeller t-motor-p18x61 |  | 23.1133 | 23.6013 | 5516 | 238.651 | 21.8675 | 505.429 | 383.525 | 0.663958 | 29.529 | 0.770704 | 17 | https://database.tytorobotics.com/tests/ez7w/t-motor-mn4014-330-kv-with-t-motor-18x61 | third_party | S132 | 2026-10-20 | Test title: T-motor MN4014 330 kV with T-motor 18x61.
tyto-yy7d | tyto-t-motor-4014-11-kv330 | T-Motor 4014-11 KV330 | emax-blheli-80a-ubec-5a-5v | propeller gemfan-5040-r |  | 7.87825 | 8.38506 | 15763.3 | 2000.86 | 5.58007 | 43.9611 | 25.2448 | 0.0152931 | 1.74188 | 0.64976 | 11 | https://database.tytorobotics.com/tests/yy7d/testing-the-titile | third_party | S132 | 2026-10-20 | Test title: testing the titile.
tyto-nzq | tyto-xoar-ta110-20-kv80 | Xoar TA110-20 KV80 | flier-airplane-350a | propeller xoar-pjp-t-l-40x10 |  | 43.0381 | 49.9348 | 2745 | 63.3725 | 66.5761 | 2883.76 | 2326.77 | 8.09436 | 184.422 | 0.806852 | 16 | https://database.tytorobotics.com/tests/nzq/ta110-20-kv80-with-xoar-40x10 | third_party | S132 | 2026-10-20 | Test title: TA110-20 Kv80 with Xoar 40x10.
tyto-zxd9 | tyto-t-motor-u5-kv400 | T-Motor U5 KV400 | t-motor-alpha-40a-6s | propeller t-motor-mf1806 |  | 21.9746 | 22.1718 | 5619 | 253.569 | 2.93351 | 64.4627 | 19.5966 | 0.173593 | 7.90597 |  | 7 | https://database.tytorobotics.com/tests/zxd9/t-motor-u5-kv400-with-t-motor-mf1806 | third_party | S132 | 2026-10-20 | Test title: T-Motor U5 KV400 with T-Motor MF1806.
tyto-36k9 | tyto-t-motor-u5-kv400 | T-Motor U5 KV400 | t-motor-alpha-40a-6s | propeller t-motor-ns15x5 |  | 22.2436 | 22.8696 | 6980 | 313.799 | 18.7261 | 416.534 | 334.383 | 0.457467 | 24.2416 | 0.810436 | 17 | https://database.tytorobotics.com/tests/36k9/t-motor-u5-400-kv-with-t-motor-ns15x5 | third_party | S132 | 2026-10-20 | Test title: T-motor U5 400 kV with T-motor NS15x5.
tyto-xj6z | tyto-t-motor-u5-kv400 | T-Motor U5 KV400 | t-motor-alpha-40a-6s | propeller t-motor-p15x5 |  | 22.2319 | 22.8615 | 6969 | 313.469 | 18.8907 | 419.976 | 332.19 | 0.455185 | 24.3714 | 0.803743 | 17 | https://database.tytorobotics.com/tests/xj6z/t-motor-u5-400-kv-with-t-motor-p15x5 | third_party | S132 | 2026-10-20 | Test title: T-motor U5 400 kV with T-motor P15x5.
tyto-mz6q | tyto-t-motor-u5-kv400 | T-Motor U5 KV400 | t-motor-alpha-40a-6s | propeller t-motor-p18x61 |  | 22.8255 | 23.5129 | 5966 | 261.374 | 33.1455 | 756.562 | 484.832 | 0.776031 | 34.7615 | 0.730423 | 17 | https://database.tytorobotics.com/tests/mz6q/t-motor-u5-kv400-with-t-motor-18x61 | third_party | S132 | 2026-10-20 | Test title: T-motor U5 KV400 with T-motor 18x61.
tyto-473q | tyto-t-motor-u5-kv400 | T-Motor U5 KV400 | t-motor-alpha-40a-6s | propeller t-motor-p16x54 |  | 22.9363 | 23.4354 | 6787 | 295.907 | 24.3411 | 558.294 | 411.1 | 0.578417 | 29.2175 | 0.761772 | 17 | https://database.tytorobotics.com/tests/473q/t-motor-u5-kv400-with-t-motor-16x54 | third_party | S132 | 2026-10-20 | Test title: T-motor U5 KV400 with T-motor 16x54.
tyto-nrwe | tyto-t-motor-u5-kv400 | T-Motor U5 KV400 | t-motor-alpha-40a-6s | propeller apc-16x55mrp |  | 22.8414 | 23.3991 | 6513 | 285.14 | 27.2666 | 622.807 | 442.511 | 0.648805 | 30.9607 | 0.756422 | 17 | https://database.tytorobotics.com/tests/nrwe/t-motor-u5-kv400-with-apc-16x55 | third_party | S132 | 2026-10-20 | Test title: T-motor U5 KV400 with APC 16x55.
tyto-y6nn | tyto-t-motor-u5-kv400 | T-Motor U5 KV400 | t-motor-alpha-40a-6s | propeller kde-direct-kde-cf155-dp |  | 22.5963 | 23.0001 | 6151 | 272.212 | 16.1096 | 364.018 | 279.101 | 0.433299 | 21.4988 | 0.782192 | 15 | https://database.tytorobotics.com/tests/y6nn/t-motor-u5-400-kv-with-kde-155x53-folding | third_party | S132 | 2026-10-20 | Test title: T-motor U5 400 kV with KDE 155x53 folding.
tyto-gk34 | tyto-t-motor-u5-kv400 | T-Motor U5 KV400 |  |  |  | 21.7556 | 22.7328 | 7690 | 353.473 | 21.7734 | 473.692 | 428.441 | 0.53203 | 24.9709 | 0.971822 | 6 | https://database.tytorobotics.com/tests/gk34/158-foldable-u5 | third_party | S132 | 2026-10-20 | Test title: 158 foldable u5. Title names a different motor than the link: check.
tyto-9zm | tyto-xoar-ta130-25-kv80 | Xoar TA130-25 KV80 | xoar-titan-esc | propeller xoar-pjp-t-l-47x10 |  | 43.2602 | 50.0068 | 2801.5 | 64.3304 | 62.6253 | 2727.25 | 2248.91 | 7.66571 | 124.467 | 0.824607 | 7 | https://database.tytorobotics.com/tests/9zm/ta130-25-kv80-xoar-47x10-ta110-20-kv80-xoar-40x10 | third_party | S132 | 2026-10-20 | Test title: TA130-25 Kv80 Xoar 47x10 TA110-20 Kv80 Xoar 40x10.
tyto-56w | tyto-xoar-ta130-25-kv80 | Xoar TA130-25 KV80 | flier-f-22s-350a-a | propeller xoar-pjp-t-l-40x10 |  | 33.7712 | 47.9822 | 2654 | 73.362 | 71.5195 | 2587.34 | 2091.23 | 7.52441 | 169.721 | 0.808254 | 21 | https://database.tytorobotics.com/tests/56w/test-with-the-xoar-40-propeller | third_party | S132 | 2026-10-20 | Test title: Test with the Xoar 40" propeller.
tyto-3nq | tyto-xoar-ta130-25-kv80 | Xoar TA130-25 KV80 | xoar-pulse-a200 | propeller xoar-pjp-t-l-47x10 |  | 42.8815 | 50.0268 | 2815.75 | 65.1253 | 58.8507 | 2544.46 | 2109.59 | 7.15443 | 109.925 | 0.82909 | 12 | https://database.tytorobotics.com/tests/3nq/coax-xoar-ta130-47x10-and-ta110-40x10 | third_party | S132 | 2026-10-20 | Test title: Coax Xoar TA130 47x10 and TA110 40x10.
tyto-wxk | tyto-xoar-ta130-25-kv80 | Xoar TA130-25 KV80 | xoar-titan-esc | propeller xoar-pjp-t-l-40x10 |  | 44.3189 | 50.0147 | 3015.85 | 67.7991 | 49.1894 | 2188.05 | 1870.63 | 5.9231 | 107.28 | 0.854931 | 12 | https://database.tytorobotics.com/tests/wxk/ta130-25-kv80-xoar40x10-ta110-20-kv80-xoar36x12 | third_party | S132 | 2026-10-20 | Test title: TA130-25 Kv80 Xoar40x10 TA110-20 Kv80 Xoar36x12.
tyto-ywq | tyto-xoar-ta130-25-kv80 | Xoar TA130-25 KV80 | xoar-titan-esc | propeller xoar-pjp-t-l-47x10 |  | 42.9691 | 49.8242 | 2973.99 | 69.2124 | 74.883 | 3217.66 | 2604.46 | 8.36273 | 125.241 | 0.809426 | 12 | https://database.tytorobotics.com/tests/ywq/ta130-25-kv80-xoar47x10-t-motor-u15-kv80-xoar40x10 | third_party | S132 | 2026-10-20 | Test title: TA130-25 Kv80 Xoar47x10 T-motor U15 Kv80 Xoar40x10.
tyto-e7n | tyto-xoar-ta130-25-kv80 | Xoar TA130-25 KV80 | xoar-titan-esc | propeller xoar-pjp-t-l-40x10 |  | 42.3878 | 49.6254 | 2936 | 69.2653 | 81.6724 | 3461.91 | 2799.34 | 9.10481 | 207.315 | 0.808611 | 11 | https://database.tytorobotics.com/tests/e7n/ta130-25-kv80-with-xoar-40x10 | third_party | S132 | 2026-10-20 | Test title: TA130-25 Kv80 with Xoar 40x10.
tyto-jkn | tyto-xoar-ta130-25-kv80 | Xoar TA130-25 KV80 | xoar-titan-esc | propeller xoar-pjp-t-l-47x10 |  | 41.5008 | 50.5229 | 2324 | 55.9989 | 103.841 | 4309.47 | 3464.3 | 14.2348 | 270.816 | 0.803881 | 11 | https://database.tytorobotics.com/tests/jkn/ta130-25-kv80-with-xoar-47x10 | third_party | S132 | 2026-10-20 | Test title: TA130-25 Kv80 with Xoar 47x10.
tyto-439 | tyto-xoar-ta130-25-kv80 | Xoar TA130-25 KV80 | xoar-titan-esc | propeller xoar-pjp-t-l-40x10 |  | 41.8325 | 50.4321 | 2895 | 69.2046 | 81.0352 | 3389.9 | 2738.01 | 9.03145 | 206.016 | 0.807695 | 16 | https://database.tytorobotics.com/tests/439/ta130-25-kv80-with-xoar-40x10 | third_party | S132 | 2026-10-20 | Test title: TA130-25 Kv80 with Xoar 40x10.
tyto-474z | tyto-t-motor-antigravity-mn7005-kv230 | T-Motor Antigravity MN7005 KV230 | t-motor-flame-60a-12s | propeller t-motor-ns28x92 |  | 23.5179 | 24.9897 | 2740 | 116.507 | 33.4862 | 787.525 | 433.532 | 1.51092 | 46.6034 | 0.767291 | 21 | https://database.tytorobotics.com/tests/474z/t-motor-antigravity-7005-230-with-t-motor-ns28x92 | third_party | S132 | 2026-10-20 | Test title: T-Motor Antigravity 7005-230 with T-Motor NS28x92.
tyto-qm7d | tyto-t-motor-antigravity-mn7005-kv230 | T-Motor Antigravity MN7005 KV230 | t-motor-flame-60a-12s | propeller t-motor-p18x61 |  | 24.2974 | 25.0394 | 4807 | 197.84 | 12.9729 | 315.207 | 269.126 | 0.53463 | 24.5013 | 0.853809 | 21 | https://database.tytorobotics.com/tests/qm7d/t-motor-antigravity-7005-kv230-with-t-motor-p18x61 | third_party | S132 | 2026-10-20 | Test title: T-Motor Antigravity 7005 KV230 with T-Motor P18x61.
tyto-d74x | tyto-t-motor-antigravity-mn7005-kv230 | T-Motor Antigravity MN7005 KV230 | t-motor-flame-60a-12s | propeller t-motor-p20x6 |  | 24.2063 | 25.1276 | 4631 | 191.314 | 16.9163 | 409.481 | 351.965 | 0.725764 | 31.3654 | 0.859538 | 21 | https://database.tytorobotics.com/tests/d74x/t-motor-antigravity-7005-230-with-t-motor-p20x6 | third_party | S132 | 2026-10-20 | Test title: T-Motor Antigravity 7005-230 with T-Motor P20x6.
tyto-jxgd | tyto-t-motor-antigravity-mn7005-kv230 | T-Motor Antigravity MN7005 KV230 | t-motor-flame-60a-12s | propeller t-motor-ns22x66 |  | 23.8515 | 25.0719 | 4308 | 180.617 | 23.9347 | 570.88 | 474.486 | 1.05177 | 41.0596 | 0.832329 | 21 | https://database.tytorobotics.com/tests/jxgd/t-motor-antigravity-7005-230-with-t-motor-ns22x66 | third_party | S132 | 2026-10-20 | Test title: T-Motor Antigravity 7005-230 with T-Motor NS22x66.
tyto-ezw7 | tyto-t-motor-antigravity-mn7005-kv230 | T-Motor Antigravity MN7005 KV230 | t-motor-flame-60a-12s | propeller t-motor-ns24x72 |  | 23.7037 | 24.9109 | 3860 | 162.844 | 25.515 | 604.799 | 482.173 | 1.19285 | 44.4387 | 0.821925 | 21 | https://database.tytorobotics.com/tests/ezw7/t-motor-antigravity-7005-230-with-t-motor-ns24x72 | third_party | S132 | 2026-10-20 | Test title: T-Motor Antigravity 7005-230 with T-Motor NS24x72.
tyto-mz97 | tyto-t-motor-antigravity-mn7005-kv230 | T-Motor Antigravity MN7005 KV230 | t-motor-flame-60a-12s | propeller t-motor-ns26x85 |  | 23.5033 | 24.9425 | 3231 | 137.47 | 30.9205 | 726.735 | 488.746 | 1.4445 | 47.4608 | 0.783714 | 21 | https://database.tytorobotics.com/tests/mz97/t-motor-antigravity-7005-230-with-t-motor-ns26x85 | third_party | S132 | 2026-10-20 | Test title: T-Motor Antigravity 7005-230 with T-Motor NS26x85.
tyto-g34 | tyto-t-motor-u15-v2 | T-Motor U15 V2 | flier-airplane-350a | propeller xoar-pjp-t-l-40x10 |  | 44.3075 | 49.7747 | 2577 | 58.1617 | 52.2401 | 2314.63 | 1918.94 | 7.11081 | 160.027 | 0.82905 | 16 | https://database.tytorobotics.com/tests/g34/t-motor-u15-v2-kv80-with-xoar-40x10 | third_party | S132 | 2026-10-20 | Test title: T-motor U15 V2 Kv80 with Xoar 40x10.
tyto-dnq | tyto-t-motor-lf40-2305 | T-Motor LF40 2305 | t-motor-f35a | propeller gemfan-5040-r |  | 12.4019 | 12.8841 | 13363 | 1077.5 | 13.5148 | 167.609 | 93.3767 | 0.0667276 | 4.59789 | 0.597623 | 15 | https://database.tytorobotics.com/tests/dnq/lf40-2305-with-5040-prop | third_party | S132 | 2026-10-20 | Test title: LF40 2305 with 5040 prop.
tyto-krw | tyto-t-motor-lf40-2305 | T-Motor LF40 2305 | t-motor-f35a | propeller t-motor-t6535b |  | 11.7914 | 12.0459 | 13915 | 1180.09 | 7.71693 | 90.9937 | 53.1268 | 0.0364587 | 4.51124 | 0.583851 | 15 | https://database.tytorobotics.com/tests/krw/lf40-2305-2450kv-6535-prop-l-bracket | third_party | S132 | 2026-10-20 | Test title: LF40 2305 2450kv 6535 prop L-bracket.
tyto-zny | tyto-t-motor-lf40-2305 | T-Motor LF40 2305 | t-motor-f35a | propeller t-motor-5143-ultra-light |  | 11.2971 | 11.5288 | 6572 | 581.74 | 10.4809 | 118.404 | 37.9196 | 0.0550982 | 4.06169 | 0.320255 | 16 | https://database.tytorobotics.com/tests/zny/t-motor-lf40-with-t5143-prop | third_party | S132 | 2026-10-20 | Test title: T-motor LF40 with T5143 prop.
tyto-7nk | tyto-t-motor-lf40-2305 | T-Motor LF40 2305 | t-motor-f35a | propeller t-motor-t5150 |  | 11.3435 | 11.5293 | 5568 | 490.854 | 8.44152 | 95.7564 | 29.5328 | 0.0506497 | 3.54112 | 0.308416 | 16 | https://database.tytorobotics.com/tests/7nk/t-motor-lf40-with-t5150-prop | third_party | S132 | 2026-10-20 | Test title: T-motor LF40 with T5150 prop.
tyto-w4x | tyto-t-motor-lf40-2305 | T-Motor LF40 2305 | t-motor-f35a | propeller t-motor-t5150 |  | 11.7819 | 12.0719 | 15066 | 1278.74 | 8.62457 | 101.614 | 56.9017 | 0.036066 | 4.06669 | 0.601794 | 16 | https://database.tytorobotics.com/tests/w4x/t-lf40-2450kv-t-5150r-propeller | third_party | S132 | 2026-10-20 | Test title: T-LF40 2450kv T-5150R propeller.
tyto-eqn | tyto-t-motor-lf40-2305 | T-Motor LF40 2305 | t-motor-f35a | propeller t-motor-t5150 |  | 11.6947 | 11.9777 | 14995 | 1282.2 | 8.8087 | 103.015 | 55.8854 | 0.0355896 | 2.76235 | 0.543466 | 16 | https://database.tytorobotics.com/tests/eqn/t-motor-lf40-5150-prop | third_party | S132 | 2026-10-20 | Test title: T-motor LF40 5150 prop.
tyto-mny | tyto-t-motor-lf40-2305 | T-Motor LF40 2305 | t-motor-f35a | propeller t-motor-5143-ultra-light |  | 11.7328 | 11.9786 | 15677 | 1336.17 | 7.66158 | 89.8916 | 50.2915 | 0.0306339 | 2.39666 | 0.559468 | 16 | https://database.tytorobotics.com/tests/mny/t-motor-lf40-2305-t-5143-prop | third_party | S132 | 2026-10-20 | Test title: T-motor LF40 2305 T-5143 prop.
tyto-4r9 | tyto-t-motor-lf40-2305 | T-Motor LF40 2305 | t-motor-f35a | propeller t-motor-t6535b |  | 11.768 | 12.0127 | 13763 | 1169.53 | 7.57029 | 89.0871 | 51.9567 | 0.0360496 | 4.04678 | 0.583213 | 16 | https://database.tytorobotics.com/tests/4r9/t-motor-lf40-2305-t-6535-prop | third_party | S132 | 2026-10-20 | Test title: T-motor LF40 2305 T-6535 prop.
tyto-w367 | tyto-t-motor-u7 | T Motor U7 | t-motor-alpha-40a-6s | propeller t-motor-p16x54 |  | 23.758 | 24.1845 | 5773 | 242.754 | 12.31 | 292.461 | 243.293 | 0.404188 | 20.0309 | 0.842318 | 19 | https://database.tytorobotics.com/tests/w367/t-motor-u7-280-kv-with-t-motor-16x54 | third_party | S132 | 2026-10-20 | Test title: T-motor U7 280 kV with T-motor 16x54.
tyto-d7g3 | tyto-t-motor-u7 | T Motor U7 | t-motor-alpha-40a-6s | propeller t-motor-p18x61 |  | 23.1381 | 23.6527 | 5699 | 246.304 | 26.0908 | 603.691 | 423.25 | 0.709202 | 32.4276 | 0.721837 | 11 | https://database.tytorobotics.com/tests/d7g3/t-motor-u7-490-kv-with-t-motor-18x61 | third_party | S132 | 2026-10-20 | Test title: T-motor U7 490 kV with T-motor 18x61.
tyto-xjwz | tyto-t-motor-u7 | T Motor U7 |  | propeller apc-16x55mrp |  | 23.3721 | 24.4027 | 7435 | 318.115 | 43.0127 | 1005.3 | 694.646 | 0.892183 | 42.636 | 0.728563 | 14 | https://database.tytorobotics.com/tests/xjwz/t-motor-u7-v2-490-kv-w-apc-16x55 | third_party | S132 | 2026-10-20 | Test title: T-motor U7 V2 490 kv w APC 16x55.
tyto-qmzg | tyto-t-motor-u7 | T Motor U7 | t-motor-alpha-40a-6s | propeller t-motor-p18x61 |  | 23.5001 | 24.1224 | 5418 | 230.333 | 18.2962 | 430.373 | 354.085 | 0.624079 | 28.8743 | 0.829815 | 19 | https://database.tytorobotics.com/tests/qmzg/t-motor-u7-280-kv-with-t-motor-18x61 | third_party | S132 | 2026-10-20 | Test title: T-motor U7 280 kV with T-motor 18x61.
tyto-jxkx | tyto-t-motor-u7 | T Motor U7 | t-motor-alpha-40a-6s | propeller apc-16x55mrp |  | 23.329 | 23.6202 | 5470 | 234.472 | 13.1639 | 307.1 | 252.977 | 0.441637 | 21.3339 | 0.825226 | 17 | https://database.tytorobotics.com/tests/jxkx/t-motor-u7-280-kv-with-apc-16x55 | third_party | S132 | 2026-10-20 | Test title: T-motor U7 280 kV with APC 16x55.
tyto-6yne | tyto-t-motor-u7 | T Motor U7 |  | propeller t-motor-p16x54 |  | 23.4892 | 24.375 | 7771 | 330.833 | 35.4858 | 833.531 | 610.999 | 0.750818 | 38.6352 | 0.754889 | 14 | https://database.tytorobotics.com/tests/6yne/t-motor-u7-v2-490-kv-w-t-motor-16x54 | third_party | S132 | 2026-10-20 | Test title: T-motor U7 V2 490 kv w T-motor 16x54.
tyto-nr6e | tyto-t-motor-u7 | T Motor U7 | t-motor-flame-70a-6s | propeller t-motor-p16x54 |  | 24.2514 | 25.0632 | 7904 | 325.92 | 38.0787 | 923.462 | 701.483 | 0.847503 | 43.1843 | 0.773856 | 14 | https://database.tytorobotics.com/tests/nr6e/t-motor-u7-490kv-w-tmotor-16x54-carbon | third_party | S132 | 2026-10-20 | Test title: T-motor U7 490kv w Tmotor 16x54 carbon.
tyto-g6nq | tyto-t-motor-u7 | T Motor U7 |  | propeller t-motor-p16x54 |  | 23.527 | 24.3099 | 5363 | 227.951 | 19.4931 | 458.616 | 380.642 | 0.677767 | 28.1053 | 0.836866 | 20 | https://database.tytorobotics.com/tests/g6nq/t-motor-u7-280kv-with-dual-t-motor-p16x54 | third_party | S132 | 2026-10-20 | Test title: T-Motor U7 280kV with DUAL T-Motor P16x54.
tyto-7kgm | tyto-t-motor-antigravity-mn6007ii-kv160 | T-Motor Antigravity MN6007II KV160 | t-motor-flame-60a-12s | propeller t-motor-ns24x72 |  | 24.3191 | 25.0566 | 3163 | 130.062 | 13.0346 | 316.989 | 266.923 | 0.805857 | 29.8922 | 0.842057 | 21 | https://database.tytorobotics.com/tests/7kgm/t-motor-antigravity-6007ii-160-x-t-motor-ns24x72 | third_party | S132 | 2026-10-20 | Test title: T-Motor Antigravity 6007II-160 x T-Motor NS24x72.
tyto-zmy3 | tyto-t-motor-antigravity-mn6007ii-kv160 | T-Motor Antigravity MN6007II KV160 | t-motor-flame-60a-12s | propeller t-motor-ns26x85 |  | 24.0374 | 25.0227 | 2856 | 118.815 | 17.9386 | 431.198 | 340.064 | 1.13703 | 37.4175 | 0.81026 | 21 | https://database.tytorobotics.com/tests/zmy3/t-motor-antigravity-6007ii-160-x-t-motor-ns26x85 | third_party | S132 | 2026-10-20 | Test title: T-Motor Antigravity 6007II-160 x T-Motor NS26x85.
tyto-9xrq | tyto-t-motor-antigravity-mn6007ii-kv160 | T-Motor Antigravity MN6007II KV160 | t-motor-flame-60a-12s | propeller t-motor-ns28x92 |  | 23.9521 | 25.1056 | 2632 | 109.886 | 22.0876 | 529.045 | 385.008 | 1.39687 | 42.9834 | 0.786143 | 21 | https://database.tytorobotics.com/tests/9xrq/t-motor-antigravity-6007ii-160-x-t-motor-ns28x92 | third_party | S132 | 2026-10-20 | Test title: T-Motor Antigravity 6007II-160 x T-Motor NS28x92.
tyto-xjxx | tyto-t-motor-antigravity-mn6007ii-kv160 | T-Motor Antigravity MN6007II KV160 | t-motor-flame-60a-12s | propeller xoar-pjp-t-l-26x45 |  | 23.9568 | 25.0319 | 2980 | 124.391 | 15.1013 | 361.779 | 299.446 | 0.959563 | 32.9937 | 0.840305 | 21 | https://database.tytorobotics.com/tests/xjxx/t-motor-antigravity-6007ii-160-x-xoar-pjp-26x45 | third_party | S132 | 2026-10-20 | Test title: T-Motor Antigravity 6007II-160 x Xoar PJP 26x45.
tyto-mzw7 | tyto-t-motor-antigravity-mn6007ii-kv160 | T-Motor Antigravity MN6007II KV160 | t-motor-alpha-40a-6s | propeller t-motor-ns26x85 |  | 24.3605 | 25.0012 | 2895 | 118.718 | 17.9141 | 436.845 | 355.019 | 1.17105 | 38.4743 | 0.841818 | 21 | https://database.tytorobotics.com/tests/mzw7/t-motor-antigravity-6007ii-160-x-t-motor-ns26x85 | third_party | S132 | 2026-10-20 | Test title: T-Motor Antigravity 6007II-160 x T-Motor NS26x85.
tyto-k7qq | tyto-t-motor-antigravity-mn6007ii-kv160 | T-Motor Antigravity MN6007II KV160 | t-motor-flame-60a-12s | propeller t-motor-ns26x85 |  | 32.0184 | 33.3145 | 3128 | 97.6938 | 19.8684 | 636.156 | 481.143 | 1.46885 | 47.4151 | 0.818566 | 21 | https://database.tytorobotics.com/tests/k7qq/t-motor-antigravity-6007ii-160-x-t-motor-p26-8s | third_party | S132 | 2026-10-20 | Test title: T-Motor Antigravity 6007II-160 x T-Motor P26 8S.
tyto-kqq | tyto-rcbenchmark-x-xoar-2407-2300kv | RCbenchmark x Xoar 2407 2300kv | rcbenchmark-x-xoar-f50 | propeller rcbenchmark-x-xoar-8x8 |  | 14.4268 | 14.8866 | 10510 | 728.504 | 20.7432 | 299.258 | 153.98 | 0.139905 | 7.36841 | 0.589277 | 9 | https://database.tytorobotics.com/tests/kqq/rcbenchmark-2407-2300kv-8x8-propeller-v2 | third_party | S132 | 2026-10-20 | Test title: RCbenchmark 2407 2300kv 8x8 propeller v2.
tyto-76n | tyto-rcbenchmark-x-xoar-2407-2300kv | RCbenchmark x Xoar 2407 2300kv | rcbenchmark-x-xoar-f50 | propeller rcbenchmark-x-xoar-9x4 |  | 14.4159 | 14.8671 | 10719 | 743.553 | 20.3602 | 293.512 | 152.628 | 0.135973 | 8.91515 | 0.580502 | 9 | https://database.tytorobotics.com/tests/76n/rcbenchmark-2407-2300kv-9x4-propeller | third_party | S132 | 2026-10-20 | Test title: RCbenchmark 2407 2300kv 9x4 propeller.
tyto-z3g | tyto-rcbenchmark-x-xoar-2407-2300kv | RCbenchmark x Xoar 2407 2300kv | rcbenchmark-x-xoar-f50 | propeller rcbenchmark-x-xoar-8x6 |  | 14.4747 | 14.8658 | 11668 | 806.096 | 17.6328 | 255.23 | 151.772 | 0.124213 | 8.77398 | 0.616768 | 9 | https://database.tytorobotics.com/tests/z3g/rcbenchmark-2407-2300kv-8x6-propeller-v2 | third_party | S132 | 2026-10-20 | Test title: RCbenchmark 2407 2300kv 8x6 propeller v2.
tyto-9j6 | tyto-rcbenchmark-x-xoar-2407-2300kv | RCbenchmark x Xoar 2407 2300kv | rcbenchmark-x-xoar-f50 | propeller rcbenchmark-x-xoar-8x4 |  | 14.5034 | 14.8664 | 12324 | 849.73 | 16.4391 | 238.424 | 144.184 | 0.111722 | 8.82513 | 0.621552 | 9 | https://database.tytorobotics.com/tests/9j6/rcbenchmark-2407-2300kv-8x4-propeller-v2 | third_party | S132 | 2026-10-20 | Test title: RCbenchmark 2407 2300kv 8x4 propeller v2.
tyto-yy7 | tyto-rcbenchmark-x-xoar-2407-2300kv | RCbenchmark x Xoar 2407 2300kv | rcbenchmark-x-xoar-f50 | propeller rcbenchmark-x-xoar-7x4 |  | 14.5926 | 14.8865 | 13517 | 926.292 | 13.5331 | 197.484 | 129.162 | 0.0912484 | 7.26921 | 0.654038 | 9 | https://database.tytorobotics.com/tests/yy7/rcbenchmark-2407-2300kv-7x4-propeller-v2 | third_party | S132 | 2026-10-20 | Test title: RCbenchmark 2407 2300kv 7x4 propeller v2.
tyto-g9g | tyto-rcbenchmark-x-xoar-2407-2300kv | RCbenchmark x Xoar 2407 2300kv | rcbenchmark-x-xoar-f50 | propeller none |  | 14.8037 | 14.8628 | 34379 | 2322.32 | 3.1195 | 46.1803 | 4.41932 | 0.00122754 | 0.00326624 | 0.0956972 | 3 | https://database.tytorobotics.com/tests/g9g/rcbenchmark-2407-2300kv | third_party | S132 | 2026-10-20 | Test title: RCbenchmark 2407 2300kv.
tyto-ry76 | tyto-t-motor-antigravity-mn6007-kv320 | T-Motor Antigravity MN6007 KV320 | t-motor-flame-60a-12s | propeller t-motor-p18x61 |  | 23.823 | 25 | 5714 | 239.852 | 23.376 | 556.888 | 471.734 | 0.788367 | 35.6255 | 0.84709 | 21 | https://database.tytorobotics.com/tests/ry76/t-motor-antigravity-6007-320-x-t-motor-p18x61 | third_party | S132 | 2026-10-20 | Test title: T-Motor Antigravity 6007-320 x T-Motor P18x61.
tyto-y6r6 | tyto-t-motor-antigravity-mn6007-kv320 | T-Motor Antigravity MN6007 KV320 | t-motor-flame-60a-12s | propeller t-motor-p20x6 |  | 23.5447 | 24.937 | 5363 | 227.779 | 29.1278 | 685.805 | 571.811 | 1.01816 | 43.569 | 0.833781 | 21 | https://database.tytorobotics.com/tests/y6r6/t-motor-antigravity-6007-320-x-t-motor-p20x6 | third_party | S132 | 2026-10-20 | Test title: T-Motor Antigravity 6007-320 x T-Motor P20x6.
tyto-kjx7 | tyto-t-motor-antigravity-mn6007-kv320 | T-Motor Antigravity MN6007 KV320 | t-motor-flame-60a-12s | propeller t-motor-ns22x66 |  | 23.1936 | 24.5909 | 4621 | 199.236 | 32.8625 | 762.201 | 598.923 | 1.23767 | 47.6991 | 0.809983 | 21 | https://database.tytorobotics.com/tests/kjx7/t-motor-antigravity-6007-320-x-t-motor-ns22x66 | third_party | S132 | 2026-10-20 | Test title: T-Motor Antigravity 6007-320 x T-Motor NS22x66.
tyto-36zz | tyto-t-motor-antigravity-mn6007-kv320 | T-Motor Antigravity MN6007 KV320 | t-motor-flame-60a-12s | propeller t-motor-ns24x72 |  | 23.7705 | 24.9351 | 3953 | 166.299 | 29.0276 | 690 | 521.496 | 1.25978 | 46.3713 | 0.784691 | 21 | https://database.tytorobotics.com/tests/36zz/t-motor-antigravity-6007-320-x-t-motor-ns24x72 | third_party | S132 | 2026-10-20 | Test title: T-Motor Antigravity 6007-320 x T-Motor NS24x72.
tyto-xjgx | tyto-t-motor-antigravity-mn6007-kv320 | T-Motor Antigravity MN6007 KV320 | t-motor-flame-60a-12s | propeller t-motor-ns26x85 |  | 23.8708 | 25.0429 | 3228 | 135.228 | 29.614 | 706.909 | 489.9 | 1.44926 | 47.3726 | 0.749532 | 21 | https://database.tytorobotics.com/tests/xjgx/t-motor-antigravity-6007-320-x-t-motor-ns26x85 | third_party | S132 | 2026-10-20 | Test title: T-Motor Antigravity 6007-320 x T-Motor NS26x85.
tyto-y636 | tyto-t-motor-antigravity-mn6007-kv320 | T-Motor Antigravity MN6007 KV320 | t-motor-flame-60a-12s | propeller xoar-pjp-t-l-26x45 |  | 22.9099 | 24.8879 | 3481 | 151.943 | 28.6054 | 655.347 | 484.955 | 1.33036 | 46.6574 | 0.7753 | 21 | https://database.tytorobotics.com/tests/y636/t-motor-antigravity-6007-320-x-xoar-pjp-t-l-26x45 | third_party | S132 | 2026-10-20 | Test title: T-Motor Antigravity 6007-320 x Xoar PJP-T-L 26x45.
tyto-nnd | tyto-rcbenchmark-x-xoar-2407-1500kv | RCbenchmark x Xoar 2407 1500kv | rcbenchmark-x-xoar-f50 | propeller none |  | 14.8314 | 14.8571 | 21655 | 1460.07 | 1.77299 | 26.296 | 1.11421 | 0.000491337 |  | 0.0423718 | 3 | https://database.tytorobotics.com/tests/nnd/rcbenchmark-2407-1500kv | third_party | S132 | 2026-10-20 | Test title: RCbenchmark 2407 1500kv.
tyto-3433 | tyto-rcbenchmark-x-xoar-2407-1500kv | RCbenchmark x Xoar 2407 1500kv | rcbenchmark-x-xoar-f50 | propeller rcbenchmark-x-xoar-7x4 |  | 14.7823 | 14.8863 | 9770 | 660.925 | 5.0179 | 74.1761 | 49.6121 | 0.0484913 | 3.59937 | 0.668842 | 10 | https://database.tytorobotics.com/tests/3433/rcbenchmark-2407-1500kv-7x4-propeller-v2 | third_party | S132 | 2026-10-20 | Test title: RCbenchmark 2407 1500kv 7x4 propeller v2.
tyto-wk9n | tyto-rcbenchmark-x-xoar-2407-1500kv | RCbenchmark x Xoar 2407 1500kv | rcbenchmark-x-xoar-f50 | propeller rcbenchmark-x-xoar-8x8 |  | 14.7096 | 14.8832 | 8600 | 584.652 | 8.20118 | 120.636 | 84.7394 | 0.0940933 | 4.92529 | 0.702438 | 9 | https://database.tytorobotics.com/tests/wk9n/rcbenchmark-2407-1500kv-8x8-propeller-v2 | third_party | S132 | 2026-10-20 | Test title: RCbenchmark 2407 1500kv 8x8 propeller v2.
tyto-q3gr | tyto-rcbenchmark-x-xoar-2407-1500kv | RCbenchmark x Xoar 2407 1500kv | rcbenchmark-x-xoar-f50 | propeller rcbenchmark-x-xoar-9x4 |  | 14.7146 | 14.8849 | 8653 | 588.056 | 8.01513 | 117.939 | 80.4028 | 0.088731 | 5.10246 | 0.681729 | 9 | https://database.tytorobotics.com/tests/q3gr/rcbenchmark-2407-1500kv-9x4-propeller-v2 | third_party | S132 | 2026-10-20 | Test title: RCbenchmark 2407 1500kv 9x4 propeller v2.
tyto-j3me | tyto-rcbenchmark-x-xoar-2407-1500kv | RCbenchmark x Xoar 2407 1500kv | rcbenchmark-x-xoar-f50 | propeller rcbenchmark-x-xoar-8x4 |  | 14.7563 | 14.8862 | 9305 | 630.576 | 6.18558 | 91.2766 | 63.0109 | 0.0646652 | 4.88184 | 0.690329 | 10 | https://database.tytorobotics.com/tests/j3me/rcbenchmark-2407-1500kv-8x4-propeller-v2 | third_party | S132 | 2026-10-20 | Test title: RCbenchmark 2407 1500kv 8x4 propeller v2.
tyto-ex93 | tyto-rcbenchmark-x-xoar-2407-1500kv | RCbenchmark x Xoar 2407 1500kv | rcbenchmark-x-xoar-f50 | propeller rcbenchmark-x-xoar-8x6 |  | 14.7426 | 14.8858 | 9121 | 618.682 | 6.80372 | 100.305 | 69.9822 | 0.0732684 | 5.05819 | 0.697696 | 10 | https://database.tytorobotics.com/tests/ex93/rcbenchmark-2407-1500kv-8x6-propeller-v2 | third_party | S132 | 2026-10-20 | Test title: RCbenchmark 2407 1500kv 8x6 propeller v2.
tyto-g4rg | tyto-t-motor-u15xxl-kv29 | T-Motor U15XXL Kv29 | t-motor-flame-280a-hv | propeller t-motor-62x24-cf |  | 96.8429 | 98.4554 | 1953 | 20.1667 | 141.132 | 13667.6 | 12107.5 | 59.2003 | 751.608 | 0.888516 | 15 | https://database.tytorobotics.com/tests/g4rg/u15xxl-with-62-prop | third_party | S132 | 2026-10-20 | Test title: U15XXL with 62" prop.
tyto-n9qd | tyto-t-motor-u15xxl-kv29 | T-Motor U15XXL Kv29 | t-motor-flame-280a-hv | propeller t-motor-62x24-cf |  | 95.3402 | 96.0656 | 1577 | 16.5408 | 74.3197 | 7085.66 | 6115.06 | 37.0289 | 468.713 | 0.86302 | 23 | https://database.tytorobotics.com/tests/n9qd/u15xxl-and-62prop-from-t-motor | third_party | S132 | 2026-10-20 | Test title: U15XXL and 62"Prop from T-motor.
tyto-qm36 | tyto-t-motor-antigravity-mn4004-300kv | T-Motor Antigravity MN4004 300kV | t-motor-f45a | propeller t-motor-p15x5 |  | 23.7988 | 23.906 | 4286 | 180.093 | 4.54179 | 108.089 | 79.0724 | 0.176175 | 9.25953 | 0.75694 | 9 | https://database.tytorobotics.com/tests/qm36/15inch-pusher-test1 | third_party | S132 | 2026-10-20 | Test title: 15Inch Pusher Test1.
tyto-kj63 | tyto-t-motor-antigravity-mn4004-300kv | T-Motor Antigravity MN4004 300kV | t-motor-f45a | propeller apc-14x55mr |  | 23.7091 | 23.8694 | 5020 | 211.733 | 6.72625 | 159.473 | 114.697 | 0.218182 | 11.7507 | 0.76134 | 11 | https://database.tytorobotics.com/tests/kj63/14inch-pusher-test-2 | third_party | S132 | 2026-10-20 | Test title: 14Inch Pusher Test 2.
tyto-exw3 | tyto-t-motor-antigravity-mn4004-300kv | T-Motor Antigravity MN4004 300kV | t-motor-f45a |  |  | 23.7891 | 23.9017 | 5071 | 213.165 | 6.75158 | 160.614 | 117.643 | 0.221536 | 11.3589 | 0.779299 | 7 | https://database.tytorobotics.com/tests/exw3/14inch-prop-test-1 | third_party | S132 | 2026-10-20 | Test title: 14inch Prop Test 1.
tyto-364m | tyto-t-motor-antigravity-mn4004-300kv | T-Motor Antigravity MN4004 300kV | t-motor-f45a | propeller apc-14x55mr |  | 23.7141 | 23.8758 | 5018 | 211.604 | 6.75233 | 160.126 | 116.373 | 0.221459 | 11.7511 | 0.771562 | 11 | https://database.tytorobotics.com/tests/364m/14inch-pusher-test-3 | third_party | S132 | 2026-10-20 | Test title: 14Inch Pusher Test 3.
tyto-xj3y | tyto-t-motor-antigravity-mn4004-300kv | T-Motor Antigravity MN4004 300kV | t-motor-f45a | propeller apc-16x55mrp |  | 23.6773 | 23.8855 | 4307 | 181.905 | 8.75247 | 207.234 | 124.027 | 0.274988 | 13.6785 | 0.811822 | 10 | https://database.tytorobotics.com/tests/xj3y/16inch-pusher-test1 | third_party | S132 | 2026-10-20 | Test title: 16Inch Pusher Test1.
tyto-6y9k | tyto-t-motor-antigravity-mn4004-300kv | T-Motor Antigravity MN4004 300kV | t-motor-f45a | propeller apc-16x55mrp |  | 23.7969 | 23.8944 | 4447 | 186.873 | 4.10418 | 97.667 | 84.7169 | 0.181918 | 8.99369 | 0.867406 | 8 | https://database.tytorobotics.com/tests/6y9k/16inch-pusher-test-2 | third_party | S132 | 2026-10-20 | Test title: 16Inch Pusher Test 2.
tyto-w3kg | tyto-t-motor-antigravity-mn4004-300kv | T-Motor Antigravity MN4004 300kV | t-motor-f45a | propeller apc-16x55mrp |  | 23.7525 | 23.898 | 4202 | 176.547 | 6.01993 | 142.989 | 94.83 | 0.22914 | 11.38 | 0.82432 | 9 | https://database.tytorobotics.com/tests/w3kg/16inch-pusher-test-3 | third_party | S132 | 2026-10-20 | Test title: 16Inch Pusher Test 3.
tyto-d73e | tyto-t-motor-antigravity-mn4004-300kv | T-Motor Antigravity MN4004 300kV | t-motor-f45a | propeller t-motor-p15x5 |  | 23.76 | 23.9084 | 4734 | 199.243 | 6.30718 | 149.858 | 107.874 | 0.217601 | 11.357 | 0.766713 | 10 | https://database.tytorobotics.com/tests/d73e/15inch-pusher-test2 | third_party | S132 | 2026-10-20 | Test title: 15Inch Pusher Test2.
tyto-j3qz | tyto-emax-emax-1104-5250kv-babyhawk | EMAX Emax 1104 5250KV Babyhawk |  | propeller emax-avan-babyhawk-2dot3inch-3blade |  | 7.57568 | 7.68832 | 22175 | 2927.13 | 3.00452 | 22.7613 |  |  | 0.682328 |  | 6 | https://database.tytorobotics.com/tests/j3qz/emax-emax-1104-5250kv-babyhawk | third_party | S132 | 2026-10-20 | Test title: EMAX Emax 1104 5250KV Babyhawk.
tyto-x3nm | tyto-five33-headsup-2207-1980kv | Five33 Headsup 2207 1980kv |  | propeller azure-power-vanoverprop |  | 24.2138 | 24.8948 | 25001 | 1032.51 | 22.1856 | 537.197 | 374.015 | 0.142858 | 12.5473 | 0.699898 | 8 | https://database.tytorobotics.com/tests/x3nm/five33-2207-azure-vanover | third_party | S132 | 2026-10-20 | Test title: Five33 2207 Azure Vanover.
tyto-yx4g | tyto-five33-headsup-2207-1980kv | Five33 Headsup 2207 1980kv |  | propeller azure-power-vanoverprop |  | 22.8402 | 23.0124 | 17940 | 785.458 | 17.0936 | 390.42 | 100.331 | 0.0534054 | 4.29784 | 0.256983 | 8 | https://database.tytorobotics.com/tests/yx4g/five33-2207-azure-vanover | third_party | S132 | 2026-10-20 | Test title: Five33 2207 Azure Vanover.
tyto-r6dx | tyto-five33-headsup-2207-1980kv | Five33 Headsup 2207 1980kv |  | propeller azure-power-vanoverprop |  | 22.8477 | 23.0147 | 17919 | 784.28 | 5.3504 | 122.244 | 98.8451 | 0.052676 | 4.29583 | 0.812921 | 8 | https://database.tytorobotics.com/tests/r6dx/five33-2207-azure-vanover | third_party | S132 | 2026-10-20 | Test title: Five33 2207 Azure Vanover.
tyto-d7r3 | tyto-sunnysky-v4006-320kv | SunnySky V4006 320KV | zubax-myxa-a2 | propeller sunnysky-eolo-15x5 |  | 16.3512 | 16.4574 | 2644 | 161.701 | 1.71736 | 28.0809 | 21.7545 | 0.0785704 | 3.93288 | 0.774708 | 12 | https://database.tytorobotics.com/tests/d7r3/sunnysky-v4006-with-15x5-eolo-prop | third_party | S132 | 2026-10-20 | Test title: SunnySky V4006 with 15x5 EOLO prop.
tyto-jxwx | tyto-sunnysky-v4006-320kv | SunnySky V4006 320KV | zubax-myxa-a2 |  |  | 16.5401 | 16.7734 | 2452 | 148.246 | 3.22299 | 53.3085 | 42.8852 | 0.167016 | 6.66524 | 0.808138 | 12 | https://database.tytorobotics.com/tests/jxwx/sunnysky-v4006-with-18x9-aeronaut-prop | third_party | S132 | 2026-10-20 | Test title: SunnySky V4006 with 18x9 Aeronaut prop.
tyto-mz7q | tyto-sunnysky-v4006-320kv | SunnySky V4006 320KV | t-motor-f45a |  |  | 16.23 | 16.4326 | 2330 | 143.562 | 2.92505 | 47.4735 | 35.6321 | 0.146035 | 5.80605 | 0.753457 | 11 | https://database.tytorobotics.com/tests/mz7q/sunnysky-v4006-with-aeronaut-19x8 | third_party | S132 | 2026-10-20 | Test title: SunnySky V4006 with Aeronaut 19x8.
tyto-nrze | tyto-sunnysky-v4006-320kv | SunnySky V4006 320KV | zubax-myxa-a2 |  |  | 16.5805 | 16.7255 | 2343 | 141.311 | 2.30821 | 38.2712 | 31.2903 | 0.127529 | 4.10909 | 0.817595 | 11 | https://database.tytorobotics.com/tests/nrze/sunnysky-v4006-with-aeronaut-16x10 | third_party | S132 | 2026-10-20 | Test title: SunnySky V4006 with Aeronaut 16x10.
tyto-36m9 | tyto-sunnysky-v4006-320kv | SunnySky V4006 320KV | zubax-myxa-a2 | propeller aeronaut-cam-carbon-folding-15x8 |  | 15.903 | 16.3857 | 3805 | 239.264 | 5.45868 | 86.8091 | 72.025 | 0.181369 | 8.074 | 0.843816 | 20 | https://database.tytorobotics.com/tests/36m9/sunnysky-v4006-aeronaut-15x8-full-throttle-range | third_party | S132 | 2026-10-20 | Test title: SunnySky V4006 Aeronaut 15x8 full throttle range.
tyto-ezdw | tyto-sunnysky-v4006-320kv | SunnySky V4006 320KV | t-motor-f45a | propeller aeronaut-cam-carbon-folding-15x8 |  | 15.6396 | 16.3411 | 3787 | 242.142 | 6.10164 | 95.427 | 75.9543 | 0.191526 | 8.2771 | 0.796731 | 19 | https://database.tytorobotics.com/tests/ezdw/sunnysky-v4006-15x8-f45a-esc | third_party | S132 | 2026-10-20 | Test title: SunnySky V4006 15x8 F45A ESC.
tyto-kjgy | tyto-kde-direct-kde3510xf-475 | KDE Direct KDE3510XF-475 | t-motor-alpha-40a-6s | propeller kde-direct-kde-cf155-dp |  | 22.4336 | 22.9839 | 6440 | 287.069 | 22.3507 | 501.407 | 319.453 | 0.473687 | 23.0342 | 0.703783 | 15 | https://database.tytorobotics.com/tests/kjgy/kde-3510xf-475kv-with-kde-155x53-folding | third_party | S132 | 2026-10-20 | Test title: KDE 3510XF-475kV with KDE 155x53 folding.
tyto-4766 | tyto-iris-880kv | Iris 880KV |  | propeller holybro-holybro-10x45 |  | 14.5642 | 14.7603 | 7787 | 534.669 | 5.44835 | 79.3507 | 60.6648 | 0.074394 | 4.81159 | 0.764516 | 8 | https://database.tytorobotics.com/tests/4766/holybro-10x45 | third_party | S132 | 2026-10-20 | Test title: Holybro 10x45. Title names a different motor than the link: check.
tyto-nr3k | tyto-iris-880kv | Iris 880KV |  | propeller master-airscrew-mr-10x45 |  | 13.8701 | 14.0715 | 7018 | 505.98 | 6.07057 | 84.1996 | 62.831 | 0.0854933 | 5.16762 | 0.746215 | 8 | https://database.tytorobotics.com/tests/nr3k/master-airscrew-10x47 | third_party | S132 | 2026-10-20 | Test title: Master Airscrew 10x47. Title names a different motor than the link: check.
tyto-gyn9 | tyto-iris-880kv | Iris 880KV |  | propeller e-flite-eflp105084bl |  | 13.8463 | 14.1714 | 5023 | 362.769 | 10.7441 | 148.765 | 87.8533 | 0.167019 | 6.43598 | 0.603521 | 8 | https://database.tytorobotics.com/tests/gyn9/e-flite-4-blader-105x8 | third_party | S132 | 2026-10-20 | Test title: E Flite 4 Blader 105x8. Title names a different motor than the link: check.
tyto-7kmr | tyto-iris-880kv | Iris 880KV |  |  |  | 13.9186 | 14.1562 | 6332 | 454.929 | 7.59701 | 105.74 | 77.0601 | 0.116214 | 4.91818 | 0.728769 | 8 | https://database.tytorobotics.com/tests/7kmr/master-airscrew-10x7-three-blader | third_party | S132 | 2026-10-20 | Test title: Master Airscrew 10x7 Three Blader. Title names a different motor than the link: check.
tyto-jxzw | tyto-iris-880kv | Iris 880KV |  | propeller apc-8x4 |  | 13.9605 | 14.1146 | 9294 | 665.734 | 3.82291 | 53.3698 | 42.6249 | 0.0437958 | 2.99591 | 0.79867 | 8 | https://database.tytorobotics.com/tests/jxzw/apc-8x4-with-iris-motor | third_party | S132 | 2026-10-20 | Test title: APC 8x4 with Iris Motor.
tyto-ezjd | tyto-iris-880kv | Iris 880KV |  | propeller e-flite-cropped-eflp105084bl |  | 13.841 | 14.137 | 5153 | 372.3 | 10.3807 | 143.679 | 87.4345 | 0.16203 | 6.05076 | 0.631028 | 8 | https://database.tytorobotics.com/tests/ezjd/cropped-4-bladed-10x8 | third_party | S132 | 2026-10-20 | Test title: Cropped 4 Bladed 10x8. Title names a different motor than the link: check.
tyto-d4xq | tyto-t-motor-mn3510-360kv | T-Motor MN3510 360Kv | hobbywing-xrotor-40a | propeller t-motor-mf1302 |  | 22.6562 | 22.7041 | 3079 | 135.901 | 1.61778 | 36.6528 | 22.8861 | 0.0709795 | 4.17361 | 0.624401 | 2 | https://database.tytorobotics.com/tests/d4xq/t-motor-mn3510-360kv-used | third_party | S132 | 2026-10-20 | Test title: T-Motor MN3510 360Kv used.
tyto-wnjx | tyto-t-motor-mn3510-360kv | T-Motor MN3510 360Kv | hobbywing-xrotor-40a | propeller t-motor-mf1302 |  | 22.4273 | 22.7227 | 68666 | 3028.22 | 8.71384 | 195.428 | 801.045 | 0.217768 | 14.2037 |  | 6 | https://database.tytorobotics.com/tests/wnjx/new-motor-test-mn3510-360-kv | third_party | S132 | 2026-10-20 | Test title: New Motor test MN3510 360 kv.
tyto-q7ey | tyto-t-motor-mn3510-360kv | T-Motor MN3510 360Kv | hobbywing-xrotor-40a | propeller t-motor-mf1302 |  | 22.4154 | 22.7111 | 66905 | 2952.26 | 8.79374 | 197.115 | 1007.77 | 0.221575 | 14.4548 |  | 6 | https://database.tytorobotics.com/tests/q7ey/new-t-motor-mn3510-360kv-test-2 | third_party | S132 | 2026-10-20 | Test title: New T-Motor MN3510 360kv test 2.
tyto-jgyn | tyto-t-motor-mn3510-360kv | T-Motor MN3510 360Kv | hobbywing-xrotor-40a | propeller t-motor-mf1302 |  | 22.4165 | 22.6829 | 3494 | 154.36 | 8.40436 | 188.397 | 25.7226 | 0.215952 | 13.6724 | 0.707226 | 3 | https://database.tytorobotics.com/tests/jgyn/t-motor-mn3510-360kv-test-old | third_party | S132 | 2026-10-20 | Test title: T-Motor MN3510 360KV test old.
tyto-rzrm | tyto-neumotor-3819 | NeuMotor 3819 |  | propeller t-motor-p16x54 |  | 23.3838 | 24.4434 | 7627 | 325.518 | 33.531 | 787.683 | 614.704 | 0.773487 | 38.7057 | 0.791308 | 21 | https://database.tytorobotics.com/tests/rzrm/neumotor-3819-t-motor-16x54-6s | third_party | S132 | 2026-10-20 | Test title: NeuMotor 3819 T-Motor 16x54 6S.
tyto-ew7n | tyto-t-motor-mn4014 | T-Motor MN4014 | castle-creations-dmr3040 | propeller apc-12x45mr |  | 24.9275 | 25.1365 | 7016 | 281.456 | 7.634 | 190.297 | 144.867 | 0.197175 | 11.5608 | 0.761269 | 36 | https://database.tytorobotics.com/tests/ew7n/apc-12x45mr-tm-4014-dmr-3040 | third_party | S132 | 2026-10-20 | Test title: APC-12X45MR TM-4014 DMR-3040.
tyto-jgkn | tyto-t-motor-mn4014 | T-Motor MN4014 | castle-creations-dmr3040 | propeller gemfan-12x45 |  | 24.9563 | 25.1695 | 7001 | 280.531 | 8.02458 | 200.264 | 148.479 | 0.202524 | 11.2032 | 0.74142 | 36 | https://database.tytorobotics.com/tests/jgkn/gemfan-12x45-tm-4014-dmr-3040 | third_party | S132 | 2026-10-20 | Test title: Gemfan-12x45 TM-4014 DMR-3040.
tyto-m96y | tyto-t-motor-mn4014 | T-Motor MN4014 | castle-creations-dmr3040 | propeller dji-1045 |  | 24.9768 | 25.1028 | 7461 | 298.717 | 4.4905 | 112.158 | 82.7998 | 0.105975 | 6.04121 | 0.738239 | 36 | https://database.tytorobotics.com/tests/m96y/dji-1045-tm-4014-dmr-3040 | third_party | S132 | 2026-10-20 | Test title: DJI-1045 TM-4014 DMR-3040.
tyto-nmzq | tyto-t-motor-mn4014 | T-Motor MN4014 | castle-creations-dmr3040 | propeller apc-10x38sfp |  | 24.8593 | 25.013 | 7235 | 291.038 | 5.71329 | 142.028 | 112.091 | 0.147946 | 7.53903 | 0.789217 | 36 | https://database.tytorobotics.com/tests/nmzq/apc-10x38sfp-tm-4014-dmr-3040 | third_party | S132 | 2026-10-20 | Test title: APC-10x38SFP TM-4014 DMR-3040.
tyto-4439 | tyto-t-motor-mn4014 | T-Motor MN4014 | castle-creations-dmr3040 | propeller apc-12x6e |  | 24.8208 | 25.0502 | 6549 | 263.833 | 8.31556 | 206.413 | 164.279 | 0.23954 | 11.4471 | 0.803363 | 36 | https://database.tytorobotics.com/tests/4439/apc-12x6e-tm-4014-dmr-3040 | third_party | S132 | 2026-10-20 | Test title: APC-12x6E TM-4014 DMR-3040.
tyto-6xry | tyto-t-motor-mn4014 | T-Motor MN4014 | castle-creations-dmr3040 | propeller t-motor-mf1302 |  | 22.7239 | 23.1246 | 6614 | 291.059 | 9.18188 | 208.648 | 168.241 | 0.242907 | 13.8976 | 0.808905 | 38 | https://database.tytorobotics.com/tests/6xry/tm-mf1302-tm-4014-dmr-3040 | third_party | S132 | 2026-10-20 | Test title: TM-MF1302 TM-4014 DMR-3040.
tyto-6q9y | tyto-t-motor-mn4014 | T-Motor MN4014 | t-motor-f35a | propeller hq-prop-multi-rotor-prop-1045 |  | 15.9611 | 16.7779 | 5527 | 340.906 | 5.24137 | 84.0156 | 36.6254 | 0.0632797 | 3.71908 | 0.622727 | 11 | https://database.tytorobotics.com/tests/6q9y/tmotor-mn4014-with-10in-propeller-and-4s-bat | third_party | S132 | 2026-10-20 | Test title: Tmotor MN4014 with 10in propeller and 4S bat.
tyto-qw3r | tyto-t-motor-mn4014 | T-Motor MN4014 | t-motor-air-40a | propeller hq-prop-multi-rotor-prop-1045 |  | 22.1966 | 23.4015 | 7256 | 326.897 | 5.48501 | 121.749 | 79.3871 | 0.104478 | 6.38598 | 0.652058 | 11 | https://database.tytorobotics.com/tests/qw3r/tmotor-mn4014-with-10in-propeller-and-6s-bat | third_party | S132 | 2026-10-20 | Test title: Tmotor MN4014 with 10in propeller and 6S bat.
tyto-ym47 | tyto-t-motor-mn4006 | T-Motor MN4006 | castle-creations-dmr3040 | propeller t-motor-mf1302 |  | 24.307 | 24.6264 | 6751 | 277.739 | 9.6192 | 233.813 | 186.688 | 0.264071 | 15.0584 | 0.799916 | 38 | https://database.tytorobotics.com/tests/ym47/tm-mf1302-tm-mn4006-dmr-3040 | third_party | S132 | 2026-10-20 | Test title: TM-MF1302 TM-MN4006 DMR-3040.
tyto-rznq | tyto-t-motor-mn4006 | T-Motor MN4006 | castle-creations-dmr3040 | propeller t-motor-mf1302 |  | 24.3635 | 24.6661 | 6843 | 280.871 | 9.19003 | 223.901 | 181 | 0.252582 | 15.1627 | 0.808906 | 38 | https://database.tytorobotics.com/tests/rznq/tm-mf1302-tm-mn4006-dmr-3040-inverted | third_party | S132 | 2026-10-20 | Test title: TM-MF1302 TM-MN4006 DMR-3040 Inverted.
tyto-6xqy | tyto-t-motor-mn4006 | T-Motor MN4006 | castle-creations-dmr3040 | propeller t-motor-mf1302 |  | 24.8736 | 25.16 | 6938 | 278.931 | 9.51832 | 236.754 | 188.487 | 0.259429 | 15.7505 | 0.815161 | 38 | https://database.tytorobotics.com/tests/6xqy/tm-mf1302-tm-mn4006-dmr-3040-inv-2 | third_party | S132 | 2026-10-20 | Test title: TM-MF1302 TM-MN4006 DMR-3040 Inv 2.
tyto-rgjm | tyto-t-motor-mn4006 | T-Motor MN4006 | u40 | propeller t-motor-p15x5 |  | 23.6524 | 24.6187 | 5329 | 225.305 | 8.12172 | 192.098 | 139.578 | 0.250116 | 13.8202 | 0.751174 | 15 | https://database.tytorobotics.com/tests/rgjm/reftmotor4006155prop24vt1 | third_party | S132 | 2026-10-20 | Test title: RefTmotor4006155prop24Vt1.
tyto-yj46 | tyto-t-motor-mn4006 | T-Motor MN4006 | t-motor-f45a | propeller t-motor-p-15x8 |  | 24.2267 | 25.1999 | 5362 | 214.997 | 19.6467 | 475.975 | 246.308 | 0.469288 | 17.3406 |  | 18 | https://database.tytorobotics.com/tests/yj46/tmotor-mn4006-380kv-cust-15x12 | third_party | S132 | 2026-10-20 | Test title: Tmotor MN4006 380KV Cust 15x12.
tyto-kdn7 | tyto-t-motor-mn4006 | T-Motor MN4006 | t-motor-f45a | propeller t-motor-p-15x8 |  | 19.7528 | 20.5001 | 4531 | 229.386 | 15.0895 | 298.06 | 184.122 | 0.388046 | 14.3576 | 0.901106 | 18 | https://database.tytorobotics.com/tests/kdn7/tmotor-mn4006-380kv-cust-15x12 | third_party | S132 | 2026-10-20 | Test title: Tmotor MN4006 380KV Cust 15x12.
tyto-k7nq | tyto-t-motor-mn2806 | T-Motor MN2806 | castle-creations-dmr3040 | propeller t-motor-mf1302 |  | 15.1034 | 15.501 | 5809 | 384.614 | 12.4195 | 187.577 | 108.945 | 0.179092 | 10.9153 | 0.688098 | 38 | https://database.tytorobotics.com/tests/k7nq/tm-mf1302-tm-mn2806-dmr-3040-inv | third_party | S132 | 2026-10-20 | Test title: TM-MF1302 TM-MN2806 DMR-3040 Inv.
tyto-3yx3 | tyto-t-motor-mn2806 | T-Motor MN2806 | castle-creations-dmr3040 | propeller t-motor-mf1302 |  | 15.0828 | 15.4224 | 5792 | 384.014 | 12.3711 | 186.59 | 111.955 | 0.184581 | 10.9683 | 0.771433 | 38 | https://database.tytorobotics.com/tests/3yx3/tm-mf1302-tm-mn2806-dmr-3040-inv-2 | third_party | S132 | 2026-10-20 | Test title: TM-MF1302 TM-MN2806 DMR-3040 Inv 2.
tyto-xmz3 | tyto-t-motor-mn2806 | T-Motor MN2806 | castle-creations-dmr3040 | propeller t-motor-mf1302 |  | 16.404 | 16.7375 | 6057 | 369.24 | 13.5467 | 222.219 | 125.94 | 0.198554 | 11.9951 | 0.725425 | 38 | https://database.tytorobotics.com/tests/xmz3/tm-mf1302-tm-mn2806-dmr-3040-inv-3 | third_party | S132 | 2026-10-20 | Test title: TM-MF1302 TM-MN2806 DMR-3040 Inv 3.
tyto-wz9n | tyto-t-motor-mn3510-630kv | T-Motor MN3510 630KV | t-motor-air-20a | propeller generic-10x45 |  | 13.6532 | 14.3937 | 7466 | 544.38 | 8.2673 | 113.384 | 91.2904 | 0.116764 | 7.31953 | 0.805147 | 19 | https://database.tytorobotics.com/tests/wz9n/artemis-mn3510-630kv-10x45 | third_party | S132 | 2026-10-20 | Test title: Artemis - MN3510 630KV - 10x45.
tyto-7zrz | tyto-t-motor-mn3510-630kv | T-Motor MN3510 630KV | t-motor-air-20a | propeller t-motor-12x4-carbon |  | 15.9133 | 16.5397 | 7932 | 496.813 | 14.8817 | 237.598 | 186.941 | 0.225058 | 13.8329 | 0.786798 | 41 | https://database.tytorobotics.com/tests/7zrz/artemis-mn3510-630kv-12x4-carbon | third_party | S132 | 2026-10-20 | Test title: Artemis - MN3510 630KV - 12x4 Carbon.
tyto-z7kx | tyto-t-motor-mn3510-630kv | T-Motor MN3510 630KV | t-motor-air-20a | propeller generic-10x45 |  | 15.9234 | 16.3467 | 8451 | 529.959 | 10.5607 | 168.407 | 134.705 | 0.152211 | 9.55858 | 0.80133 | 41 | https://database.tytorobotics.com/tests/z7kx/artemis-mn3510-630kv-10x45-v2 | third_party | S132 | 2026-10-20 | Test title: Artemis - MN3510 630KV - 10x45 V2.
tyto-9rq9 | tyto-t-motor-u3-700kv | T-Motor U3 700KV | t-motor-air-20a | propeller t-motor-12x4-carbon |  | 15.6721 | 16.509 | 8575 | 545.198 | 20.1121 | 316.328 | 236.612 | 0.263496 | 16.3074 | 0.749888 | 41 | https://database.tytorobotics.com/tests/9rq9/artemis-u3-700kv-12x4-carbon | third_party | S132 | 2026-10-20 | Test title: Artemis - U3 700KV - 12x4 Carbon.
tyto-kx6k | tyto-t-motor-mn4012 | T-Motor MN4012 | t-motor-at-55a-6s | propeller apc-12x12e |  | 23.86 | 25.0561 | 7943 | 330.809 | 32.0981 | 768.876 | 534.716 | 0.648895 | 18.1273 | 0.699204 | 18 | https://database.tytorobotics.com/tests/kx6k/t-motor-mn4012-480-kv-with-apc-12x12 | third_party | S132 | 2026-10-20 | Test title: T-motor MN4012 480 kV with APC 12x12.
tyto-67kk | tyto-rctimer-5010-530kv | RCTimer 5010-530KV |  |  |  |  |  | 1678 |  | 0.0263482 |  | 3.7093 | 0.0211092 | 0.934845 |  | 5 | https://database.tytorobotics.com/tests/67kk/hover-test-1 | third_party | S132 | 2026-10-20 | Test title: Hover Test 1. Title names a different motor than the link: check.
tyto-wz4g | tyto-rctimer-5010-530kv | RCTimer 5010-530KV |  |  |  |  |  | 2800 |  | 0.0272943 |  | 17.455 | 0.0595298 | 2.65791 |  | 9 | https://database.tytorobotics.com/tests/wz4g/hover-test-2 | third_party | S132 | 2026-10-20 | Test title: Hover Test 2. Title names a different motor than the link: check.
tyto-qrn6 | tyto-rctimer-5010-530kv | RCTimer 5010-530KV |  |  |  |  |  | 3063 |  | 0.0273173 |  | 23.28 | 0.0725783 | 3.2596 |  | 10 | https://database.tytorobotics.com/tests/qrn6/hover-test-3 | third_party | S132 | 2026-10-20 | Test title: Hover Test 3. Title names a different motor than the link: check.
tyto-d9we | tyto-rctimer-5010-530kv | RCTimer 5010-530KV |  |  |  |  |  | 2795 |  | 0.0273384 |  | 17.3204 | 0.0591764 | 2.65784 |  | 9 | https://database.tytorobotics.com/tests/d9we/hover-test-4 | third_party | S132 | 2026-10-20 | Test title: Hover Test 4. Title names a different motor than the link: check.
tyto-67qk | tyto-rctimer-5010-530kv | RCTimer 5010-530KV |  |  |  |  |  | 2795 |  |  |  | 19.8387 | 0.0677801 | 3.06966 |  | 4 | https://database.tytorobotics.com/tests/67qk/wt-rpm-150-angle-0-test-2 | third_party | S132 | 2026-10-20 | Test title: WT RPM 150 Angle 0 Test 2. Title names a different motor than the link: check.
tyto-jq9m | tyto-rctimer-5010-530kv | RCTimer 5010-530KV |  |  |  |  |  | 2793 |  | 0.0276543 |  | 17.2986 | 0.059144 | 2.63607 |  | 9 | https://database.tytorobotics.com/tests/jq9m/hover-test-5 | third_party | S132 | 2026-10-20 | Test title: Hover Test 5. Title names a different motor than the link: check.
tyto-ernx | tyto-rctimer-5010-530kv | RCTimer 5010-530KV |  |  |  |  |  | 2788 |  | 0.0273093 |  | 17.4299 | 0.0596997 | 2.67586 |  | 9 | https://database.tytorobotics.com/tests/ernx/hover-test-6 | third_party | S132 | 2026-10-20 | Test title: Hover Test 6. Title names a different motor than the link: check.
tyto-mqkz | tyto-rctimer-5010-530kv | RCTimer 5010-530KV |  |  |  |  |  | 2791 |  | 0.0282738 |  | 17.2205 | 0.0589194 | 2.62552 |  | 9 | https://database.tytorobotics.com/tests/mqkz/hover-test-7 | third_party | S132 | 2026-10-20 | Test title: Hover Test 7. Title names a different motor than the link: check.
tyto-7zd7 | tyto-t-motor-u7-280kv | T-Motor U7 280kV | t-motor-air-40a | propeller t-motor-p16x54 |  | 23.7128 | 24.183 | 5729 | 241.599 | 12.413 | 294.347 | 256.214 | 0.427067 | 21.8582 | 0.870449 | 20 | https://database.tytorobotics.com/tests/7zd7/t-motor-u7-280kv-with-t-motor-p16x54 | third_party | S132 | 2026-10-20 | Test title: T-Motor U7 280kV with T-Motor P16x54.
tyto-z7re | tyto-t-motor-u7-280kv | T-Motor U7 280kV | t-motor-air-40a | propeller t-motor-p16x54 |  | 23.2651 | 24.1206 | 5130 | 220.502 | 23.9355 | 556.861 | 449.809 | 0.837301 | 29.3326 | 0.826658 | 20 | https://database.tytorobotics.com/tests/z7re/t-motor-u7-280kv-with-triple-t-motor-p16x54 | third_party | S132 | 2026-10-20 | Test title: T-Motor U7 280kV with TRIPLE T-Motor P16x54.
tyto-9rez | tyto-t-motor-u7-280kv | T-Motor U7 280kV | t-motor-air-40a | propeller t-motor-mf1806 |  | 23.3666 | 24.0304 | 5339 | 228.489 | 19.0968 | 446.226 | 377.008 | 0.674313 | 31.2469 | 0.84488 | 20 | https://database.tytorobotics.com/tests/9rez/t-motor-u7-280kv-with-t-motor-mf1806 | third_party | S132 | 2026-10-20 | Test title: T-Motor U7 280kV with T-Motor MF1806.
tyto-r7q4 | tyto-t-motor-u7-490kv | T-Motor U7 490kV | t-motor-at-55a-6s | propeller t-motor-p16x54 |  | 22.4085 | 23.8042 | 8204 | 366.11 | 44.9234 | 1006.67 | 773.923 | 0.900831 | 46.288 | 0.779816 | 17 | https://database.tytorobotics.com/tests/r7q4/t-motor-u7-490kv-with-t-motor-p16x54 | third_party | S132 | 2026-10-20 | Test title: T-Motor U7 490kV with T-Motor P16x54.
tyto-yr9j | tyto-t-motor-u7-490kv | T-Motor U7 490kV | t-motor-at-55a-6s | propeller t-motor-p16x54 |  | 22.3602 | 23.4165 | 6346 | 283.808 | 40.3426 | 902.07 | 616.682 | 0.927966 | 39.3422 | 0.726488 | 14 | https://database.tytorobotics.com/tests/yr9j/t-motor-u7-490kv-with-dual-t-motor-p16x54 | third_party | S132 | 2026-10-20 | Test title: T-Motor U7 490kV with DUAL T-Motor P16x54.
tyto-kxr3 | tyto-t-motor-u7-490kv | T-Motor U7 490kV | t-motor-at-55a-6s | propeller t-motor-p16x54 |  | 22.1038 | 23.3846 | 5908 | 267.284 | 48.3325 | 1068.33 | 659.018 | 1.06519 | 40.3163 | 0.714253 | 14 | https://database.tytorobotics.com/tests/kxr3/t-motor-u7-490kv-with-triple-t-motor-p16x54 | third_party | S132 | 2026-10-20 | Test title: T-Motor U7 490kV with TRIPLE T-Motor P16x54.
tyto-4qjq | tyto-t-motor-at2814-900kv | T-Motor AT2814 900KV | zubax-myxa-a2 | propeller graupner-cam-carbon-z-10x5-25x12 |  | 15.7243 | 16.6803 | 13486 | 857.652 | 20.1508 | 316.857 | 303.491 | 0.214899 | 15.2353 | 0.968194 | 20 | https://database.tytorobotics.com/tests/4qjq/t-motor-at2814-kv900-cam-carbon-z-10x5-25x12-test | third_party | S132 | 2026-10-20 | Test title: T-motor AT2814 KV900 Cam-Carbon Z 10X5 25X12 test.
tyto-nyee | tyto-t-motor-at2814-900kv | T-Motor AT2814 900KV | zubax-myxa-a2 | propeller graupner-camcarbon-z-10x6-3-25x16 |  | 15.3437 | 16.6021 | 12436 | 808.321 | 27.0793 | 416.614 | 387.625 | 0.297648 | 17.1678 | 0.951286 | 20 | https://database.tytorobotics.com/tests/nyee/t-motor-at2814-kv900-camcarbon-z-10x6-3-25x16-test | third_party | S132 | 2026-10-20 | Test title: T-motor AT2814 KV900 CamCarbon Z 10X6-3 25X16 test.
tyto-gqew | tyto-t-motor-at2814-900kv | T-Motor AT2814 900KV | zubax-myxa-a2 | propeller graupner-cam-carbon-z-9x5-23x12 |  | 15.7031 | 16.7398 | 13214 | 841.488 | 22.7417 | 357.116 | 338.953 | 0.245321 | 15.9096 | 0.96135 | 20 | https://database.tytorobotics.com/tests/gqew/t-motor-at2814-kv900-cam-carbon-z-9x5-23x12-test | third_party | S132 | 2026-10-20 | Test title: T-motor AT2814 KV900 Cam-Carbon Z 9X5 23X12 test.
tyto-7q74 | tyto-t-motor-at2814-900kv | T-Motor AT2814 900KV | zubax-myxa-a2 | propeller graupner-cam-carbon-z-10x8-25x20 |  | 15.401 | 16.6386 | 9190 | 596.715 | 29.6442 | 456.551 | 376.045 | 0.390747 | 13.4466 | 0.907486 | 20 | https://database.tytorobotics.com/tests/7q74/t-motor-at2814-kv900-cam-carbon-z-10x8-25x20-test | third_party | S132 | 2026-10-20 | Test title: T-motor AT2814 KV900 Cam-Carbon Z 10X8 25X20 test.
tyto-mr97 | tyto-t-motor-at2814-900kv | T-Motor AT2814 900KV | zubax-myxa-a2 | propeller aeronaut-cam-carbon-z-95x6-24x15 |  | 15.5227 | 16.4641 | 12607 | 808.338 | 23.9193 | 371.72 | 343.777 | 0.260397 | 14.7109 | 0.965123 | 20 | https://database.tytorobotics.com/tests/mr97/t-motor-at2814-kv900-cam-carbon-z-95x6-24x15 | third_party | S132 | 2026-10-20 | Test title: T-motor AT2814 KV900 Cam-Carbon Z 95x6 24x15.
tyto-wwy7 | tyto-t-motor-at2814-900kv | T-Motor AT2814 900KV | zubax-myxa-a2 | propeller graupner-cam-folding-prop-10x5-25x12 |  | 16.1437 | 16.775 | 13926 | 861.089 | 22.5398 | 364.526 | 333.841 | 0.22892 | 16.1019 | 0.920268 | 20 | https://database.tytorobotics.com/tests/wwy7/t-motor-at2814-kv900-graupner-10x5 | third_party | S132 | 2026-10-20 | Test title: T-motor AT2814 KV900 Graupner 10x5.
tyto-q4jg | tyto-t-motor-at2814-900kv | T-Motor AT2814 900KV | zubax-myxa-a2 | propeller graupner-cam-folding-prop-10x6-3-25x16 |  | 15.9473 | 16.8149 | 12885 | 806.172 | 31.1991 | 498.654 | 436.439 | 0.323452 | 18.5699 | 0.906317 | 20 | https://database.tytorobotics.com/tests/q4jg/t-motor-at2814-kv900-graupner-10x5 | third_party | S132 | 2026-10-20 | Test title: T-motor AT2814 KV900 Graupner 10x5.
tyto-d6k3 | tyto-t-motor-at2814-900kv | T-Motor AT2814 900KV | zubax-myxa-a2 | propeller graupner-cam-folding-prop-10x6-25x15 |  | 15.8724 | 16.775 | 12539 | 788.09 | 33.1948 | 528.149 | 451.087 | 0.343533 | 19.178 | 0.900454 | 20 | https://database.tytorobotics.com/tests/d6k3/t-motor-at2814-kv900-graupner-10x5 | third_party | S132 | 2026-10-20 | Test title: T-motor AT2814 KV900 Graupner 10x5.
tyto-zxy3 | tyto-hacker-a30-14l-v4-800kv | Hacker A30-14L V4 800KV | zubax-myxa-a2 | propeller aeronaut-cam-carbon-95x7-24x18 |  | 15.2657 | 16.1931 | 11986 | 783.229 | 23.7938 | 364.125 | 344.886 | 0.274772 | 13.708 | 0.96611 | 20 | https://database.tytorobotics.com/tests/zxy3/hacker-a30-14l-kv800-cam-carbon-95x7-24x18 | third_party | S132 | 2026-10-20 | Test title: Hacker A30-14L KV800 Cam-Carbon 95x7 24x18.
tyto-gqkn | tyto-hacker-a30-14l-v4-800kv | Hacker A30-14L V4 800KV | zubax-myxa-a2 | propeller aeronaut-cam-carbon-z-10x8-255x20 |  | 15.4575 | 16.4549 | 9995 | 646.613 | 27.257 | 421.325 | 380.753 | 0.363774 | 12.515 | 0.942741 | 20 | https://database.tytorobotics.com/tests/gqkn/hacker-a30-14l-kv800-cam-carbon-z-10x8-255x20 | third_party | S132 | 2026-10-20 | Test title: Hacker A30-14L KV800 Cam-Carbon Z 10x8 255x20.
tyto-7qgm | tyto-hacker-a30-14l-v4-800kv | Hacker A30-14L V4 800KV | zubax-myxa-a2 | propeller aeronaut-cam-carbon-z-95x6-24x15 |  | 15.4341 | 16.2712 | 12313 | 795.791 | 21.7226 | 335.712 | 320.698 | 0.248716 | 13.9285 | 0.963277 | 20 | https://database.tytorobotics.com/tests/7qgm/hacker-a30-14l-kv800-cam-carbon-95x6-24x15 | third_party | S132 | 2026-10-20 | Test title: Hacker A30-14L KV800 Cam-Carbon 95x6 24x15.
tyto-9grq | tyto-hacker-a30-14l-v4-800kv | Hacker A30-14L V4 800KV | zubax-myxa-a2 | propeller aeronaut-cam-carbon-z-10x6-255x15 |  | 15.1141 | 16.0822 | 11529 | 762.796 | 26.6313 | 402.509 | 373.619 | 0.309463 | 16.3961 | 0.958557 | 20 | https://database.tytorobotics.com/tests/9grq/hacker-a30-14l-kv800-cam-carbon-10x6-255x15 | third_party | S132 | 2026-10-20 | Test title: Hacker A30-14L KV800 Cam-Carbon 10x6 255x15.
tyto-rm76 | tyto-hacker-a30-14l-v4-800kv | Hacker A30-14L V4 800KV | zubax-myxa-a2 | propeller aeronaut-cam-carbon-z-9x5-23x125 |  | 15.2943 | 15.982 | 12392 | 808.863 | 18.6822 | 286.216 | 275.574 | 0.212358 | 12.3014 | 0.963887 | 20 | https://database.tytorobotics.com/tests/rm76/hacker-a30-14l-kv800-cam-carbon-9x5-23x125 | third_party | S132 | 2026-10-20 | Test title: Hacker A30-14L KV800 Cam-Carbon 9x5 23x125.
tyto-y3r6 | tyto-hacker-a30-14l-v4-800kv | Hacker A30-14L V4 800KV | zubax-myxa-a2 | propeller graupner-cam-folding-prop-10x6-25x15 |  | 15.5838 | 16.5722 | 11906 | 763.996 | 27.3939 | 426.903 | 398.27 | 0.319436 | 18.3169 | 0.95589 | 20 | https://database.tytorobotics.com/tests/y3r6/hacker-a30-14l-kv800-gr-cam-folding-10x6-25x15 | third_party | S132 | 2026-10-20 | Test title: Hacker A30-14L KV800 Gr Cam folding 10x6 25x15.
tyto-www7 | tyto-scorpion-power-system-ltd-a-5025-220kv | Scorpion Power System LTD A-5025-220kv | scorpion-power-system-ltd-tribunus-ii-12-80a-sbec | propeller xoar-pjn-21-x-8 |  | 43.8425 | 48.9199 | 7728.92 | 176.288 | 76.2076 | 3341.13 | 2780.12 | 3.43491 | 123.001 | 0.877764 | 19 | https://database.tytorobotics.com/tests/www7/scorpion-a-5025-220kv-tribunus-esc-xoar-21x8e | third_party | S132 | 2026-10-20 | Test title: Scorpion A-5025-220kv - Tribunus ESC - Xoar 21x8E.
tyto-kzx7 | tyto-ldpower-ufo3505-650kv | LDPower UFO3505 650KV | zubax-myxa-a2 | propeller graupner-cam-folding-prop-10x6-25x15 |  | 16.0533 | 16.4265 | 10099 | 627.644 | 9.85436 | 158.195 | 113.616 | 0.133436 | 7.66848 | 0.927928 | 20 | https://database.tytorobotics.com/tests/kzx7/ldpower-ufo3505-650kv-gr-cam-folding-10x6-25x15 | third_party | S132 | 2026-10-20 | Test title: LDPower UFO3505 650KV Gr Cam folding 10x6 25x15.
tyto-3nzz | tyto-ldpower-ufo3505-650kv | LDPower UFO3505 650KV | zubax-myxa-a2 | propeller aeronaut-cam-carbon-z-9x5-23x125 |  | 16.1264 | 16.3891 | 9100 | 563.917 | 6.85122 | 110.559 | 103.257 | 0.108355 | 6.26015 | 0.948858 | 20 | https://database.tytorobotics.com/tests/3nzz/ldpower-ufo3505-650kv-cam-carbon-z-9x5-23x125 | third_party | S132 | 2026-10-20 | Test title: LDPower UFO3505 650KV Cam-Carbon Z 9x5 23x125.
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
