fernandomierhicks/omni-robot/cad/v9/out/BOM.md

# Bill of materials, v9 CAD, catch robot (generated by build.py)

Everything placed in `assembly.step`, counted from the model. Prices and part numbers: section 24 and the actuator database. McMaster numbers are product families (their site can't be read from here): pick the size given.

## Purchased parts

| Qty | Part | Description | Source |
| --- | --- | --- | --- |
| 1 | 12 V buck | 12 V 5 A step-down (Pololu D36V50F12 class) for the feed motors' RoboClaw and the STS3250 | pololu.com #4096 (~$30) |
| 1 | 19 V buck | 19 V 4 A step-down for the Jetson dev kit (est) | TBD (~$15) |
| 1 | 5 V buck | 5 V 3 A step-down for the MCU carrier, the receiver, the beams and bumpers (Pololu D36V28F5 class) | pololu.com #3782 (~$15) |
| 1 | 5 in display 800x480 | 5 in 800 x 480 IPS HDMI display + USB touch, 121 x 77 x 12 with its driver on its back (Waveshare 5inch HDMI LCD class; VERIFY size, connectors and depth); HDMI + USB to the Jetson | Waveshare / generic (~$40) |
| 1 | BMS | 7S 40 A BMS (Daly-class, est 65 x 45 x 9), under the rear lobe next to the battery's leads | TBD (VERIFY size) |
| 4 | CubeMars AK40-10 V3.0 KV170 | CubeMars integrated 10:1 BLDC actuator, 190 g, dual encoder, CAN | cubemars.com; vendor/AK40-10-V3.0.pdf (July 2026) |
| 1 | ELRS receiver | ELRS 2.4 GHz receiver (RadioMaster RP2 class), 3M dual-lock on top of the left mast foot, its antenna up the post (a base part) | RadioMaster ($15) |
| 1 | ESC 8S 4-in-1 (AM32) | 8S AM32 4-in-1 ESC, bidirectional DShot, 30.5 x 30.5 mount (Pilotix 65A / TBS Lucid 8S) | section 24 (~$56-73) |
| 1 | Feetech STS3250 | Feetech STS3250 serial-bus servo, 12 V, 12-bit absolute encoder (tilt, section 24) | feetechrc.com / robotshop ($73.99) |
| 4 | IR break-beam half | 5 mm IR break-beam sensor half (emitter or receiver; Adafruit #2168 pair) | adafruit.com #2168 ($5.95 per pair) |
| 1 | Jetson Orin Nano Super dev kit | NVIDIA Jetson Orin Nano Super developer kit (design.md 4) | NVIDIA / Arrow ($399 est) |
| 2 | M5 prop nut | M5 nylon-insert prop nut (comes with the F90) | with the motor |
| 1 | MCU carrier | MCU carrier: Teensy 4.1 on a custom carrier (2 CAN transceivers, level shifters, drivers, keyed JST-GH connectors), BNO085 (Adafruit #4754) plugged on; 55 x 90 (est, design.md 15) | custom PCB (KiCad, JLCPCB-class) |
| 1 | Micro-Fit 2x6 panel socket | Molex Micro-Fit 3.0 2 x 6 panel-mount receptacle: CAN3 (FD), 2 x DShot, Serial3 (RoboClaw), Serial4 (STS3250), beams, IR, 5 V, GND (pinout: firmware/PINS.md) | Molex 43025 + panel flange / generic (~$4) |
| 2 | OV9782 camera | OV9782 global-shutter colour camera, M12 lens, 22-pin FFC (MCU-triggered) | Arducam / Luxonis-class module (VERIFY driver at 1280x800 @ 120 fps) |
| 2 | Pololu #1997 hub | Pololu universal aluminium mounting hub, 4 mm shaft, 4 x M3 (pair: #1997) | pololu.com #1997 ($7.95 per 2) |
| 2 | Pololu 25D 9.7:1 HP 12 V + encoder | Pololu #4842 9.7:1 25Dx63L HP 12 V gearmotor, 48 CPR encoder | pololu.com #4842 ($56.95) |
| 8 | RC shock 50 mm | 1/16-scale RC oil shock, 50 mm eye to eye, 10 mm stroke, M3 eyes; spring ~6 N/mm (est, pod.shock_travel) | e.g. 1/16 RC (WLtoys 144001-class) shock; VERIFY length, stroke, spring |
| 1 | RPLIDAR A2M12 | Slamtec RPLIDAR A2M12 (design.md 7, Fernando's choice) | Slamtec / robotshop (~$229) |
| 1 | RoboClaw 2x7A | Basicmicro RoboClaw 2x7A (feed motors' speed / position loops) | basicmicro.com ($79.95) |
| 2 | T-Motor F90 2806.5 1300KV | T-Motor F90 2806.5 1300KV (or iFlight XING 2806.5) | T-Motor via GetFPV / Pyrodrone (~$30) |
| 1 | USB mic array | USB 2-mic array, echo cancellation and beamforming, speaker output (Seeed ReSpeaker Lite class, VERIFY board size, holes and amp power) | Seeed Studio (~$25 est) |
| 1 | USB-C panel socket | USB-C panel-mount extension (to a Jetson USB port: the arm's bus board, a kit camera) | generic (~$6) |
| 1 | XT30 panel socket | XT30 female panel mount (the switched motor bus, 24 V nominal, to the kit) | AMASS XT30PW-F / generic (~$2) |
| 1 | battery 7S1P P50B | 7S1P Molicel P50B 21700 pack (5 Ah, 25.2 V), flat row, wrapped, XT60 + balance lead | Molicel INR21700-P50B x 7 + nickel strip / pack builder (~$90) |
| 9 | bearing 608-2RS | 608-2RS ball bearing 8 x 22 x 7 | generic; McMaster 6383K (608) |
| 8 | bearing 61808-2RS | 61808-2RS thin-section ball bearing 40 x 52 x 7 | generic (VXB / Amazon); McMaster 5972K (search 40 mm ID x 52 mm OD) |
| 1 | camera bar 20 x 20 tube | 6061 square tube 20 x 20 x 1.5, 228 mm; 2 x 3.4 cross holes at +-95 mm (holders) | McMaster 6546K (6061 square tube 3/4 in) or 20 x 20 x 1.5 metric stock |
| 6 | carbon tube 8 x 6 | carbon-fibre tube 8 mm OD x 6 mm ID (6 struts, cut to 115 mm) | McMaster 2153T (carbon-fibre tube 8 mm) or RC hobby supplier |
| 2 | feed torsion spring | torsion spring, 0.5 mm wire, 3.2 mm ID, 90 deg legs (~6 N at the wheel) | McMaster 9271K (torsion spring, est) |
| 4 | fork bar 10 x 20 | 6061 flat bar 10 x 20 mm, 104 mm long, 4 x 3.4 mm cross holes (the wheel fork's link under the deck) | McMaster 8975K (6061 bar 3/8 x 3/4 in) or 10 x 20 metric stock |
| 2 | mast post 20 x 20 tube | 6061 square tube 20 x 20 x 1.5, 363.5 mm, 2 x 3.4 mm cross holes (the face mast; the camera bar's stock) | McMaster 6546K (6061 square tube 3/4 in) or 20 x 20 x 1.5 metric stock |
| 1 | micro speaker 4 ohm 3 W | 4 ohm 3 W enclosed micro speaker 40 x 28 x 12, on VHB tape under the lid (VERIFY) | generic (~$5) |
| 1 | on/off switch 22 mm | 22 mm round latching push button, metal anti-vandal, LED ring, 1 NO + 1 NC, ring nut: switches the power board's anti-spark switch (its enable loop; no motor current through it) | e.g. Ulincos / generic 22 mm latching anti-vandal switch (~$8) |
| 2 | pin 4 x 16 | 4 mm dowel pin x 16 (module keying), pressed into the plate | McMaster 91585A (4 mm x 16 dowel) |
| 1 | polycarbonate window 2 mm | 2 mm clear polycarbonate, cut to 121 x 77 (in front of the panel) | McMaster 8574K (polycarbonate sheet, 1/16 in) (est) |
| 1 | power board | power board: anti-spark switch (soft start, enabled by the on/off switch), 40 A fuse, hall current sensor, XT60 in/out, XT30 to the payload connector (off the shelf parts on a carrier, design.md 15) | custom / TBD |
| 1 | servo horn | Feetech 25T aluminium disc horn (with the STS3250) | with the servo |
| 1 | shaft 8 x 40 | 8 mm steel shaft, h6, 40 mm (tilt pivot, +y side) | McMaster 6112K (8 mm shaft, cut) |
| 4 | shaft 8 x 98 | 8 mm steel shaft (h6 linear shaft or drill rod) cut to 98 mm, one 3.4 mm cross hole 86.25 mm from the outer end (the fork's pivot) | McMaster 6112K (8 mm precision shaft) + drill |
| 8 | shim 8x14x0.5 | shim washer 8 x 14 x 0.5, DIN 988 (the pivot 608s' inner races to the ears) | McMaster 98055A (shim washer, metric) |
| 2 | standoff rod 8 x 104.5 | 6061 aluminium rod Ø8 x 104.5 mm, M3 tapped 10 deep at both ends (front standoffs; or Ø8 M3 female round standoffs of that length, VERIFY) | McMaster 8974K (6061 rod, 8 mm) + M3 tap |

## Fasteners

Thread-forming into 2.8 mm printed holes unless a nut is listed. Totals include the module, base and pods.

| Qty | Size | Description | McMaster family |
| --- | --- | --- | --- |
| 8 | M2 x 6 PAN | M2 hex-drive shallow pan head screw (head 6.5 x 2.5, 2 mm hex), 18-8 stainless | McMaster: hex drive pan / low button head, 18-8 SS, metric, M2 (look up the size) |
| 12 | M2.5 x 6 PAN | M2.5 hex-drive shallow pan head screw (head 6.5 x 2.5, 2 mm hex), 18-8 stainless | McMaster: hex drive pan / low button head, 18-8 SS, metric, M2.5 (look up the size) |
| 20 | M2.5 x 8 PAN | M2.5 hex-drive shallow pan head screw (head 6.5 x 2.5, 2 mm hex), 18-8 stainless | McMaster: hex drive pan / low button head, 18-8 SS, metric, M2.5 (look up the size) |
| 6 | M3 x 14 FLAT | M3 flat head screw 90 deg, ISO 7046 head, 2 mm hex drive, 18-8 stainless | McMaster 92125A (18-8 SS flat head hex drive, metric) |
| 8 | M3 x 8 PAN | M3 hex-drive shallow pan head screw (head 6.5 x 2.5, 2 mm hex), 18-8 stainless | McMaster: hex drive pan / low button head, 18-8 SS, metric (look up the size) |
| 94 | M3 x 10 PAN | M3 hex-drive shallow pan head screw (head 6.5 x 2.5, 2 mm hex), 18-8 stainless | McMaster: hex drive pan / low button head, 18-8 SS, metric (look up the size) |
| 38 | M3 x 12 PAN | M3 hex-drive shallow pan head screw (head 6.5 x 2.5, 2 mm hex), 18-8 stainless | McMaster: hex drive pan / low button head, 18-8 SS, metric (look up the size) |
| 60 | M3 x 14 PAN | M3 hex-drive shallow pan head screw (head 6.5 x 2.5, 2 mm hex), 18-8 stainless | McMaster: hex drive pan / low button head, 18-8 SS, metric (look up the size) |
| 28 | M3 x 16 PAN | M3 hex-drive shallow pan head screw (head 6.5 x 2.5, 2 mm hex), 18-8 stainless | McMaster: hex drive pan / low button head, 18-8 SS, metric (look up the size) |
| 20 | M3 x 18 PAN | M3 hex-drive shallow pan head screw (head 6.5 x 2.5, 2 mm hex), 18-8 stainless | McMaster: hex drive pan / low button head, 18-8 SS, metric (look up the size) |
| 59 | M3 x 20 PAN | M3 hex-drive shallow pan head screw (head 6.5 x 2.5, 2 mm hex), 18-8 stainless | McMaster: hex drive pan / low button head, 18-8 SS, metric (look up the size) |
| 22 | M3 x 25 PAN | M3 hex-drive shallow pan head screw (head 6.5 x 2.5, 2 mm hex), 18-8 stainless | McMaster: hex drive pan / low button head, 18-8 SS, metric (look up the size) |
| 6 | M3 x 30 PAN | M3 hex-drive shallow pan head screw (head 6.5 x 2.5, 2 mm hex), 18-8 stainless | McMaster: hex drive pan / low button head, 18-8 SS, metric (look up the size) |
| 2 | M3 x 45 PAN | M3 hex-drive shallow pan head screw (head 6.5 x 2.5, 2 mm hex), 18-8 stainless | McMaster: hex drive pan / low button head, 18-8 SS, metric (look up the size) |
| 48 | M3 x 50 PAN | M3 hex-drive shallow pan head screw (head 6.5 x 2.5, 2 mm hex), 18-8 stainless | McMaster: hex drive pan / low button head, 18-8 SS, metric (look up the size) |
| 2 | M3 x 10 SSCS | M3 set screw, cup point, ISO 4029 | McMaster 92015A (18-8 SS set screw, metric) |
| 49 | M3 hex nut | M3 hex nut, ISO 4032, 18-8 stainless | McMaster 91828A (18-8 SS hex nut, metric) |
| 10 | M3 nyloc nut | M3 nylon-insert locknut, ISO 10511, 18-8 stainless | McMaster 93625A (18-8 SS nylon-insert locknut, metric) |
| 4 | M3 washer | M3 flat washer, ISO 7089, 18-8 stainless | McMaster 93475A (18-8 SS washer, metric) |

Total fasteners: 496 (M3: 456).

## Materials

| Qty | Item | Description | Source |
| --- | --- | --- | --- |
| 5 | catch-pad foam 6 mm | 6 mm low-resilience (slow-recovery) PU foam sheet, cut to the templates in out/step/pad_*.step | McMaster 8643K (slow-recovery polyurethane foam, 1/4 in) (est) |
| 1 | funnel net | grippy, soft mesh, ~0.25 m2, sewn to the 1:1 pattern and laced to the collar and rim | fabric store (design.md 8: mesh choice open) |

## Mass

CAD estimate: **10.18 kg**, CG at [-1.3, -1.2, 138.6] mm (ROBOT frame, module at tilt 0). Printed parts 5.49 kg.

The v7 sim (DM-2325): 6.62 kg, CG at [14.0, 3.3, 121.1] mm.

By group: base 2.35 kg, head 0.20 kg, mast 0.61 kg, module 1.29 kg, mounts 0.50 kg, pod 5.23 kg
