fernandomierhicks/omni-robot/cad/out/assembly.step

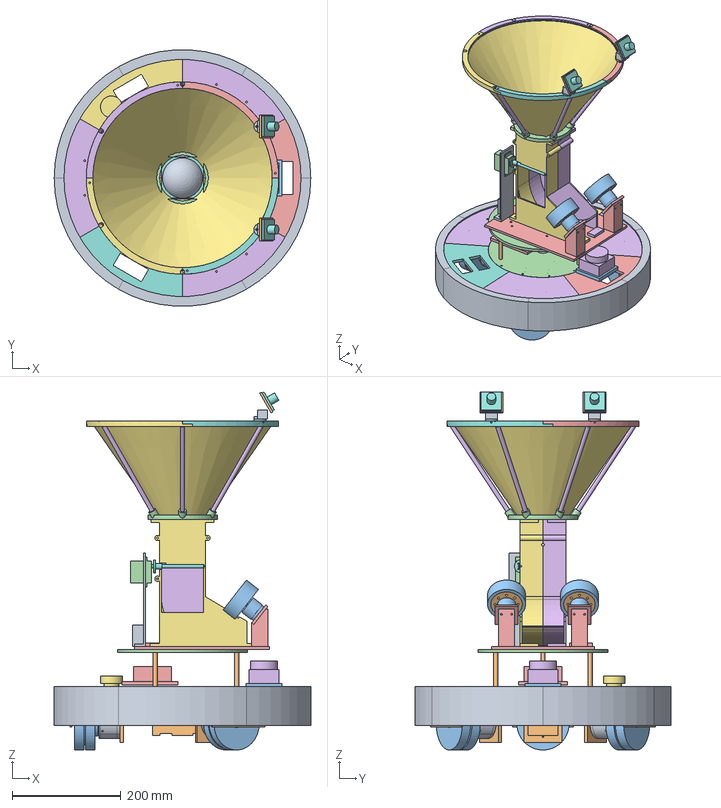
[picture p65: CAD file, 2026-10-20]
cad/out/assembly.step
472.0 x 471.2 x 658.5 mm
wheel_pod x 3
wheel_adapter x 3
center_plate
deck_sector_0
deck_sector_1
deck_sector_2
deck_sector_3
deck_sector_4
deck_sector_5
bumper_arc_0
bumper_arc_1
bumper_arc_2
bumper_arc_3
bumper_arc_4
bumper_arc_5
battery_tray
lidar_riser
payload_plate
launcher_base
channel_half_L
channel_half_R
gate_flap
servo_tower
flywheel_hub x 2
flywheel_tire x 2
funnel_collar
funnel_rim_arc_0
funnel_rim_arc_1
funnel_rim_arc_2
funnel_rim_arc_3
camera_bracket_L
camera_bracket_R
AK40-10_2 x 3
omni_wheel_0
omni_wheel_1
omni_wheel_2
battery
jetson
lidar
estop
mcu_board
power_board
standoff_0
standoff_120
standoff_240
flywheel_motor_L
flywheel_motor_R
gate_servo
esc_4in1
strut_0
strut_1
strut_2
strut_3
strut_4
strut_5
funnel_net
camera_L
camera_R
ball
