fernandomierhicks/omni-robot/cad/v10 human editable/step_export/wheel_motor_v2/wheel_motor_v2_assembly.step

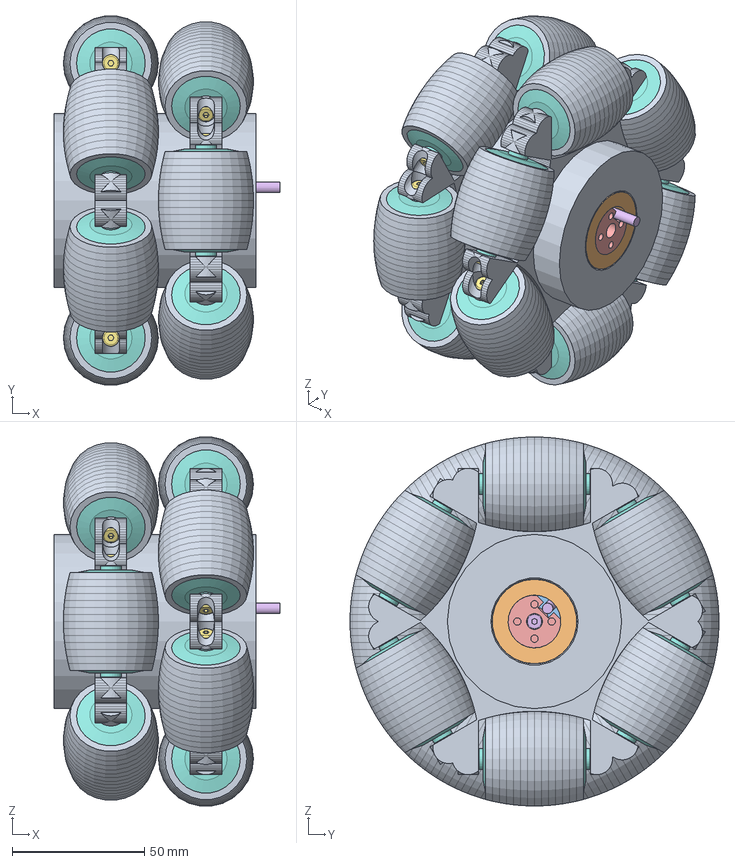
[picture p66: CAD file, 2026-11-03]
cad/v10 human editable/step_export/wheel_motor_v2/wheel_motor_v2_assembly.step
85.5 x 139.7 x 139.7 mm
wheel_hub
wheel_cartridge
dummy_motor_stator
dummy_motor_rotor
motor_cup
motor_cable
bolt_2_6 x 12
roller_core_2_6 x 12
roller_tread_2_6 x 12
bearing_6804_right x 2
bolt_M2p5_10_PAN_1
bolt_M2p5_10_PAN_2
bolt_M2p5_10_PAN_3
cartridge_screw_3 x 3
Motor_bearing
Motor_screw
