fernandomierhicks/omni-robot/cad/v10 human editable/step_export/wheel_no_hubs/V10H_wheel_no_hubs_assembly.step

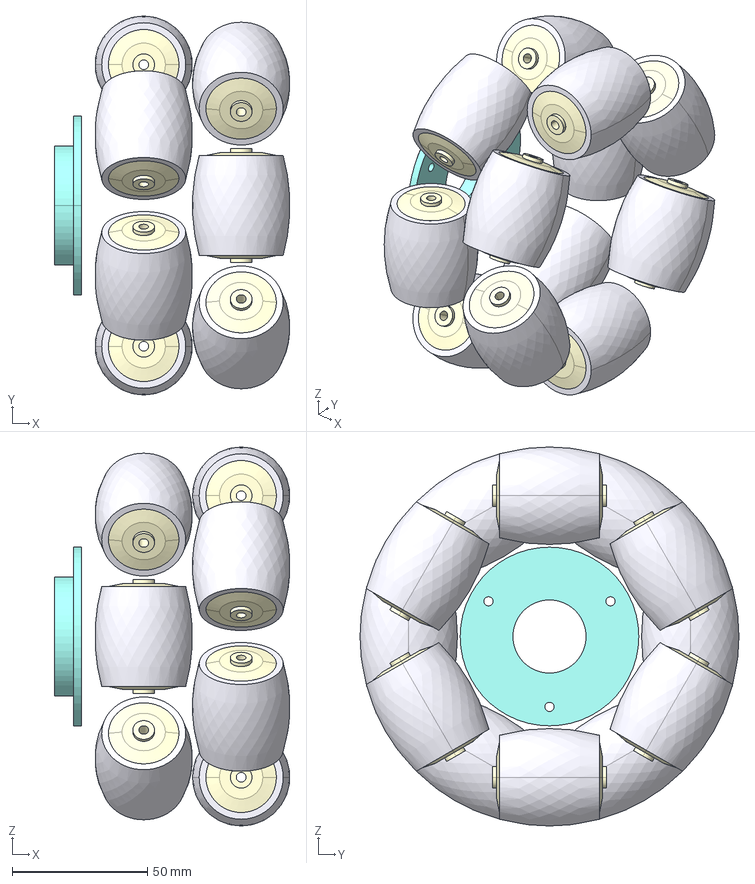
[picture p67: CAD file, 2026-11-03]
cad/v10 human editable/step_export/wheel_no_hubs/V10H_wheel_no_hubs_assembly.step
86.9 x 140.0 x 140.0 mm
Cartridge
Roller_2_6 x 12
Roller_2_6_TPU x 12
