fernandomierhicks/omni-robot/cad/v13/step_export/pod_lean/pod_lean_assembly.step

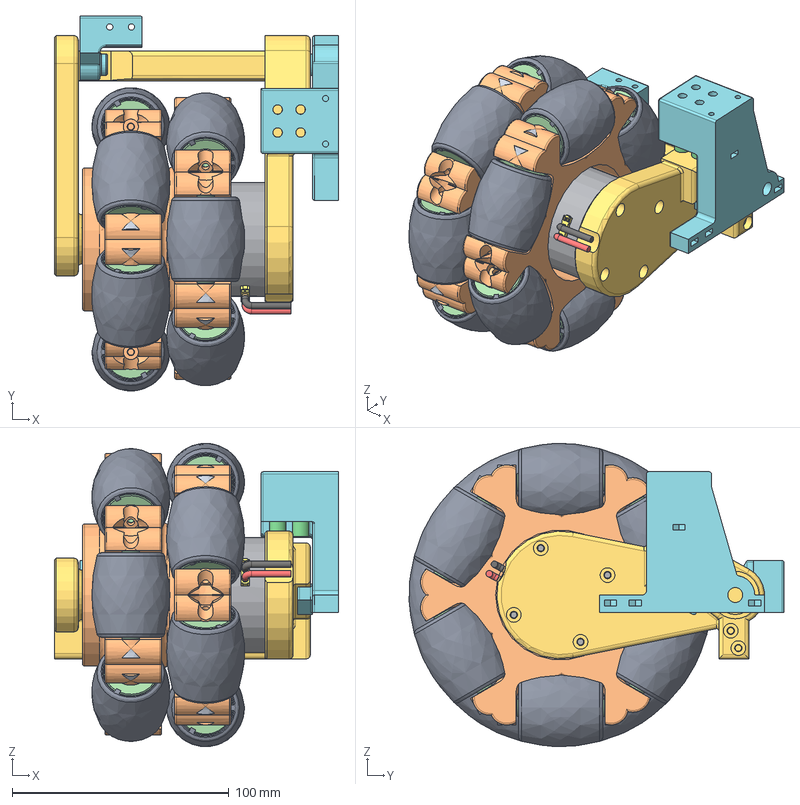
[picture p68: CAD file, 2026-11-06]
cad/v13/step_export/pod_lean/pod_lean_assembly.step
131.1 x 172.9 x 139.8 mm
wheel_hub
wheel_cartridge
ak40_stator
ak40_rotor
xt30_housing
xt30_pin_1
xt30_pin_2
lead_pos
lead_neg
roller_core_1_1
roller_tread_1_1
roller_core_1_2
roller_tread_1_2
roller_core_1_3
roller_tread_1_3
roller_core_1_4
roller_tread_1_4
roller_core_1_5
roller_tread_1_5
roller_core_1_6
roller_tread_1_6
roller_core_2_1
roller_tread_2_1
roller_core_2_2
roller_tread_2_2
roller_core_2_3
roller_tread_2_3
roller_core_2_4
roller_tread_2_4
roller_core_2_5
roller_tread_2_5
roller_core_2_6
roller_tread_2_6
pod_fork_outer
pod_fork_inner
pod_frame_inner
pod_keel_outer
pod_sleeve
die_spring_inner_a1
die_spring_inner_b1
die_spring_inner_a2
die_spring_inner_b2
