fernandomierhicks/omni-robot/cad/v13/step_export/upper/upper_assembly.step

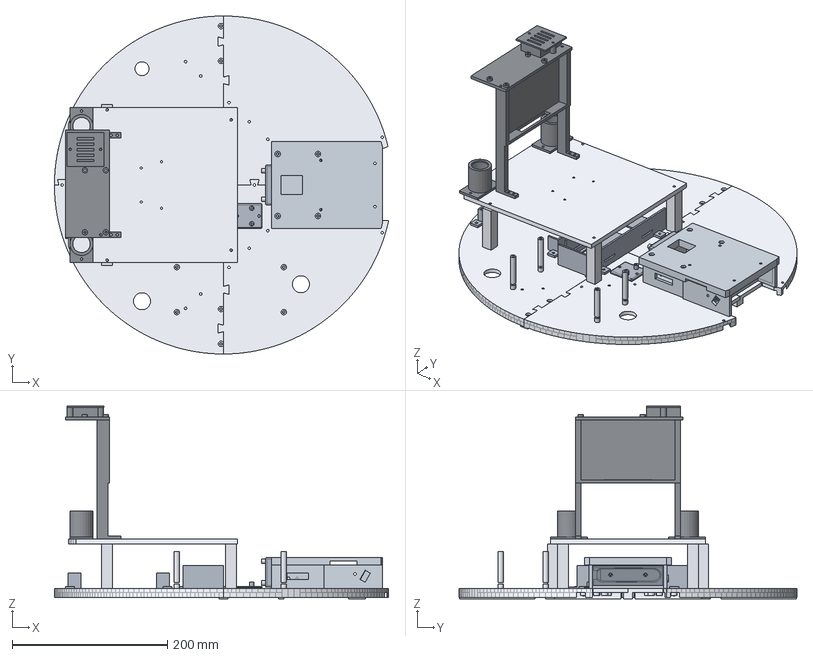
[picture p69: CAD file, 2026-11-06]
cad/v13/step_export/upper/upper_assembly.step
431.1 x 436.0 x 248.5 mm
floor2_FL
floor2_RL
floor2_RR
floor2_FR
riser_adapter
riser_arm
bracket_computer_0
bracket_computer_1
bracket_computer_2
bracket_computer_3
bracket_battery_tray
post_spacer_power_0
post_mcu_0
post_spacer_power_1
post_mcu_1
post_spacer_power_2
post_mcu_2
post_spacer_power_3
post_mcu_3
spacer_servo_adapter_0
spacer_servo_adapter_1
spacer_servo_adapter_2
spacer_servo_adapter_3
bracket_servo_adapter
bracket_imu
post_deck_0
post_deck_1
post_deck_2
post_deck_3
housing_estop
housing_switch
deck_bin
housing_face
housing_face_crown
housing_speaker_cover
bracket_d435_riser
