fernandomierhicks/omni-robot/cad/v10 human editable/step_export/dummy_motor/V10H_dummy_motor_assembly.step

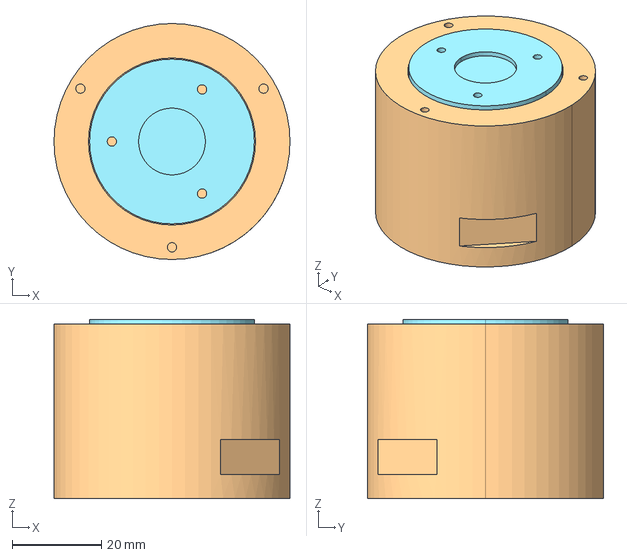
[picture p70: CAD file, 2026-11-03]
cad/v10 human editable/step_export/dummy_motor/V10H_dummy_motor_assembly.step
53.0 x 53.0 x 40.2 mm
dummy_motor_stator
dummy_motor_rotor
