fernandomierhicks/omni-robot/cad/v10 human editable/validation/INCOMPLETE_motor_cup.SLDPRT

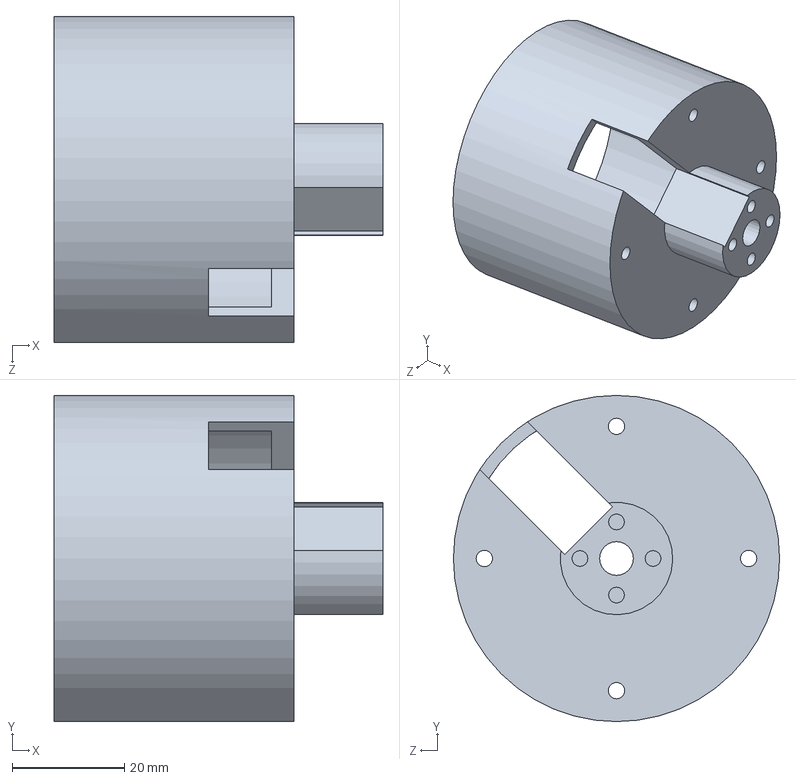
[picture p71: CAD file, 2026-11-03]
cad/v10 human editable/validation/INCOMPLETE_motor_cup.SLDPRT
58.5 x 58.0 x 58.0 mm
