fernandomierhicks/omni-robot/cad/v10 human editable/validation/INCOMPLETE_wheel_guard.SLDPRT

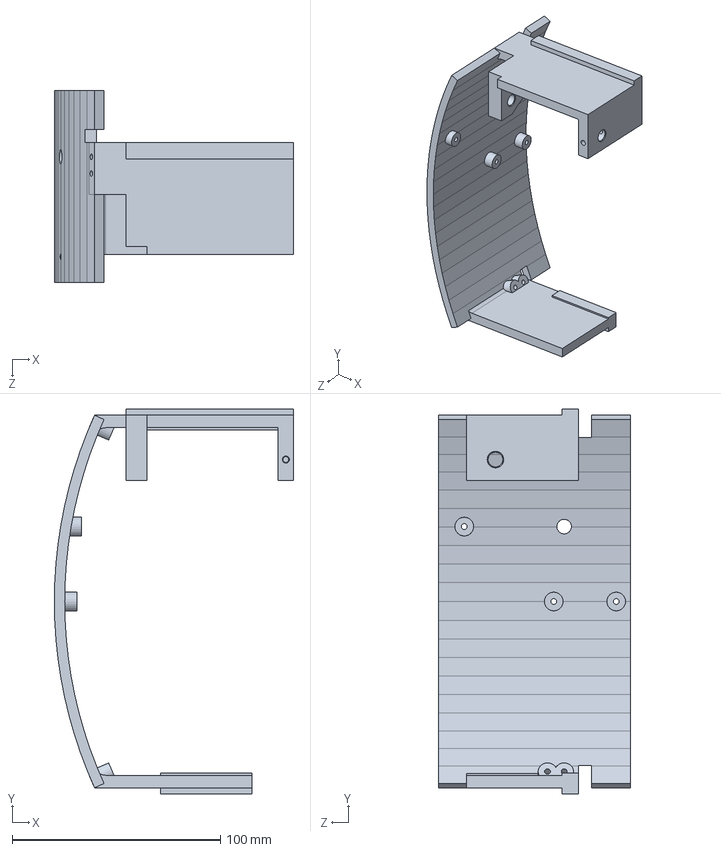
[picture p72: CAD file, 2026-11-03]
cad/v10 human editable/validation/INCOMPLETE_wheel_guard.SLDPRT
115.0 x 185.0 x 92.5 mm
