fernandomierhicks/omni-robot/cad/v10 human editable/validation/INCOMPLETE_wheel_hub_A.SLDPRT

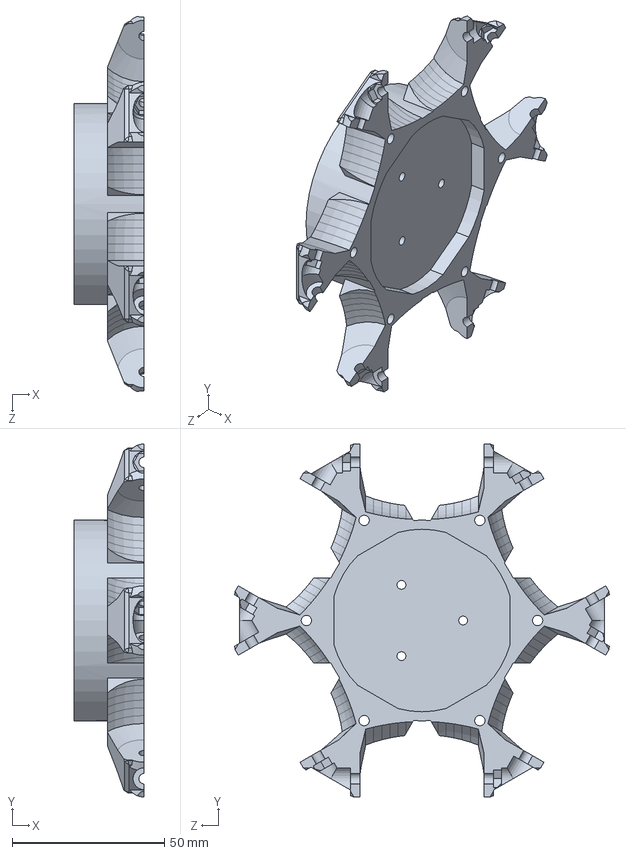
[picture p73: CAD file, 2026-11-03]
cad/v10 human editable/validation/INCOMPLETE_wheel_hub_A.SLDPRT
23.0 x 116.0 x 123.2 mm
