fernandomierhicks/omni-robot/cad/v10 human editable/validation/INCOMPLETE_wheel_hub_B.SLDPRT

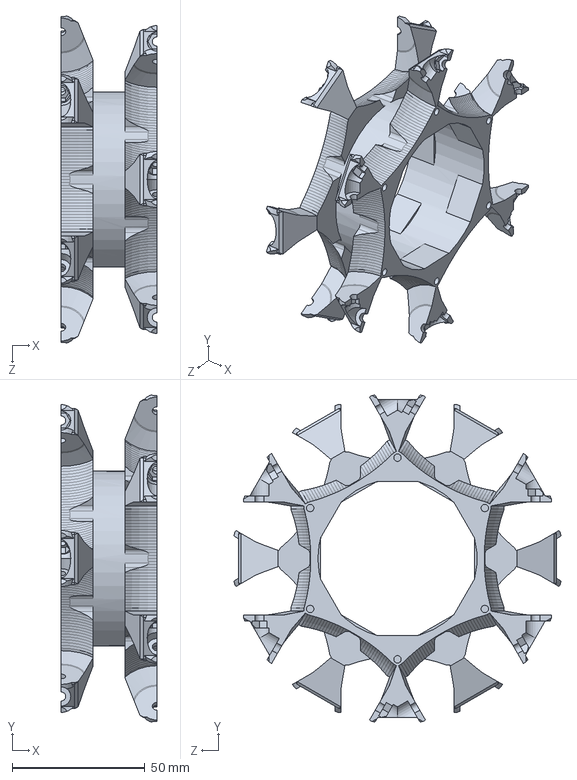
[picture p74: CAD file, 2026-11-03]
cad/v10 human editable/validation/INCOMPLETE_wheel_hub_B.SLDPRT
36.0 x 123.2 x 123.2 mm
