fernandomierhicks/omni-robot/cad/other/d435_nose/out/d435_nose.step

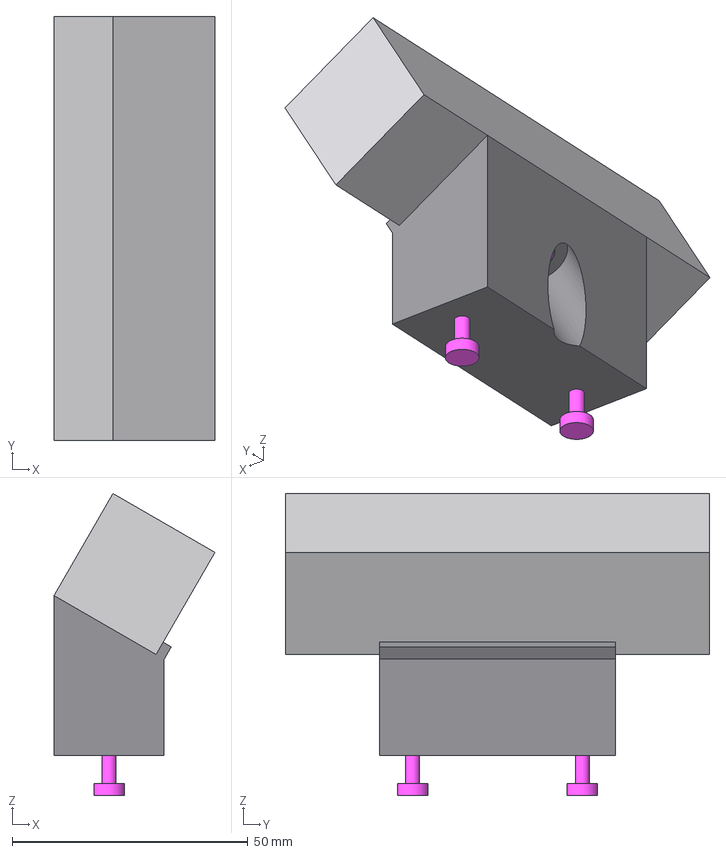
[picture p75: CAD file, 2026-11-03]
cad/other/d435_nose/out/d435_nose.step
34.2 x 90.0 x 64.1 mm
RealSense D435 (envelope)
d435_wedge (PETG)
M3x12 pan head (from under the deck) x 2
1/4-20 x 1/2 in (camera to wedge)
