fernandomierhicks/omni-robot/cad/other/Realsense to bucket/d435_filter_mount.stl

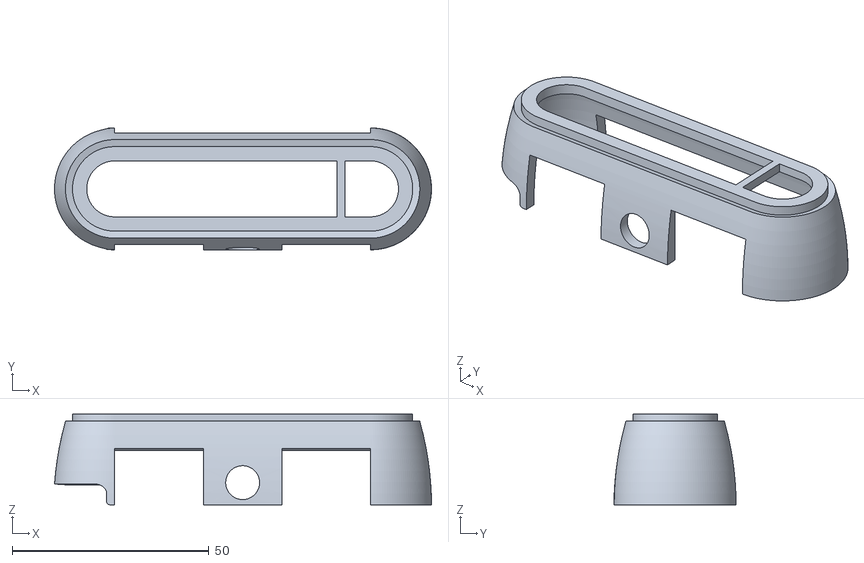
[picture p76: CAD file, 2026-11-03]
cad/other/Realsense to bucket/d435_filter_mount.stl
95.8 x 31.1 x 23.0
