fernandomierhicks/omni-robot/cad/out/step/flywheel_tire.step

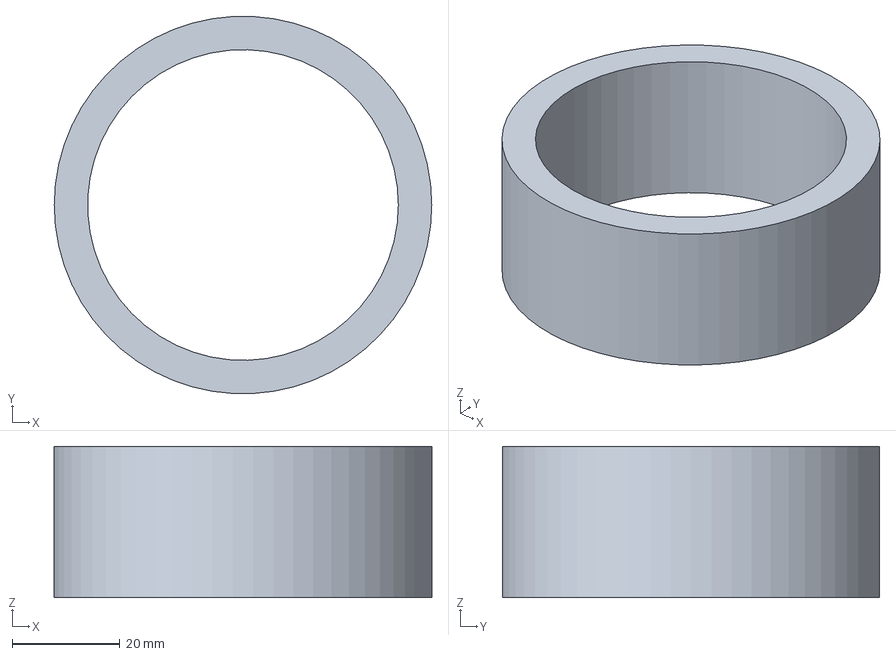
[picture p77: CAD file, 2026-10-20]
cad/out/step/flywheel_tire.step
70.0 x 69.9 x 28.0 mm
