fernandomierhicks/omni-robot/cad/v10 human editable/parts/human/V10H_pivot_shaft.SLDPRT

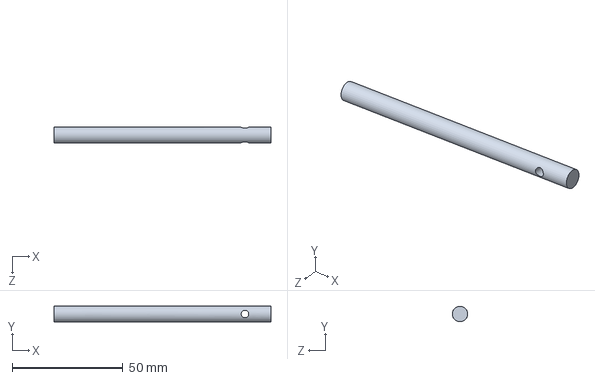
[picture p78: CAD file, 2026-11-03]
cad/v10 human editable/parts/human/V10H_pivot_shaft.SLDPRT
98.0 x 7.00 x 7.00 mm
