fernandomierhicks/omni-robot/cad/v10 human editable/parts/step/12_V_buck_arm.SLDPRT

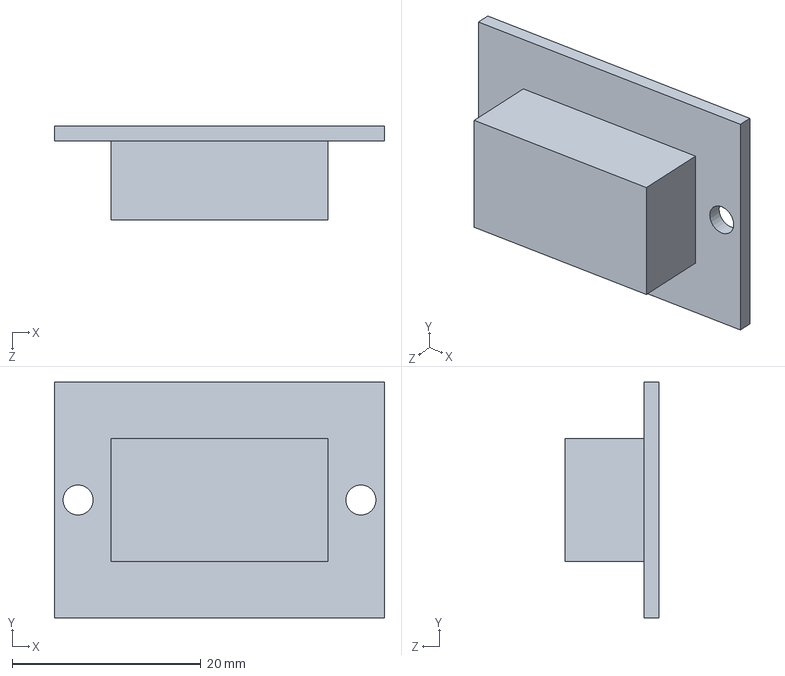
[picture p79: CAD file, 2026-11-03]
cad/v10 human editable/parts/step/12_V_buck_arm.SLDPRT
35.0 x 25.0 x 10.0 mm
