fernandomierhicks/omni-robot/cad/v10 human editable/print/dummy_motor_case.stl

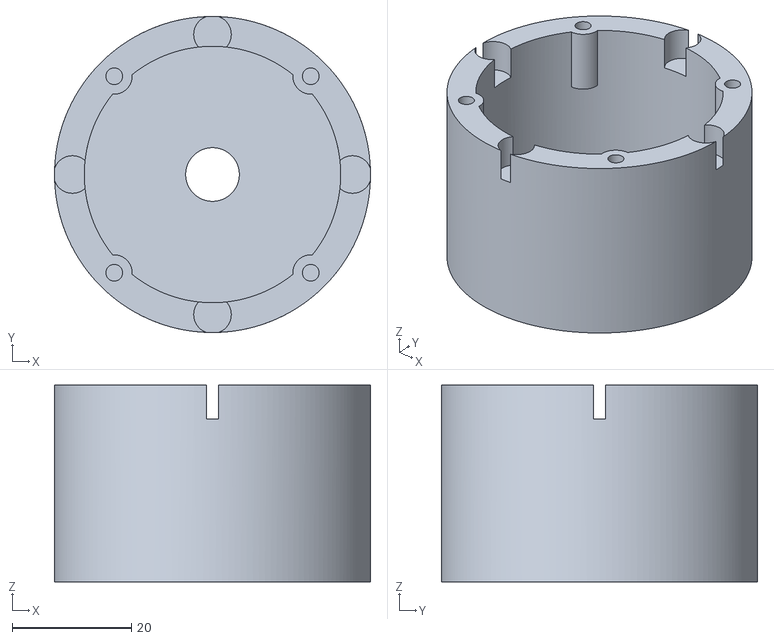
[picture p80: CAD file, 2026-11-03]
cad/v10 human editable/print/dummy_motor_case.stl
53.0 x 53.0 x 33.0
