fernandomierhicks/omni-robot/cad/v10 human editable/print/human/shock_case.stl

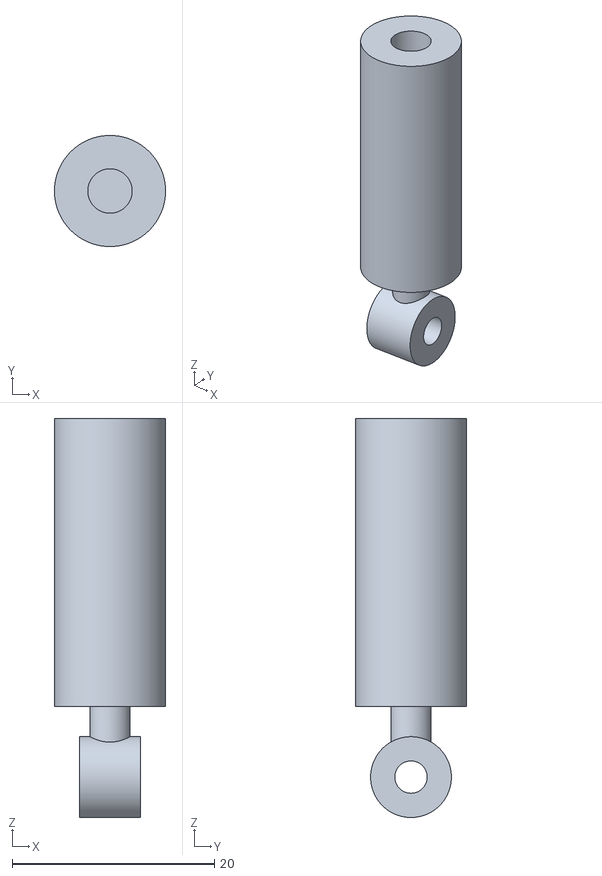
[picture p81: CAD file, 2026-11-03]
cad/v10 human editable/print/human/shock_case.stl
11.0 x 11.0 x 39.5
