fernandomierhicks/omni-robot/cad/v10 human editable/reference/dummy_motor_rear_cap.step

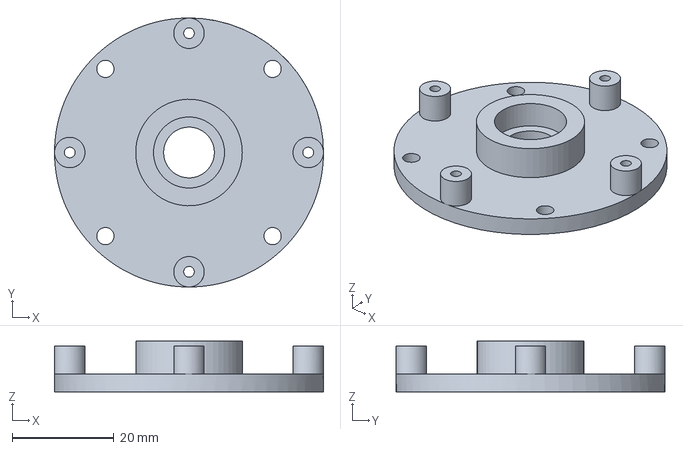
[picture p82: CAD file, 2026-11-03]
cad/v10 human editable/reference/dummy_motor_rear_cap.step
53.0 x 53.0 x 10.0 mm
