fernandomierhicks/omni-robot/cad/v10 human editable/step_export/d435_bar/parts/REC_D435_bar_saddle.step

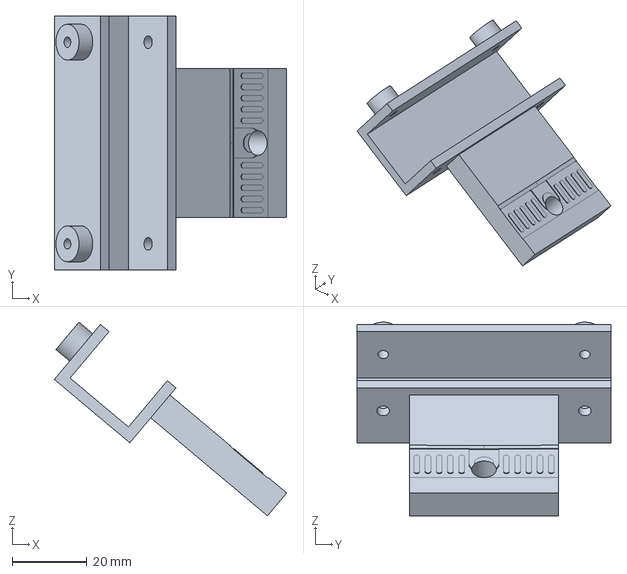
[picture p83: CAD file, 2026-11-03]
cad/v10 human editable/step_export/d435_bar/parts/REC_D435_bar_saddle.step
62.2 x 68.0 x 51.9 mm
