fernandomierhicks/omni-robot/cad/v10 human editable/step_export/d435_nose/parts/REC_deck_front_D435.step

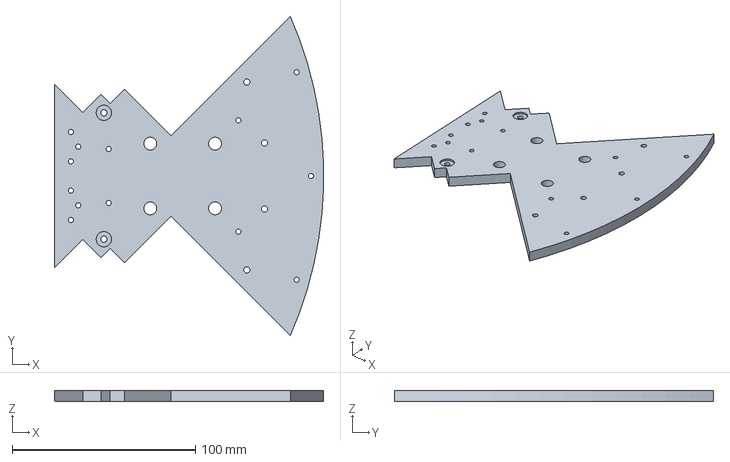
[picture p84: CAD file, 2026-11-03]
cad/v10 human editable/step_export/d435_nose/parts/REC_deck_front_D435.step
146.9 x 174.1 x 6.00 mm
