fernandomierhicks/omni-robot/cad/v10 human editable/step_export/dummy_motor/V10H_dummy_motor_stator.step

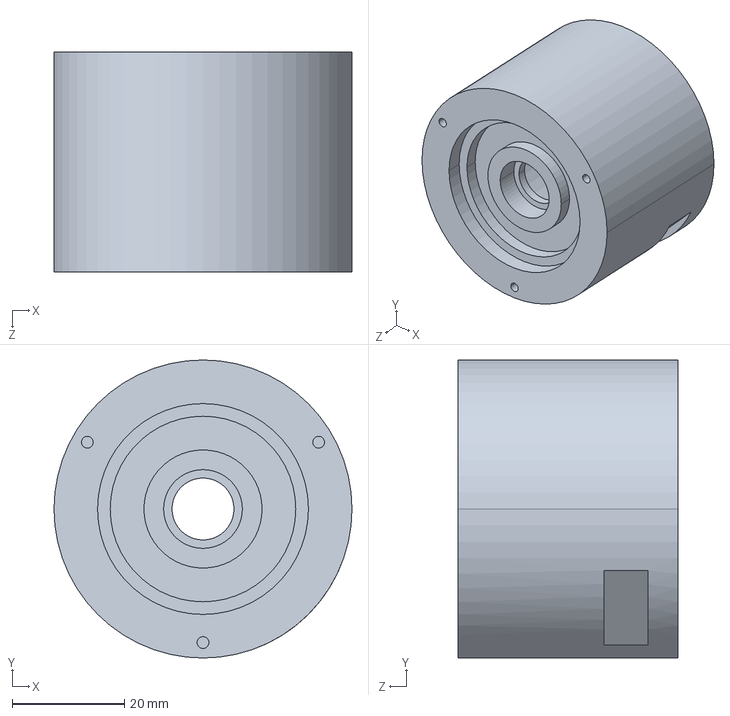
[picture p85: CAD file, 2026-11-03]
cad/v10 human editable/step_export/dummy_motor/V10H_dummy_motor_stator.step
53.0 x 53.0 x 39.2 mm
