fernandomierhicks/omni-robot/cad/v10 human editable/step_export/level_pivot/parts/V10H_wheel_guard_left_hand.step

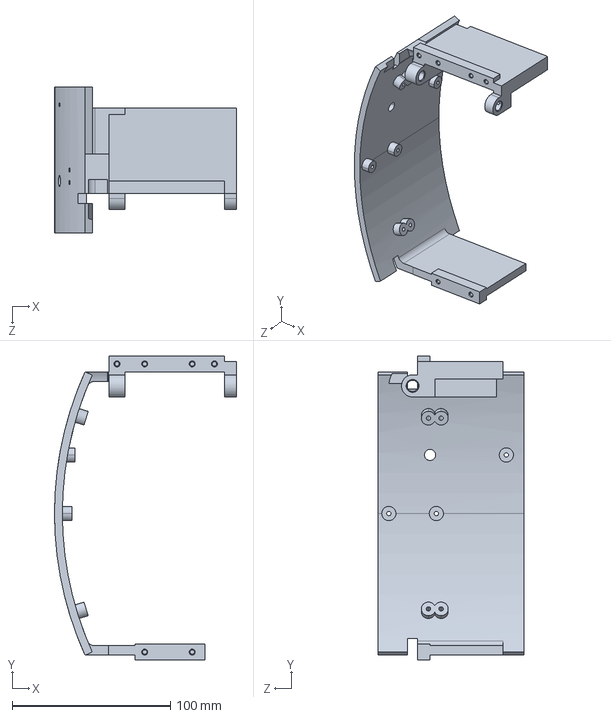
[picture p86: CAD file, 2026-11-03]
cad/v10 human editable/step_export/level_pivot/parts/V10H_wheel_guard_left_hand.step
115.0 x 192.0 x 92.5 mm
