fernandomierhicks/omni-robot/cad/v10 human editable/step_export/sim_reconciliation/parts/REC_cheek_R.step

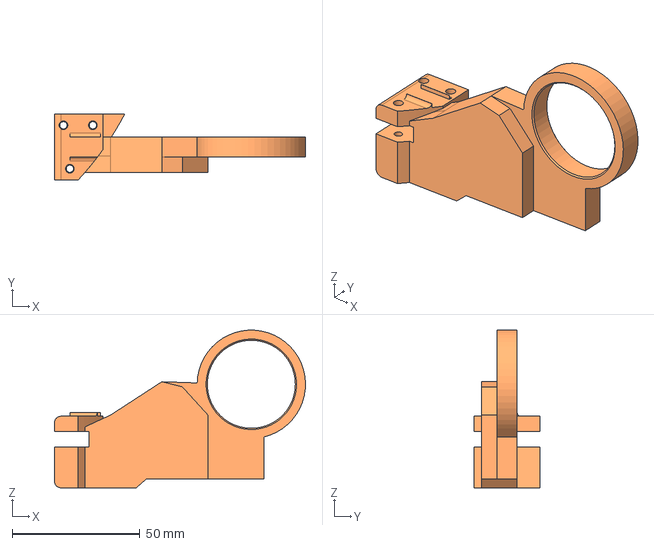
[picture p87: CAD file, 2026-11-03]
cad/v10 human editable/step_export/sim_reconciliation/parts/REC_cheek_R.step
98.2 x 26.0 x 61.7 mm
