fernandomierhicks/omni-robot/cad/v10 human editable/step_export/wheel_motor_v2/parts/motor_cable.step

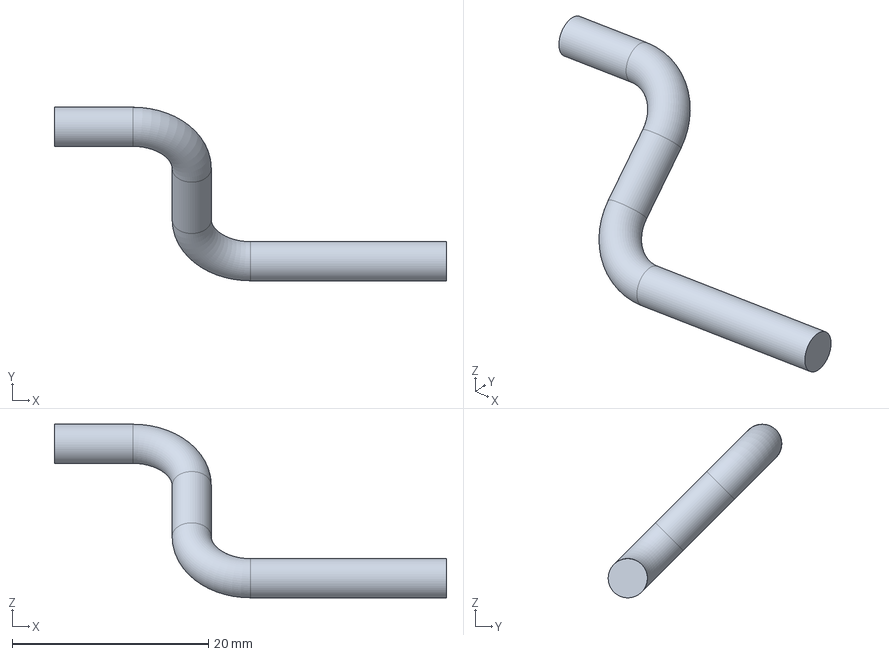
[picture p88: CAD file, 2026-11-03]
cad/v10 human editable/step_export/wheel_motor_v2/parts/motor_cable.step
40.0 x 17.7 x 17.7 mm
