fernandomierhicks/omni-robot/cad/v10 human editable/step_export/wheel_no_hubs/parts/V10H_wheel_cartridge.step

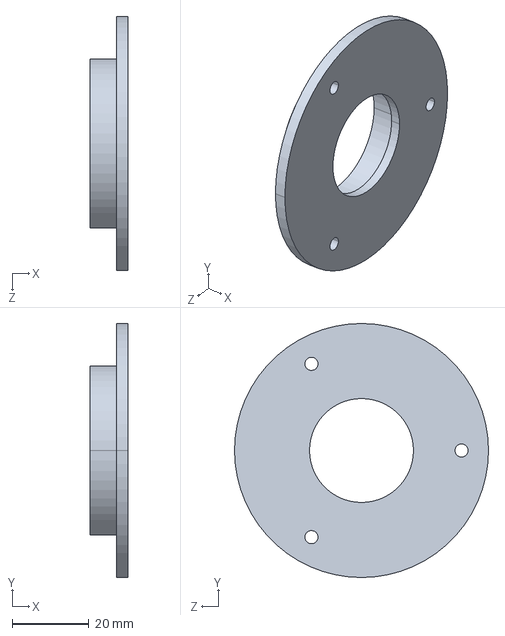
[picture p89: CAD file, 2026-11-03]
cad/v10 human editable/step_export/wheel_no_hubs/parts/V10H_wheel_cartridge.step
10.0 x 66.0 x 66.0 mm
