fernandomierhicks/omni-robot/cad/v10 human editable/step_parts/M3_x_20_PAN.step

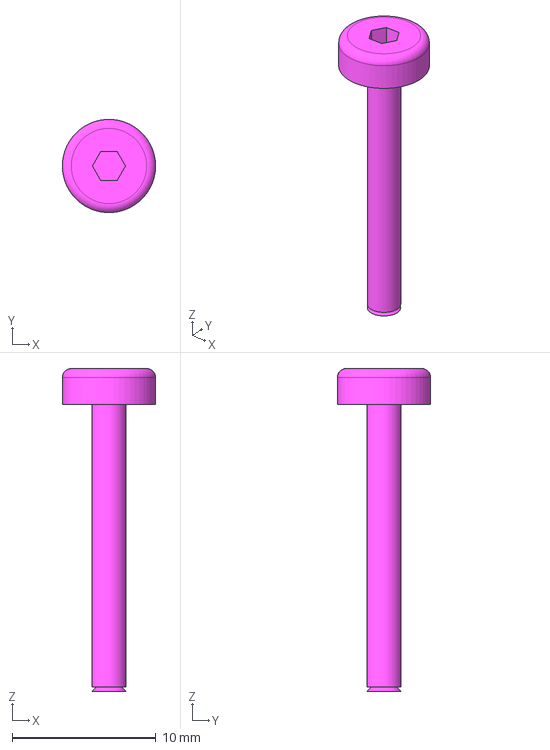
[picture p90: CAD file, 2026-11-03]
cad/v10 human editable/step_parts/M3_x_20_PAN.step
6.49 x 6.50 x 22.5 mm
