fernandomierhicks/omni-robot/cad/v10 human editable/validation/human/bearing_687.step

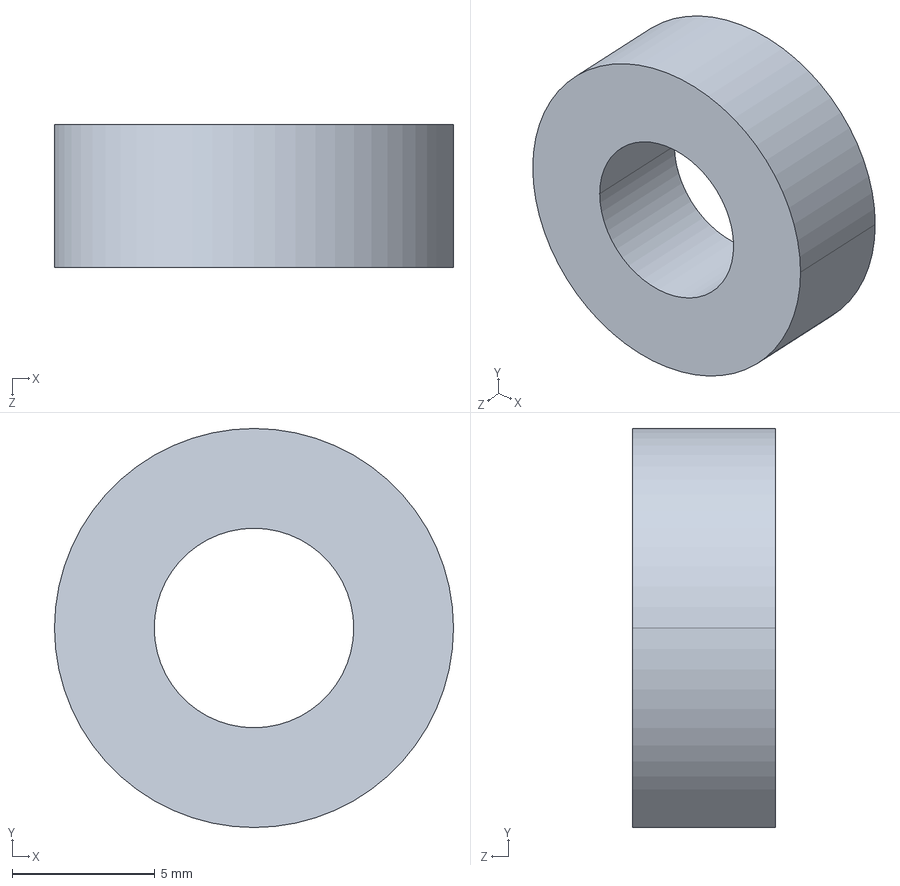
[picture p91: CAD file, 2026-11-03]
cad/v10 human editable/validation/human/bearing_687.step
14.0 x 14.0 x 5.00 mm
