fernandomierhicks/omni-robot/cad/v13/reference/imu_bno085.step

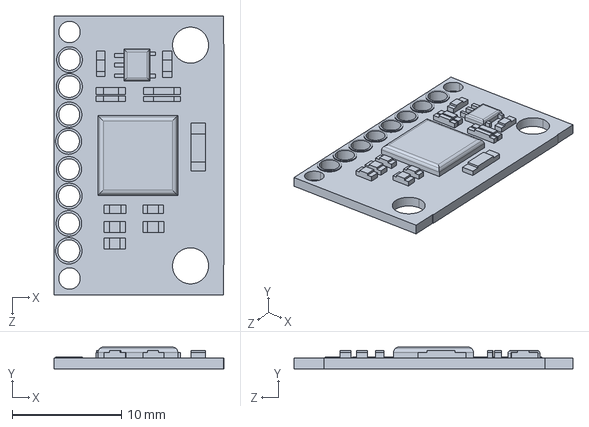
[picture p92: CAD file, 2026-11-06]
cad/v13/reference/imu_bno085.step
15.6 x 2.00 x 25.5 mm
