fernandomierhicks/omni-robot/cad/v13/reference/parts/SO-101_Wrist_Roll_Pitch_SO101.step

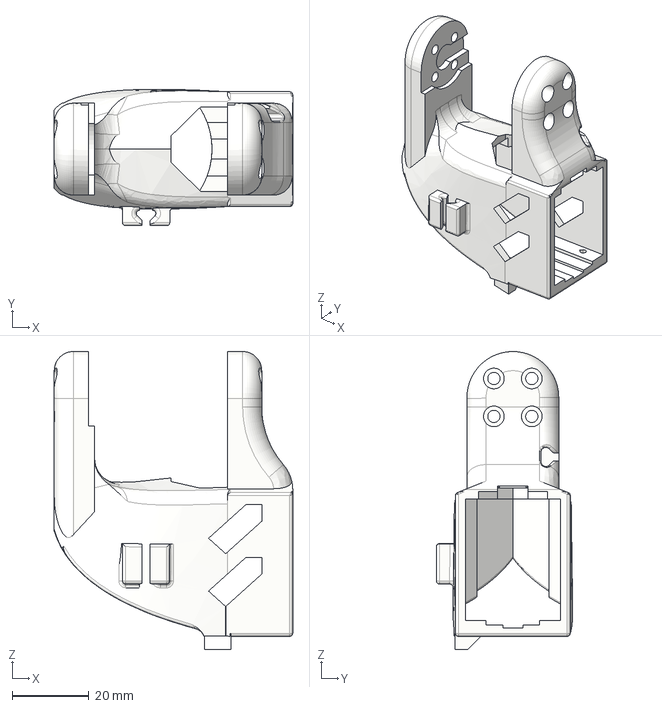
[picture p93: CAD file, 2026-11-09]
cad/v13/reference/parts/SO-101_Wrist_Roll_Pitch_SO101.step
62.3 x 35.6 x 77.8 mm
