fernandomierhicks/omni-robot/cad/v13/solidworks/parts/V13_plug_computer_3.SLDPRT

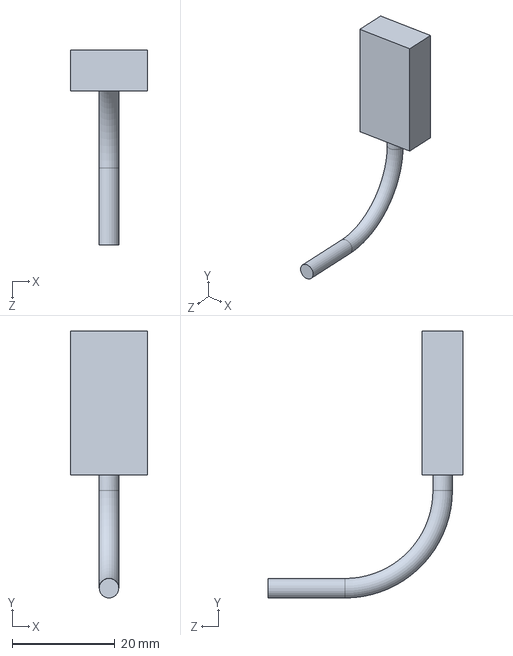
[picture p94: CAD file, 2026-11-09]
cad/v13/solidworks/parts/V13_plug_computer_3.SLDPRT
15.0 x 51.9 x 38.0 mm
