fernandomierhicks/omni-robot/cad/v13/solidworks/step_parts/xt30_pin_1_m.step

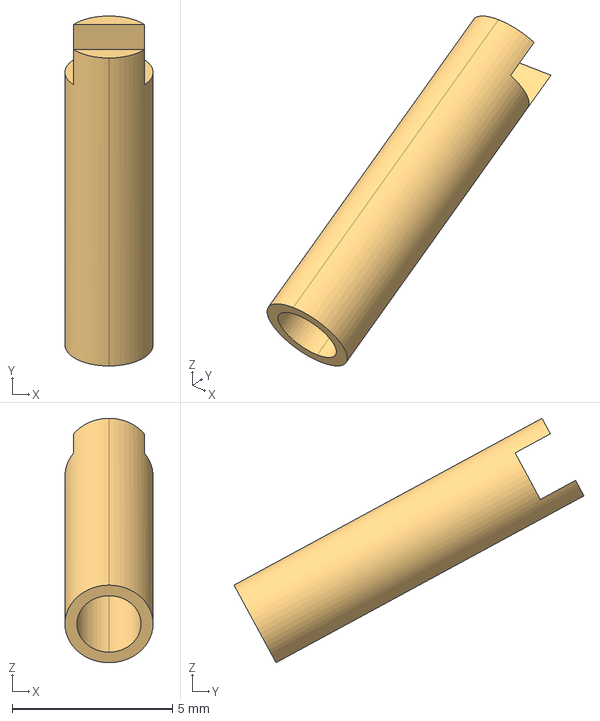
[picture p95: CAD file, 2026-11-09]
cad/v13/solidworks/step_parts/xt30_pin_1_m.step
2.75 x 10.9 x 7.62 mm
