fernandomierhicks/omni-robot/cad/v13/step_export/d435_mount_review.step

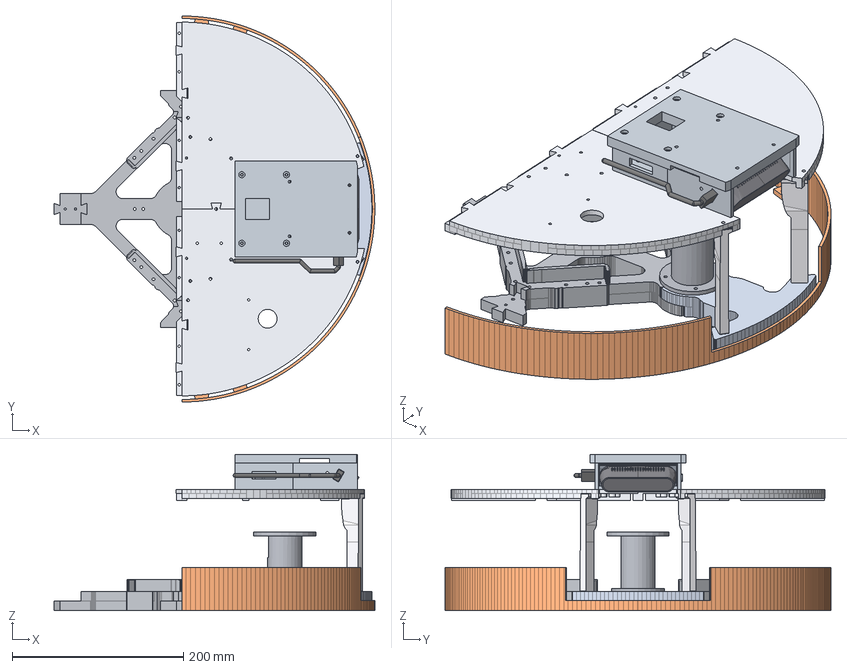
[picture p96: CAD file, 2026-11-06]
cad/v13/step_export/d435_mount_review.step
374.1 x 450.3 x 182.1 mm
chassis/hub
chassis/node_front
chassis/pedestal
chassis/bumper_q0
chassis/bumper_q3
chassis/support_front_L
chassis/support_front_R
upper/floor2_FL
upper/floor2_FR
upper/riser_adapter
upper/riser_arm
upper/bracket_d435_riser
vendor/d435
vendor/plug_d435
