fernandomierhicks/omni-robot/cad/v13/validation/imx662/imx662_fit_review.step

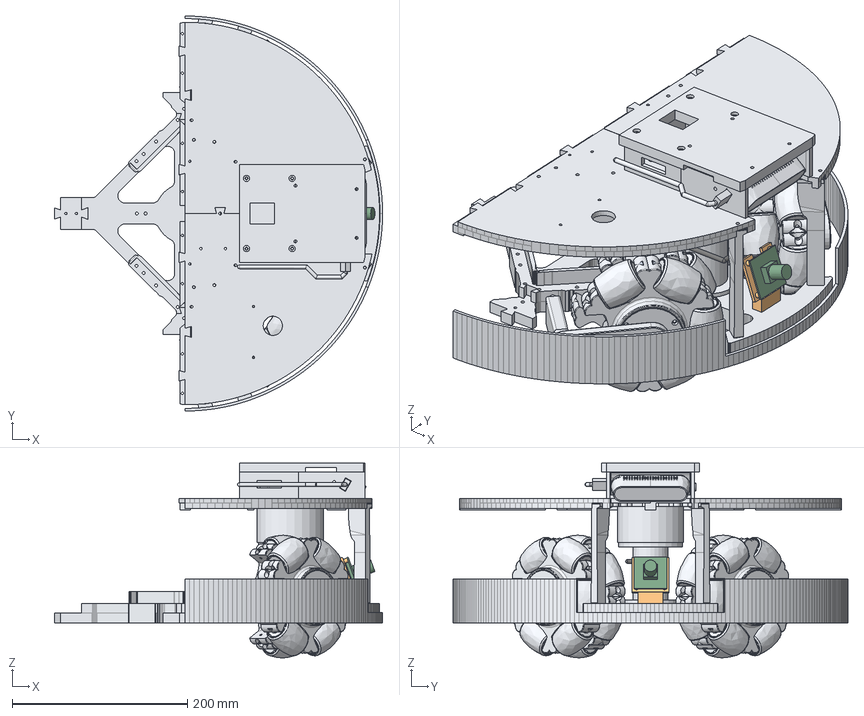
[picture p97: CAD file, 2026-11-07]
cad/v13/validation/imx662/imx662_fit_review.step
374.1 x 450.3 x 222.0 mm
floor2_FL
floor2_FR
riser_adapter
riser_arm
bracket_d435_riser
d435
plug_d435
hub
node_front
pedestal
bumper_q0
bumper_q3
support_front_L
support_front_R
env_lidar
FL_nom/wheel_hub
FL_nom/wheel_cartridge
FL_nom/ak40_stator
FL_nom/ak40_rotor
FL_nom/xt30_pin_2
FL_nom/lead_pos
FL_nom/roller_core_1_2
FL_nom/roller_tread_1_2
FL_nom/roller_core_1_3
FL_nom/roller_tread_1_3
FL_nom/roller_core_1_4
FL_nom/roller_tread_1_4
FL_nom/roller_core_1_5
FL_nom/roller_tread_1_5
FL_nom/roller_core_1_6
FL_nom/roller_tread_1_6
FL_nom/roller_core_2_2
FL_nom/roller_tread_2_2
FL_nom/roller_core_2_3
FL_nom/roller_tread_2_3
FL_nom/roller_core_2_4
FL_nom/roller_tread_2_4
FL_nom/roller_core_2_5
FL_nom/roller_tread_2_5
FL_nom/pod_fork_outer
FR_nom/wheel_hub
FR_nom/wheel_cartridge
FR_nom/ak40_stator
FR_nom/ak40_rotor
FR_nom/xt30_pin_2
FR_nom/lead_pos
FR_nom/roller_core_1_2
FR_nom/roller_tread_1_2
FR_nom/roller_core_1_3
FR_nom/roller_tread_1_3
FR_nom/roller_core_1_4
FR_nom/roller_tread_1_4
FR_nom/roller_core_1_5
FR_nom/roller_tread_1_5
FR_nom/roller_core_1_6
FR_nom/roller_tread_1_6
FR_nom/roller_core_2_2
FR_nom/roller_tread_2_2
FR_nom/roller_core_2_3
FR_nom/roller_tread_2_3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
