fernandomierhicks/omni-robot/components/ak40-10/AK40-10 with connector.STEP

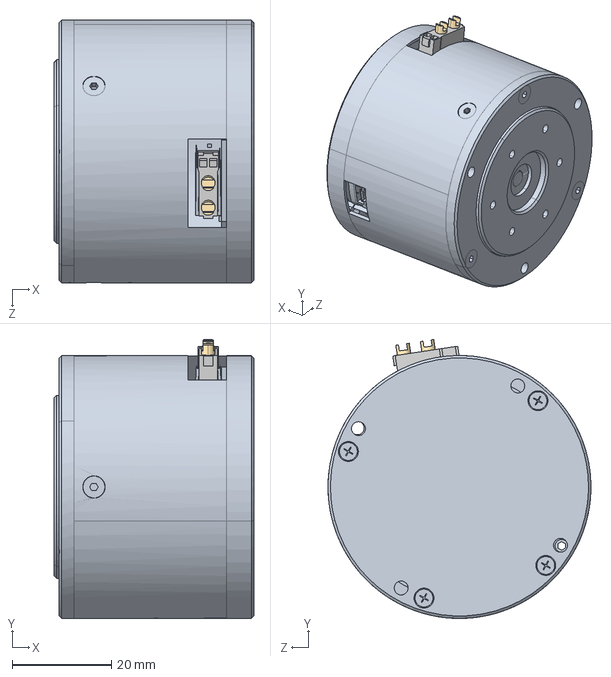
[picture p98: CAD file, 2026-11-03]
components/ak40-10/AK40-10 with connector.STEP
40.2 x 56.2 x 53.0 mm
ak40_real_motor_2.step.SLDPRT
XT30(2+2).step
