fernandomierhicks/omni-robot/cad/other/d435_nose/out/d435_wedge.stl

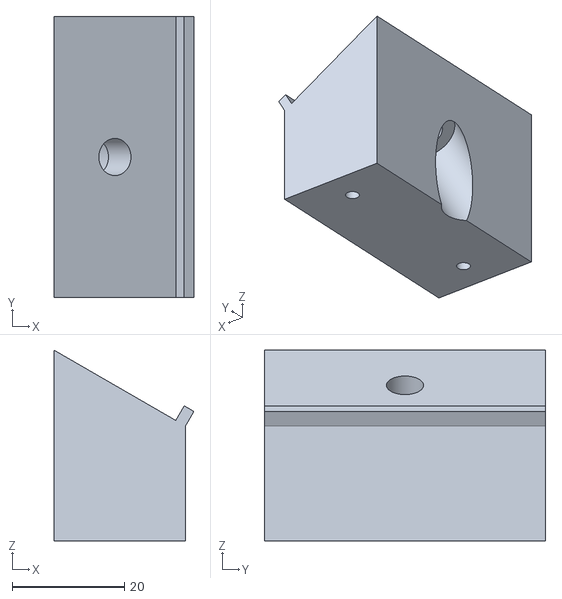
[picture p99: CAD file, 2026-11-03]
cad/other/d435_nose/out/d435_wedge.stl
24.9 x 50.0 x 33.9
