fernandomierhicks/omni-robot/cad/out/step/lidar_riser.step

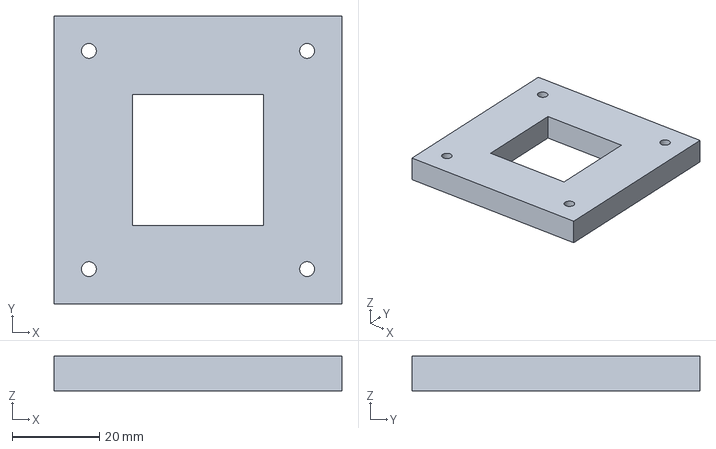
[picture p100: CAD file, 2026-10-20]
cad/out/step/lidar_riser.step
66.0 x 66.0 x 8.00 mm
