fernandomierhicks/omni-robot/cad/v10 human editable/parts/human/V10H_pivot_shim.SLDPRT

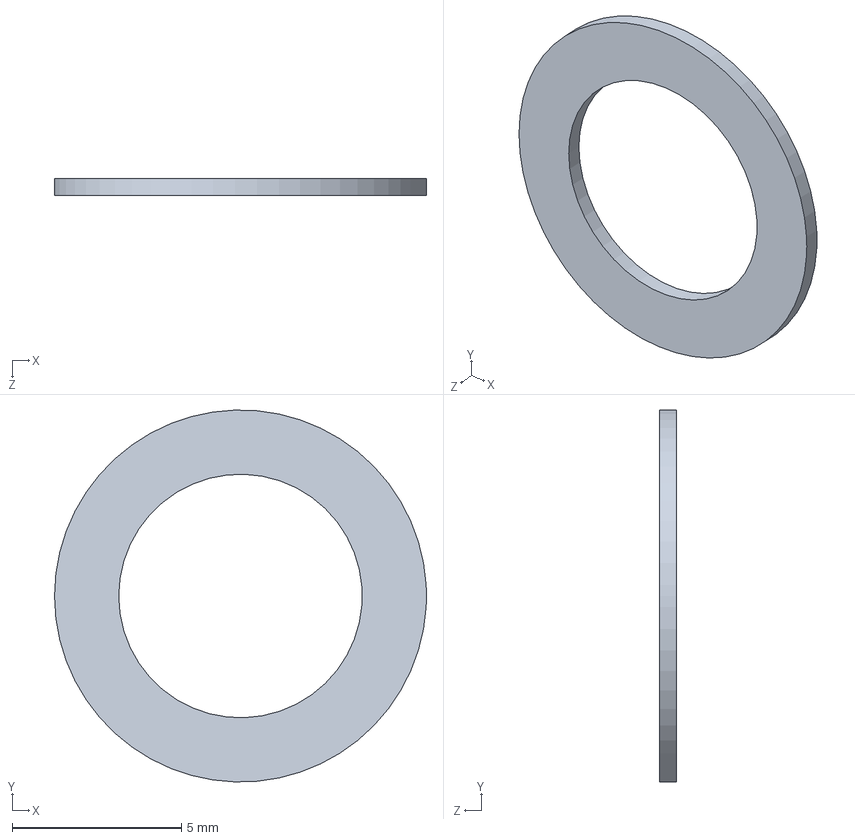
[picture p101: CAD file, 2026-11-03]
cad/v10 human editable/parts/human/V10H_pivot_shim.SLDPRT
11.0 x 11.0 x 0.5 mm
