fernandomierhicks/omni-robot/cad/v10 human editable/print/human/pivot_outer_spacer.stl

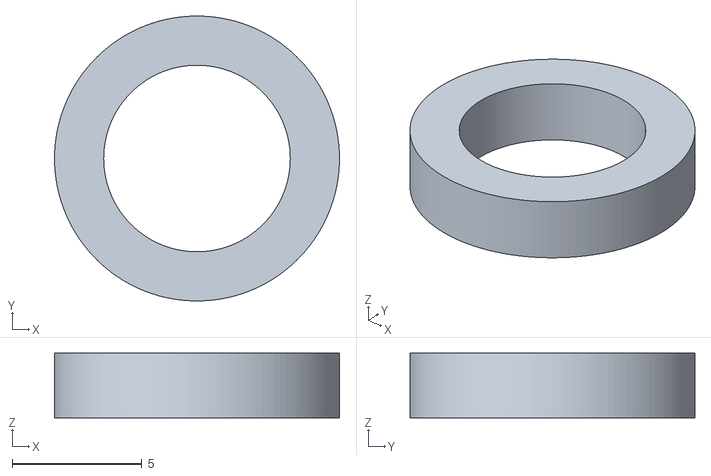
[picture p102: CAD file, 2026-11-03]
cad/v10 human editable/print/human/pivot_outer_spacer.stl
11.0 x 11.0 x 2.50
