fernandomierhicks/omni-robot/cad/v10 human editable/step_export/dummy_motor/V10H_dummy_motor_rotor.step

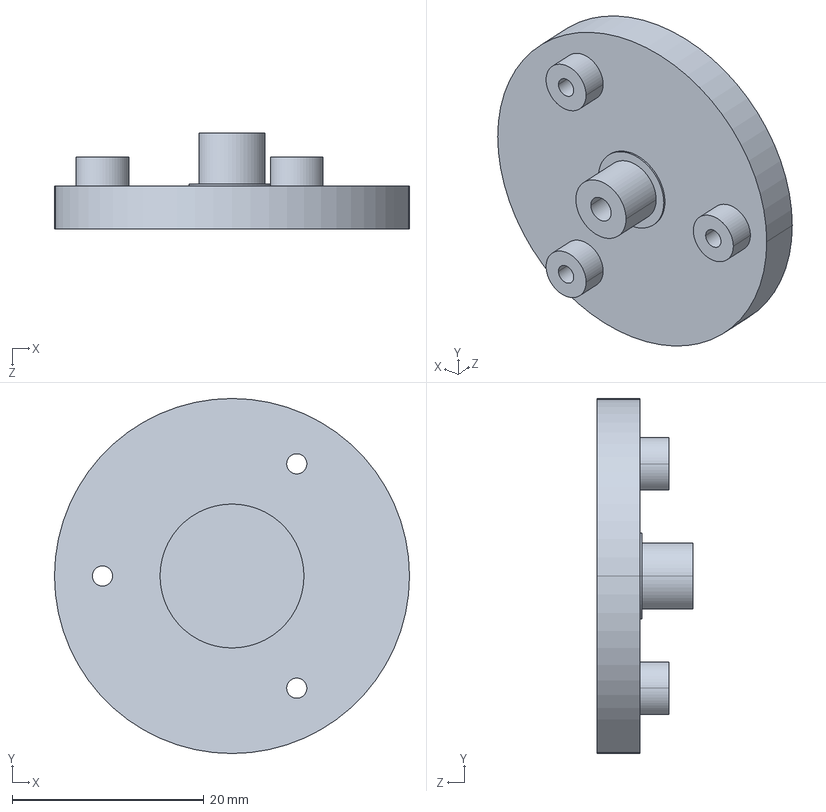
[picture p103: CAD file, 2026-11-03]
cad/v10 human editable/step_export/dummy_motor/V10H_dummy_motor_rotor.step
37.0 x 37.0 x 10.0 mm
