fernandomierhicks/omni-robot/cad/v10 human editable/step_export/level_pivot/parts/V10H_bench_plate.step

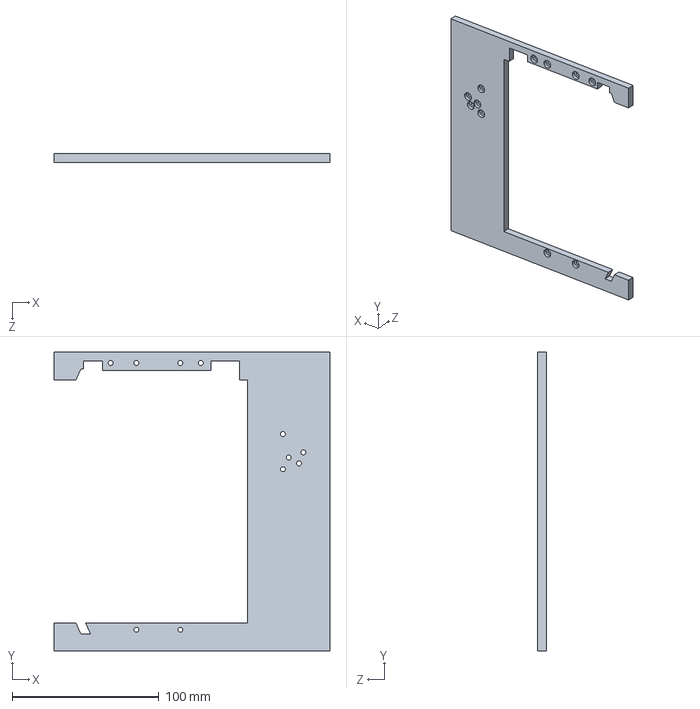
[picture p104: CAD file, 2026-11-03]
cad/v10 human editable/step_export/level_pivot/parts/V10H_bench_plate.step
188.0 x 204.0 x 6.00 mm
