fernandomierhicks/omni-robot/cad/v10 human editable/step_export/wheel_no_hubs/parts/V10H_roller_tread.step

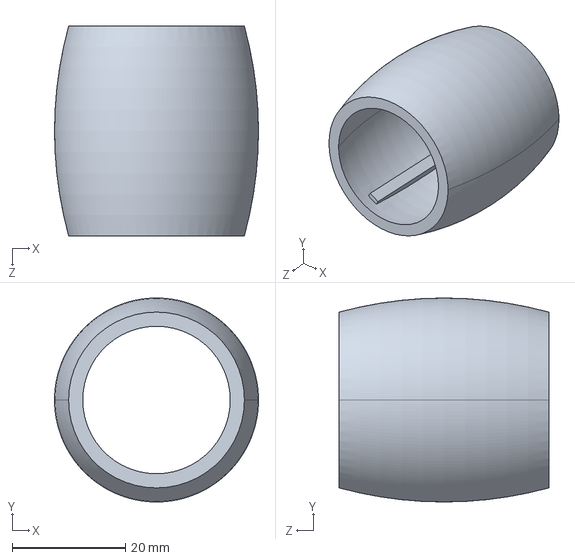
[picture p105: CAD file, 2026-11-03]
cad/v10 human editable/step_export/wheel_no_hubs/parts/V10H_roller_tread.step
36.0 x 36.0 x 37.0 mm
