fernandomierhicks/omni-robot/cad/v10 human editable/step_parts/M2_x_6_PAN.step

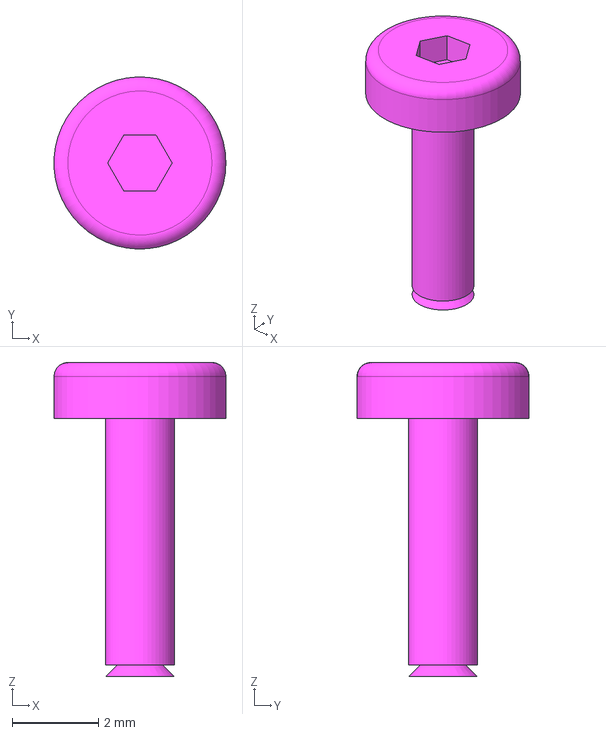
[picture p106: CAD file, 2026-11-03]
cad/v10 human editable/step_parts/M2_x_6_PAN.step
4.00 x 4.00 x 7.30 mm
