fernandomierhicks/omni-robot/cad/v10 human editable/validation/hub_A_extra.step

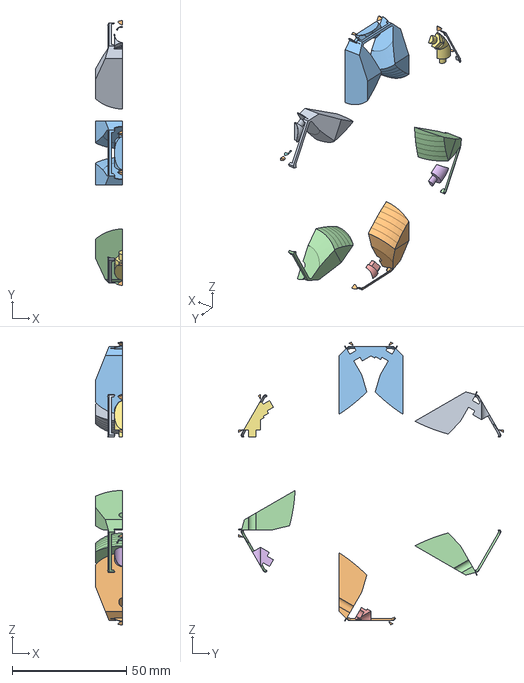
[picture p107: CAD file, 2026-11-03]
cad/v10 human editable/validation/hub_A_extra.step
12.0 x 116.0 x 124.0 mm
