fernandomierhicks/omni-robot/cad/v13/reference/parts/SO-101_STS3215_03a__2.step

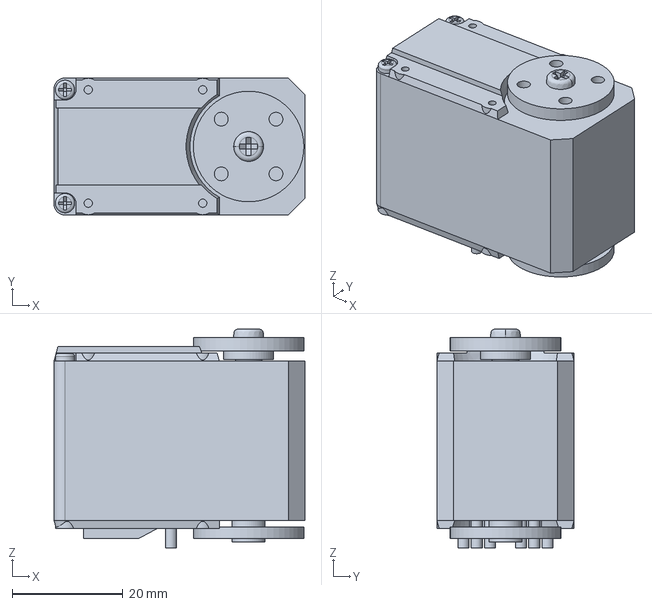
[picture p108: CAD file, 2026-11-09]
cad/v13/reference/parts/SO-101_STS3215_03a__2.step
45.4 x 24.8 x 39.6 mm
