fernandomierhicks/omni-robot/cad/v13/solidworks/parts/V13_fst_M3x12_flat.SLDPRT

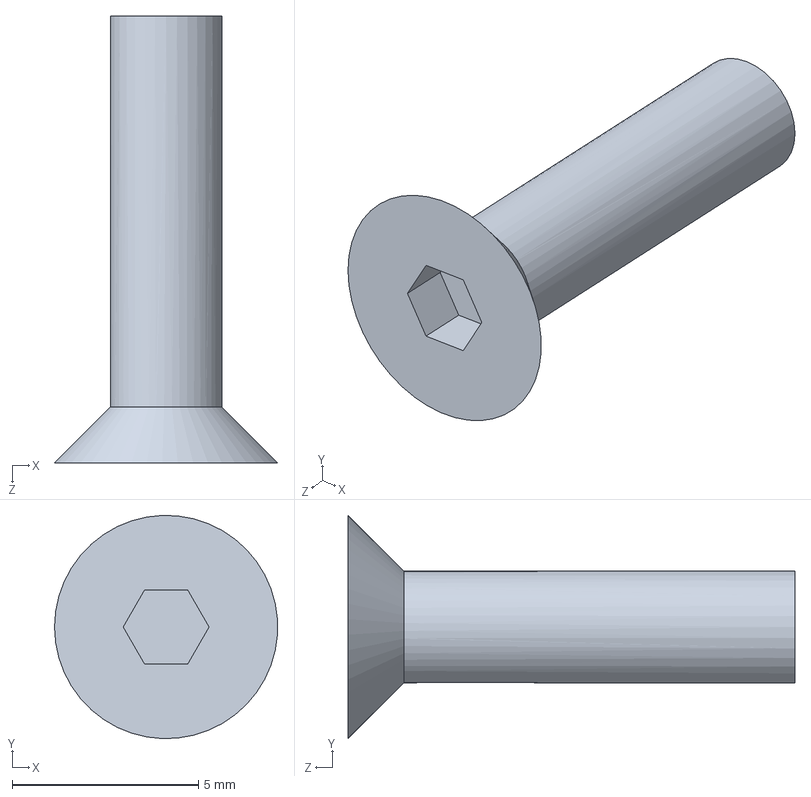
[picture p109: CAD file, 2026-11-09]
cad/v13/solidworks/parts/V13_fst_M3x12_flat.SLDPRT
5.99 x 6.00 x 12.0 mm
