fernandomierhicks/omni-robot/cad/v13/solidworks/step_parts/fst_M3x50_pan.step

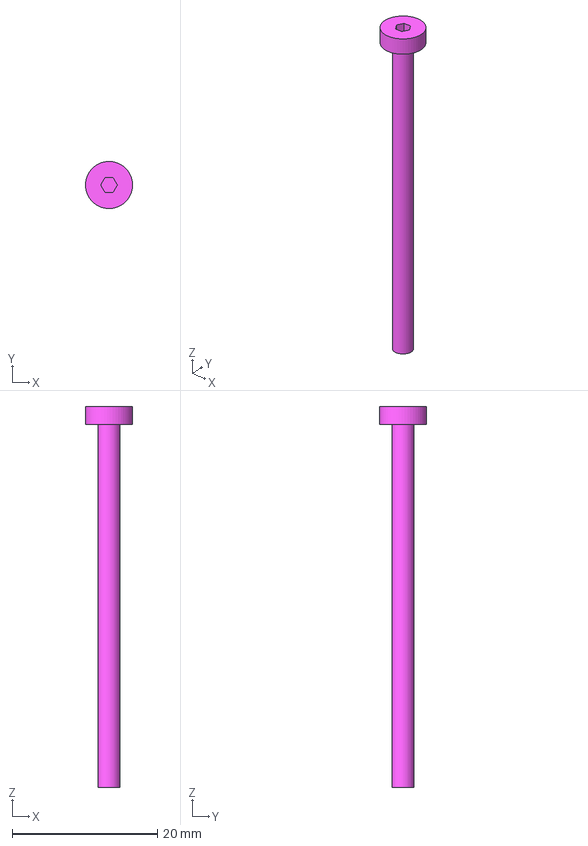
[picture p110: CAD file, 2026-11-09]
cad/v13/solidworks/step_parts/fst_M3x50_pan.step
6.49 x 6.50 x 52.5 mm
