fernandomierhicks/omni-robot/cad/v13/validation/imx662/imx662_module.step

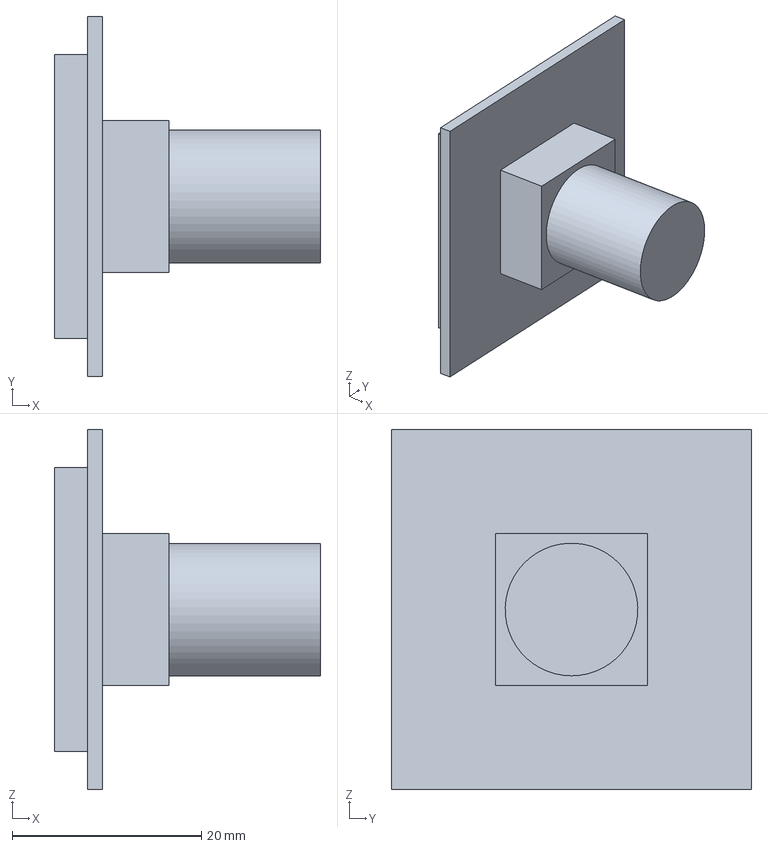
[picture p111: CAD file, 2026-11-07]
cad/v13/validation/imx662/imx662_module.step
28.1 x 38.0 x 38.0 mm
