fernandomierhicks/omni-robot/components/ak40-10/XT30(2+2).STEP

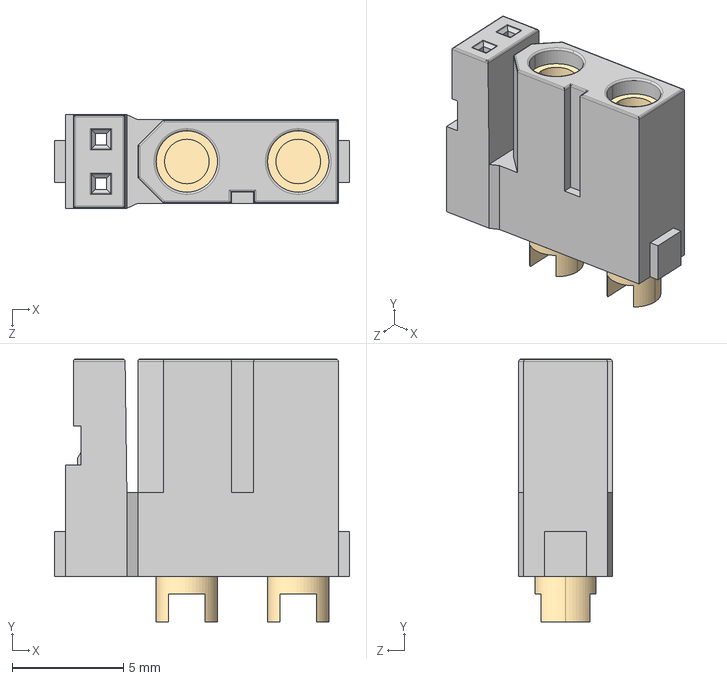
[picture p112: CAD file, 2026-11-03]
components/ak40-10/XT30(2+2).STEP
13.2 x 11.8 x 4.20 mm
