fernandomierhicks/omni-robot/cad/other/Realsense to bucket/holder.SLDPRT

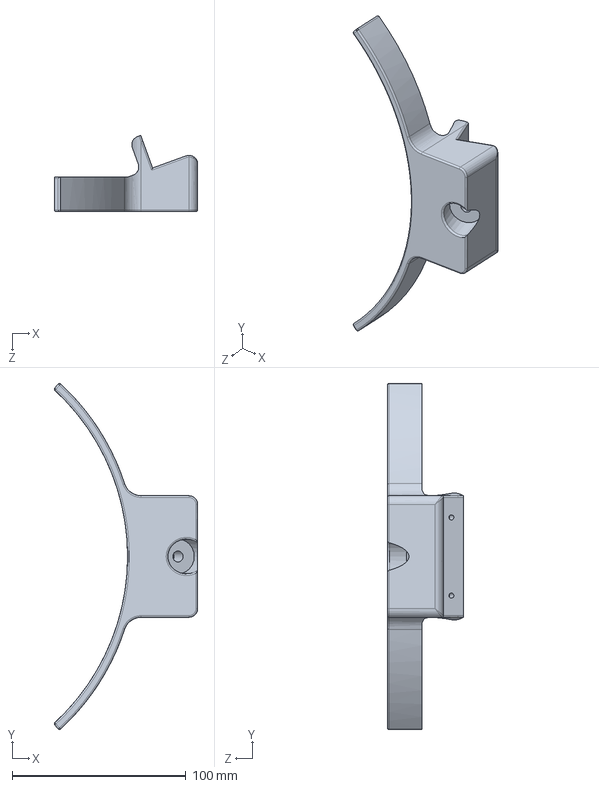
[picture p113: CAD file, 2026-11-03]
cad/other/Realsense to bucket/holder.SLDPRT
82.6 x 199.2 x 43.9 mm
