fernandomierhicks/omni-robot/cad/out/step/funnel_rim_arc_2.step

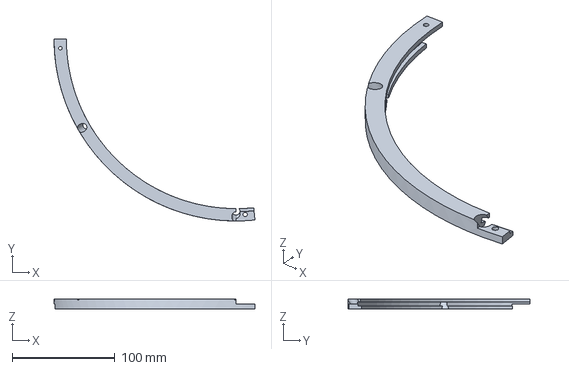
[picture p114: CAD file, 2026-10-20]
cad/out/step/funnel_rim_arc_2.step
195.5 x 177.0 x 10.0 mm
