fernandomierhicks/omni-robot/cad/v10 human editable/parts/step/SO-101_WaveShare_Mounting_Plate_SO101.SLDPRT

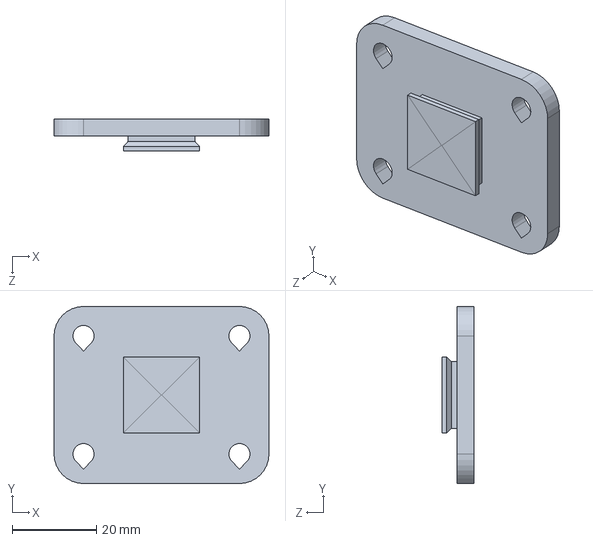
[picture p115: CAD file, 2026-11-03]
cad/v10 human editable/parts/step/SO-101_WaveShare_Mounting_Plate_SO101.SLDPRT
51.0 x 42.0 x 7.60 mm
