fernandomierhicks/omni-robot/cad/v10 human editable/parts/V10_pod_mount.SLDPRT

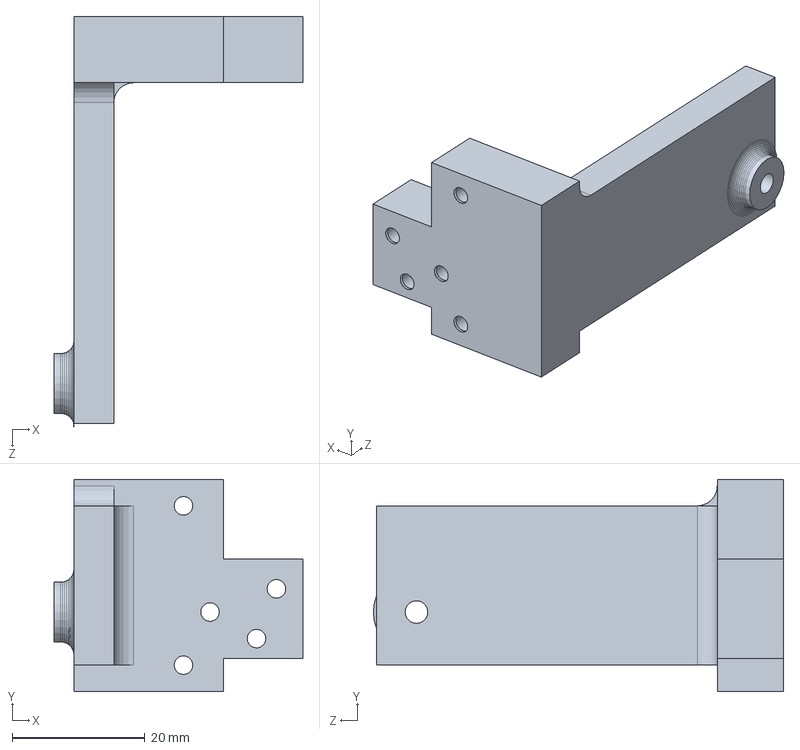
[picture p116: CAD file, 2026-11-03]
cad/v10 human editable/parts/V10_pod_mount.SLDPRT
37.5 x 32.0 x 61.8 mm
