fernandomierhicks/omni-robot/cad/v10 human editable/print/dummy_motor_rotor.stl

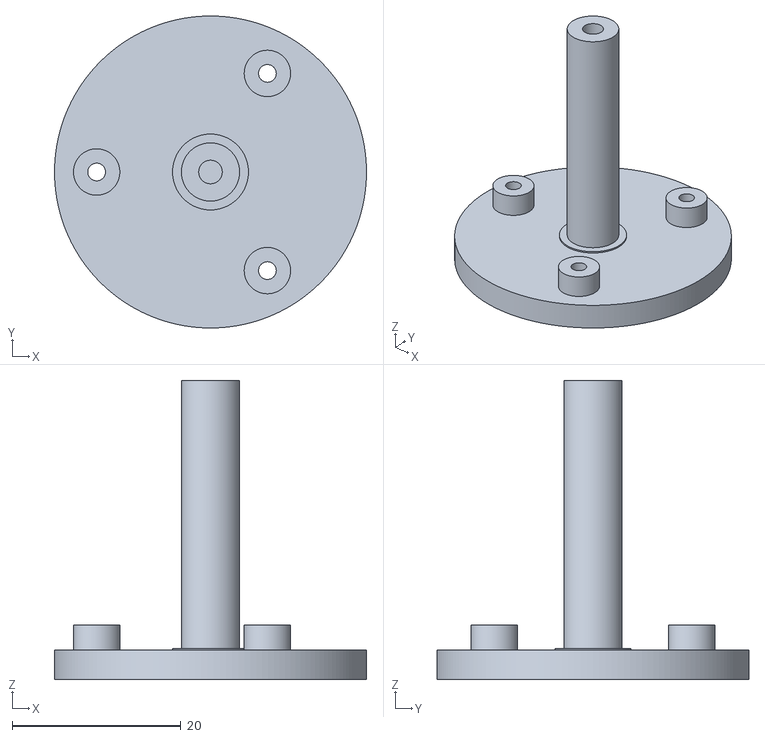
[picture p117: CAD file, 2026-11-03]
cad/v10 human editable/print/dummy_motor_rotor.stl
37.0 x 37.0 x 35.5
