fernandomierhicks/omni-robot/cad/v10 human editable/print/human/outer_fork_6804.stl

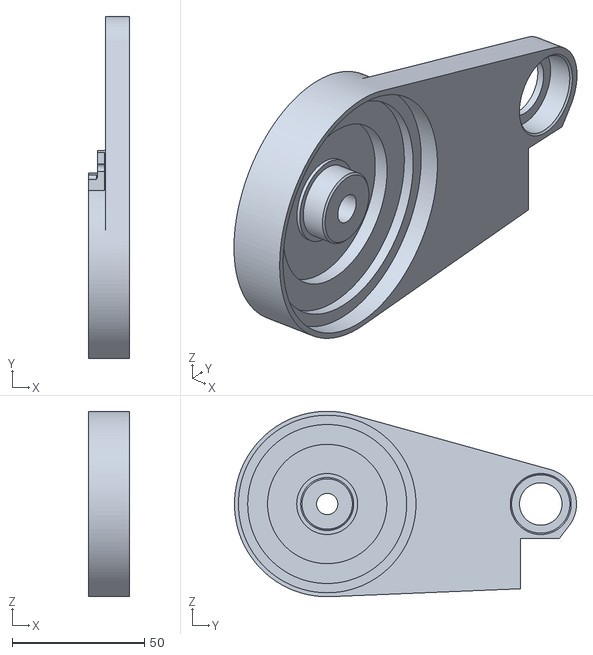
[picture p118: CAD file, 2026-11-03]
cad/v10 human editable/print/human/outer_fork_6804.stl
15.5 x 129.1 x 70.0
