fernandomierhicks/omni-robot/cad/v10 human editable/step_export/level_pivot/parts/REC_deck_left_outer_pivot.step

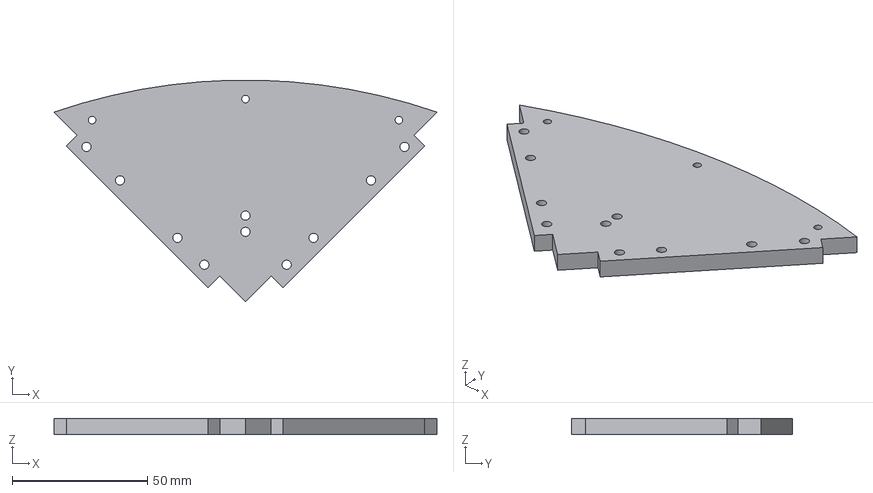
[picture p119: CAD file, 2026-11-03]
cad/v10 human editable/step_export/level_pivot/parts/REC_deck_left_outer_pivot.step
141.4 x 81.7 x 6.00 mm
