fernandomierhicks/omni-robot/cad/v10 human editable/step_export/wheel_motor_v2/parts/bearing_6804_left.step

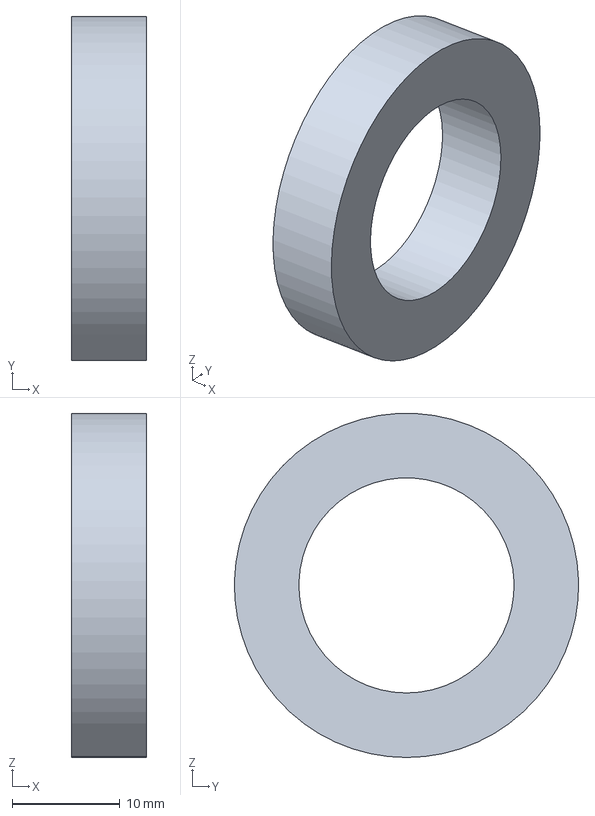
[picture p120: CAD file, 2026-11-03]
cad/v10 human editable/step_export/wheel_motor_v2/parts/bearing_6804_left.step
7.00 x 32.0 x 32.0 mm
