fernandomierhicks/omni-robot/cad/v10 human editable/step_export/wheel_no_hubs/parts/V10H_roller_core.step

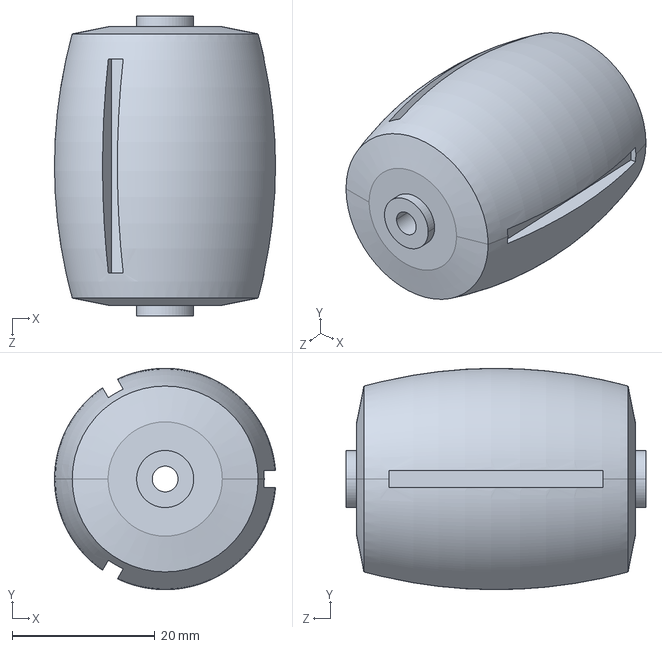
[picture p121: CAD file, 2026-11-03]
cad/v10 human editable/step_export/wheel_no_hubs/parts/V10H_roller_core.step
31.0 x 31.0 x 42.0 mm
