fernandomierhicks/omni-robot/cad/v10 human editable/step_parts/switch_riser.step

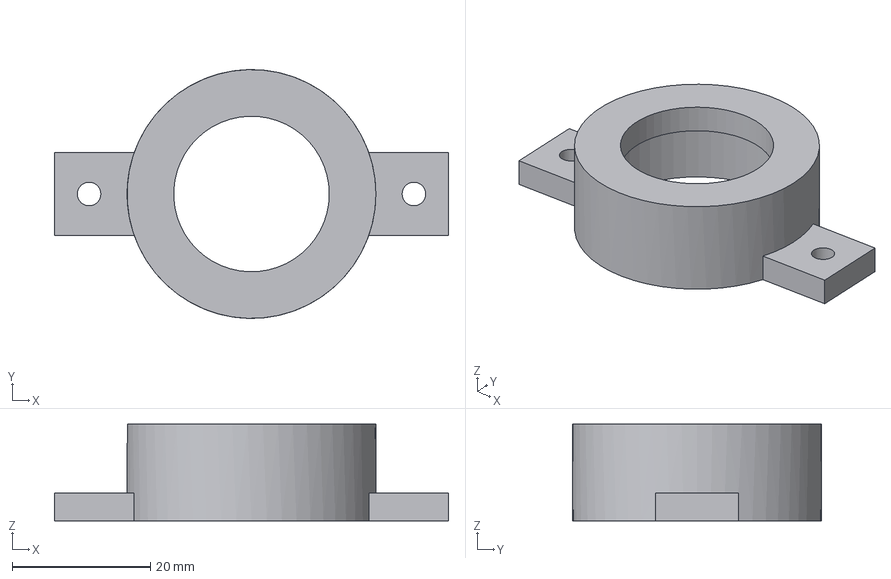
[picture p122: CAD file, 2026-11-03]
cad/v10 human editable/step_parts/switch_riser.step
57.0 x 36.0 x 14.0 mm
