fernandomierhicks/omni-robot/cad/v10 human editable/validation/human/pod_mount.step

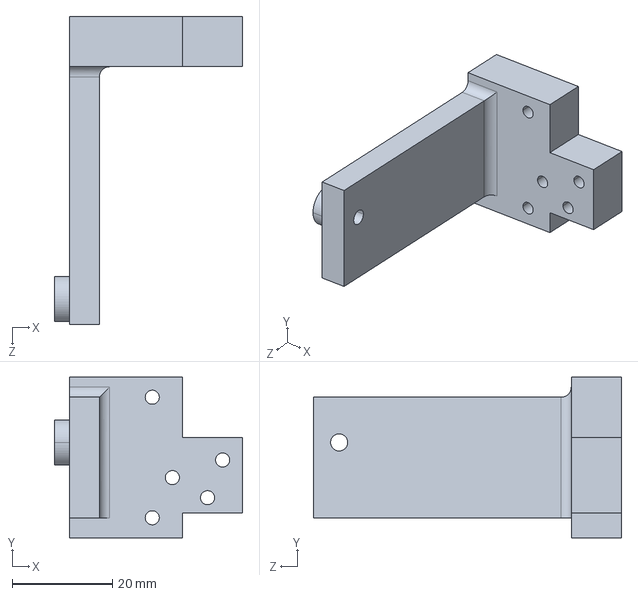
[picture p123: CAD file, 2026-11-03]
cad/v10 human editable/validation/human/pod_mount.step
37.5 x 32.0 x 61.3 mm
