fernandomierhicks/omni-robot/cad/v13/reference/parts/d435_source.step

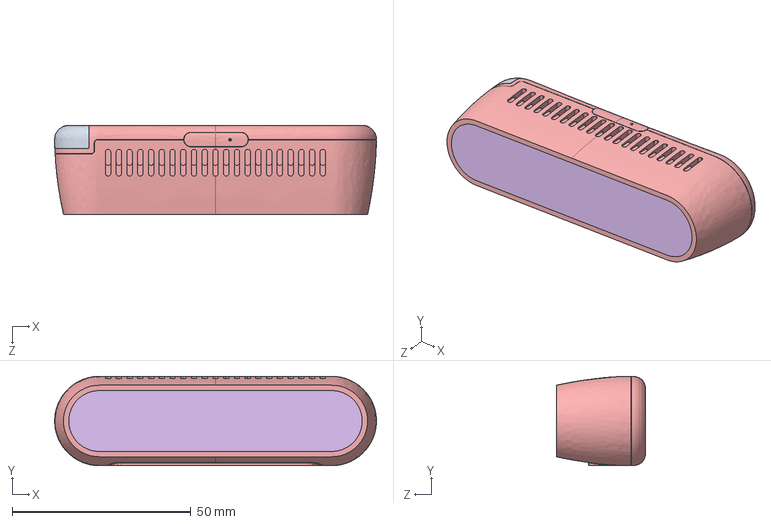
[picture p124: CAD file, 2026-11-09]
cad/v13/reference/parts/d435_source.step
90.0 x 25.0 x 25.0 mm
