fernandomierhicks/omni-robot/cad/v13/solidworks/parts/V13_die_spring_inner_a1_m.SLDPRT

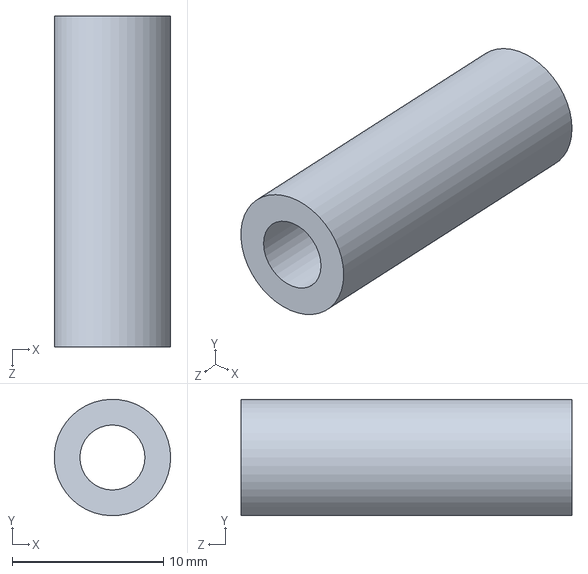
[picture p125: CAD file, 2026-11-09]
cad/v13/solidworks/parts/V13_die_spring_inner_a1_m.SLDPRT
7.69 x 7.69 x 21.9 mm
