fernandomierhicks/omni-robot/cad/v10 human editable/V10H_wheel_pod.SLDASM

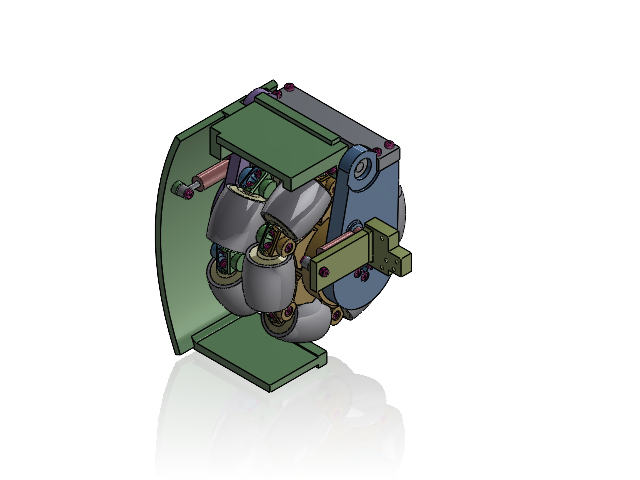
[picture p126: CAD file, 2026-11-03]
cad/v10 human editable/V10H_wheel_pod.SLDASM
V10H_wheel_guard
V10H_pod_mount
V10H_pivot_shaft
V10H_pivot_shim
V10H_pivot_outer_spacer
V10H_bolt_M3_16_PAN x 3
V10H_inner_fork_6804
V10H_outer_fork_6804
V10H_motor_cup
V10H_fork_bar
V10H_bolt_M3_25_PAN x 4
V10H_bearing_627 x 2
V10H_bolt_M3_18_PAN x 16
V10H_wheel_hub_B
V10H_wheel_hub_A
V10H_wheel_hub_C
V10H_wheel_cartridge
V10H_bolt_M3_50_PAN x 12
V10H_nut_M3_hex x 12
V10H_bearing_6804 x 2
V10H_bolt_M3_12_PAN x 3
V10H_roller_core x 12
V10H_roller_tread x 12
V10H_dummy_motor_stator
V10H_bearing_687
V10H_dummy_motor_rotor
V10H_washer_M3_large
V10H_bolt_M3_8_PAN
V10H_shock_case x 2
V10H_shock_rod x 2
V10H_bolt_M2p5_10_PAN x 7
V10H_washer_M3
V10H_bolt_M3_14_PAN
V10H_bolt_M3_20_PAN
V10H_nut_M3_nyloc
