fernandomierhicks/omni-robot/cad/other/Realsense to bucket/Assem1.SLDASM

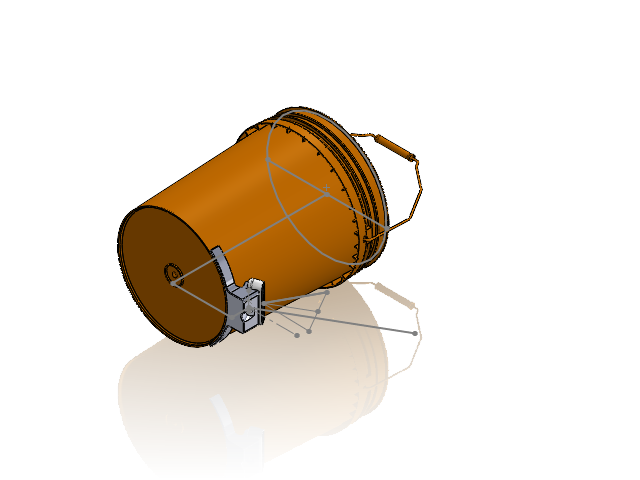
[picture p127: CAD file, 2026-11-03]
cad/other/Realsense to bucket/Assem1.SLDASM
holder
IntelRealsense_D435_Multibody
Bucket
