fernandomierhicks/omni-robot/cad/v10 human editable/V10H_dummy_motor.SLDASM

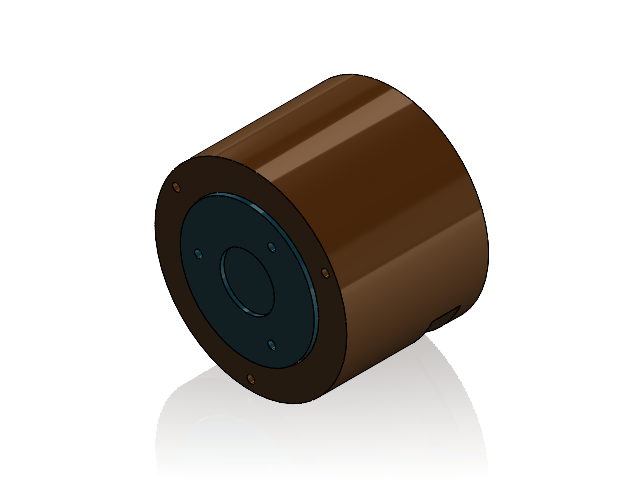
[picture p128: CAD file, 2026-11-03]
cad/v10 human editable/V10H_dummy_motor.SLDASM
V10H_dummy_motor_stator
V10H_bearing_687
V10H_dummy_motor_rotor
V10H_washer_M3_large
V10H_bolt_M3_8_PAN
