fernandomierhicks/omni-robot/cad/v10 human editable/assemblies/V10H_pod_roller.SLDASM

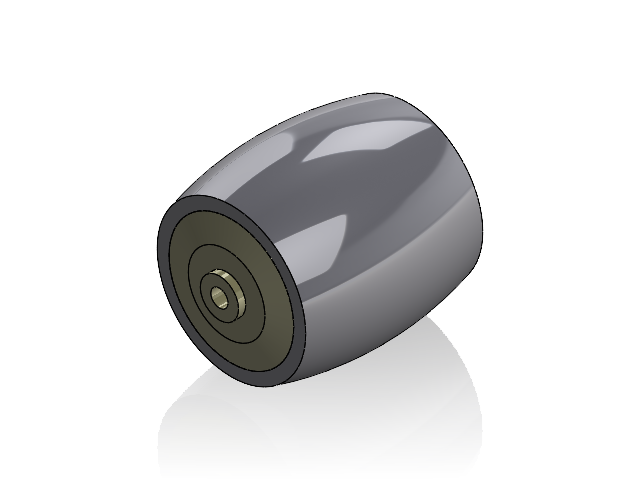
[picture p129: CAD file, 2026-11-03]
cad/v10 human editable/assemblies/V10H_pod_roller.SLDASM
V10H_roller_core
V10H_roller_tread
