fernandomierhicks/omni-robot/cad/v10 human editable/V10_wheel_pod.SLDASM

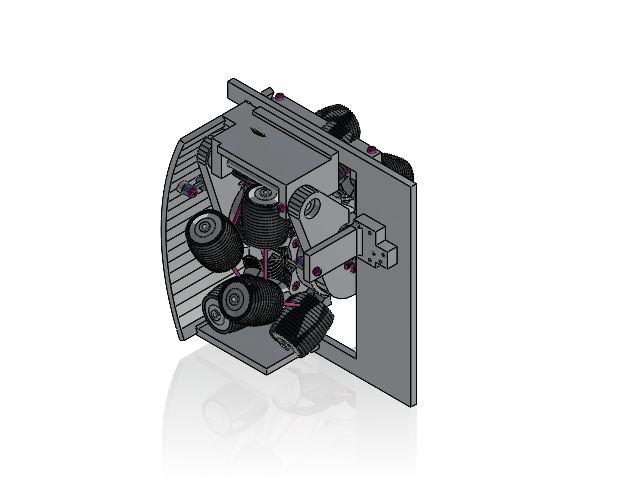
[picture p130: CAD file, 2026-11-03]
cad/v10 human editable/V10_wheel_pod.SLDASM
V10_bench_plate
V10_wheel_guard
V10_pod_mount
V10_pivot_shaft
V10_pivot_shim
V10_pivot_outer_spacer
V10_inner_fork_6804
V10_outer_fork_6804
V10_motor_cup
V10_fork_bar
V10_wheel_hub_B
V10_wheel_hub_A
V10_wheel_hub_C
V10_wheel_cartridge
V10_dummy_motor_case
V10_dummy_motor_rear_cap
V10_dummy_motor_rotor
V10_dummy_motor_retainer
V10_bearing_687 x 2
V10_bolt_M3_50_PAN x 12
V10_nut_M3_hex x 12
V10_bolt_M3_18_PAN x 16
V10_bolt_M2p5_10_PAN x 7
V10_bearing_6804 x 2
V10_bolt_M3_12_PAN x 8
V10_bolt_M3_25_PAN x 5
V10_bearing_627 x 2
V10_washer_M3
V10_bolt_M3_14_PAN
V10_bolt_M3_16_PAN x 2
V10_bolt_M3_20_PAN
V10_nut_M3_nyloc
V10_bolt_M3_10_PAN x 6
V10_bolt_M3_12_FLAT x 4
V10_bolt_M3_8_PAN
V10_roller_core x 12
V10_roller_tread x 12
V10_shock_case x 2
V10_shock_rod x 2
