fernandomierhicks/omni-robot/cad/v10 human editable/assemblies/V10H_arm_link1_shoulder.SLDASM

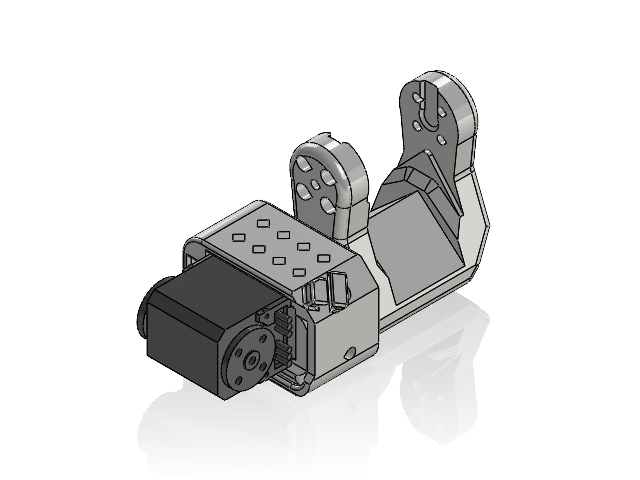
[picture p132: CAD file, 2026-11-03]
cad/v10 human editable/assemblies/V10H_arm_link1_shoulder.SLDASM
SO-101_STS3215_03a
SO-101_Motor_holder_SO101_Base
SO-101_Rotation_Pitch_SO101
