fernandomierhicks/omni-robot/cad/v10 human editable/V10_dummy_motor.SLDASM

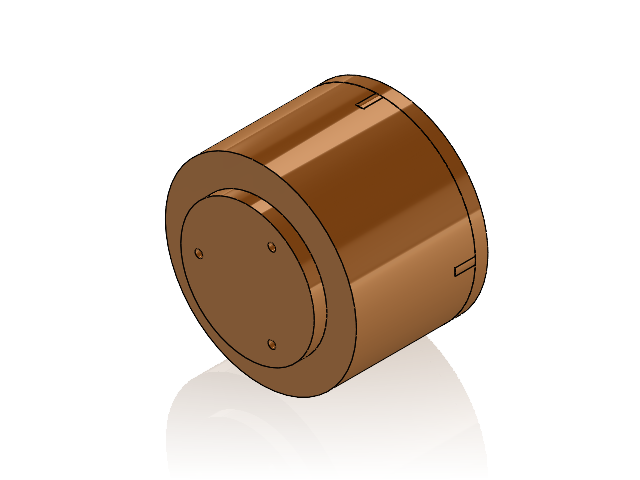
[picture p133: CAD file, 2026-11-03]
cad/v10 human editable/V10_dummy_motor.SLDASM
V10_dummy_motor_case
V10_dummy_motor_rear_cap
V10_bearing_687 x 2
V10_dummy_motor_rotor
V10_dummy_motor_retainer
V10_bolt_M3_12_FLAT x 4
V10_bolt_M3_8_PAN
