fernandomierhicks/omni-robot/cad/v10 human editable/V10H_robot_FOV_side.SLDASM

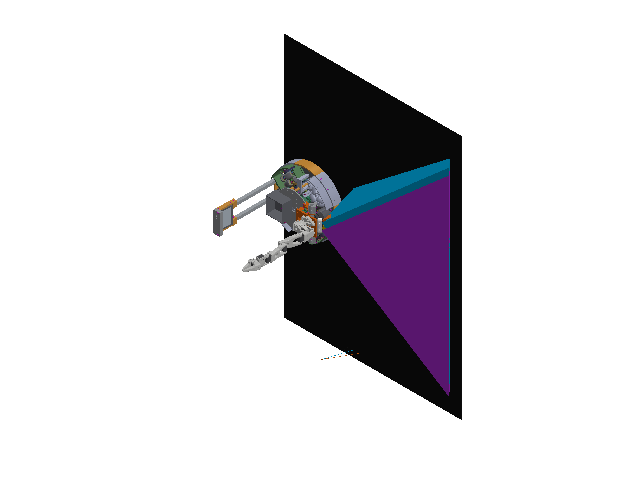
[picture p136: CAD file, 2026-11-03]
cad/v10 human editable/V10H_robot_FOV_side.SLDASM
deck_centre
deck_front
REC_deck_left_outer_pivot
deck_rear
REC_deck_right_outer_pivot
deck_splice x 2
battery_tray
payload_plate
lidar_riser
switch_riser
payload_ports
standoff x 4
standoff_rod_8_x_104.5 x 2
pin_4_x_16 x 2
REC_deck_left_inner_pivot
REC_deck_right_inner_pivot
REC_deck_bridge x 2
bumper_lobe x 3
bumper_lobe_rear
REC_bumper_corner_pivot x 4
board_spacer x 4
battery_7S1P_P50B
label_BATTERY_7S1P_5Ah
Jetson_Orin_Nano_Super_dev_kit
label_JETSON_ORIN_NANO
power_board
label_POWER_BOARD
MCU_carrier
label_MCU_+_IMU
BMS
label_BMS_7S_40A
19_V_buck
label_19V_BUCK
5_V_buck
label_5V_BUCK
XT30_panel_socket
Micro-Fit_2x6_panel_socket
USB-C_panel_socket
RPLIDAR_A2M12
label_LIDAR_A2M12
on_off_switch_22_mm
M3_x_12_PAN x 28
M3_x_14_PAN x 64
M3_x_14_FLAT x 6
M3_x_10_PAN x 74
M2.5_x_8_PAN x 4
mast_foot_L
mast_foot_R
crown
face_housing
face_back
audio_base
audio_lid
REC_mast_post x 2
ELRS_receiver
label_ELRS_RX
5_in_display_800x480
polycarbonate_window_2_mm
USB_mic_array
label_MIC_ARRAY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
