fernandomierhicks/omni-robot/cad/v10 human editable/assemblies/V10H_arm_link2_upper_arm.SLDASM

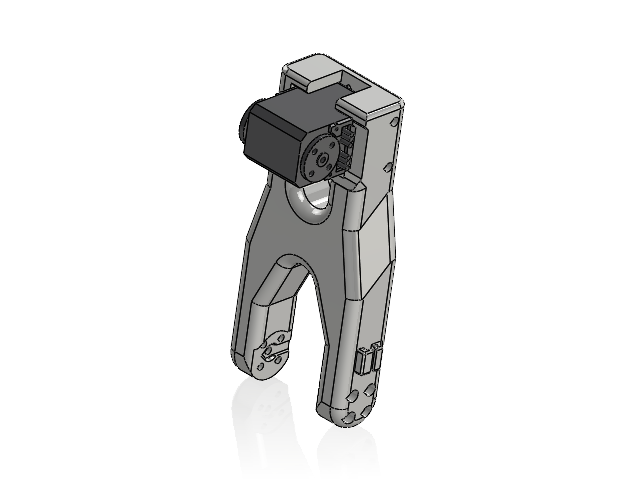
[picture p138: CAD file, 2026-11-03]
cad/v10 human editable/assemblies/V10H_arm_link2_upper_arm.SLDASM
SO-101_STS3215_03a
SO-101_Upper_arm_SO101
