fernandomierhicks/omni-robot/cad/v10 human editable/assemblies/V10H_pod_fork.SLDASM

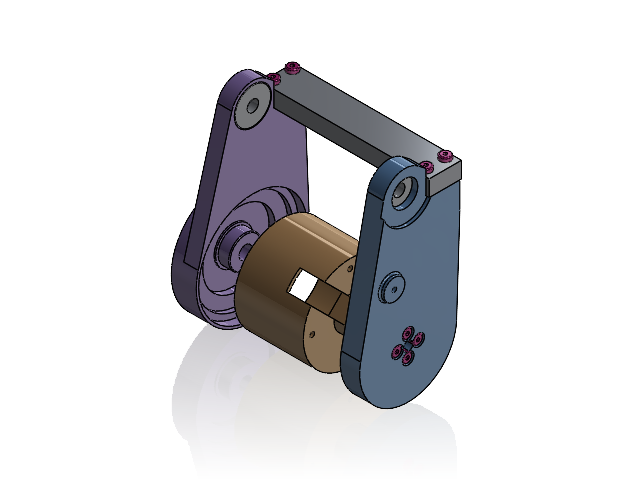
[picture p139: CAD file, 2026-11-03]
cad/v10 human editable/assemblies/V10H_pod_fork.SLDASM
V10H_inner_fork_6804
V10H_outer_fork_6804
V10H_motor_cup
V10H_fork_bar
V10H_bolt_M3_25_PAN x 4
V10H_bearing_627 x 2
V10H_bolt_M3_18_PAN x 4
