fernandomierhicks/omni-robot/cad/v10 human editable/assemblies/mirror/v10h_pod_roller-mirror6.SLDASM

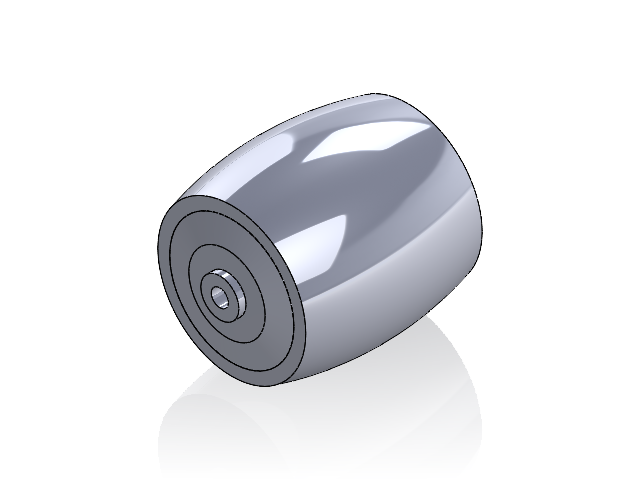
[picture p140: CAD file, 2026-11-03]
cad/v10 human editable/assemblies/mirror/v10h_pod_roller-mirror6.SLDASM
v10h_roller_core-mirror
v10h_roller_tread-mirror
