fernandomierhicks/omni-robot/cad/v10 human editable/assemblies/V10H_arm_link3_lower_arm.SLDASM

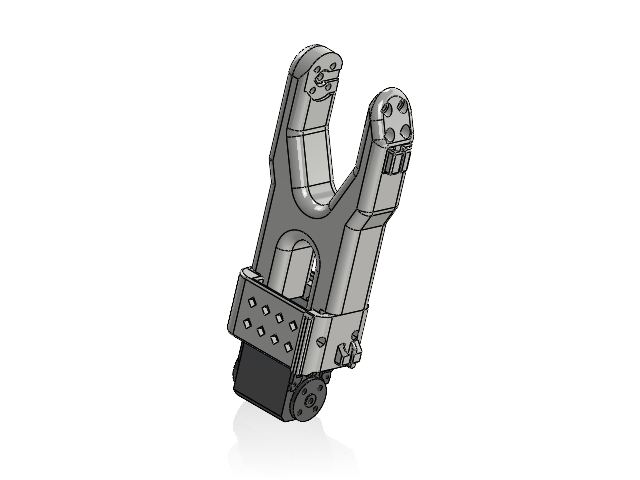
[picture p141: CAD file, 2026-11-03]
cad/v10 human editable/assemblies/V10H_arm_link3_lower_arm.SLDASM
SO-101_Under_arm_SO101
SO-101_Motor_holder_SO101_Wrist
SO-101_STS3215_03a
