fernandomierhicks/omni-robot/cad/v10 human editable/assemblies/V10H_pod_shock.SLDASM

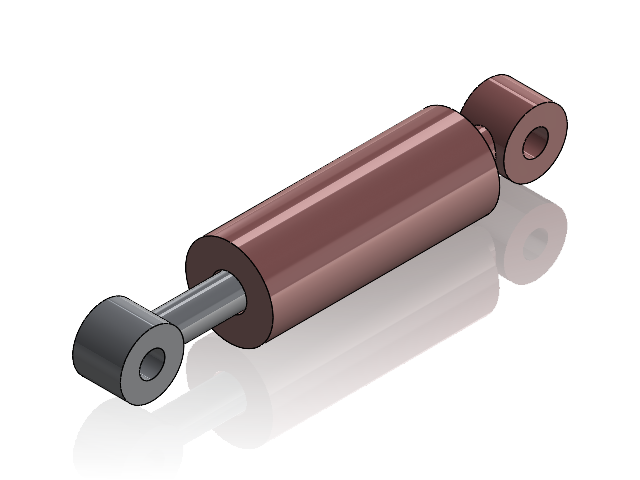
[picture p142: CAD file, 2026-11-03]
cad/v10 human editable/assemblies/V10H_pod_shock.SLDASM
V10H_shock_case
V10H_shock_rod
