fernandomierhicks/omni-robot/cad/v10 human editable/assemblies/V10H_arm_link5_gripper.SLDASM

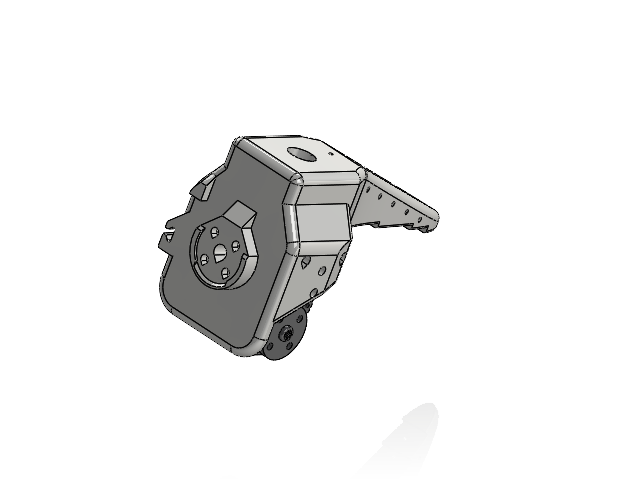
[picture p143: CAD file, 2026-11-03]
cad/v10 human editable/assemblies/V10H_arm_link5_gripper.SLDASM
SO-101_STS3215_03a
SO-101_Wrist_Roll_Follower_SO101
