fernandomierhicks/omni-robot/cad/v10 human editable/assemblies/V10H_pod_chassis.SLDASM

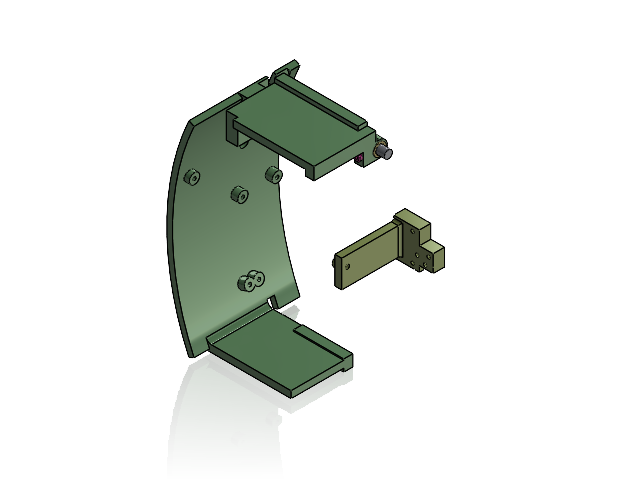
[picture p144: CAD file, 2026-11-03]
cad/v10 human editable/assemblies/V10H_pod_chassis.SLDASM
V10H_wheel_guard
V10H_pod_mount
V10H_pivot_shaft
V10H_pivot_shim
V10H_pivot_outer_spacer
V10H_bolt_M3_16_PAN
