fernandomierhicks/omni-robot/cad/v10 human editable/assemblies/V10H_arm_link4_wrist.SLDASM

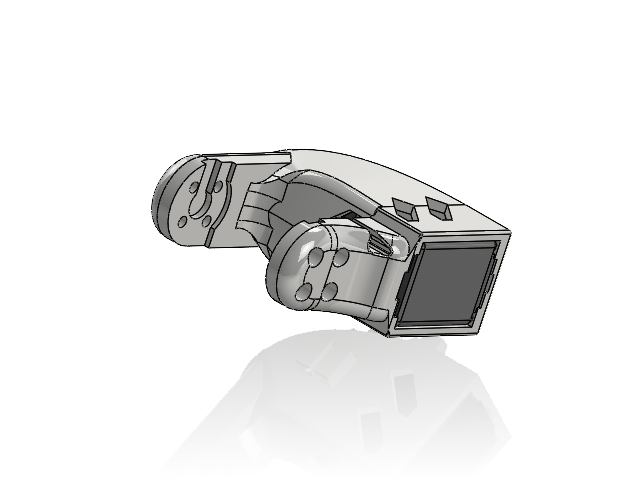
[picture p145: CAD file, 2026-11-03]
cad/v10 human editable/assemblies/V10H_arm_link4_wrist.SLDASM
SO-101_STS3215_03a__2
SO-101_Wrist_Roll_Pitch_SO101
