fernandomierhicks/omni-robot/cad/v10 human editable/assemblies/V10H_arm_link0_base.SLDASM

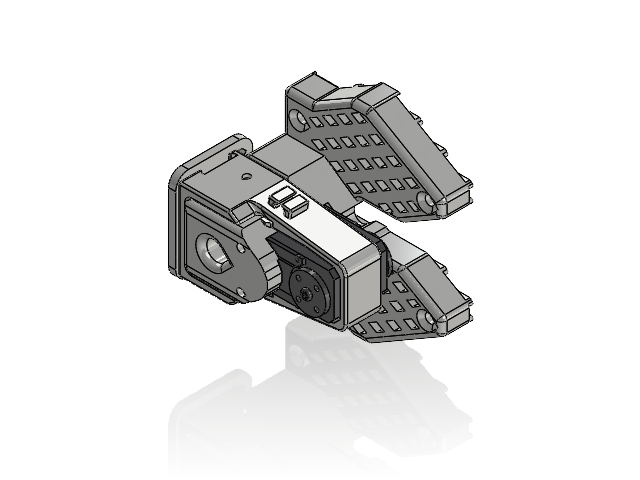
[picture p146: CAD file, 2026-11-03]
cad/v10 human editable/assemblies/V10H_arm_link0_base.SLDASM
SO-101_Base_motor_holder_SO101
SO-101_Base_SO101
SO-101_STS3215_03a
SO-101_WaveShare_Mounting_Plate_SO101
