fernandomierhicks/omni-robot/(list of files, cad)

Other CAD files:
cad/v10 human editable/assemblies/_work/mirror_work.SLDASM
cad/v10 human editable/assemblies/V10H_base_electronics.SLDASM
cad/v13/solidworks/assemblies/V13_motor.SLDASM
cad/v13/solidworks/V13_robot.SLDASM
cad/v13/step_export/chassis/chassis_assembly.step
cad/v10 human editable/assemblies/V10H_head.SLDASM
cad/v13/solidworks/assemblies/V13_frame.SLDASM
cad/v13/step_export/robot_assembly.step
cad/v13/solidworks/assemblies/V13_roller.SLDASM
cad/v10 human editable/assemblies/V10H_head_parts.SLDASM
cad/v13/solidworks/assemblies/V13_unsprung_m.SLDASM
cad/v13/solidworks/assemblies/V13_bumper.SLDASM
cad/v10 human editable/assemblies/V10H_d435_nose.SLDASM
cad/v13/solidworks/assemblies/V13_wheel.SLDASM
cad/v10 human editable/assemblies/V10H_arm_kit_fasteners.SLDASM
cad/v13/solidworks/assemblies/V13_roller_m.SLDASM
cad/v10 human editable/assemblies/V10H_base_fasteners.SLDASM
cad/v13/solidworks/assemblies/V13_mounts.SLDASM
cad/v10 human editable/assemblies/V10H_base_bumper.SLDASM
cad/v13/solidworks/assemblies/V13_pod_static_m.SLDASM
cad/v10 human editable/assemblies/V10H_mast_fasteners.SLDASM
cad/v13/solidworks/assemblies/V13_wheel_m.SLDASM
cad/v10 human editable/assemblies/mirror/v10h_pod_roller-mirror10.SLDASM
cad/v13/solidworks/assemblies/V13_electronics.SLDASM
cad/v10 human editable/assemblies/V10H_d435_bar.SLDASM
cad/v13/solidworks/assemblies/V13_fasteners.SLDASM
cad/v10 human editable/assemblies/V10H_mast_parts.SLDASM
cad/v13/solidworks/assemblies/V13_pod.SLDASM
cad/v10 human editable/assemblies/V10H_arm_kit.SLDASM
cad/v13/solidworks/assemblies/V13_arm.SLDASM
cad/v10 human editable/assemblies/mirror/v10h_pod_wheel-mirror.SLDASM
cad/v10 human editable/assemblies/V10H_arm_kit_parts.SLDASM
cad/v13/solidworks/assemblies/V13_upper.SLDASM
cad/v13/solidworks/assemblies/V13_unsprung.SLDASM
cad/v10 human editable/assemblies/V10H_head_fasteners.SLDASM
cad/v13/solidworks/assemblies/V13_pod_m.SLDASM
cad/v10 human editable/assemblies/V10H_base_deck.SLDASM
cad/v13/solidworks/assemblies/V13_pod_static.SLDASM
cad/v10 human editable/assemblies/V10H_mast.SLDASM
cad/v13/solidworks/assemblies/V13_motor_m.SLDASM
cad/v10 human editable/assemblies/mirror/v10h_pod_fork-mirror.SLDASM
cad/v10 human editable/assemblies/V10H_arm_link6_jaw.SLDASM
cad/v13/solidworks/assemblies/V13_reference.SLDASM
cad/v10 human editable/assemblies/mirror/v10h_pod_hub-mirror.SLDASM
cad/v10 human editable/assemblies/V10H_D435_FOV_reference.SLDASM
cad/v10 human editable/assemblies/mirror/v10h_pod_roller-mirror2.SLDASM
cad/v10 human editable/assemblies/mirror/v10h_pod_roller-mirror3.SLDASM
cad/v10 human editable/assemblies/mirror/v10h_pod_roller-mirror8.SLDASM
cad/v10 human editable/assemblies/mirror/v10h_pod_shock-mirror.SLDASM
cad/v10 human editable/assemblies/mirror/v10h_dummy_motor-mirror.SLDASM
cad/v10 human editable/assemblies/mirror/v10h_pod_roller-mirror9.SLDASM
cad/v10 human editable/validation/arm_explore.SLDASM
cad/v10 human editable/assemblies/mirror/v10h_wheel_pod-mirror.SLDASM
cad/v10 human editable/assemblies/mirror/v10h_pod_roller-mirror11.SLDASM
cad/v10 human editable/assemblies/mirror/v10h_pod_roller-mirror7.SLDASM
cad/v10 human editable/assemblies/mirror/v10h_pod_chassis-mirror.SLDASM
cad/v10 human editable/assemblies/mirror/v10h_pod_shock-mirror1.SLDASM
cad/v10 human editable/assemblies/mirror/v10h_pod_roller-mirror4.SLDASM
cad/v10 human editable/assemblies/mirror/v10h_pod_roller-mirror5.SLDASM
cad/v10 human editable/assemblies/mirror/v10h_pod_roller-mirror1.SLDASM
cad/v10 human editable/validation/INCOMPLETE_fork_bar.SLDPRT
cad/v10 human editable/validation/hub_A_repaired_prefillet.step
cad/v10 human editable/parts/step/REC_cheek_R.SLDPRT
cad/v10 human editable/parts/V10_dummy_motor_case.SLDPRT
cad/v10 human editable/print/dummy_motor_rear_cap.stl
cad/v10 human editable/validation/human/shock_case.step
cad/v10 human editable/assemblies/mirror/v10h_bearing_687-mirror.SLDPRT
cad/v13/solidworks/step_parts/bearing_6804_left.step
cad/other/Realsense to bucket/Bucket.SLDPRT
cad/other/Realsense to bucket/IntelRealsense_D435_Multibody.SLDPRT
cad/out/step/battery_tray.step
cad/out/step/bumper_arc_0.step
cad/out/step/bumper_arc_1.step
cad/out/step/bumper_arc_2.step
cad/out/step/bumper_arc_3.step
cad/out/step/bumper_arc_4.step
cad/out/step/bumper_arc_5.step
cad/out/step/camera_bracket_L.step
cad/out/step/camera_bracket_R.step
cad/out/step/center_plate.step
cad/out/step/channel_half_L.step
cad/out/step/channel_half_R.step
cad/out/step/deck_sector_0.step
cad/out/step/deck_sector_1.step
cad/out/step/deck_sector_2.step
cad/out/step/deck_sector_3.step
cad/out/step/deck_sector_4.step
cad/out/step/deck_sector_5.step
cad/out/step/flywheel_hub.step
cad/out/step/funnel_collar.step
cad/out/step/funnel_rim_arc_0.step
cad/out/step/funnel_rim_arc_1.step
cad/out/step/funnel_rim_arc_3.step
cad/out/step/gate_flap.step
cad/out/step/launcher_base.step
cad/out/step/payload_plate.step
cad/out/step/servo_tower.step
cad/out/step/wheel_adapter.step
cad/out/step/wheel_pod.step
cad/out/stl/battery_tray.stl
cad/out/stl/bumper_arc_0.stl
cad/out/stl/bumper_arc_1.stl
cad/out/stl/bumper_arc_2.stl
cad/out/stl/bumper_arc_3.stl
cad/out/stl/bumper_arc_4.stl
cad/out/stl/bumper_arc_5.stl
cad/out/stl/camera_bracket_L.stl
cad/out/stl/center_plate.stl
cad/out/stl/channel_half_L.stl
cad/out/stl/channel_half_R.stl
cad/out/stl/deck_sector_0.stl
cad/out/stl/deck_sector_1.stl
cad/out/stl/deck_sector_2.stl
cad/out/stl/deck_sector_3.stl
cad/out/stl/deck_sector_4.stl
cad/out/stl/deck_sector_5.stl
cad/out/stl/flywheel_hub.stl
cad/out/stl/flywheel_tire.stl
cad/out/stl/funnel_collar.stl
cad/out/stl/funnel_rim_arc_0.stl
cad/out/stl/funnel_rim_arc_1.stl
cad/out/stl/funnel_rim_arc_2.stl
cad/out/stl/funnel_rim_arc_3.stl
cad/out/stl/gate_flap.stl
cad/out/stl/launcher_base.stl
cad/out/stl/lidar_riser.stl
cad/out/stl/payload_plate.stl
cad/out/stl/servo_tower.stl
cad/out/stl/wheel_adapter.stl
cad/out/stl/wheel_pod.stl
cad/v10 human editable/V10_hubA_human.SLDPRT
cad/v10 human editable/assemblies/mirror/v10h_bearing_627-mirror.SLDPRT
cad/v10 human editable/assemblies/mirror/v10h_bearing_6804-mirror.SLDPRT
cad/v10 human editable/assemblies/mirror/v10h_bolt_m2p5_10_pan-mirror.SLDPRT
cad/v10 human editable/assemblies/mirror/v10h_bolt_m3_12_pan-mirror.SLDPRT
cad/v10 human editable/assemblies/mirror/v10h_bolt_m3_14_pan-mirror.SLDPRT
cad/v10 human editable/assemblies/mirror/v10h_bolt_m3_16_pan-mirror.SLDPRT
cad/v10 human editable/assemblies/mirror/v10h_bolt_m3_18_pan-mirror.SLDPRT
cad/v10 human editable/assemblies/mirror/v10h_bolt_m3_20_pan-mirror.SLDPRT
cad/v10 human editable/assemblies/mirror/v10h_bolt_m3_25_pan-mirror.SLDPRT
cad/v10 human editable/assemblies/mirror/v10h_bolt_m3_50_pan-mirror.SLDPRT
cad/v10 human editable/assemblies/mirror/v10h_bolt_m3_8_pan-mirror.SLDPRT
cad/v10 human editable/assemblies/mirror/v10h_dummy_motor_rotor-mirror.SLDPRT
cad/v10 human editable/assemblies/mirror/v10h_dummy_motor_stator-mirror.SLDPRT
cad/v10 human editable/assemblies/mirror/v10h_fork_bar-mirror.SLDPRT
cad/v10 human editable/assemblies/mirror/v10h_inner_fork_6804-mirror.SLDPRT
cad/v10 human editable/assemblies/mirror/v10h_motor_cup-mirror.SLDPRT
cad/v10 human editable/assemblies/mirror/v10h_nut_m3_hex-mirror.SLDPRT
cad/v10 human editable/assemblies/mirror/v10h_nut_m3_nyloc-mirror.SLDPRT
cad/v10 human editable/assemblies/mirror/v10h_outer_fork_6804-mirror.SLDPRT
cad/v10 human editable/assemblies/mirror/v10h_pivot_outer_spacer-mirror.SLDPRT
cad/v10 human editable/assemblies/mirror/v10h_pivot_shaft-mirror.SLDPRT
cad/v10 human editable/assemblies/mirror/v10h_pivot_shim-mirror.SLDPRT
cad/v10 human editable/assemblies/mirror/v10h_pod_mount-mirror.SLDPRT
cad/v10 human editable/assemblies/mirror/v10h_roller_core-mirror.SLDPRT
cad/v10 human editable/assemblies/mirror/v10h_roller_tread-mirror.SLDPRT
cad/v10 human editable/assemblies/mirror/v10h_shock_case-mirror.SLDPRT
cad/v10 human editable/assemblies/mirror/v10h_shock_rod-mirror.SLDPRT
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
