fernandomierhicks/omni-robot/cad/v10 human editable/step_export/d435_bar/README.md

Printed part only: the centre-bar D435 saddle.
Robot-frame millimetres; insert at the origin.
Tube modification: two diameter 3.4 mm cross holes along bar-local X, y = +/-27 mm, z = -2 mm.
Two M3x30 pan-head screws: nominal 6.6 mm printed engagement.
Tripod thread depth, actual printed fits, USB cable clearance and clamp strength need physical verification.
FOV reference parts are not printable parts and are excluded here.
