fernandomierhicks/omni-robot/cad/v10 human editable/step_export/d435_nose/README.md

Printed parts only: D435 nose wedge and front deck with the two mounting holes.
Coordinates are ROBOT-frame millimetres; insert at the origin.
Camera and hardware are in ../../assemblies/V10H_d435_nose.SLDASM, not this print export.
Nominal CAD interfaces; check actual camera tripod thread depth and cable strain relief before printing.
