fernandomierhicks/omni-robot/cad/v10 human editable/step_export/sim_reconciliation/README.md

Revised printed parts only: riser, adapter and both cheeks.
STEP coordinates are ROBOT-frame millimetres; insert at the origin.
The robot assembly is ../../V10H_robot.SLDASM.
The adapter includes a bar-clearance recess; physical bridge strength is untested.
Mast posts are purchased tube, 357 mm long; they are not in this print export.
