fernandomierhicks/omni-robot/cad/v10 human editable/PRINT_LIST.md

# Native v10 print list

The STL files below are meshed from the editable SolidWorks parts in `parts/human/`. Dimensions are millimetres.

| Part | Qty | Material | STL |
|---|---:|---|---|
| bench_plate | 1 | PETG / PLA for fit fixture | [bench_plate.stl](print/human/bench_plate.stl) |
| dummy_motor_rotor | 1 | PETG / PLA for fit fixture | [dummy_motor_rotor.stl](print/human/dummy_motor_rotor.stl) |
| dummy_motor_stator | 1 | PETG / PLA for fit fixture | [dummy_motor_stator.stl](print/human/dummy_motor_stator.stl) |
| inner_fork_6804 | 1 | PETG (touches the motor) | [inner_fork_6804.stl](print/human/inner_fork_6804.stl) |
| motor_cup | 1 | PETG (touches the motor) | [motor_cup.stl](print/human/motor_cup.stl) |
| outer_fork_6804 | 1 | PETG / PLA for fit fixture | [outer_fork_6804.stl](print/human/outer_fork_6804.stl) |
| pivot_outer_spacer | 1 | PETG / PLA for fit fixture | [pivot_outer_spacer.stl](print/human/pivot_outer_spacer.stl) |
| pivot_shim | 1 | PETG / PLA for fit fixture | [pivot_shim.stl](print/human/pivot_shim.stl) |
| pod_mount | 1 | PETG / PLA for fit fixture | [pod_mount.stl](print/human/pod_mount.stl) |
| roller_core | 12 | PLA | [roller_core.stl](print/human/roller_core.stl) |
| roller_tread | 12 | Medium TPU | [roller_tread.stl](print/human/roller_tread.stl) |
| shock_case | 2 | PETG / PLA for fit fixture | [shock_case.stl](print/human/shock_case.stl) |
| shock_rod | 2 | PETG / PLA for fit fixture | [shock_rod.stl](print/human/shock_rod.stl) |
| wheel_cartridge | 1 | PLA | [wheel_cartridge.stl](print/human/wheel_cartridge.stl) |
| wheel_guard | 1 | PLA | [wheel_guard.stl](print/human/wheel_guard.stl) |
| wheel_hub_A | 1 | PETG (touches the motor) | [wheel_hub_A.stl](print/human/wheel_hub_A.stl) |
| wheel_hub_B | 1 | PLA | [wheel_hub_B.stl](print/human/wheel_hub_B.stl) |
| wheel_hub_C | 1 | PLA | [wheel_hub_C.stl](print/human/wheel_hub_C.stl) |
