fernandomierhicks/omni-robot/cad/out/PRINT_LIST.md

# Print list (generated by build.py)

Printed parts total about 2.31 kg (volume x density x (infill + 25% for walls)).

| Part | Qty | Material | Infill | Orientation | Size (mm) | Est. mass each |
| --- | --- | --- | --- | --- | --- | --- |
| wheel_pod | 3 | PETG | 40% | flange face down | 131 x 112 x 94 | 107 g |
| wheel_adapter | 3 | PETG | 100% | wheel-side face down (or machine in 6061) | 13 x 44 x 44 | 12 g |
| center_plate | 1 | PETG | 30% | flat | 240 x 240 x 6 | 168 g |
| deck_sector_0 | 1 | PETG | 25% | flat, lip side down | 132 x 225 x 6 | 63 g |
| deck_sector_1 | 1 | PETG | 25% | flat, lip side down | 195 x 171 x 6 | 75 g |
| deck_sector_2 | 1 | PETG | 25% | flat, lip side down | 195 x 171 x 6 | 61 g |
| deck_sector_3 | 1 | PETG | 25% | flat, lip side down | 132 x 225 x 6 | 75 g |
| deck_sector_4 | 1 | PETG | 25% | flat, lip side down | 195 x 171 x 6 | 63 g |
| deck_sector_5 | 1 | PETG | 25% | flat, lip side down | 195 x 171 x 6 | 75 g |
| bumper_arc_0 | 1 | TPU 95A | 15% | skirt down | 127 x 204 x 72 | 35 g |
| bumper_arc_1 | 1 | TPU 95A | 15% | skirt down | 236 x 47 x 72 | 35 g |
| bumper_arc_2 | 1 | TPU 95A | 15% | skirt down | 127 x 204 x 72 | 35 g |
| bumper_arc_3 | 1 | TPU 95A | 15% | skirt down | 127 x 204 x 72 | 35 g |
| bumper_arc_4 | 1 | TPU 95A | 15% | skirt down | 236 x 47 x 72 | 35 g |
| bumper_arc_5 | 1 | TPU 95A | 15% | skirt down | 127 x 204 x 72 | 35 g |
| battery_tray | 1 | PETG | 30% | flange down | 134 x 56 x 81 | 61 g |
| lidar_riser | 1 | PLA | 30% | flat | 66 x 66 x 8 | 19 g |
| payload_plate | 1 | PETG | 30% | flat | 240 x 240 x 6 | 182 g |
| launcher_base | 1 | PETG | 30% | flat (motor plates overhang 38 deg) | 248 x 190 x 82 | 240 g |
| channel_half_L | 1 | PETG | 30% | outer side wall down | 197 x 42 x 234 | 109 g |
| channel_half_R | 1 | PETG | 30% | outer side wall down | 197 x 42 x 234 | 94 g |
| gate_flap | 1 | PETG | 100% | flap face down | 91 x 91 x 24 | 28 g |
| servo_tower | 1 | PETG | 40% | on its back | 24 x 44 x 173 | 27 g |
| flywheel_hub | 2 | PETG | 100% | motor side down | 58 x 58 x 28 | 88 g |
| flywheel_tire | 2 | TPU 95A | 100% | flat | 70 x 70 x 28 | 42 g |
| funnel_collar | 1 | PETG | 30% | flat | 128 x 141 x 20 | 38 g |
| funnel_rim_arc_0 | 1 | PETG | 30% | flat | 196 x 177 x 14 | 21 g |
| funnel_rim_arc_1 | 1 | PETG | 30% | flat | 177 x 196 x 10 | 20 g |
| funnel_rim_arc_2 | 1 | PETG | 30% | flat | 196 x 177 x 10 | 20 g |
| funnel_rim_arc_3 | 1 | PETG | 30% | flat | 177 x 196 x 14 | 21 g |
| camera_bracket_L | 1 | PETG | 40% | base down | 35 x 42 x 49 | 10 g |
| camera_bracket_R | 1 | PETG | 40% | base down | 35 x 42 x 49 | 10 g |

Interference check: 0 clash(es) above 5 mm3.
