fernandomierhicks/omni-robot/cad/v9/out/PRINT_LIST.md

# Print list (generated by build.py)

67 unique printed parts, 191 prints, about 5.49 kg of filament (volume x density x (infill + 25 %)). `_M` = the mirrored version (front-left and rear-right pods); print the mirror in the slicer or use the `_M` file.

| Part | Qty | Material | Infill | Orientation | Size (mm) | Mass each | Frame |
| --- | --- | --- | --- | --- | --- | --- | --- |
| audio_base | 1 | PETG | 40% | floor down | 46 x 150 x 18 | 29 g | ROBOT |
| audio_lid | 1 | PETG | 30% | flat | 46 x 150 x 3 | 14 g | ROBOT |
| battery_tray | 1 | PETG | 30% | flange up | 176 x 78 x 26 | 43 g | ROBOT |
| board_spacer | 4 | PETG | 100% | flat | 7 x 7 x 4 | 0 g | local |
| bumper_corner | 4 | TPU 95A | 20% | inner lip down | 27 x 186 x 61 | 27 g | ROBOT |
| bumper_lobe | 3 | TPU 95A | 20% | inner lip down | 31 x 159 x 61 | 25 g | ROBOT |
| bumper_lobe_rear | 1 | TPU 95A | 20% | inner lip down | 28 x 161 x 61 | 22 g | ROBOT |
| cam_holder_L | 1 | PETG | 60% | on the sleeve's outer end | 51 x 53 x 44 | 48 g | ROBOT |
| cam_holder_R | 1 | PETG | 60% | on the sleeve's outer end (mirror of L without the index holes) | 51 x 53 x 44 | 48 g | ROBOT |
| cheek_L | 1 | PETG | 40% | on its inner face | 98 x 26 x 62 | 28 g | ROBOT |
| cheek_R | 1 | PETG | 40% | on its inner face (mirror of L without the index hole) | 98 x 26 x 62 | 28 g | ROBOT |
| chute_half_L | 1 | PETG | 30% | outer side wall down | 175 x 66 x 132 | 79 g | MODULE |
| chute_half_R | 1 | PETG | 30% | outer side wall down (mirror of L) | 175 x 66 x 132 | 77 g | MODULE |
| collar | 1 | PETG | 40% | top face down | 175 x 180 x 35 | 77 g | MODULE |
| crown | 1 | PETG | 40% | on its back (x -217 face) down | 28 x 146 x 126 | 74 g | ROBOT |
| deck_centre | 1 | PETG | 30% | flat (posts and bosses up) | 140 x 140 x 28 | 82 g | ROBOT |
| deck_front | 1 | PETG | 30% | flat (posts and bosses up) | 147 x 174 x 6 | 58 g | ROBOT |
| deck_left | 1 | PETG | 30% | flat (posts and bosses up) | 174 x 147 x 6 | 59 g | ROBOT |
| deck_rear | 1 | PETG | 30% | flat (posts and bosses up) | 147 x 174 x 10 | 57 g | ROBOT |
| deck_right | 1 | PETG | 30% | flat (posts and bosses up) | 174 x 147 x 6 | 59 g | ROBOT |
| deck_splice | 2 | PETG | 60% | flat | 37 x 62 x 12 | 13 g | ROBOT |
| face_back | 1 | PETG | 30% | flat | 12 x 126 x 91 | 15 g | ROBOT |
| face_housing | 1 | PETG | 30% | front face down | 25 x 126 x 92 | 26 g | ROBOT |
| feed_carriage_L | 1 | PETG | 60% | plate down | 48 x 30 x 38 | 7 g | MODULE |
| feed_carriage_R | 1 | PETG | 60% | plate down | 48 x 30 x 38 | 7 g | MODULE |
| feed_wheel_hub_L | 1 | PETG | 60% | flat | 32 x 32 x 30 | 10 g | MODULE |
| feed_wheel_hub_R | 1 | PETG | 60% | flat | 32 x 32 x 30 | 10 g | MODULE |
| feed_wheel_tyre_L | 1 | TPU 95A | 100% | flat | 38 x 40 x 35 | 7 g | MODULE |
| feed_wheel_tyre_R | 1 | TPU 95A | 100% | flat | 38 x 40 x 35 | 7 g | MODULE |
| flywheel_hub_L | 1 | PETG | 100% | flat | 64 x 58 x 53 | 80 g | MODULE |
| flywheel_hub_R | 1 | PETG | 100% | flat | 64 x 58 x 53 | 80 g | MODULE |
| flywheel_tyre_L | 1 | TPU 95A | 100% | flat | 75 x 70 x 59 | 42 g | MODULE |
| flywheel_tyre_R | 1 | TPU 95A | 100% | flat | 75 x 70 x 59 | 42 g | MODULE |
| fw_mount_L | 1 | PETG | 60% | flange down | 99 x 42 x 47 | 85 g | MODULE |
| fw_mount_R | 1 | PETG | 60% | flange down | 99 x 42 x 47 | 85 g | MODULE |
| lidar_riser | 1 | PETG | 30% | top down | 83 x 73 x 60 | 35 g | ROBOT |
| mast_foot_L | 1 | PETG | 40% | socket up | 41 x 41 x 30 | 15 g | ROBOT |
| mast_foot_R | 1 | PETG | 40% | socket up (mirror of L) | 41 x 41 x 30 | 15 g | ROBOT |
| motor_cup | 4 | PETG | 60% | neck end down; support under rear bridge | 58 x 58 x 58 | 40 g | POD |
| outer_plate | 2 | PETG | 60% | housing lip down | 14 x 113 x 88 | 48 g | POD |
| outer_plate_M | 2 | PETG | 60% | housing lip down | 14 x 113 x 88 | 48 g | POD |
| payload_plate | 1 | PETG | 30% | flat | 240 x 240 x 6 | 184 g | ROBOT |
| payload_ports | 1 | PETG | 40% | foot down | 52 x 18 x 24 | 5 g | ROBOT |
| pod_arm | 2 | PETG | 60% | outer face (x 49) down | 22 x 112 x 86 | 79 g | POD |
| pod_arm_M | 2 | PETG | 60% | outer face (x 49) down | 22 x 112 x 86 | 79 g | POD |
| pod_mount | 2 | PETG | 50% | base down | 38 x 32 x 62 | 15 g | POD |
| pod_mount_M | 2 | PETG | 50% | base down | 38 x 32 x 62 | 15 g | POD |
| rim_arc_0 | 1 | PETG | 30% | flat | 40 x 198 x 25 | 19 g | MODULE |
| rim_arc_1 | 1 | PETG | 30% | flat | 171 x 105 x 25 | 19 g | MODULE |
| rim_arc_2 | 1 | PETG | 30% | flat | 171 x 105 x 25 | 19 g | MODULE |
| rim_arc_3 | 1 | PETG | 30% | flat | 40 x 198 x 25 | 19 g | MODULE |
| rim_arc_4 | 1 | PETG | 30% | flat | 171 x 105 x 25 | 19 g | MODULE |
| rim_arc_5 | 1 | PETG | 30% | flat | 171 x 105 x 25 | 19 g | MODULE |
| roller_core | 48 | PLA | 20% | on end | 31 x 31 x 39 | 14 g | local |
| roller_tread | 48 | TPU medium | 100% | on end | 36 x 36 x 37 | 12 g | local |
| servo_cap | 1 | PETG | 40% | plate down | 54 x 20 x 47 | 10 g | ROBOT |
| standoff | 4 | PETG | 100% | standing | 20 x 20 x 102 | 16 g | local |
| switch_riser | 1 | PETG | 40% | flange down | 57 x 36 x 14 | 5 g | ROBOT |
| wheel_guard | 1 | PETG | 30% | front panel down | 115 x 185 x 92 | 110 g | POD |
| wheel_guard_M | 1 | PETG | 30% | front panel down | 115 x 185 x 92 | 110 g | POD |
| wheel_guard_front | 1 | PETG | 30% | front panel down | 115 x 185 x 92 | 106 g | POD |
| wheel_guard_front_M | 1 | PETG | 30% | front panel down | 115 x 185 x 92 | 106 g | POD |
| wheel_hub_A | 4 | PLA | 60% | bearing boss down | 32 x 121 x 124 | 68 g | POD |
| wheel_hub_B | 4 | PLA | 60% | a split face down (pin channels up on the other face) | 36 x 124 x 124 | 85 g | POD |
| wheel_hub_C | 4 | PLA | 60% | bearing housing up, split face down | 26 x 124 x 121 | 55 g | POD |
| yoke_L | 1 | PETG | 40% | on its outer face | 92 x 26 x 208 | 110 g | ROBOT |
| yoke_R | 1 | PETG | 40% | on its outer face (mirror of L with the servo window) | 92 x 28 x 214 | 116 g | ROBOT |
