fernandomierhicks/omni-robot/characterization/throw_track/README.md

# Throw tracking with the real cameras

**Oct 31 update:** the experimental gesture/tuning/live 3D bucket workflow is now in [ball_view's Bucket ball lab](../ball_view/README.md#bucket-ball-lab-oct-31-gesture-tuning-3d-flight-browser-status), on the Pi's port 8086 (`bv.sh bucket`). It records independent RGB witness video plus raw event clips. Its new fixed-gravity/drag gate is compared with the old causal trigger on every saved clip in `results/flight3d/comparison.json`: 11/15 visually identified flights confirmed, one of six handling clips falsely confirmed; four short/fragmented flights remain uncertain. This is an experimental precision/coverage trade, not an every-throw claim. **Correction to the original visual audit:** loc2 t004 contains a small release and catch, so the loc set is nine clear-flight clips and six handling/rig-motion clips. The old audit data and Fernando's raw reviews remain unchanged. The D435 was disconnected during deployment; real new-workflow tuning/gestures and combined live performance still require testing.

Oct 30. design.md 8, phase 1C steps 5–6, and rule 2 (every bench measurement goes into the sim, and the sim must then land inside the real numbers). Until now the real cameras were measured with **no ball in view** (`../pi_camera`, `../realsense`: fps, sensor → detection latency). This folder records **thrown balls** on the camera head, runs the robot's own perception over them, scores it, and turns the result into the sim's camera model.

```
record_throws.py (Pi) ──> data/<session>/tNNN/frames.npy ──> analyze_throws.py ──> results/analysis_<session>.json
                                                                   │                          │
                                              arcfit.py (the arc with drag)        fit_vision.py ──> results/vision_measured.json
                                              tag_pose.py (the basket)                         │            │
                                                                                 gate_sim_vs_real.py <──────┘
                                                                  catch_world.measured_cameras()  (the sim, opt-in)
```

## What it measures, and what it can't

| Measured (one camera, Arducam IMX708 on the Pi 4) | Goes to |
| --- | --- |
| Detector rate given the flight, vs range (the ball's apparent size) | `VisionConfig.drop_prob` |
| Wrong blobs per in-view frame | `false_prob` |
| Centroid noise: rms to the fitted arc, and the arc-free second differences | `edge_sigma` (through the sim's own blob model) |
| Ball size noise, fitted vs assumed size | `sigma_size_rel` / `ball_size_rel` (reported; the gate shows its effect) |
| Blob elongation → effective exposure | `exposure` (indicative: the threshold trims the streak's faint ends) |
| Sensor stamp → host, per frame | `latency_mean`, `latency_jitter` |
| The live tracker's crossing of the rim plane vs the arc's, by time to go; the score prediction vs your y / n | the catch rate's perception term; `crossing_sigma` calibration |

**Not measurable here:** stereo calibration drift (one camera), spin (Magnus), global-shutter behaviour (the IMX708 is rolling), and exposure → glass latency (needs the LED / flash rig: `../realsense/rs_flash_latency.py`, never run). The fitted arc uses the same frames as the detections, so it bounds the noise and the filter's convergence, **not** absolute bias: the basket's tag is the independent check. The field of view is a datasheet estimate until you calibrate (`--fovy`, or `camera.f_px` in session.json from `omni_calib`).

## Procedure (Fernando, ~30 min of throwing)

1. **Rig.** A basket with a ~Ø330 mm rim (the funnel's) where a robot would wait, an AprilTag (36h11, id 0, black square 100 mm; `--tag-size`) on its outer wall facing the thrower, ~0.10 m below the rim (`--tag-below-rim`). The camera beside or behind the basket looking at the thrower. Measure the tag's centre below the rim plane and the rim radius; they go in as options. Measure the throwing distance.
2. **Ball colour.** `bash characterization/ball_view/bv.sh picam`, click the real ball, adjust, **save settings**, Ctrl-C. `record_throws.py` reads that saved file (the exposure and gain too: prefer a fixed 2–4 ms exposure indoors; 8 ms blurs a 10 m/s ball by 8 cm).
3. **Record.** `bash characterization/throw_track/tt.sh record --name garage --distance 4.5 --count 30`. It takes a still of the basket first (the tag), arms, and saves a throw as soon as a ball moves. Throw; it prints `throw N written`, then asks **`did it go in the basket? [y/n, s=discard, q=finish]`**. Type the answer, throw the next. Dumps take a few seconds; the next throw can already fly. 30 throws at 3 distances is a good set. Stop with `q` or Ctrl-C (it takes a second still at the end: if the tag moved, the camera or basket was bumped).
4. **Fetch and analyse** (the code does this while you keep throwing the next session):
   ```
   bash characterization/throw_track/tt.sh fetch            # latest session, Pi -> data/
   bash characterization/throw_track/tt.sh tag              # tag pose (OpenCV: the realsense venv) -> session.json
   bash characterization/throw_track/tt.sh analyze          # results/analysis_<session>.json + a summary
   python fit_vision.py results/analysis_<session>.json     # results/vision_measured.json
   python gate_sim_vs_real.py results/analysis_<session>.json
   ```
   Only one process can hold the camera: stop `bv.sh` and the camera head first.
5. **No camera?** `tt.sh synthetic` (on the Pi) or `record_throws.py --synthetic` (anywhere) renders throws with known truth, in the same format.

## How the analysis works

- **A, the live pass:** the robot's `Perception` (`omni_catch`: detector, image-space EKF) is run over each throw's frames in order, one camera at the origin, world z up (gravity found from the throws). The track start, readiness and its crossing of the rim plane at every frame are kept.
- **B, the arc:** `arcfit.fit_arc` fits a ballistic arc with the robot's drag law to the detections (centroid, apparent size, the ball's 74 mm and gravity fix the scale). Gravity's direction is a free parameter (one monocular arc fixes the camera's tilt to ~0.4°, which is 4 px at 4 m), pooled over the session's throws as a median and then a soft prior. Then the detector is re-run with the arc's prediction as its window: it finds the ball in frames the live pass missed (far away, small), which is the detector's rate on its own, and the arc is refitted on all of it.
- **C, the metrics** (see the table above). Tracker error is reported by time to go before the ball crosses the rim plane (1.0 … 0.1 s), with the Mahalanobis error (is `crossing_sigma` honest?), and the score prediction as a confusion matrix against your labels, at each time to go.
- **Monocular is hard at the start.** `ImageTracker` starts a track from a ball's size alone (range = f R / b), which jitters by tens of cm at 4 m, so a track often needs a few more frames than in stereo; the first second's crossing error is the honest cost of one camera. The robot has two.

## From measurement to sim (rule 2)

`fit_vision.py` writes the values and **where each came from**. The sim jitters the colour threshold per **pixel** (`edge_sigma`), which moves the centroid far less than that, so it runs the sim's own blob model (`catch_world.ball_pixels`, split out of `CameraSim.render` unchanged) on the fitted arcs at several `edge_sigma` and matches the measured centroid noise: on synthetic throws with 0.4 px of centroid noise it needs `edge_sigma` ≈ 2 against the sim's current 0.6 (~0.13 px of centroid noise). It also reports whether that edge jitter makes the ball's *size* noisier than the camera's (the sim's does, in the synthetic case).

`gate_sim_vs_real.py` then rebuilds each real flight with the sim's frames and runs the same analysis: centroid noise, detection rate, track start range and the crossing error by time to go, real and sim side by side. "Pass" = within 1.5× (rates within 0.05); with under 30 throws it says the differences prove little. A failure means the sim's camera model leaves something out: fix the model (blur, size noise, gaps), not the measurement. After a pass: `WorldConfig(vision=catch_world.measured_cameras())`, rerun `studies/sil_catch.py both --robot drawn`, and write the change in the catch rate into design.md 4.1.

The numbers belong to the *Arducam* (rolling, mono, 768 × 432 at 120 fps). The robot's cameras (two global-shutter cameras) will be measured the same way when they exist; until then these are the best real values, flagged as another camera's.

## Files

| | |
| --- | --- |
| `record_throws.py`, `tt.sh` | Capture on the Pi (numpy + the robot's detector only), the PC ↔ Pi loop |
| `session.py` | The on-disk format (`session.json`, `tNNN/frames.npy`, `stamps.npy`, `meta.json`) |
| `arcfit.py` | The drag-law arc, gravity direction, scipy fit |
| `analyze_throws.py` | The analysis (A, B, C), `results/analysis_<session>.json` |
| `tag_pose.py` | The basket tag → rim position (OpenCV) |
| `fit_vision.py`, `gate_sim_vs_real.py` | Measurements → `VisionConfig`; the sim vs real check |
| `synth.py` | Rendered throws with known truth (tests, dry runs) |
| `test_throw_track.py`, `test_tag_pose.py` | Tests, no camera (`tt.sh test`; the tag test needs the realsense venv) |
| `record_rs.py`, `synth_rs.py`, `rs_detect.py`, `rs_analyze.py`, `rs_predict.py`, `rs_view.py`, `bucket.json`, `test_rs.py` | The RealSense bucket rig (next section) |

## RealSense D435 on a bucket (Oct 30): every imager, offline replay, the bucket verdict

Exploratory. A bucket on the floor, the D435 clamped to its outside near the base looking at the thrower (CAD, `bucket.json`, straight from the model: rim Ø284.48 mm, its top edge 368.3 mm above the floor, the camera's back face 141.59 mm from the axis and 40.80 mm up, pitched 30° up). No labels and no external truth: the throw's own best arc is the reference, and what is measured is **how long before the ball reaches the rim the verdict is right** (the "time to correct"), with every imager available to iterate the detectors on.

```
record_rs.py (Pi) -> ~/omni_ws/throw_track/data/<session>/tNNN/ {frames.npy = colour, depth.npy, ir1.npy, ir2.npy, *_stamps.npy, *_info.npy}
        | tt.sh rsfetch (outside Dropbox: ~/throw_data)
        v
rs_analyze.py -- rs_detect.py (depth / IR blob-stereo / colour detectors, robust drag-law arc) -- rs_predict.py (rim verdict, time to correct, bucket.json)
rs_view.py (contact sheet, --scrub)
```

| Command | What |
| --- | --- |
| `tt.sh rscheck [SEC]` | **First, always.** No throws: each stream's rate, lost frames, stamp to host latency, timestamp domain, the camera's options |
| `tt.sh rsrecord --name bucket --distance 4.5 --count 30` | Record throws (the colour detector is the trigger; no prompts, `--ask` for y / n; `--streams color,depth` for a lighter set; `--emitter on\|off\|alternate`; `--exposure-us`, `--ir-exposure-us`; `--force-every 5` is a test capture with no ball) |
| `tt.sh rssynthetic` | The same code on rendered throws (no camera) |
| `tt.sh rsfetch [SESSION]` | Pi to `~/throw_data` (not Dropbox: ~420 MB a throw) |
| `tt.sh rsanalyze [DIR] --bucket bucket.json --plot [--set depth_gap=0.3 ir_thr=25] [--gravity pooled]` | Replay: detections per imager, arcs, agreement, the verdict. `--set` changes any `rs_detect.DetectCfg` knob, so filters can be compared on the same recording |
| `tt.sh rsview N [DIR] [--scrub] [--crop]` | Look at throw N: colour, depth, IR1, IR2 side by side with the detections |
| `tt.sh rsautotune [--distance 2.5]` | **Before a session, the ball still in view (a table):** white balance, exposure, gain and the colour window from the ball itself -> `~/omni_ws/ball_view_settings/realsense_auto.json` (record with `--settings` that file); `rs_autotune.py --show <npz>` draws it |
| `tt.sh rsreview [DIR]` | The review page: the colour video with every detection, the arcs and the verdict drawn on; your in / rim / out call, notes, ball clicks saved in each throw's `meta.json` (`review`) |

**Bogus detections (Oct 30, evening).** The scene keeps its orange things (flowers, a red box, a pumpkin): they're filtered, not removed. `arc2d.py` judges blob *tracks*: a thrown ball follows a quadratic in time to ~2 px, travels >= 2 diameters, moves >= 2 m/s sideways (from its own size, so no range is needed), its image acceleration is <= ~2.5 g (the arm's swing is far more) and its size changes smoothly; blobs under 4 px radius are noise. The recorder's trigger uses it (`--trigger arc`, the default; `motion` is the old test) and so does the analysis (`flight_track`: the scene's static blobs dropped, the longest in-flight run; near a lob's apex the image barely moves, so travel / speed are checked over the whole run). Replayed on the four real sessions: no fire on the decoys (bucket2) or the slow carry (bucket6), a fire on the release in bucket4 (0.3 px off a quadratic, 2.8 m/s, 1.2 g), none on bucket5 (its ball came through as 1-3 px fragments under the old colour window). **Colour is now a 3D source:** the track's pixels, range from the depth map at the pixel (else from the blob's size and `size_gain`), the drag-law arc fitted to the pixels with the ranges as a looser term (`rs_detect.fit_ray_arc`), the same fit causal in `rs_predict` (`ray_fitter`). On the synthetic throw: 7 mm mean / 16 mm max from the truth (depth: 2 mm), and the right verdict on the in and out throws.

**Auto-tune measured on the real scene (Oct 30, 23:18, the room's ceiling light, the ball on a stand):** the camera's own auto white balance (4600 K) left the warm-lit room as orange as the ball (walls and ceiling at saturation ~0.55; the window then covered nearly the whole frame); the greyest room is at 2800 K, the sensor's lowest (median saturation 0.21). There: 5 ms, gain 128, hue 3-29 deg, sat >= 0.81, val >= 0.07; the ball at 1.66 m (depth) came out at 22.5 px of the 29.8 px its range predicts (the shaded lower part is cut: `size_gain` 1.32), found in 8/8 single frames, **no other blob passes** (the flowers, the red box and the pumpkin don't). A 30 s recorder dry run with these settings and the arc trigger: READY, no false trigger. Not yet measured: a thrown ball under these settings (motion blur at 5 ms, the ball's saturation in flight).

**First real throws (Oct 30, 23:50 - 00:05; sessions `bucket7`, `bucket8`, `bucket9` in `~/throw_data`).** Six lobs at the bucket, one at a time, the auto-tuned settings above, `--learn-s 0` (Fernando held the ball in view before each throw), the arc trigger. Every throw was captured with the release in the clip (the trigger fired ~0.13 s after release), all four streams, 0-4 frames lost; no false trigger from the flowers, the red box or the pumpkin. One extra capture (bucket9 t005) was Fernando walking away, his swinging hand an orange patch whose 7-frame path passed the arc test: the colour source now rejects a blob whose depth is much nearer than its size says (`depth_in_front`: a patch on a hand or an arm, not a free ball), and so does the live trigger (it reads the newest depth frame; replayed on the six throws it passes all of them and rejects t005). The ball is dark against the bright ceiling (backlit) but stays above the colour window's floors; it crosses the ceiling lamp on high lobs, where the glare washes it out for ~6 frames and it comes back in fragments.

| Throw | Release (depth) | Tracked frames | Seen from / to (m) | Arc fit | Last seen before the crossing | Verdict (centre vs rim) | Called right from | Fernando |
| --- | --- | --- | --- | --- | --- | --- | --- | --- |
| bucket7 t001 | ~6.3 m | 47 | 6.2 -> 1.0 | 2.6 px | 90 ms | OUT, +28 cm | 762 ms before (1 flip) | out |
| bucket8 t001 | ~6 m | 21 | 4.5 -> 2.9 | 0.9 px | 642 ms (the ball left the top of the view) | OUT, +91 cm | 894 ms (always) | out |
| bucket9 t001 | ~6 m | 26 | 4.3 -> 2.1 | 1.4 px | 366 ms | RIM, +7 cm (ambiguous) | 685 ms (1 flip) | out |
| bucket9 t002 | ~6 m | 30 | 4.5 -> 2.1 | 2.1 px | 351 ms | OUT, +17 cm | 754 ms (always) | out |
| bucket9 t003 | ~2.3 m, a toss | 20 (the lamp bridged) | 2.3 -> 1.4 | 7.8 px | 368 ms | RIM, -2 cm (centre inside) | 402 ms (7 flips) | out |
| bucket9 t004 | ~1.9 m, a toss | 16 | 1.9 -> 1.3 | 5.1 px | 377 ms | RIM, -2 cm (centre inside) | 377 ms (4 flips) | **in** |

What these numbers are: the verdict is the throw's own arc against `bucket.json` (the camera 30 deg up, the bucket where the CAD has it); "called right from" is how early the causal fit agreed with that arc, not with the truth. **Fernando's outcomes (Oct 31): all out except the last** (saved in each throw's meta.json, `review`). Against the binary call (the ball's centre inside the rim circle): **5 of 6 right**; the four throws called OUT or RIM-outside all went out, the last (centre 2 cm inside) went in, and bucket9 t003 (centre 2 cm inside) went out. Both close tosses were in the "touches the rim" band, where this 160.7 mm ball in a 284 mm rim is a coin flip (clean entry needs the centre within 62 mm of the axis), and both had the worst fits. Six throws, the same ones the analysis was fixed on: no held-out test yet. The two close tosses fit worse (5-8 px): near the camera a few degrees of pitch error bend the arc that much.

**Gravity check.** Fitted free on each of the four long throws, "up" came out at a pitch of 21.7, 25.8, 32.2 and 34.8 deg (mean 28.6) with 1-6 deg of roll, against the CAD's 30 deg: the mount is about right, and one throw alone doesn't pin gravity (the short close tosses gave nonsense, -24 and -29 deg). So the colour arc uses the mount's up (`analyze_throw(up=)`, from `--bucket`; fitted free, the first throw's came out 50 deg off and the arc missed the ball's last 20 frames).

**What the colour source does now** (each step from a failure on these throws): blob tracks judged as arcs in 2D (`arc2d`), an in-flight window must move >= 1 m/s (the ball held in the hand is a smooth slow track, 0.5-0.6 m/s); the 3D arc (pixels + depth at the pixel, the mount's gravity, drag) is trimmed of the hand frames a 2D window drags in (12-56 px off them), then grown frame by frame by predict-and-search over every blob (a gate of 4 px + 0.6 x the predicted radius, capped at 12 px; stop at the image's edge; gaps of up to 12 frames bridged; a fragment's size gives no range), a later tracklet linked across the lamp's glare when one arc fits both sides, and the worst points dropped while they miss by more than the trim gate. The range from the blob's size reads 0.94-0.98 of the depth's beyond 2 m and 1.1-1.3 nearer (`size_gain` 1.32 from the auto-tune is right only near 1.7 m: the shaded part the threshold cuts depends on range and light). Depth and IR blob stereo still find no arc on the real ball (the room and the person are foreground; the IR "arcs" are the lamp): colour + depth at the pixel is the source.

**Settings.** Colour window, exposure and gain come from `bv.sh realsense`'s saved settings (`~/omni_ws/ball_view_settings/realsense.json`; else 3 ms, the camera's gain, auto white balance off). The IR images are dark at the default 1 ms exposure with the emitter on (seen on the first capture): raise `--ir-exposure-us` or try `--emitter off` for the IR detectors, and compare in the replay. Everything used is stored in `session.json` (`rs`: options, factory intrinsics and extrinsics, depth scale, baseline).

**The ball (a temporary test ball, for the camera characterization only: the robot's ball and `robot_v11.json` are unchanged).** Orange foam, 73 g, circumference 19 7/8 in = 504.8 mm, so **diameter 160.7 mm** (radius 80.3 mm), against the robot's 74 mm / 22 g. `record_rs.py` writes it into `session.json` (`ball`; `--ball-circumference-in`, `--ball-mass-g`, `--ball-cd`) and `rs_analyze.py` uses that session's ball (the robot config's values updated by it, as `analyze_throws.ball_of` does) for the **drag law** (this ball's quadratic drag constant is 0.084 /m against 0.059 /m: 4.1 against 2.9 m/s^2 at 7 m/s; on a synthetic throw with this ball the depth arc is 3.8 mm from the truth with the right drag, 6 mm (max 28 mm) with the robot ball's, 17 mm (max 42 mm) with none) and for the blob-size gates (68 px radius at 0.5 m on the IR lens: `ir_max_r` is 100 px). The drag coefficient 0.5 is the robot config's estimate, not measured for this ball; spin (Magnus) is not modelled. **Colour:** the detector's default hue window is for the optic-yellow ball (45-100 deg); orange needs the window set (click the ball in `bv.sh realsense` and save, or `--hue`), and any other orange in view (a bucket, a cone) will be a candidate.

**Format.** Colour keeps `frames.npy` / `stamps.npy` (so `analyze_throws.py` still reads it); depth and IR have their own files at their own rates (colour 60 fps, depth / IR 90) on **one clock**, librealsense's global time (mid-exposure on the host's clock): `Throw.t_of(name)`. `stamps` = [mid-exposure ns, host arrival ns, frame counter]; `*_info` = [exposure us, gain, laser power]. `camera.f_px` in `session.json` is the factory calibration (colour f 616 px, 42.6 deg vertical), not an estimate. `setup_*.npy` / `end_*.npy` are the empty scene before and after (did the rig move?).

**Measured so far (Pi 4, USB 3.2, Oct 30):**
- `rscheck`, 8 s, colour 848x480 @ 60 + depth and IR pair 848x480 @ 90: colour 59.5 fps, 0 lost, stamp to host 18.2 ms; depth / IR 89.7 fps, 2 lost, 10.1 ms; `global_time` domain. Colour and depth / IR are **two pipelines** (the camera accepts them; one pipeline would hold the 90 fps frames for the 60 fps colour). Extrinsics between the two pipelines' streams come only from the *device's* sensor profiles (the pipelines' own raise "Requested extrinsics are not available"): depth to colour 15 mm, IR baseline 49.85 mm.
- A throw is ~420 MB (four streams, 2 s). The Pi's SD card sustains 13-18 MB/s (`dd`), ~30 s a throw, so the recorder writes to RAM (`/dev/shm`, 1.2 GB budget, `--spool-mb`) in ~2 s and moves to the card in the background (9-42 s each). Capture kept its rates through it (one throw lost 2 IR / depth frames). A throw seen while the spool is full is ignored with a message: wait for "on disk". Faster storage on the Pi's second USB 3 port would remove the limit.
- Replay on synthetic throws with known truth: the drag-law arc is within 2 mm of the truth (depth) / ~1 cm (IR blob stereo); a plain quadratic, which `rs_throw.py` uses, is 3 cm off (a 74 mm foam ball's drag is 2-3 m/s^2 at 7 m/s). Colour and depth clocks agree within +-2 ms, and the time-shift test is that sharp (1 ms is 0.5 cm). On the first real capture (an empty scene with a person at a desk) the acceptance gates (|a| near g, >= 8 frames, >= 0.15 s, >= 1 m/s, >= 35% of the frames along the path) reject every noise "arc".
- **Still not done after the real sessions:** a live prediction with independent landing truth, the sound, moving-camera tracking, and a matched Arducam throw comparison. The depth origin's place in the housing comes from Intel's drawing (4.2 mm behind the front glass, 17.5 mm from the tripod hole's centreline: `bucket.json`) but assumes the CAD's "back-face middle point" is that centreline: verify against the part you modelled. The night sessions above supersede the original daytime note that no real ball had been thrown.

**The verdict (`rs_predict.py`).** Reference = the drag-law arc through all detections (gravity along the mount's `up`) and where it crosses the rim plane going down; the radial miss `d` from the rim's axis gives in (`d < R - r_ball`), rim (touches) or out. Causal = the same arc refitted after each detection. **Time to correct** = the time to go at the earliest detection from which the verdict never again differs from the reference. The association is the offline fit's (an oracle), so wrong-blob rejection isn't tested here; throws whose reference touches the rim are flagged ambiguous. With the 160.7 mm test ball in the 284.48 mm opening the clean-entry window is small: the ball's centre within 62 mm of the axis is "in", 62-222 mm "rim" (it touches the edge), beyond 222 mm "out"; the binary call used for the time to correct is the centre inside the rim circle (d < 142 mm). The reference and the live estimate come from the same camera, so a wrong field of view, pitch or rim offset moves both: this tests how soon the estimate settles, not its absolute accuracy (hold a ball still at the rim's centre and edges, or watch ~10 throws by eye, to check that once).

**Mount geometry (a CAD input).** With the 30 deg CAD the rim centre is 35 cm above the camera's optical axis and 2 cm ahead of its optical plane, 87 deg off the axis: it is never in view, so the crossing is always extrapolated. For a lob released 4.5 m out (or 6 m) and 1.15 m above the camera, 1 s in the air, aimed through the rim's centre, the ball is out of the view this long before the crossing (ideal pinhole, the bucket's position as drawn, only the pitch varied; depth / IR field of view 87 x 58 deg, colour 69 x 42 deg):

| Camera pitch | blind, depth / IR (4.5 m / 6 m) | blind, colour (4.5 m / 6 m) |
| --- | --- | --- |
| 20 deg | 406 / 266 ms | 558 / 406 ms |
| **30 deg (the CAD)** | **236 / 148 ms** | **368 / 236 ms** |
| 35 deg | 174 / 112 ms | 280 / 174 ms |
| 40 deg | 128 / 86 ms | 206 / 132 ms |
| 45 deg | 96 / 68 ms | 152 / 100 ms |

A steeper camera sees more of the late flight; the cost is the early flight (at 40-45 deg the colour camera starts seeing the ball 70-250 ms into the flight). A release lower or farther than these leaves the view sooner.

## Oct 31 recording audit: appearance, false throws, Pi time, next experiments

**Conclusion:** keep the D435 for the next controlled experiment. The native colour detector is fast enough in isolated Pi replay, and the ball is visible in the clear throws. The present trigger does **not** reliably distinguish free flight from ball handling or a moving rig. Neither a 100% detection claim nor a camera purchase decision follows from these recordings. No frozen detector, recorder, predictor or robot core was changed in this audit; `loc3` remains reserved for testing a future change, with baseline inspection only. Nothing committed or deleted.

**Evidence and reproduction.** `results/audit_20261031/` contains one strict JSON per clip (sources, accepted picks, photometry, stream health and predictions), full-clip and ball-crop sheets, `visual_review.json`, `rig_stability.json`, `ir_probes.json`, and the two Pi timing JSONs. `provenance.json` hashes the frozen analysis/trigger files. Raw files and Fernando's existing `meta.json` reviews were read only.

```
# Sim venv, from repo root; cached per-clip results are skipped:
python characterization/throw_track/rs_audit.py C:/Users/ferna/throw_data
python characterization/throw_track/rs_audit.py C:/Users/ferna/throw_data --ir-probes-only
# realsense venv (OpenCV):
python characterization/throw_track/rs_audit.py C:/Users/ferna/throw_data --scene-only
# Pi rs venv, without opening a camera (copy just these new scripts first):
python rs_replay_bench.py data --out results/rs_replay_bench_pi_20261031.json
python rs_shape_bench.py data --out results/rs_shape_bench_pi_20261031.json
```

Use the exact interpreters in AGENTS.md, not PATH's `python`. `tt.sh test`: **27 passed, 1 skipped, 153.56 s** (the skipped test requires OpenCV in the other venv). The audit initially failed to serialize existing non-finite fit statistics; its serializer now preserves these as JSON null, and the complete rerun saved all 28 clips. The Pi timing script's initial missing output-directory error was fixed and its full rerun completed. These were reporting failures, not detector changes.

**What is actually on disk.** PC: **28 clips** across 13 sessions, including an empty bucket1. The earlier `realtest` is also a D435 four-stream capture of a person at a desk, not an Arducam throw. Loc4/5 are absent on both PC and Pi. Loc1 has no IR; all other nonempty sessions have all four streams. Pi has the same named sessions except `realtest`, plus the two empty aborted loc2 sessions. The Pi's originals were retained (5.4 GB free). A saved clip is selected by the colour trigger: this corpus cannot count throws that failed to trigger or were refused by the spool.

**Visual classification, not outcome labels.** Full-clip sheets, accepted-pick crops and a denser bottom-half check for loc1 t005 give the following provisional assessment. Fernando could not recall these individual clips and asked the analysis to judge them. None of these observations was written over his reviews.

| Session | Clear free flight visible | Handling / rig motion rather than clear free flight | Frozen offline colour result |
| --- | --- | --- | --- |
| loc1 | t001, t003, t004 | t002 carries/repositions the ball; t005 carries it down beside the leg | Fits all three clear throws **and t002**; rejects t005 |
| loc2 | t002, t003, t005 | t001 moves the rig and fits a painting patch; t004 holds/moves the ball | Fits all five, including both negative cases |
| loc3 (reserved check) | t001, t005 | t002, t003, t004 handle/reposition the ball | Fits all five, including all three negative cases |

Thus **8 clear throws and 7 handling/rig-motion clips**, not 15 established throws. All eight clear throws get a colour arc; **6/7 negative clips also get an arc**. The six labelled night lobs are recovered too; bucket9 t005 (walking away) is rejected. Across all 28 clips the colour source returns 21 fits; that is an internal fit count, **not recall**. Early bucket5 still gets no colour arc under its old settings. The new Pi causal replay fires in every loc clip, including all seven negatives; it is not a validated free-flight classifier. No frame-by-frame independent centre/visibility labels or new landing outcomes exist. The night binary bucket result remains 5/6 on the previously tuned six clips; no new bucket-accuracy score is claimed.

**How the balls look.** These figures use the accepted colour picks in the eight visually clear loc clips. They include a few release/hand-adjacent points; they do not sample pixels where detection failed. Diameter means **equivalent diameter of the thresholded colour mask**, with `size_gain` removed, not a caliper measurement of the complete silhouette. V is the median maximum RGB channel in an inner half-radius disk, divided by 255; it is an encoded brightness proxy, not lux or physical radiance. Table ranges are pooled **10th–90th percentiles**, with median V in parentheses.

| Scene | Configured exposure / gain | Mask diameter | Core V | Centroid travel during configured exposure |
| --- | --- | --- | --- | --- |
| loc1 daylight living room, orange | 2 ms / 128 | 16–39 px | 0.15–0.30 (0.20) | 0.77–1.50 px |
| loc2 warm dim room, yellow | 8 ms / 128 | 19–36 px | 0.16–0.21 (0.18) | 2.61–9.96 px |
| loc3 kitchen, yellow | 2 ms / 64 | 23–43 px | 0.22–0.30 (0.26) | 1.28–1.71 px |

The colour ball is usually **darker than its immediate surroundings**: median encoded-luma difference (core minus annulus) is −0.173 / −0.070 / −0.028 for loc1/2/3. Visually the daylight orange ball stays fairly round against the ceiling; the 8 ms yellow ball has visibly softer/directional edges, and ceiling lamps can erase parts of its rim. The threshold loses shaded portions and changes the measured size/centre. A small arc residual therefore does not establish an unbiased ball centre. Travel = measured image centroid speed × **configured** exposure; it is not a direct blur-length or rolling-readout measurement. No matched exposure sweep at fixed light was recorded, so cross-room brightness differences are not an exposure experiment.

**Exposure field discrepancy:** real `color_info.npy[:,0]` is 20 in loc1/3, 80 in loc2 and 50 at night, matching `rs.options.color_exposure_100us`; the recorder labels this field "us". Session camera settings specify 2000/8000/5000 us. Depth/IR fields contain 1000. The audit preserves those raw fields and uses the configured colour exposure for travel estimates; interpreting 20 as 20 µs would understate blur by 100×. Before the next recording, normalize/tag the metadata units explicitly, preserve old files, and verify timing with the optical flash test. No optical exposure-width measurement was made here.

**How much flight is tracked, and where it disappears.** Accepted spans in the eight clear loc clips: **0.168–0.890 s**. Loc1 t003/t004 have 42/54 accepted frames and spans 0.689/0.890 s, with 1.20/1.53 px fit RMS; first/last fitted camera-z ranges are 5.95→1.71 m and 5.98→1.73 m. T003 goes through the top; t004 exits left, with late mask fragments at the bright window. Loc1 t001 and the clear loc3 throws go through the top. Loc2 t003/t005 also go through the top after short spans; t002 is a close ball moving behind the foreground person/leg, not a long 3.5 m approach. No measured thrower distances/angles support the planned location names. Yellow-ball range/drag values are especially provisional: session metadata incorrectly inherits the orange ball's colour, 160.7 mm diameter and 73 g mass. The yellow ball's actual diameter, mass and drag remain unmeasured. The rim is outside the camera view (geometry table above), so none of these clips directly observes the rim crossing.

**Stability and frame loss.** ORB feature matches (4000 features, ratio 0.75, homography RANSAC 3 px) between setup/end colour stills give median matched-background displacement **11.0 / 88.3 / 32.7 px** in loc1/2/3 (1533/868/286 inliers spread across the scene). Night bucket7/8/9 give 1/0/1 px. These are image displacements, not calibrated camera translations or proof of stability between stills. Early bucket1–6 have no paired end stills. Loc2 t001 visibly moves the view within its clip. Loc2 t002 loses **42 frames per depth/IR stream** (139 saved, 69.7 fps; maximum IR gap 44.5 ms), considerably worse than the earlier notes; loc3 t003/t005 lose 6 depth and 7 per IR stream. All 28 colour clips have zero counter gaps, approximately 59.5 fps. Counter gaps do not count refused/unsaved throws.

**IR is promising hardware, not a working alternate detector yet.** `ir_candidates` only accepts `IR − background > 35`. The night ball is a weak/dark silhouette, and the accepted IR "arcs" can sit on the lamp: bucket7's IR fit gives 4.0→3.4 m while the actual colour ball approaches 6.2→1.0 m. In loc3 t005 the depth fit continues on room/person geometry after the ball is gone; the reported depth/IR arc disagreement is 4.0 m RMS (its 1.99 s comparison window also extrapolates beyond their observations). Internal `ok=True` is not successful ball tracking. In this audit there are 11 such IR fits and 2 depth fits; none was validated as a complete independent ball trajectory.

Conditional IR1 probes at colour-picked rays (factory calibration, colour range, nearest IR frame within 8 ms, half mask-radius core) have median raw brightness **18–19/255 at night and in loc2**, versus **69/255 in loc3**. Median ball-minus-empty-background is −1 to −3 levels at night/loc2; their 90th-percentile fraction of core pixels above background+35 is **zero**. Loc3's median difference is +18.5 levels. These probes share the colour association/range and have timing/parallax errors: they explain a cue mismatch, not independent IR recall. Try two-sided contrast/edges and stereo patch matching in small regions, with an explicit moving-camera background model, before rejecting global-shutter IR on the basis of this bright-blob algorithm.

**Pi timing, actually measured on the Pi 4.** `rs_replay_bench.py` uses the same native `FastDetector` (six whole-frame candidates, as the recorder), `ArcTracker(min_speed=1.2)` and numpy `depth_in_front`. Depth is the latest preceding sample no older than 40 ms. It preloads one clip into RAM, replays twice without pacing, resets tracks per clip, and does no background learning/re-arm logic. Native and arc source hashes match the PC. Performance governor, one BLAS thread; no camera or other robot stack was started.

- **27 Pi clips, 6520 processed frames:** per-clip p95 **2.34–7.06 ms**; weighted CPU **0.195 core at 60 fps**, clip range 0.110–0.338. Three frames exceed 16.8 ms: 23.3, 29.1 and 64.6 ms. This fits the typical colour frame interval; it is not a worst-case deadline guarantee.
- Includes native candidate search, arc association/judging, and the depth hand check when it fires. **Excludes** USB capture/copies, storage, ROS, the robot's EKF/behaviour, full 3D ray-arc fitting, any new fusion gate, thermal soak, and optical-to-command latency. It is neither the full recorder nor a live catch benchmark. `rs_analyze` uses scipy and whole-clip association/growing; its output is not a Pi-live implementation.
- `rs_shape_bench.py`, installed OpenCV 4.6, one thread, two clips × ten sampled frames × two repeats per mode: fixed illustrative Hough settings, **no accuracy tuning**. Full-frame 848×480 Hough median **533/704 ms**, p95 **551/732 ms**, with median **211/402 circles**. At 60 fps that is ~32–42 CPU-seconds per second. 96×96 regions cost median **0.36/0.91 ms**, p95 **5.32/2.69 ms**, still with extraneous circles. Regions are seeded by the recorder's largest blob; this does not establish acquisition or ball recall. RAM loading excluded, first OpenCV call included.
- The previous catch-tier 0.76–1.4 cores (`rpi.md`) and capture-only 0.59 core (D435 640×480 colour plus depth/IR, earlier one-pipeline minute) were **separate runs**. Do not add these as a measured total: some detector work overlaps and modes differ. A combined live run at the actual 848×480/two-pipeline settings is still needed, on Ethernet and wall clock, with the camera on the Pi.

**Camera/light choices (inference and proposals, not measured comparisons).** D435 IR/depth uses a global shutter; its RGB is rolling ([D400 datasheet](https://realsenseai.com/wp-content/uploads/2024/10/Intel-RealSense-D400-Series-Datasheet-October-2024.pdf)). Global shutter removes row-time distortion; it does not remove motion during an exposure ([RealSense motion/exposure guide](https://dev.realsenseai.com/docs/high-speed-capture-mode-of-intel-realsense-depth-camera-d435/)). Near the image centre, blur travel is approximately `f_px × transverse_relative_speed / range × exposure`; add camera angular image motion as well. At colour f≈616 px, a 2 m/s sideways base at 2 m adds ~1.23 px over 2 ms or 4.93 px over 8 ms, if perpendicular to the sight line (at 1 m, twice that). This is a calculation, not a moving-robot result. The recordings do not measure scan readout, vibration, tracking under robot rotation, or relative ball/base motion. The wider IR view is attractive; existing 1 ms dark images and failed cue selection do not tell us its best achievable performance.

Going from 8 to 2 ms needs roughly **4× the incident light** for the same photoelectron count at fixed optics; from 2 to 0.5 ms likewise. Gain amplifies noise too and cannot replace photons. Use steady broad visible LED light or daylight first, aimed over the flight volume, then test a camera-adjacent IR flood separately if needed. Measure ball contrast, clipping and detection, rather than making the whole room look bright; WB should maximize ball/background separation and stability, not minimize room saturation. Illumination from a light on the robot falls with distance squared. We did not measure lux, spectral response, photon/read noise or a lamp's flicker. A laser spot illuminates only a spot and needs to find the ball first; it is a poor acquisition plan. Prefer diffuse, eye-safe LED illumination.

Keep the large yellow/orange foam ball as a diagnostic reference, but include the **actual 74 mm robot ball** before choosing a camera. At 6 m and f=616 px, its ideal diameter is **7.6 px**, versus 16.5 px for the 160.7 mm ball; its area is only 21%. `ArcCfg.min_r_px=4` is already near that smaller ball's ideal radius, before threshold loss and coarse sampling (the configured `size_gain` changes the exact cutoff). Today's result on a large ball cannot validate 6–7 m tracking of the robot ball. A pickleball may add stereo texture, but holes remove coloured area, its size is much smaller than this test ball, and it changes drag, spin and the catcher/launcher problem. It was not tested. Visible yellow/orange does not establish near-IR reflectance. Retroreflective tape/ball deserves a separate A/B session with projector on/off, several distances and rotations; a small patch flickers with spin, saturation may spoil the depth map, and return strength depends on source/imager angle. The D435 projector is a sparse pattern designed for stereo texture ([projector guide](https://dev.realsenseai.com/docs/projectors/)), not a guaranteed floodlit reference ball. IR association can cross-check colour errors but shares this rig's pose/calibration; external landing truth is still required.

The Arducam/Camera Module 3 can help **frame rate and delivery latency**: the earlier Pi camera-head run processed 120 fps with ~15 ms sensor-stamp-to-publish and 0.45 core. That was not these thrown balls or these room/exposure conditions. Module 3 remains rolling shutter, and a single camera lacks the D435's hardware depth/stereo. Fix focus for the throw volume and compare the same ball/light/distance at fixed exposures; there is no recorded matched throw comparison proving it is brighter or more accurate. A future colour global-shutter camera is a plausible option, not a conclusion from these clips ([Raspberry Pi shutter explanation](https://www.raspberrypi.com/documentation/accessories/global-shutter-camera.html)).

**Proposed next experiments, in order.**

1. **Make a small honest benchmark before another 25 throws.** Fix the rig rigidly, check a stationary fiducial each clip, measure both balls and distances, and correct/tag exposure units and ball metadata. Record short continuous blocks or externally marked attempts irrespective of the colour trigger, including failed triggers; retain a manual/foot-button mark and an external phone view of release and rim. Score "no throw / handling / free flight / obscured / out of view" separately from in/rim/out. Keep negative clips and long idle footage. Store to faster external storage after a measured USB/capture stress check, or use colour+depth for most runs and brief four-stream side sessions; show spool capacity and an unambiguous READY indication. Wired 100 Mb/s is ~11 MB/s, insufficient for continuous ~220 MB/s four-stream raw transfer; copying after capture and smaller/compressed recordings are different problems. Do not delete originals without Fernando's agreement and verified copies.
2. **A guided setup tuner, not whole-frame Hough.** Ask for the ball in a marked image region, then a short left/right/up/down and toward/away movement that separates it from the stand. Use the common motion across a round/elliptical contour, colour, size/depth consistency and stereo/depth support to identify the object. Depth is optional/noisy, not a mandatory veto. Hough/edge fits run in the small proposed regions, at setup rate; reject ambiguous multiple candidates and allow a centre click. Optimize exposure/gain/WB jointly for ball separation in the flight volume under a short-exposure cap; test a few poses/rotations, not just one table pixel. Print expected radius/contrast, decoy count and a preview before accepting. A tune may legitimately report insufficient light. This movement identifies the ball for tuning; it must not count as a throw.
3. **Causal free-flight recognition in the real robot code.** Keep `FastDetector`/the matching C++ core as the candidate generator, and add local shape/IR/depth support and several competing tracks. Separate "ball seen" → "held/moving candidate" → "free flight confirmed" → "temporarily obscured/lost". Compare the robot's gravity+drag flight model against held/constant-velocity hypotheses in 3D with measurement uncertainty, known IMU/calibrated up and camera pose at exposure time; use genuine depth growth to catch head-on throws, not image-speed alone. Require consecutive predictive innovations and separation from the hand/foreground where observable; defer ambiguous short tracks. The present size/depth gate rejects a skin patch on an arm but cannot reject a correctly sized ball in a hand. Global background motion should inhibit a fixed-rig trigger or be compensated by measured ego-motion. Hough alone does not distinguish a carried round ball. None of this new classifier was implemented or timed in this audit. Change Python and C++ catch twins together, keep Pi imports numpy-only where required, and score the frozen before/after on **all** 28 clips plus continuous negatives. Tune only on night/loc1/loc2; run loc3 once after freezing knobs, then acquire a fresh held-out room. Measure frame recall, wrong associations, confirmation delay, reacquisition and missed attempts, not just "an arc exists".
4. **Light/shutter A/B with the camera stationary.** Same marked trajectory/ball: 0.5/1/2/4/8 ms, a fixed WB, gain sweeps and room light vs added broad LED; IR 0.5/1/2 ms with projector on/off. A small static ball grid first cheaply separates reflectance/SNR from motion. Then a handful of independently recorded throws per promising setting. Compare the D435 and Arducam sequentially in identical conditions, or simultaneously only with measured timestamps and calibrated views. Test retroreflection as its own experiment; do not mix its altered ball with foam-ball scores.
5. **Simulation and hardware-in-loop, with clear boundaries.** Replay the measured rays/ranges and gaps through the real robot tracker/controller first; simulate base translation/rotation, camera pose, FOV, exposure integration, rolling rows, vibration and delay sweeps next. Use measured uncertainty ranges; rendered sim does not validate real photometry, reflectance, flicker, Bayer/shading, stereo failure, timing bias or yellow-ball drag. A fixed real camera can measure a world flight that drives a simulated moving robot (`ghost`), with calibrated camera→world and synchronized exposure times; the simulated robot's changing pose must be used consistently. That tests compute, transport, prediction and reachability under the assumed motion model. It **does not** put real ego-motion blur/parallax in the stationary camera. Finally move the real camera on a measured slider/turntable or the robot to test those optical effects. Claim "would reach" only against an independently scored world crossing and logged actuation deadlines, not agreement between fits of the same video.
6. **Combined Pi acceptance run.** Ethernet, wall clock after clock checks, capture and real detector/tracker/behaviour on the Pi, only physics on the PC. Measure a sustained run's per-stage median/p95/p99/max exposure-to-detection/command age, queue age, dropped frames, per-core CPU and thermal throttling, with and without optional ROI shape support. Bounded latest-frame queues should expose/drop stale work. The typical replay times justify this experiment; they do not yet prove the combined tier fits, nor that Pi Nav2 now fits. Keep navigation on the proposed main computer until separately demonstrated.
