fernandomierhicks/omni-robot/cad/v10 human editable/validation/motor_case_wall_scan_console.txt

dummy_motor_case minimum 0.11 thin clusters 8
