fernandomierhicks/omni-robot/cad/v10 human editable/validation/d435_bar_closeup.png

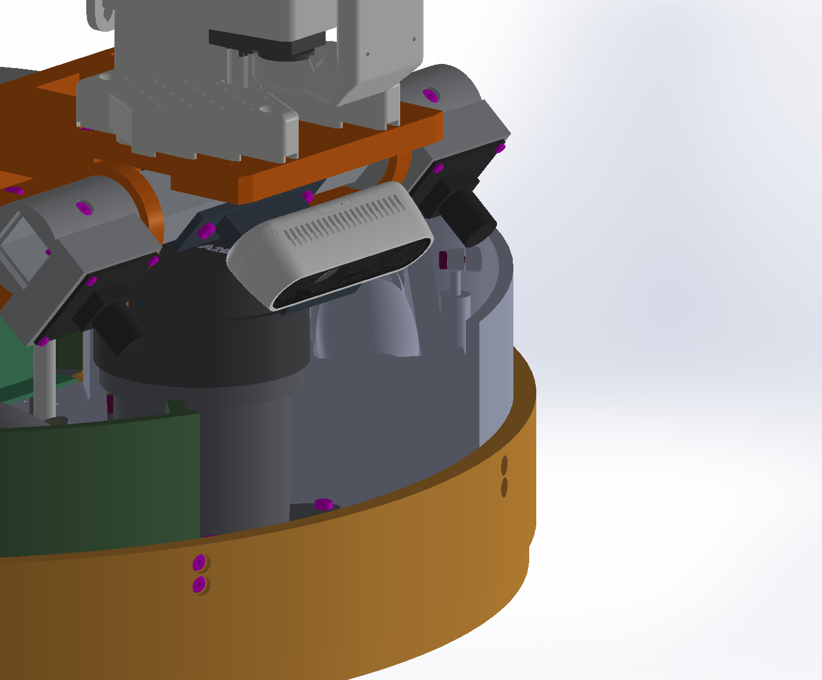
cad/v10 human editable/validation/d435_bar_closeup.png
