fernandomierhicks/omni-robot/cad/v10 human editable/validation/d435_nose_closeup.png

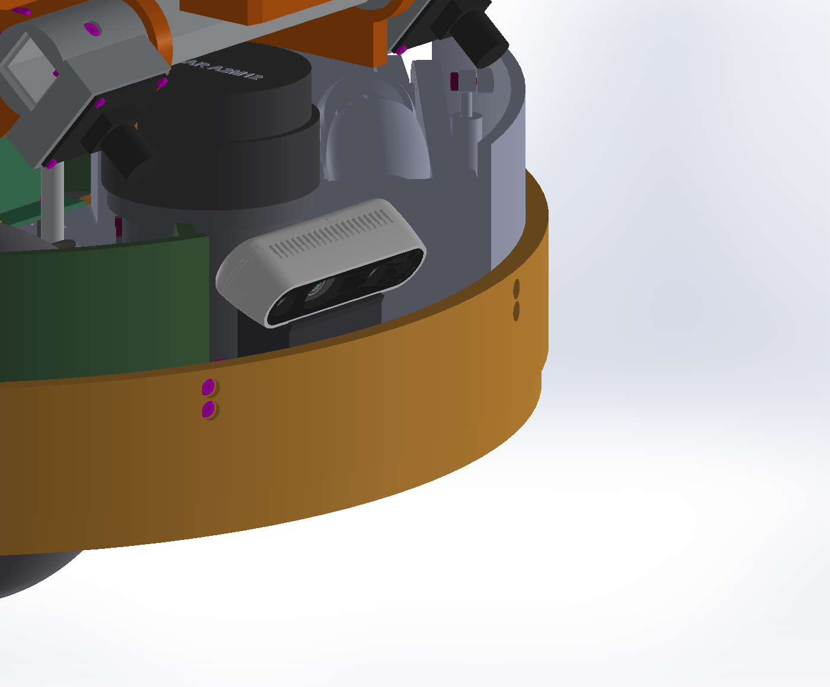
cad/v10 human editable/validation/d435_nose_closeup.png
