fernandomierhicks/omni-robot/cad/v10 human editable/validation/d435_side_orthographic.png

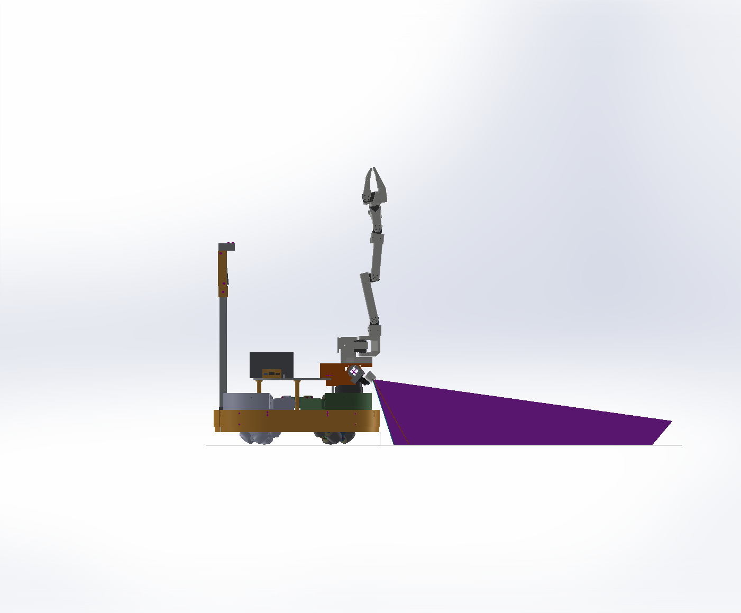
cad/v10 human editable/validation/d435_side_orthographic.png
