fernandomierhicks/omni-robot/cad/v10 human editable/validation/d435_source.png

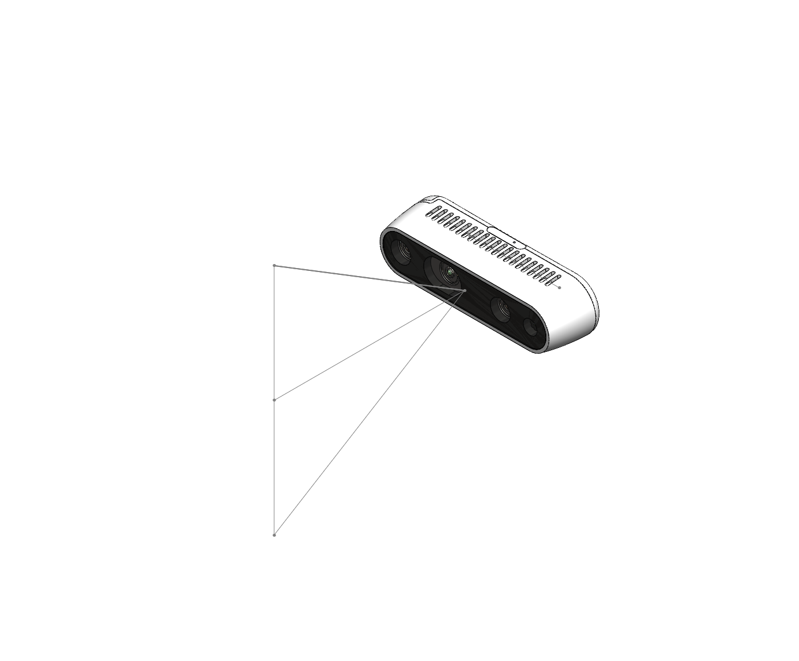
cad/v10 human editable/validation/d435_source.png
