fernandomierhicks/omni-robot/cad/v10 human editable/validation/pod_attachment_points.png

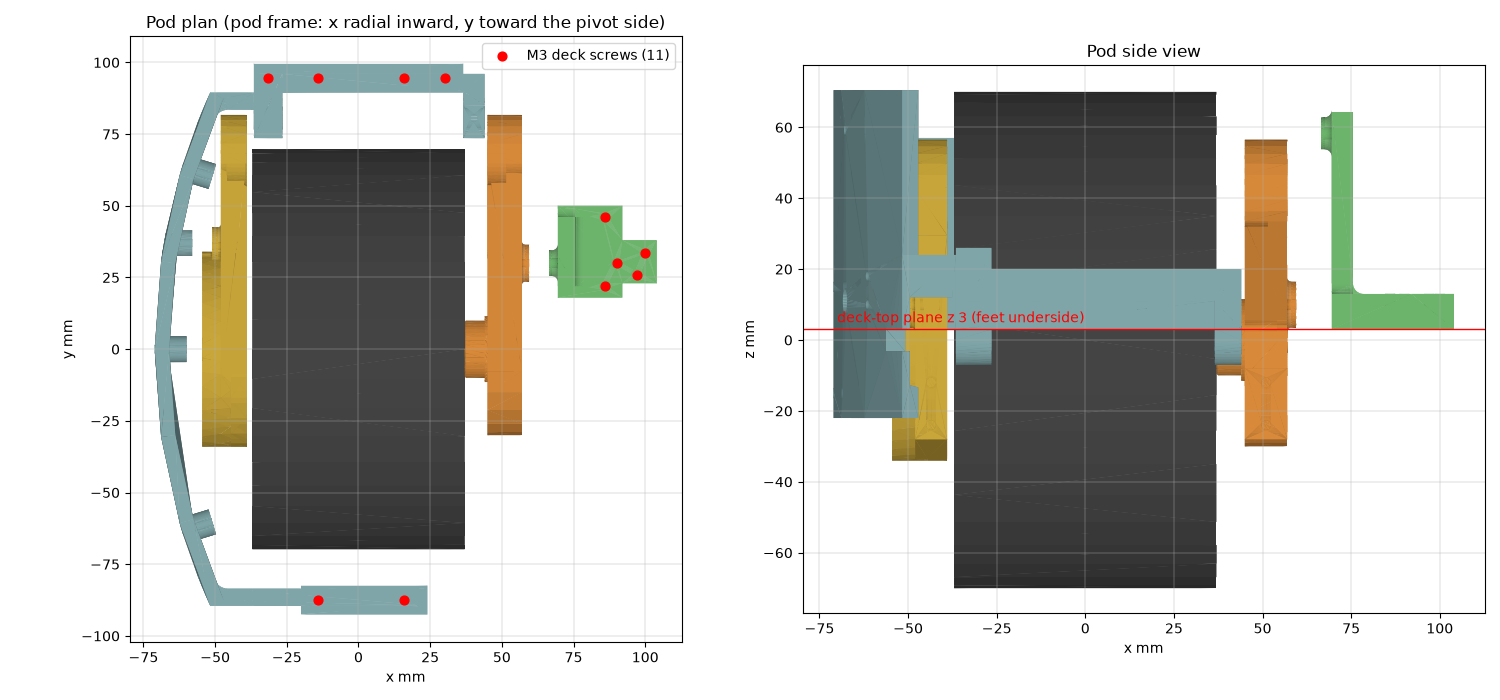
cad/v10 human editable/validation/pod_attachment_points.png
