fernandomierhicks/omni-robot/cad/v10 human editable/validation/robot_d435_bar.png

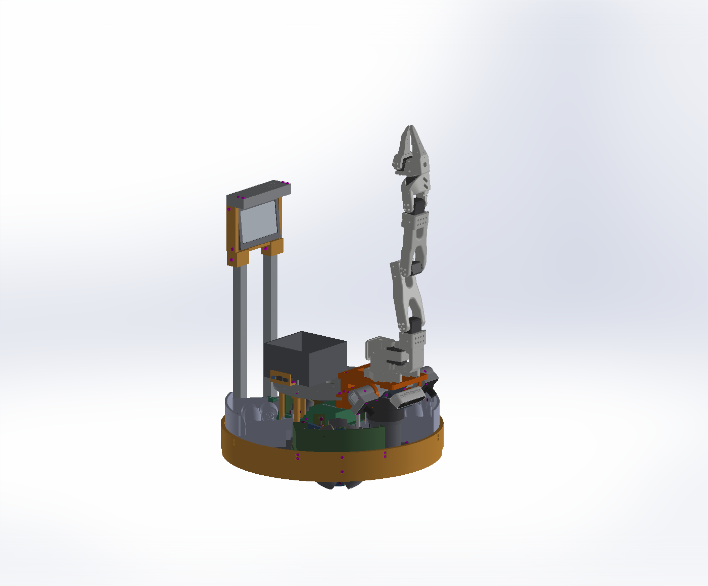
cad/v10 human editable/validation/robot_d435_bar.png
