fernandomierhicks/omni-robot/cad/v10 human editable/validation/robot_floor_reach.png

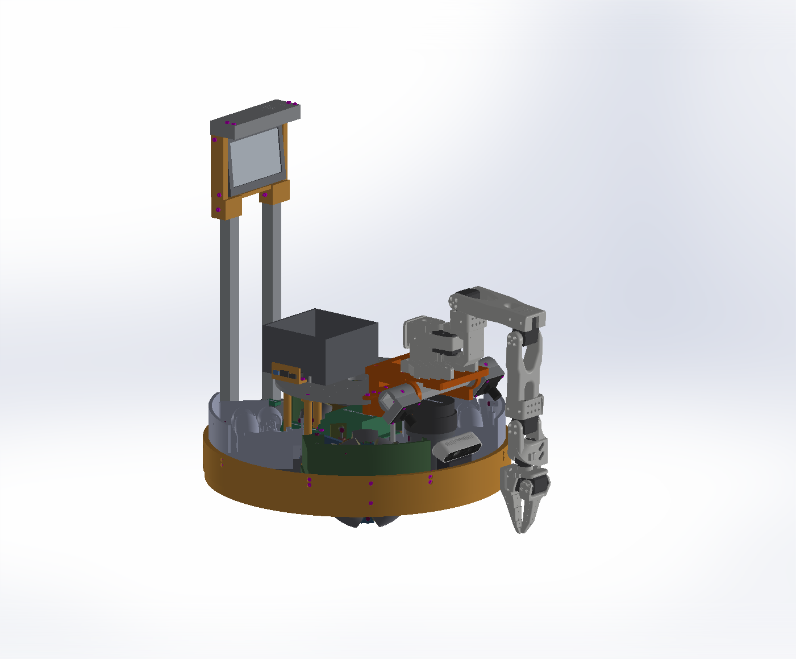
cad/v10 human editable/validation/robot_floor_reach.png
