fernandomierhicks/omni-robot/cad/v10 human editable/validation/wheel_motor_v2/iso_hub_other.png

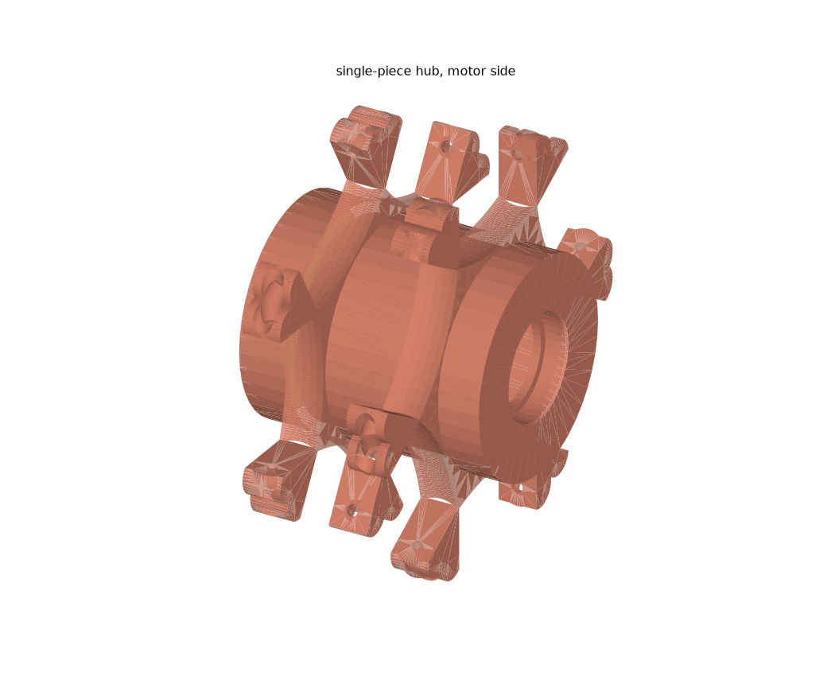
cad/v10 human editable/validation/wheel_motor_v2/iso_hub_other.png
