fernandomierhicks/omni-robot/cad/v10 human editable/validation/wheel_motor_v2/iso_whole.png

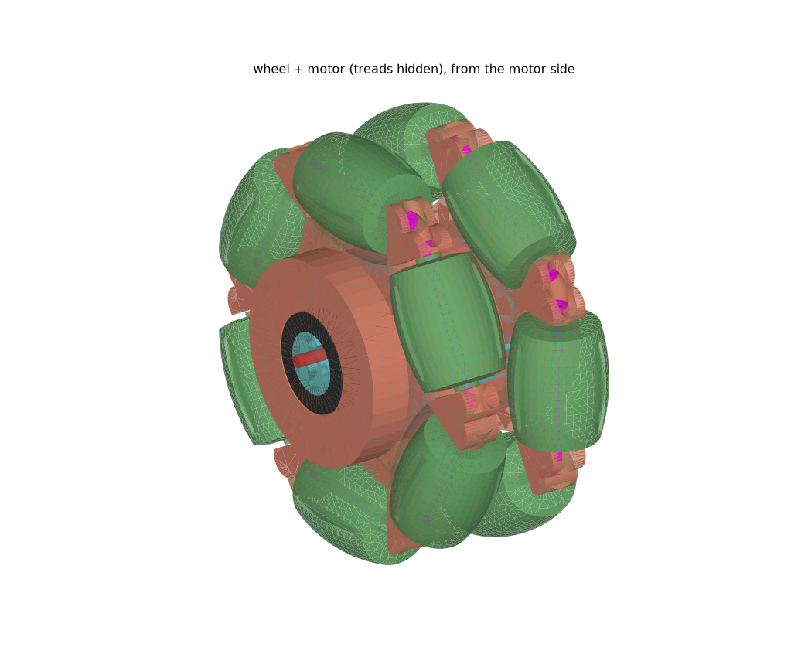
cad/v10 human editable/validation/wheel_motor_v2/iso_whole.png
