fernandomierhicks/omni-robot/cad/v10 human editable/validation/wheel_motor_v2/section_axis_plane_z0.png

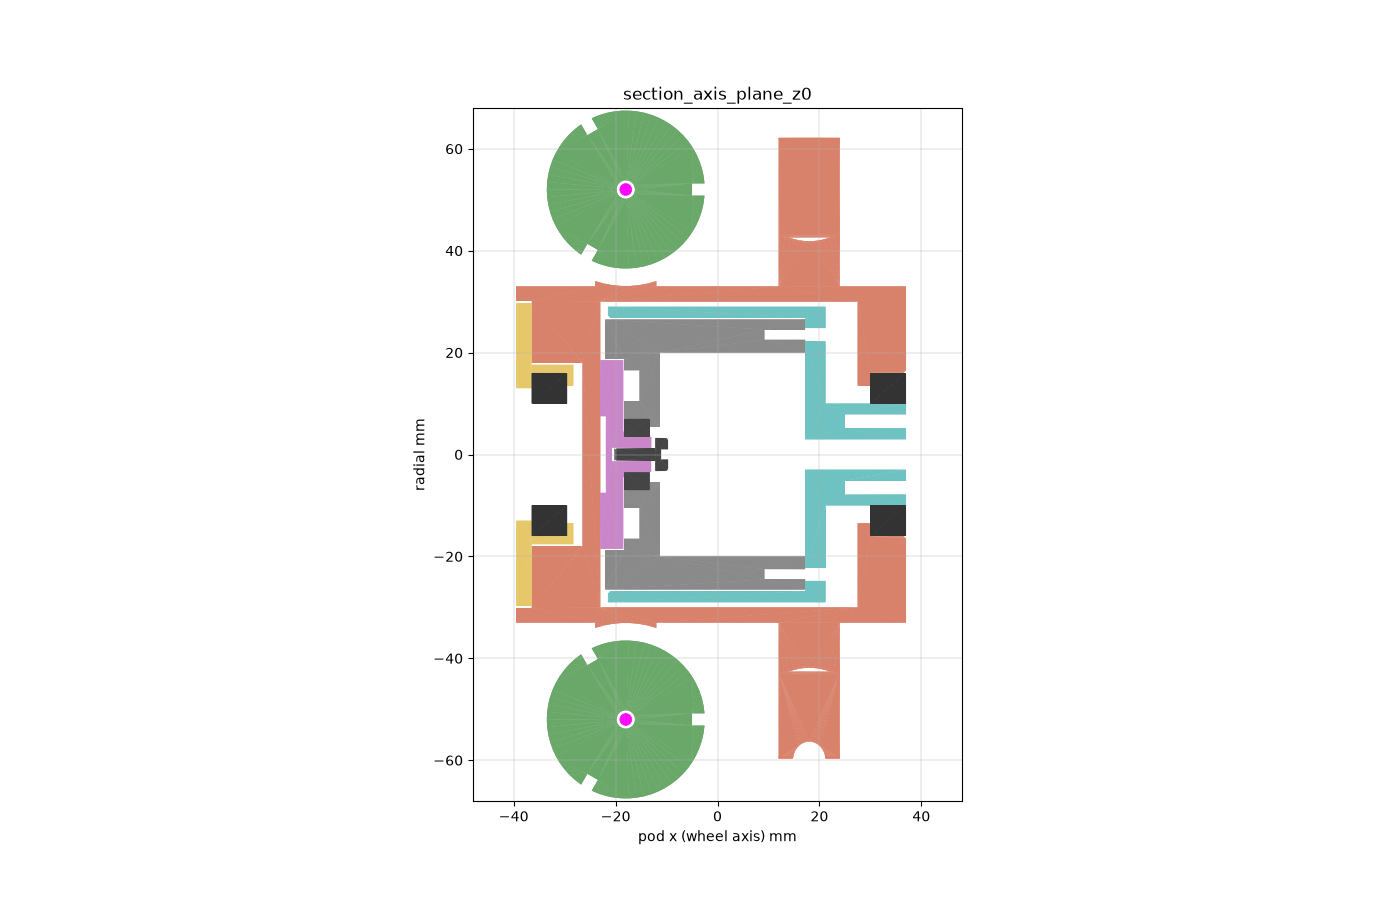
cad/v10 human editable/validation/wheel_motor_v2/section_axis_plane_z0.png
