fernandomierhicks/omni-robot/cad/v10 human editable/validation/wheel_motor_v2/section_cable_plane_45deg.png

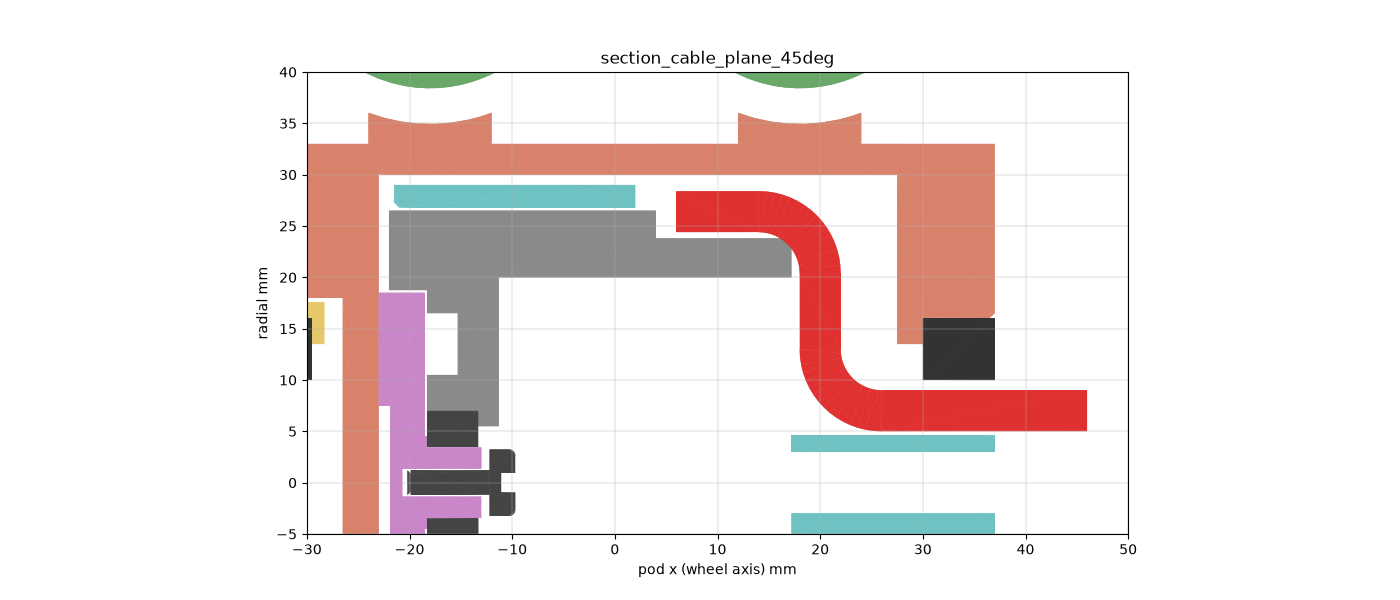
cad/v10 human editable/validation/wheel_motor_v2/section_cable_plane_45deg.png
