fernandomierhicks/omni-robot/cad/v13/validation/d435/iso_front.png

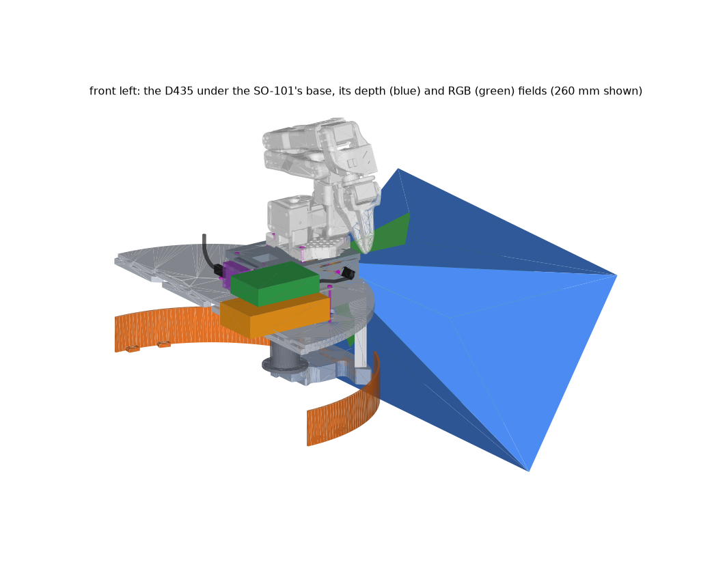
cad/v13/validation/d435/iso_front.png
