fernandomierhicks/omni-robot/cad/v13/validation/d435/side_fov.png

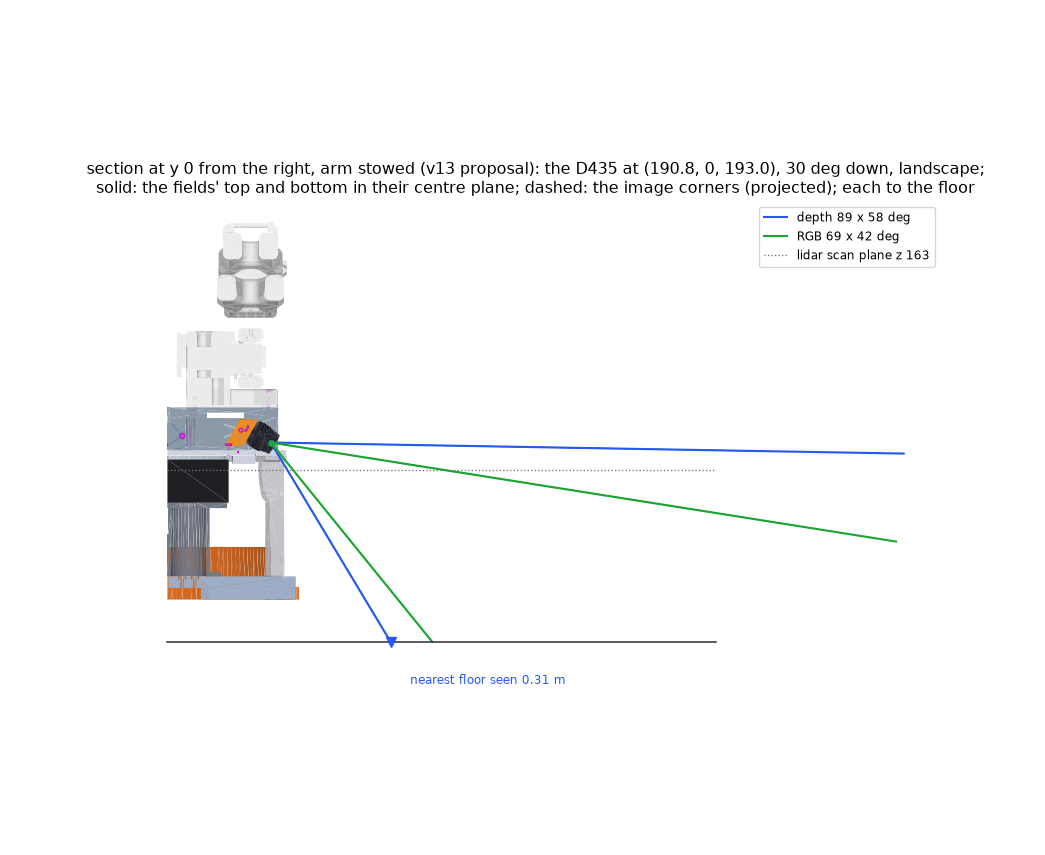
cad/v13/validation/d435/side_fov.png
