fernandomierhicks/omni-robot/cad/v13/validation/d435/side_grasp_0.26.png

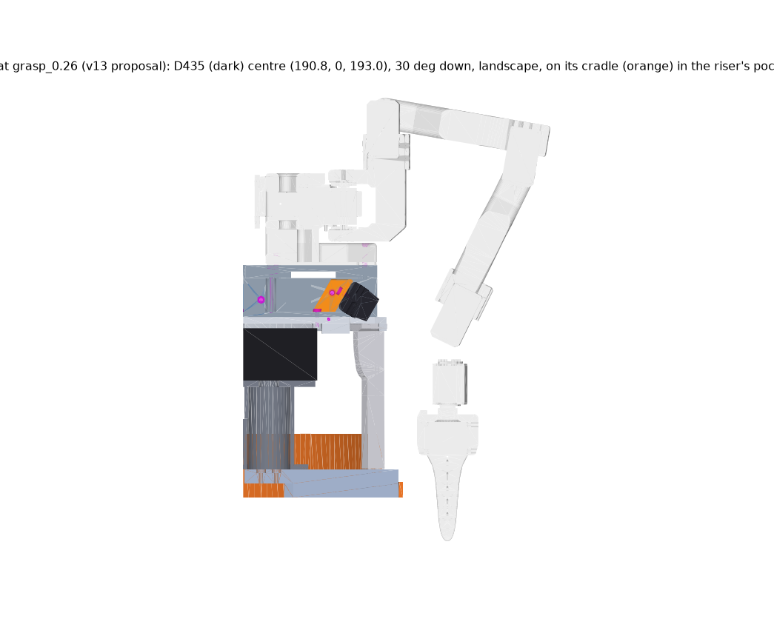
cad/v13/validation/d435/side_grasp_0.26.png
