fernandomierhicks/omni-robot/cad/v13/validation/d435/side_stow.png

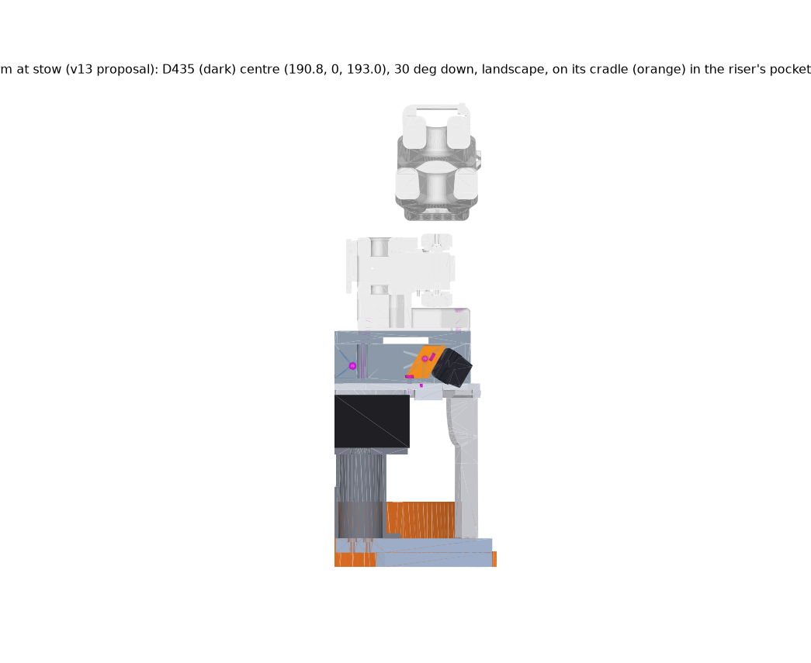
cad/v13/validation/d435/side_stow.png
