fernandomierhicks/omni-robot/cad/v13/validation/d435/top_notch.png

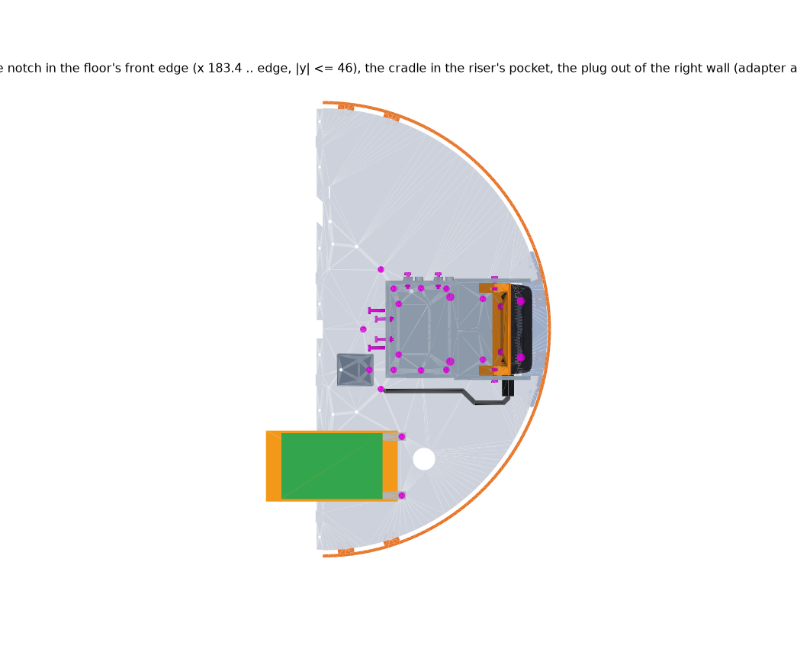
cad/v13/validation/d435/top_notch.png
