fernandomierhicks/omni-robot/cad/v13/validation/imx662/iso_front.png

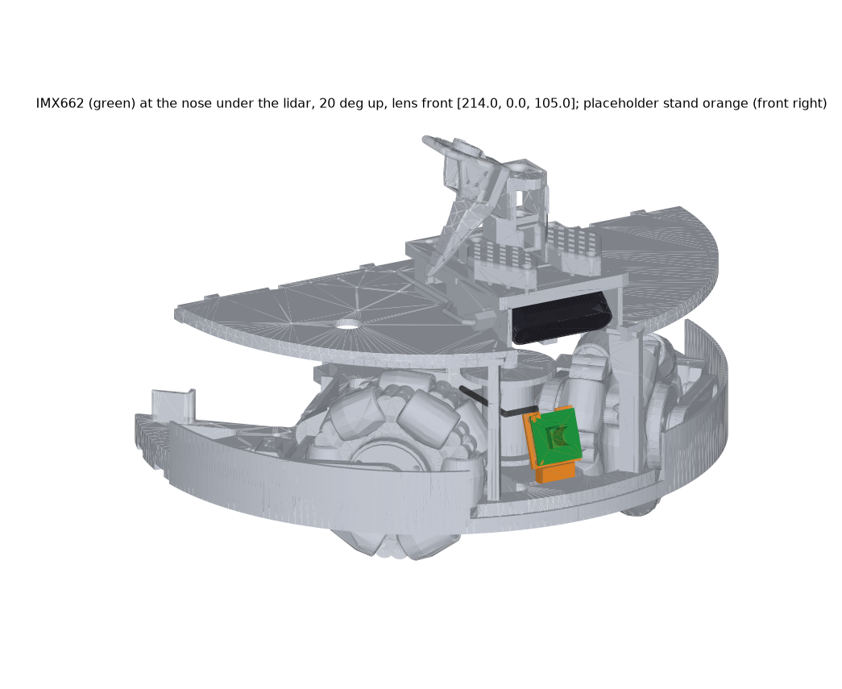
cad/v13/validation/imx662/iso_front.png
