fernandomierhicks/omni-robot/cad/v13/validation/robot/solidworks_robot_iso.png

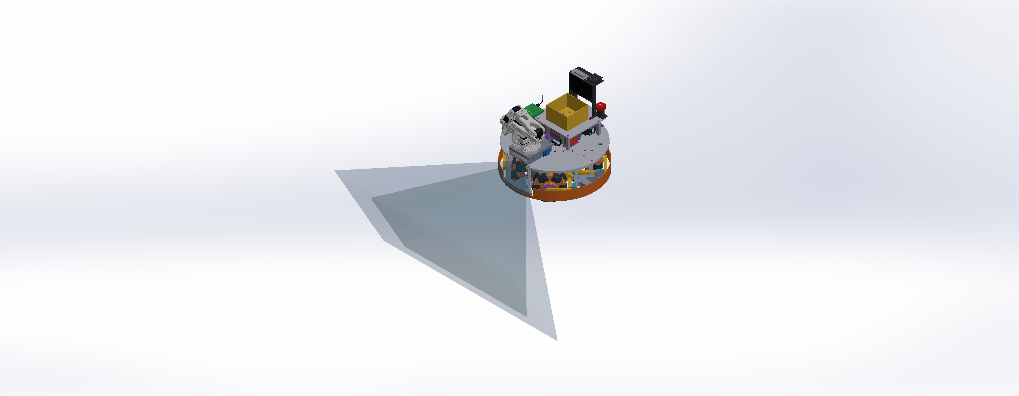
cad/v13/validation/robot/solidworks_robot_iso.png
