fernandomierhicks/omni-robot/cad/v13/validation/robot/solidworks_robot_right_close.png

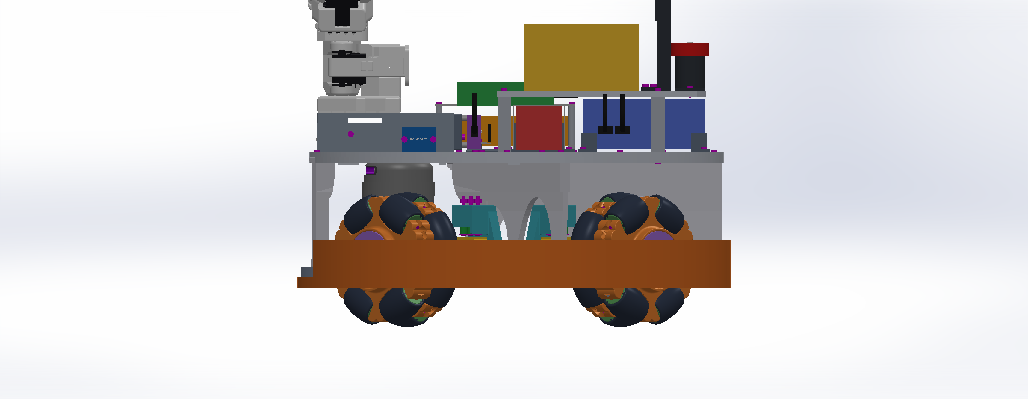
cad/v13/validation/robot/solidworks_robot_right_close.png
