fernandomierhicks/omni-robot/cad/v13/validation/robot/solidworks_robot_top_close.png

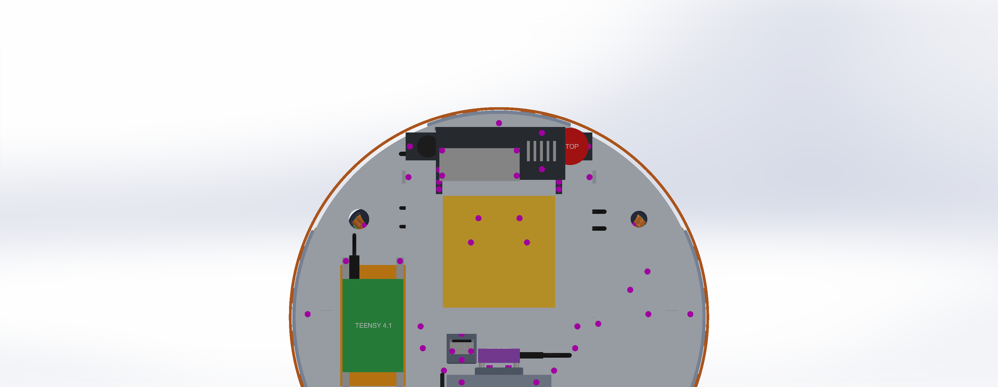
cad/v13/validation/robot/solidworks_robot_top_close.png
