fernandomierhicks/omni-robot/cad/v13/validation/upper/iso_block.png

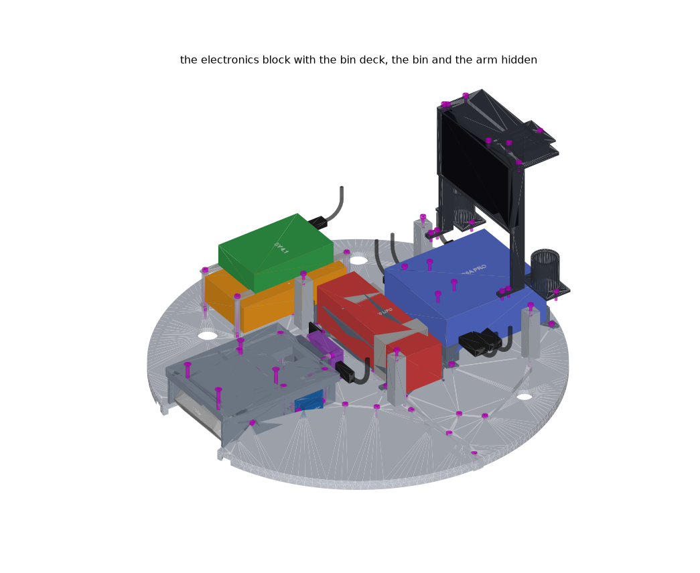
cad/v13/validation/upper/iso_block.png
