fernandomierhicks/omni-robot/cad/v13/validation/upper/iso_upper_front.png

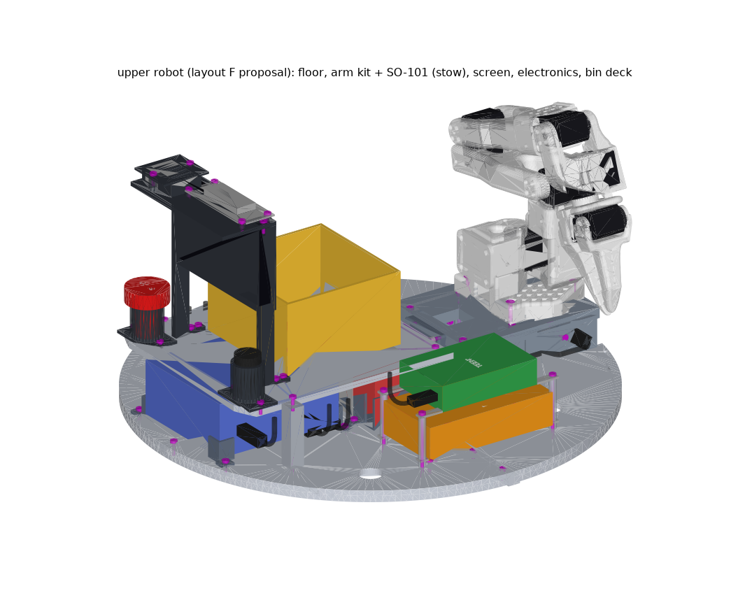
cad/v13/validation/upper/iso_upper_front.png
