fernandomierhicks/omni-robot/cad/v13/validation/upper/iso_upper_rear.png

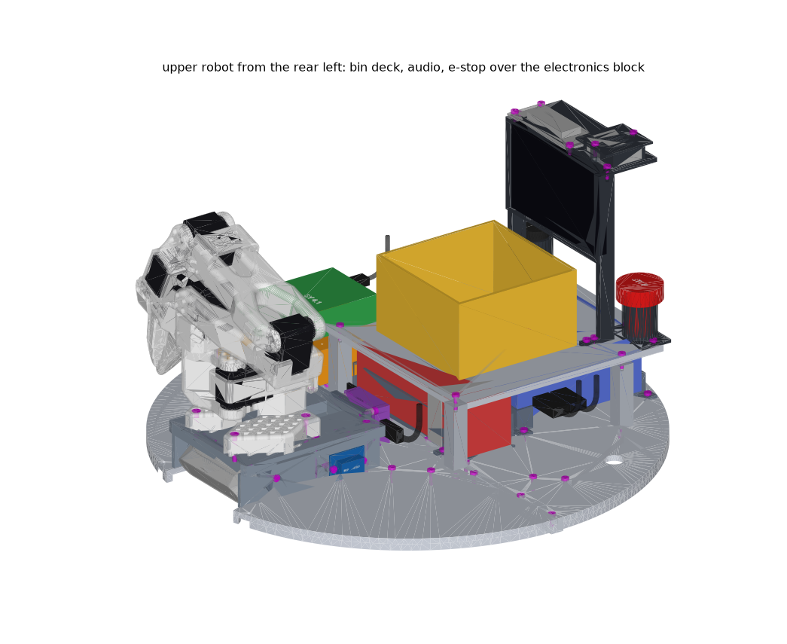
cad/v13/validation/upper/iso_upper_rear.png
