fernandomierhicks/omni-robot/characterization/ball_view/test_data/nov1_far_ball/2723.jpg

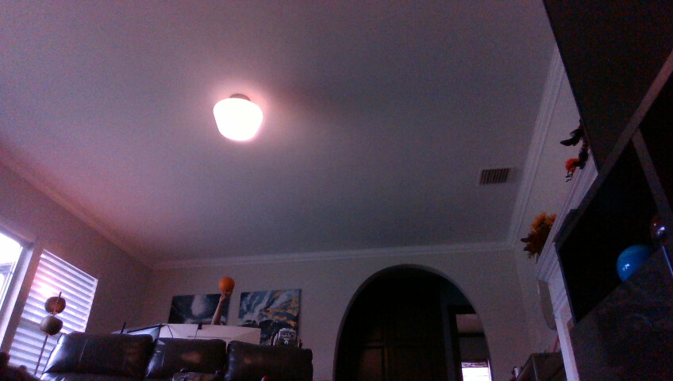
characterization/ball_view/test_data/nov1_far_ball/2723.jpg
