fernandomierhicks/omni-robot/characterization/throw_track/results/audit_20261031/20261030_145545_realtest_t001.png

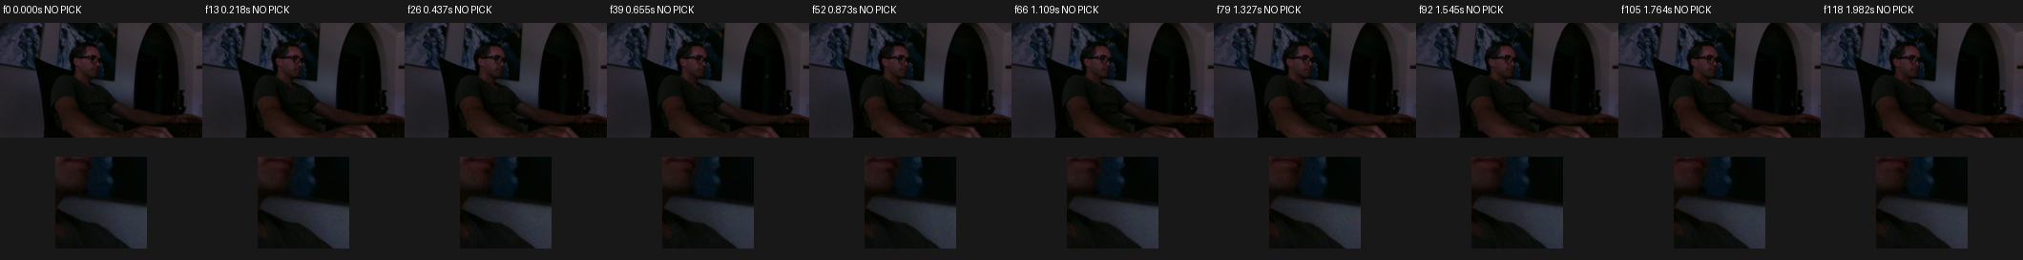
characterization/throw_track/results/audit_20261031/20261030_145545_realtest_t001.png
