fernandomierhicks/omni-robot/characterization/throw_track/results/audit_20261031/20261030_160708_bucket4_t001.png

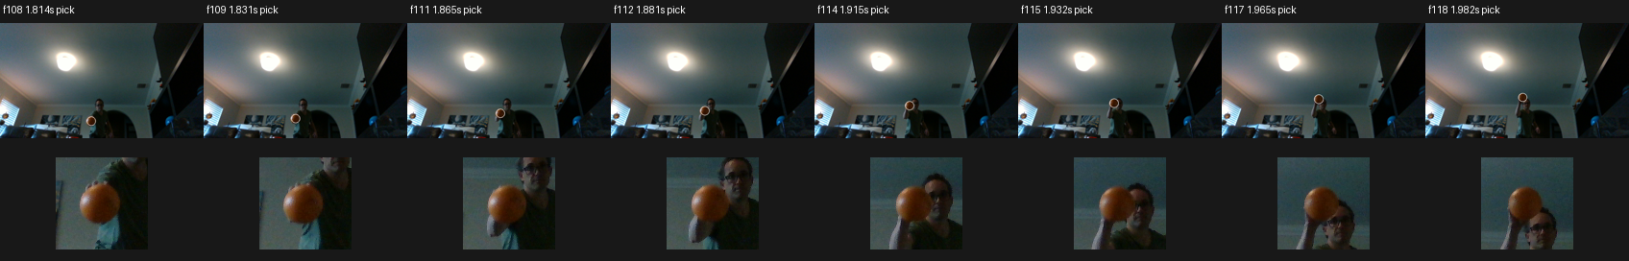
characterization/throw_track/results/audit_20261031/20261030_160708_bucket4_t001.png
