fernandomierhicks/omni-robot/characterization/throw_track/results/audit_20261031/20261030_235737_bucket8_t001.png

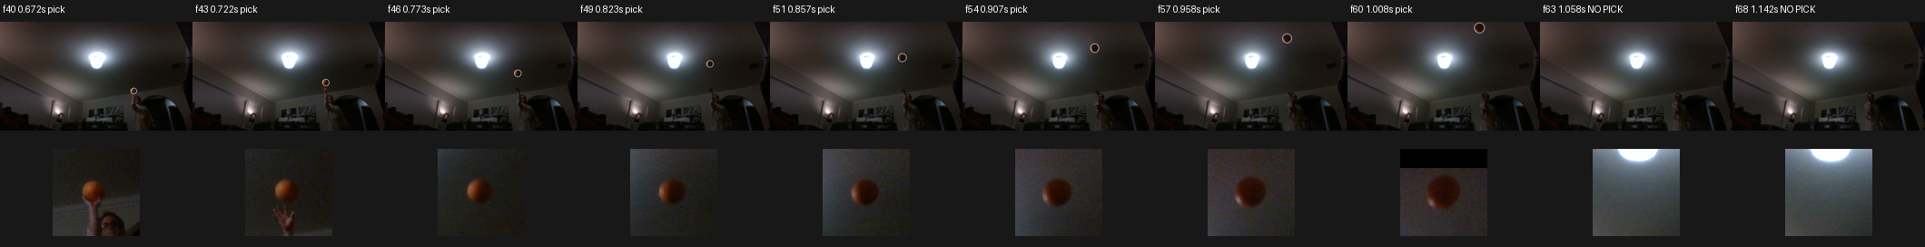
characterization/throw_track/results/audit_20261031/20261030_235737_bucket8_t001.png
