fernandomierhicks/omni-robot/characterization/throw_track/results/audit_20261031/20261030_235934_bucket9_t003.png

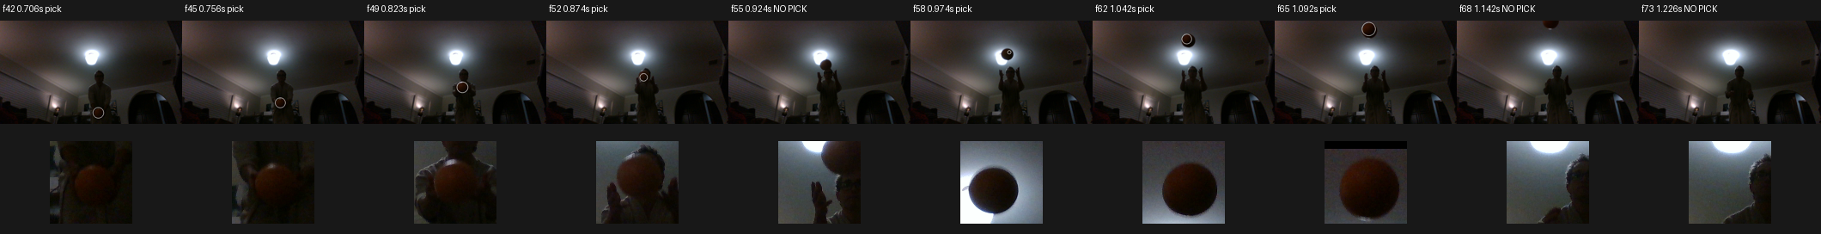
characterization/throw_track/results/audit_20261031/20261030_235934_bucket9_t003.png
