fernandomierhicks/omni-robot/characterization/throw_track/results/audit_20261031/20261031_114236_loc1_t002.png

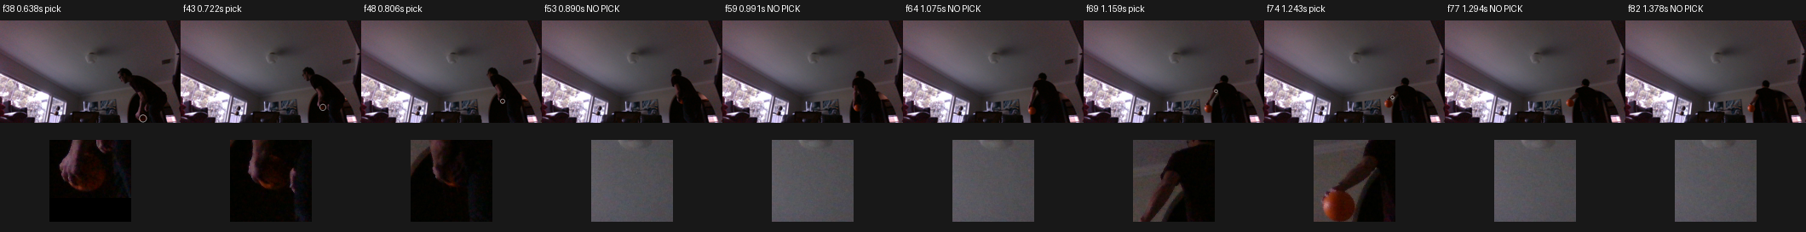
characterization/throw_track/results/audit_20261031/20261031_114236_loc1_t002.png
