fernandomierhicks/omni-robot/characterization/throw_track/results/audit_20261031/20261031_121159_loc2_t003.png

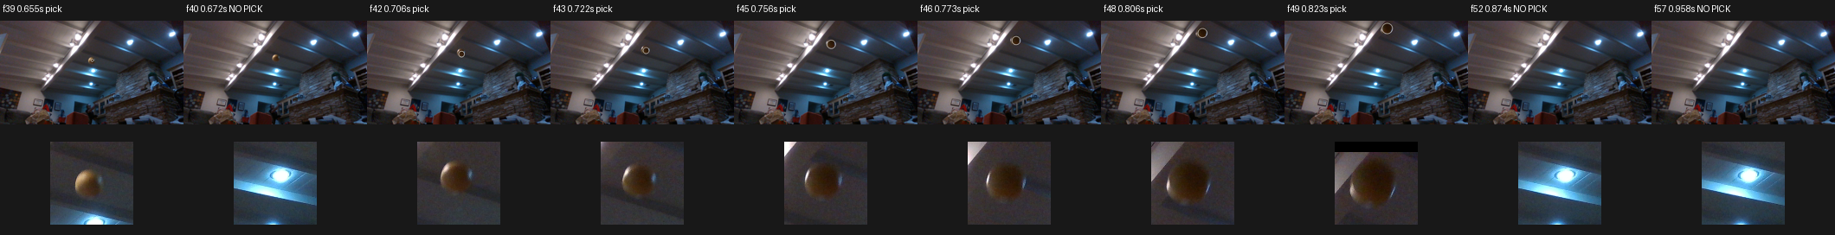
characterization/throw_track/results/audit_20261031/20261031_121159_loc2_t003.png
