fernandomierhicks/omni-robot/characterization/throw_track/results/audit_20261031/20261031_122443_loc3_t001_full.png

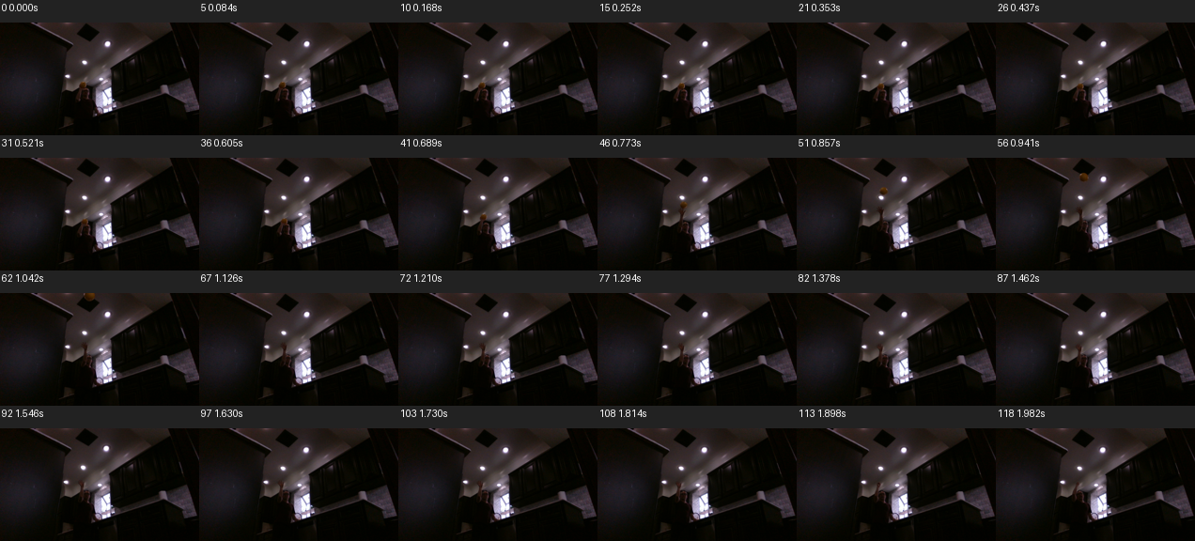
characterization/throw_track/results/audit_20261031/20261031_122443_loc3_t001_full.png
