fernandomierhicks/omni-robot/characterization/throw_track/results/autotune/autotune_20261030_231635.png

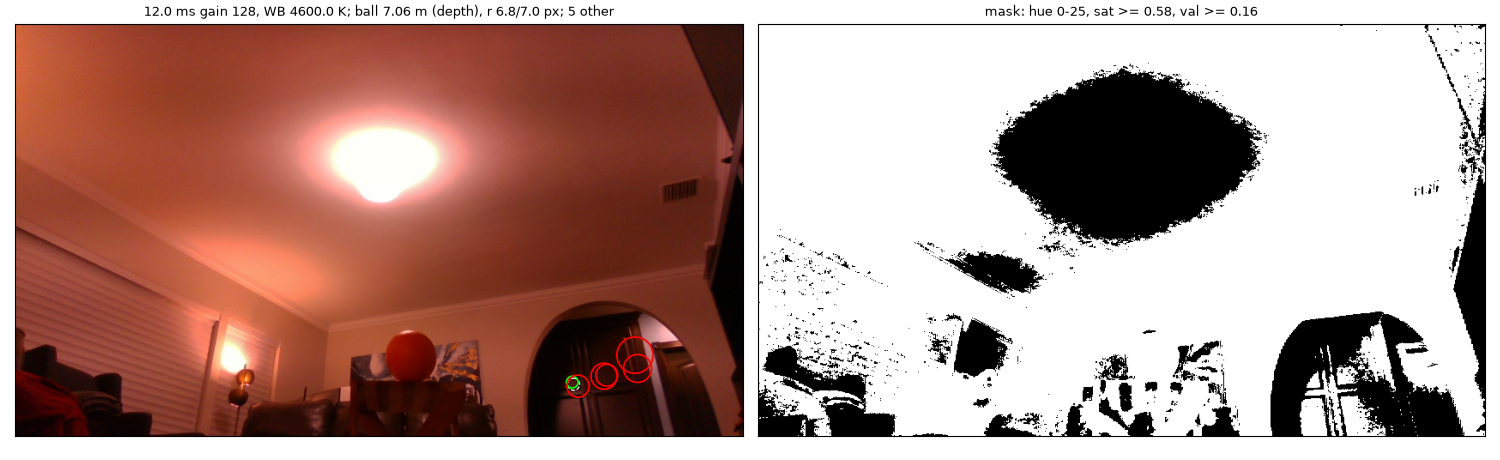
characterization/throw_track/results/autotune/autotune_20261030_231635.png
