fernandomierhicks/omni-robot/characterization/throw_track/results/autotune/autotune_20261030_231840.png

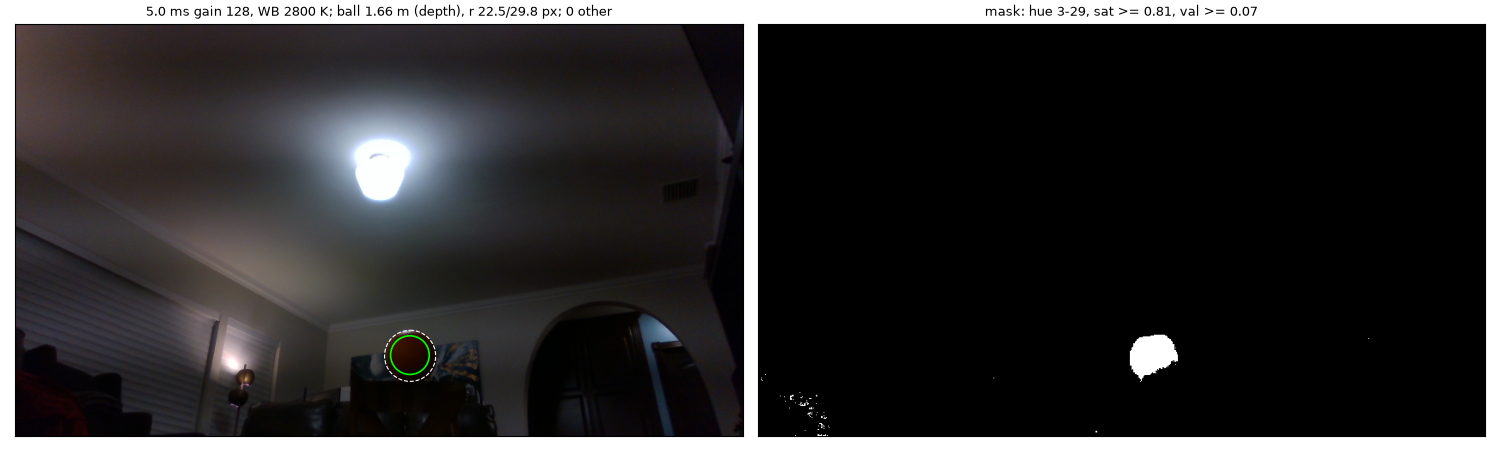
characterization/throw_track/results/autotune/autotune_20261030_231840.png
