fernandomierhicks/omni-robot/characterization/throw_track/results/autotune/bright.png

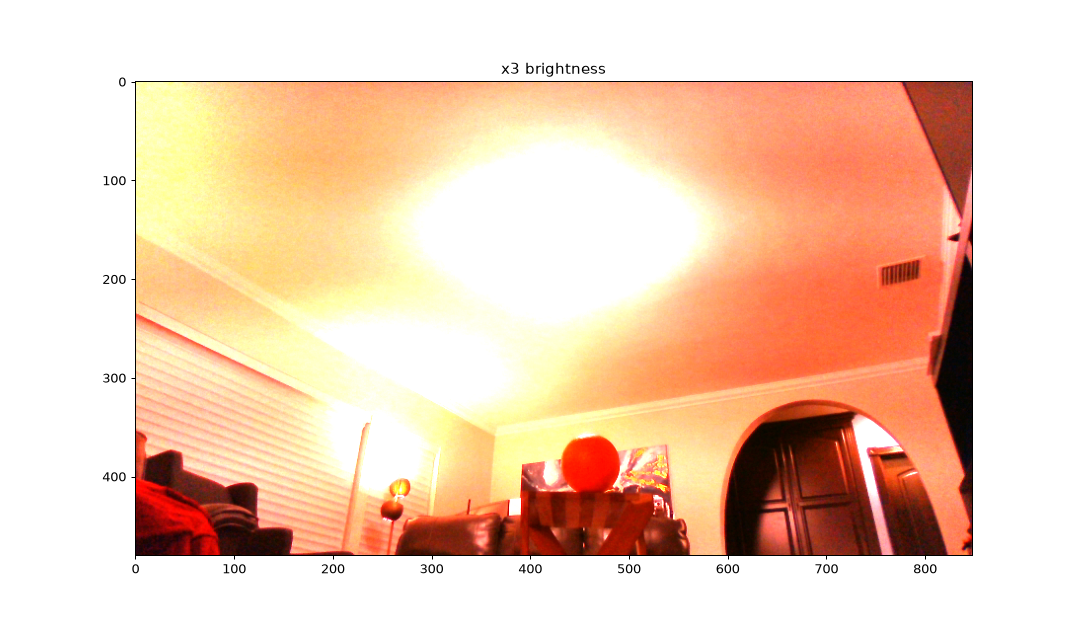
characterization/throw_track/results/autotune/bright.png
