fernandomierhicks/omni-robot/characterization/throw_track/results/bucket7_t1_crop.png

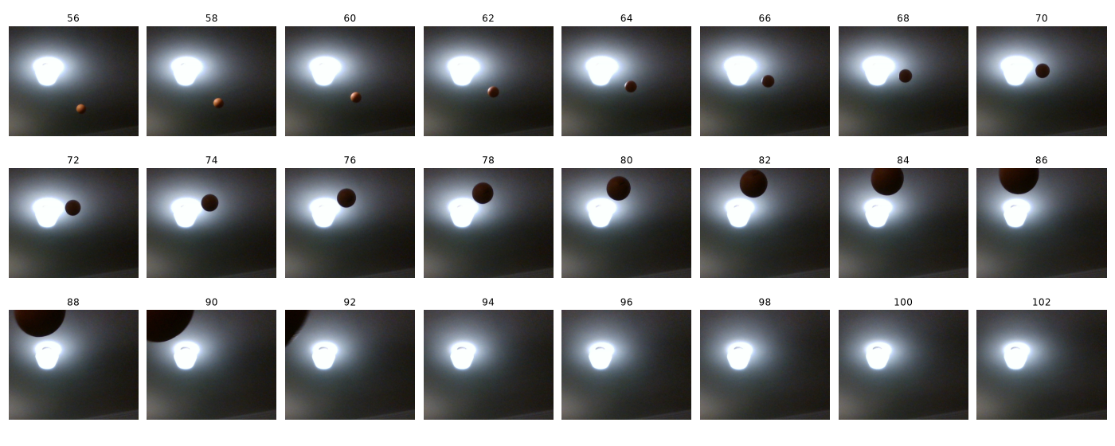
characterization/throw_track/results/bucket7_t1_crop.png
