fernandomierhicks/omni-robot/characterization/throw_track/results/bucket9_t3_sheet.png

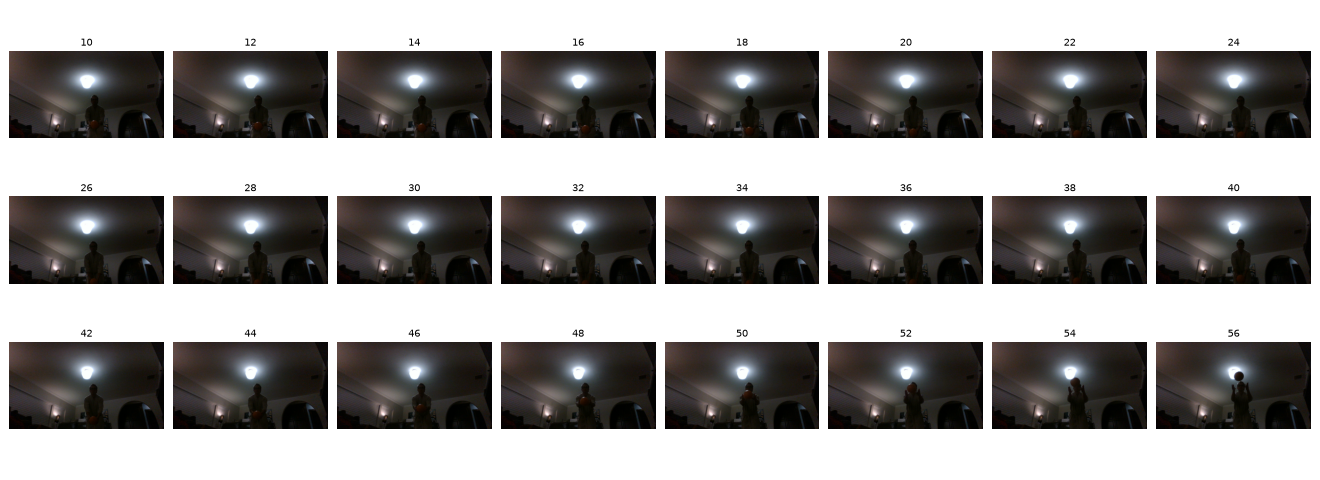
characterization/throw_track/results/bucket9_t3_sheet.png
