fernandomierhicks/omni-robot/characterization/throw_track/results/bucket9_t5_sheet.png

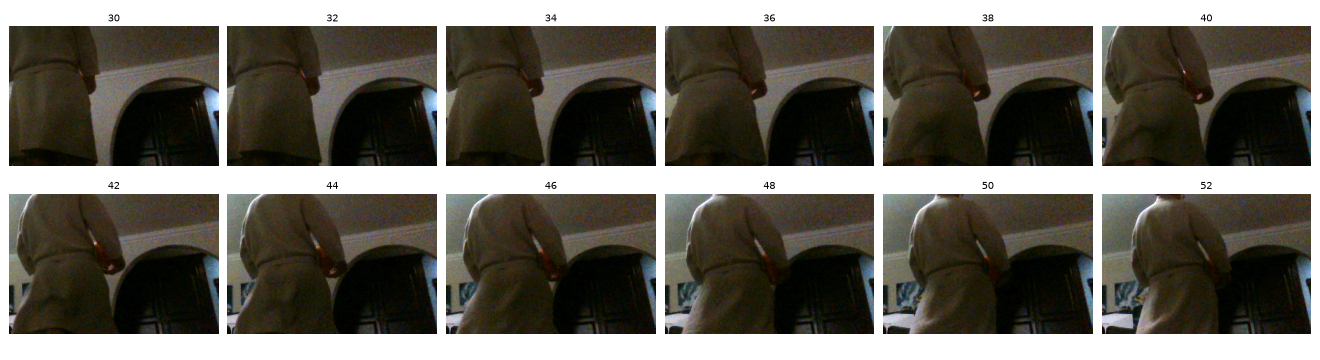
characterization/throw_track/results/bucket9_t5_sheet.png
