fernandomierhicks/omni-robot/characterization/throw_track/results/flight3d/bucket_page.png

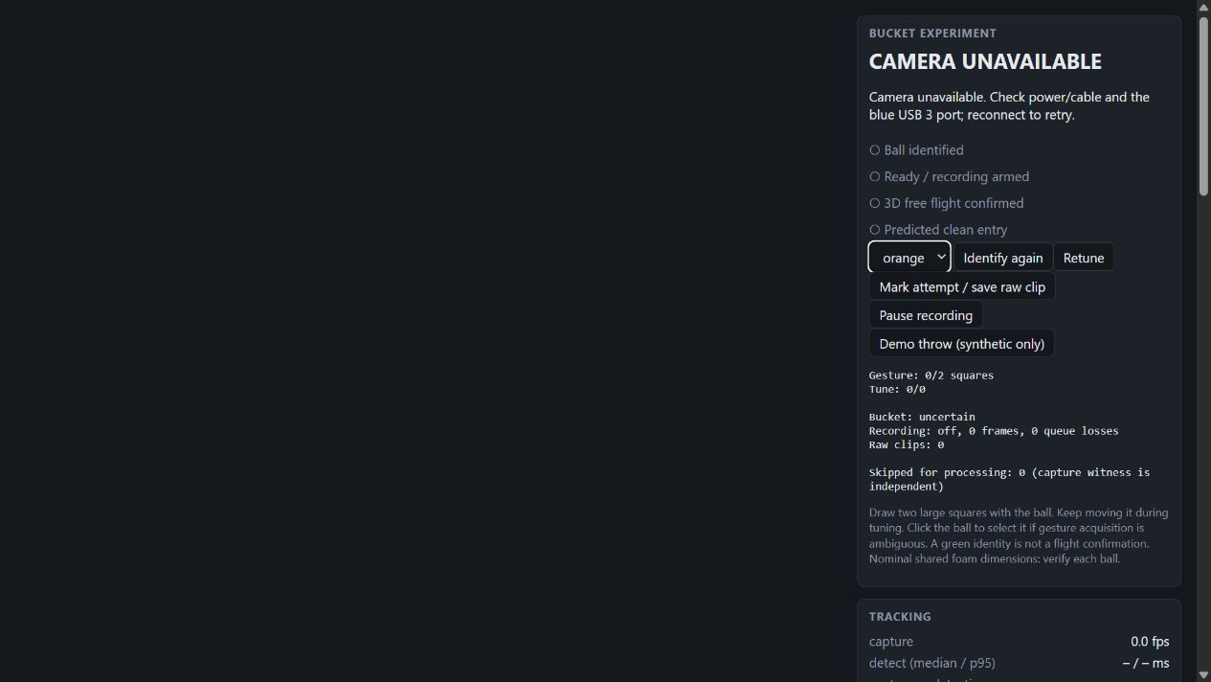
characterization/throw_track/results/flight3d/bucket_page.png
