fernandomierhicks/omni-robot/characterization/throw_track/results/flight3d/loc2_t004_inspect.png

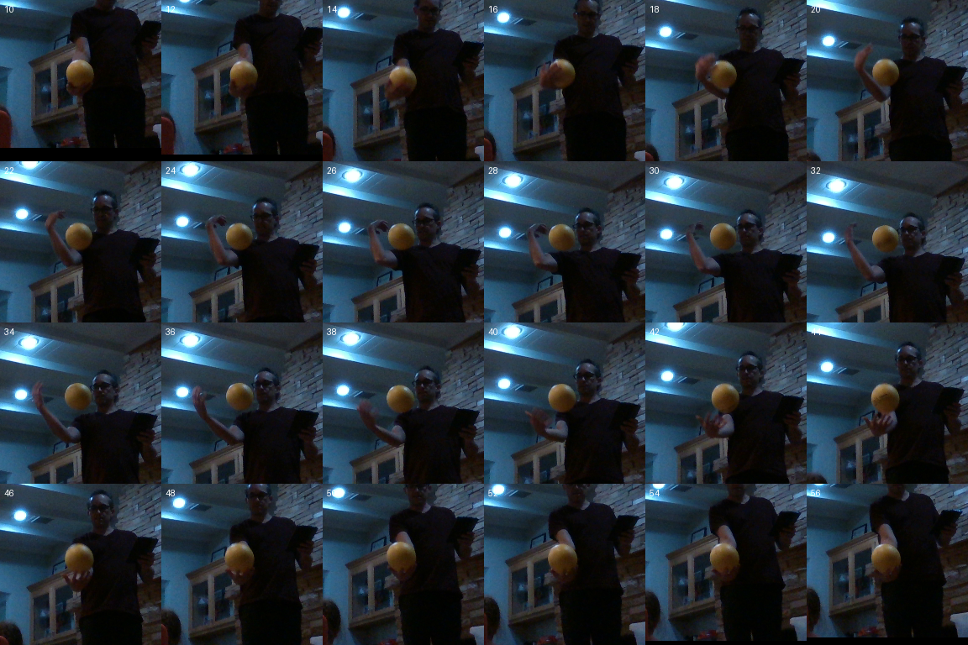
characterization/throw_track/results/flight3d/loc2_t004_inspect.png
