fernandomierhicks/omni-robot/characterization/throw_track/results/flight3d/loc3_t003_inspect.png

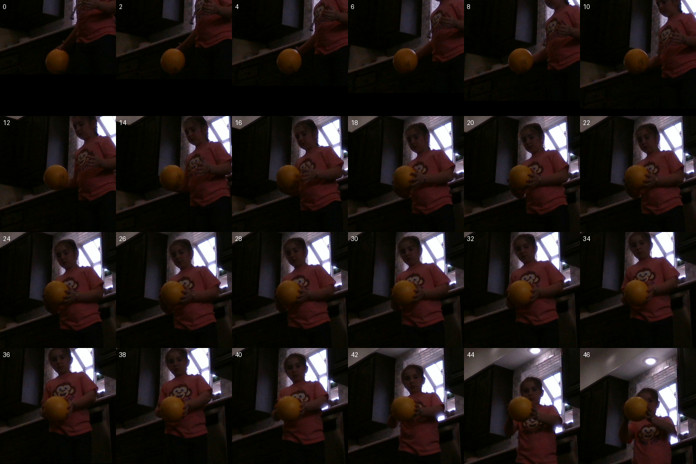
characterization/throw_track/results/flight3d/loc3_t003_inspect.png
