fernandomierhicks/omni-robot/characterization/throw_track/results/rs_20261030_160941_bucket5_t001.png

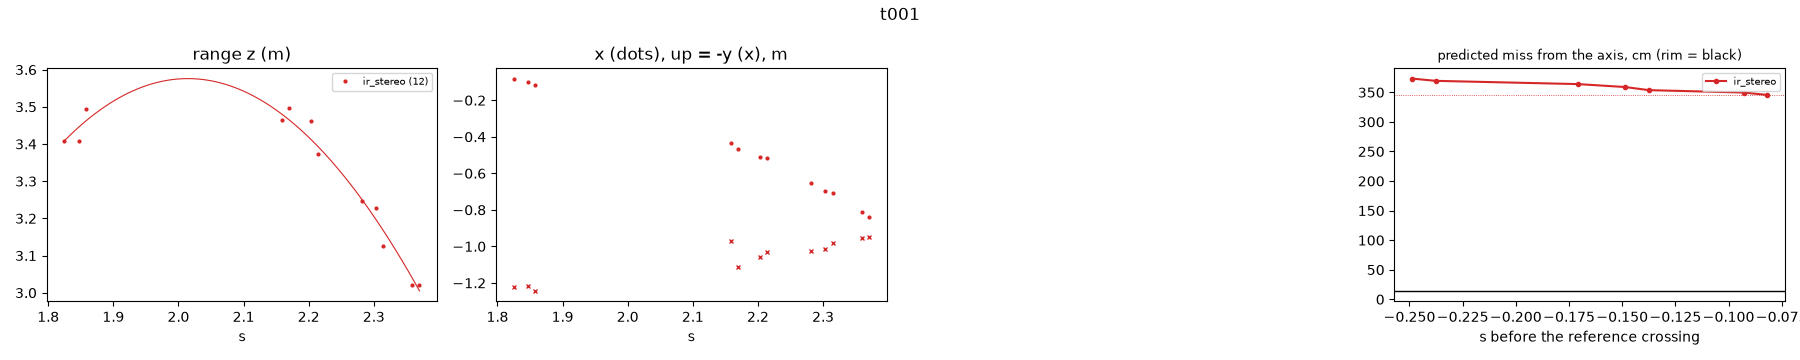
characterization/throw_track/results/rs_20261030_160941_bucket5_t001.png
