fernandomierhicks/omni-robot/characterization/throw_track/results/rs_20261030_235737_bucket8_t001.png

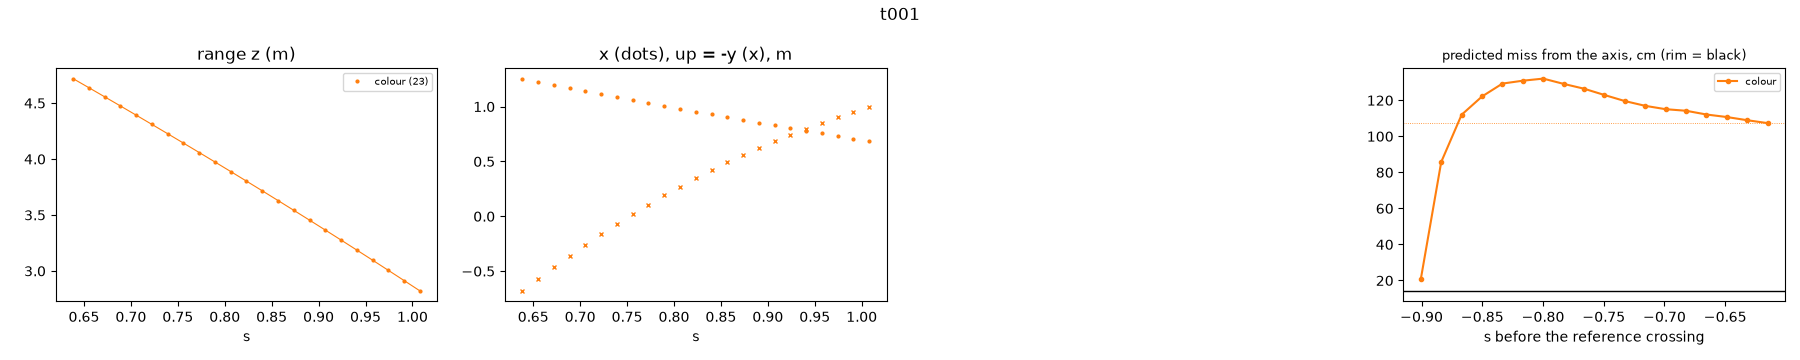
characterization/throw_track/results/rs_20261030_235737_bucket8_t001.png
