fernandomierhicks/omni-robot/characterization/throw_track/results/rs_20261030_235934_bucket9_t002.png

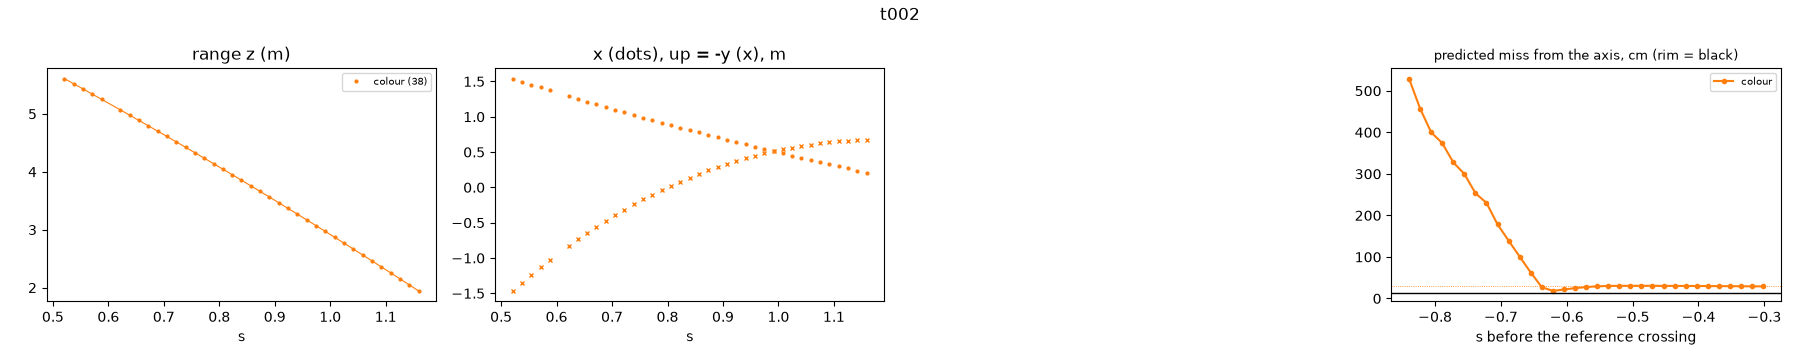
characterization/throw_track/results/rs_20261030_235934_bucket9_t002.png
