fernandomierhicks/omni-robot/characterization/throw_track/results/rs_view_20261030_160708_bucket4_t001.png

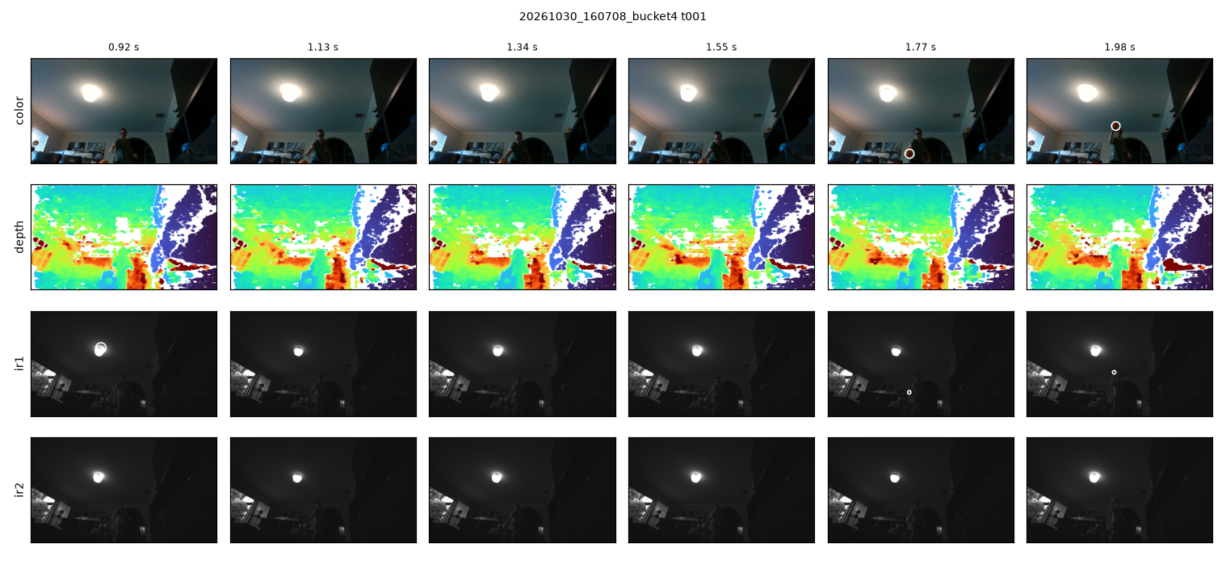
characterization/throw_track/results/rs_view_20261030_160708_bucket4_t001.png
