fernandomierhicks/omni-robot/characterization/throw_track/results/rs_view_20261030_161226_bucket6_t001.png

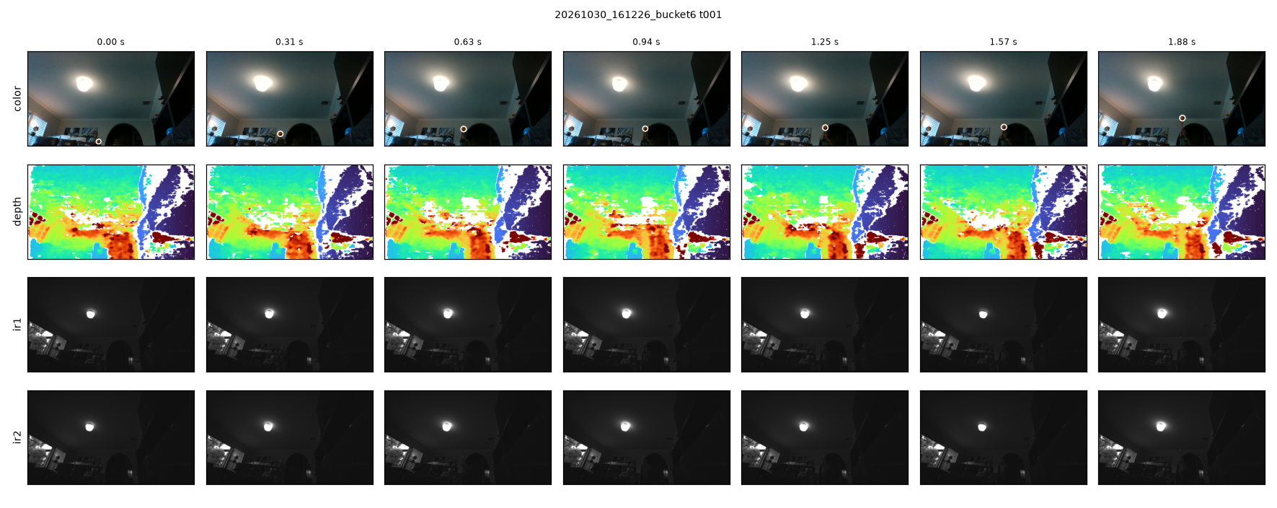
characterization/throw_track/results/rs_view_20261030_161226_bucket6_t001.png
