fernandomierhicks/omni-robot/characterization/throw_track/results/rs_view_20261030_235032_bucket7_t001.png

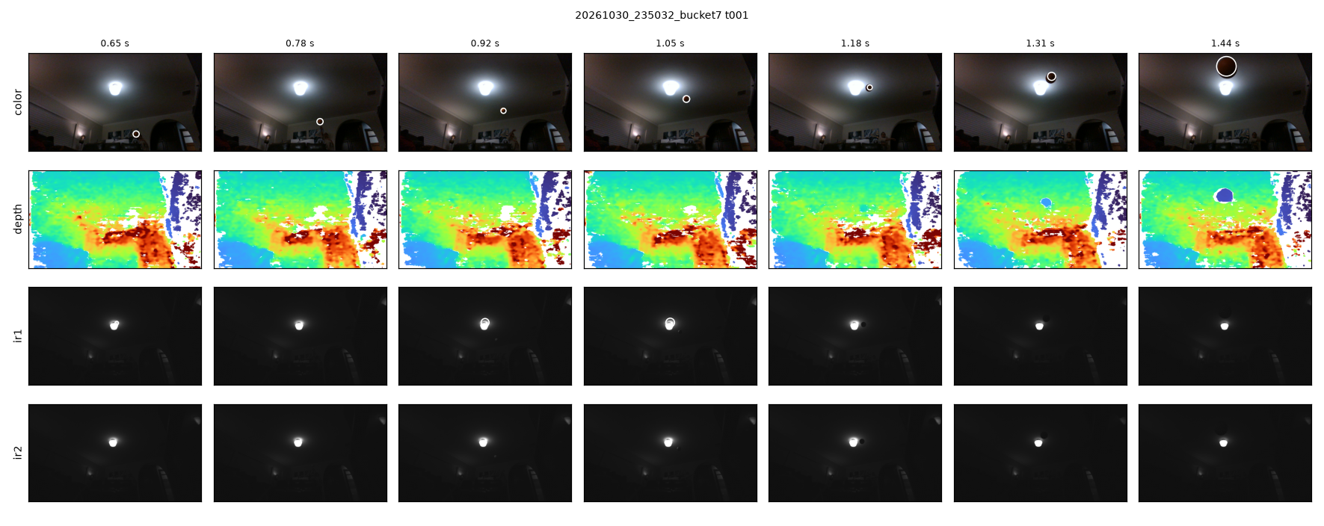
characterization/throw_track/results/rs_view_20261030_235032_bucket7_t001.png
