fernandomierhicks/omni-robot/characterization/throw_track/results/rs_view_20261030_235934_bucket9_t001.png

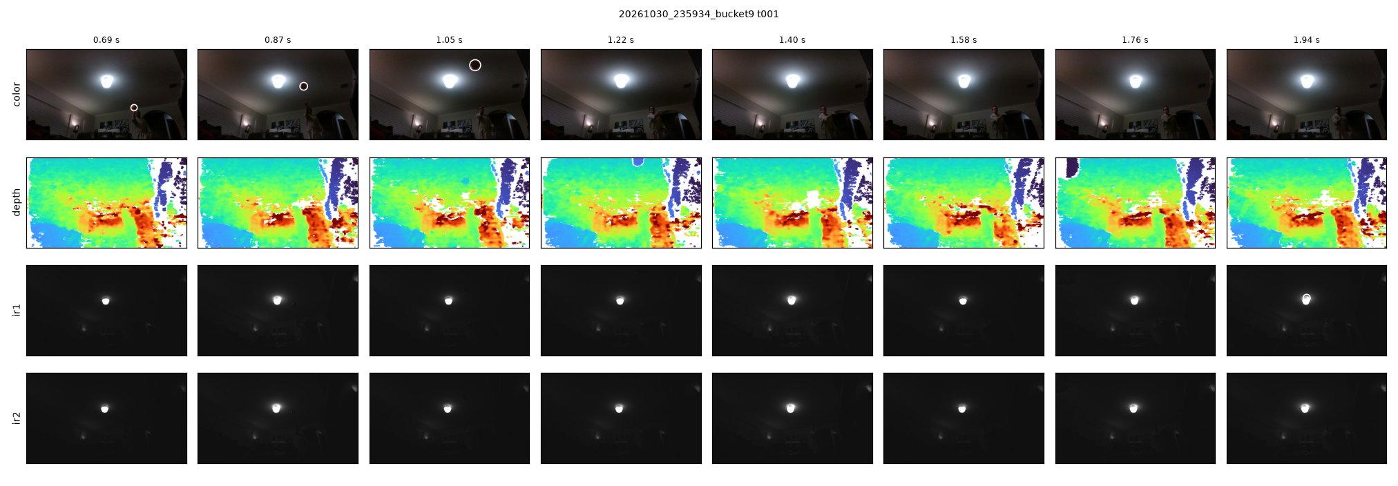
characterization/throw_track/results/rs_view_20261030_235934_bucket9_t001.png
