fernandomierhicks/omni-robot/characterization/throw_track/results/rs_view_20261031_114236_loc1_t003.png

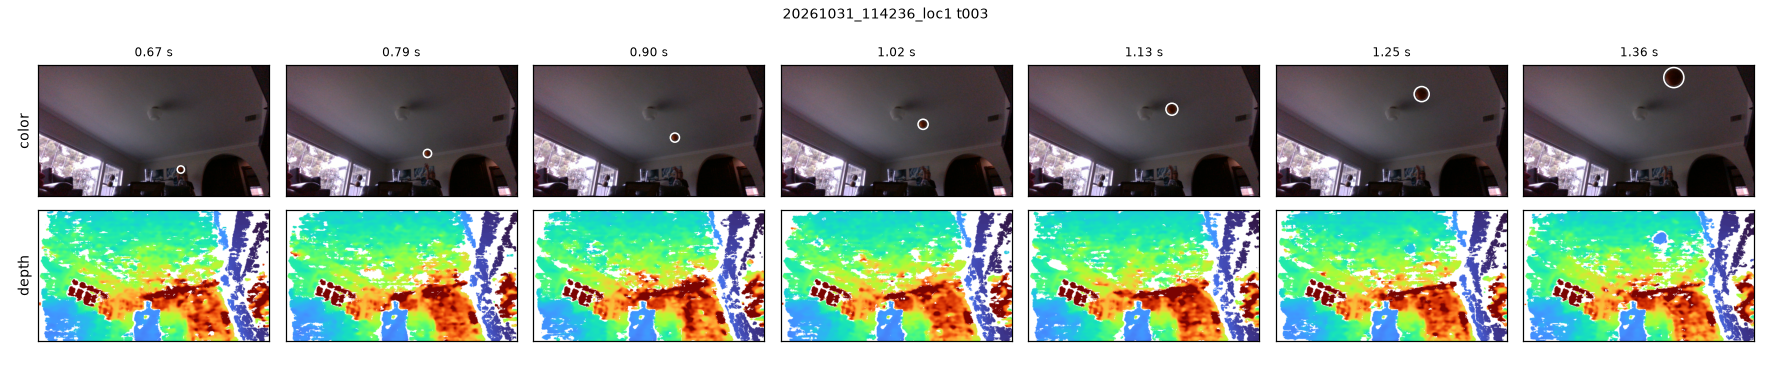
characterization/throw_track/results/rs_view_20261031_114236_loc1_t003.png
