fernandomierhicks/omni-robot/characterization/throw_track/results/rs_view_20261031_121159_loc2_t002.png

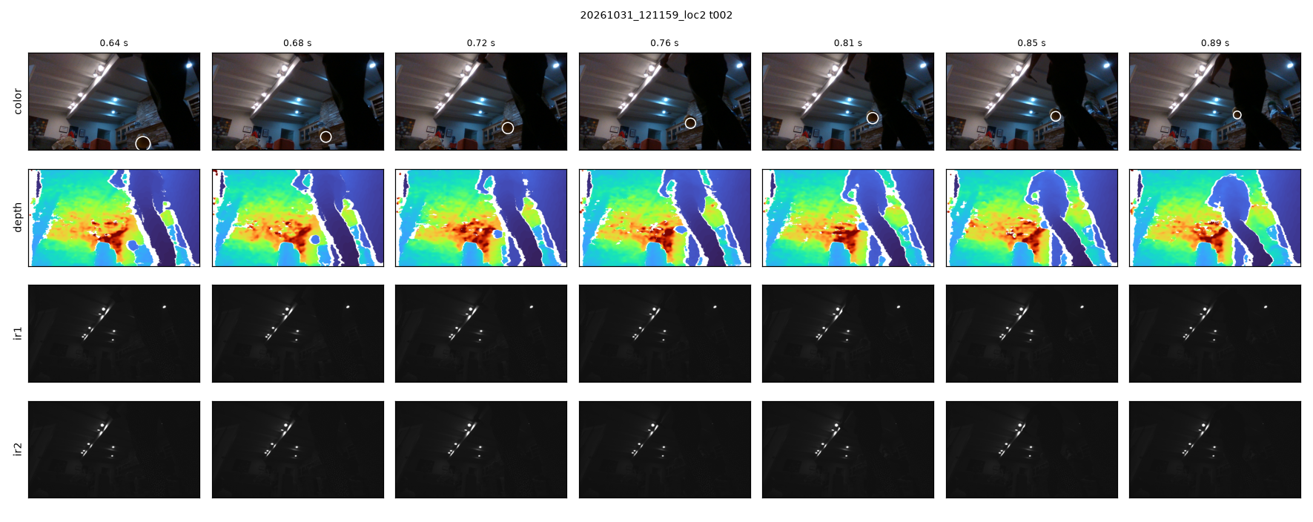
characterization/throw_track/results/rs_view_20261031_121159_loc2_t002.png
