fernandomierhicks/omni-robot/characterization/throw_track/results/rs_view_20261031_122443_loc3_t005.png

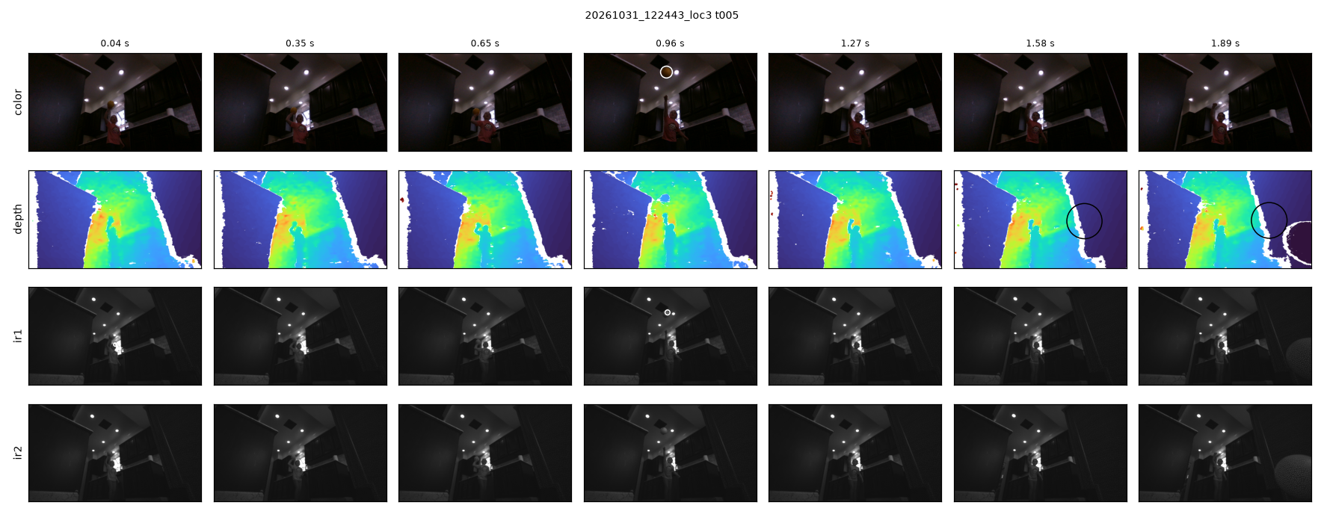
characterization/throw_track/results/rs_view_20261031_122443_loc3_t005.png
