fernandomierhicks/omni-robot/ros/src/omni_perception/test/data/sim_people_960.jpg

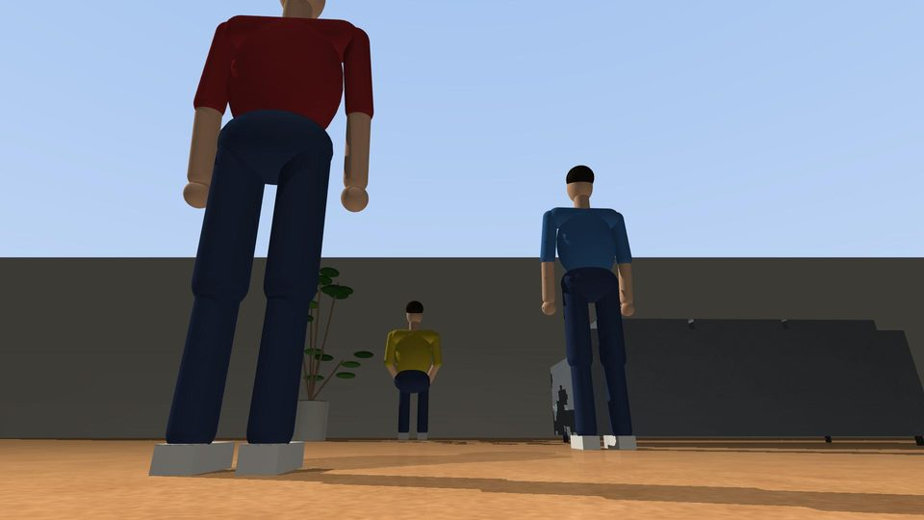
ros/src/omni_perception/test/data/sim_people_960.jpg
