fernandomierhicks/omni-robot/simulation/v3 compact/studies/results/catch_sweep.png

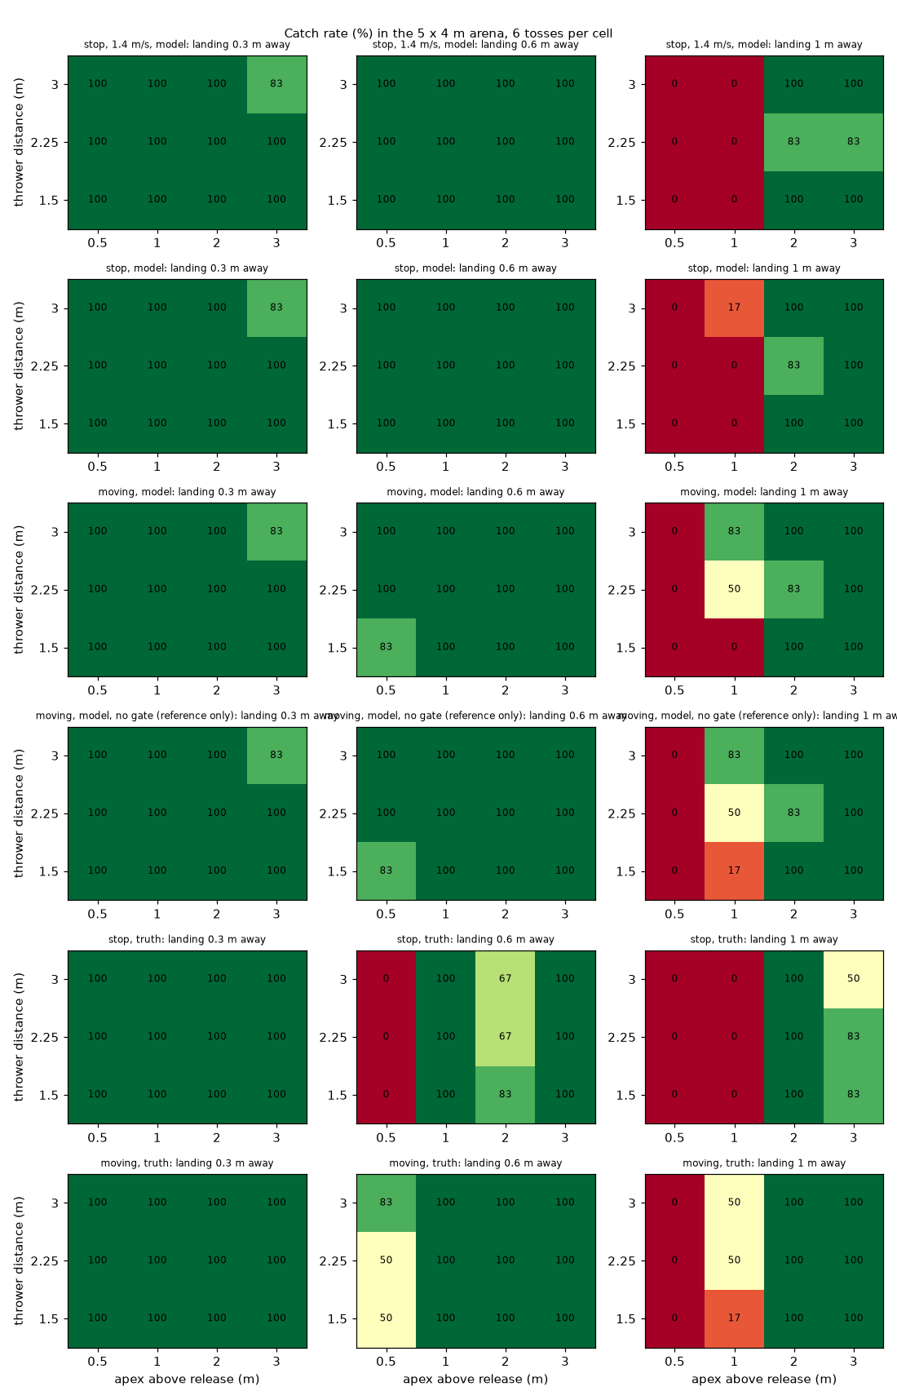
simulation/v3 compact/studies/results/catch_sweep.png
