fernandomierhicks/omni-robot/simulation/v3 compact/studies/results/funnel_tilt.png

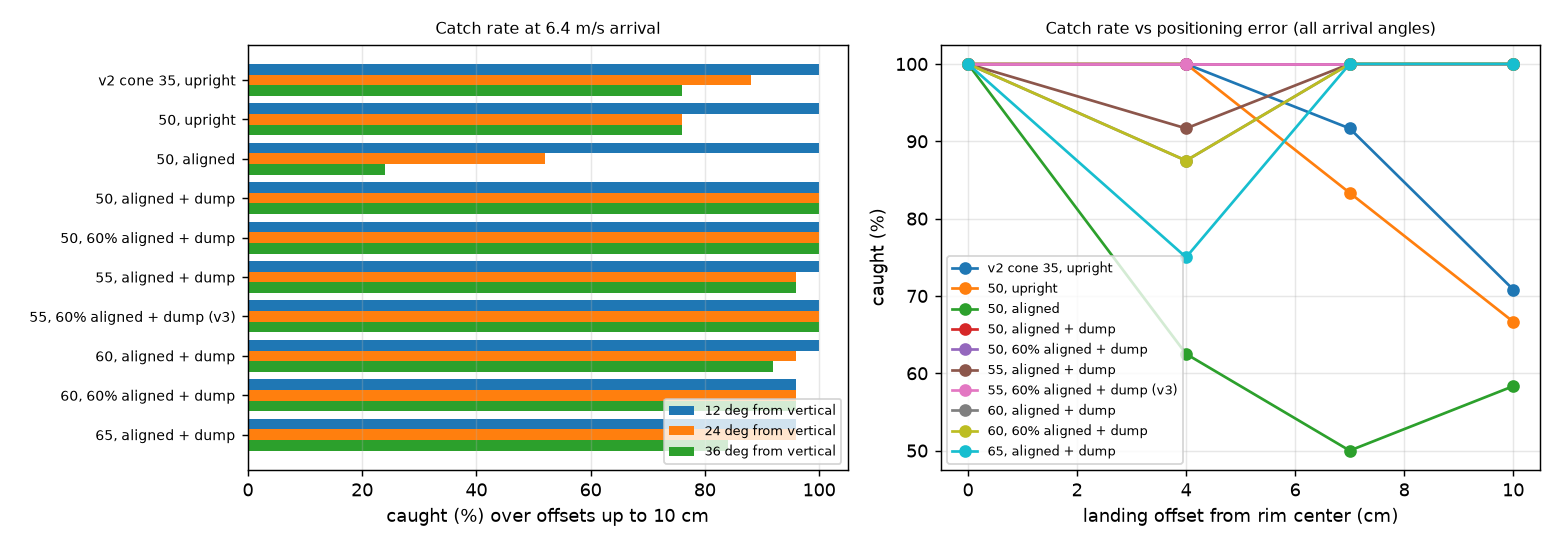
simulation/v3 compact/studies/results/funnel_tilt.png
