fernandomierhicks/omni-robot/simulation/v3 compact/studies/results/toss_sweep.png

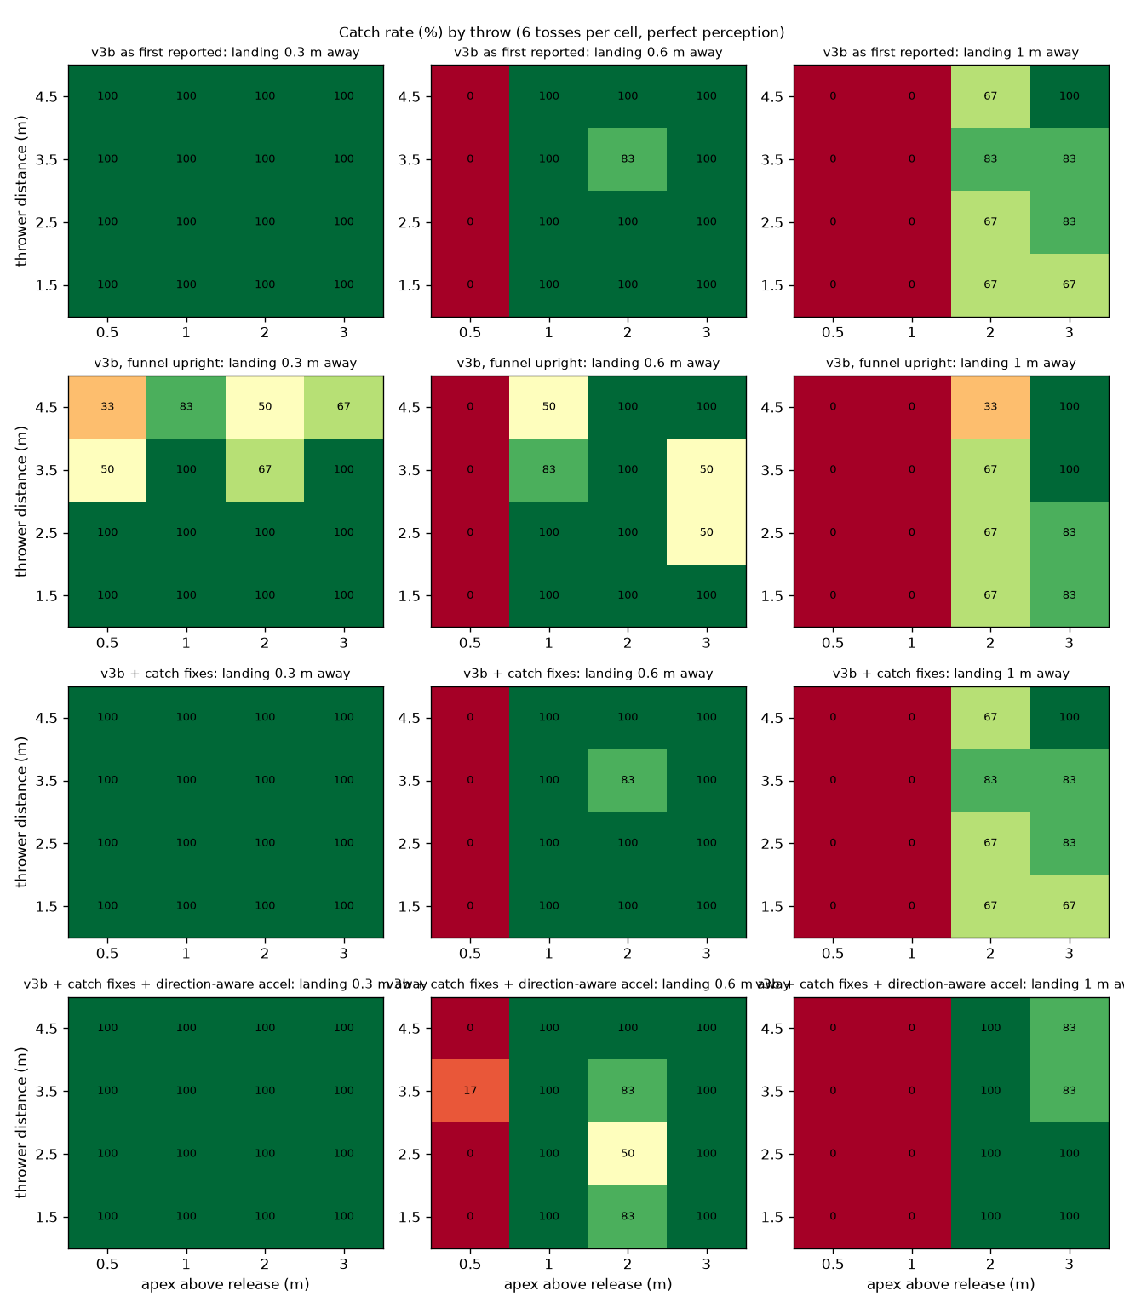
simulation/v3 compact/studies/results/toss_sweep.png
