fernandomierhicks/omni-robot/simulation/v3 compact/studies/results/v3a/funnel_tilt.png

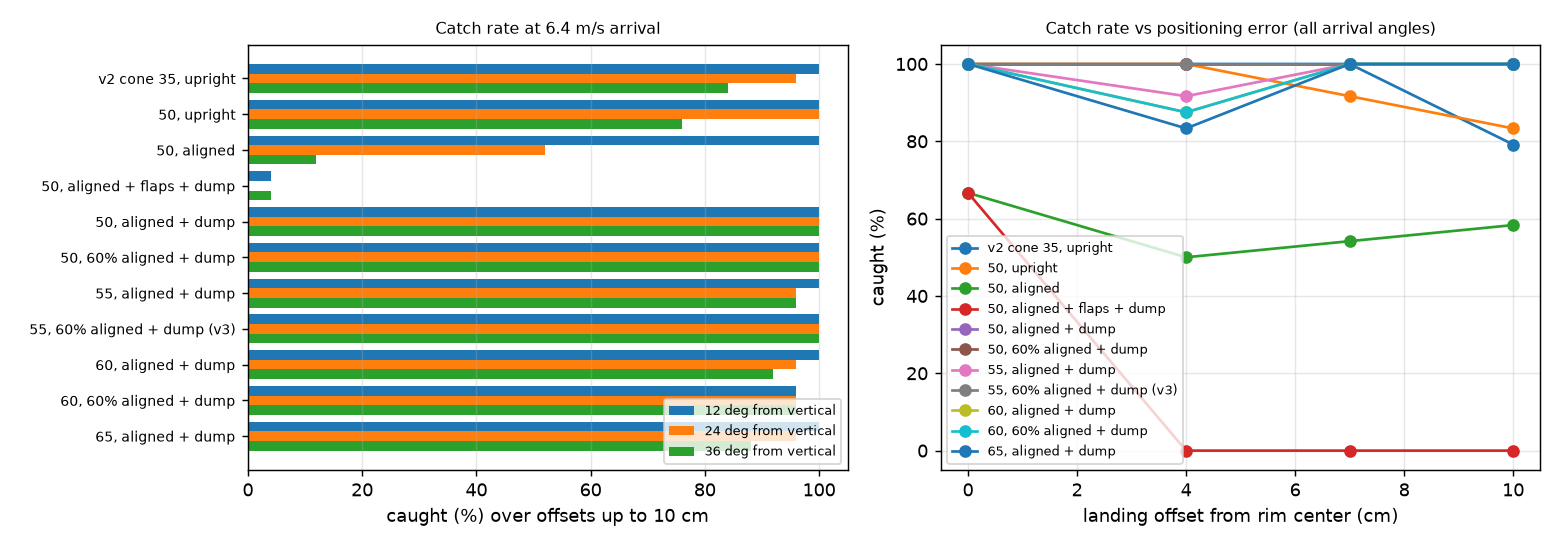
simulation/v3 compact/studies/results/v3a/funnel_tilt.png
