fernandomierhicks/omni-robot/simulation/v3 compact/studies/results/v3a/wheel_count.png

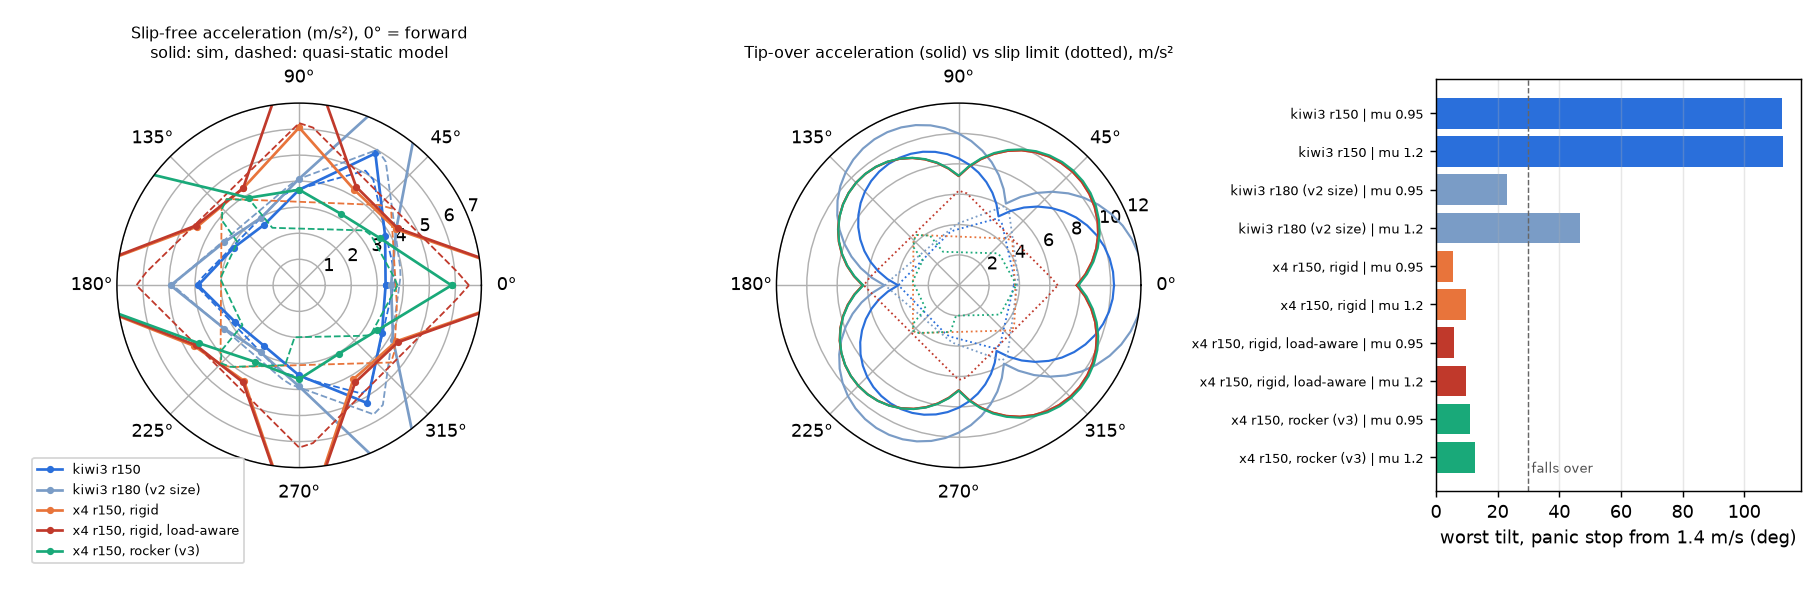
simulation/v3 compact/studies/results/v3a/wheel_count.png
