fernandomierhicks/omni-robot/simulation/v5 unlimited/studies/results/catch_sweep.png

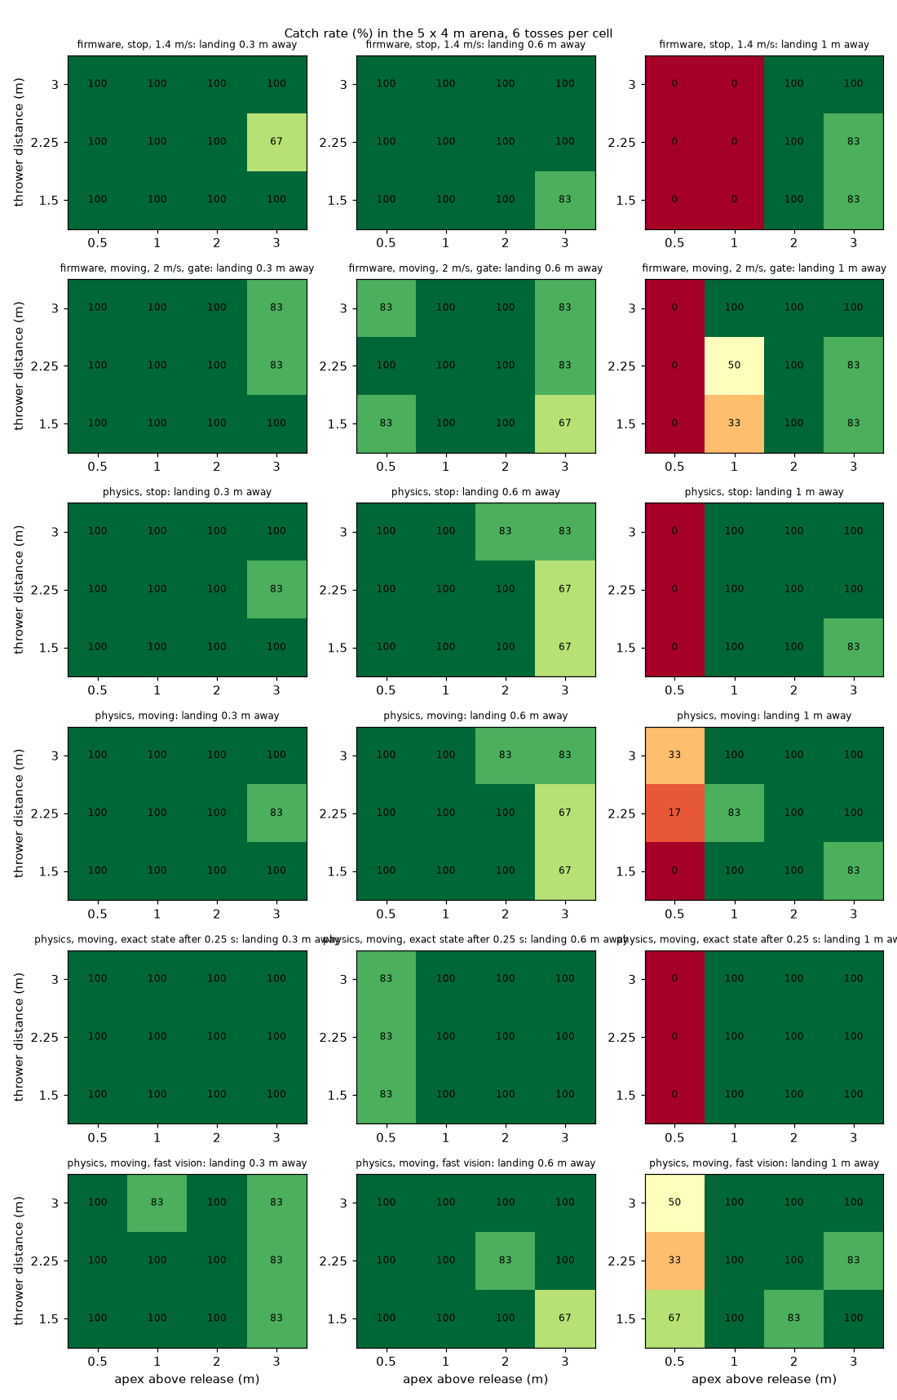
simulation/v5 unlimited/studies/results/catch_sweep.png
