fernandomierhicks/omni-robot/simulation/v5 unlimited/studies/results/envelope.png

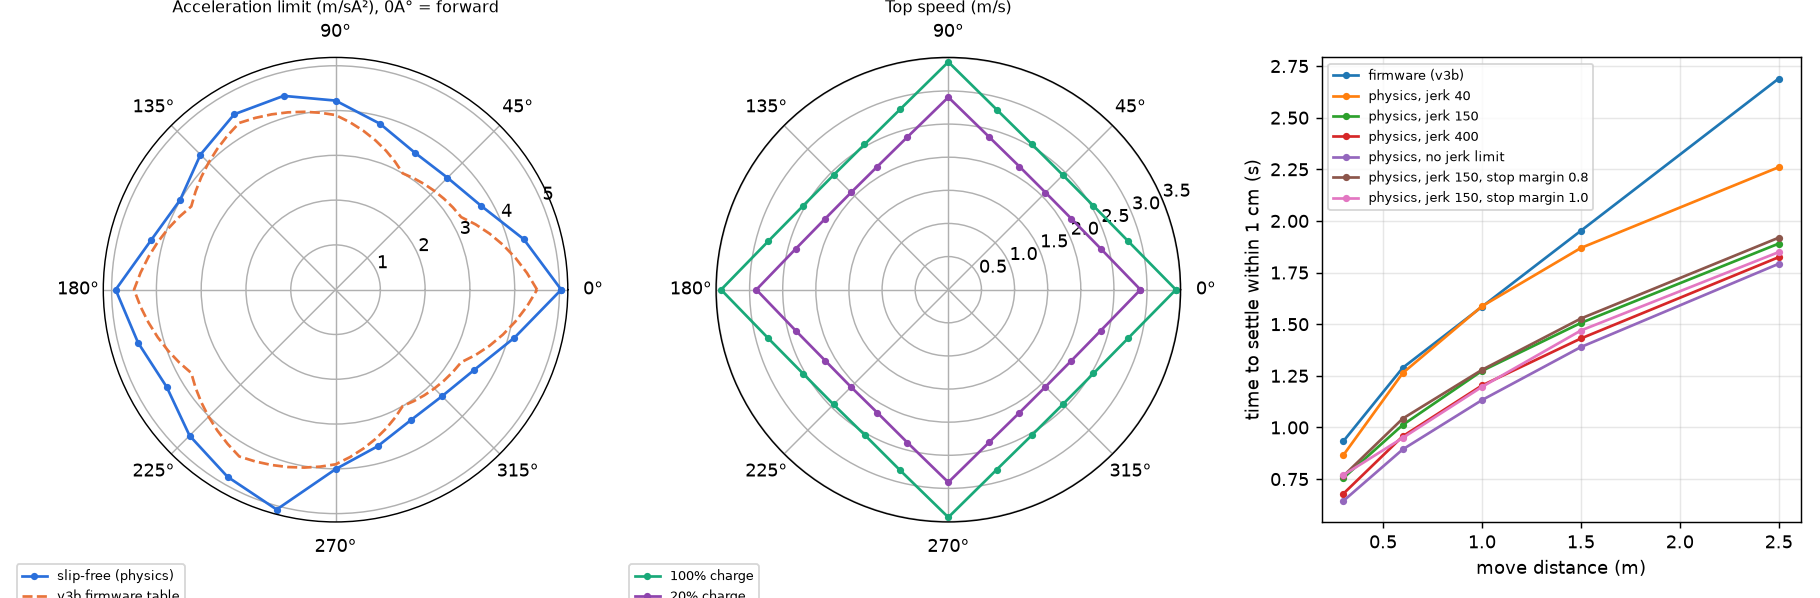
simulation/v5 unlimited/studies/results/envelope.png
