fernandomierhicks/omni-robot/simulation/v5 unlimited/studies/results/vision_sweep.png

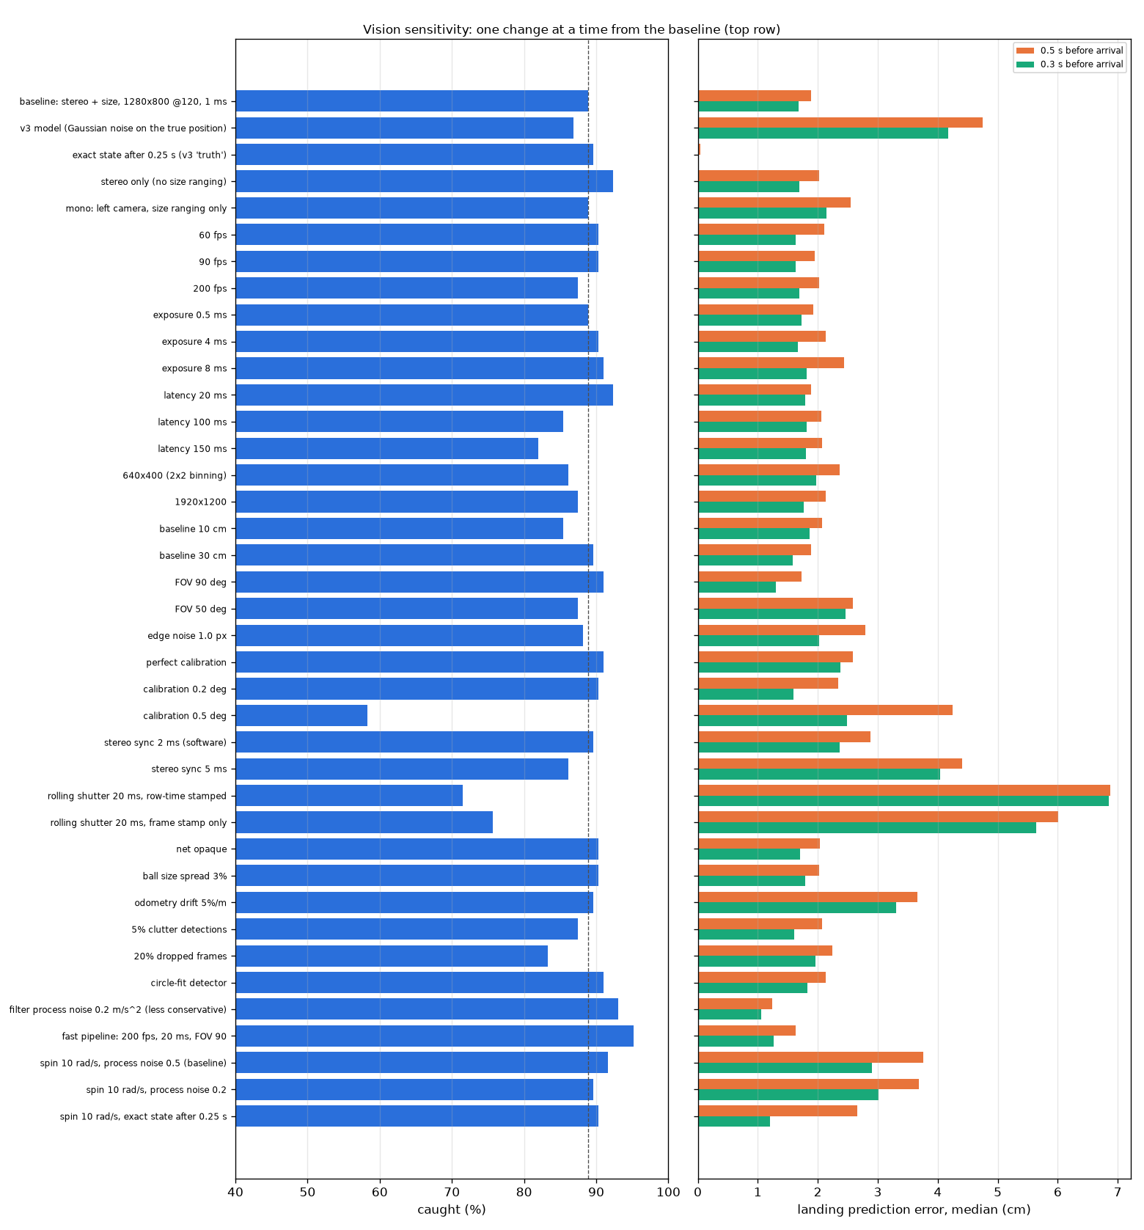
simulation/v5 unlimited/studies/results/vision_sweep.png
