fernandomierhicks/omni-robot/simulation/v11 sil/studies/results/d435_mount_pick/riser30_arm_in_view.png

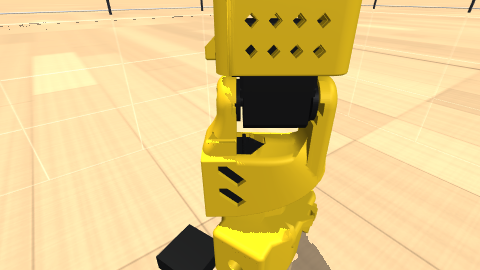
simulation/v11 sil/studies/results/d435_mount_pick/riser30_arm_in_view.png
