fernandomierhicks/omni-robot/simulation/v11 sil/studies/results/d435_tilt/side.png

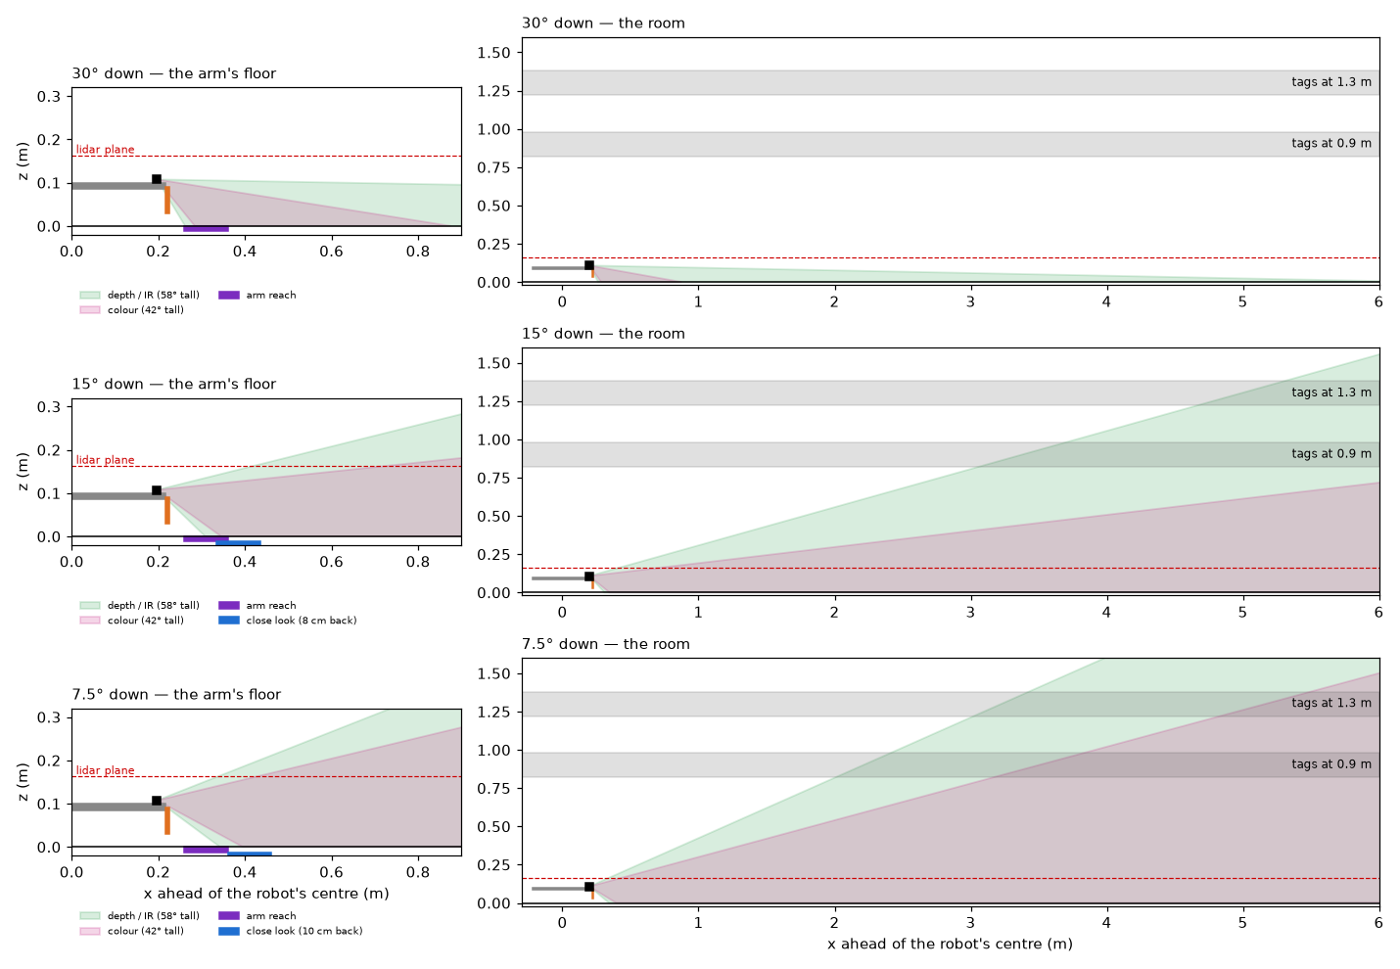
simulation/v11 sil/studies/results/d435_tilt/side.png
