fernandomierhicks/omni-robot/simulation/v11 sil/studies/results/d435_tilt/tilt07p5_3rd.png

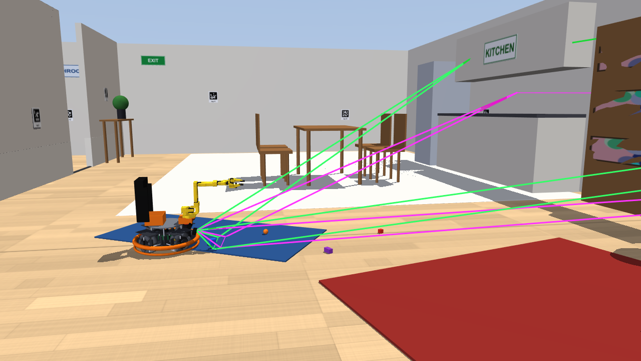
simulation/v11 sil/studies/results/d435_tilt/tilt07p5_3rd.png
