fernandomierhicks/omni-robot/simulation/v11 sil/studies/results/d435_tilt/tilt15p0_rgb.png

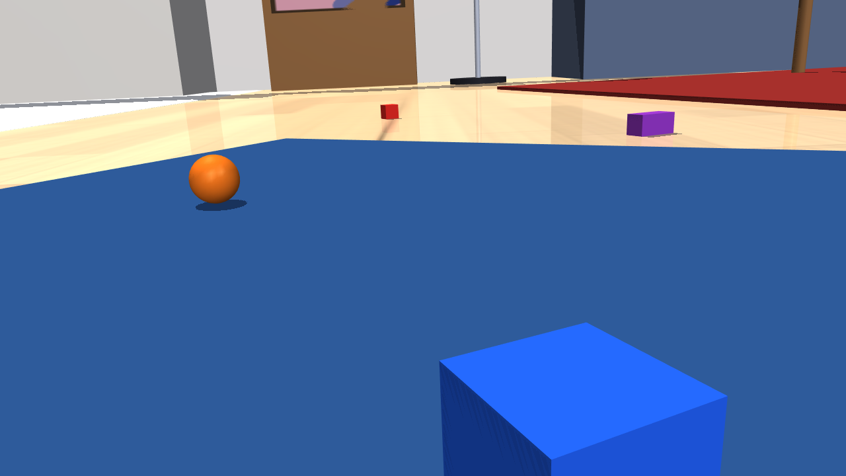
simulation/v11 sil/studies/results/d435_tilt/tilt15p0_rgb.png
