fernandomierhicks/omni-robot/simulation/v11 sil/studies/results/d435_tilt/views.png

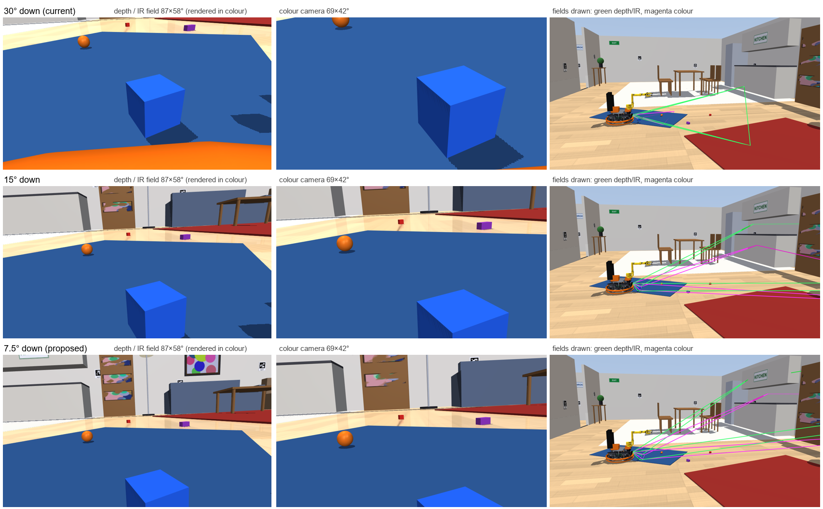
simulation/v11 sil/studies/results/d435_tilt/views.png
