fernandomierhicks/omni-robot/simulation/v11 sil/studies/results/height_map_2026-11-05/floor_unknowns.jpg

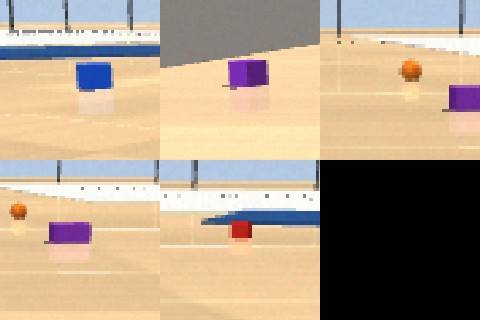
simulation/v11 sil/studies/results/height_map_2026-11-05/floor_unknowns.jpg
