fernandomierhicks/omni-robot/simulation/v11 sil/studies/results/imx662/views/hall_d435_color.jpg

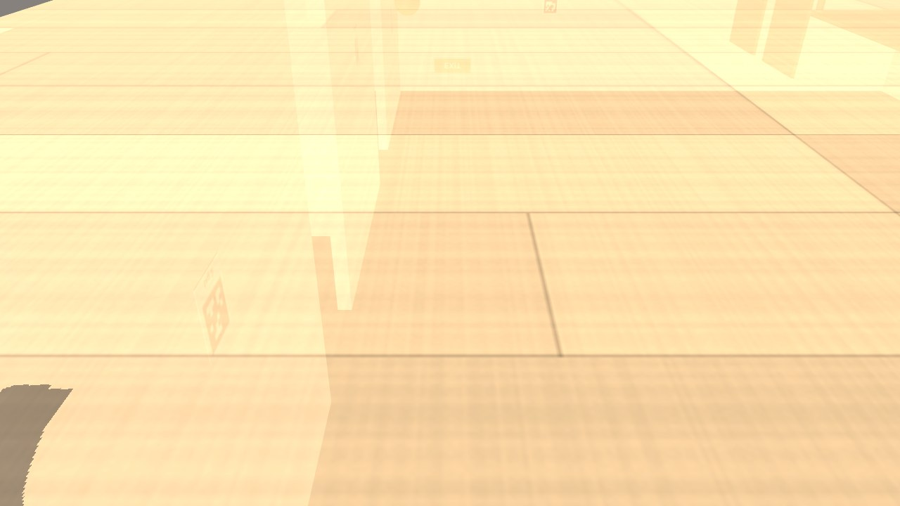
simulation/v11 sil/studies/results/imx662/views/hall_d435_color.jpg
