fernandomierhicks/omni-robot/simulation/v11 sil/studies/results/imx662/views/kitchen_fwd2_ro33.jpg

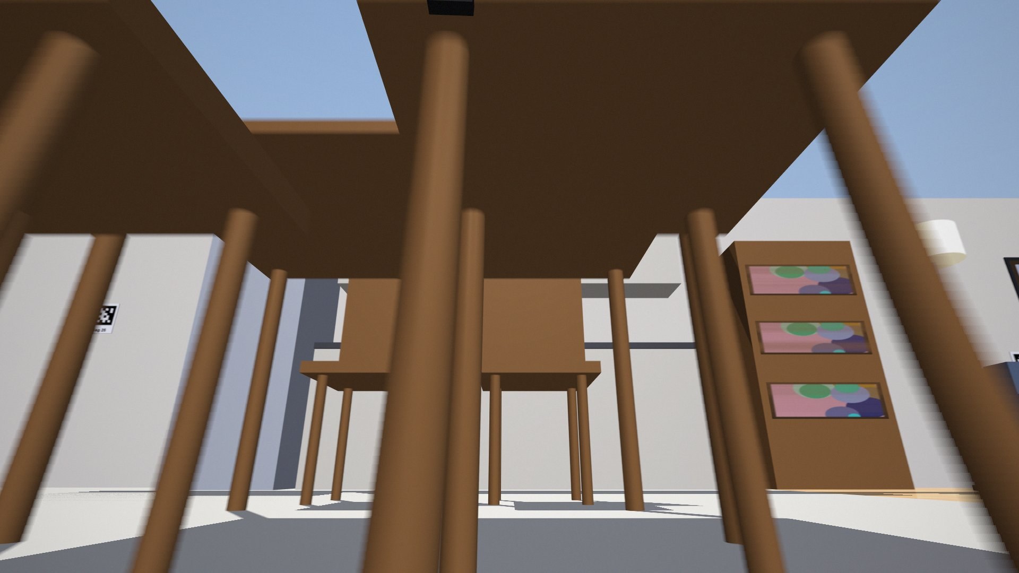
simulation/v11 sil/studies/results/imx662/views/kitchen_fwd2_ro33.jpg
