fernandomierhicks/omni-robot/simulation/v11 sil/studies/results/imx662/views/kitchen_spin180_ro0.jpg

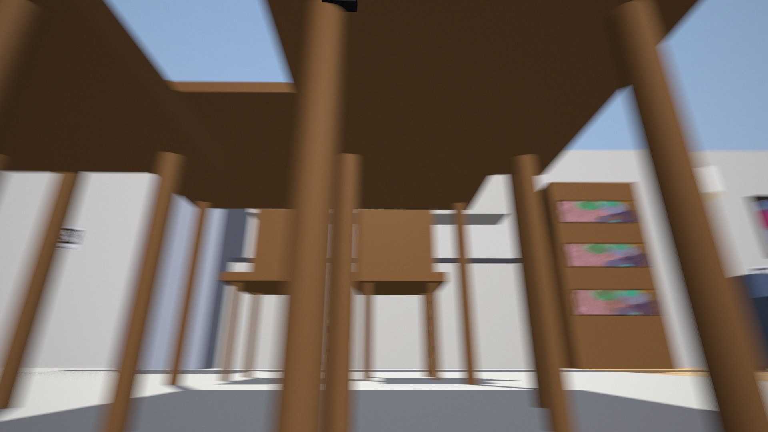
simulation/v11 sil/studies/results/imx662/views/kitchen_spin180_ro0.jpg
