fernandomierhicks/omni-robot/simulation/v11 sil/studies/results/imx662/views/office_person_d435_color.jpg

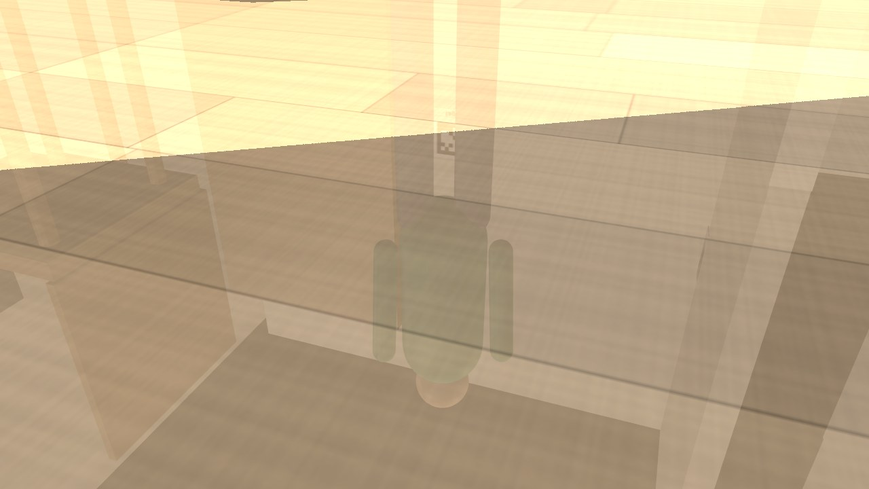
simulation/v11 sil/studies/results/imx662/views/office_person_d435_color.jpg
