fernandomierhicks/omni-robot/simulation/v11 sil/studies/results/motor_char/ak40_fit.png

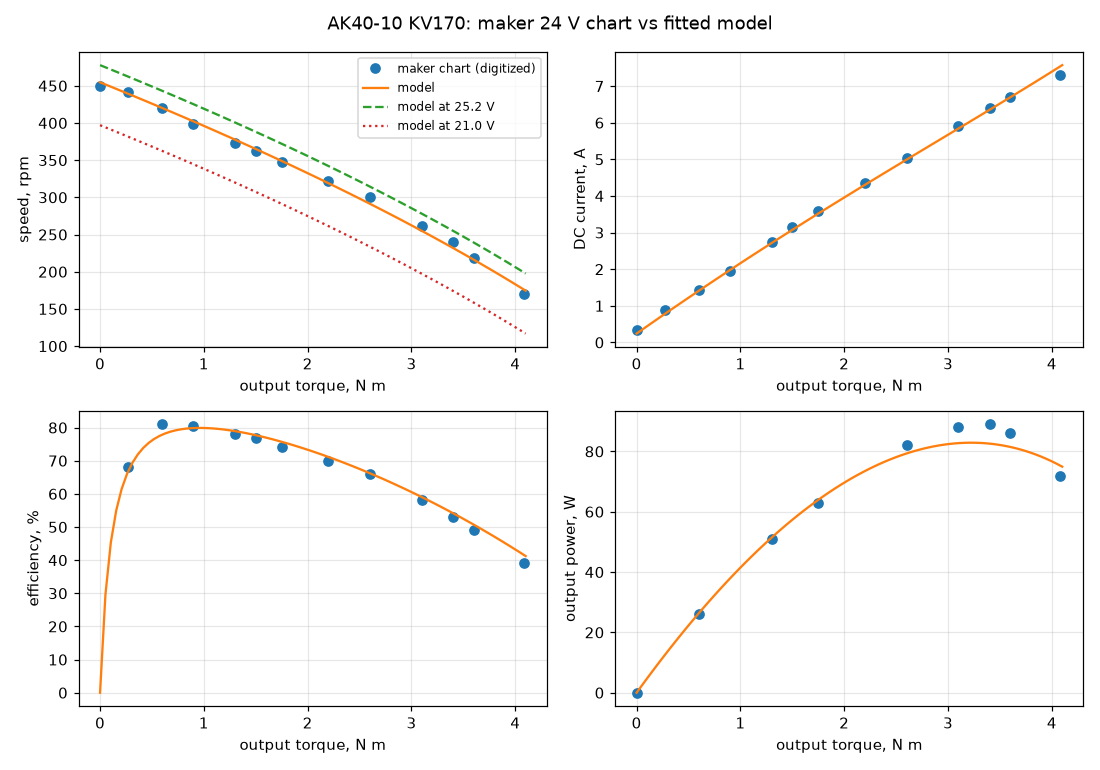
simulation/v11 sil/studies/results/motor_char/ak40_fit.png
