fernandomierhicks/omni-robot/characterization/ball_view/bucket_live.py

"""Bucket ball lab: gesture identity, tuning, causal 3D flight and recording.

python bucket_live.py --source realsense [--arducam]
python bucket_live.py --source synthetic --port 8086
One process owns the RealSense. GPIO is not used. Existing ball_view is retained.
"""
from __future__ import annotations

import argparse
from dataclasses import asdict
import json
import math
from pathlib import Path
import queue
import sys
import threading
import time
from types import SimpleNamespace

import numpy as np
from PIL import Image,ImageDraw

HERE=Path(__file__).resolve().parent
for path in (HERE.parent/'throw_track',HERE.parent/'realsense',HERE.parents[1]/'ros/src/omni_catch',HERE.parent/'src/omni_catch'):
    sys.path.insert(0,str(path))
import ball_view as B
from bucket_vision import observe,circle_proposals,blob_proposals,BlobProposer,CameraGuard
from bucket_workflow import GestureFinder,Tuner,colour_window
from bucket_record import Witness,DebugClip
from flight3d import Config,FlightDetector,trajectory,measurement,public_result
from omni_catch.detector import DetectorConfig
from omni_catch.frames import ArrayFrame


class BucketSource:
    name='realsense'
    has_depth=True
    exposure_max,gain_min,gain_max=8000,0.,128.

    def __init__(self,streams='color,depth,ir1,ir2'):
        import record_rs as R
        self.R=R
        args=SimpleNamespace(serial=None,size='848x480',fps=60,depth_size='848x480',depth_fps=90,
                             emitter='on',ir_exposure_us=1000)
        self.tap=None
        owner=self
        class CaptureRig(R.RealSenseRig):
            def _item(rig,f,host_ns):
                item=super()._item(f,host_ns)
                if owner.tap and rig._name_of(f)=='color':
                    owner.tap(item)
                return item
        self.rig=CaptureRig(args,streams.split(','),keep_s=2.4)
        try:
            self.calib=self.rig.start(2000,128,False,4200)
        except Exception:
            self.rig.close()
            raise
        self.intr=tuple(self.calib['streams']['color']['intrinsics'][k] for k in ('fx','fy','ppx','ppy'))
        self.di=tuple(self.calib['streams']['depth']['intrinsics'][k] for k in ('fx','fy','ppx','ppy'))
        ext=self.calib.get('extrinsics',{}).get('depth_to_color')
        self.rotation=np.array(ext['R']).reshape(3,3,order='F') if ext else np.eye(3)
        self.translation=np.array(ext['t']) if ext else np.zeros(3)
        self.applied=None
        self.skipped=0

    def read(self):
        it=self.rig.next_color(3.)
        while True:
            try:
                it=self.rig.cq.get_nowait()
                self.skipped+=1
            except queue.Empty:
                break
        ds=self.rig.rings['depth'].latest(8)
        # Never use a depth sample captured in the future.
        ds=[d for d in ds if 0<=it.t_ns-d.t_ns<=40_000_000]
        dep=ds[-1] if ds else None
        return B.Frame(it.arr,*self.intr,t=it.t_ns*1e-9,
                       age_ms=(time.time_ns()-it.t_ns)*1e-6,depth=dep.arr if dep else None,
                       depth_scale=self.calib.get('depth_scale',.001),
                       meta=dict(sensor_ns=it.t_ns,host_ns=it.host_ns,counter=it.counter,
                                 exposure_field_raw=it.info[0],exposure_field_units='D435 colour 100us units; optical check pending',
                                 configured_exposure_us=self.applied[0] if self.applied else 2000,
                                 gain=it.info[1],depth_sensor_ns=dep.t_ns if dep else None,
                                 depth_age_ms=(it.t_ns-dep.t_ns)*1e-6 if dep else None,
                                 skipped_to_latest=self.skipped))

    def set_controls(self,p):
        key=(p['exposure_us'],p['gain'],p['awb'],p.get('white_balance',4200))
        if key==self.applied:
            return
        self.rig._apply_options(key[0],key[1],key[2],key[3])
        self.applied=key

    def close(self):
        self.rig.close()


class ManagedRealSense:
    """Keep the web page available when the camera is absent or unplugged."""
    name='realsense'
    has_depth=True
    exposure_max,gain_min,gain_max=8000,0.,128.

    def __init__(self,streams):
        self.streams=streams
        self.driver=None
        self.controls=None
        self.error='Waiting for the RealSense camera'
        self.closed=threading.Event()
        self.generation=0
        self.tap=None

    def set_witness_tap(self,tap):
        self.tap=tap

    def __getattr__(self,name):
        driver=self.__dict__.get('driver')
        if driver is not None:
            return getattr(driver,name)
        raise AttributeError(name)

    def read(self):
        while not self.closed.is_set():
            try:
                if self.driver is None:
                    self.driver=BucketSource(self.streams)
                    self.driver.tap=self.tap
                    self.generation+=1
                    if self.controls:
                        self.driver.set_controls(self.controls)
                frame=self.driver.read()
                self.error=None
                return frame
            except (SystemExit,RuntimeError,queue.Empty) as e:
                if self.driver:
                    self.driver.close()
                    self.driver=None
                message='Camera unavailable. Check power/cable and the blue USB 3 port; reconnect to retry.'
                if message!=self.error:
                    print(message,flush=True)
                self.error=message
                self.closed.wait(2)
        raise RuntimeError('Camera source closed')

    def set_controls(self,p):
        self.controls=p
        if self.driver:
            self.driver.set_controls(p)

    def close(self):
        self.closed.set()
        if self.driver:
            self.driver.close()


class DemoSource:
    name='synthetic'
    has_depth=True
    exposure_max,gain_min,gain_max=8000,0.,128.
    def __init__(self,pace=True):
        self.k=0
        self.pace=pace
        self.start=time.monotonic()
        self.controls=dict(exposure_us=2000,gain=128)
        self.launch=None
        self.di=None
        self.rotation=self.translation=None
        self.profile='orange'
        self.calib={}

    def throw(self):
        self.launch=self.k/60
        phase=(self.launch%4)
        corners=np.array([[240,180],[400,180],[400,340],[240,340],[240,180]])
        n=int(phase)
        u,v=corners[n]+(phase-n)*(corners[n+1]-corners[n])
        self.launch_state=np.array([(u-320)/500*3,(v-240)/500*3,3.,0.,-2.5,-4.5])

    def read(self):
        t=self.k/60
        self.k+=1
        if self.pace:
            time.sleep(max(0,self.start+t-time.monotonic()))
        f,cx,cy=500.,320.,240.
        if self.launch is None:
            phase=(t%4)/4*4
            corners=np.array([[240,180],[400,180],[400,340],[240,340],[240,180]])
            n=int(phase)
            u,v=corners[n]+(phase-n)*(corners[n+1]-corners[n])
            z=3.
        else:
            tau=t-self.launch
            p=trajectory(self.launch_state,[tau],-9.81*Config().up,Config().drag)[0]
            u,v,z=measurement(p,(f,f,cx,cy))
        rgb=np.full((480,640,3),(95,105,110),np.uint8)
        depth=np.full((480,640),5000,np.uint16)
        r=f*.080345/max(z,.1)
        if z>.2 and 0<=u<640 and 0<=v<480:
            yy,xx=np.ogrid[:480,:640]
            mask=(xx-u)**2+(yy-v)**2<=r*r
            colours={'orange':(220,85,12),'yellow':(220,205,25),'purple':(95,45,115)}
            brightness=min(1.2,self.controls['exposure_us']/2000*self.controls['gain']/128)
            rgb[mask]=np.clip(np.array(colours[self.profile])*brightness,0,255)
            depth[mask]=max(1,int((z-.075)*1000))
        rgb[45:90,40:85]=(220,85,12)  # stationary decoy
        return B.Frame(rgb,f,f,cx,cy,t=t,age_ms=0,depth=depth,
                       meta=dict(counter=self.k,synthetic=True,configured_exposure_us=self.controls['exposure_us']))

    def set_controls(self,p):
        self.controls=p

    def close(self):
        pass
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
