fernandomierhicks/omni-robot/characterization/throw_track/analyze_throws.py

"""Analyse a recorded throw session (design.md 8, phase 1C): the robot's own perception over real frames, scored against
the throw's fitted arc and the basket.

For every throw:
  A  the robot's Perception (omni_catch: detector + image-space EKF, one camera) runs over the frames in order, as on
     the robot, and we keep what it does: when the track starts, its crossing of the basket's rim plane at each frame;
  B  an arc with drag is fitted to the detections (arcfit.py), then the detector is re-run with the arc's prediction
     as its search window, which finds the ball in frames A missed (far away, small): the detector's own rate;
  C  metrics: detection rates vs range, centroid / size noise (residuals to the arc, and the arc-free second
     differences), blob elongation (-> exposure), the live track's crossing error vs time to go, and the score
     prediction against what you typed.
Run on the PC (sim venv: numpy, scipy). Results go to results/analysis_<session>.json; fit_vision.py turns them into
the sim's VisionConfig.

  python analyze_throws.py data/<session> [--no-live] [--plot]
"""
from __future__ import annotations

import argparse
import json
import math
import sys
import tempfile
import time
from dataclasses import asdict
from pathlib import Path

import numpy as np

HERE = Path(__file__).resolve().parent
sys.path.insert(0, str(HERE))
for p in (HERE.parents[1] / "ros" / "src" / "omni_catch",):
    if p.is_dir():
        sys.path.insert(0, str(p))
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
