fernandomierhicks/omni-robot/(commit log)

2026-10-20 Add omni-robot design, simulations (v2-v6), CAD and actuator database
2026-10-22 Add v7 CAD, v10 ROS bridge, v11 firmware SIL, ROS packages, launcher; update v6/v7 sims, actuator database and design docs
2026-10-28 Commit all pending work: v7 CAD to fastener level, v8 CAD, v11 firmware SIL, ROS packages, console and sims
    - cad/: v7 fastener-level robot (head, display, arm kit, walls, checks), new cad/v8 (proposed), cad/v2 moved in, old root-level cad files removed
    - simulation/: v5-v11 sims and studies (v11 SIL with firmware in the loop, house scene, arm payload, sensors, bridge core)
    - firmware/: omni_fw core, SH-2 IMU driver, SIL library, build id
    - ros/: omni_arm, omni_calib, omni_slam, omni_face, omni_console (web console + supervisor), omni_catch / omni_mcu / omni_bringup / omni_perception updates, omni_sim bridges
    - database/, design.md and CLAUDE.md updates, launcher and launcher_full scripts
    C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
2026-11-03 Capture complete robot CAD, firmware, ROS, characterization, and simulation work
    Include all pending repository changes, including design and parts data, editable CAD and exports, arm and navigation implementations, firmware safety updates, compute experiments, PC stack regression fixes and results, and working artifacts.
2026-11-04 Snapshot workspace: CAD v10/v11, firmware, ROS, console, sims, characterization
    Commit all pending work accumulated since ef5761a, including v11 CAD
    sub-assemblies and STEP exports, the v11 pod/lean/first-floor tools,
    console camera snap, and the related docs and parts-database updates.
2026-11-06 Commit workspace work: CAD v12/v13, arm colour/height-map perception, AI control, sim studies
    - cad/v12 and cad/v13 STEP exports and sources
    - arm perception: colour vision, floor obstacles, height map (+ tests)
    - omni_calib arm calibration; omni_console AI tasks, AprilTag view, SLAM fixes
    - omni_mcp AI control package and ai_smoke tool
    - v11 SIL studies (D435 mount, tilt, colour scene, floor toys, height map) and results
    - house furnished map, docs and design updates
2026-11-06 Baseline the D435 on the arm riser (cad/v13 pose) in design.md and the sim
    Fernando baselined the cad/v13 mount: landscape, 30 deg down, body centre
    (0.1908, 0, 0.193) m, in a pocket in the riser's front under the adapter.
    - robot_export: D435_RISER in ARM / ARM_D435; the nose kept as ARM_D435_NOSE.
    New params.arm_riser_pocket cuts the sim's riser block back 10 mm for it.
    Regenerated robot_arm*.json and fw_params_arm.h (comment only).
    - Tests follow the pose (v11 135 pass; omni_arm/calib/depth layer 74 pass).
    - d435_mount.py: the riser_cad mount; results/d435_mount_riser_cad.json.
    At 30 deg the close look finds 25/40 and no stand-off fixes it; tidies
    binned 2/4 and 3/4 (the thin cra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
2026-11-06 Rerun the tidy and arm calibration studies at the riser D435 pose
    d435_mount_pick gains the cad/v13 pose at 30 and 35 deg: 18/24 and 20/24
    toys binned over 4 seeds (nose 22/24), no failed grasps. arm_calib gets
    --out; at the riser camera it matches the nose (keyed p95 0.27 mm).
    Results in design.md 4.5 / 4.11 and the cad/v13 README.
2026-11-06 Add the forward IMX662 tag camera study at the nose (proposal)
    design.md 4.12 and a decision-log row: a generic IMX662 USB 2 module on
    node_front under the lidar, 20 deg up, fits clear of the arm's sweep and
    both D435 fields, and sees wall tags from 88 % of house poses (riser D435
    0 %); rolling-shutter renders still decode tags at 2 m/s with 4 ms
    exposure. CAD fit in cad/v13/tools/imx662_fit.py, sim camera and studies
    in simulation/v11 sil. Proposal only: not adopted.
2026-11-06 Fix fake rugs in floor_vision; make the tidy cover its whole region
    The riser D435 tidied worse than the nose (18 vs 22/24) because the depth
    noise's high tail over a bare floor passed the rug finder's absolute
    thresholds: fake rugs 5-10 mm up flattened small toys on some RANSAC
    seeds. A rug level must now hold half the points round each of its
    cells. With the fix the riser binds 24/24 (old search).
    The tidy used to stop after a look round where it stood and one at the
    start. coverage.py tracks the region's floor on 5 cm cells (checked
    within 1.2 m of the camera, blocked over 3 cm, things the detector turned
    down kept to look at) and the tidy drives, through floor seen free, to
    the reachabl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
2026-11-07 Remove tmp/ scratch files and rendered videos; add bumper and CubeMars driver todos
    tmp/ held leftover scripts, logs and voice samples from earlier sessions (committed by the
    bulk Nov 3 capture); it is now ignored. Rendered demo videos are regenerated by their sims.
    Claude-Session: https://claude.ai/code/session_01J8vKU1BiRZn9GrkehxzwWR
2026-11-07 Firmware safety: protocol 6 CMD checks, ramp out of MANUAL, watchdog, arm build gate
    - Every CMD carries PROTOCOL_VERSION; the MCU drops a CMD of another version, with a non-finite
    or out-of-range value or an unknown enum, counts it (STATE.cmd_rejected) and does not take it
    as a heartbeat. mcu_link refuses to arm firmware of another protocol and replaces a non-finite
    request with a ramped stop.
    - Leaving RC MANUAL (switch or RC link lost) ramps the base to rest with the motors enabled
    before disabling them, instead of cutting them at speed.
    - Kid profile turns on at once and off only with the base at rest.
    - HAS_BUMPERS (false for the arm robot, which has none yet); bumpers read norm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
2026-11-07 Mode manager: prioritized drive sources, stale arm-out caps the base
    TELEOP now takes its twist from separate topics with priorities instead of one shared
    /cmd_vel with several writers: /cmd_vel/joy (100, the joystick), /cmd_vel/manual (90,
    Foxglove and the console's Nav2-bypass stick), /cmd_vel (50, Nav2's collision monitor).
    /cmd_vel/lock stops TELEOP; /cmd_vel/active names the source in charge. Topics, priorities
    and timeouts are parameters.
    With arm:=true (the arm step) a missing or stale /arm/out counts as arm out, so a dead arm
    node caps the base instead of uncapping it.
    teleop_twist_joy is remapped to /cmd_vel/joy (only with the firmware in the loop), the
    console gets a cmd_vel_topi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
2026-11-07 Delete Python ROS nodes that have C++ twins
    One implementation per robot node (Fernando): mcu_link (link_node.py, gpio_edges.py),
    mode_manager (mode_node.py), scan_prep, heading_node, catch_perception and catch_behavior
    (perception_node.py, behavior_node.py), and arm_node.py with its transport.py. The launch
    switches glue, catch_impl and arm_impl are gone: every robot node runs its omni_cpp version,
    the arm runs omni_cpp's arm_driver beside omni_arm's arm_brain.
    The ROS-free Python cores the v11 simulator still imports (protocol, modes, catch cores,
    arm driver and kinematics) stay for now, checked against the C++ by the parity tests.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
2026-11-07 Declare and pin dependencies per environment
    - ros/requirements-robot.txt: the robot nodes' pip-only packages (Kokoro, Vosk, sounddevice,
    simplejpeg, pupil-apriltags, pyrealsense2, MuJoCo for the WSL bridge); install_wsl.sh
    installs it.
    - ros/tools/omni_mcp/requirements.txt for the AI control venv; its README uses it.
    - simulation/requirements.txt pins MuJoCo 3.16.0 (as WSL) and adds ziglang.
    - package.xml: control_msgs (omni_arm), scipy/opencv/PIL (omni_console); omni_mcu and
    omni_catch no longer declare ROS runtime deps they lost with their nodes; pyserial dropped.
    Other versions stay unpinned until recorded with pip freeze in the working venvs.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
2026-11-07 Split the console core; arm-out caps from robot_arm.json only
    - missions.py (1,872 lines) keeps the Console core (missions, driving, SLAM, settings, what the
    robot reports); its AI client moves to console_ai.AiMixin, calibration to
    console_calib.CalibMixin, programs/zones/rooms/tf to console_edit.EditMixin, and the shared
    constants, Setting, Reply and helpers to console_defs.py (re-exported from missions.py, so
    imports are unchanged). Methods moved whole; console tests unchanged and green.
    - The arm-out caps had three hardcoded copies (mode_mux.hpp, modes.py, the export). The C++
    mode manager now reads arm_out from the generated robot_arm*.json (parameter config, passed by
    the ar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
2026-11-07 Say "robot computer" / "host" instead of "Jetson" in the robot code
    No Jetson is planned (design.md 4.9); comments, docstrings and two console labels said
    "the Jetson" for whichever computer is chosen. Wording only, plus the generator strings so
    the exported firmware headers match.
    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
2026-11-07 CI workflow, omni_mcu tests, docs for the Nov 7 cleanup
    - .github/workflows/ci.yml: Teensy build (catch variant; checks the arm variant still refuses),
    ROS-free package tests, C++/Python parity, omni_mcu, test_v11.py (osmesa), the database.
    - ros/src/omni_mcu/test: the frames, CMD/STATE layouts against protocol.h, the stream
    decoder on garbage and corrupt frames, the clock map. The package had no tests.
    - design.md (2, 2.1, the safety paragraph, 4.10, the decision log) and AGENTS.md: one
    implementation per robot node, protocol 6, drive-source priorities, build variants,
    requirements files.
    Claude-Session: https://claude.ai/code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
2026-11-07 The v11 sim runs the robot's C++ arm driver; Python bus/driver twins deleted
    - omni_cpp: ArmDriverCore (arm_driver_core.hpp/.cpp), the arm_driver node's bus, calibration and
    motion player without ROS; the node now wraps it.
    - omni_cpp/sil: arm_sil.cpp (a C API) and arm_sil.py (ctypes, built on first use with g++ or
    zig c++ into ~/.cache/omni_cpp, as the firmware SIL is).
    - omni_arm/brain_core.py: ArmState, MotionSync (what the tidy wants, as driver commands) and
    HEALTH_GRACE, shared by arm_brain and the sim.
    - sil_pick.py drives the arm as the robot does: the C++ driver cycles (read, play, write) on the
    sim's servo bus, the tidy task steps on its joint states, MotionSync sends whole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
2026-11-07 Robot tunables as described ROS 2 parameters, values in robot.yaml
    - omni_cpp/params.hpp: params::number / integer (with ranges), flag, text (description,
    read-only), and params::Live (a ros2 param set updates the node's variable at once).
    - mode_manager, mcu_link, scan_prep, heading_node, arm_driver and the catch nodes declare
    every parameter that way. Hardcoded values became parameters: the mode manager's
    catch/thrower/pick timeouts and rate, mcu_link's cmd_timeout, the arm driver's arm/grip
    torque limits, bus timeout and retry period (ArmDriverCore takes the torques).
    - arm_brain: described parameters; health_grace and hw_stale are live.
    - omni_bringup/config/robot.yaml: the robot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
2026-11-07 Python robot nodes get described parameters too (omni_params)
    - New package omni_params: Params(node).number / flag / text / array with a description, a range
    (float or integer by the default's type), read-only unless live= (a set writes the node's
    attribute, optionally converted), as omni_cpp/params.hpp does in C++.
    - arm_brain, floor_obstacles, height_map, tag_slam, tag_detector, face_node and image_preview
    declare every parameter that way; live where the node reads the value as it runs (rates,
    stride, forget radius, lidar sigmas, preview size and quality, ...).
    - robot.yaml gains their sections; the launch loads it into each; test_robot_params.py checks
    the Python declarations t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
2026-11-07 People detector: the lidar and the forward IMX662 camera together (proposal)
    omni_perception gains a person detector for the proposed forward IMX662
    (design.md 4.12):
    - people_vision.py (ROS-free): YOLOX (Apache-2.0, COCO person) as ONNX
    on onnxruntime's CPU provider; the camera's geometry (bearing, a rough
    range from the foot point and the head top with their sigmas: the camera
    is ~0.1 m up, so the lidar gives the range); fusion with the lidar's leg
    candidates (a box claims the candidate on its bearing; a candidate the
    camera had wholly in view with no box counts against it); a tracker with
    log-odds per track (the lidar alone never confirms a person), velocity
    and ids. Boxes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
2026-11-07 People detector: sim study results and design.md 4.12
    studies/results/people_detect/: on renders of primitive people from the
    forward IMX662, YOLOX nano found every person at 2-4 m and 15-18/18 at
    5-7 m on an open floor, but 8/18 at 1.2 m (heads leave the frame); in the
    furnished house 86/104 people in view with 2 boxes on no person (wall
    tags) in 200 frames. Tiny found fewer under 4 m at ~5x the CPU, so nano is
    the default. The camera's own range is rough from 0.1 m up (median 0.2 to
    0.6 m error, within its sigma model): the lidar ranges, the camera
    confirms. design.md: 4.12 section, Start here, open items, decision log.
    Claude-Sessio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
2026-11-07 Console arranged by intent: workspaces, mission control, preflight and bring-up
    The operator console's 23 tabs become seven workspaces by what the operator wants to do:
    Home (mission control: now, map + camera, a card per task, the activity history; Tidy,
    Follow, Program), Drive (with the arm's poses), Map (Go To, Patrol, Explore, SLAM, Map
    edit), the payload (Arm; Catch and Thrower on the catch robot), See, Test (Preflight,
    Bring-up, Calibrate, Base, the sim's Faults) and the Robot menu (adds Settings). Page
    addresses (#goto, #tidy ...) are unchanged.
    - The robot declares its features (console_defs FEATURES: workspace, needed caps, card,
    start verb) in the schema; the page draws what it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
2026-11-07 Fun missions: Fetch, Block tower, Messenger, Dance party, Goalie, Call
    Console (omni_console/console_fun.py, ROS-free, tested): FETCH (find by colour and
    shape, pick and keep, Nav2 to the nearest person or back to the start, put down),
    MESSAGE (room by room, a look round each until a person is seen, then the message
    is said), TOWER, DANCE (dance.py: moves on the beat that end where they began,
    never more than 0.6 m out), GOALIE (goalie.py: slide to the predicted crossing,
    score and quips). FETCH switches PICK/TELEOP as it goes (mode_ok). The node runs
    the people detector for Messenger and Fetch too, wakes the ball tracker for
    Goalie and sends Goalie's twist unguarded. Pages for each, Drive >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
2026-11-07 Firmware: CubeMars AK40-10 driver in servo mode; the arm build compiles
    ak_motor.h/.cpp: servo mode over extended CAN frames (velocity in ERPM, zero current
    to coast, the 0x29 status broadcast), chosen over MIT mode because MIT's per-model
    range table is silently wrong when mis-set (the wheeled-leg robot's AK45-10 lesson)
    and couldn't be checked here. One frame a tick, the motors in turn (the wheeled-leg
    robot's missed-frame lesson); odometry from the motors' reported speed; status
    errors mapped onto the Damiao codes the rest of the firmware uses.
    FwCanFrame gains ext (one pad byte, same layout); main.cpp carries it both ways and
    no longer refuses the arm variant: pio run -e arm and -e catc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
2026-11-07 AI missions in omni_mcp; Goalie aim; tower grasp across faces
    - Console: ai_mission starts Fetch, Messenger, Block tower, Dance party or Goalie as an
    AI task (the lease, a person's take-over, one task at a time, the deadline); the task
    ends with the mission and the robot's account as evidence. Goalie takes seconds.
    - omni_mcp: robot_fetch, robot_message, robot_tower, robot_dance, robot_goalie.
    - Goalie: the prediction is shaded toward the shadow far out (trust 0.4 s) and the ball
    tracker's process noise is 1.5 m/s^2, chosen offline (studies/goalie_offline.py).
    - Tower: a block is closed across its faces (wrist_vision.square_axis: a square's
    covariance can't give its yaw), regripped o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
2026-11-07 Tower 4/6 full, Goalie 13/13 saves in the sim; design.md for the AK driver and the missions
    - Tower: the regrip compares the jaws with the cube's height (a footprint seen askew reads
    wide); the tower's height is taken as seen, logged when lower than built. 6 seeds of 3
    cubes: 4 stood 3 high, 2 stood 2 high.
    - Goalie (new aim and tracker): 13/13 on-target shots saved over seeds 1-2 against 3/14
    for the parked robot on the same shots.
    - Fetch on the final code: 3/3 put down upright 5-10 mm from the spot.
    - arm_carry.py: --first, --out, a run retried once when the renderer fails (osmesa gave a
    garbage segmentation image under memory pressure); goalie.py --out.
    - design.md: the AK40-10 s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
2026-11-07 Fixes: AK wheel-speed cap, lint, memory-safe sim studies
    - robot_export: the wheel-speed ceiling is also capped by a CubeMars drive's own ERPM
    limit (AK40-10: 60000 ERPM = 44.9 rad/s; it was 45.9, above what the motor allows).
    - ruff F401/F541/F811 clean over ros/src, ros/tools and the v11 sim: unused imports,
    a duplicated import block in omni_cpp's test_cores, the unused shape import in
    console_ai (shadowed by a local), placeholder-less f-strings.
    - studies/common.py: pool() runs each MuJoCo run in a fresh process (a reused worker kept
    every run's model and osmesa renderers and grew to 4.4 GB, killed by the memory limit)
    and retried() tries a run again when the renderer fails. arm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
2026-11-07 Preflight: lidar rate and IMU rows
    The console node keeps the lidar subscribed (raw bytes, counted on arrival, parsed only
    when a mission needs people) and reports its rate and age in the status. Preflight: a
    lidar silent for 1 s fails and refuses Go To, Patrol, Explore, Follow and Messenger;
    under 5 Hz warns. IMU: the MCU's IMU_SILENT warns (its own row now, not under faults),
    and a tilt over 15 deg warns.
    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
2026-11-07 Call: Listen to the robot's microphone; https port for push-to-talk
    The supervisor streams the robot's microphone (/api/mic: arecord, raw 16 kHz
    s16le, two listeners, PIN-checked) and the Call page plays it with Web Audio
    after the robot announces the listener. --https (OMNI_CONSOLE_HTTPS) serves the
    page with a self-signed certificate made by openssl, tunnelling rosbridge
    (/rosbridge) and web_video_server (/video/) so a secure page reaches them; the
    http page links to it for push-to-talk. Tests: mic stream, TLS tunnels with a
    stalled client.
    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
2026-11-07 Tower: measure where the block sits in the gripper with the wrist camera
    After the lift, HELD_LOOK takes a wrist frame of the held block.
    wrist_vision.held finds its near bottom edge (exact on the bottom face's
    plane, since the camera sits just above the top face and sees the near side)
    and picks the height whose silhouette fits best: offset across the pads,
    skew, and how far it rode up the fingers. The put-down uses them; the
    centre is half the block's side from the fixed finger (the gap reads 45.7 mm
    for a 40 mm cube). Regrips follow the measured skew: the old 4 mm gap rule
    regripped every block.
    Sim (MuJoCo, robot's own arm code): tower 5/6 full 3-high (was 4/6), layers
    3-17 mm off (was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
2026-11-07 design.md compressed to ~4,300 words; full snapshot appended to the history
    The complete pre-compression design.md (18,649 words) is appended verbatim
    to design full history.md as the dated Nov 7 entry (append-only). The
    rewrite keeps every section number the code cites, the maintenance rules,
    Start here and a condensed decision log, and moves run tables, CAD rounds
    and study detail to the history and the subsystem READMEs. It also records
    the held-block measurement and the https Call page.
    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
2026-11-09 Windows: export the arm SIL's functions; read test sources as UTF-8
    zig's DLL exported nothing without dllexport, so the C++ arm driver could not
    load on Windows and test_arm_driver and two v11 tests failed. Same macro as
    firmware/sil/sil_api.cpp. test_robot_params read sources in the Windows codepage.
2026-11-09 Fetch and Messenger act only on a real match
    Found on the ROS stack, scored on the sim's truth:
    - Fetch took a find's first candidate whatever its score, so asking for the
    red cube picked up a purple one and reported success. It now needs a score
    of 0.4 (the right colour, the shape at least a guess) and looks on otherwise.
    - Messenger counted a lidar-only candidate as someone to talk to, with the
    camera running, and delivered the message to furniture within seconds. With
    a working camera Messenger and Fetch now need a camera-confirmed person.
    Follow keeps lidar candidates (up close the camera loses the head).
2026-11-09 CI builds the arm firmware; docs record the Nov 8 ROS stack runs
    CI still required the arm build to fail, so it had been red since the AK40-10
    driver landed. AGENTS.md said the same. design.md: results of the console and
    missions on the ROS stack, and what remains unproven there.
2026-11-09 Sim: find the C++ arm SIL through OMNI_ROS_SRC
    sil_pick built omni_cpp/sil's path from its own location in the repo. Under
    ros/omni.sh the sim is mirrored to ~/omni_ws/sim, so the bridge crashed at
    startup with "No module named arm_sil" and the arm step could not run.
2026-11-09 Post-merge fixes: Fetch closes in and delivers, Goalie ball on ROS, test health
    Arm robot
    - Fetch drives closer (Nav2, 0.6 m short, twice at most) to a right-colour
    thing of unsure shape or a small patch of the colour, and takes what it
    drove up to when the shape guess flickers. A cube 1.4 m away: brought
    back 3/3, judged on /sim/objects.
    - A put-down "ahead" used pose (0, 0): the arm node drops odometry between
    tasks, so it only worked at the odometry origin. It now waits for odometry.
    - Fetch says when it brought nothing (nobody found, or no map).
    - The person search turns in steps and stands still to look.
    - Fetch to="me" is still unreliable (2/5): recorded in design.md 7.
    - Goali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
2026-11-09 CAD v13: SolidWorks assembly of the whole robot, self-contained in cad/v13
    - Rebuild the SolidWorks viewing assembly of the entire v13 robot (cad/v13/solidworks/V13_robot.SLDASM):
    686 components from 203 files (183 parts, 20 sub-assemblies): chassis, upper robot, electronics with the
    riser D435 and its plug + lead, the SO-101 arm, 172 fasteners, four flexible pods, and the D435 field
    envelopes. Imported STEP bodies in sub-assemblies (cad/solidworks.md section 17), proposal status.
    - Checks (validation/solidworks): no mate errors; pod suspension motion test passes for both hands;
    every component file is inside cad/v13 (sw_robot.py paths); SolidWorks interference shows no overlap
    bet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
