fernandomierhicks/omni-robot/(notices)

Notices in the files:
design full history.md:
The house's CC0 textures come from `python house_scene.py fetch` (not in git).
